gabrielyoung92/gabs_microSMT_PickAndPlace/Microsmt-PNPv3/README.md

# MicroSMT PNPv3 machine

> Designs and original files by [MicroSMT](https://github.com/microsmt/Microsmt-PNPv3). [Credits and local changes](../CREDITS.md).

Start here for the PNPv3 machine parts, nozzle racks, strip feeders and motherboard. The assembly manuals are below.

| Browse | Contents |
| --- | --- |
| [Machine parts gallery](PNP-V3_3D_parts_2026-02-04/README.md) | 25 parts with STEP/STL links and nine previews per part |
| [Work-bed plates](Work_bed_plates/README.md) | Standard and camera plate DWGs, dimensioned PDF and hole coordinates |
| [CP45 nozzle rack gallery](CP45_nozzle_rack/README.md) | Left/right rack parts and clamps |
| [Strip feeder gallery](Strip_feeders/README.md) | Different tape widths and sizes |
| [Motherboard](PCB_motherboard/README.md) | Gerber ZIP, schematic and top/bottom/isometric previews |
| [Machine setup notes](docs/README.md) | OpenPnP commands, controller/camera inspection and vacuum sensors |

## Manuals

- [Assembly Manual for Electrical  of  PNPv3 2025082801.pdf](Assembly%20Manual%20for%20Electrical%20%20of%20%20PNPv3%202025082801.pdf)
- [Assembly manual for  the frame of pnpv3 20241226.pdf](Assembly%20manual%20for%20%20the%20frame%20of%20pnpv3%2020241226.pdf)
- [Backlash Compensation and Camera Calibration.pdf](Backlash%20Compensation%20and%20Camera%20Calibration.pdf)
- [microsmt_pnpboard_v1.7_manual 20241129.pdf](microsmt_pnpboard_v1.7_manual%2020241129.pdf)

[Calibration card](Calibration%20card.png)

## About the PNPv3

MicroSMT describes the PNPv3 as an open-source pick-and-place kit for OpenPnP. Development started in 2021.

Kits: [microsmt.com.cn](https://www.microsmt.com.cn) · Support: [Discord](https://discord.gg/qT7ZAAgspy) · [Google group](https://groups.google.com/g/pnpv3-bing-feeder)

The machine uses a Cartesian XY layout.
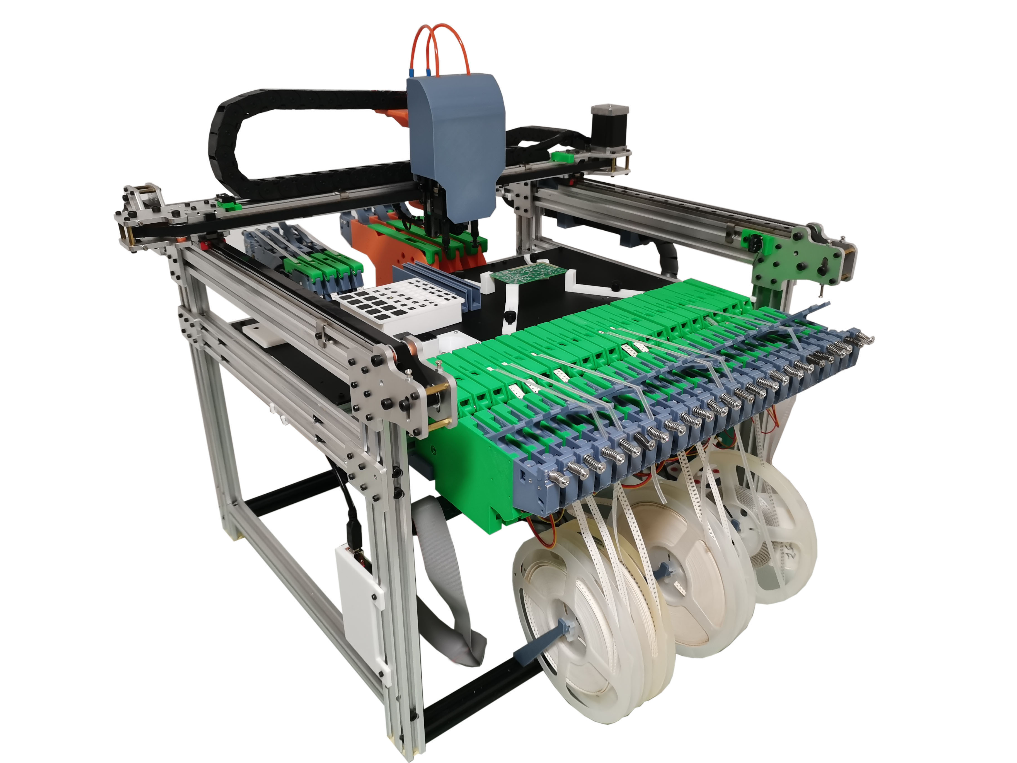
[picture p3: Microsmt-PNPv3/picture1.jpg]


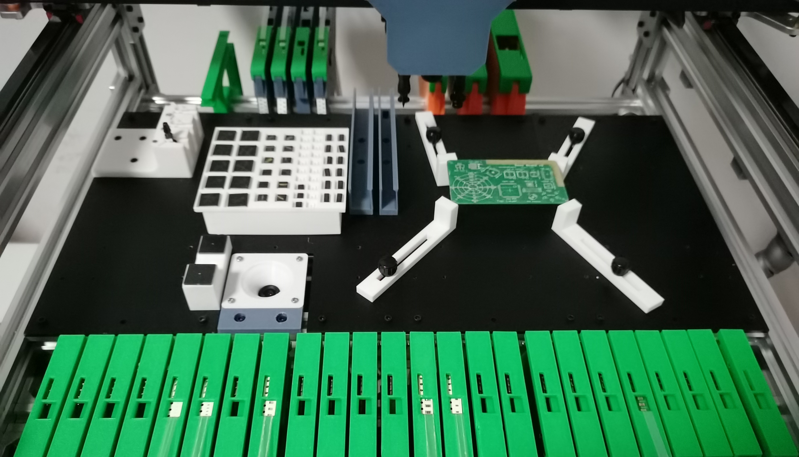
[picture p4: Microsmt-PNPv3/piciture5.jpg]


The main structural parts are CNC-machined aluminium alloy.
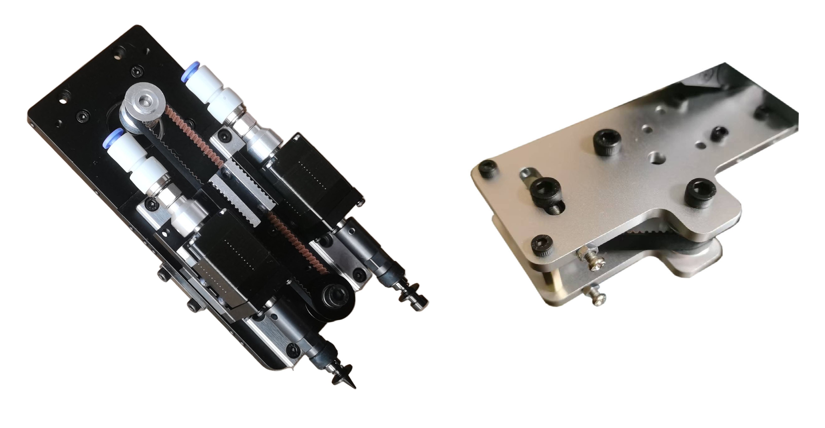
[picture p5: Microsmt-PNPv3/picture3.jpg]


### Belt tensioner
A toothless idler provides the belt-tension adjustment.
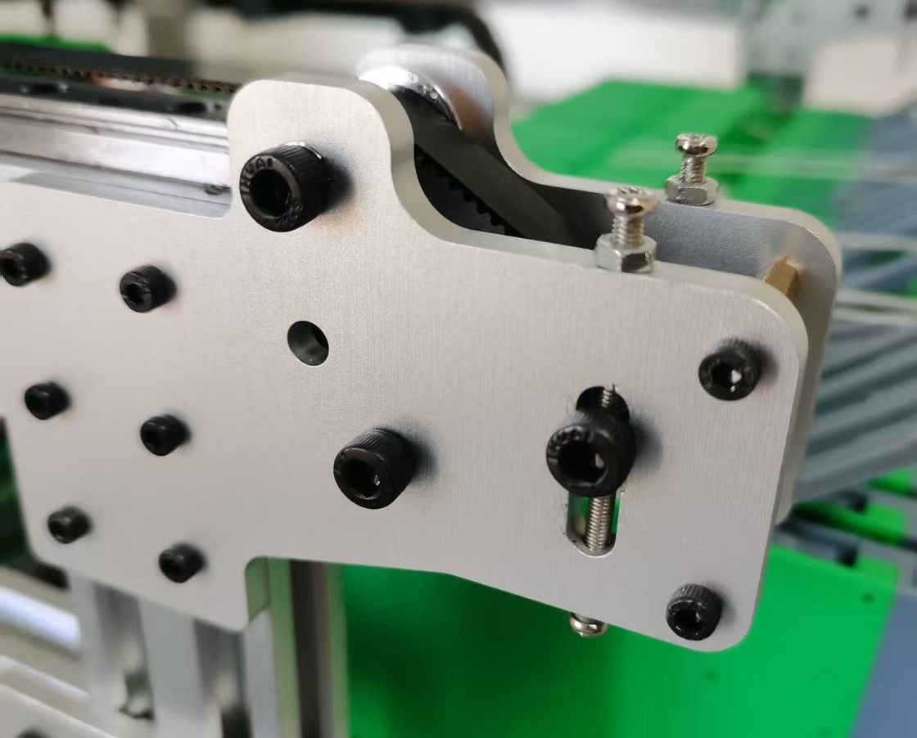
[picture p6: Microsmt-PNPv3/picture4.jpg]
