gabrielyoung92/gabs_microSMT_PickAndPlace/Microsmt-PNPv3/CP45_nozzle_rack/README.md

# CP45 nozzle rack

> Designs and original files by [MicroSMT](https://github.com/microsmt/Microsmt-PNPv3). [Credits and local changes](../../CREDITS.md).

3 parts · [All photos](photos/)

Click a picture for full size; **More views** contains top and bottom views.

## CP45 nozzle rack — left (2025-06-12)

[STEP](CP45%20nozzle%20%20rack%20-left-20250612.STEP) · [STL](CP45%20nozzle%20%20rack%20-left-20250612.stl)

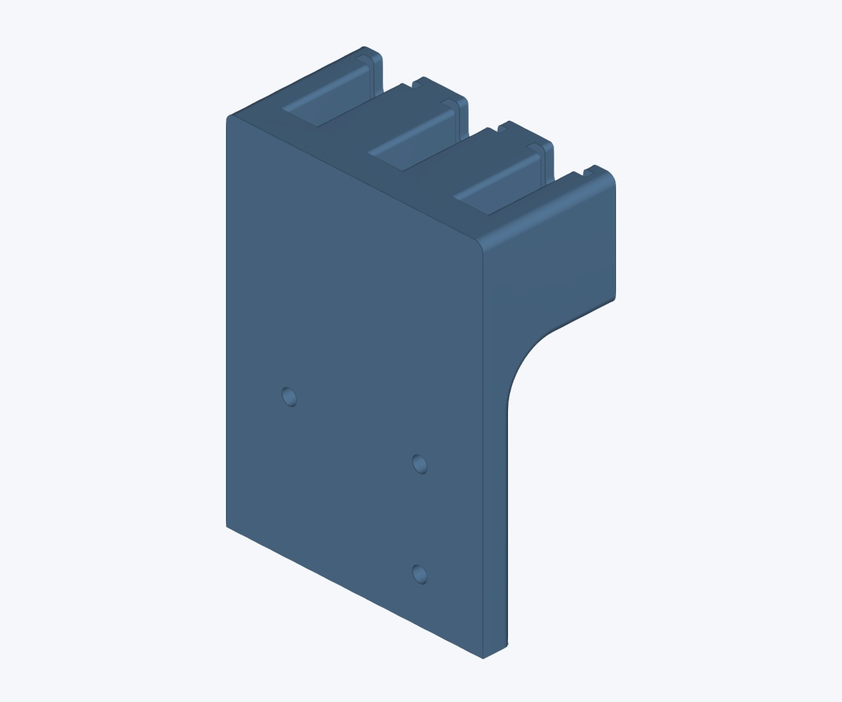
[picture p12: Microsmt-PNPv3/CP45_nozzle_rack/photos/CP45 nozzle rack -left-20250612.jpg]
CP45 nozzle rack left 20250612 — original preview


<details>
<summary>More views</summary>

<table>
<tr>
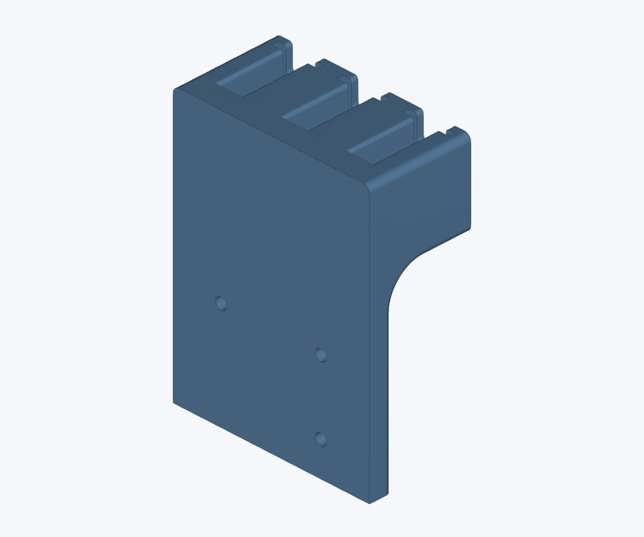
[picture p13: Microsmt-PNPv3/CP45_nozzle_rack/photos/CP45 nozzle rack -left-20250612-iso-top-1.jpg]
CP45 nozzle rack left 20250612 — top view 1
<td align="center"><br><sub>Top 1</sub></td>
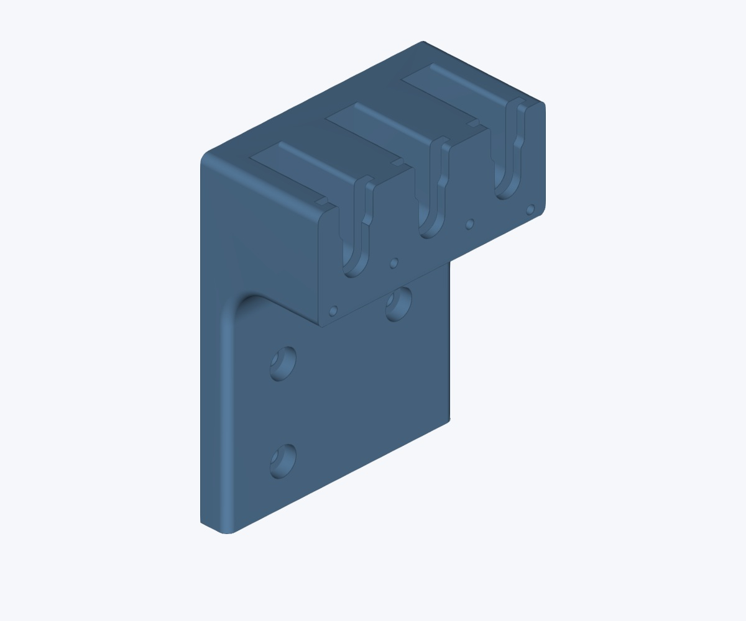
[picture p14: Microsmt-PNPv3/CP45_nozzle_rack/photos/CP45 nozzle rack -left-20250612-iso-top-2.jpg]
CP45 nozzle rack left 20250612 — top view 2
<td align="center"><br><sub>Top 2</sub></td>
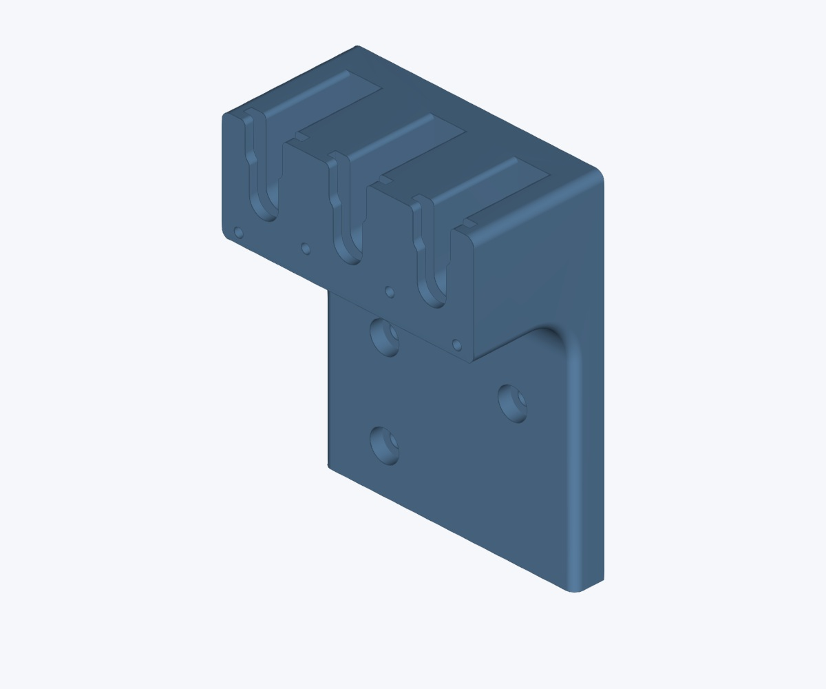
[picture p15: Microsmt-PNPv3/CP45_nozzle_rack/photos/CP45 nozzle rack -left-20250612-iso-top-3.jpg]
CP45 nozzle rack left 20250612 — top view 3
<td align="center"><br><sub>Top 3</sub></td>
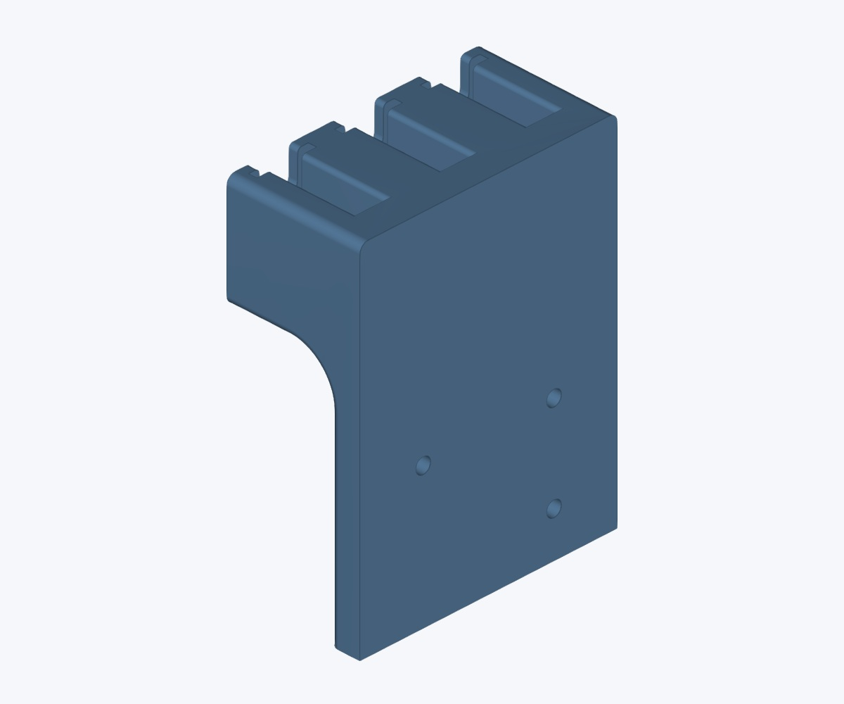
[picture p16: Microsmt-PNPv3/CP45_nozzle_rack/photos/CP45 nozzle rack -left-20250612-iso-top-4.jpg]
CP45 nozzle rack left 20250612 — top view 4
<td align="center"><br><sub>Top 4</sub></td>
</tr>
<tr>
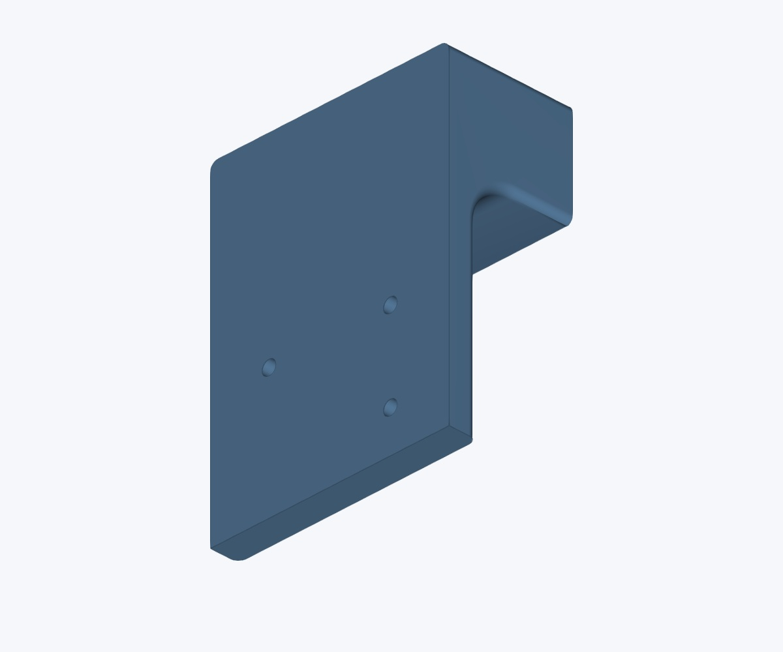
[picture p17: Microsmt-PNPv3/CP45_nozzle_rack/photos/CP45 nozzle rack -left-20250612-iso-bottom-1.jpg]
CP45 nozzle rack left 20250612 — bottom view 1
<td align="center"><br><sub>Bottom 1</sub></td>
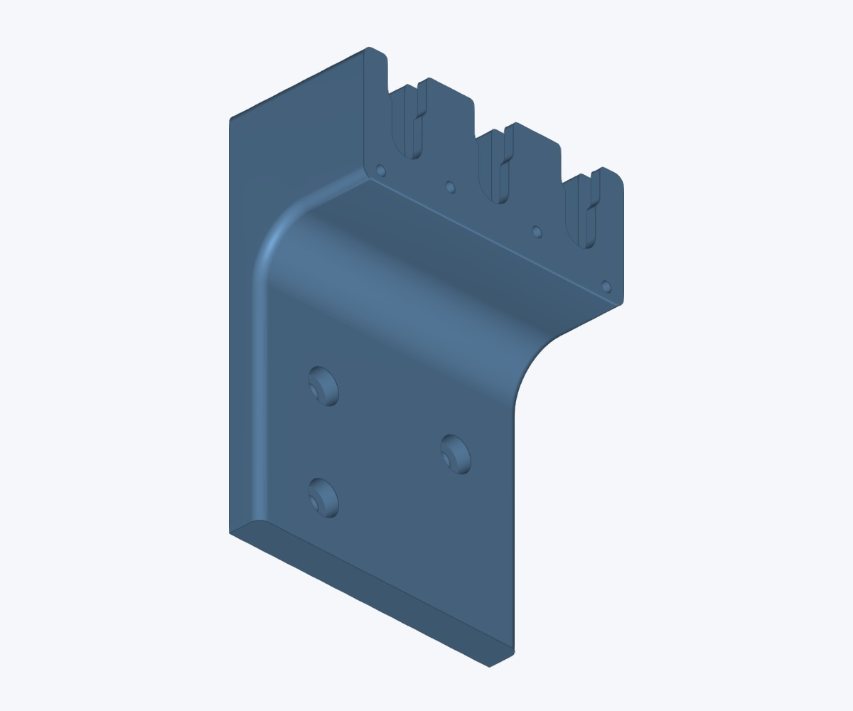
[picture p18: Microsmt-PNPv3/CP45_nozzle_rack/photos/CP45 nozzle rack -left-20250612-iso-bottom-2.jpg]
CP45 nozzle rack left 20250612 — bottom view 2
<td align="center"><br><sub>Bottom 2</sub></td>
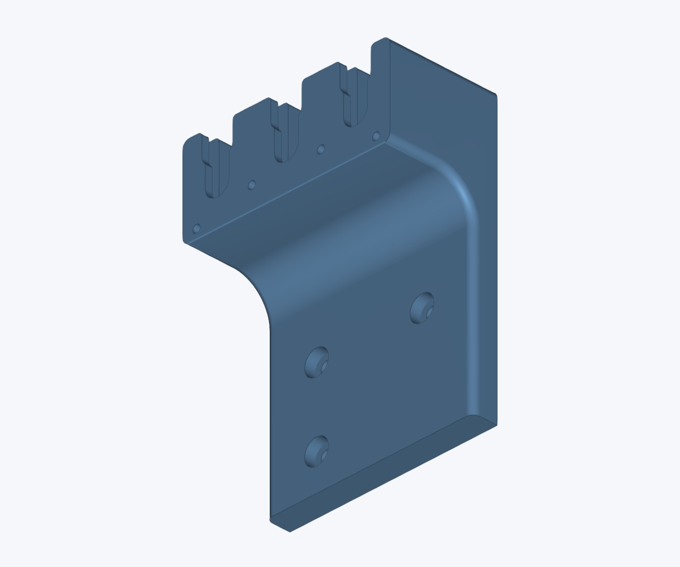
[picture p19: Microsmt-PNPv3/CP45_nozzle_rack/photos/CP45 nozzle rack -left-20250612-iso-bottom-3.jpg]
CP45 nozzle rack left 20250612 — bottom view 3
<td align="center"><br><sub>Bottom 3</sub></td>
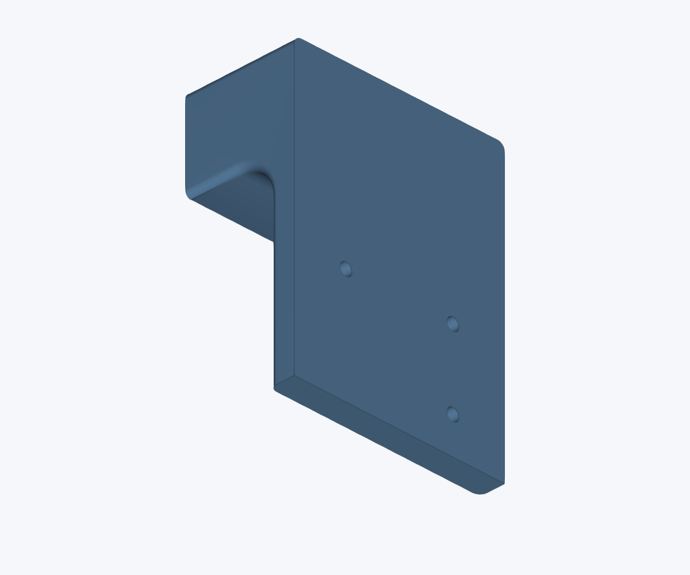
[picture p20: Microsmt-PNPv3/CP45_nozzle_rack/photos/CP45 nozzle rack -left-20250612-iso-bottom-4.jpg]
CP45 nozzle rack left 20250612 — bottom view 4
<td align="center"><br><sub>Bottom 4</sub></td>
</tr>
</table>

</details>

## CP45 nozzle rack — right (2025-06-12)

[STEP](CP45%20nozzle%20%20rack%20-right-20250612.STEP) · [STL](CP45%20nozzle%20%20rack%20-right-20250612.stl)

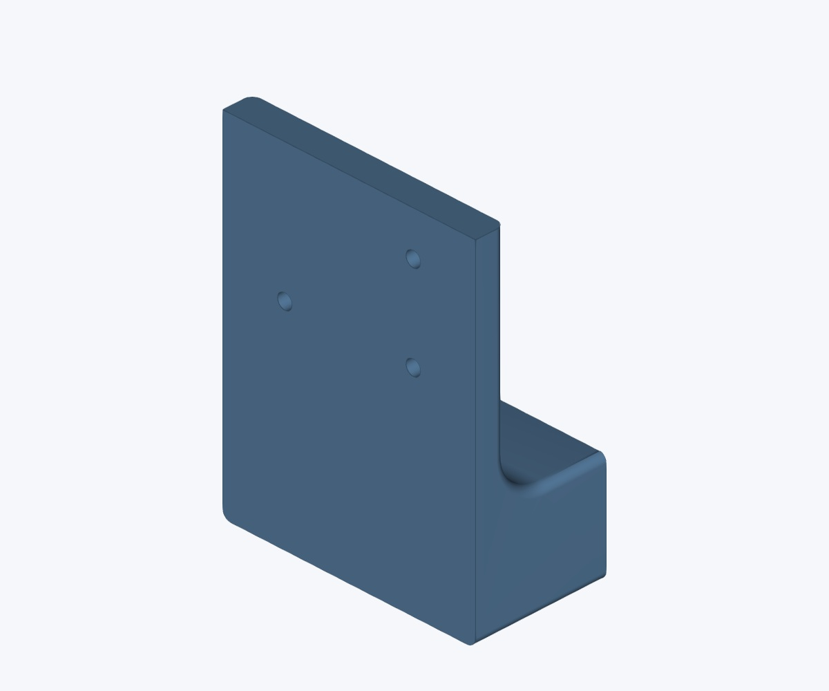
[picture p21: Microsmt-PNPv3/CP45_nozzle_rack/photos/CP45 nozzle rack -right-20250612.jpg]
CP45 nozzle rack right 20250612 — original preview


<details>
<summary>More views</summary>

<table>
<tr>
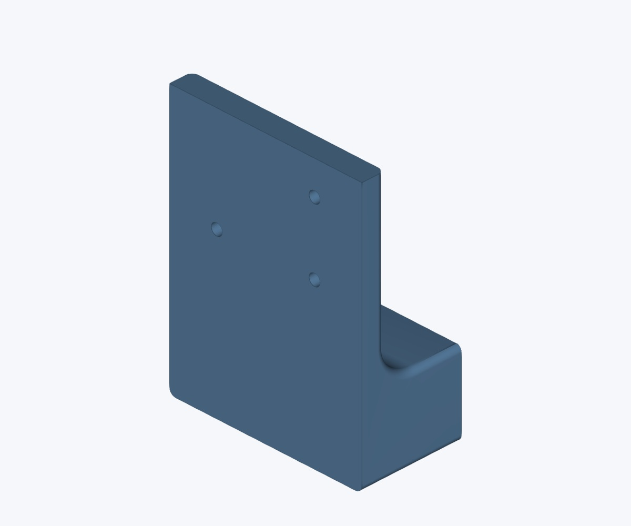
[picture p22: Microsmt-PNPv3/CP45_nozzle_rack/photos/CP45 nozzle rack -right-20250612-iso-top-1.jpg]
CP45 nozzle rack right 20250612 — top view 1
<td align="center"><br><sub>Top 1</sub></td>
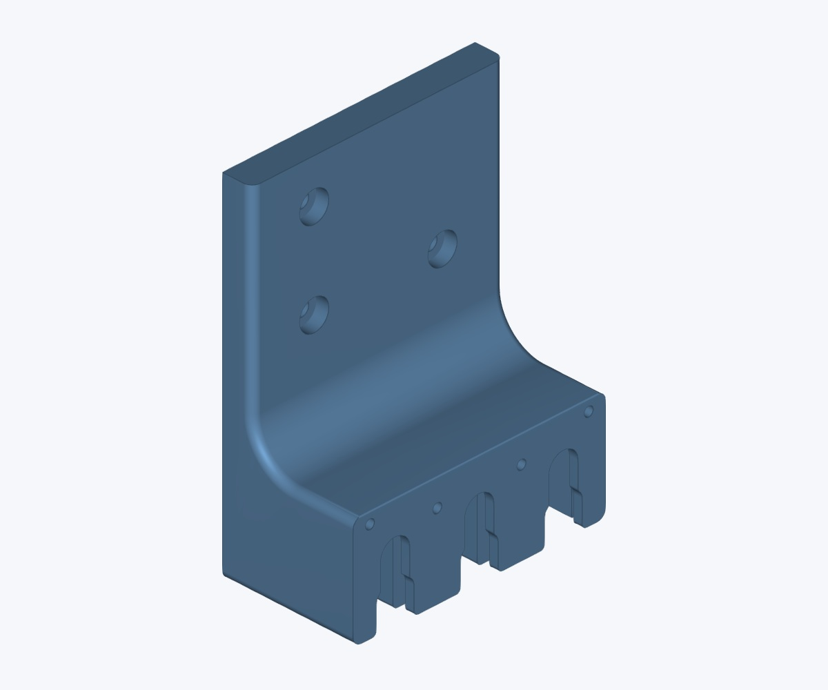
[picture p23: Microsmt-PNPv3/CP45_nozzle_rack/photos/CP45 nozzle rack -right-20250612-iso-top-2.jpg]
CP45 nozzle rack right 20250612 — top view 2
<td align="center"><br><sub>Top 2</sub></td>
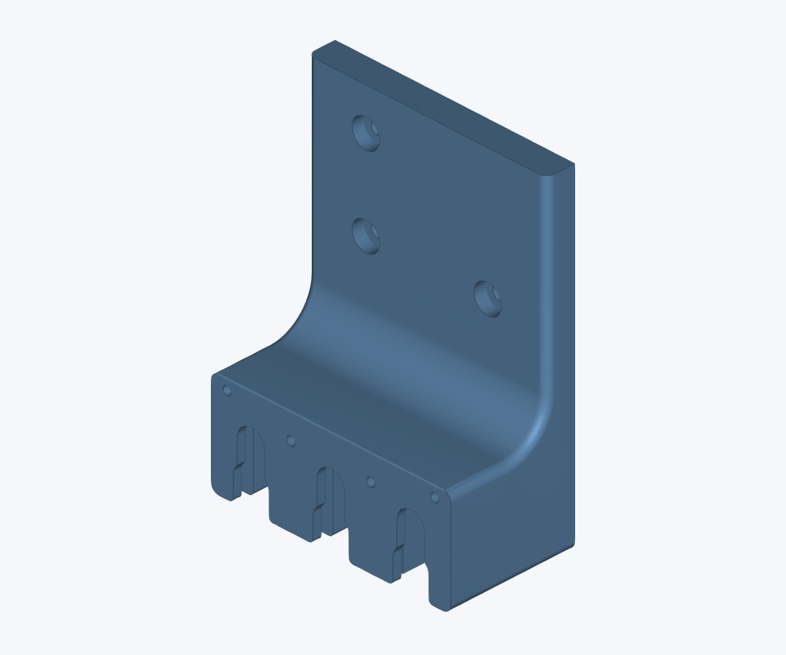
[picture p24: Microsmt-PNPv3/CP45_nozzle_rack/photos/CP45 nozzle rack -right-20250612-iso-top-3.jpg]
CP45 nozzle rack right 20250612 — top view 3
<td align="center"><br><sub>Top 3</sub></td>
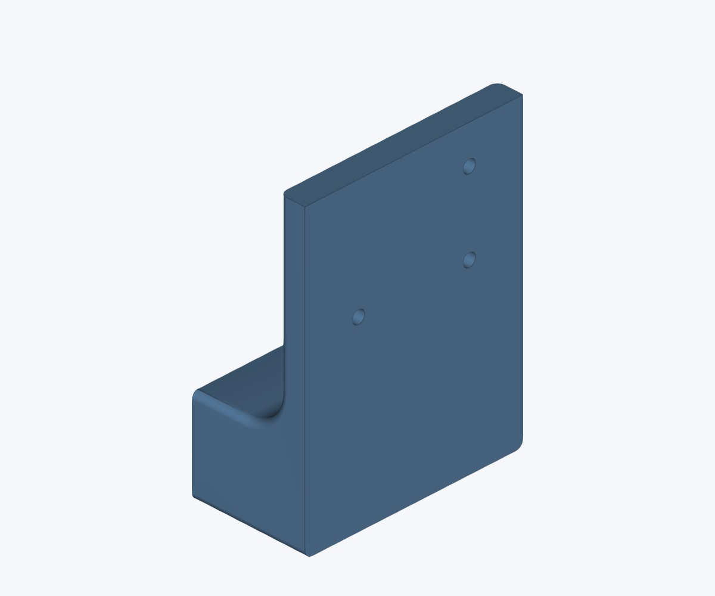
[picture p25: Microsmt-PNPv3/CP45_nozzle_rack/photos/CP45 nozzle rack -right-20250612-iso-top-4.jpg]
CP45 nozzle rack right 20250612 — top view 4
<td align="center"><br><sub>Top 4</sub></td>
</tr>
<tr>
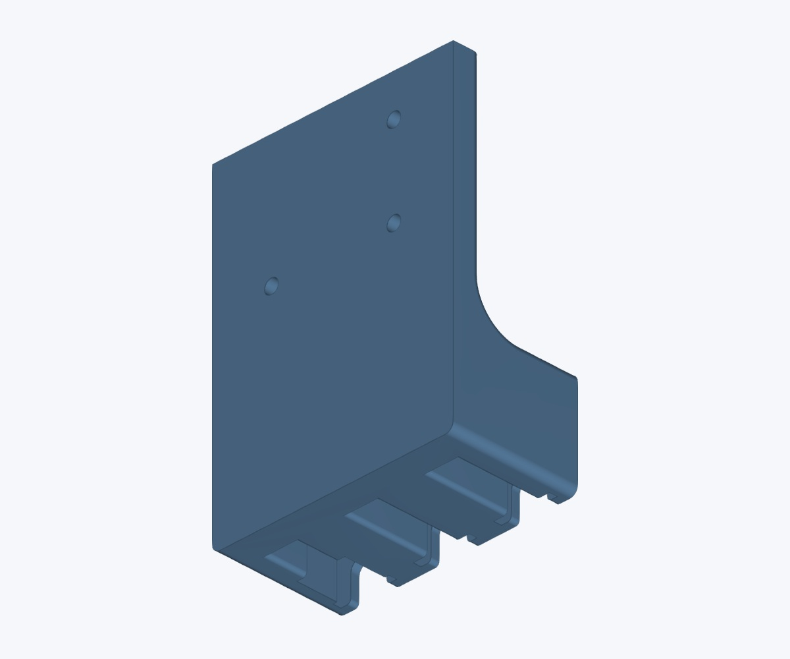
[picture p26: Microsmt-PNPv3/CP45_nozzle_rack/photos/CP45 nozzle rack -right-20250612-iso-bottom-1.jpg]
CP45 nozzle rack right 20250612 — bottom view 1
<td align="center"><br><sub>Bottom 1</sub></td>
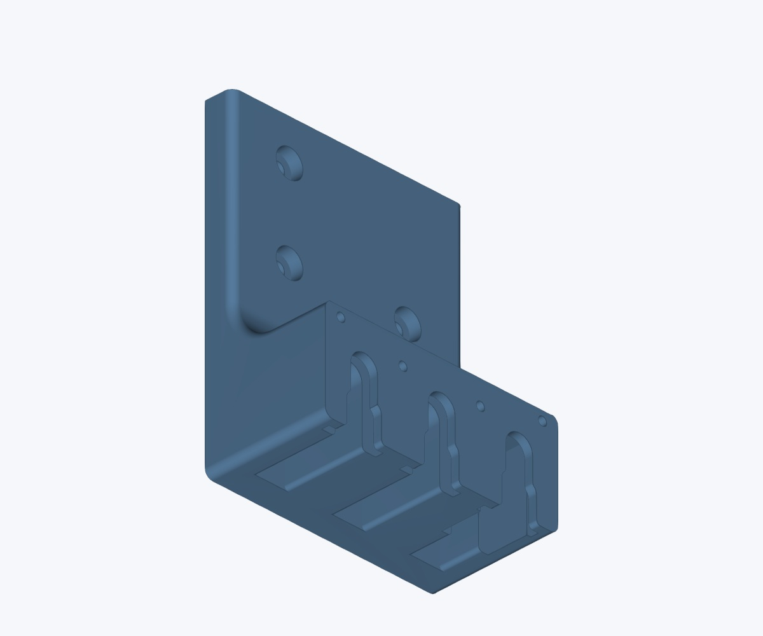
[picture p27: Microsmt-PNPv3/CP45_nozzle_rack/photos/CP45 nozzle rack -right-20250612-iso-bottom-2.jpg]
CP45 nozzle rack right 20250612 — bottom view 2
<td align="center"><br><sub>Bottom 2</sub></td>
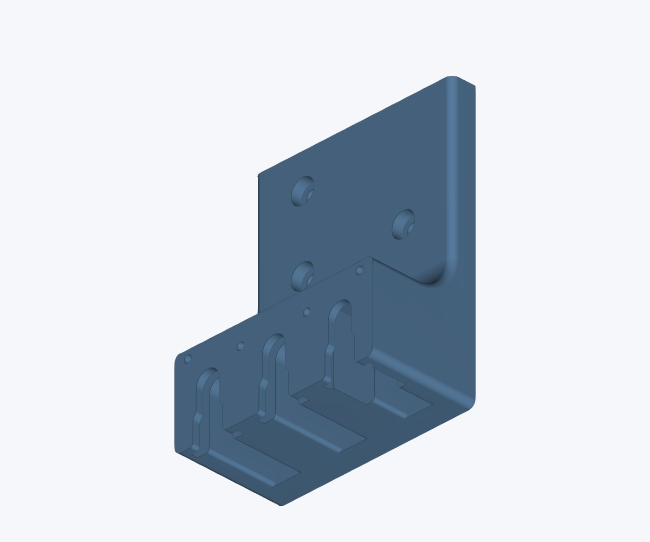
[picture p28: Microsmt-PNPv3/CP45_nozzle_rack/photos/CP45 nozzle rack -right-20250612-iso-bottom-3.jpg]
CP45 nozzle rack right 20250612 — bottom view 3
<td align="center"><br><sub>Bottom 3</sub></td>
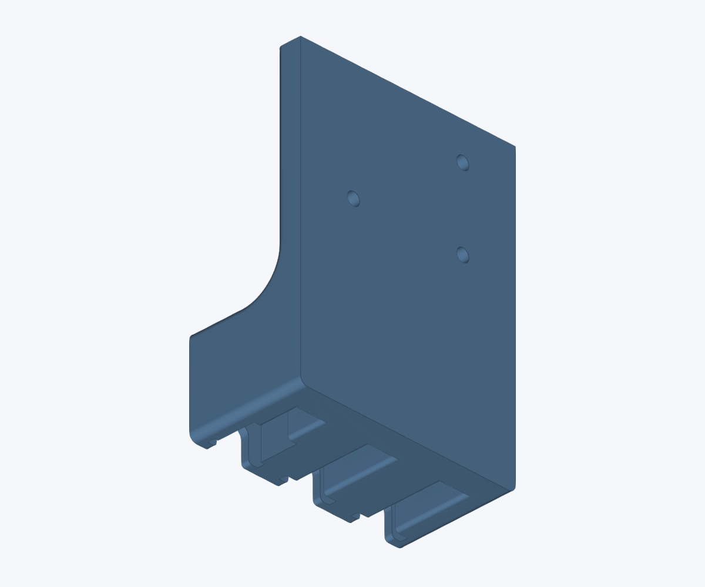
[picture p29: Microsmt-PNPv3/CP45_nozzle_rack/photos/CP45 nozzle rack -right-20250612-iso-bottom-4.jpg]
CP45 nozzle rack right 20250612 — bottom view 4
<td align="center"><br><sub>Bottom 4</sub></td>
</tr>
</table>

</details>

## CP45 nozzle holder clamps

[STL](CP45%20nozzle%20holder%20clamps.stl)

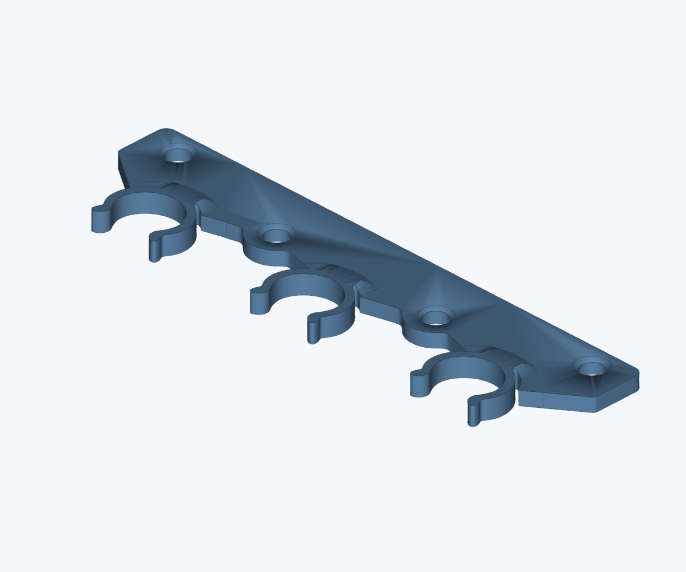
[picture p30: Microsmt-PNPv3/CP45_nozzle_rack/photos/CP45 nozzle holder clamps.jpg]
CP45 nozzle holder clamps — original preview


<details>
<summary>More views</summary>

<table>
<tr>
<td align="center"><a href="photos/CP45%20nozzle%20holder%20clamps-iso-top-1.jpg">CP45 nozzle holder clamps — top view 1</a><br><sub>Top 1</sub></td>
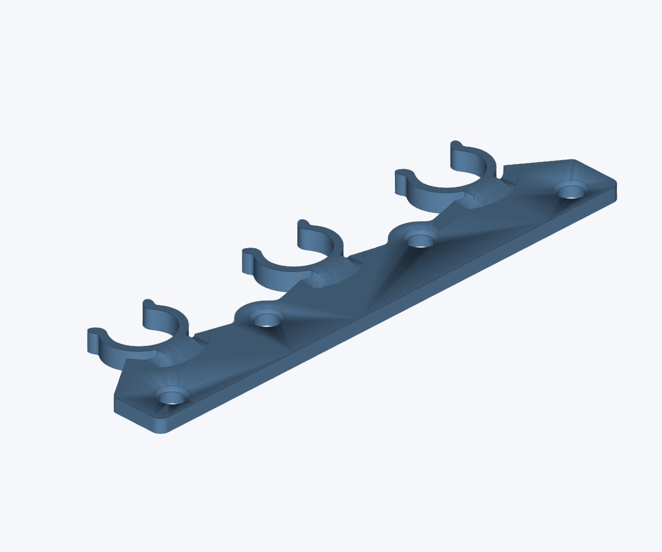
[picture p31: Microsmt-PNPv3/CP45_nozzle_rack/photos/CP45 nozzle holder clamps-iso-top-2.jpg]
CP45 nozzle holder clamps — top view 2
<td align="center"><br><sub>Top 2</sub></td>
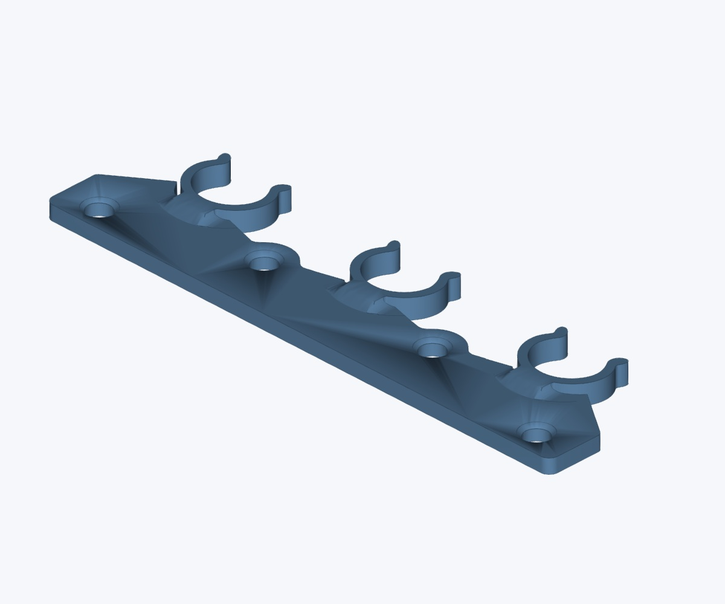
[picture p32: Microsmt-PNPv3/CP45_nozzle_rack/photos/CP45 nozzle holder clamps-iso-top-3.jpg]
CP45 nozzle holder clamps — top view 3
<td align="center"><br><sub>Top 3</sub></td>
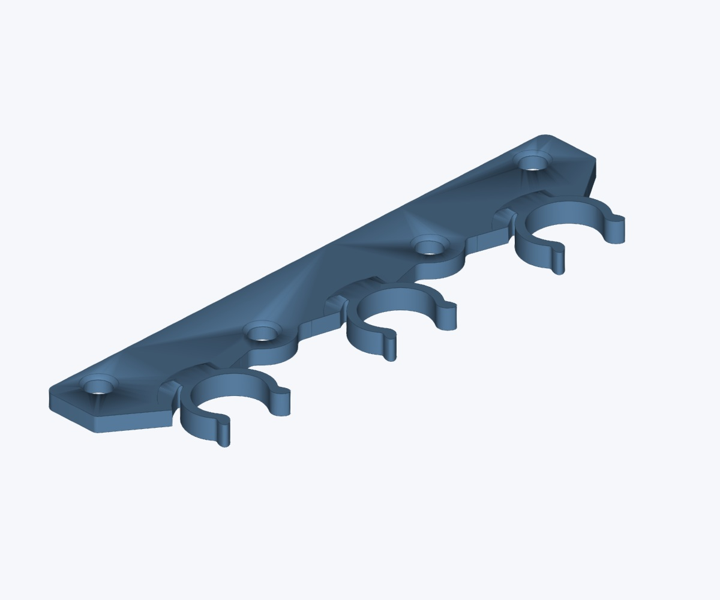
[picture p33: Microsmt-PNPv3/CP45_nozzle_rack/photos/CP45 nozzle holder clamps-iso-top-4.jpg]
CP45 nozzle holder clamps — top view 4
<td align="center"><br><sub>Top 4</sub></td>
</tr>
<tr>
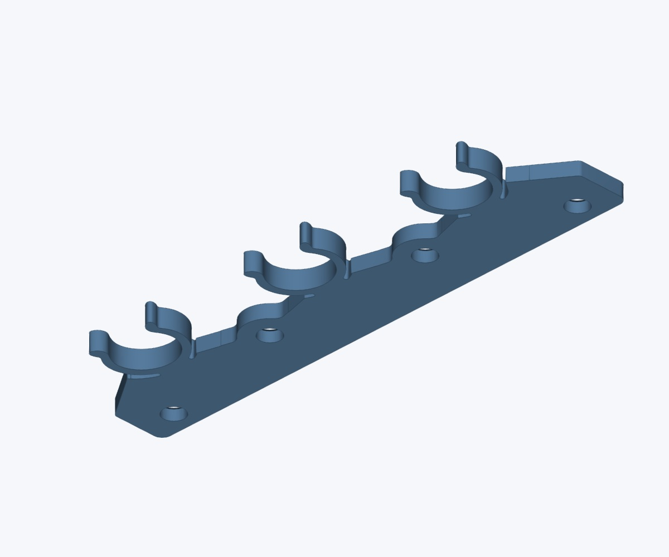
[picture p34: Microsmt-PNPv3/CP45_nozzle_rack/photos/CP45 nozzle holder clamps-iso-bottom-1.jpg]
CP45 nozzle holder clamps — bottom view 1
<td align="center"><br><sub>Bottom 1</sub></td>
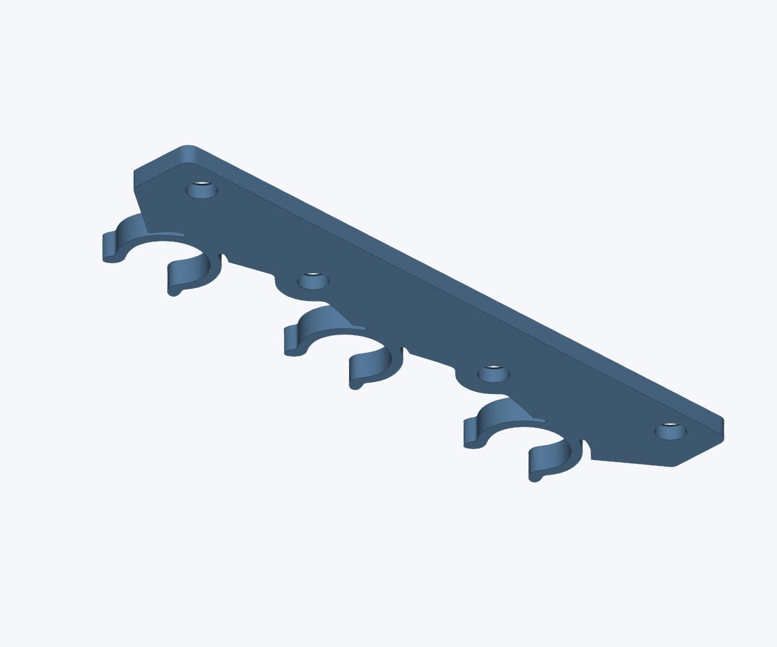
[picture p35: Microsmt-PNPv3/CP45_nozzle_rack/photos/CP45 nozzle holder clamps-iso-bottom-2.jpg]
CP45 nozzle holder clamps — bottom view 2
<td align="center"><br><sub>Bottom 2</sub></td>
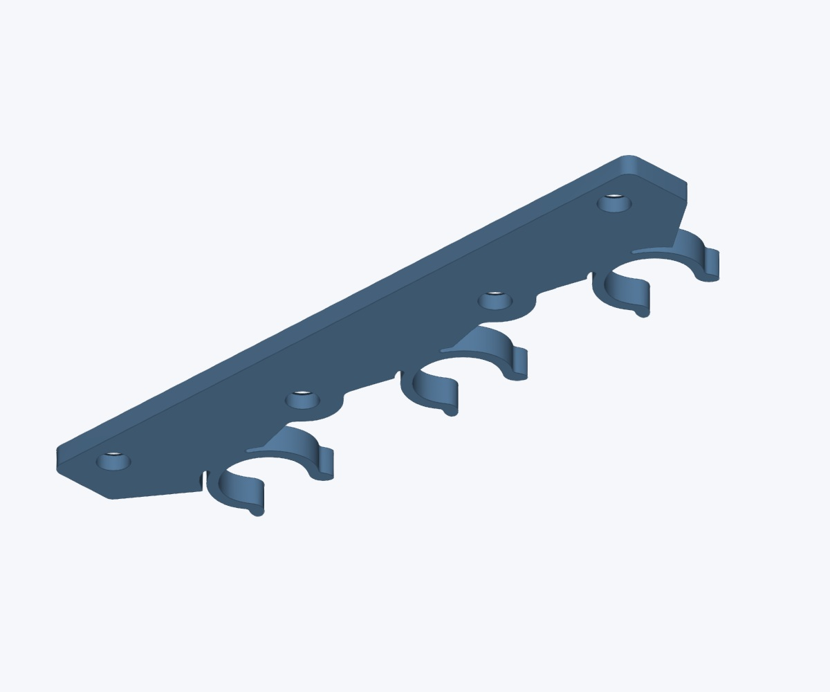
[picture p36: Microsmt-PNPv3/CP45_nozzle_rack/photos/CP45 nozzle holder clamps-iso-bottom-3.jpg]
CP45 nozzle holder clamps — bottom view 3
<td align="center"><br><sub>Bottom 3</sub></td>
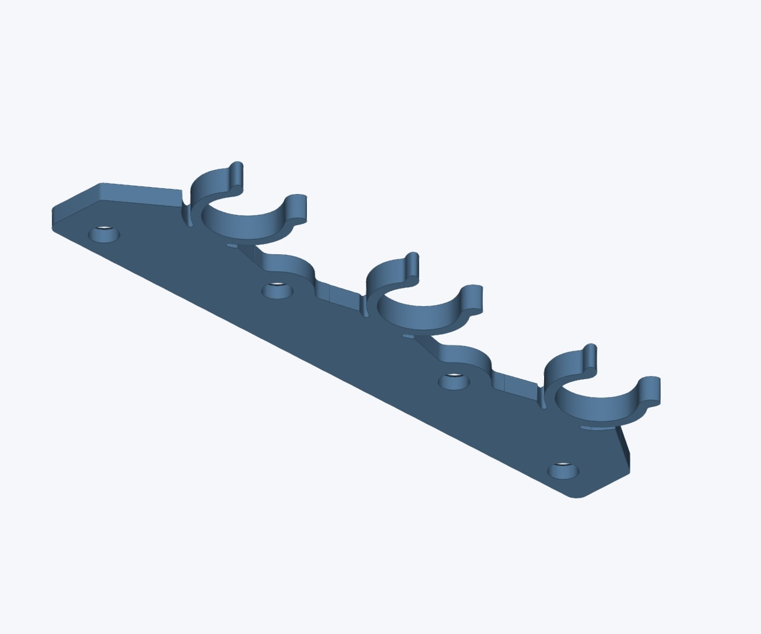
[picture p37: Microsmt-PNPv3/CP45_nozzle_rack/photos/CP45 nozzle holder clamps-iso-bottom-4.jpg]
CP45 nozzle holder clamps — bottom view 4
<td align="center"><br><sub>Bottom 4</sub></td>
</tr>
</table>

</details>
