gabrielyoung92/gabs_microSMT_PickAndPlace/Microsmt-PNPv3/Strip_feeders/README.md

# Strip feeders

> Designs and original files by [MicroSMT](https://github.com/microsmt/Microsmt-PNPv3). [Credits and local changes](../../CREDITS.md).

7 parts · [All photos](photos/)

Click a picture for full size; **More views** contains top and bottom views.

## 8 mm — 1 bit

[STEP](8mm-1bit.STEP) · [STL](8mm-1bit.stl)

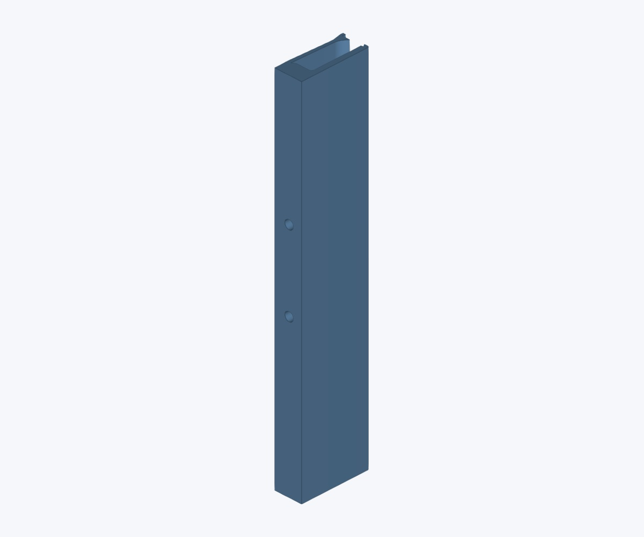
[picture p43: Microsmt-PNPv3/Strip_feeders/photos/8mm-1bit.jpg]
8mm 1bit — original preview


<details>
<summary>More views</summary>

<table>
<tr>
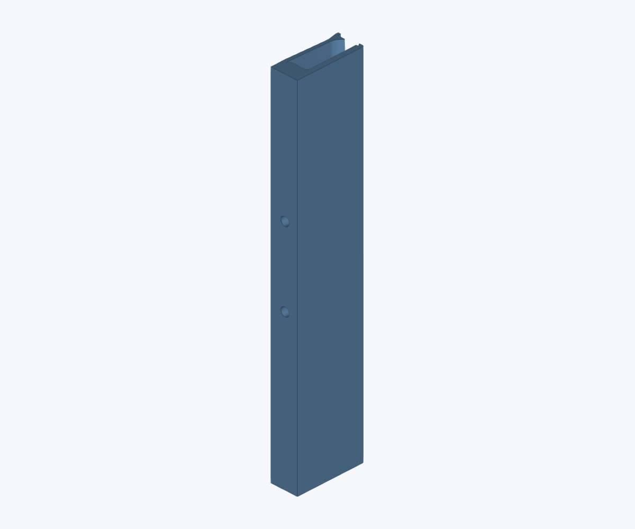
[picture p44: Microsmt-PNPv3/Strip_feeders/photos/8mm-1bit-iso-top-1.jpg]
8mm 1bit — top view 1
<td align="center"><br><sub>Top 1</sub></td>
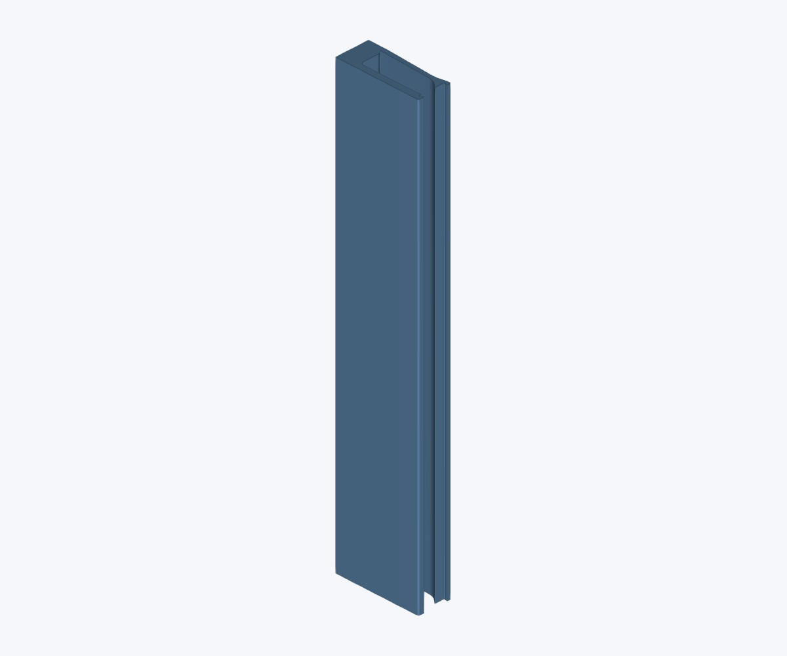
[picture p45: Microsmt-PNPv3/Strip_feeders/photos/8mm-1bit-iso-top-2.jpg]
8mm 1bit — top view 2
<td align="center"><br><sub>Top 2</sub></td>
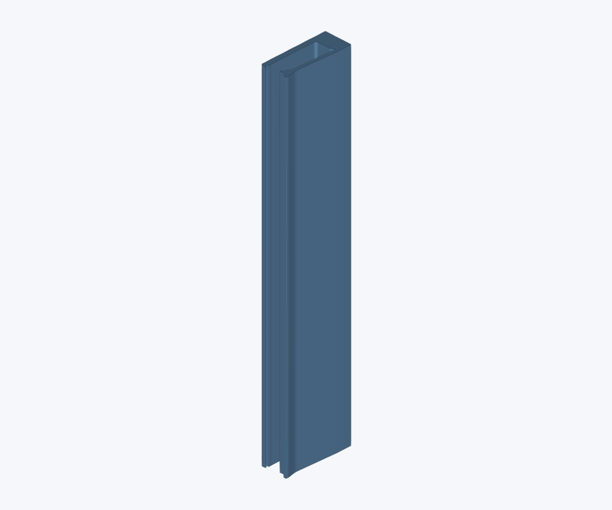
[picture p46: Microsmt-PNPv3/Strip_feeders/photos/8mm-1bit-iso-top-3.jpg]
8mm 1bit — top view 3
<td align="center"><br><sub>Top 3</sub></td>
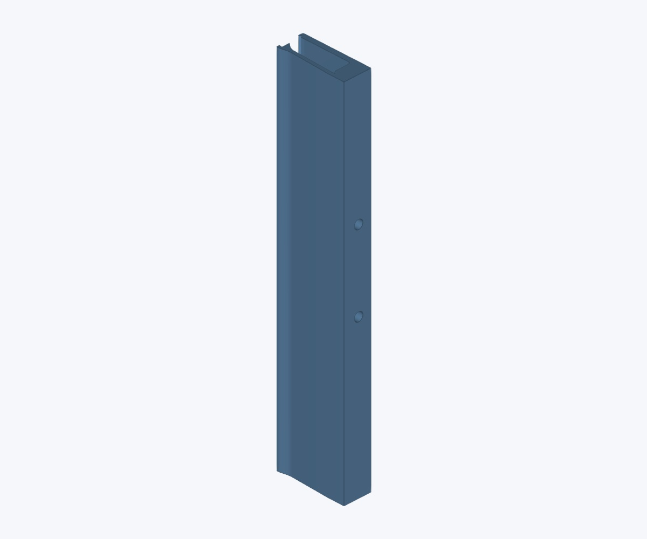
[picture p47: Microsmt-PNPv3/Strip_feeders/photos/8mm-1bit-iso-top-4.jpg]
8mm 1bit — top view 4
<td align="center"><br><sub>Top 4</sub></td>
</tr>
<tr>
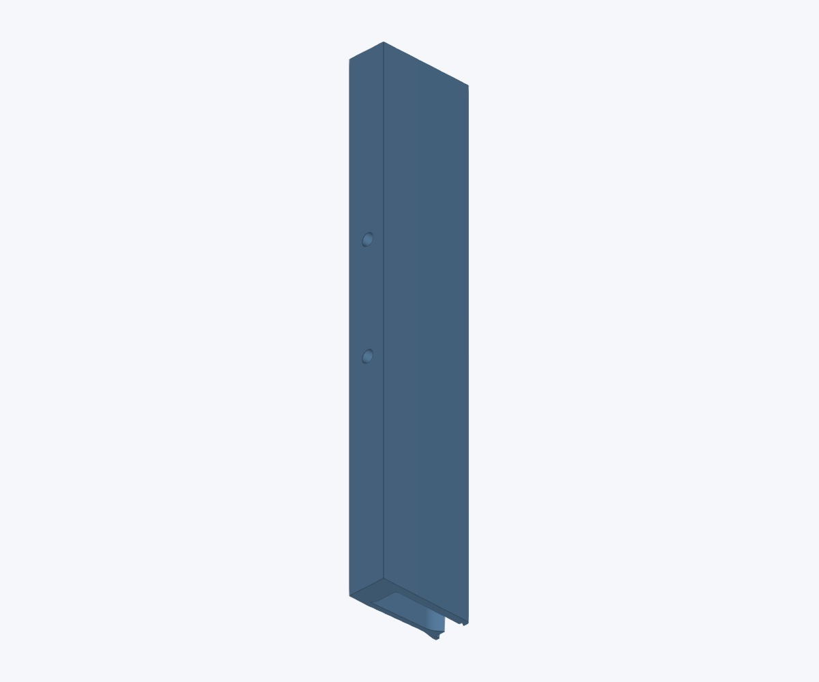
[picture p48: Microsmt-PNPv3/Strip_feeders/photos/8mm-1bit-iso-bottom-1.jpg]
8mm 1bit — bottom view 1
<td align="center"><br><sub>Bottom 1</sub></td>
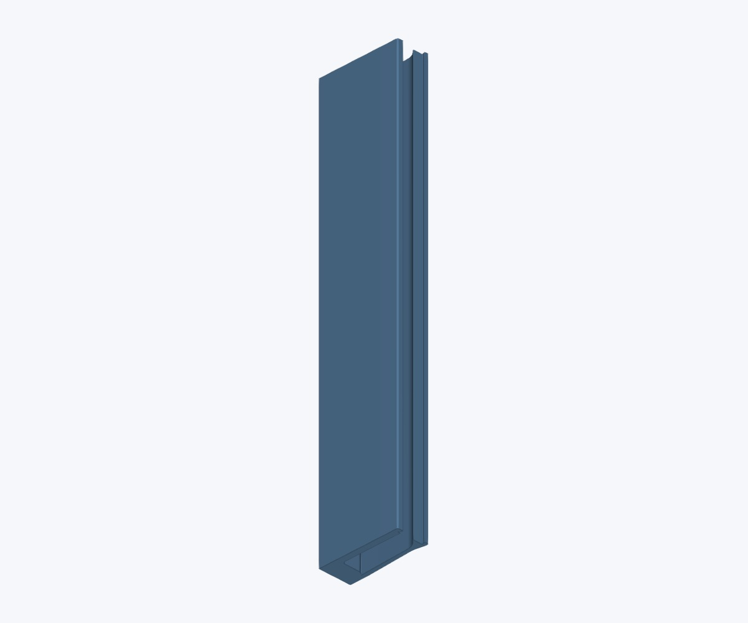
[picture p49: Microsmt-PNPv3/Strip_feeders/photos/8mm-1bit-iso-bottom-2.jpg]
8mm 1bit — bottom view 2
<td align="center"><br><sub>Bottom 2</sub></td>
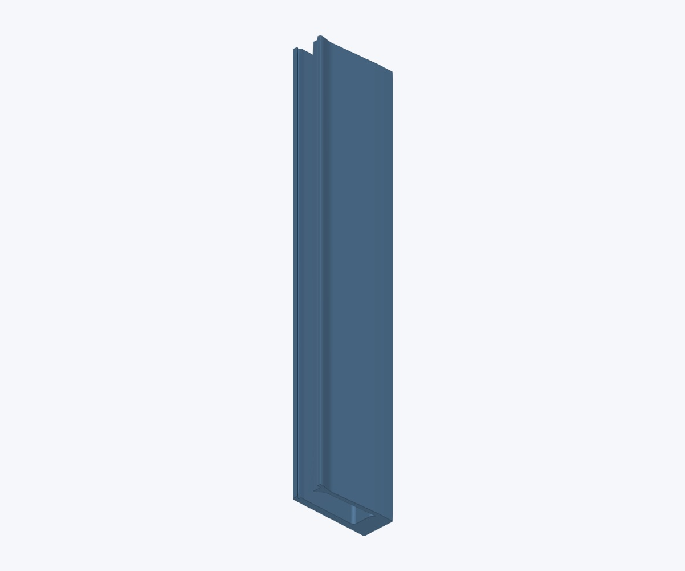
[picture p50: Microsmt-PNPv3/Strip_feeders/photos/8mm-1bit-iso-bottom-3.jpg]
8mm 1bit — bottom view 3
<td align="center"><br><sub>Bottom 3</sub></td>
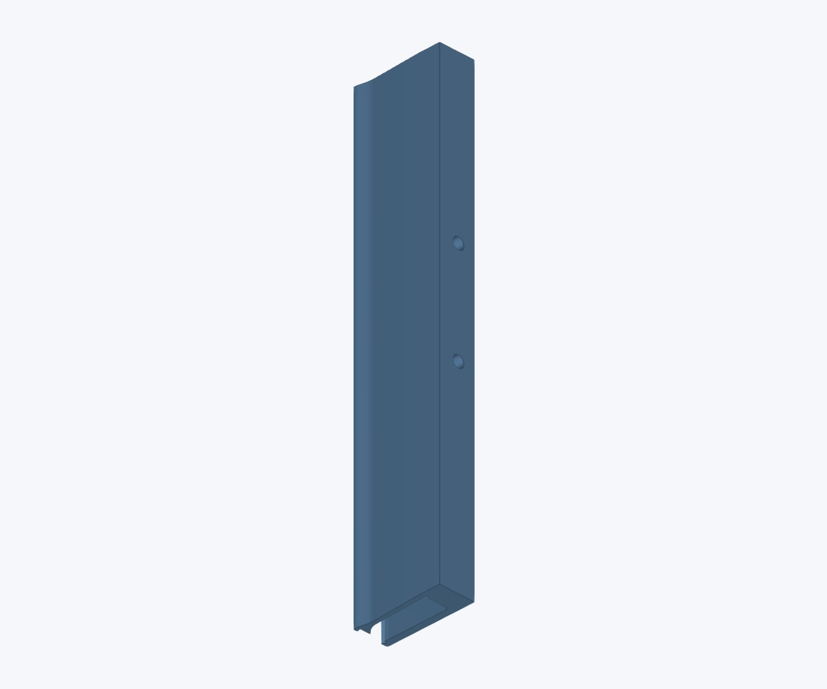
[picture p51: Microsmt-PNPv3/Strip_feeders/photos/8mm-1bit-iso-bottom-4.jpg]
8mm 1bit — bottom view 4
<td align="center"><br><sub>Bottom 4</sub></td>
</tr>
</table>

</details>

## 8 mm — 2 bit

[STEP](8mm-2bit.STEP) · [STL](8mm-2bit.stl)

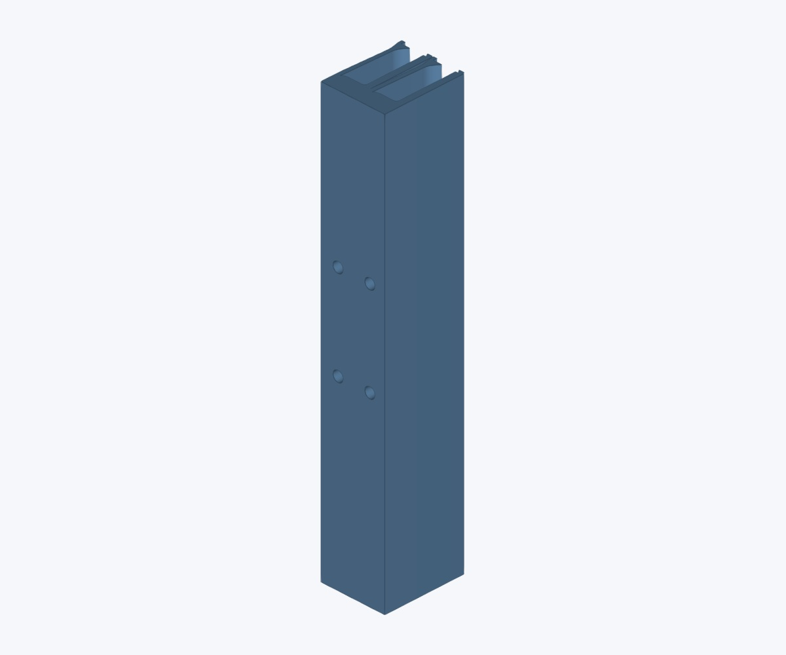
[picture p52: Microsmt-PNPv3/Strip_feeders/photos/8mm-2bit.jpg]
8mm 2bit — original preview


<details>
<summary>More views</summary>

<table>
<tr>
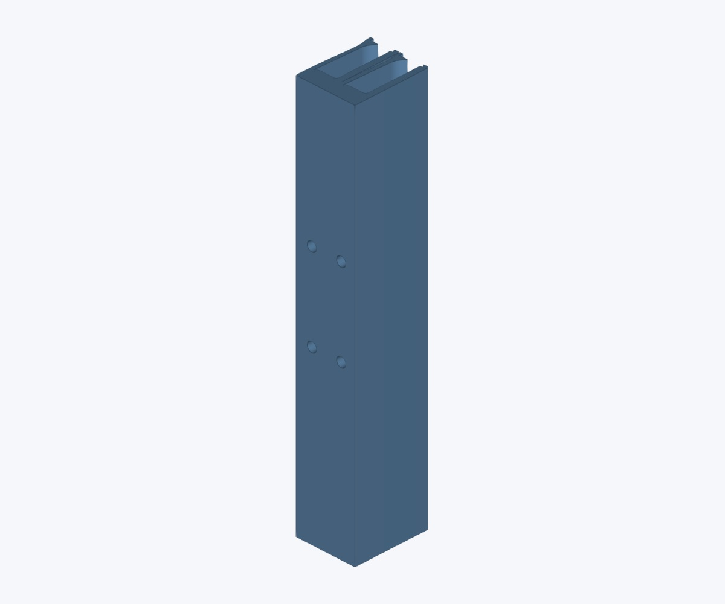
[picture p53: Microsmt-PNPv3/Strip_feeders/photos/8mm-2bit-iso-top-1.jpg]
8mm 2bit — top view 1
<td align="center"><br><sub>Top 1</sub></td>
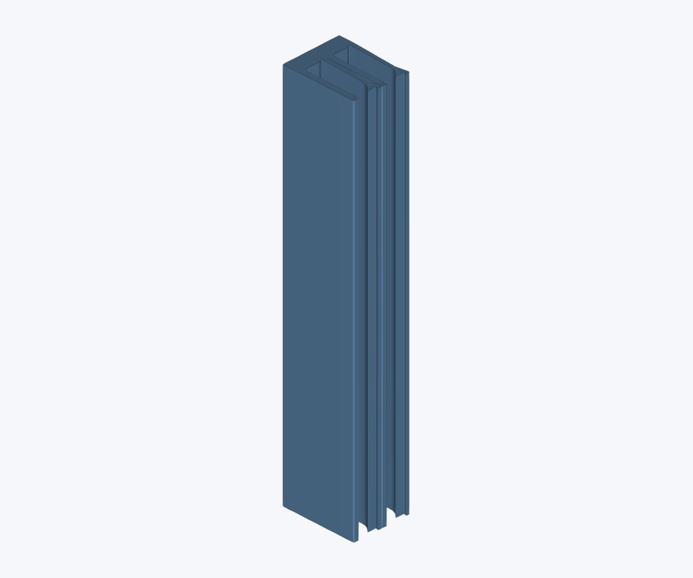
[picture p54: Microsmt-PNPv3/Strip_feeders/photos/8mm-2bit-iso-top-2.jpg]
8mm 2bit — top view 2
<td align="center"><br><sub>Top 2</sub></td>
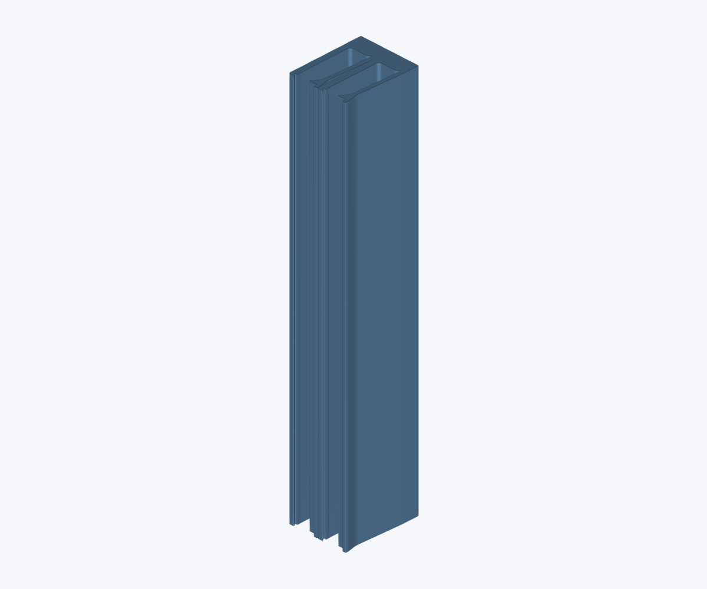
[picture p55: Microsmt-PNPv3/Strip_feeders/photos/8mm-2bit-iso-top-3.jpg]
8mm 2bit — top view 3
<td align="center"><br><sub>Top 3</sub></td>
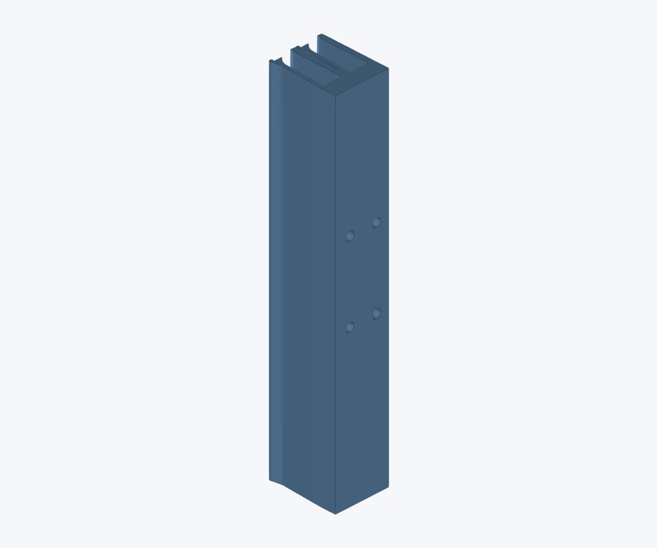
[picture p56: Microsmt-PNPv3/Strip_feeders/photos/8mm-2bit-iso-top-4.jpg]
8mm 2bit — top view 4
<td align="center"><br><sub>Top 4</sub></td>
</tr>
<tr>
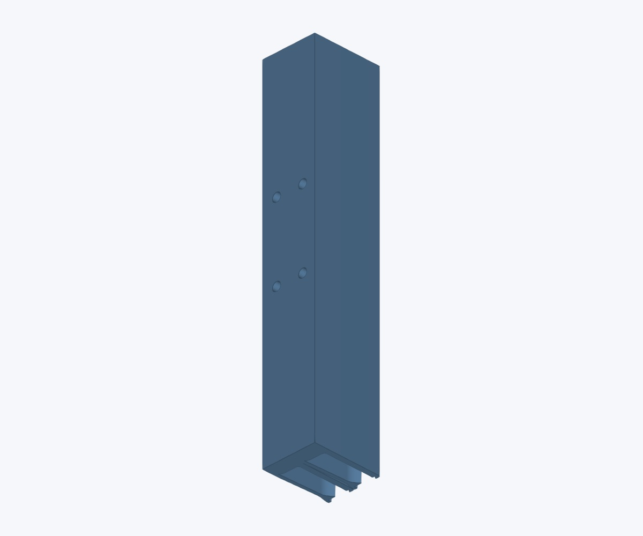
[picture p57: Microsmt-PNPv3/Strip_feeders/photos/8mm-2bit-iso-bottom-1.jpg]
8mm 2bit — bottom view 1
<td align="center"><br><sub>Bottom 1</sub></td>
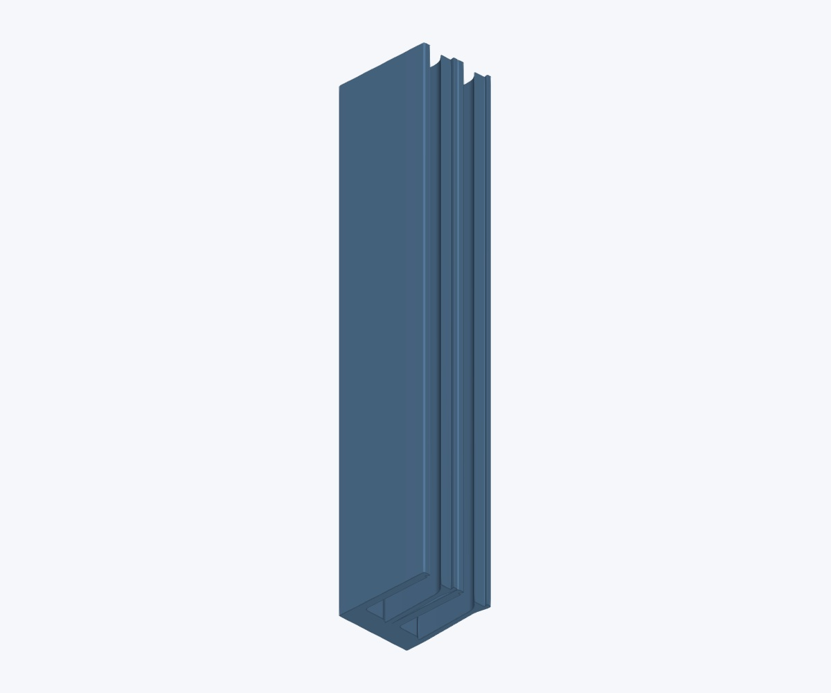
[picture p58: Microsmt-PNPv3/Strip_feeders/photos/8mm-2bit-iso-bottom-2.jpg]
8mm 2bit — bottom view 2
<td align="center"><br><sub>Bottom 2</sub></td>
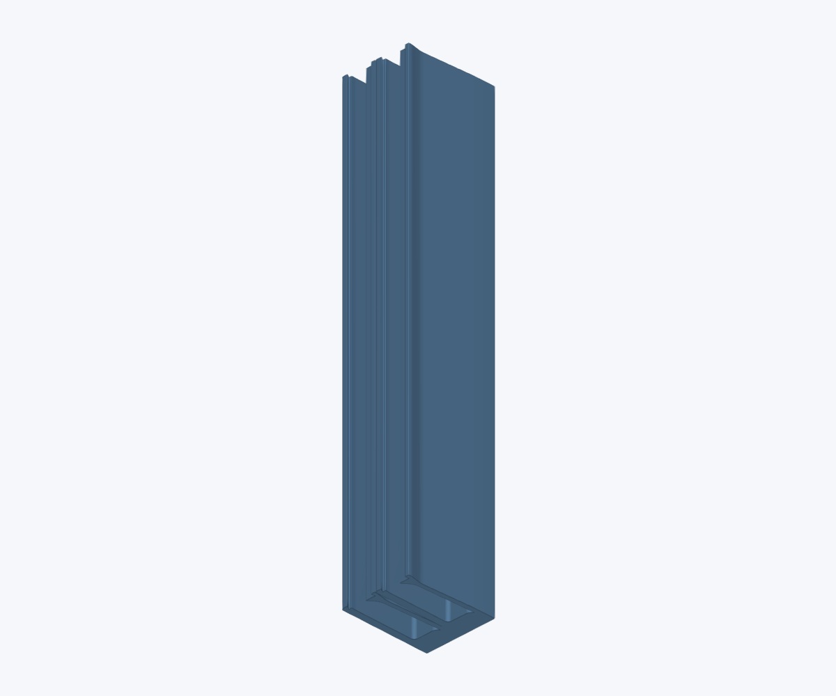
[picture p59: Microsmt-PNPv3/Strip_feeders/photos/8mm-2bit-iso-bottom-3.jpg]
8mm 2bit — bottom view 3
<td align="center"><br><sub>Bottom 3</sub></td>
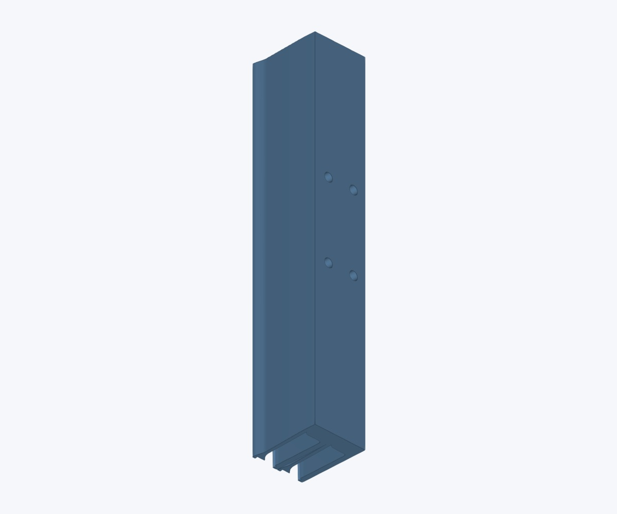
[picture p60: Microsmt-PNPv3/Strip_feeders/photos/8mm-2bit-iso-bottom-4.jpg]
8mm 2bit — bottom view 4
<td align="center"><br><sub>Bottom 4</sub></td>
</tr>
</table>

</details>

## 8 mm — 3 bit

[STEP](8mm-3bit.STEP) · [STL](8mm-3bit.stl)

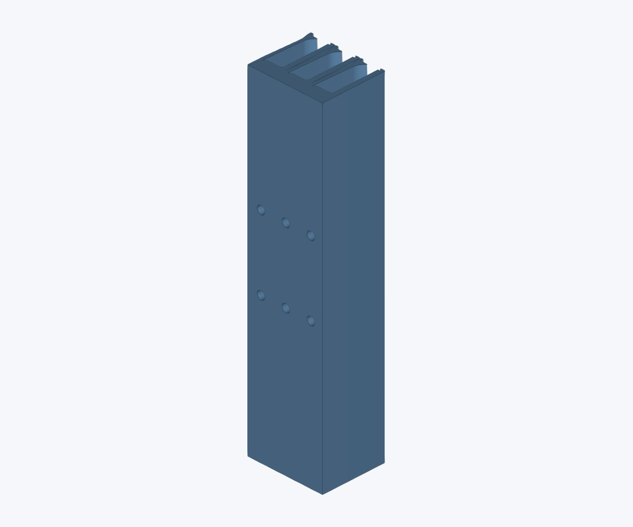
[picture p61: Microsmt-PNPv3/Strip_feeders/photos/8mm-3bit.jpg]
8mm 3bit — original preview


<details>
<summary>More views</summary>

<table>
<tr>
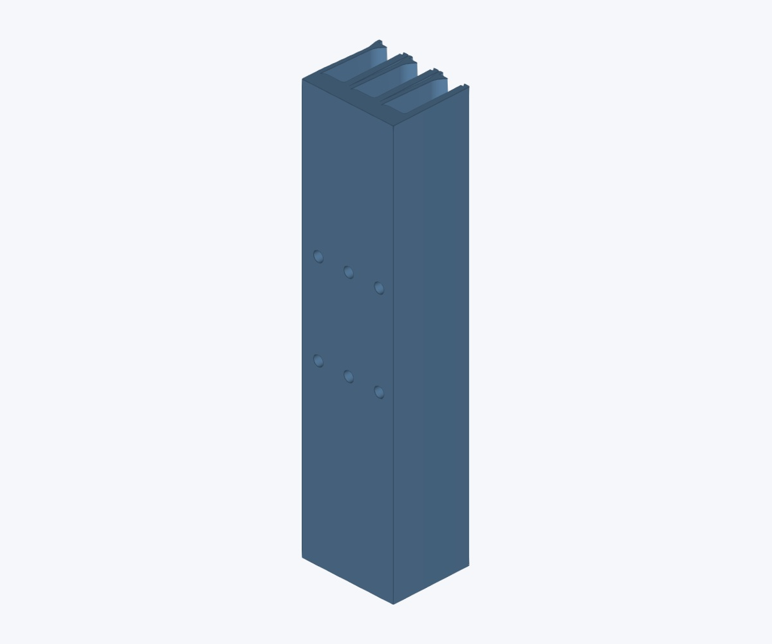
[picture p62: Microsmt-PNPv3/Strip_feeders/photos/8mm-3bit-iso-top-1.jpg]
8mm 3bit — top view 1
<td align="center"><br><sub>Top 1</sub></td>
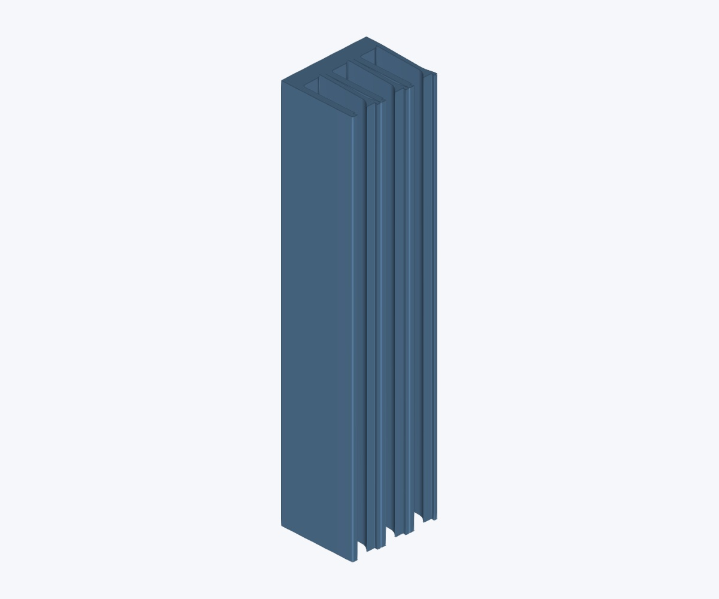
[picture p63: Microsmt-PNPv3/Strip_feeders/photos/8mm-3bit-iso-top-2.jpg]
8mm 3bit — top view 2
<td align="center"><br><sub>Top 2</sub></td>
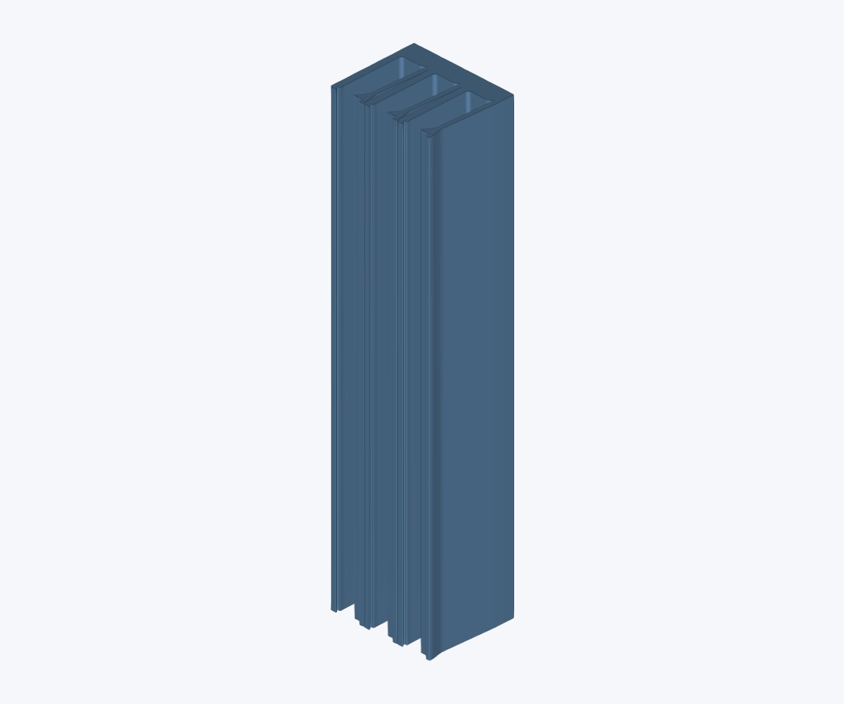
[picture p64: Microsmt-PNPv3/Strip_feeders/photos/8mm-3bit-iso-top-3.jpg]
8mm 3bit — top view 3
<td align="center"><br><sub>Top 3</sub></td>
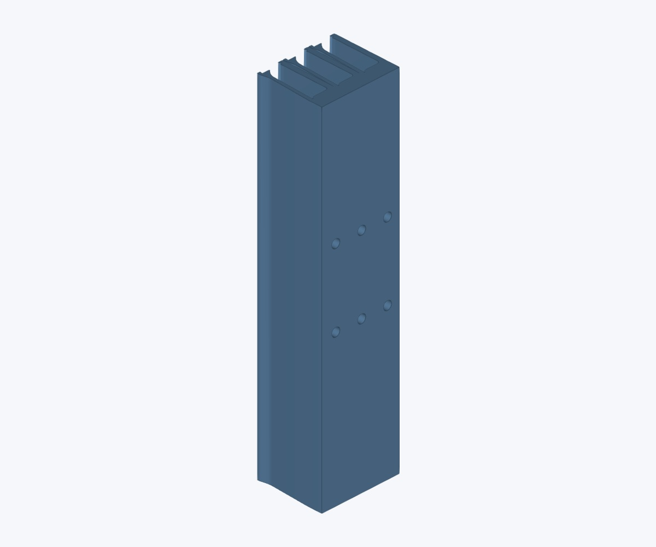
[picture p65: Microsmt-PNPv3/Strip_feeders/photos/8mm-3bit-iso-top-4.jpg]
8mm 3bit — top view 4
<td align="center"><br><sub>Top 4</sub></td>
</tr>
<tr>
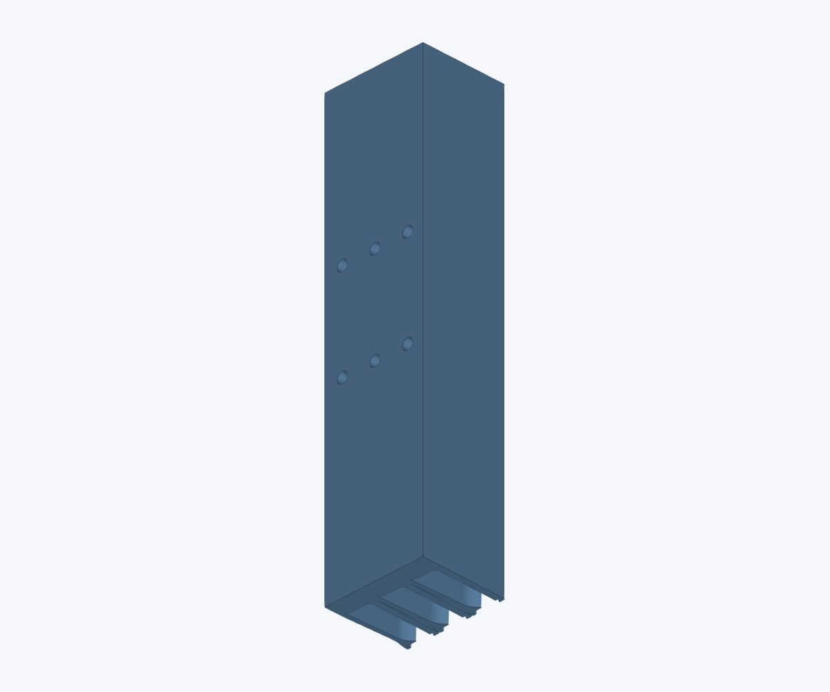
[picture p66: Microsmt-PNPv3/Strip_feeders/photos/8mm-3bit-iso-bottom-1.jpg]
8mm 3bit — bottom view 1
<td align="center"><br><sub>Bottom 1</sub></td>
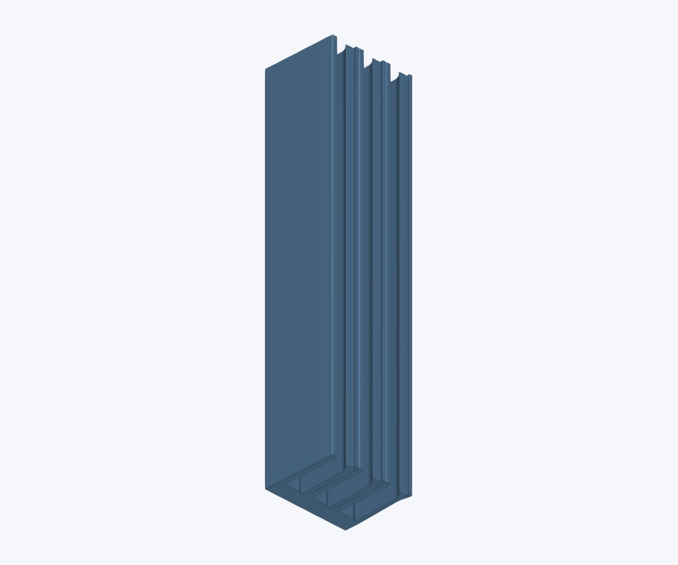
[picture p67: Microsmt-PNPv3/Strip_feeders/photos/8mm-3bit-iso-bottom-2.jpg]
8mm 3bit — bottom view 2
<td align="center"><br><sub>Bottom 2</sub></td>
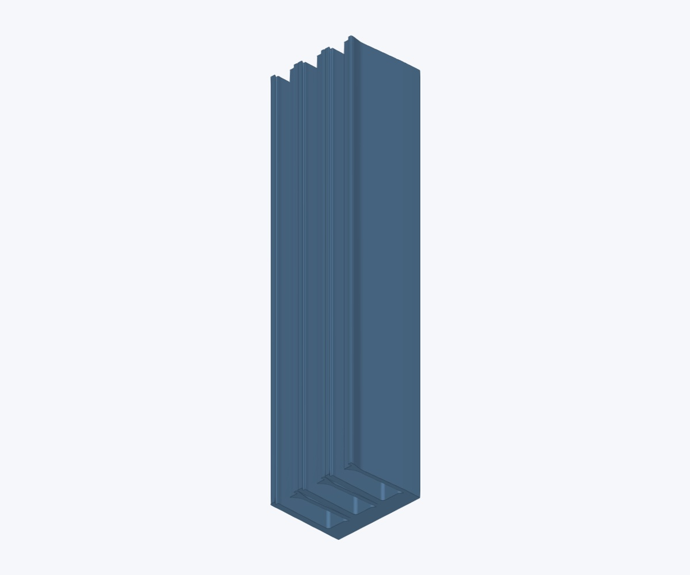
[picture p68: Microsmt-PNPv3/Strip_feeders/photos/8mm-3bit-iso-bottom-3.jpg]
8mm 3bit — bottom view 3
<td align="center"><br><sub>Bottom 3</sub></td>
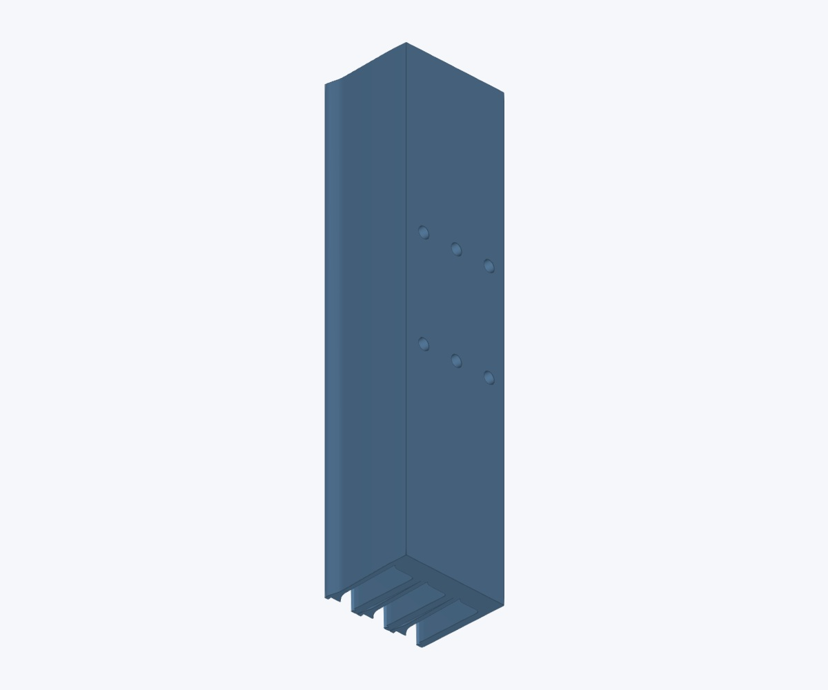
[picture p69: Microsmt-PNPv3/Strip_feeders/photos/8mm-3bit-iso-bottom-4.jpg]
8mm 3bit — bottom view 4
<td align="center"><br><sub>Bottom 4</sub></td>
</tr>
</table>

</details>

## 8 mm — 4 bit

[STEP](8mm-4bit.STEP) · [STL](8mm-4bit.stl)

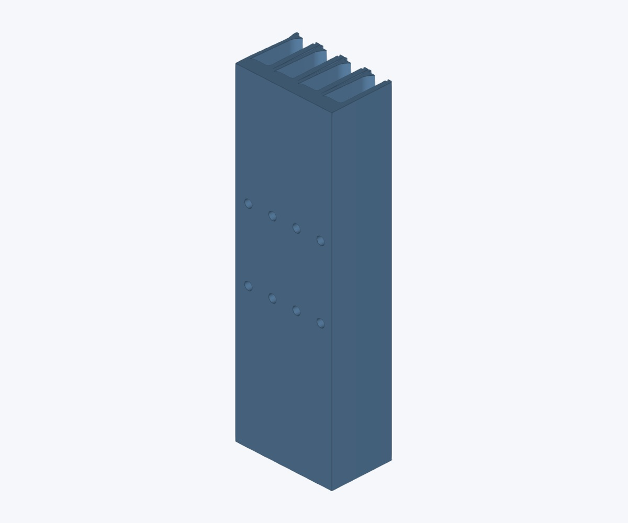
[picture p70: Microsmt-PNPv3/Strip_feeders/photos/8mm-4bit.jpg]
8mm 4bit — original preview


<details>
<summary>More views</summary>

<table>
<tr>
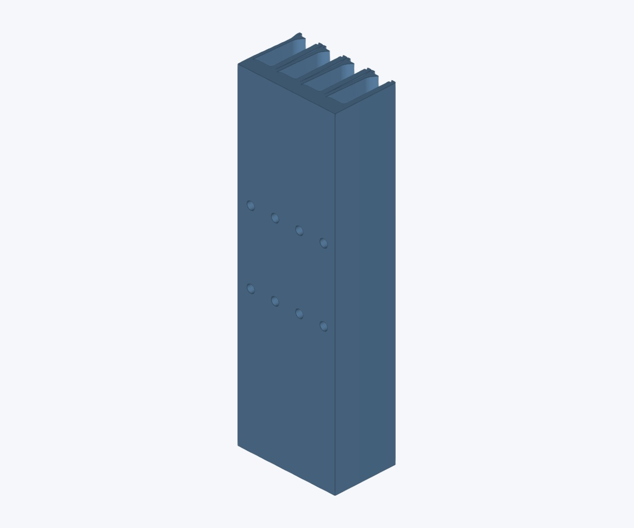
[picture p71: Microsmt-PNPv3/Strip_feeders/photos/8mm-4bit-iso-top-1.jpg]
8mm 4bit — top view 1
<td align="center"><br><sub>Top 1</sub></td>
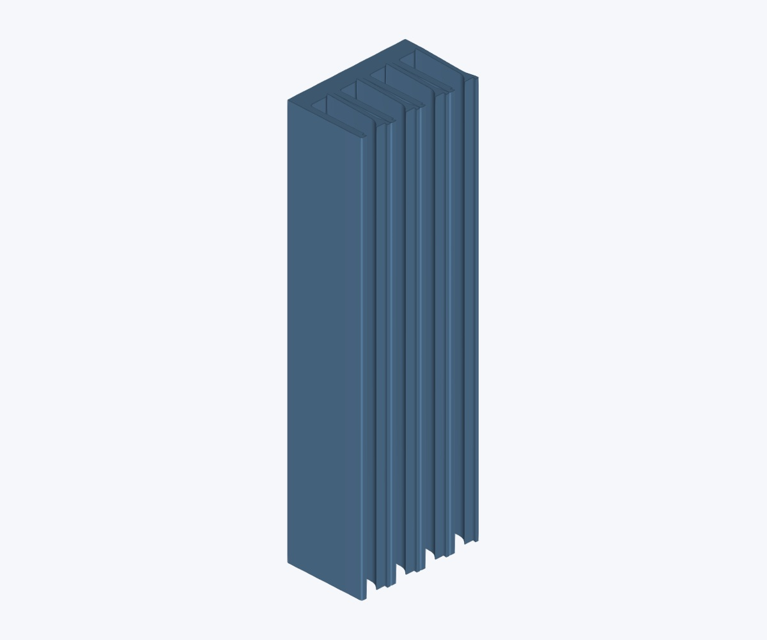
[picture p72: Microsmt-PNPv3/Strip_feeders/photos/8mm-4bit-iso-top-2.jpg]
8mm 4bit — top view 2
<td align="center"><br><sub>Top 2</sub></td>
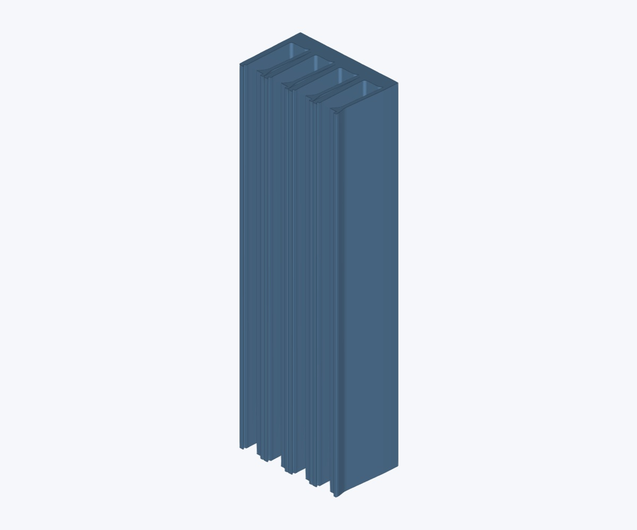
[picture p73: Microsmt-PNPv3/Strip_feeders/photos/8mm-4bit-iso-top-3.jpg]
8mm 4bit — top view 3
<td align="center"><br><sub>Top 3</sub></td>
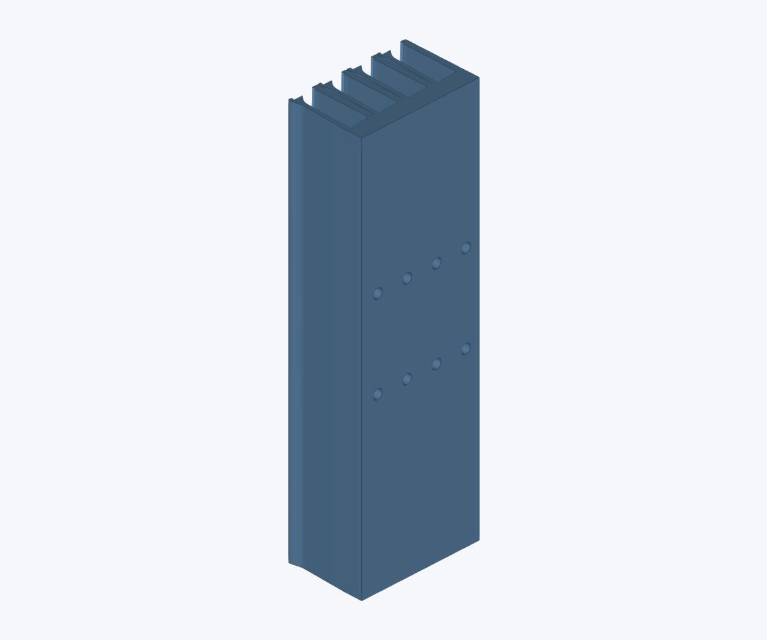
[picture p74: Microsmt-PNPv3/Strip_feeders/photos/8mm-4bit-iso-top-4.jpg]
8mm 4bit — top view 4
<td align="center"><br><sub>Top 4</sub></td>
</tr>
<tr>
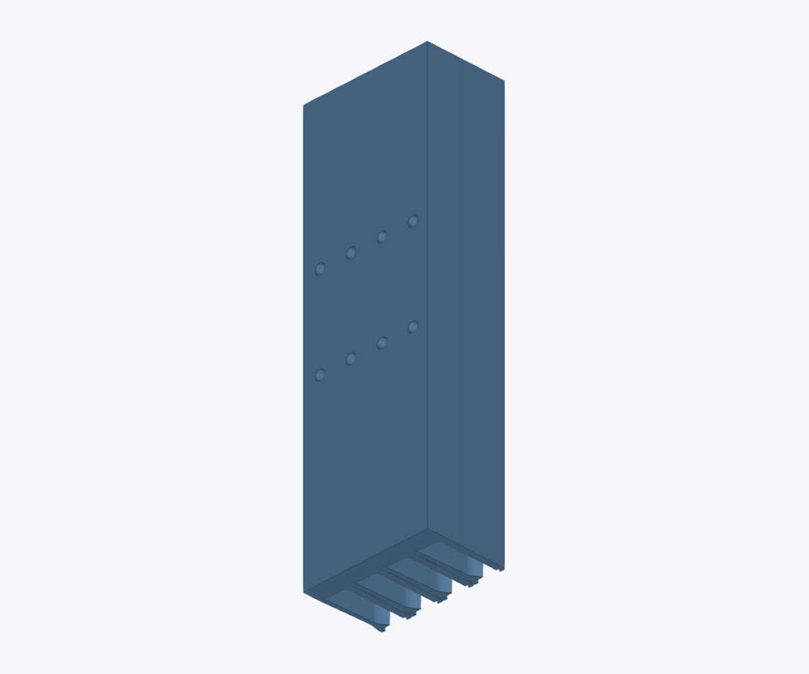
[picture p75: Microsmt-PNPv3/Strip_feeders/photos/8mm-4bit-iso-bottom-1.jpg]
8mm 4bit — bottom view 1
<td align="center"><br><sub>Bottom 1</sub></td>
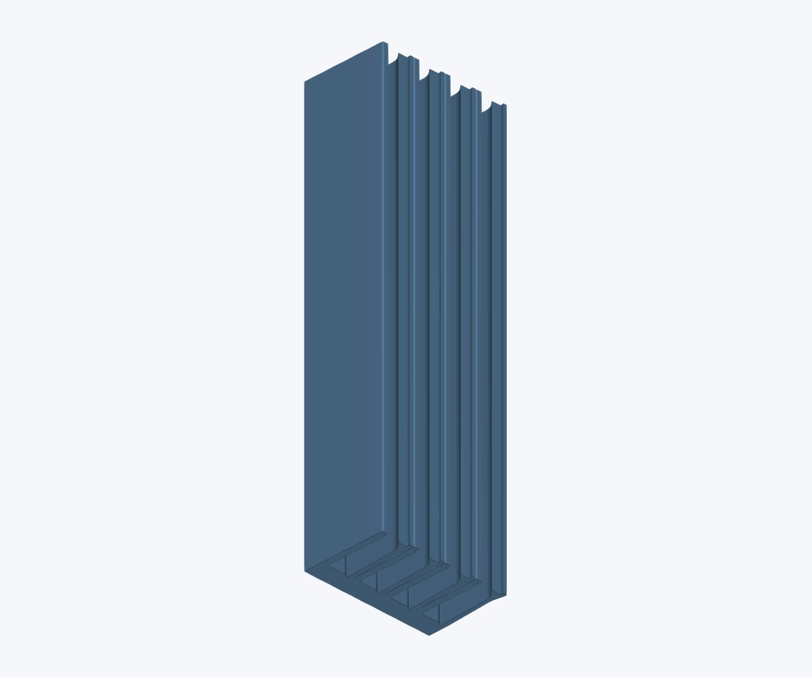
[picture p76: Microsmt-PNPv3/Strip_feeders/photos/8mm-4bit-iso-bottom-2.jpg]
8mm 4bit — bottom view 2
<td align="center"><br><sub>Bottom 2</sub></td>
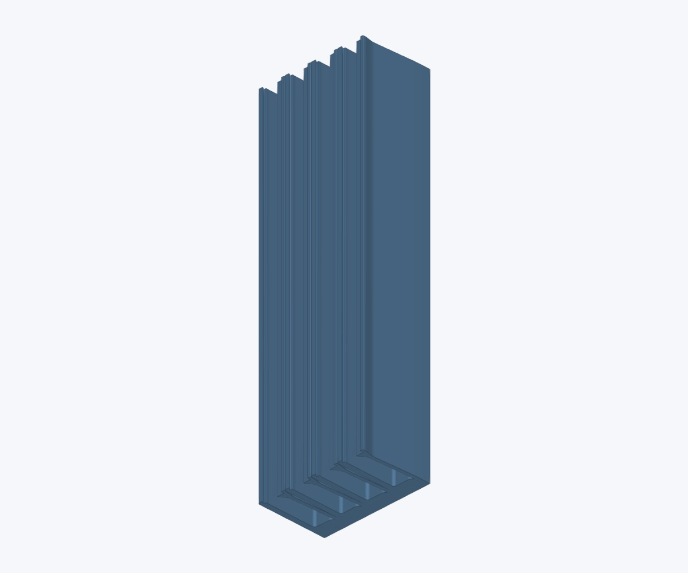
[picture p77: Microsmt-PNPv3/Strip_feeders/photos/8mm-4bit-iso-bottom-3.jpg]
8mm 4bit — bottom view 3
<td align="center"><br><sub>Bottom 3</sub></td>
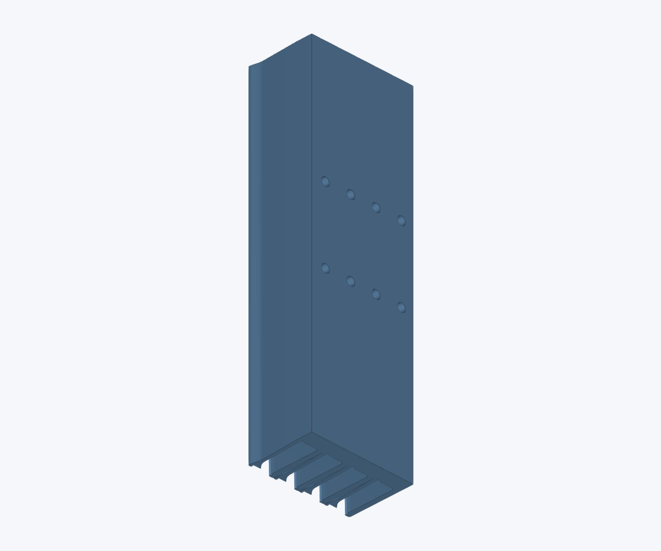
[picture p78: Microsmt-PNPv3/Strip_feeders/photos/8mm-4bit-iso-bottom-4.jpg]
8mm 4bit — bottom view 4
<td align="center"><br><sub>Bottom 4</sub></td>
</tr>
</table>

</details>

## 12 mm — 1 bit

[STEP](12mm-1bit.STEP) · [STL](12mm-1bit.stl)

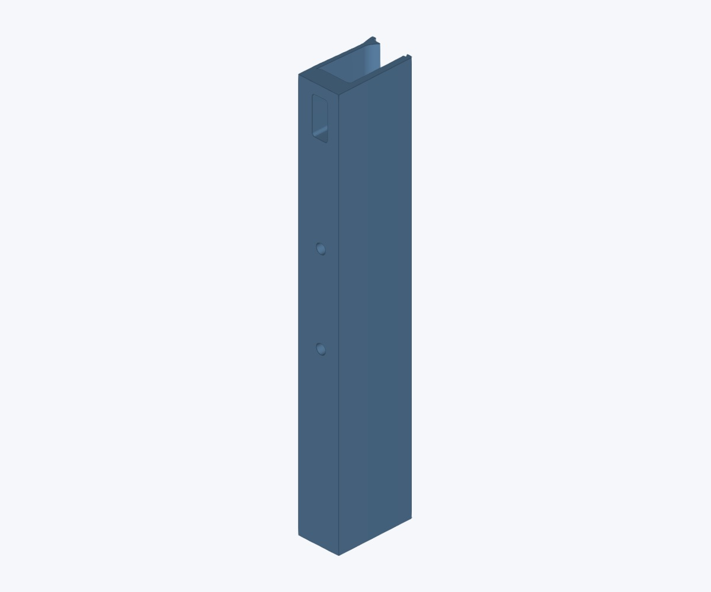
[picture p79: Microsmt-PNPv3/Strip_feeders/photos/12mm-1bit.jpg]
12mm 1bit — original preview


<details>
<summary>More views</summary>

<table>
<tr>
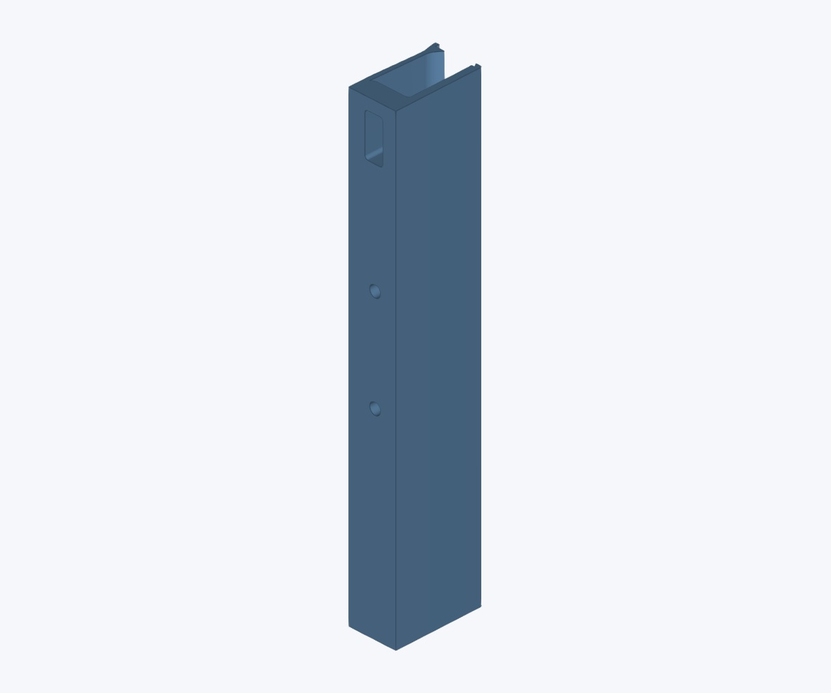
[picture p80: Microsmt-PNPv3/Strip_feeders/photos/12mm-1bit-iso-top-1.jpg]
12mm 1bit — top view 1
<td align="center"><br><sub>Top 1</sub></td>
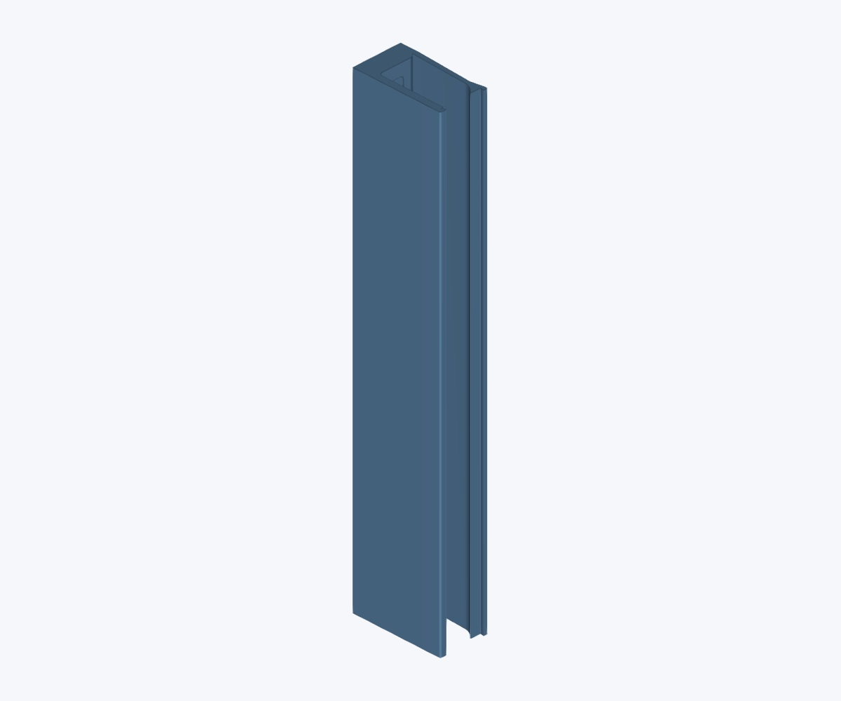
[picture p81: Microsmt-PNPv3/Strip_feeders/photos/12mm-1bit-iso-top-2.jpg]
12mm 1bit — top view 2
<td align="center"><br><sub>Top 2</sub></td>
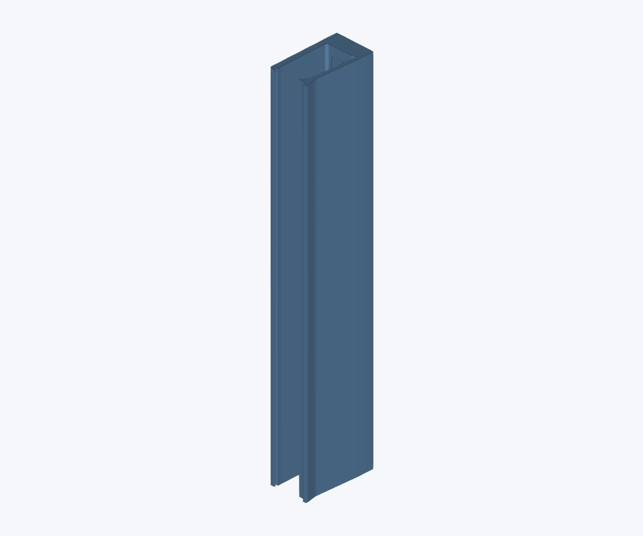
[picture p82: Microsmt-PNPv3/Strip_feeders/photos/12mm-1bit-iso-top-3.jpg]
12mm 1bit — top view 3
<td align="center"><br><sub>Top 3</sub></td>
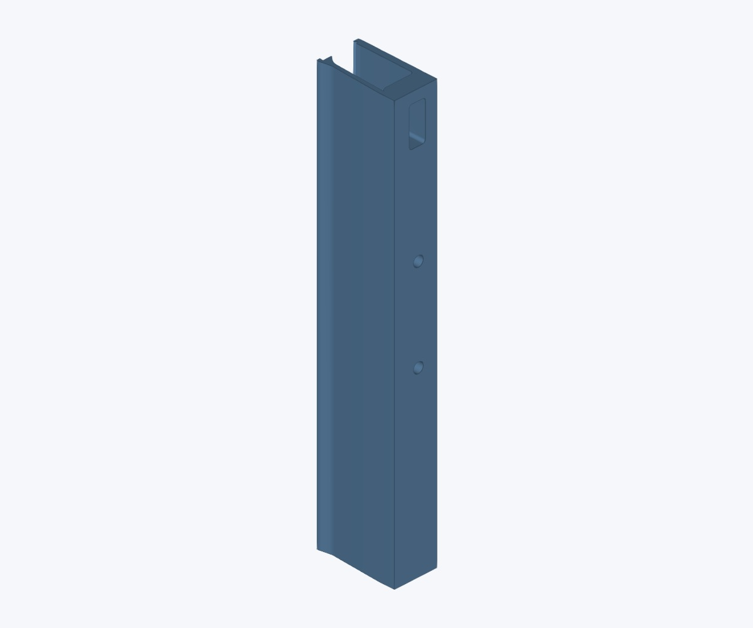
[picture p83: Microsmt-PNPv3/Strip_feeders/photos/12mm-1bit-iso-top-4.jpg]
12mm 1bit — top view 4
<td align="center"><br><sub>Top 4</sub></td>
</tr>
<tr>
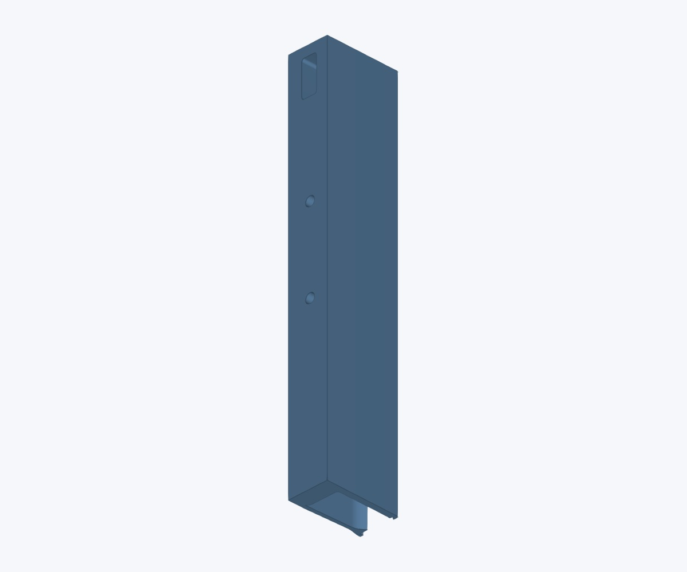
[picture p84: Microsmt-PNPv3/Strip_feeders/photos/12mm-1bit-iso-bottom-1.jpg]
12mm 1bit — bottom view 1
<td align="center"><br><sub>Bottom 1</sub></td>
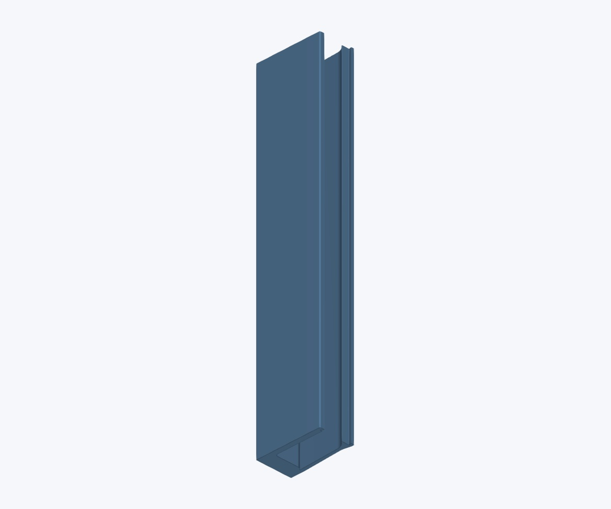
[picture p85: Microsmt-PNPv3/Strip_feeders/photos/12mm-1bit-iso-bottom-2.jpg]
12mm 1bit — bottom view 2
<td align="center"><br><sub>Bottom 2</sub></td>
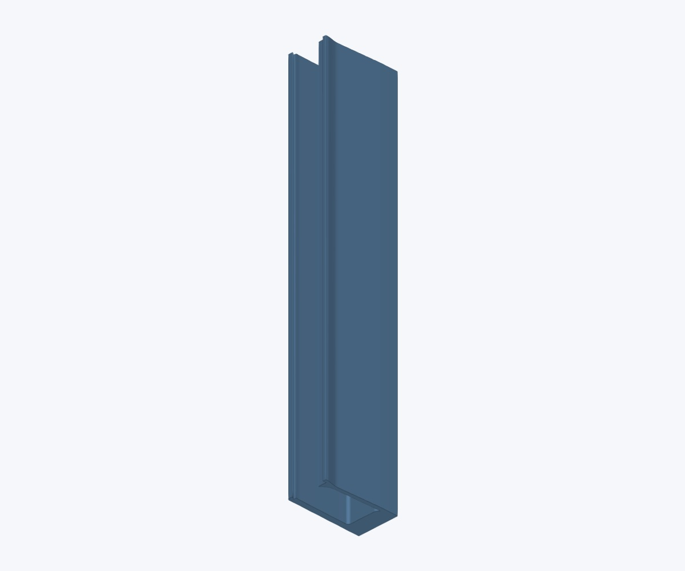
[picture p86: Microsmt-PNPv3/Strip_feeders/photos/12mm-1bit-iso-bottom-3.jpg]
12mm 1bit — bottom view 3
<td align="center"><br><sub>Bottom 3</sub></td>
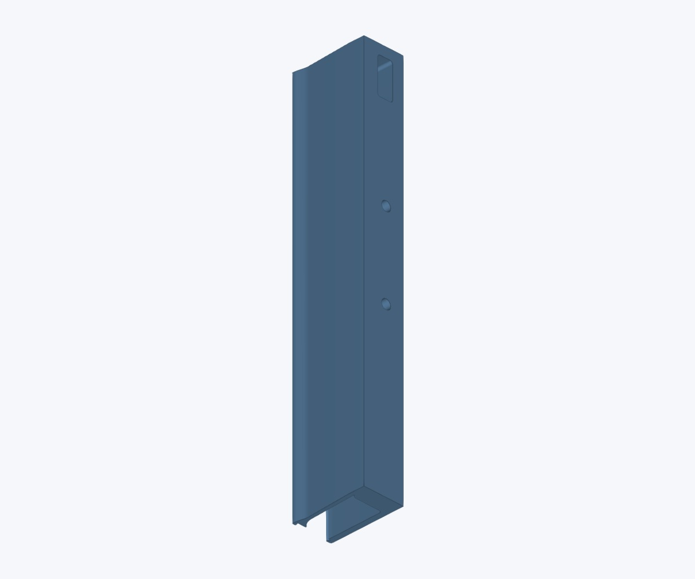
[picture p87: Microsmt-PNPv3/Strip_feeders/photos/12mm-1bit-iso-bottom-4.jpg]
12mm 1bit — bottom view 4
<td align="center"><br><sub>Bottom 4</sub></td>
</tr>
</table>

</details>

## 16 mm — 1 bit

[STEP](16mm-1bit.STEP) · [STL](16mm-1bit.stl)

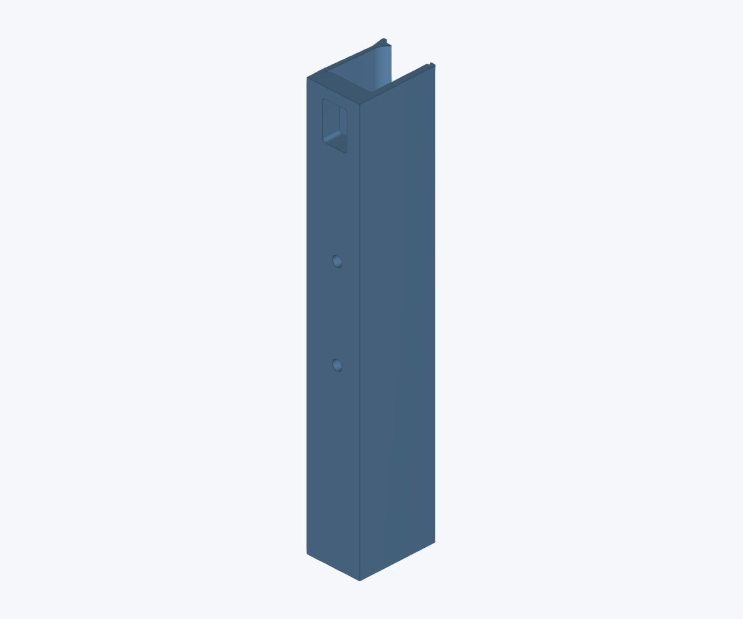
[picture p88: Microsmt-PNPv3/Strip_feeders/photos/16mm-1bit.jpg]
16mm 1bit — original preview


<details>
<summary>More views</summary>

<table>
<tr>
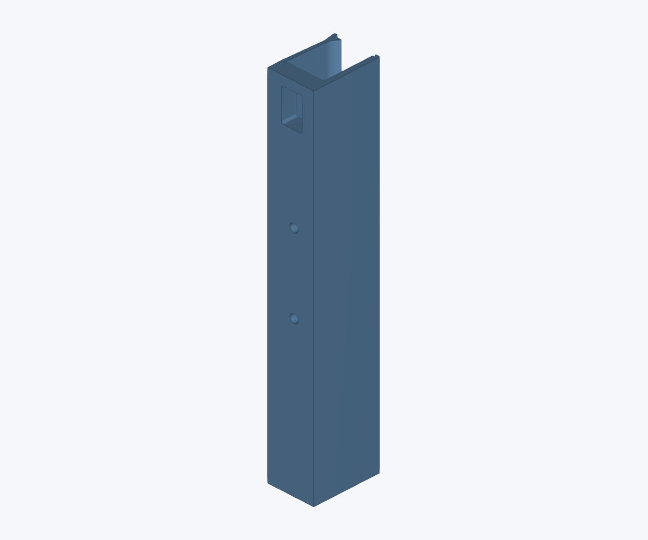
[picture p89: Microsmt-PNPv3/Strip_feeders/photos/16mm-1bit-iso-top-1.jpg]
16mm 1bit — top view 1
<td align="center"><br><sub>Top 1</sub></td>
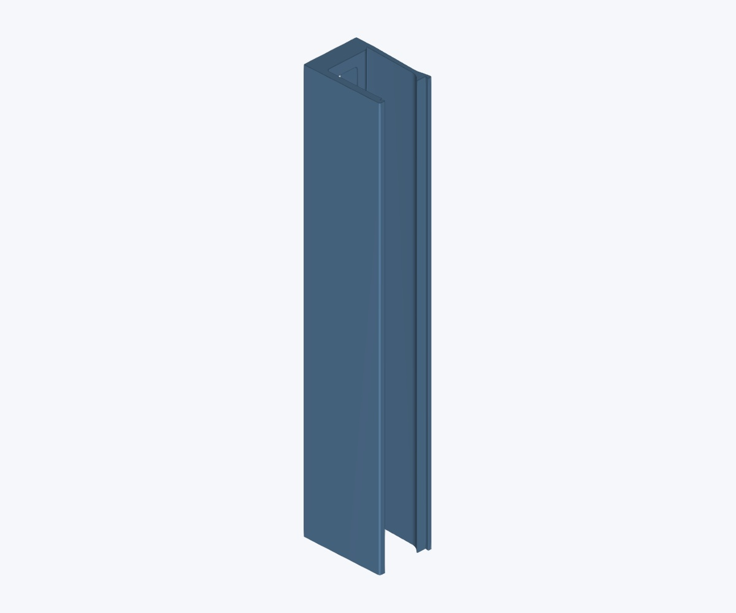
[picture p90: Microsmt-PNPv3/Strip_feeders/photos/16mm-1bit-iso-top-2.jpg]
16mm 1bit — top view 2
<td align="center"><br><sub>Top 2</sub></td>
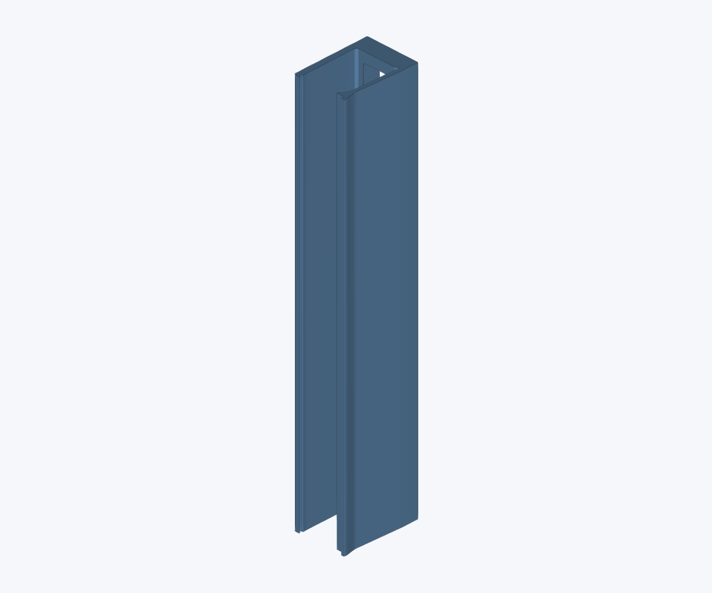
[picture p91: Microsmt-PNPv3/Strip_feeders/photos/16mm-1bit-iso-top-3.jpg]
16mm 1bit — top view 3
<td align="center"><br><sub>Top 3</sub></td>
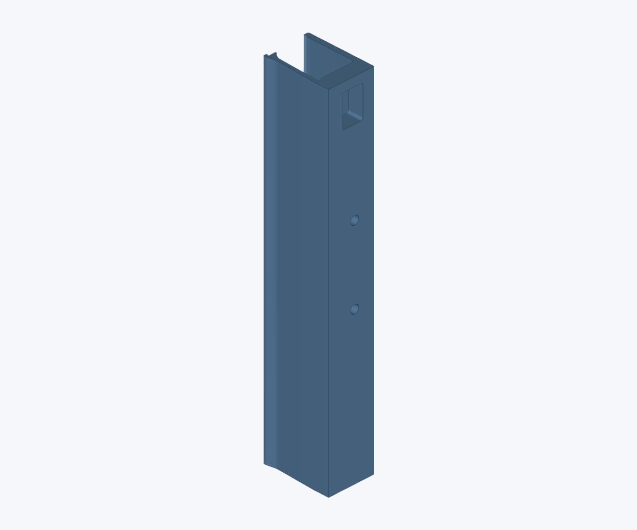
[picture p92: Microsmt-PNPv3/Strip_feeders/photos/16mm-1bit-iso-top-4.jpg]
16mm 1bit — top view 4
<td align="center"><br><sub>Top 4</sub></td>
</tr>
<tr>
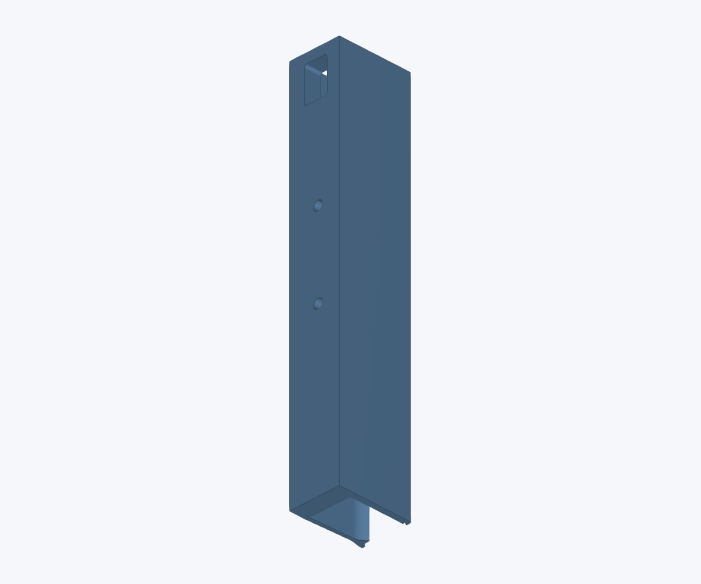
[picture p93: Microsmt-PNPv3/Strip_feeders/photos/16mm-1bit-iso-bottom-1.jpg]
16mm 1bit — bottom view 1
<td align="center"><br><sub>Bottom 1</sub></td>
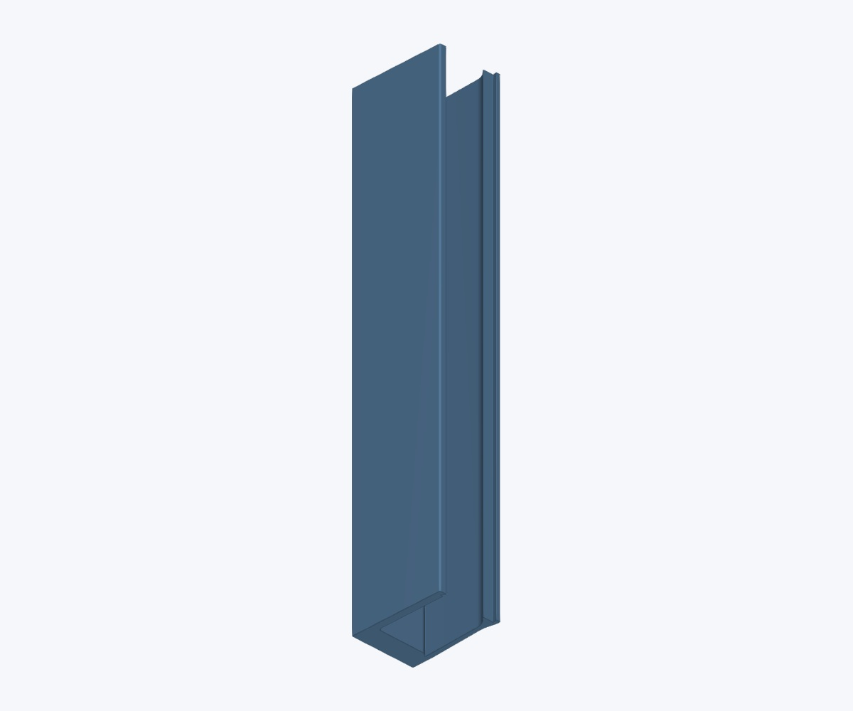
[picture p94: Microsmt-PNPv3/Strip_feeders/photos/16mm-1bit-iso-bottom-2.jpg]
16mm 1bit — bottom view 2
<td align="center"><br><sub>Bottom 2</sub></td>
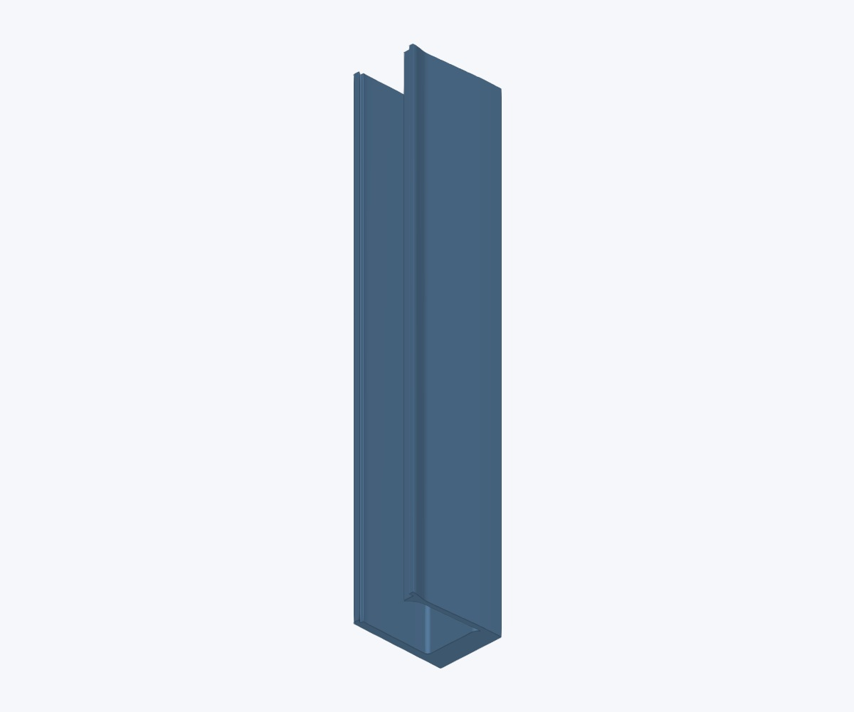
[picture p95: Microsmt-PNPv3/Strip_feeders/photos/16mm-1bit-iso-bottom-3.jpg]
16mm 1bit — bottom view 3
<td align="center"><br><sub>Bottom 3</sub></td>
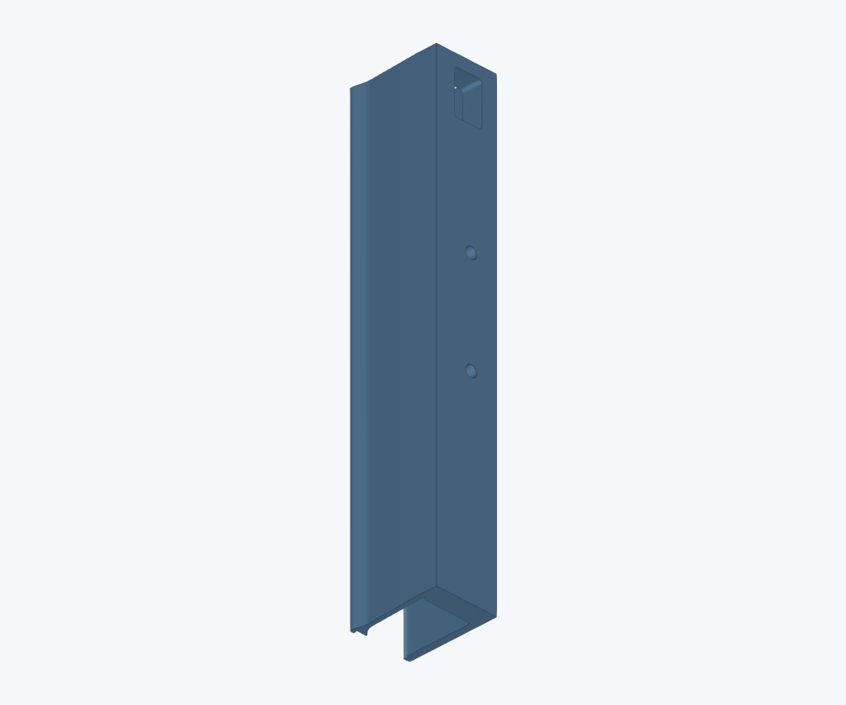
[picture p96: Microsmt-PNPv3/Strip_feeders/photos/16mm-1bit-iso-bottom-4.jpg]
16mm 1bit — bottom view 4
<td align="center"><br><sub>Bottom 4</sub></td>
</tr>
</table>

</details>

## 24 mm — 1 bit

[STEP](24mm-1bit.STEP) · [STL](24mm-1bit.stl)

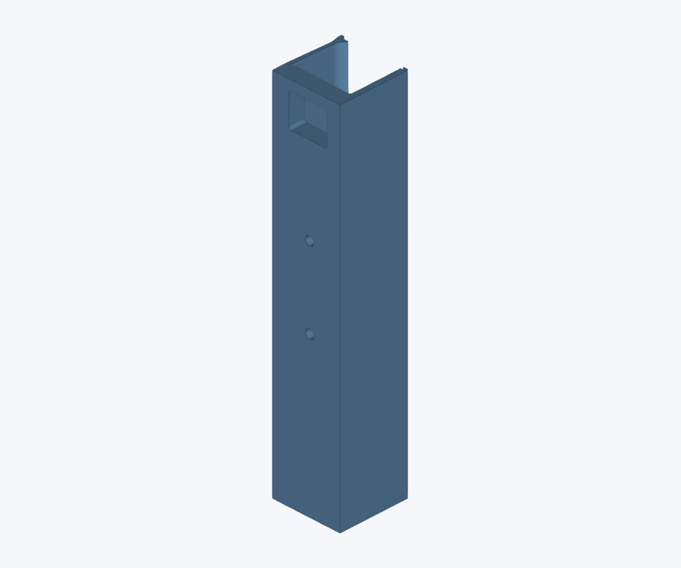
[picture p97: Microsmt-PNPv3/Strip_feeders/photos/24mm-1bit.jpg]
24mm 1bit — original preview


<details>
<summary>More views</summary>

<table>
<tr>
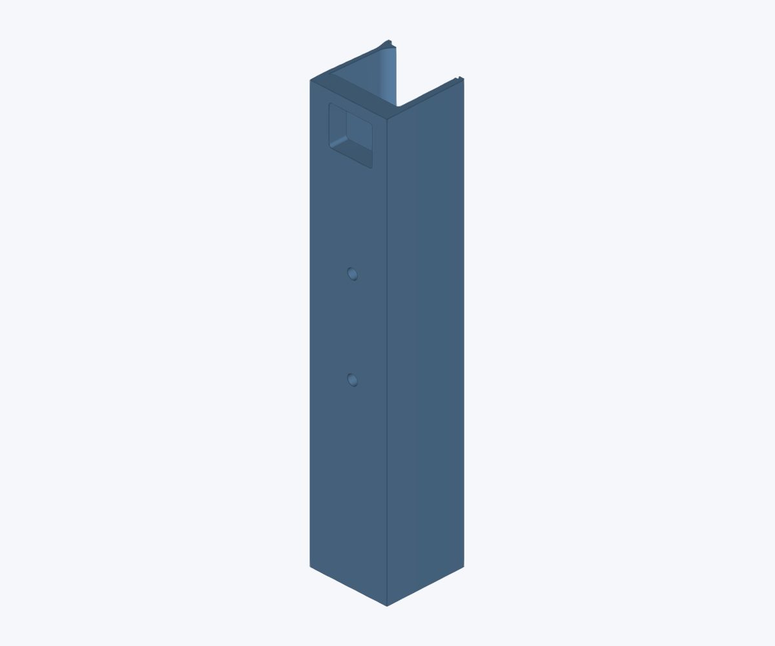
[picture p98: Microsmt-PNPv3/Strip_feeders/photos/24mm-1bit-iso-top-1.jpg]
24mm 1bit — top view 1
<td align="center"><br><sub>Top 1</sub></td>
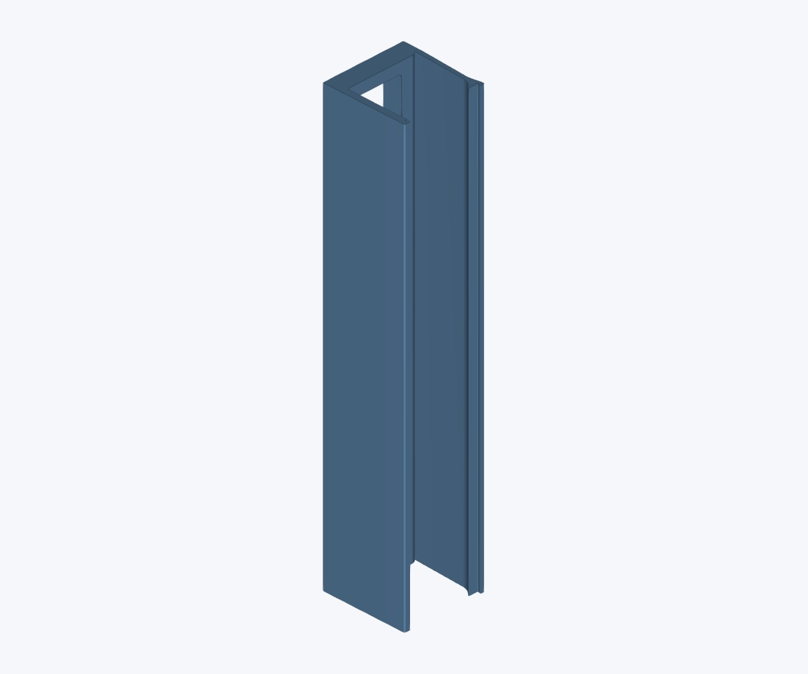
[picture p99: Microsmt-PNPv3/Strip_feeders/photos/24mm-1bit-iso-top-2.jpg]
24mm 1bit — top view 2
<td align="center"><br><sub>Top 2</sub></td>
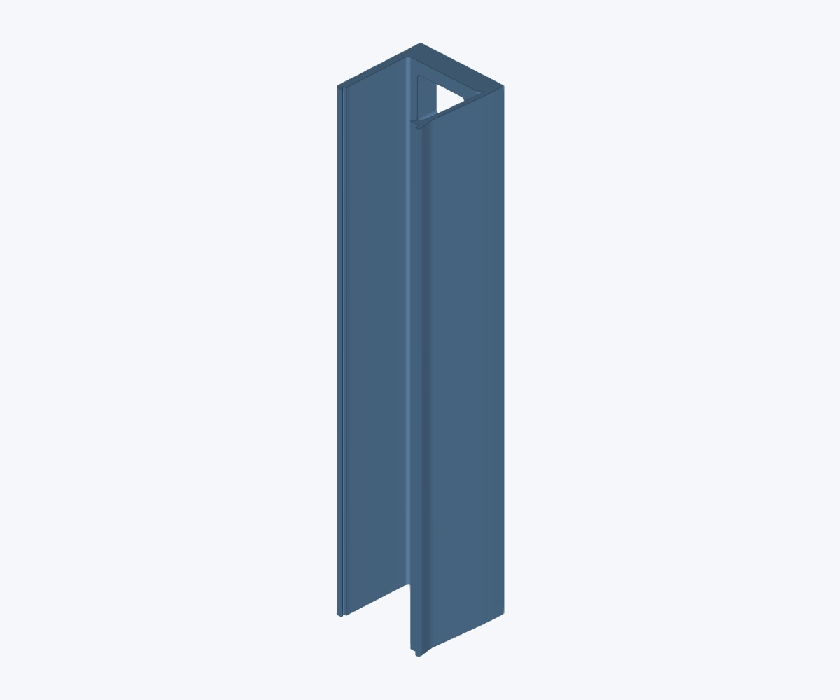
[picture p100: Microsmt-PNPv3/Strip_feeders/photos/24mm-1bit-iso-top-3.jpg]
24mm 1bit — top view 3
<td align="center"><br><sub>Top 3</sub></td>
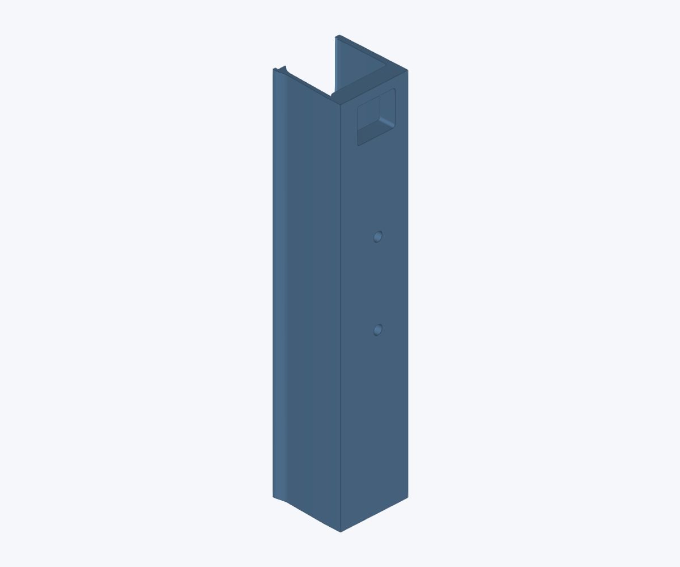
[picture p101: Microsmt-PNPv3/Strip_feeders/photos/24mm-1bit-iso-top-4.jpg]
24mm 1bit — top view 4
<td align="center"><br><sub>Top 4</sub></td>
</tr>
<tr>
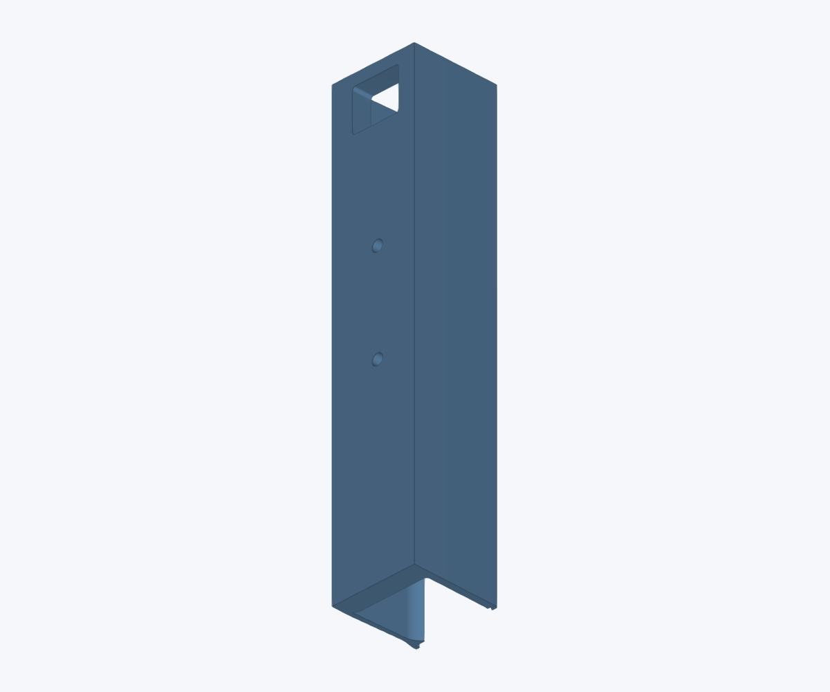
[picture p102: Microsmt-PNPv3/Strip_feeders/photos/24mm-1bit-iso-bottom-1.jpg]
24mm 1bit — bottom view 1
<td align="center"><br><sub>Bottom 1</sub></td>
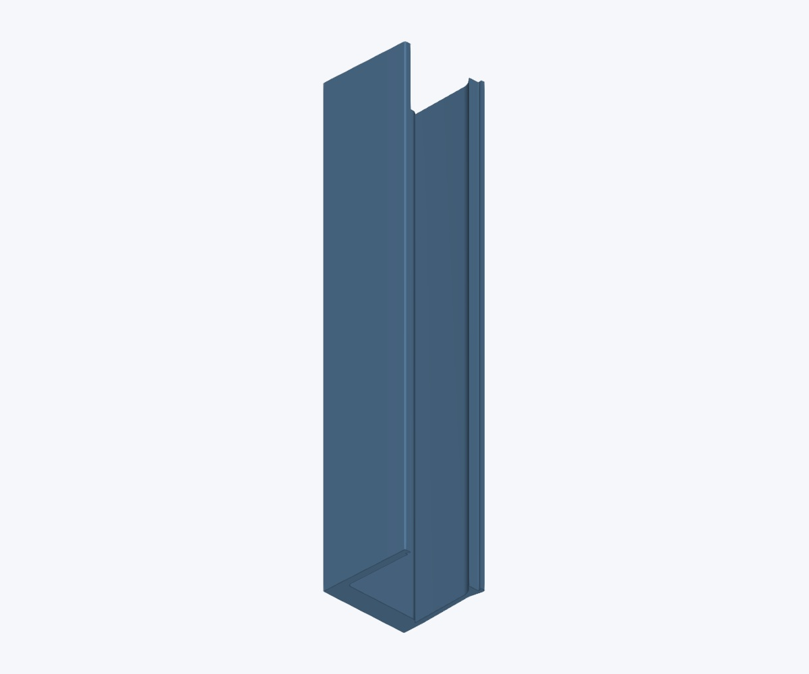
[picture p103: Microsmt-PNPv3/Strip_feeders/photos/24mm-1bit-iso-bottom-2.jpg]
24mm 1bit — bottom view 2
<td align="center"><br><sub>Bottom 2</sub></td>
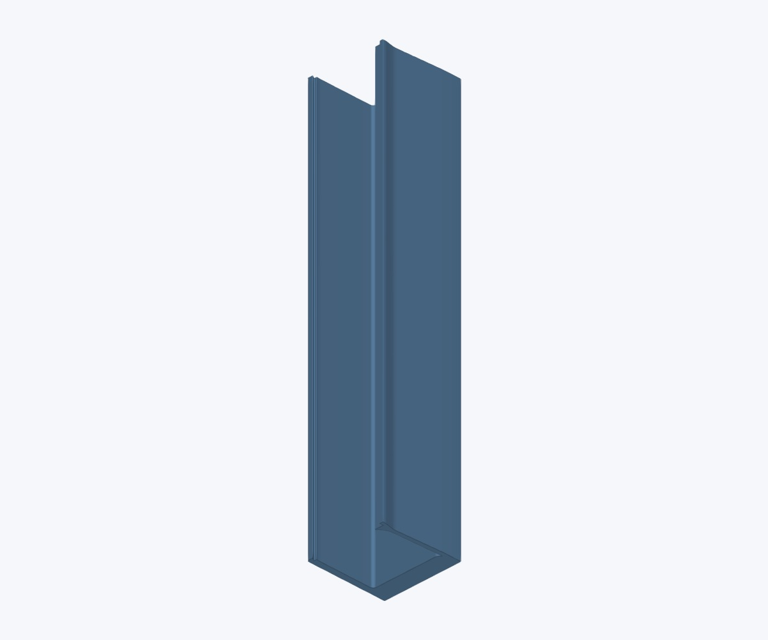
[picture p104: Microsmt-PNPv3/Strip_feeders/photos/24mm-1bit-iso-bottom-3.jpg]
24mm 1bit — bottom view 3
<td align="center"><br><sub>Bottom 3</sub></td>
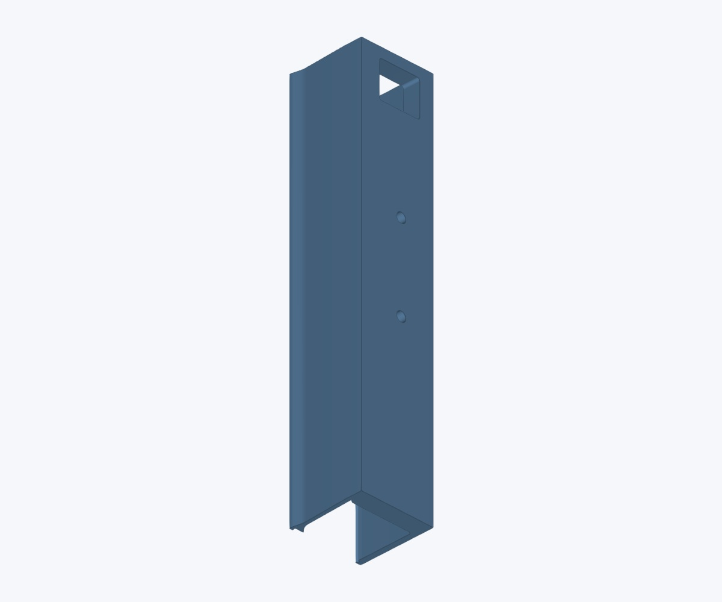
[picture p105: Microsmt-PNPv3/Strip_feeders/photos/24mm-1bit-iso-bottom-4.jpg]
24mm 1bit — bottom view 4
<td align="center"><br><sub>Bottom 4</sub></td>
</tr>
</table>

</details>
