gabrielyoung92/gabs_microSMT_PickAndPlace/Bing-feeder/V485-Feeder Controller/PCB_busbar_long_480mm/README.md

# V485 busbar — 480 mm

> Designs and original files by [MicroSMT](https://github.com/microsmt/Bing-feeder). [Credits and local changes](../../../CREDITS.md).

[Back to collection](../README.md)

Gerbers, editable KiCad files and previews are below.

## KiCad files

Open `.kicad_pro` in **KiCad 10**. Keep the whole `KiCad/` folder together; it contains the local libraries.

The schematics show pad numbers and connections. Use the supplied schematic for pin functions. Review the reported ERC/DRC findings before making a board.

| Project | Open in KiCad | Supporting reports |
| --- | --- | --- |
| V485 480 mm busbar | [v485_busbar_480mm.kicad_pro](KiCad/v485_busbar_480mm.kicad_pro) | [Recovery](docs/recovery.json) · [Validation](docs/validation.json) |

[Recovery details](docs/KICAD_RECOVERY.md) · [Method and editing limits](../../../tools/kicad/RECOVERY_NOTES.md)

## Original board views

[Download Gerber ZIP](Gerber_PCB1_2026-10-09.zip)

<table>
<tr>
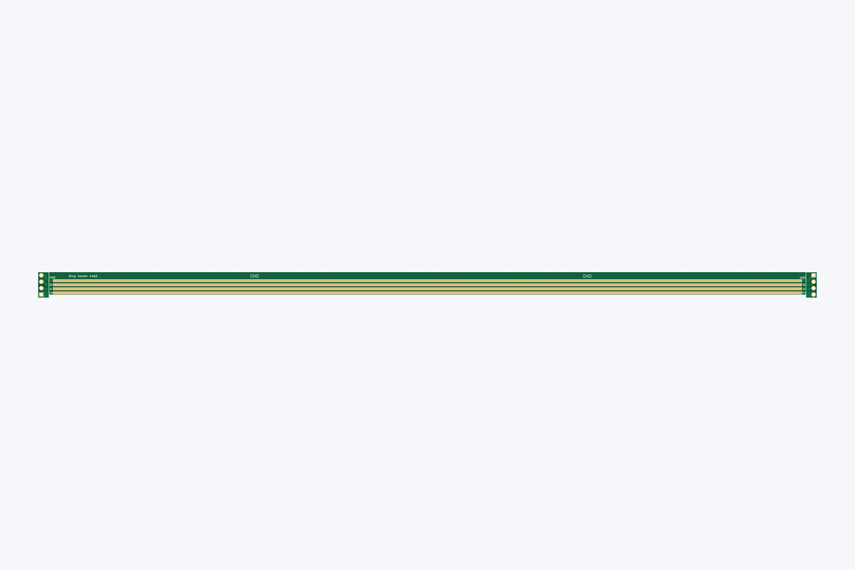
[picture p106: Bing-feeder/V485-Feeder Controller/PCB_busbar_long_480mm/photos/Gerber_PCB1_2026-10-09-top.jpg]
Top
<td align="center"><br><sub>Top</sub></td>
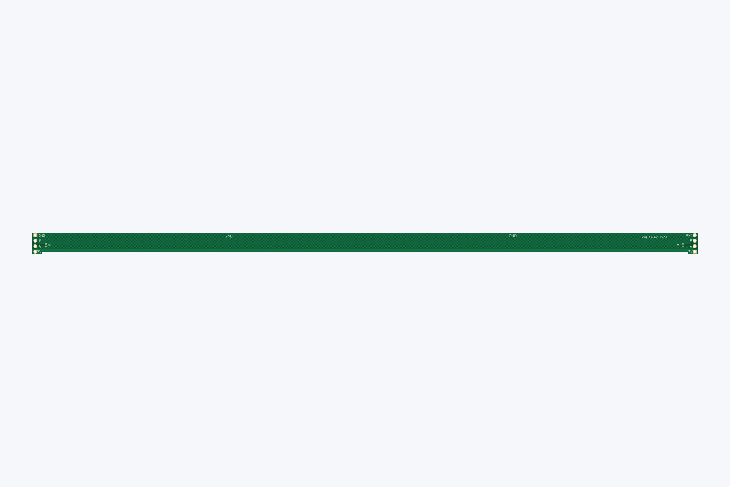
[picture p107: Bing-feeder/V485-Feeder Controller/PCB_busbar_long_480mm/photos/Gerber_PCB1_2026-10-09-bottom.jpg]
Bottom
<td align="center"><br><sub>Bottom</sub></td>
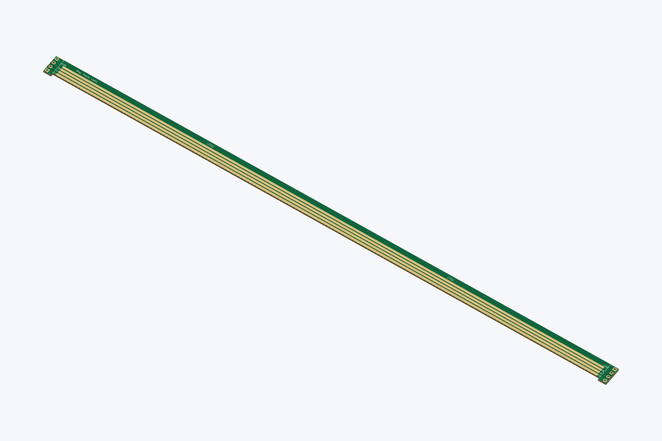
[picture p108: Bing-feeder/V485-Feeder Controller/PCB_busbar_long_480mm/photos/Gerber_PCB1_2026-10-09-iso.jpg]
Top-side isometric
<td align="center"><br><sub>Top-side isometric</sub></td>
</tr>
</table>

## Assembly notes

MicroSMT specifies **two 480 mm busbars per PNP machine**: one at the front and one at the back.

Gerber previews use display colours and an assumed 1.6 mm thickness; use source data for manufacturing dimensions.

## KiCad previews

KiCad reconstruction views; source Gerber views are above.

### V485 480 mm busbar

<table>
<tr>
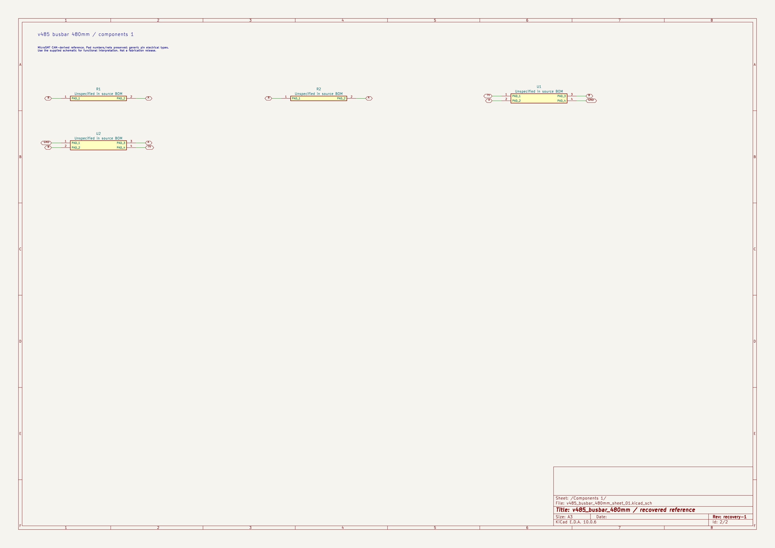
[picture p109: Bing-feeder/V485-Feeder Controller/PCB_busbar_long_480mm/photos/kicad-v485_busbar_480mm-schematic.jpg]
Recovered schematic
<td align="center"><br><sub>Recovered schematic</sub></td>
<td align="center"><a href="photos/kicad-v485_busbar_480mm-top.jpg">Recovered PCB top</a><br><sub>Recovered PCB top</sub></td>
<td align="center"><a href="photos/kicad-v485_busbar_480mm-bottom.jpg">Recovered PCB bottom</a><br><sub>Recovered PCB bottom</sub></td>
</tr>
</table>

[Sheet overview](photos/kicad-v485_busbar_480mm-overview.jpg) · [Components 1](photos/kicad-v485_busbar_480mm-sheet-01.jpg)
