gabrielyoung92/gabs_microSMT_PickAndPlace/Bing-feeder/V485-Feeder Controller/PCB_busbar_short_180mm/README.md

# V485 busbars — 180 mm

> Designs and original files by [MicroSMT](https://github.com/microsmt/Bing-feeder). [Credits and local changes](../../../CREDITS.md).

[Back to collection](../README.md)

Gerbers, editable KiCad files and previews are below.

## KiCad files

Open `.kicad_pro` in **KiCad 10**. Keep the whole `KiCad/` folder together; it contains the local libraries.

The schematics show pad numbers and connections. Use the supplied schematic for pin functions. Review the reported ERC/DRC findings before making a board.

| Project | Open in KiCad | Supporting reports |
| --- | --- | --- |
| V485 short busbar PCB1 | [v485_busbar_180mm_pcb1.kicad_pro](KiCad/v485_busbar_180mm_pcb1.kicad_pro) | [Recovery](docs/v485_busbar_180mm_pcb1-recovery.json) · [Validation](docs/v485_busbar_180mm_pcb1-validation.json) |
| V485 short busbar PCB2 | [v485_busbar_180mm_pcb2.kicad_pro](KiCad/v485_busbar_180mm_pcb2.kicad_pro) | [Recovery](docs/v485_busbar_180mm_pcb2-recovery.json) · [Validation](docs/v485_busbar_180mm_pcb2-validation.json) |
| V485 short busbar PCB4 | [v485_busbar_180mm_pcb4.kicad_pro](KiCad/v485_busbar_180mm_pcb4.kicad_pro) | [Recovery](docs/v485_busbar_180mm_pcb4-recovery.json) · [Validation](docs/v485_busbar_180mm_pcb4-validation.json) |

[Recovery details](docs/KICAD_RECOVERY.md) · [Method and editing limits](../../../tools/kicad/RECOVERY_NOTES.md)

## PCB1 Gerber views

[Download Gerber ZIP](Gerber_PCB1_2026-10-09.zip)

<table>
<tr>
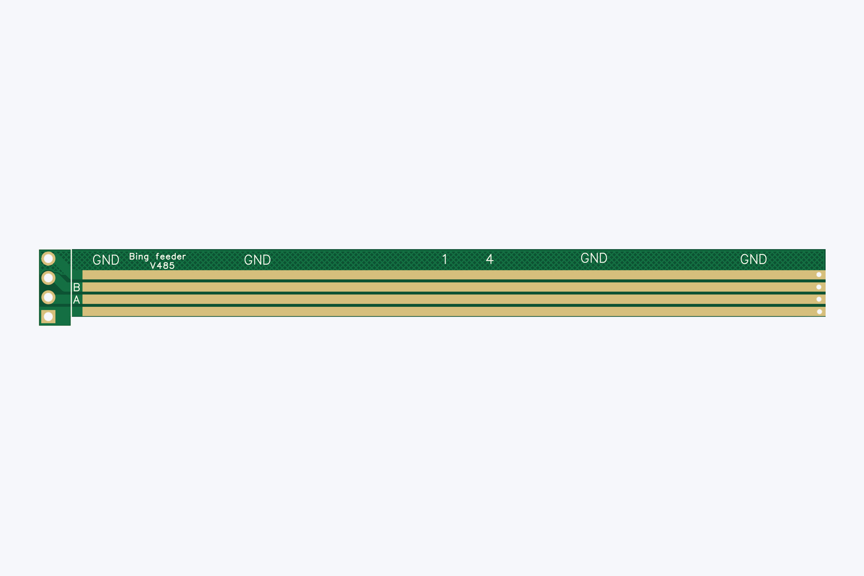
[picture p110: Bing-feeder/V485-Feeder Controller/PCB_busbar_short_180mm/photos/Gerber_PCB1_2026-10-09-top.jpg]
<td align="center"><br><sub>Top</sub></td>
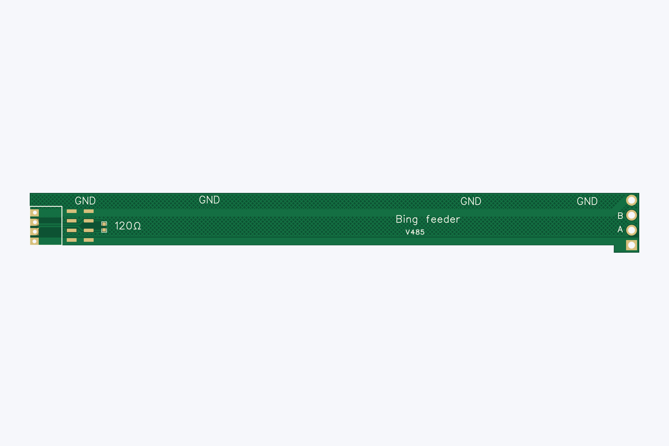
[picture p111: Bing-feeder/V485-Feeder Controller/PCB_busbar_short_180mm/photos/Gerber_PCB1_2026-10-09-bottom.jpg]
Bottom
<td align="center"><br><sub>Bottom</sub></td>
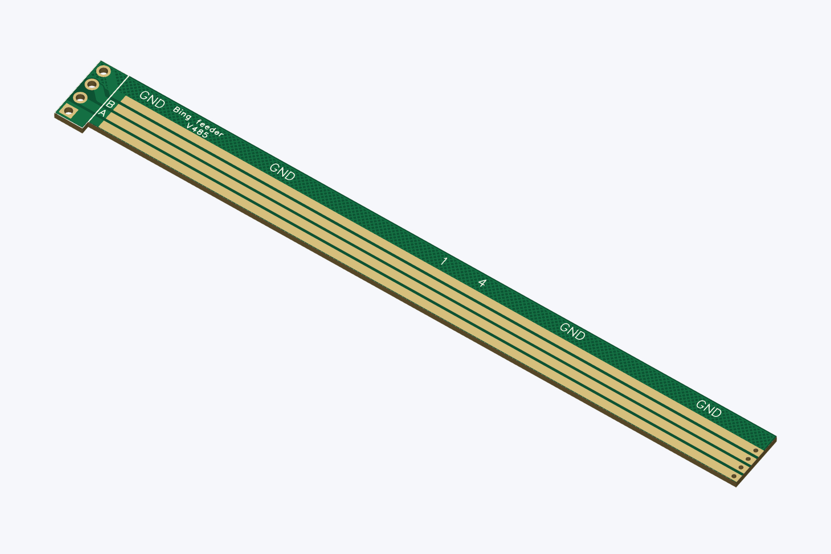
[picture p112: Bing-feeder/V485-Feeder Controller/PCB_busbar_short_180mm/photos/Gerber_PCB1_2026-10-09-iso.jpg]
<td align="center"><br><sub>Top-side isometric</sub></td>
</tr>
</table>

## PCB2 Gerber views

[Download Gerber ZIP](Gerber_PCB2_2026-10-09.zip)

<table>
<tr>
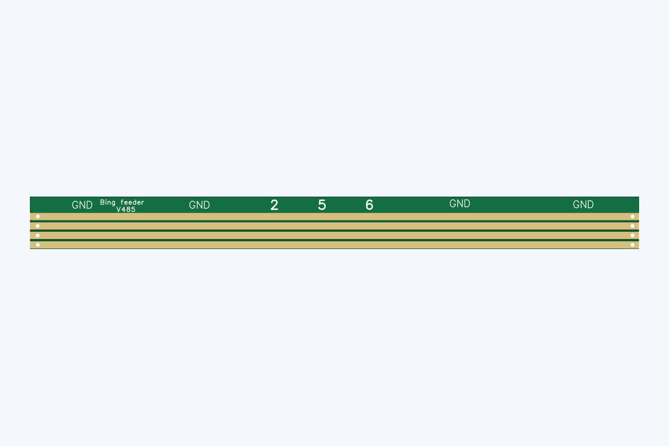
[picture p113: Bing-feeder/V485-Feeder Controller/PCB_busbar_short_180mm/photos/Gerber_PCB2_2026-10-09-top.jpg]
<td align="center"><br><sub>Top</sub></td>
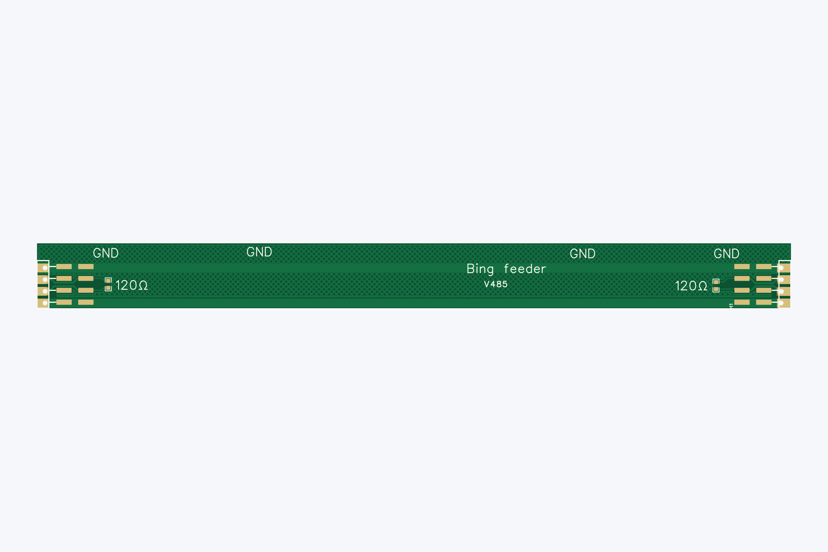
[picture p114: Bing-feeder/V485-Feeder Controller/PCB_busbar_short_180mm/photos/Gerber_PCB2_2026-10-09-bottom.jpg]
Bottom
<td align="center"><br><sub>Bottom</sub></td>
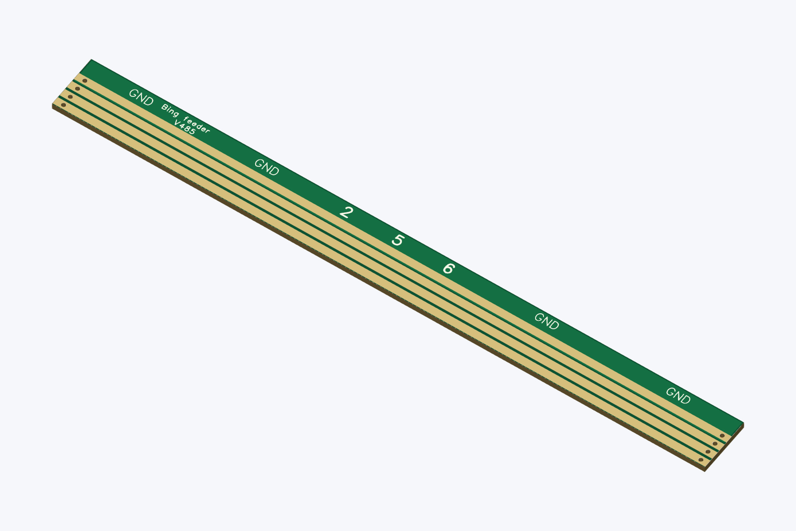
[picture p115: Bing-feeder/V485-Feeder Controller/PCB_busbar_short_180mm/photos/Gerber_PCB2_2026-10-09-iso.jpg]
<td align="center"><br><sub>Top-side isometric</sub></td>
</tr>
</table>

## PCB4 Gerber views

[Download Gerber ZIP](Gerber_PCB4_2026-10-09.zip)

<table>
<tr>
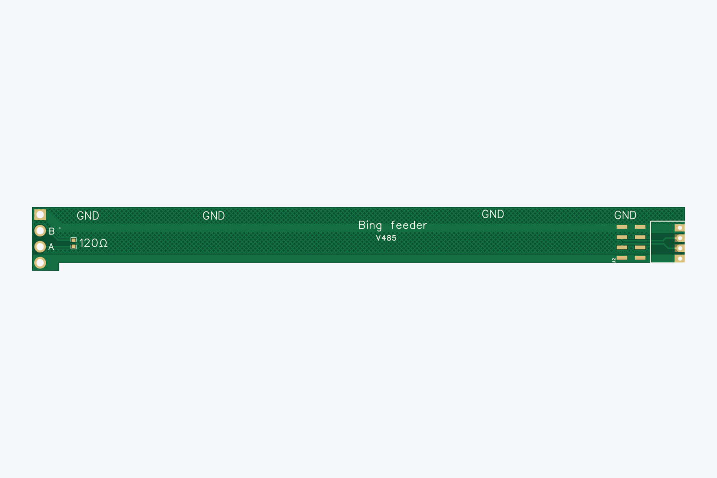
[picture p116: Bing-feeder/V485-Feeder Controller/PCB_busbar_short_180mm/photos/Gerber_PCB4_2026-10-09-top.jpg]
<td align="center"><br><sub>Top</sub></td>
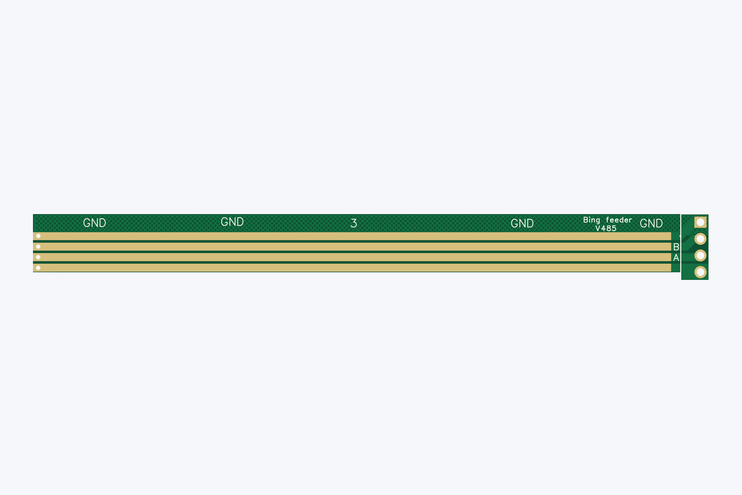
[picture p117: Bing-feeder/V485-Feeder Controller/PCB_busbar_short_180mm/photos/Gerber_PCB4_2026-10-09-bottom.jpg]
Bottom
<td align="center"><br><sub>Bottom</sub></td>
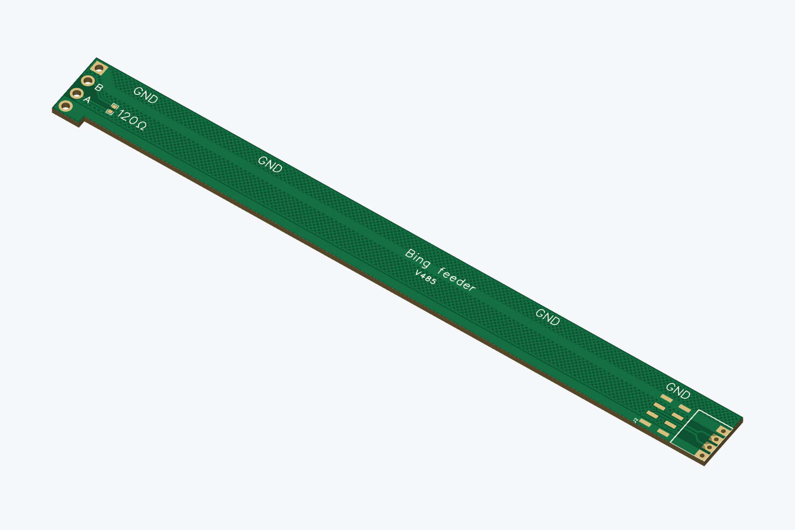
[picture p118: Bing-feeder/V485-Feeder Controller/PCB_busbar_short_180mm/photos/Gerber_PCB4_2026-10-09-iso.jpg]
<td align="center"><br><sub>Top-side isometric</sub></td>
</tr>
</table>

## Assembly notes

MicroSMT supplies 180 mm PCB busbars because the shorter sections are easier to transport. **PCB1, PCB2 and PCB4 each require two pieces.**

Gerber previews use display colours and an assumed 1.6 mm thickness; use source data for manufacturing dimensions.

## KiCad previews

KiCad reconstruction views; source Gerber views are above.

### V485 short busbar PCB1

<table>
<tr>
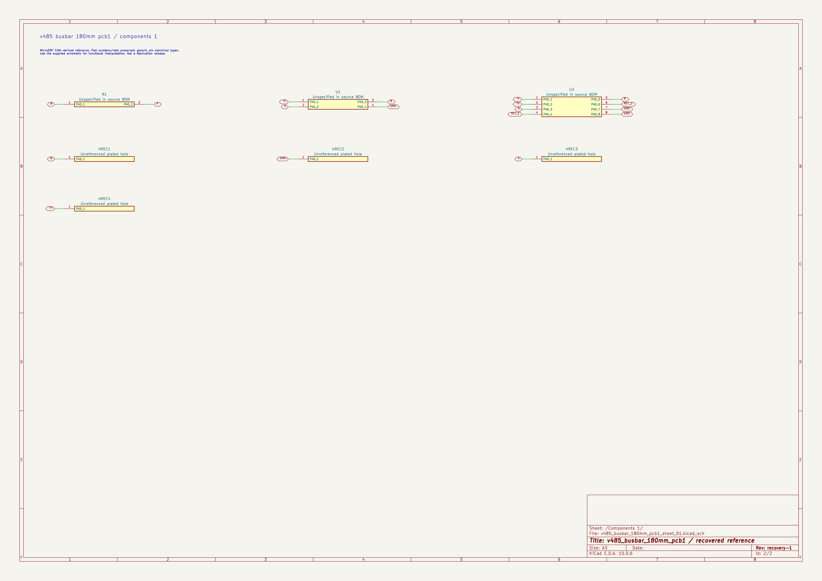
[picture p119: Bing-feeder/V485-Feeder Controller/PCB_busbar_short_180mm/photos/kicad-v485_busbar_180mm_pcb1-schematic.jpg]
Recovered schematic
<td align="center"><br><sub>Recovered schematic</sub></td>
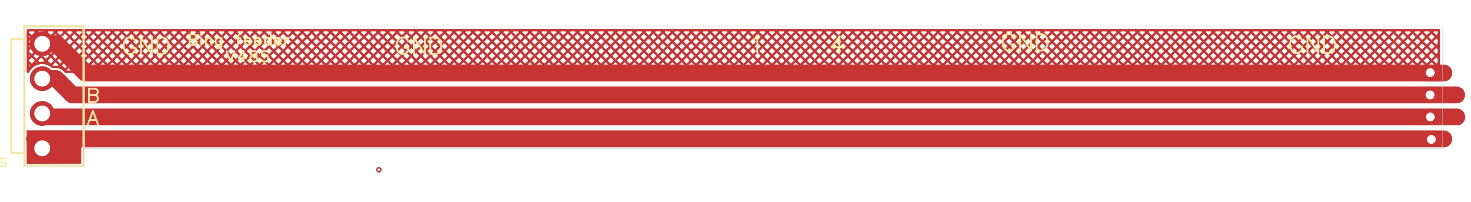
[picture p120: Bing-feeder/V485-Feeder Controller/PCB_busbar_short_180mm/photos/kicad-v485_busbar_180mm_pcb1-top.jpg]
<td align="center"><br><sub>Recovered PCB top</sub></td>
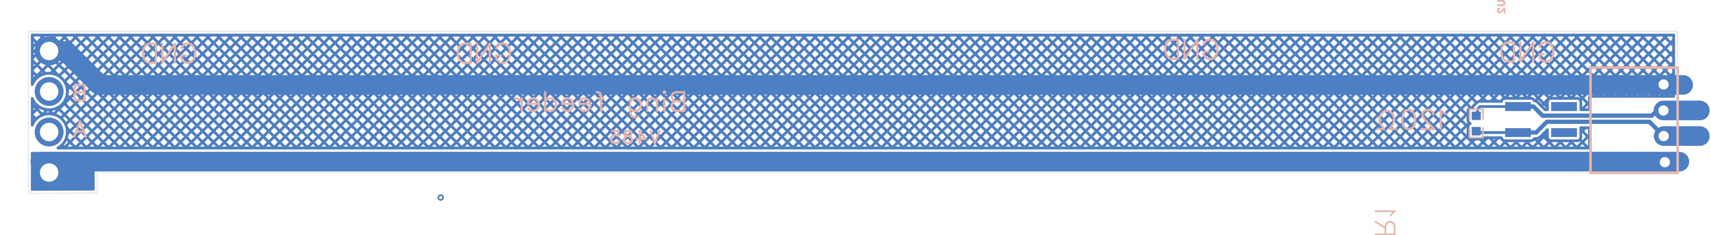
[picture p121: Bing-feeder/V485-Feeder Controller/PCB_busbar_short_180mm/photos/kicad-v485_busbar_180mm_pcb1-bottom.jpg]
Recovered PCB bottom
<td align="center"><br><sub>Recovered PCB bottom</sub></td>
</tr>
</table>

[Sheet overview](photos/kicad-v485_busbar_180mm_pcb1-overview.jpg) · [Components 1](photos/kicad-v485_busbar_180mm_pcb1-sheet-01.jpg)

### V485 short busbar PCB2

<table>
<tr>
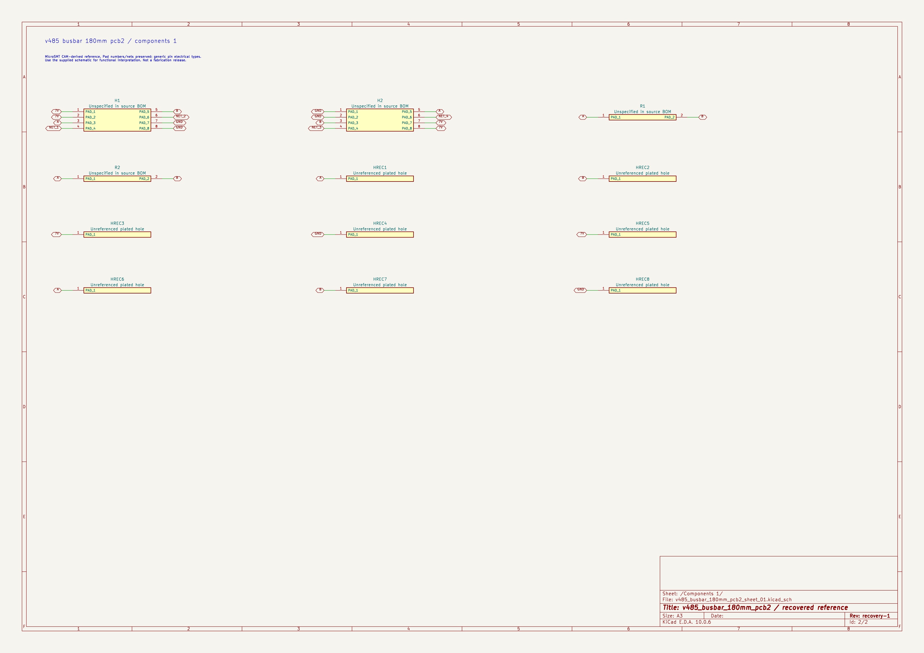
[picture p122: Bing-feeder/V485-Feeder Controller/PCB_busbar_short_180mm/photos/kicad-v485_busbar_180mm_pcb2-schematic.jpg]
Recovered schematic
<td align="center"><br><sub>Recovered schematic</sub></td>
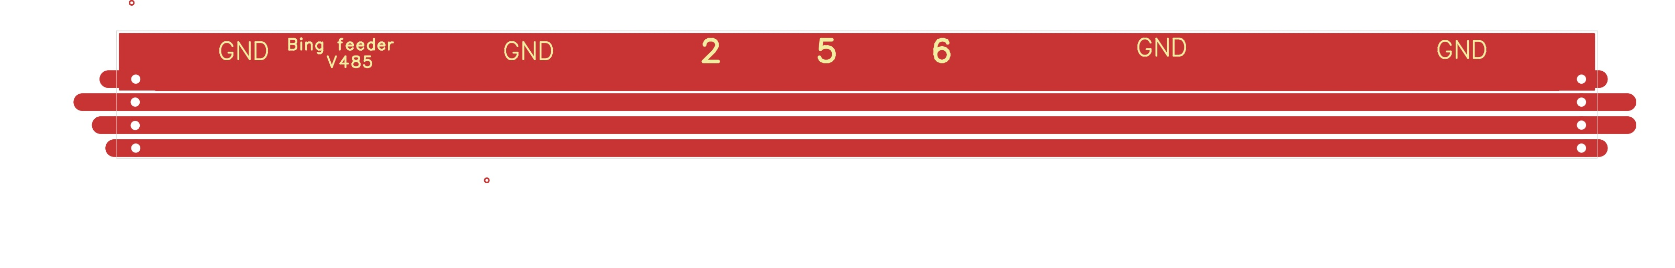
[picture p123: Bing-feeder/V485-Feeder Controller/PCB_busbar_short_180mm/photos/kicad-v485_busbar_180mm_pcb2-top.jpg]
<td align="center"><br><sub>Recovered PCB top</sub></td>
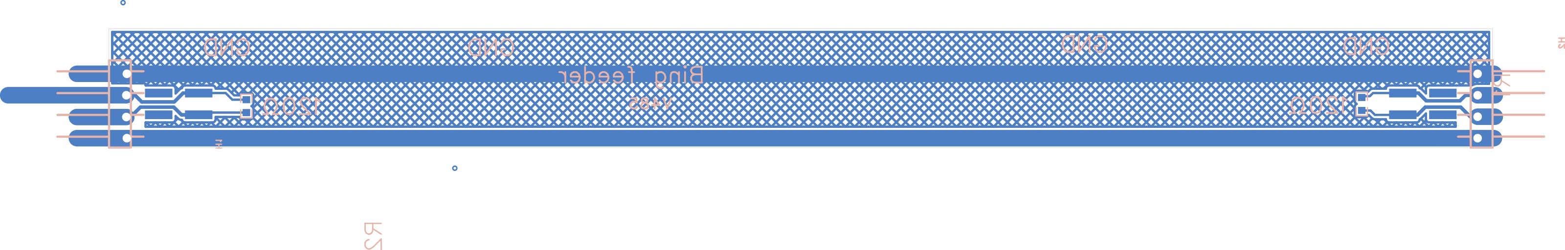
[picture p124: Bing-feeder/V485-Feeder Controller/PCB_busbar_short_180mm/photos/kicad-v485_busbar_180mm_pcb2-bottom.jpg]
Recovered PCB bottom
<td align="center"><br><sub>Recovered PCB bottom</sub></td>
</tr>
</table>

[Sheet overview](photos/kicad-v485_busbar_180mm_pcb2-overview.jpg) · [Components 1](photos/kicad-v485_busbar_180mm_pcb2-sheet-01.jpg)

### V485 short busbar PCB4

<table>
<tr>
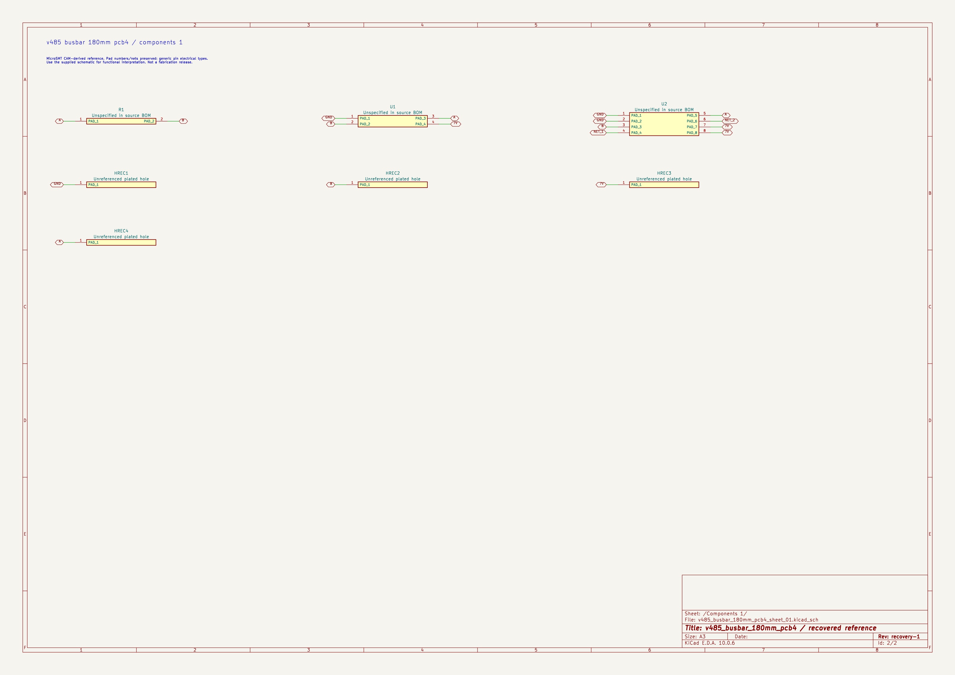
[picture p125: Bing-feeder/V485-Feeder Controller/PCB_busbar_short_180mm/photos/kicad-v485_busbar_180mm_pcb4-schematic.jpg]
Recovered schematic
<td align="center"><br><sub>Recovered schematic</sub></td>
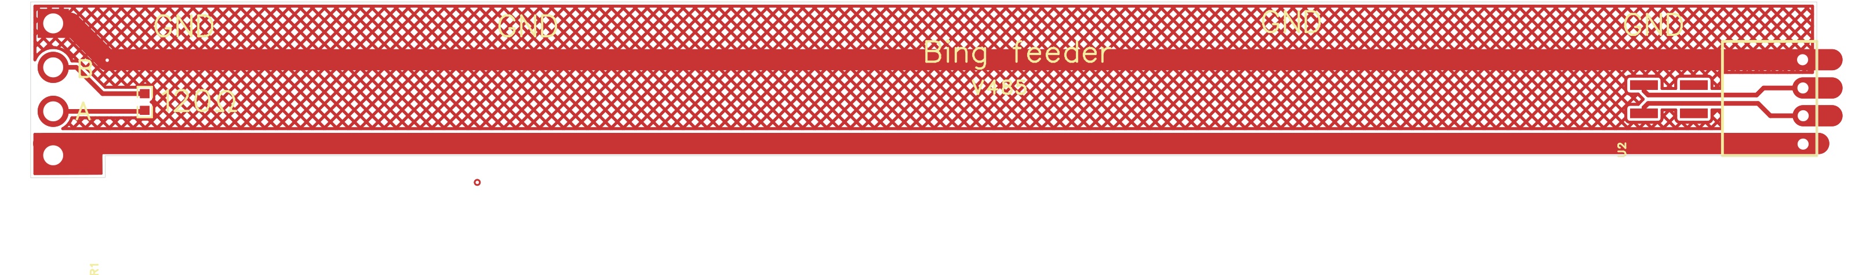
[picture p126: Bing-feeder/V485-Feeder Controller/PCB_busbar_short_180mm/photos/kicad-v485_busbar_180mm_pcb4-top.jpg]
<td align="center"><br><sub>Recovered PCB top</sub></td>
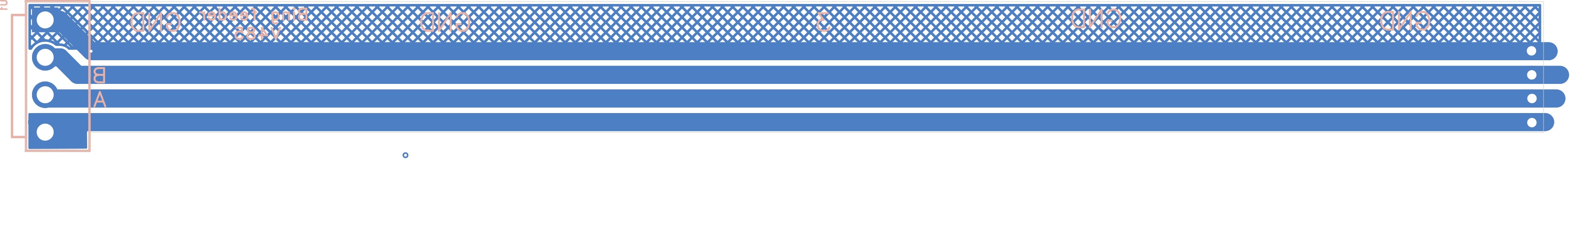
[picture p127: Bing-feeder/V485-Feeder Controller/PCB_busbar_short_180mm/photos/kicad-v485_busbar_180mm_pcb4-bottom.jpg]
Recovered PCB bottom
<td align="center"><br><sub>Recovered PCB bottom</sub></td>
</tr>
</table>

[Sheet overview](photos/kicad-v485_busbar_180mm_pcb4-overview.jpg) · [Components 1](photos/kicad-v485_busbar_180mm_pcb4-sheet-01.jpg)
