gabrielyoung92/gabs_microSMT_PickAndPlace/Bing-feeder/V485-feeder/PCB_display/README.md

# V485 display PCB

> Designs and original files by [MicroSMT](https://github.com/microsmt/Bing-feeder). [Credits and local changes](../../../CREDITS.md).

[Back to collection](../README.md)

Gerbers, editable KiCad files and previews are below.

## KiCad files

Open `.kicad_pro` in **KiCad 10**. Keep the whole `KiCad/` folder together; it contains the local libraries.

The schematics show pad numbers and connections. Use the supplied schematic for pin functions. Review the reported ERC/DRC findings before making a board.

| Project | Open in KiCad | Supporting reports |
| --- | --- | --- |
| V485 display | [v485_display.kicad_pro](KiCad/v485_display.kicad_pro) | [Recovery](docs/recovery.json) · [Validation](docs/validation.json) |

[Recovery details](docs/KICAD_RECOVERY.md) · [Method and editing limits](../../../tools/kicad/RECOVERY_NOTES.md)

## Original board views

[Download Gerber ZIP](Gerber_PCB1_2026-10-09.zip)

<table>
<tr>
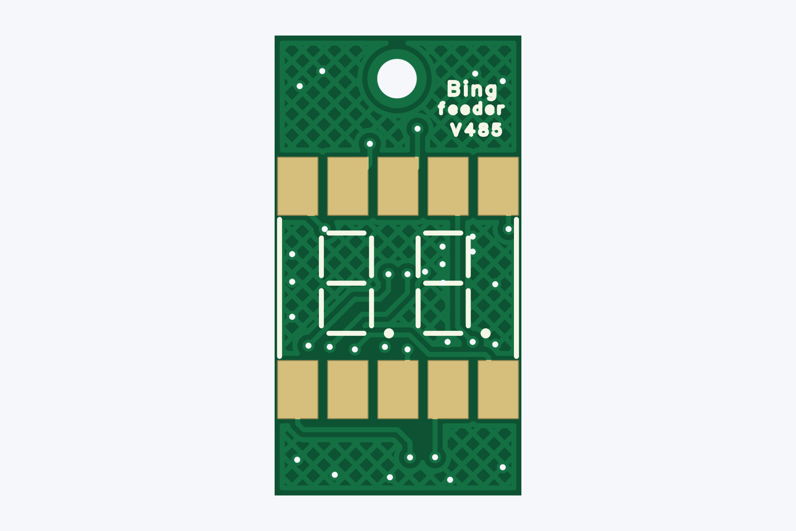
[picture p134: Bing-feeder/V485-feeder/PCB_display/photos/Gerber_PCB1_2026-10-09-top.jpg]
Top
<td align="center"><br><sub>Top</sub></td>
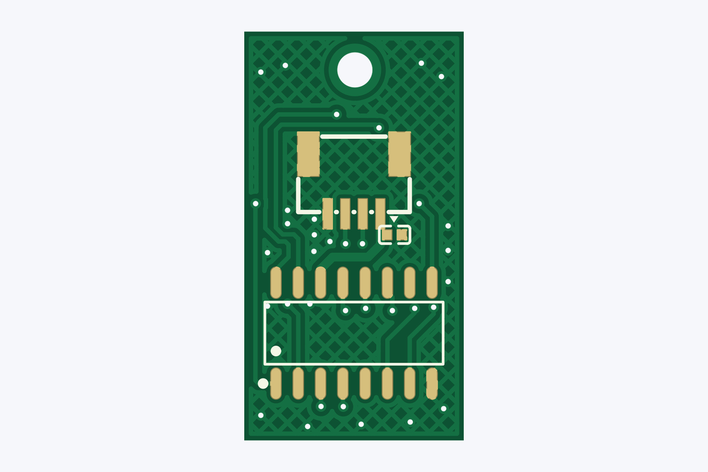
[picture p135: Bing-feeder/V485-feeder/PCB_display/photos/Gerber_PCB1_2026-10-09-bottom.jpg]
Bottom
<td align="center"><br><sub>Bottom</sub></td>
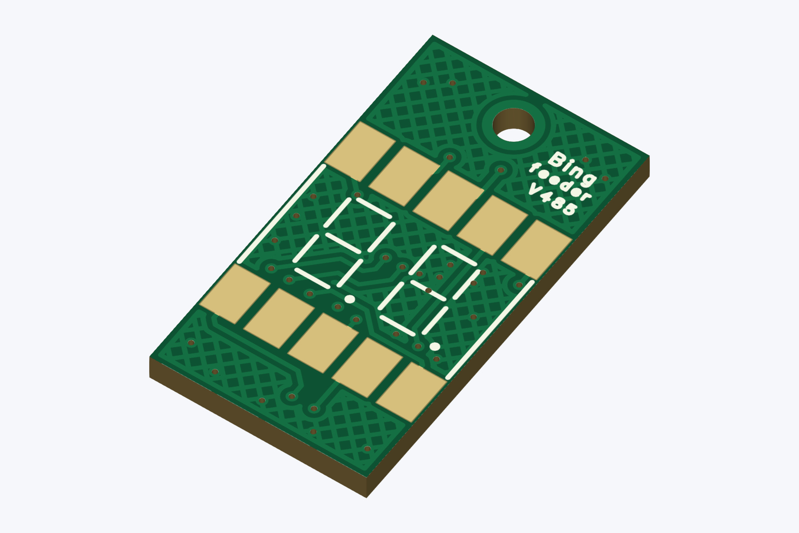
[picture p136: Bing-feeder/V485-feeder/PCB_display/photos/Gerber_PCB1_2026-10-09-iso.jpg]
Top-side isometric
<td align="center"><br><sub>Top-side isometric</sub></td>
</tr>
</table>

## Schematics, parts lists and notes

- [BOM_Board1_Schematic1_2026-10-09.xlsx](docs/BOM_Board1_Schematic1_2026-10-09.xlsx)
- [SCH_Schematic1_2026-10-09.pdf](docs/SCH_Schematic1_2026-10-09.pdf)

Gerber previews use display colours and an assumed 1.6 mm thickness; use source data for manufacturing dimensions.

## KiCad previews

KiCad reconstruction views; source Gerber views are above.

### V485 display

<table>
<tr>
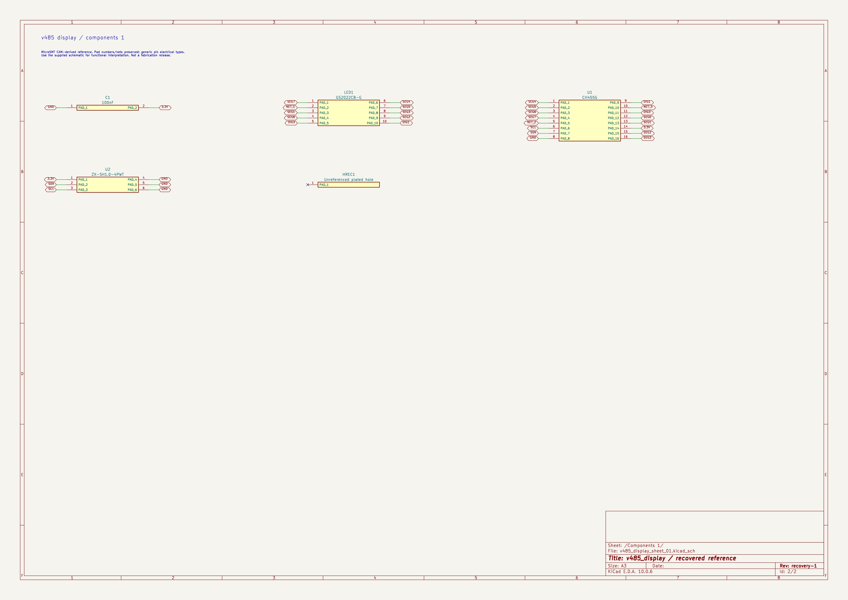
[picture p137: Bing-feeder/V485-feeder/PCB_display/photos/kicad-v485_display-schematic.jpg]
Recovered schematic
<td align="center"><br><sub>Recovered schematic</sub></td>
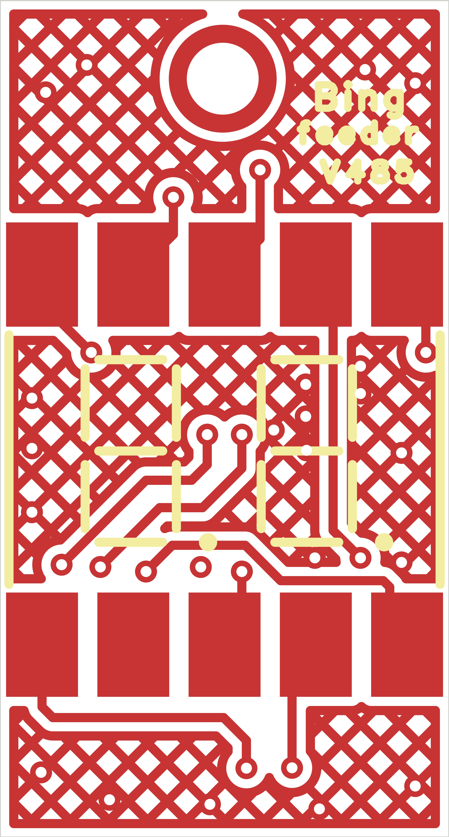
[picture p138: Bing-feeder/V485-feeder/PCB_display/photos/kicad-v485_display-top.jpg]
Recovered PCB top
<td align="center"><br><sub>Recovered PCB top</sub></td>
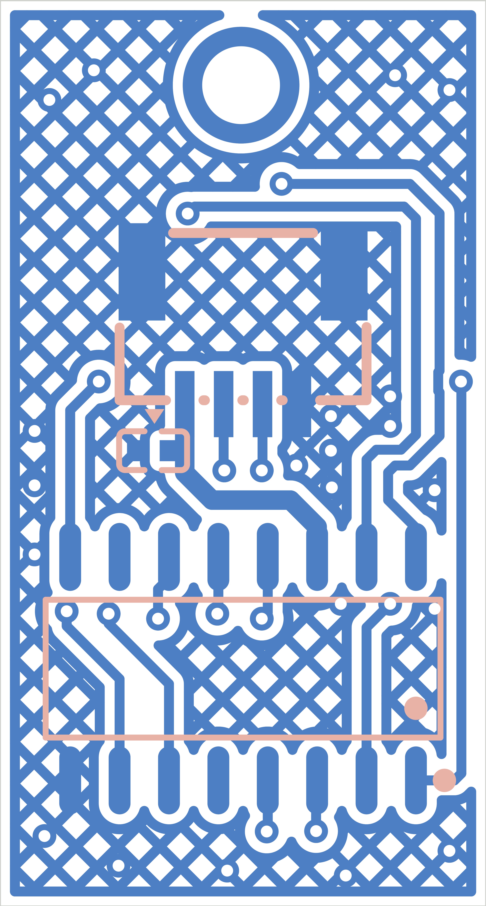
[picture p139: Bing-feeder/V485-feeder/PCB_display/photos/kicad-v485_display-bottom.jpg]
Recovered PCB bottom
<td align="center"><br><sub>Recovered PCB bottom</sub></td>
</tr>
</table>

[Sheet overview](photos/kicad-v485_display-overview.jpg) · [Components 1](photos/kicad-v485_display-sheet-01.jpg)
