gabrielyoung92/gabs_microSMT_PickAndPlace/Microsmt-PNPv3/docs/datasheets/README.md

# Manufacturer datasheets

- [XGZP6847A V2.8](XGZP6847A-Pressure-Sensor-V2.8.pdf), CFSensor,
  2026-09-04, nine pages. Covers the selected XGZP6847A100KPGN33 sensor.
  Package orientation and pin definitions are on page 3.
  [Manufacturer download](https://cfsensor.com/wp-content/uploads/2026/09/XGZP6847A-Pressure-Sensor-V2.8.pdf).
  Downloaded 14 October 2026. The PDF is unchanged.
  SHA-256: `58ce6de69d55a5a42107697f8a622970aa33c1ca7ea4ffbc47e966edec65f196`.

The manufacturer’s copyright and notices are in the PDF.
