gabrielyoung92/gabs_microSMT_PickAndPlace/Bing-feeder/UPSTREAM-2026-10-25.md

# MicroSMT upstream check — 25 October 2026

Original designs and photos: **MicroSMT and its contributors**.
[Credits](../CREDITS.md) · [Source manifest](upstream-2026-10-25.json).

Compared both vendor repositories with the revisions recorded in the
[previous import](UPSTREAM-2026-10-21.md):

- [Bing-feeder at `fe259f85`](https://github.com/microsmt/Bing-feeder/commit/fe259f85f93bfd84ad8d41a62f25e93155fdd200).
- [Microsmt-PNPv3 at `7a85c2aa`](https://github.com/microsmt/Microsmt-PNPv3/commit/7a85c2aafc063e0f487a9fd8e90a151b709a10a6).

Each repository has two later commits, changing only `Bing  feeder V485 20261021.zip`.
Both repositories publish identical copies of the current V3 and V485 archives.

| Vendor change | Local result |
| --- | --- |
| V3 archive remains unchanged, including the 8 mm multi-position slot and holder files | Existing models and previews retained |
| V485 archive adds `V485-16mm feeder slot(Magnetic)-1bit.STEP` | Byte-identical to the separately imported [16 mm slot](V485-feeder/3D_parts_16mm/README.md); existing STL and nine JPG previews retained |
| V485 archive renames the 24 mm slot with a `V485-` prefix | Contents unchanged; existing [24 mm slot](V485-feeder/3D_parts_24mm/README.md), STL and nine JPG previews retained |
| Additional vendor photo in `Doc/` was absent locally | Copied unchanged to [the reference photo](photos/Bing_feeders_reference.jpg) and embedded in the feeder front page |
| Eight main vendor photos and the calibration card | Already byte-identical locally |

All 214 current feeder archive members are mapped to local destinations in the
manifest. Original STEP, document and image bytes match their source hashes;
existing local STL exports remain explicitly distinguished from vendor STL bytes.
The four root machine manuals also match the current vendor files byte for byte.
The manifest records current archive hashes and all nine vendor photos plus the
calibration card. The earlier manifest remains a historical import record.

Local firmware, electronics, older models and gallery organisation are retained.
No model regeneration was needed. File checks and previews do not establish
physical fit or machine operation.

## Check — 30 October 2026

Bing-feeder remains at `fe259f85`. PNPv3 is now at
[`faf36445`](https://github.com/microsmt/Microsmt-PNPv3/commit/faf36445a9264ebf0bdedd8d6620745f2af7a65a):
two commits added then removed `V485-20261021-800-6.jpg`. Both repositories' file
trees match the revisions above. Nothing needed importing.
