gabrielyoung92/gabs_microSMT_PickAndPlace/Bing-feeder/UPSTREAM-2026-10-21.md

# MicroSMT feeder update — 21 October 2026

Original designs: [MicroSMT / Bing-feeder](https://github.com/microsmt/Bing-feeder).
[Credits and local changes](../CREDITS.md).

- [V485 feeders](V485-feeder/README.md): added 12, 16 and 24 mm parts and a shared-parts gallery; updated the 8 mm motor support and 55T gear. The older 8 mm gear remains labelled as a legacy variant.
- [V3 feeders](V3-feeder/README.md): updated the wider gear brackets and 24 mm trigger, brought the existing 8 mm holders/bracket up to the supplied release, and added the 12 mm switch-cover 3MF.
- New and changed models have matching STL exports, a main JPG and eight isometric views. Existing names, reference photos and gallery style are retained.
- Firmware, Gerbers, schematics, BOMs, recovered KiCad projects and local improvements are preserved. The latest V485 archive contains CAD only.
- The archive did not supply a dedicated 16 mm V485 feeder-slot model. A one-position magnetic slot was received separately on 22 October 2026 and added to the [16 mm gallery](V485-feeder/3D_parts_16mm/README.md), with matching STL and previews. CAD availability and previews do not establish physical fit.

Sources: [Bing-feeder revision](https://github.com/microsmt/Bing-feeder/commit/056f6109d805260af609c1af03ae064e5c2fcba4) · [PNPv3 revision](https://github.com/microsmt/Microsmt-PNPv3/commit/c8b939c44d9ad02c62b70e846f31879f0561a1f8).
Both publish the same two archives. Archive hashes and original-to-reorganised file paths are recorded in the [source manifest](upstream-2026-10-21.json).

## Follow-up check — 25 October 2026

The vendor revised the V485 ZIP to include the 16 mm slot already imported separately here and to rename the 24 mm slot. Both match the local STEP bytes. See the [current comparison and photo check](UPSTREAM-2026-10-25.md).
