gabrielyoung92/gabs_microSMT_PickAndPlace/Bing-feeder/V3-Feeder Controller/README.md

# V3 feeder controller

> Designs and original files by [MicroSMT](https://github.com/microsmt/Bing-feeder). [Credits and local changes](../../CREDITS.md).

The V3 controller uses a Mega2560. Its Arduino sketch, controller board, mounting hook and busbars are below.

| Browse | Contents |
| --- | --- |
| [Controller PCB](PCB_ControlBoard/README.md) | Gerber ZIP, schematic, BOM and three board views |
| [Mega2560 firmware](CODE_MEGA2560/README.md) | Arduino sketch |
| [3D parts gallery](3D_parts/README.md) | Busbar PCB hook |
| [Busbar N1-N8](PCB_busbar_N1-N8/README.md) | Gerber ZIP and top/bottom/isometric previews |
| [Busbar N9-N16](PCB_busbar_N9-N16/README.md) | Gerber ZIP and top/bottom/isometric previews |
| [Busbar N17-N24](PCB_busbar_N17-N24/README.md) | Gerber ZIP and top/bottom/isometric previews |
