gabrielyoung92/gabs_microSMT_PickAndPlace/Bing-feeder/V3-feeder/README.md

# V3 feeder

> Designs and original files by [MicroSMT](https://github.com/microsmt/Bing-feeder). [Credits and local changes](../../CREDITS.md).

Pick your tape width below for the models, or go straight to the board files, firmware or assembly notes. The models include the 21 October 2026 updates; see [what changed](../UPSTREAM-2026-10-21.md).

| Browse | Contents |
| --- | --- |
| [8 mm parts](8mm_3D_parts/README.md) | 3D gallery and STEP/STL files |
| [12 mm parts](12mm_3D_parts/README.md) | 3D gallery and STEP/STL files |
| [16 mm parts](16mm_3D_parts/README.md) | 3D gallery and STEP/STL files |
| [24 mm parts](24mm_3D_parts/README.md) | 3D gallery and STEP/STL files |
| [Shared parts](shared_3D_parts/README.md) | Gears, supports and shared mechanical pieces |
| [Feeder PCB](PCB_feeder/README.md) | Gerber ZIP, schematic and three board views |
| [8 mm firmware](CODE_feeder_8mm/README.md) | STM32 C source, supplied HEX and build notes |
| [12/16/24 mm firmware](CODE_feeder_12-16-24mm/README.md) | STM32 C source and build notes |
| [Assembly and print references](docs/README.md) | Manuals, diagrams, holder installation and recorded stock |
| [Print project](PRINT_projects/README.md) | Original 3MF projects |
| [Sprocket CAD](sprocket_CAD/README.md) | 2 mm and 4 mm pitch DWG drawings |
