gabrielyoung92/gabs_microSMT_PickAndPlace/Bing-feeder/V3-feeder/docs/README.md

# V3 assembly and print references

> Designs and original files by [MicroSMT](https://github.com/microsmt/Bing-feeder). [Credits and local changes](../../../CREDITS.md).

[Back to V3 feeder](../README.md)

## Manuals and notes

- [V3_8mm_assembly_manual.pdf](V3_8mm_assembly_manual.pdf)
- [V3_8mm_assembly_manual_0914.pdf](V3_8mm_assembly_manual_0914.pdf)
- [V3_original-numbered-print-list.txt](V3_original-numbered-print-list.txt)
- [V3_printed-stock.txt](V3_printed-stock.txt)
- [magnetic-feeder-slot-notes.txt](magnetic-feeder-slot-notes.txt)

Check the recorded stock quantities against the parts on hand.

## Installation diagrams

### V2 12/16/24 mm feeder board

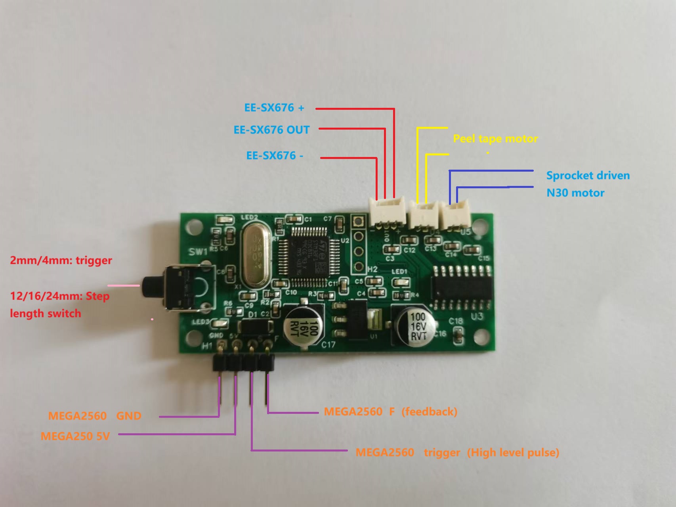
[picture p146: Bing-feeder/V3-feeder/docs/V2_12-16-24mm_feeder-pcba-diagram.jpg]
V2_12-16-24mm_feeder-pcba-diagram


### V2 12/16/24 mm screw positions — sheet 1

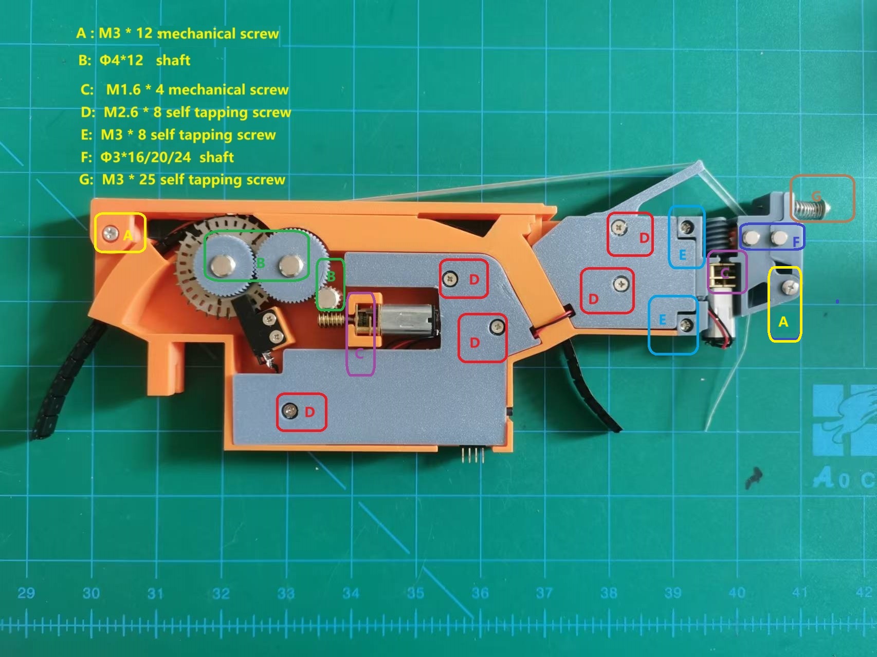
[picture p147: Bing-feeder/V3-feeder/docs/V2_12-16-24mm_screw-positions-1.jpg]
V2_12-16-24mm_screw-positions-1


### V2 12/16/24 mm screw positions — sheet 2

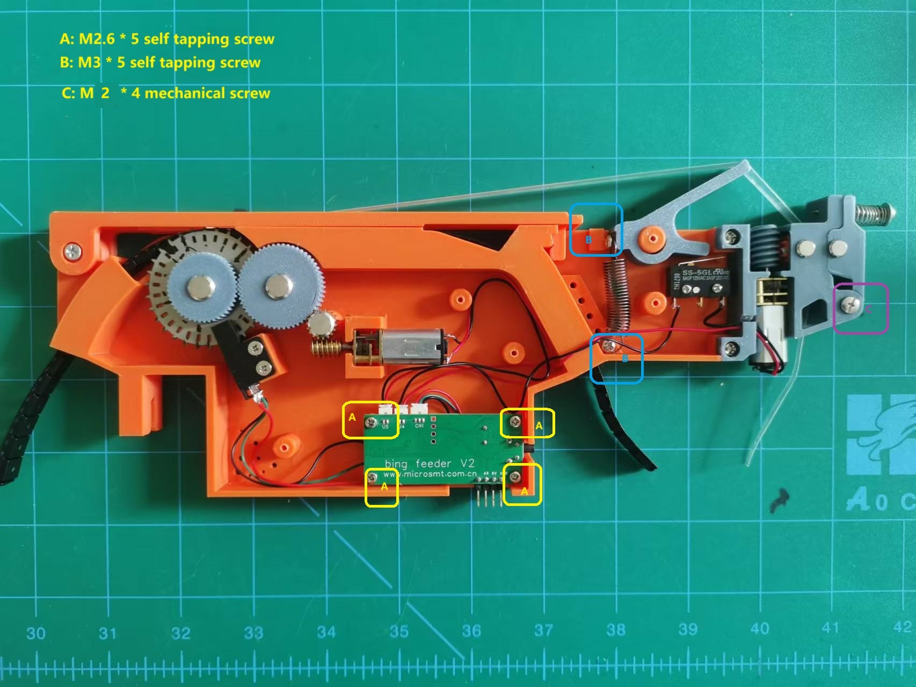
[picture p148: Bing-feeder/V3-feeder/docs/V2_12-16-24mm_screw-positions-2.jpg]
V2_12-16-24mm_screw-positions-2


### V2 12/16/24 mm sprocket installation

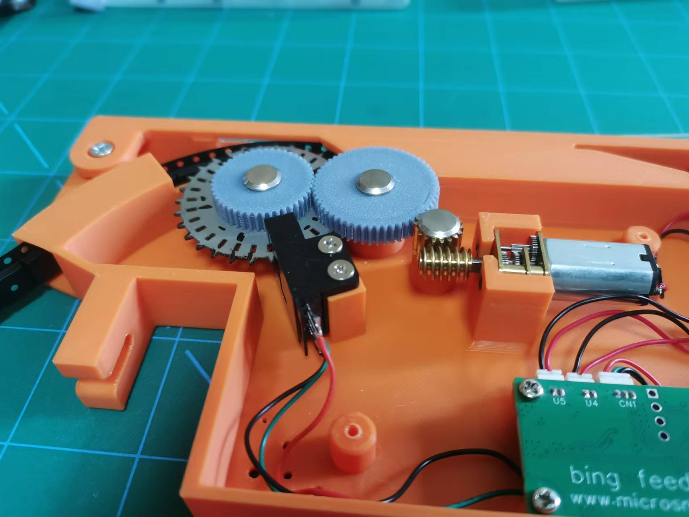
[picture p149: Bing-feeder/V3-feeder/docs/V2_12-16-24mm_sprocket-installation.jpg]
V2_12-16-24mm_sprocket-installation


### V3 8 mm feeder holder installation

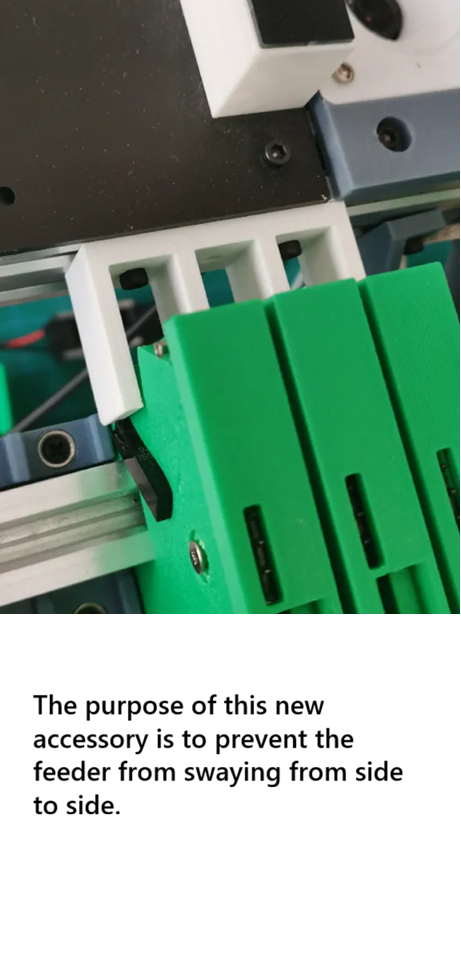
[picture p150: Bing-feeder/V3-feeder/docs/V3_8mm_feeder-holder-installation.png]
V3_8mm_feeder-holder-installation
