gabrielyoung92/gabs_microSMT_PickAndPlace/Bing-feeder/V3-Feeder Controller/CODE_MEGA2560/README.md

# Mega2560 controller firmware

> Designs and original files by [MicroSMT](https://github.com/microsmt/Bing-feeder). [Credits and local changes](../../../CREDITS.md).

This is MicroSMT’s original Arduino sketch for the V3 Mega2560 feeder controller. Open the `.ino` from its matching folder so the Arduino IDE loads it correctly.

| Browse | Contents |
| --- | --- |
| [Arduino sketch](mega2560_bingfeeder_48pin/mega2560_bingfeeder_48pin.ino) | Open the sketch from its matching folder |
| [Controller collection](../README.md) | Controller PCB, busbars and 3D parts |
