gabrielyoung92/gabs_microSMT_PickAndPlace/Bing-feeder/V3-feeder/sprocket_CAD/README.md

# V3 sprocket drawings

> Designs and original files by [MicroSMT](https://github.com/microsmt/Bing-feeder). [Credits and local changes](../../../CREDITS.md).

DWG drawings for the 2 mm and 4 mm tape-pitch sprockets.

| Browse | Contents |
| --- | --- |
| [V3_sprocket-2mm-pitch.dwg](V3_sprocket-2mm-pitch.dwg) | DWG |
| [V3_sprocket-4mm-pitch.dwg](V3_sprocket-4mm-pitch.dwg) | DWG |
