gabrielyoung92/gabs_microSMT_PickAndPlace/Bing-feeder/V3-feeder/docs/magnetic-feeder-slot-notes.txt

1：You can array 1-bit files according to the number of slots you need.
