gabrielyoung92/gabs_microSMT_PickAndPlace/Bing-feeder/V485-Feeder Controller/PCB_busbar_long_480mm/photos/kicad-v485_busbar_480mm-overview.jpg

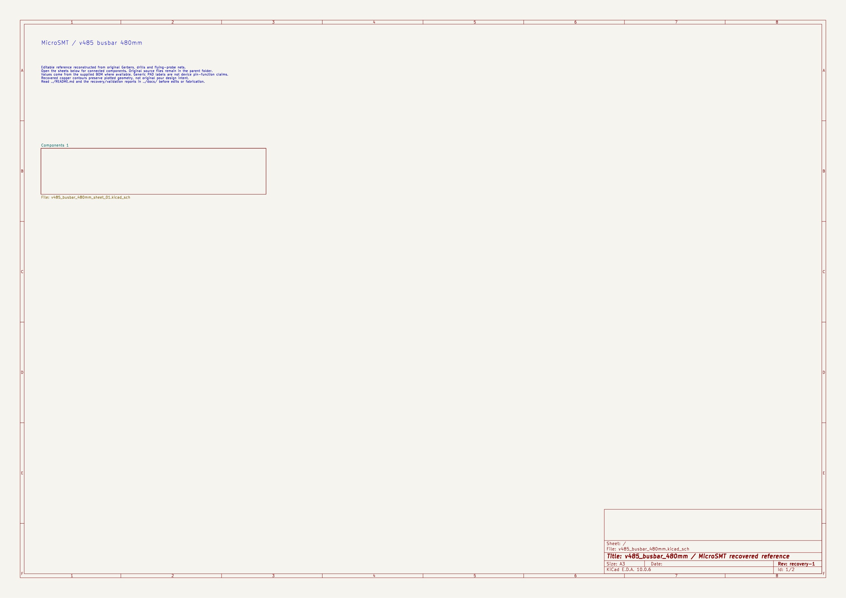
Bing-feeder/V485-Feeder Controller/PCB_busbar_long_480mm/photos/kicad-v485_busbar_480mm-overview.jpg
