gabrielyoung92/gabs_microSMT_PickAndPlace/Bing-feeder/V485-Feeder Controller/PCB_ControlBoard/photos/kicad-v485_controller-overview.jpg

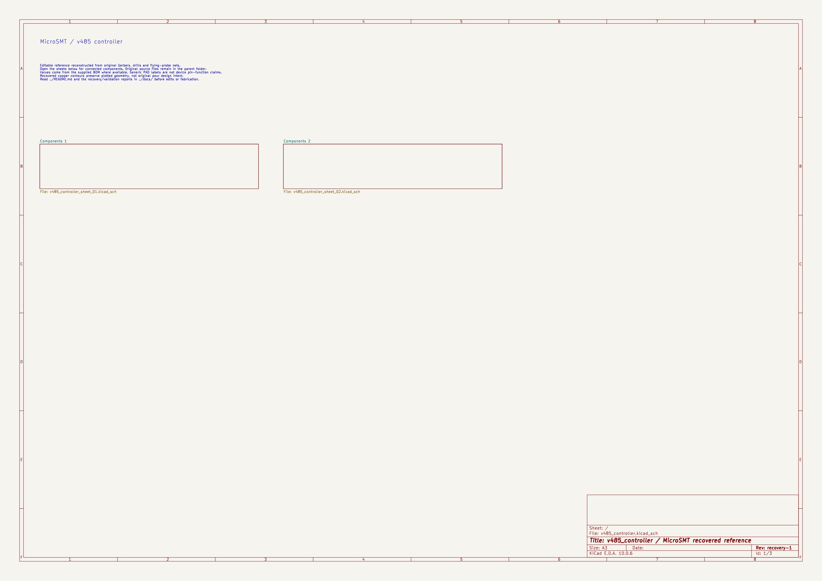
Bing-feeder/V485-Feeder Controller/PCB_ControlBoard/photos/kicad-v485_controller-overview.jpg
