gabrielyoung92/gabs_microSMT_PickAndPlace/Bing-feeder/V485-feeder/PCB_feeder/photos/kicad-v485_feeder-overview.jpg

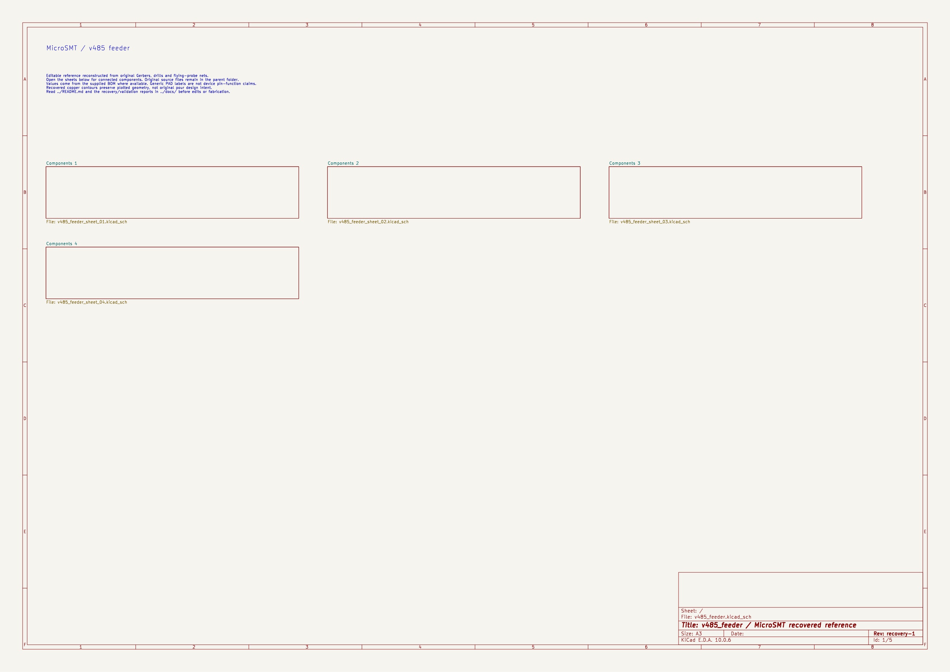
Bing-feeder/V485-feeder/PCB_feeder/photos/kicad-v485_feeder-overview.jpg
