gabrielyoung92/gabs_microSMT_PickAndPlace/Microsmt-PNPv3/PCB_motherboard/photos/kicad-schematic-09.png

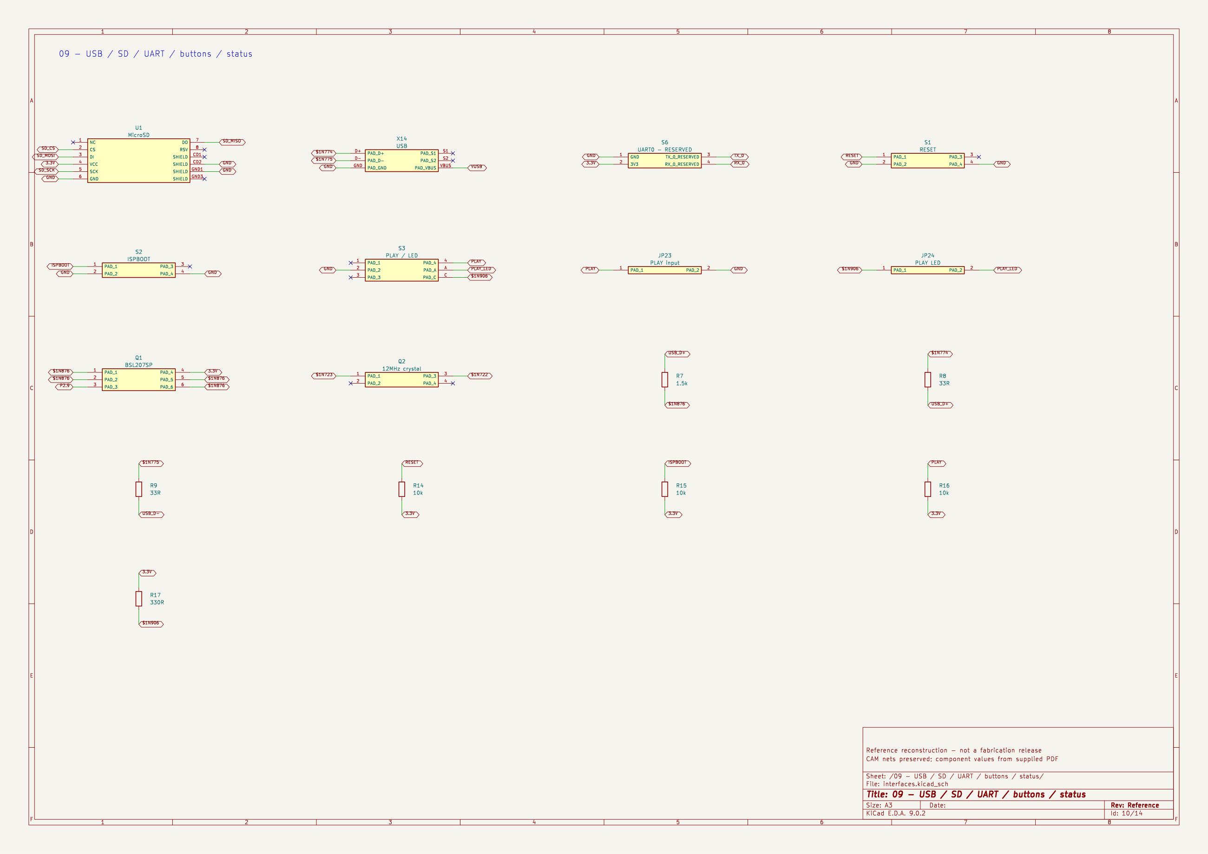
Microsmt-PNPv3/PCB_motherboard/photos/kicad-schematic-09.png
