gabrielyoung92/gabs_microSMT_PickAndPlace/Microsmt-PNPv3/PCB_motherboard/photos/kicad-schematic-10.png

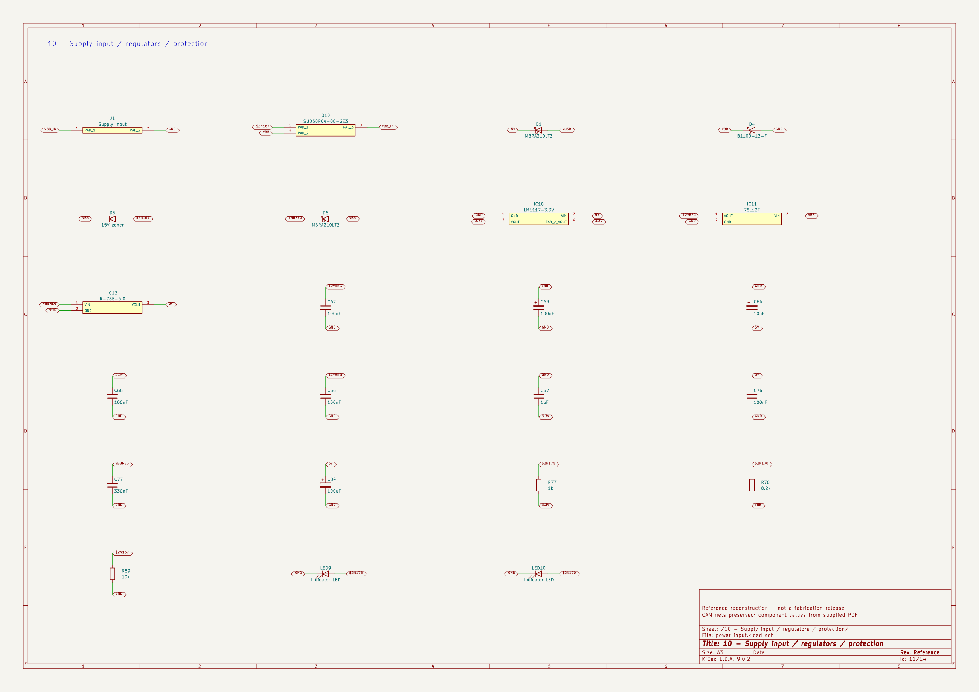
Microsmt-PNPv3/PCB_motherboard/photos/kicad-schematic-10.png
