gabrielyoung92/gabs_microSMT_PickAndPlace/Microsmt-PNPv3/PCB_motherboard/photos/kicad-schematic-contact-sheet.png

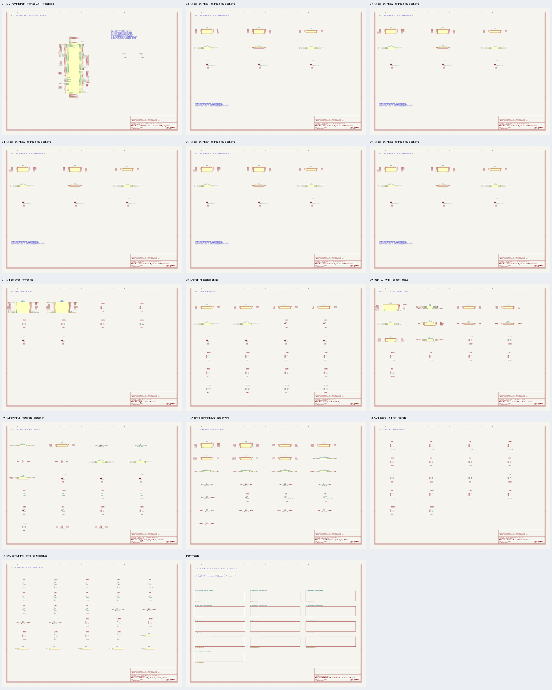
Microsmt-PNPv3/PCB_motherboard/photos/kicad-schematic-contact-sheet.png
