gabrielyoung92/gabs_microSMT_PickAndPlace/Microsmt-PNPv3/PNP-V3_3D_parts_2026-02-04/README.md

# PNPv3 machine parts — 2026-02-04

> Designs and original files by [MicroSMT](https://github.com/microsmt/Microsmt-PNPv3). [Credits and local changes](../../CREDITS.md).

25 parts · [All photos](photos/)

Click a picture for full size; **More views** contains top and bottom views.

## New adv calib

[STEP](new_adv_calib.step) · [STL](new_adv_calib.stl)

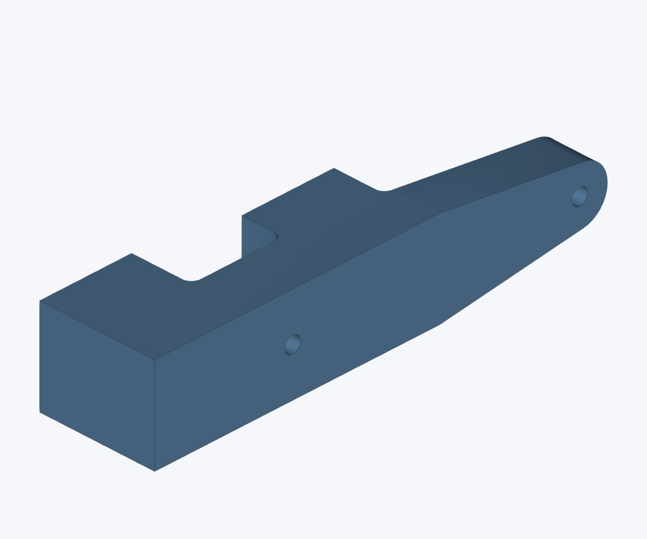
[picture p163: Microsmt-PNPv3/PNP-V3_3D_parts_2026-02-04/photos/new_adv_calib.jpg]
New adv calib — original preview


<details>
<summary>More views</summary>

<table>
<tr>
<td align="center"><a href="photos/new_adv_calib-iso-top-1.jpg">New adv calib — top view 1</a><br><sub>Top 1</sub></td>
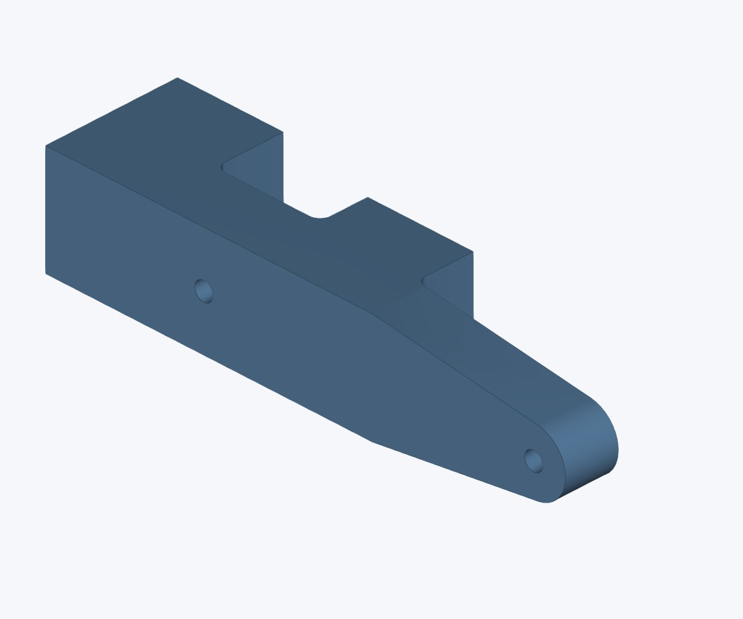
[picture p164: Microsmt-PNPv3/PNP-V3_3D_parts_2026-02-04/photos/new_adv_calib-iso-top-2.jpg]
New adv calib — top view 2
<td align="center"><br><sub>Top 2</sub></td>
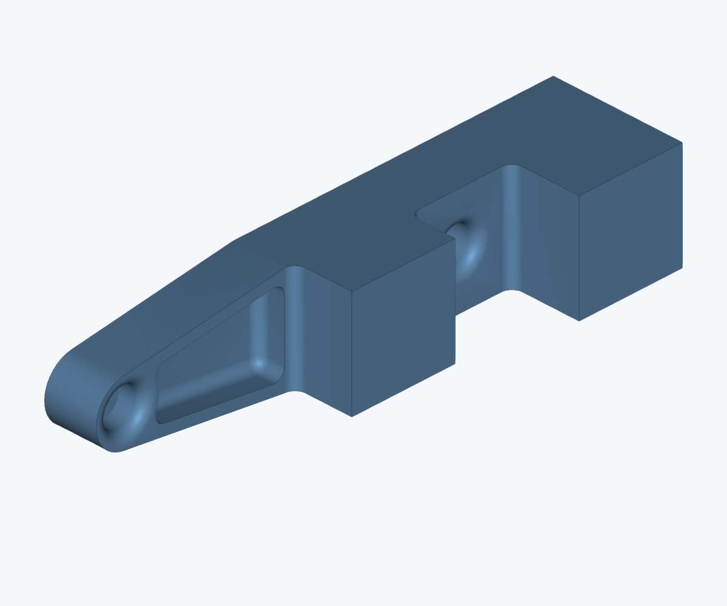
[picture p165: Microsmt-PNPv3/PNP-V3_3D_parts_2026-02-04/photos/new_adv_calib-iso-top-3.jpg]
New adv calib — top view 3
<td align="center"><br><sub>Top 3</sub></td>
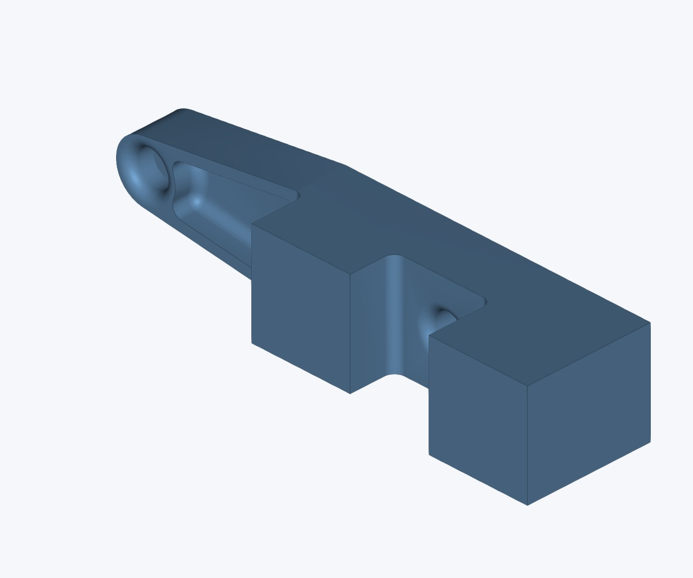
[picture p166: Microsmt-PNPv3/PNP-V3_3D_parts_2026-02-04/photos/new_adv_calib-iso-top-4.jpg]
New adv calib — top view 4
<td align="center"><br><sub>Top 4</sub></td>
</tr>
<tr>
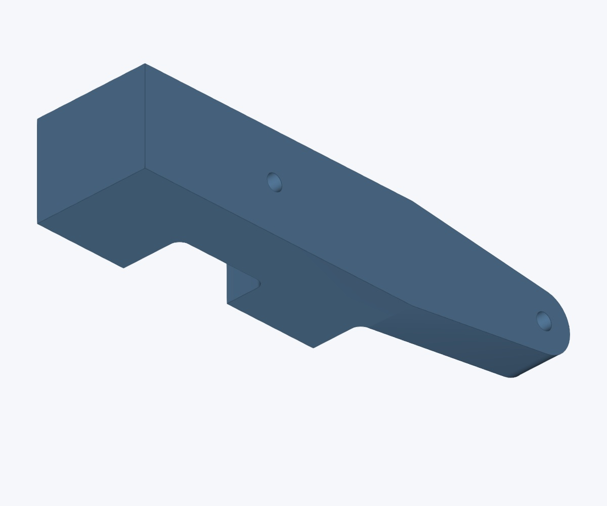
[picture p167: Microsmt-PNPv3/PNP-V3_3D_parts_2026-02-04/photos/new_adv_calib-iso-bottom-1.jpg]
New adv calib — bottom view 1
<td align="center"><br><sub>Bottom 1</sub></td>
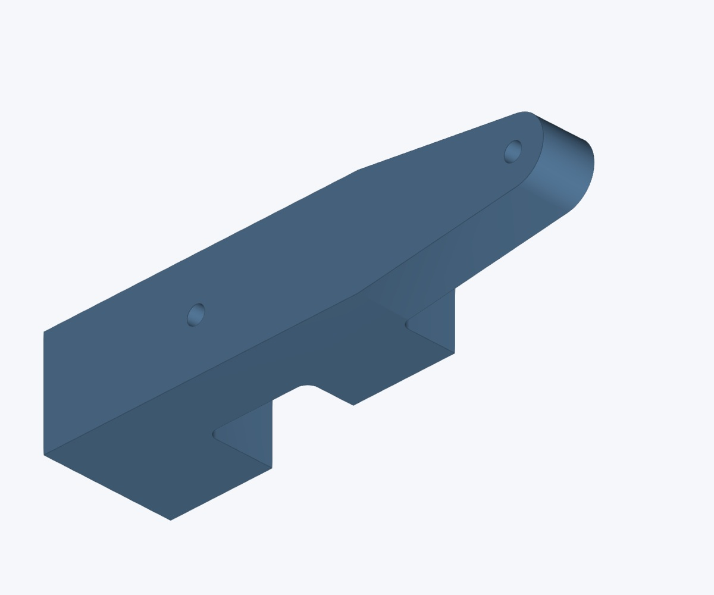
[picture p168: Microsmt-PNPv3/PNP-V3_3D_parts_2026-02-04/photos/new_adv_calib-iso-bottom-2.jpg]
New adv calib — bottom view 2
<td align="center"><br><sub>Bottom 2</sub></td>
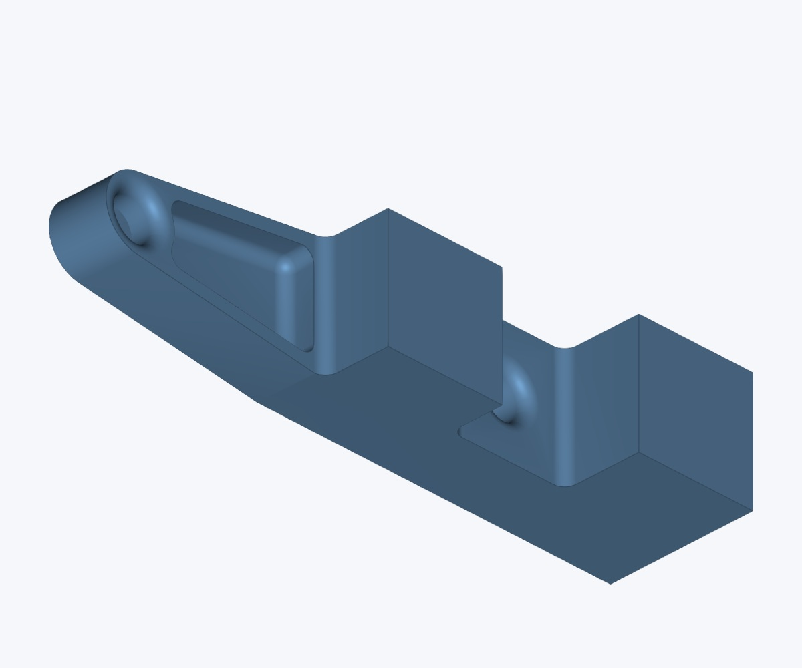
[picture p169: Microsmt-PNPv3/PNP-V3_3D_parts_2026-02-04/photos/new_adv_calib-iso-bottom-3.jpg]
New adv calib — bottom view 3
<td align="center"><br><sub>Bottom 3</sub></td>
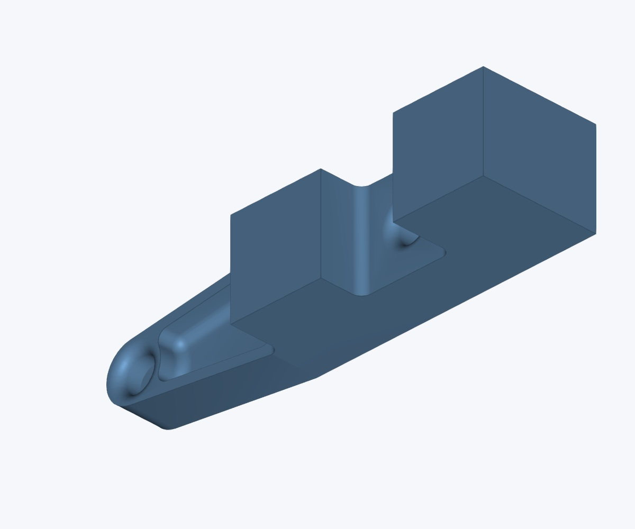
[picture p170: Microsmt-PNPv3/PNP-V3_3D_parts_2026-02-04/photos/new_adv_calib-iso-bottom-4.jpg]
New adv calib — bottom view 4
<td align="center"><br><sub>Bottom 4</sub></td>
</tr>
</table>

</details>

## AC power socket mount

[STL](PNPV3_3D_ac-power-socket-mount.stl)

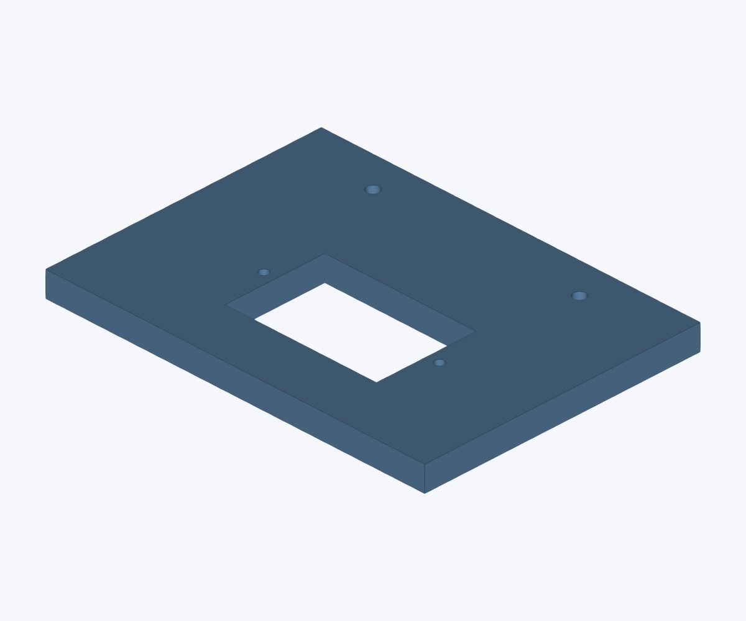
[picture p171: Microsmt-PNPv3/PNP-V3_3D_parts_2026-02-04/photos/PNPV3_3D_ac-power-socket-mount.jpg]
Ac power socket mount — original preview


<details>
<summary>More views</summary>

<table>
<tr>
<td align="center"><a href="photos/PNPV3_3D_ac-power-socket-mount-iso-top-1.jpg">Ac power socket mount — top view 1</a><br><sub>Top 1</sub></td>
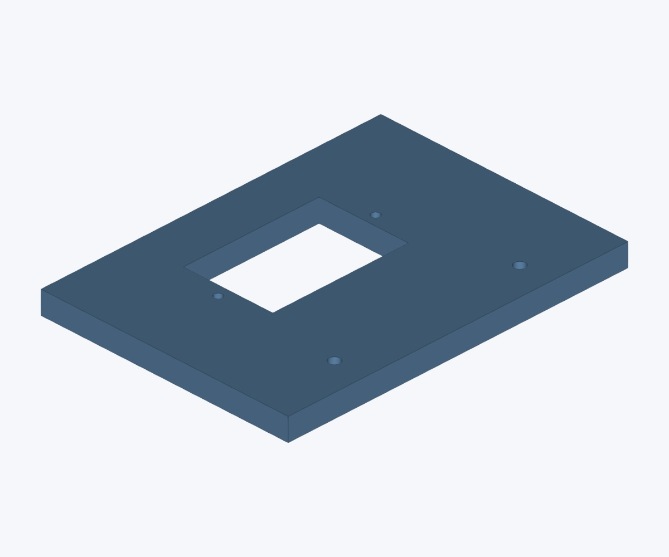
[picture p172: Microsmt-PNPv3/PNP-V3_3D_parts_2026-02-04/photos/PNPV3_3D_ac-power-socket-mount-iso-top-2.jpg]
Ac power socket mount — top view 2
<td align="center"><br><sub>Top 2</sub></td>
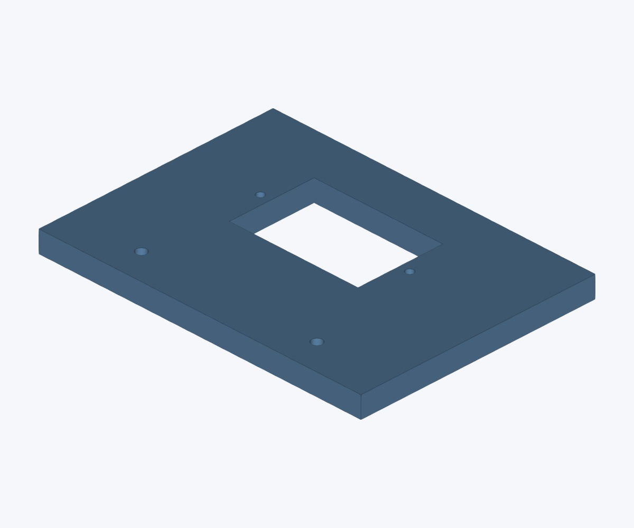
[picture p173: Microsmt-PNPv3/PNP-V3_3D_parts_2026-02-04/photos/PNPV3_3D_ac-power-socket-mount-iso-top-3.jpg]
Ac power socket mount — top view 3
<td align="center"><br><sub>Top 3</sub></td>
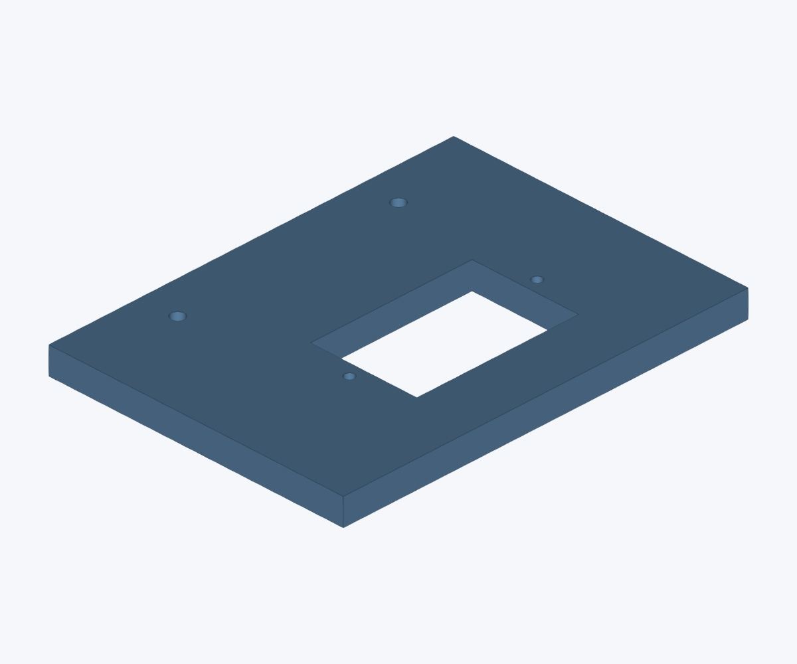
[picture p174: Microsmt-PNPv3/PNP-V3_3D_parts_2026-02-04/photos/PNPV3_3D_ac-power-socket-mount-iso-top-4.jpg]
Ac power socket mount — top view 4
<td align="center"><br><sub>Top 4</sub></td>
</tr>
<tr>
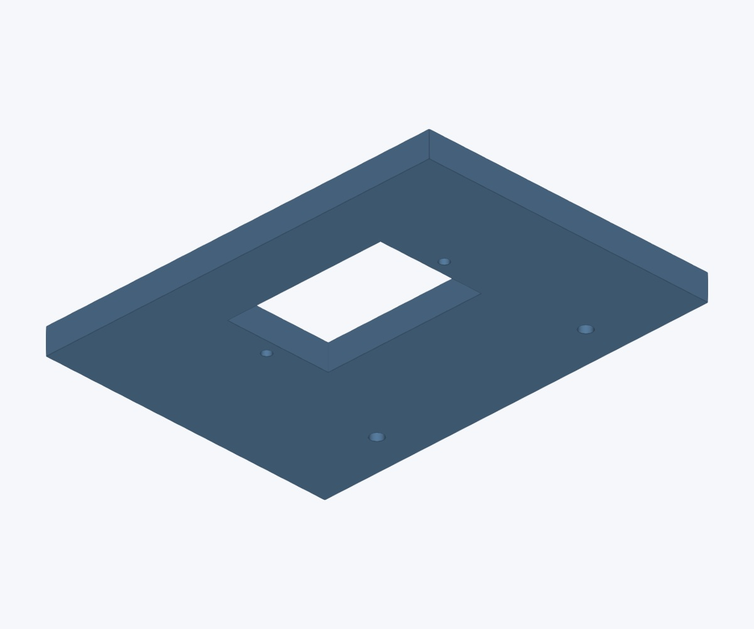
[picture p175: Microsmt-PNPv3/PNP-V3_3D_parts_2026-02-04/photos/PNPV3_3D_ac-power-socket-mount-iso-bottom-1.jpg]
Ac power socket mount — bottom view 1
<td align="center"><br><sub>Bottom 1</sub></td>
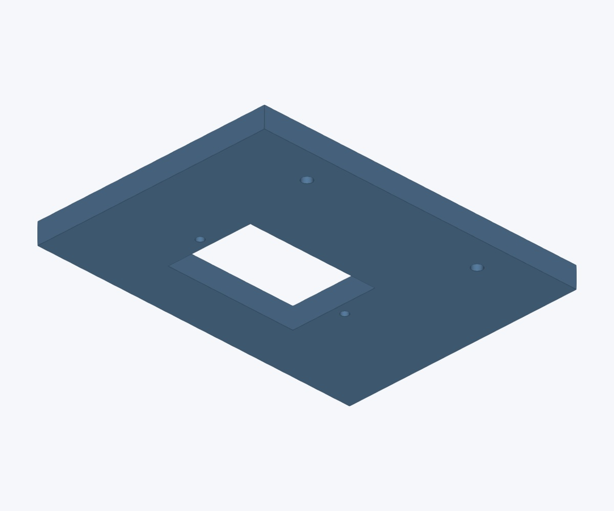
[picture p176: Microsmt-PNPv3/PNP-V3_3D_parts_2026-02-04/photos/PNPV3_3D_ac-power-socket-mount-iso-bottom-2.jpg]
Ac power socket mount — bottom view 2
<td align="center"><br><sub>Bottom 2</sub></td>
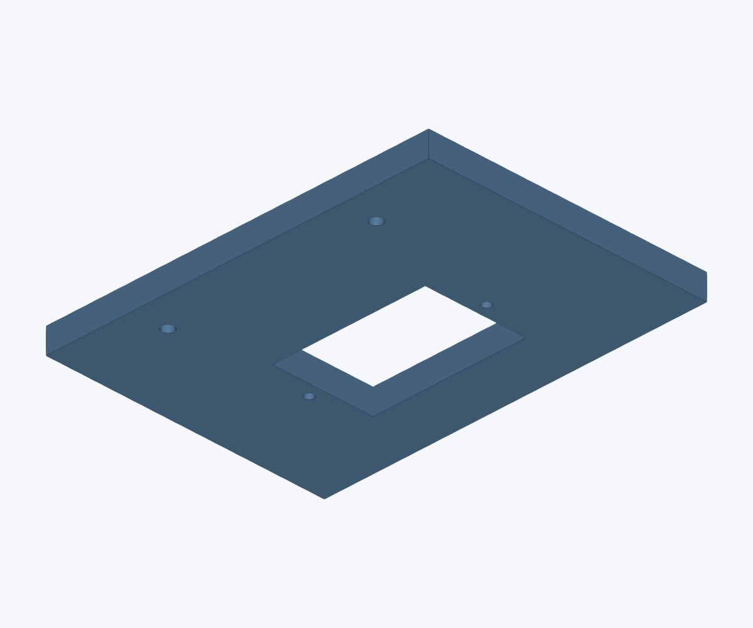
[picture p177: Microsmt-PNPv3/PNP-V3_3D_parts_2026-02-04/photos/PNPV3_3D_ac-power-socket-mount-iso-bottom-3.jpg]
Ac power socket mount — bottom view 3
<td align="center"><br><sub>Bottom 3</sub></td>
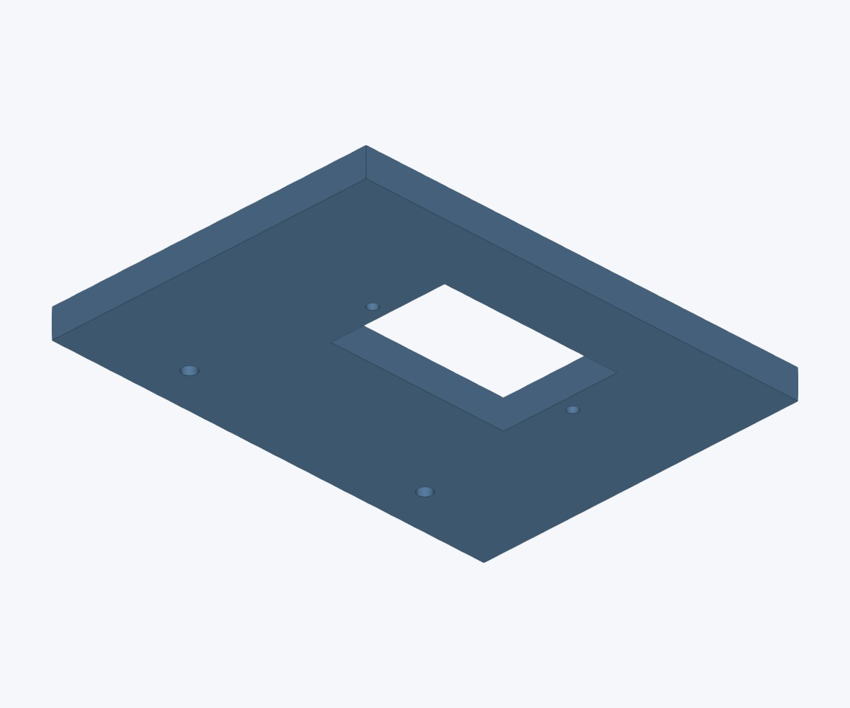
[picture p178: Microsmt-PNPv3/PNP-V3_3D_parts_2026-02-04/photos/PNPV3_3D_ac-power-socket-mount-iso-bottom-4.jpg]
Ac power socket mount — bottom view 4
<td align="center"><br><sub>Bottom 4</sub></td>
</tr>
</table>

</details>

## Bottom camera LED diffuser v2.1

[STEP](PNPV3_3D_bottom-camera-led-diffuser-v2.1.step) · [STL](PNPV3_3D_bottom-camera-led-diffuser-v2.1.stl)

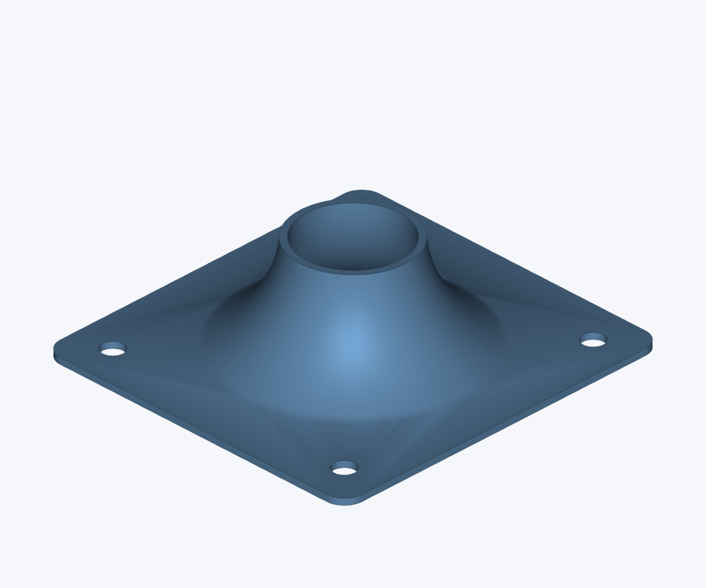
[picture p179: Microsmt-PNPv3/PNP-V3_3D_parts_2026-02-04/photos/PNPV3_3D_bottom-camera-led-diffuser-v2.1.jpg]
Bottom camera led diffuser v2.1 — original preview


<details>
<summary>More views</summary>

<table>
<tr>
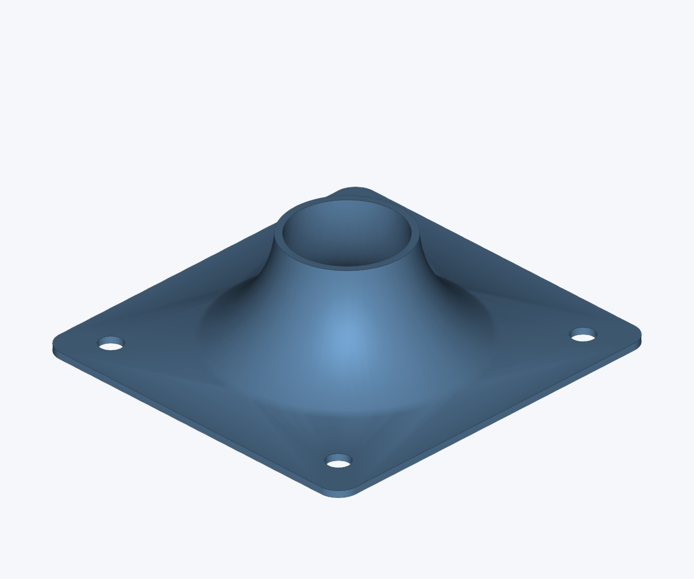
[picture p180: Microsmt-PNPv3/PNP-V3_3D_parts_2026-02-04/photos/PNPV3_3D_bottom-camera-led-diffuser-v2.1-iso-top-1.jpg]
Bottom camera led diffuser v2.1 — top view 1
<td align="center"><br><sub>Top 1</sub></td>
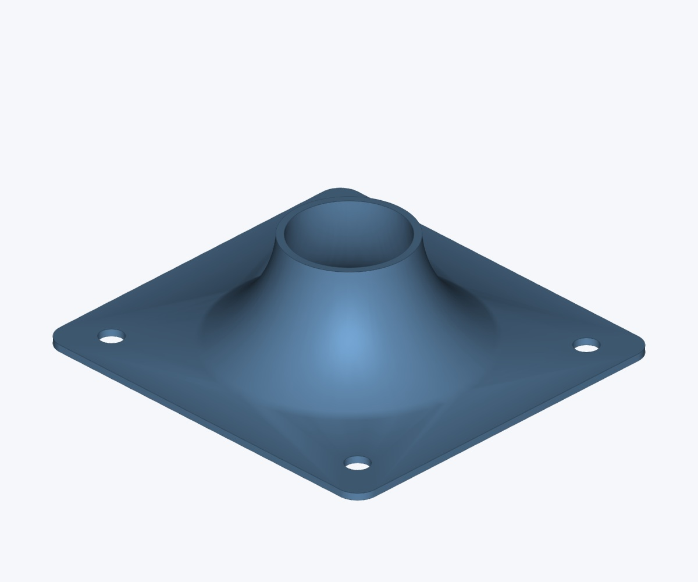
[picture p181: Microsmt-PNPv3/PNP-V3_3D_parts_2026-02-04/photos/PNPV3_3D_bottom-camera-led-diffuser-v2.1-iso-top-2.jpg]
Bottom camera led diffuser v2.1 — top view 2
<td align="center"><br><sub>Top 2</sub></td>
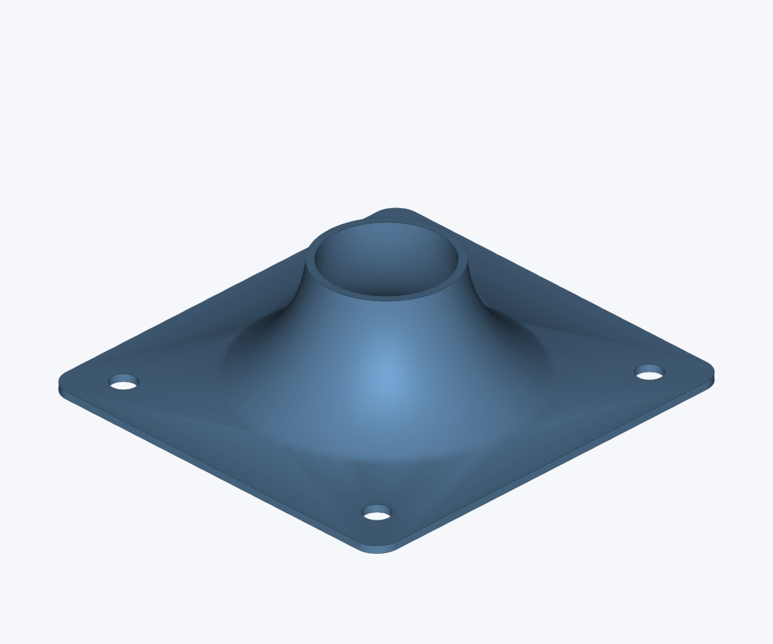
[picture p182: Microsmt-PNPv3/PNP-V3_3D_parts_2026-02-04/photos/PNPV3_3D_bottom-camera-led-diffuser-v2.1-iso-top-3.jpg]
Bottom camera led diffuser v2.1 — top view 3
<td align="center"><br><sub>Top 3</sub></td>
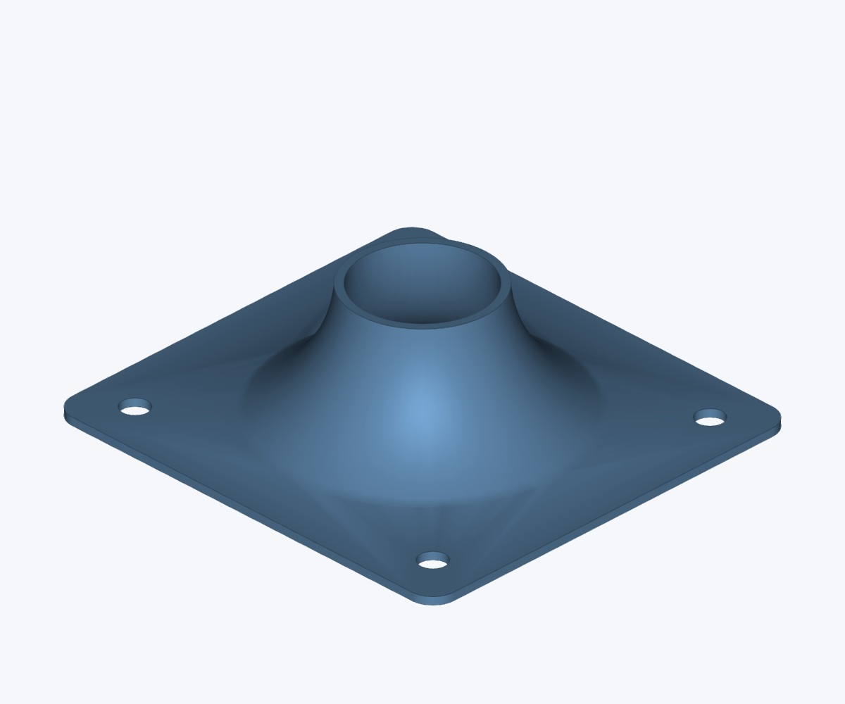
[picture p183: Microsmt-PNPv3/PNP-V3_3D_parts_2026-02-04/photos/PNPV3_3D_bottom-camera-led-diffuser-v2.1-iso-top-4.jpg]
Bottom camera led diffuser v2.1 — top view 4
<td align="center"><br><sub>Top 4</sub></td>
</tr>
<tr>
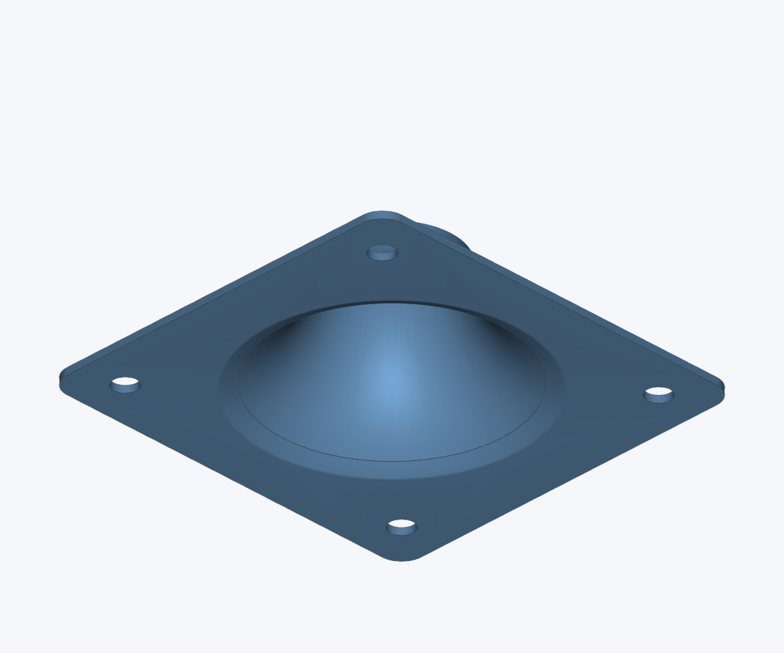
[picture p184: Microsmt-PNPv3/PNP-V3_3D_parts_2026-02-04/photos/PNPV3_3D_bottom-camera-led-diffuser-v2.1-iso-bottom-1.jpg]
Bottom camera led diffuser v2.1 — bottom view 1
<td align="center"><br><sub>Bottom 1</sub></td>
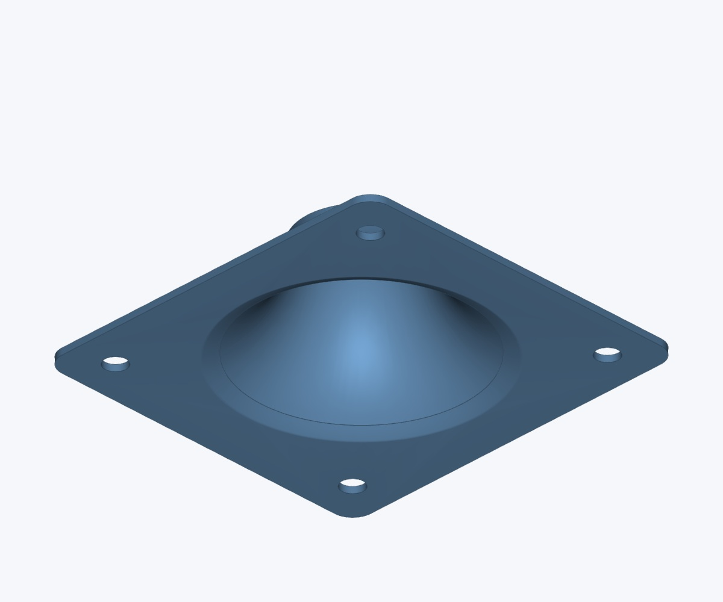
[picture p185: Microsmt-PNPv3/PNP-V3_3D_parts_2026-02-04/photos/PNPV3_3D_bottom-camera-led-diffuser-v2.1-iso-bottom-2.jpg]
Bottom camera led diffuser v2.1 — bottom view 2
<td align="center"><br><sub>Bottom 2</sub></td>
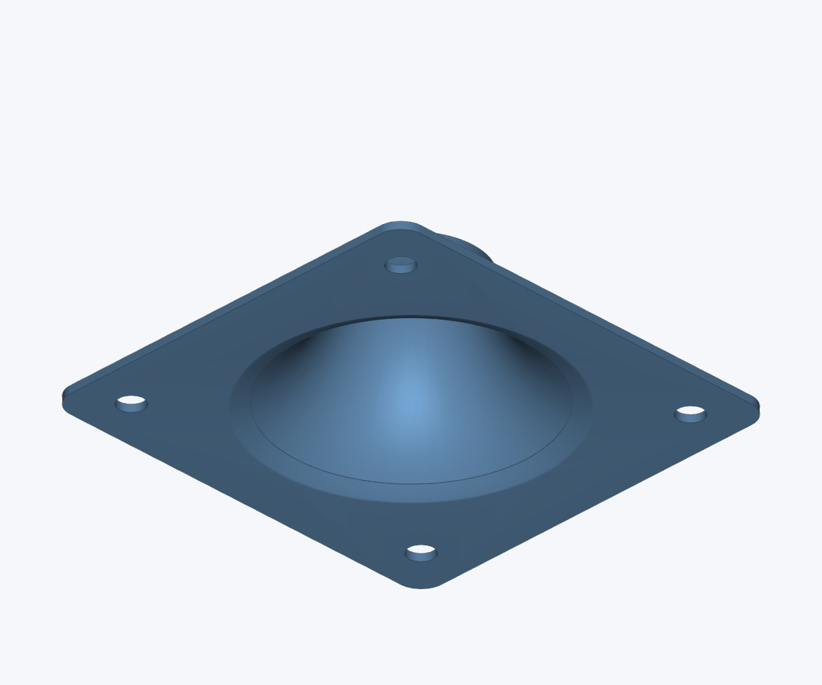
[picture p186: Microsmt-PNPv3/PNP-V3_3D_parts_2026-02-04/photos/PNPV3_3D_bottom-camera-led-diffuser-v2.1-iso-bottom-3.jpg]
Bottom camera led diffuser v2.1 — bottom view 3
<td align="center"><br><sub>Bottom 3</sub></td>
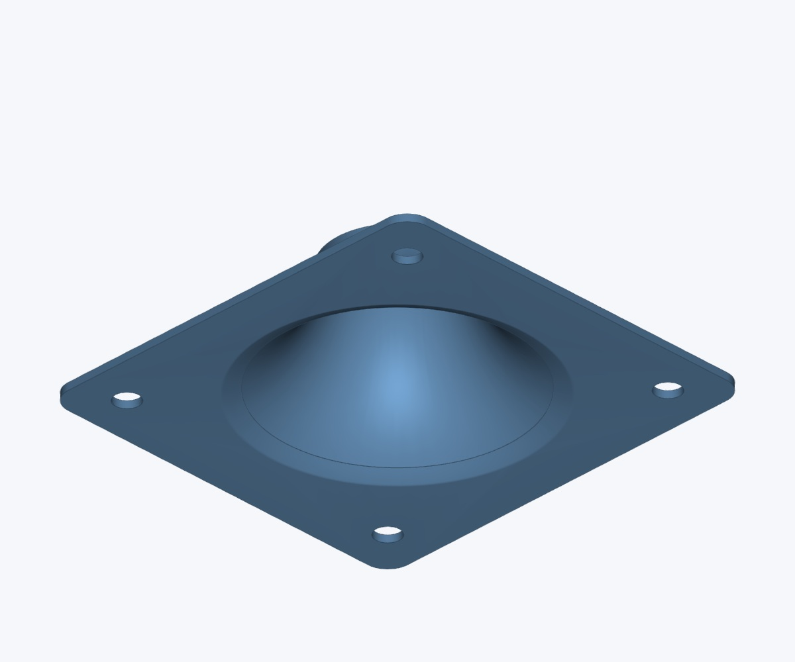
[picture p187: Microsmt-PNPv3/PNP-V3_3D_parts_2026-02-04/photos/PNPV3_3D_bottom-camera-led-diffuser-v2.1-iso-bottom-4.jpg]
Bottom camera led diffuser v2.1 — bottom view 4
<td align="center"><br><sub>Bottom 4</sub></td>
</tr>
</table>

</details>

## Bottom camera mounting plate v2.1

[STEP](PNPV3_3D_bottom-camera-mounting-plate-v2.1.step) · [STL](PNPV3_3D_bottom-camera-mounting-plate-v2.1.stl)

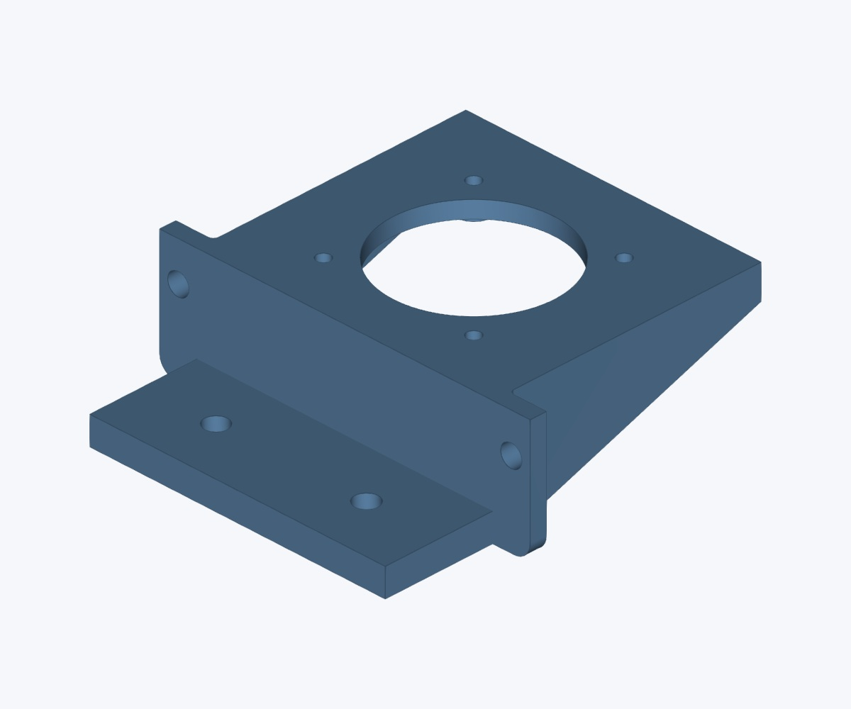
[picture p188: Microsmt-PNPv3/PNP-V3_3D_parts_2026-02-04/photos/PNPV3_3D_bottom-camera-mounting-plate-v2.1.jpg]
Bottom camera mounting plate v2.1 — original preview


<details>
<summary>More views</summary>

<table>
<tr>
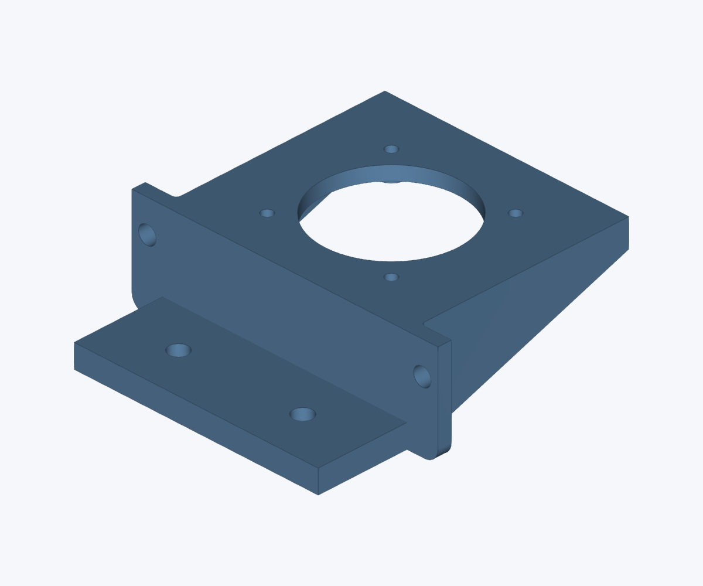
[picture p189: Microsmt-PNPv3/PNP-V3_3D_parts_2026-02-04/photos/PNPV3_3D_bottom-camera-mounting-plate-v2.1-iso-top-1.jpg]
Bottom camera mounting plate v2.1 — top view 1
<td align="center"><br><sub>Top 1</sub></td>
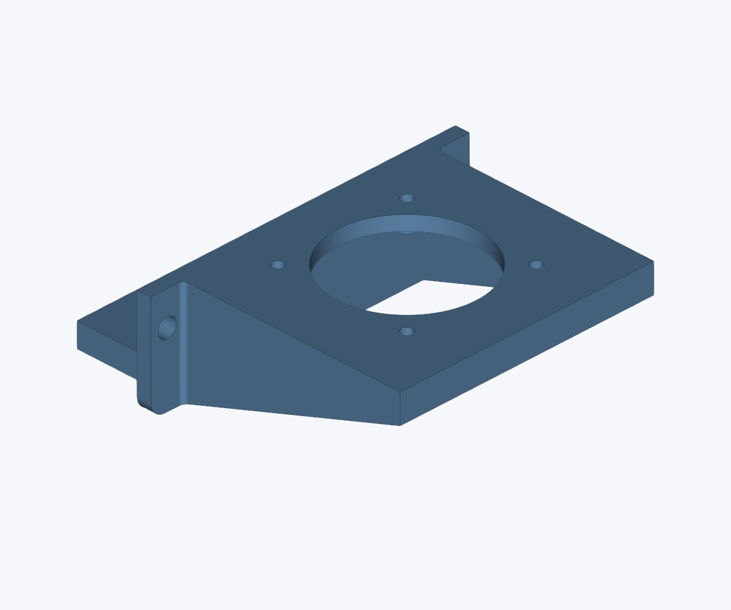
[picture p190: Microsmt-PNPv3/PNP-V3_3D_parts_2026-02-04/photos/PNPV3_3D_bottom-camera-mounting-plate-v2.1-iso-top-2.jpg]
Bottom camera mounting plate v2.1 — top view 2
<td align="center"><br><sub>Top 2</sub></td>
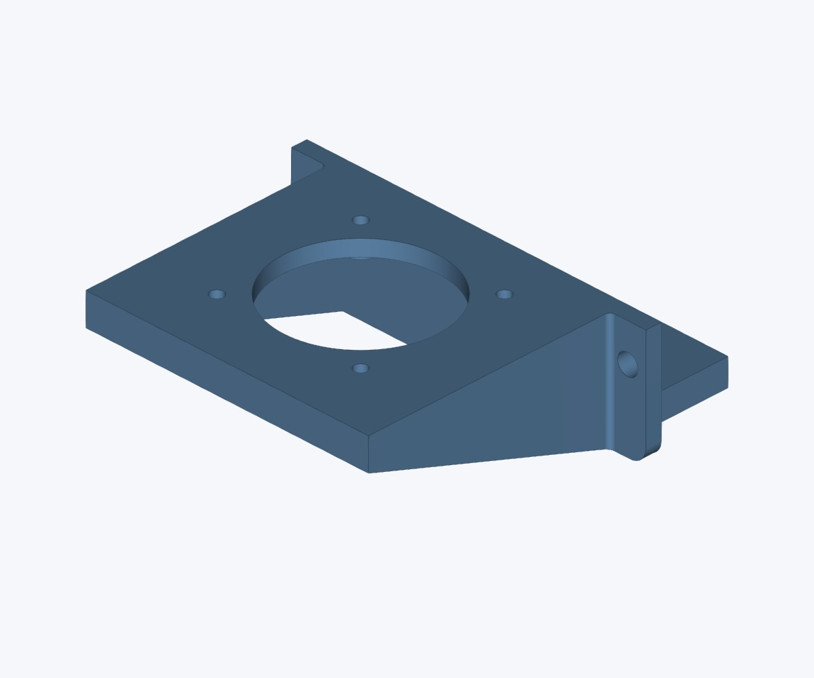
[picture p191: Microsmt-PNPv3/PNP-V3_3D_parts_2026-02-04/photos/PNPV3_3D_bottom-camera-mounting-plate-v2.1-iso-top-3.jpg]
Bottom camera mounting plate v2.1 — top view 3
<td align="center"><br><sub>Top 3</sub></td>
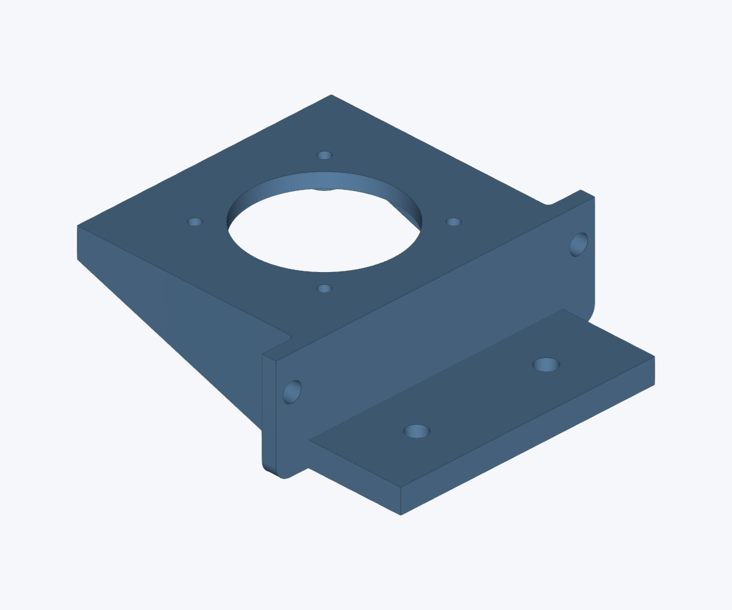
[picture p192: Microsmt-PNPv3/PNP-V3_3D_parts_2026-02-04/photos/PNPV3_3D_bottom-camera-mounting-plate-v2.1-iso-top-4.jpg]
Bottom camera mounting plate v2.1 — top view 4
<td align="center"><br><sub>Top 4</sub></td>
</tr>
<tr>
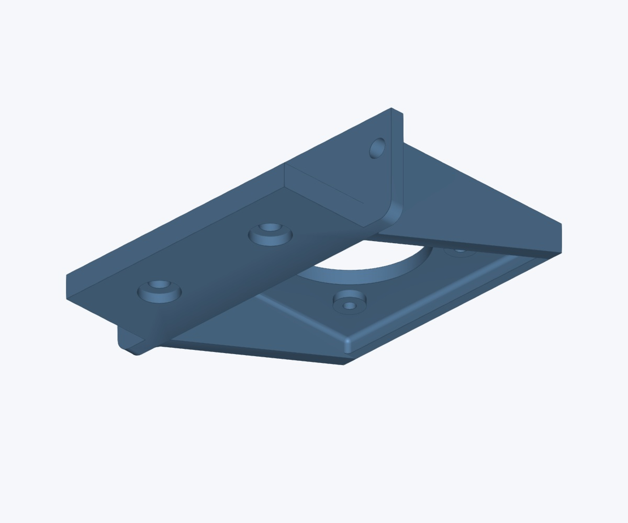
[picture p193: Microsmt-PNPv3/PNP-V3_3D_parts_2026-02-04/photos/PNPV3_3D_bottom-camera-mounting-plate-v2.1-iso-bottom-1.jpg]
Bottom camera mounting plate v2.1 — bottom view 1
<td align="center"><br><sub>Bottom 1</sub></td>
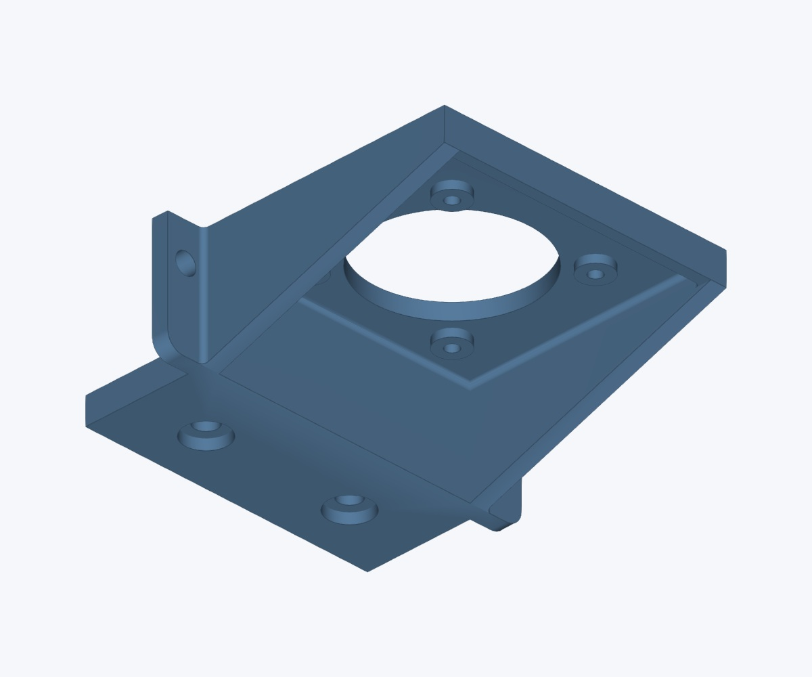
[picture p194: Microsmt-PNPv3/PNP-V3_3D_parts_2026-02-04/photos/PNPV3_3D_bottom-camera-mounting-plate-v2.1-iso-bottom-2.jpg]
Bottom camera mounting plate v2.1 — bottom view 2
<td align="center"><br><sub>Bottom 2</sub></td>
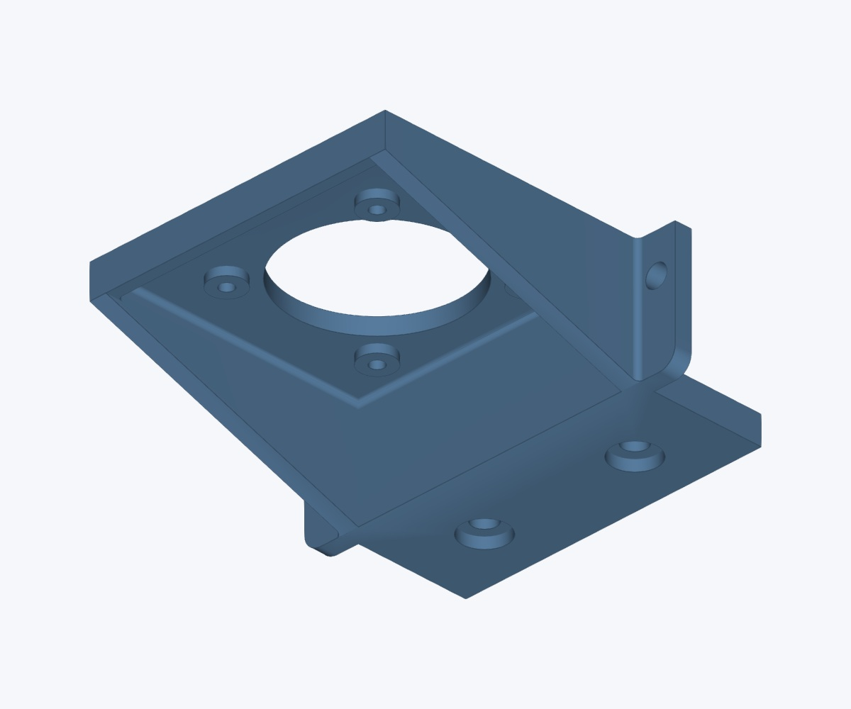
[picture p195: Microsmt-PNPv3/PNP-V3_3D_parts_2026-02-04/photos/PNPV3_3D_bottom-camera-mounting-plate-v2.1-iso-bottom-3.jpg]
Bottom camera mounting plate v2.1 — bottom view 3
<td align="center"><br><sub>Bottom 3</sub></td>
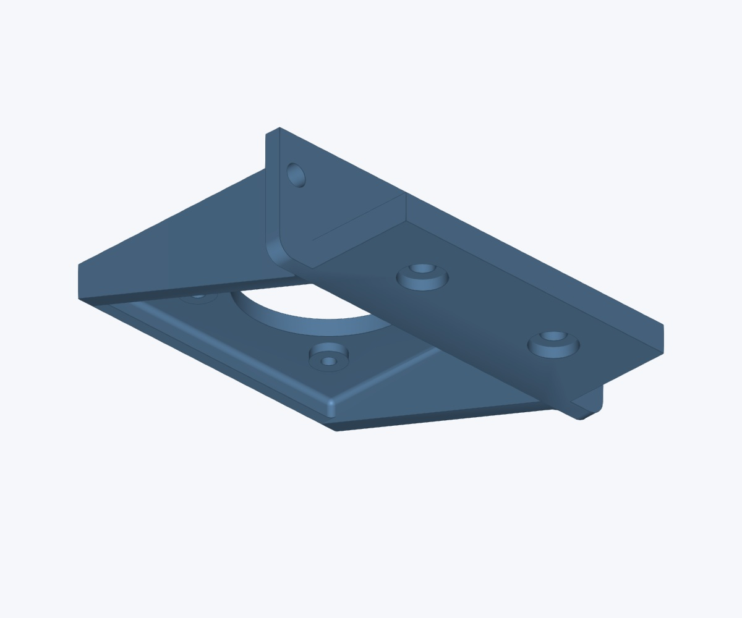
[picture p196: Microsmt-PNPv3/PNP-V3_3D_parts_2026-02-04/photos/PNPV3_3D_bottom-camera-mounting-plate-v2.1-iso-bottom-4.jpg]
Bottom camera mounting plate v2.1 — bottom view 4
<td align="center"><br><sub>Bottom 4</sub></td>
</tr>
</table>

</details>

## Bottom camera trim cover v2.1

[STEP](PNPV3_3D_bottom-camera-trim-cover-v2.1.step) · [STL](PNPV3_3D_bottom-camera-trim-cover-v2.1.stl)

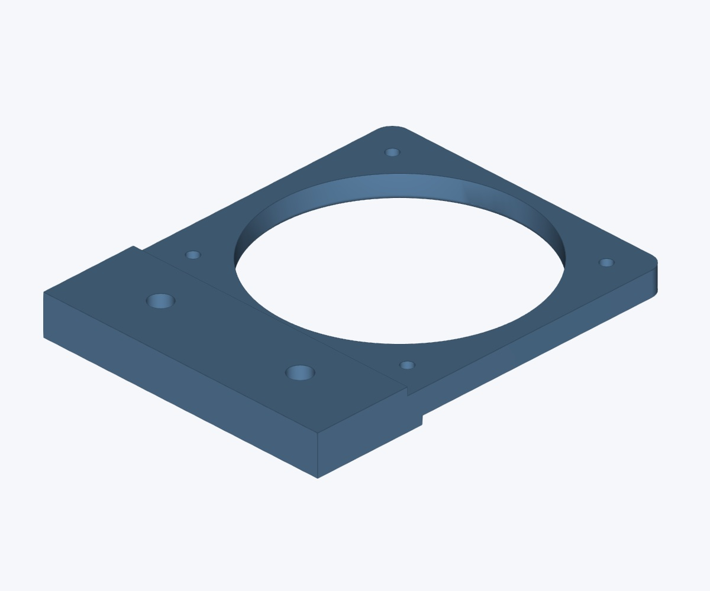
[picture p197: Microsmt-PNPv3/PNP-V3_3D_parts_2026-02-04/photos/PNPV3_3D_bottom-camera-trim-cover-v2.1.jpg]
Bottom camera trim cover v2.1 — original preview


<details>
<summary>More views</summary>

<table>
<tr>
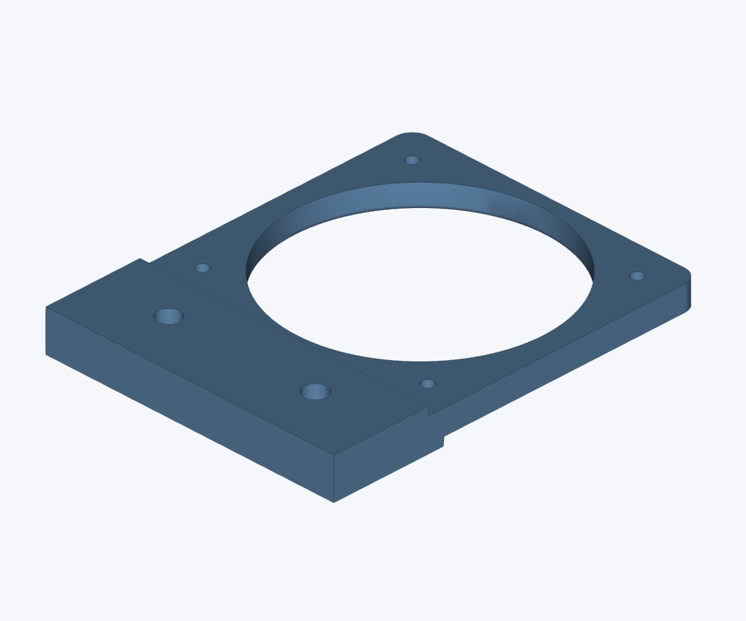
[picture p198: Microsmt-PNPv3/PNP-V3_3D_parts_2026-02-04/photos/PNPV3_3D_bottom-camera-trim-cover-v2.1-iso-top-1.jpg]
Bottom camera trim cover v2.1 — top view 1
<td align="center"><br><sub>Top 1</sub></td>
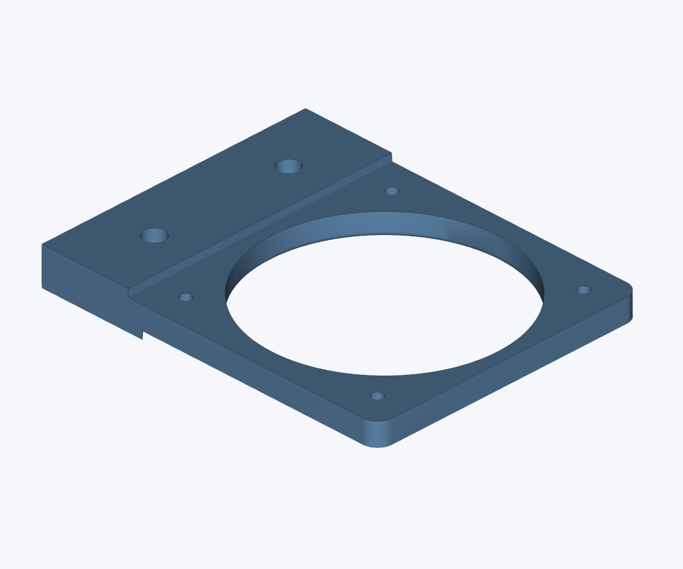
[picture p199: Microsmt-PNPv3/PNP-V3_3D_parts_2026-02-04/photos/PNPV3_3D_bottom-camera-trim-cover-v2.1-iso-top-2.jpg]
Bottom camera trim cover v2.1 — top view 2
<td align="center"><br><sub>Top 2</sub></td>
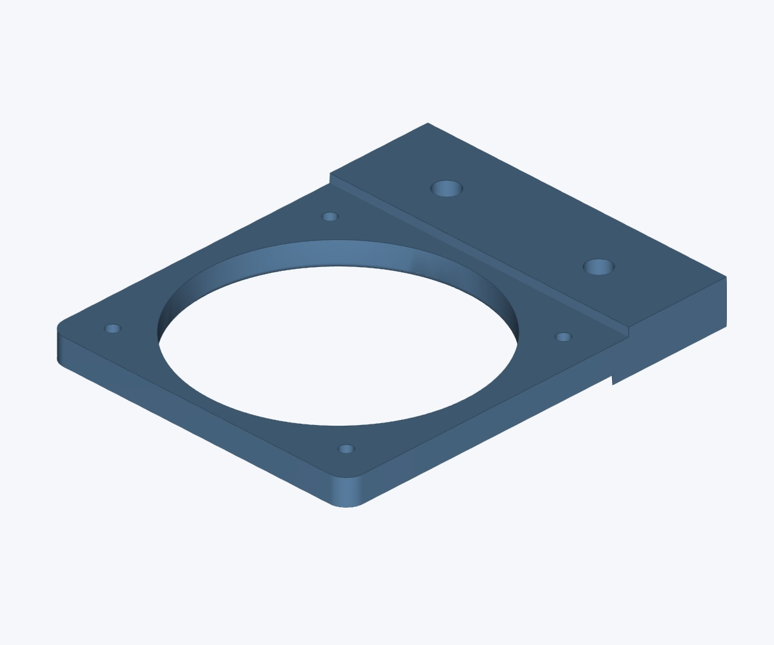
[picture p200: Microsmt-PNPv3/PNP-V3_3D_parts_2026-02-04/photos/PNPV3_3D_bottom-camera-trim-cover-v2.1-iso-top-3.jpg]
Bottom camera trim cover v2.1 — top view 3
<td align="center"><br><sub>Top 3</sub></td>
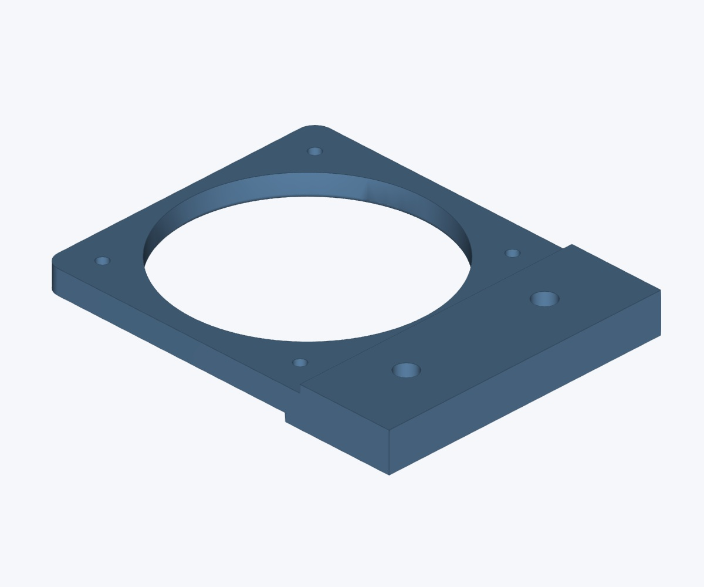
[picture p201: Microsmt-PNPv3/PNP-V3_3D_parts_2026-02-04/photos/PNPV3_3D_bottom-camera-trim-cover-v2.1-iso-top-4.jpg]
Bottom camera trim cover v2.1 — top view 4
<td align="center"><br><sub>Top 4</sub></td>
</tr>
<tr>
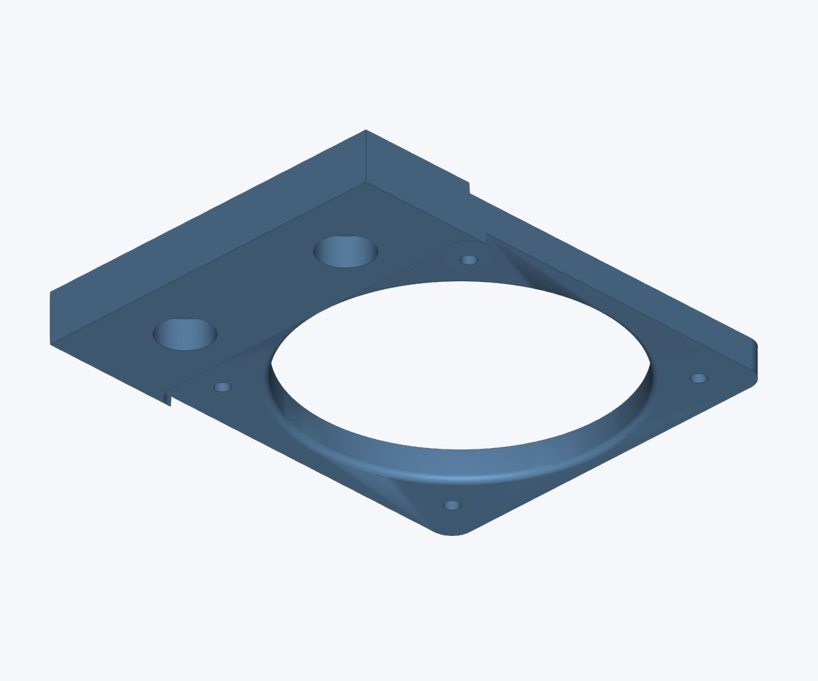
[picture p202: Microsmt-PNPv3/PNP-V3_3D_parts_2026-02-04/photos/PNPV3_3D_bottom-camera-trim-cover-v2.1-iso-bottom-1.jpg]
Bottom camera trim cover v2.1 — bottom view 1
<td align="center"><br><sub>Bottom 1</sub></td>
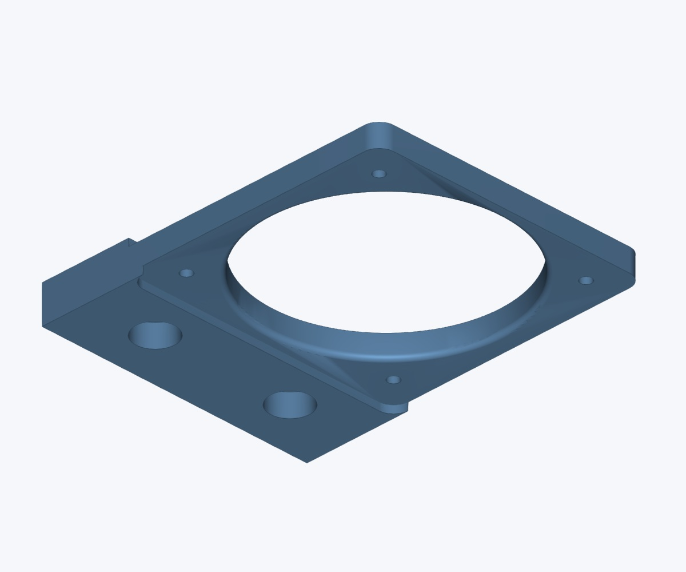
[picture p203: Microsmt-PNPv3/PNP-V3_3D_parts_2026-02-04/photos/PNPV3_3D_bottom-camera-trim-cover-v2.1-iso-bottom-2.jpg]
Bottom camera trim cover v2.1 — bottom view 2
<td align="center"><br><sub>Bottom 2</sub></td>
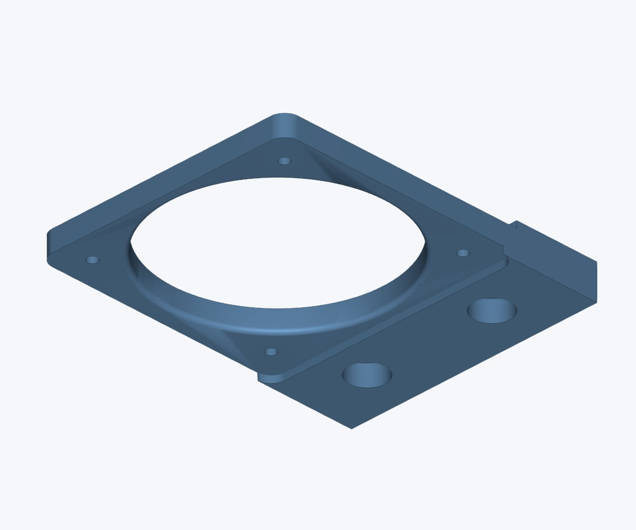
[picture p204: Microsmt-PNPv3/PNP-V3_3D_parts_2026-02-04/photos/PNPV3_3D_bottom-camera-trim-cover-v2.1-iso-bottom-3.jpg]
Bottom camera trim cover v2.1 — bottom view 3
<td align="center"><br><sub>Bottom 3</sub></td>
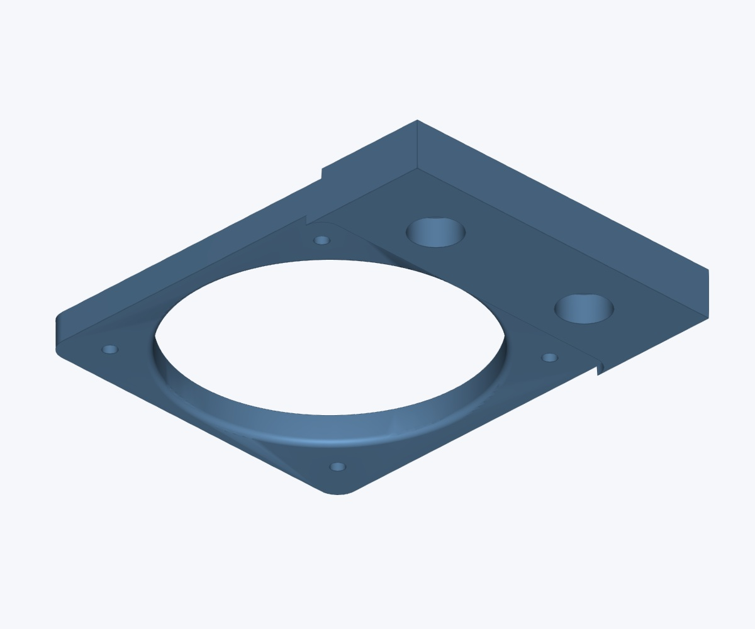
[picture p205: Microsmt-PNPv3/PNP-V3_3D_parts_2026-02-04/photos/PNPV3_3D_bottom-camera-trim-cover-v2.1-iso-bottom-4.jpg]
Bottom camera trim cover v2.1 — bottom view 4
<td align="center"><br><sub>Bottom 4</sub></td>
</tr>
</table>

</details>

## Homing fiducial

[STEP](PNPV3_3D_homing-fiducial.step) · [STL](PNPV3_3D_homing-fiducial.stl)

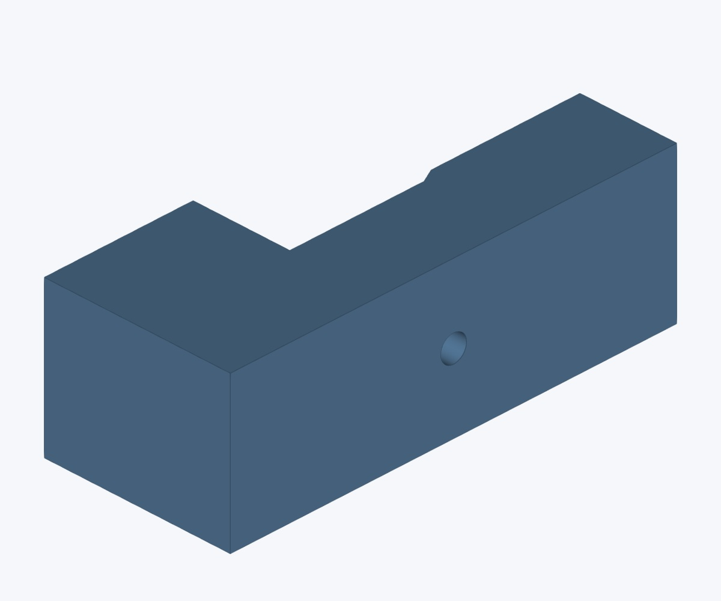
[picture p206: Microsmt-PNPv3/PNP-V3_3D_parts_2026-02-04/photos/PNPV3_3D_homing-fiducial.jpg]
Homing fiducial — original preview


<details>
<summary>More views</summary>

<table>
<tr>
<td align="center"><a href="photos/PNPV3_3D_homing-fiducial-iso-top-1.jpg">Homing fiducial — top view 1</a><br><sub>Top 1</sub></td>
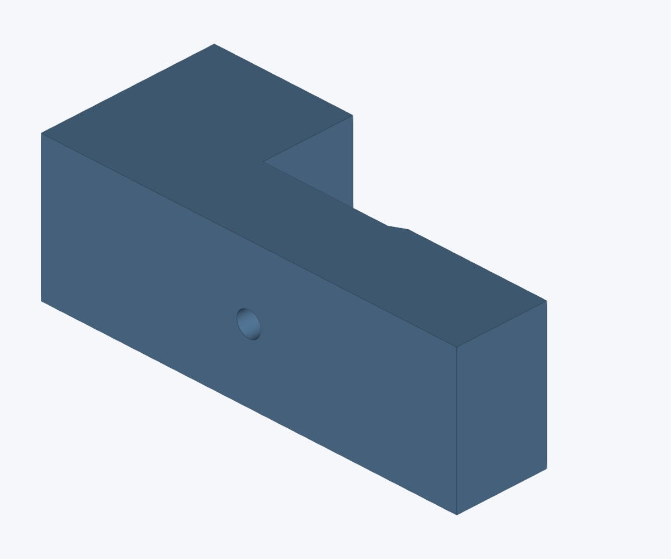
[picture p207: Microsmt-PNPv3/PNP-V3_3D_parts_2026-02-04/photos/PNPV3_3D_homing-fiducial-iso-top-2.jpg]
Homing fiducial — top view 2
<td align="center"><br><sub>Top 2</sub></td>
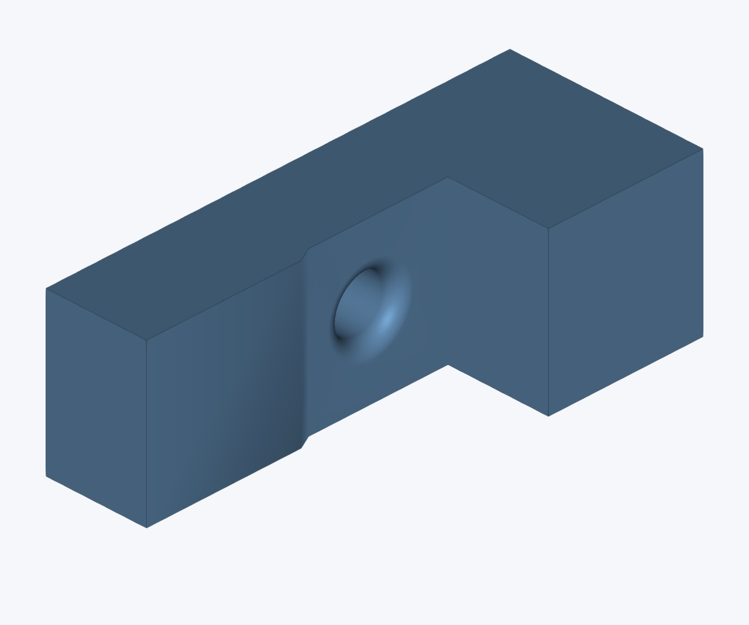
[picture p208: Microsmt-PNPv3/PNP-V3_3D_parts_2026-02-04/photos/PNPV3_3D_homing-fiducial-iso-top-3.jpg]
Homing fiducial — top view 3
<td align="center"><br><sub>Top 3</sub></td>
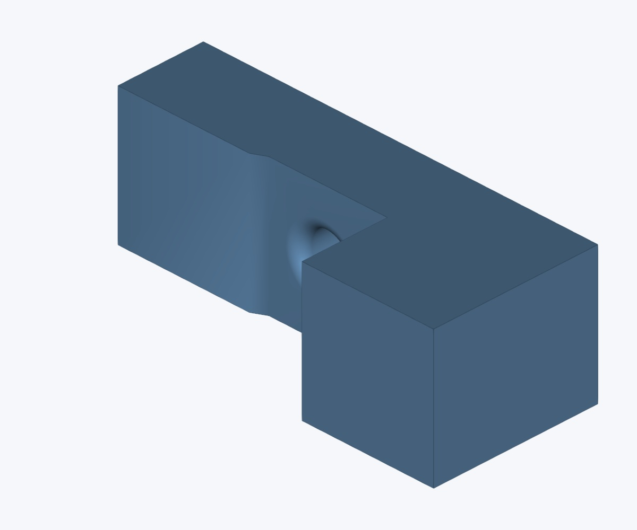
[picture p209: Microsmt-PNPv3/PNP-V3_3D_parts_2026-02-04/photos/PNPV3_3D_homing-fiducial-iso-top-4.jpg]
Homing fiducial — top view 4
<td align="center"><br><sub>Top 4</sub></td>
</tr>
<tr>
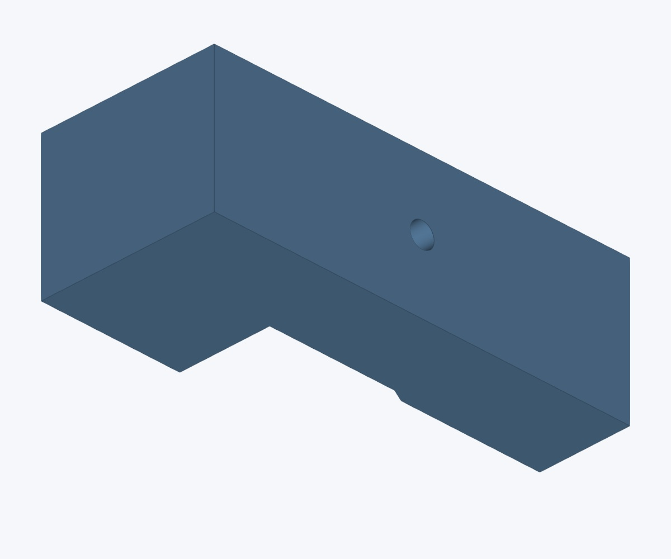
[picture p210: Microsmt-PNPv3/PNP-V3_3D_parts_2026-02-04/photos/PNPV3_3D_homing-fiducial-iso-bottom-1.jpg]
Homing fiducial — bottom view 1
<td align="center"><br><sub>Bottom 1</sub></td>
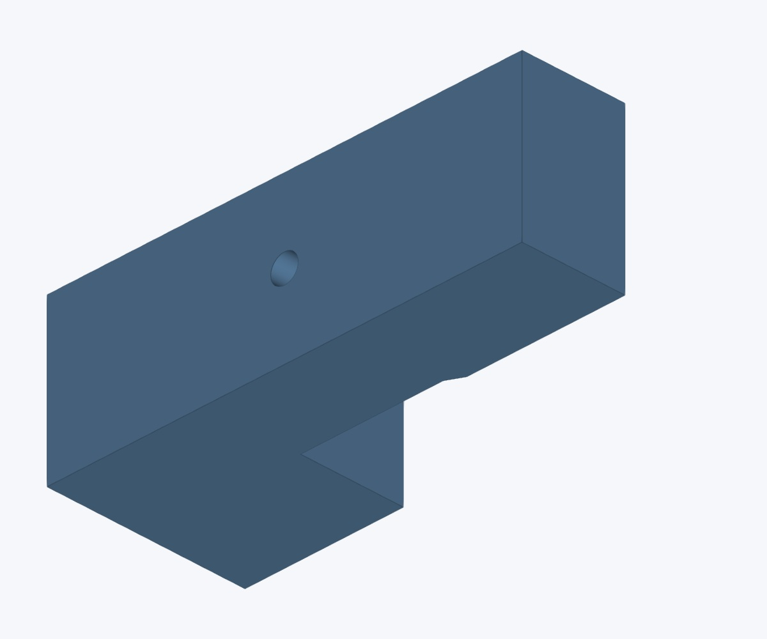
[picture p211: Microsmt-PNPv3/PNP-V3_3D_parts_2026-02-04/photos/PNPV3_3D_homing-fiducial-iso-bottom-2.jpg]
Homing fiducial — bottom view 2
<td align="center"><br><sub>Bottom 2</sub></td>
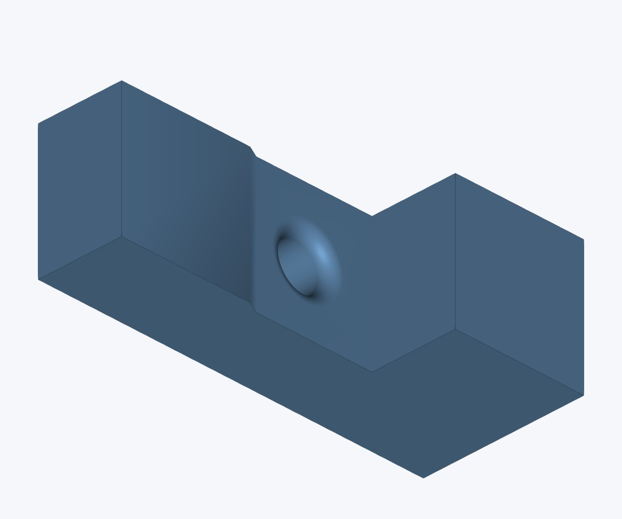
[picture p212: Microsmt-PNPv3/PNP-V3_3D_parts_2026-02-04/photos/PNPV3_3D_homing-fiducial-iso-bottom-3.jpg]
Homing fiducial — bottom view 3
<td align="center"><br><sub>Bottom 3</sub></td>
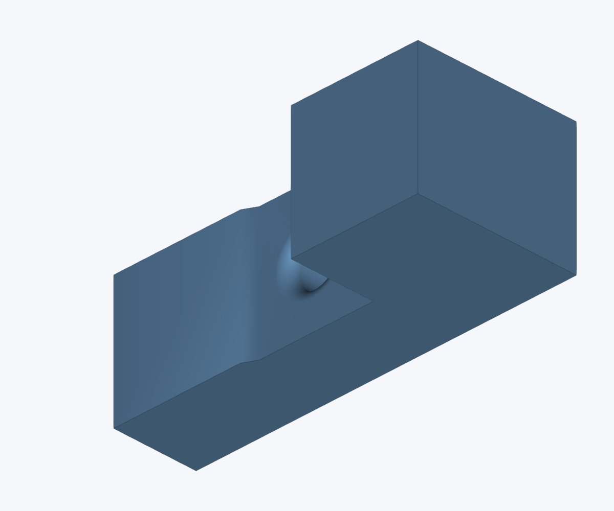
[picture p213: Microsmt-PNPv3/PNP-V3_3D_parts_2026-02-04/photos/PNPV3_3D_homing-fiducial-iso-bottom-4.jpg]
Homing fiducial — bottom view 4
<td align="center"><br><sub>Bottom 4</sub></td>
</tr>
</table>

</details>

## Low-noise pump retainer (L)

[STEP](PNPV3_3D_low-noise-pump-retainer-l.step) · [STL](PNPV3_3D_low-noise-pump-retainer-l.stl)

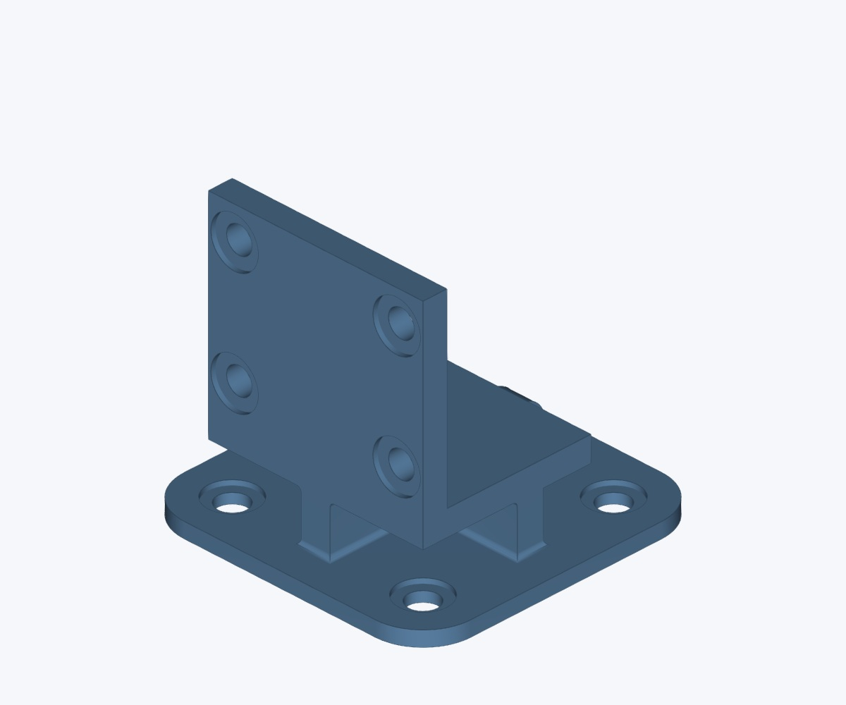
[picture p214: Microsmt-PNPv3/PNP-V3_3D_parts_2026-02-04/photos/PNPV3_3D_low-noise-pump-retainer-l.jpg]
Low noise pump retainer l — original preview


<details>
<summary>More views</summary>

<table>
<tr>
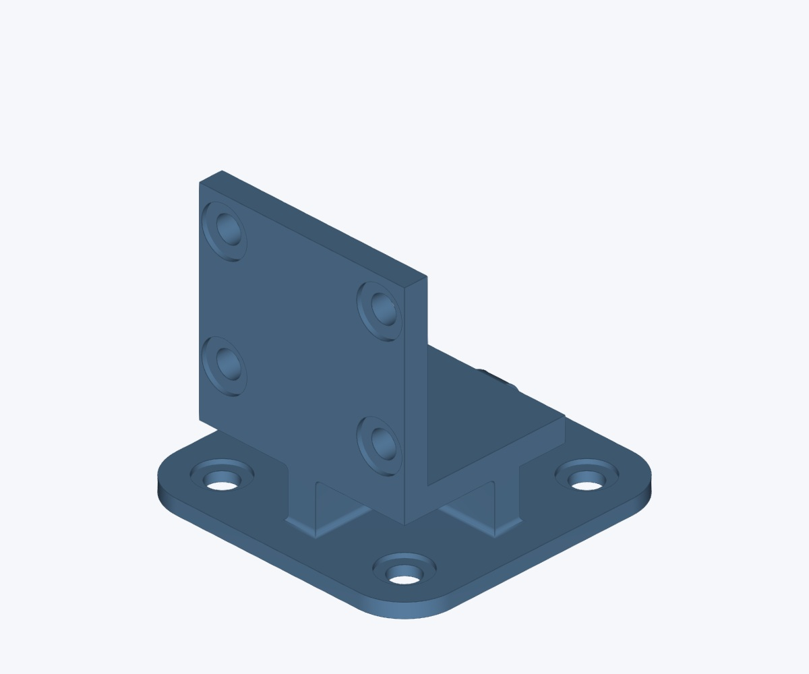
[picture p215: Microsmt-PNPv3/PNP-V3_3D_parts_2026-02-04/photos/PNPV3_3D_low-noise-pump-retainer-l-iso-top-1.jpg]
Low noise pump retainer l — top view 1
<td align="center"><br><sub>Top 1</sub></td>
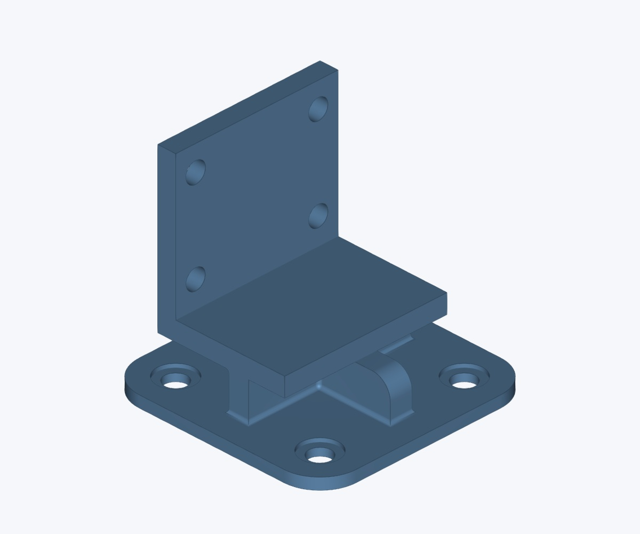
[picture p216: Microsmt-PNPv3/PNP-V3_3D_parts_2026-02-04/photos/PNPV3_3D_low-noise-pump-retainer-l-iso-top-2.jpg]
Low noise pump retainer l — top view 2
<td align="center"><br><sub>Top 2</sub></td>
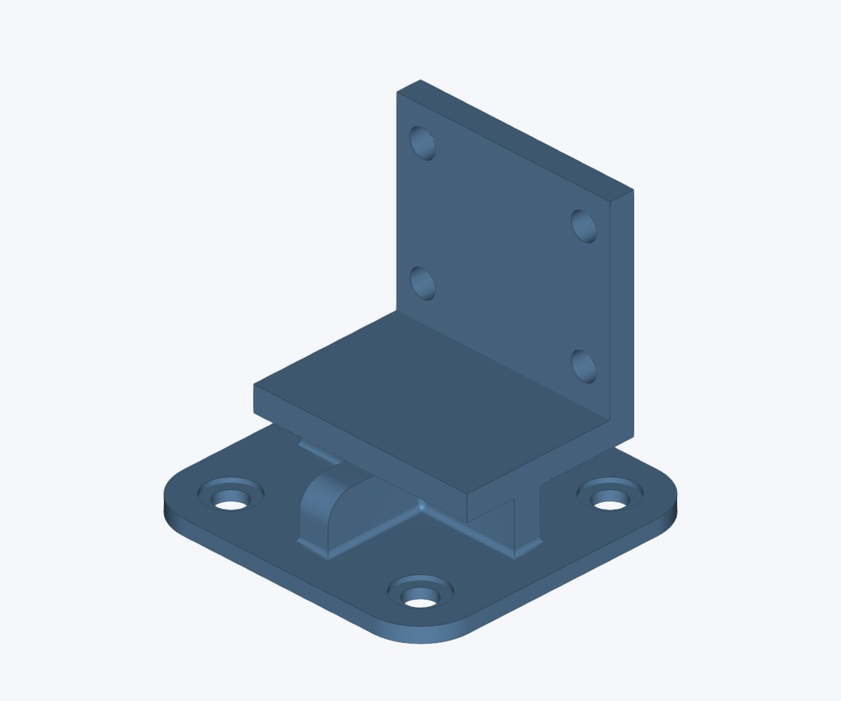
[picture p217: Microsmt-PNPv3/PNP-V3_3D_parts_2026-02-04/photos/PNPV3_3D_low-noise-pump-retainer-l-iso-top-3.jpg]
Low noise pump retainer l — top view 3
<td align="center"><br><sub>Top 3</sub></td>
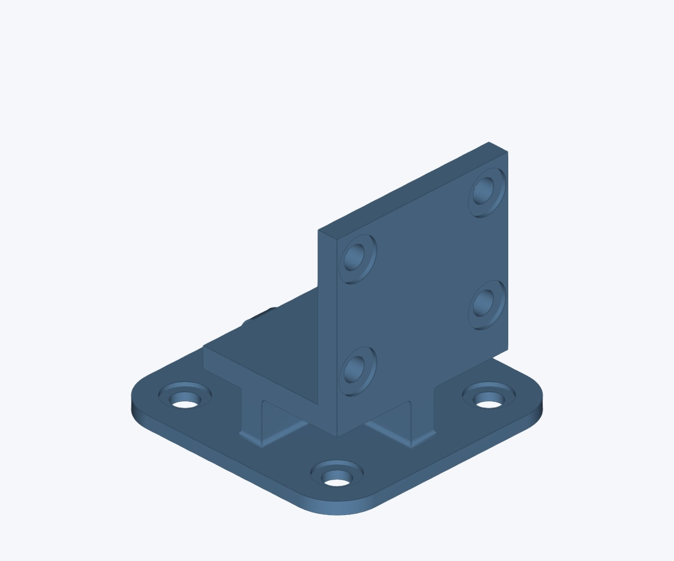
[picture p218: Microsmt-PNPv3/PNP-V3_3D_parts_2026-02-04/photos/PNPV3_3D_low-noise-pump-retainer-l-iso-top-4.jpg]
Low noise pump retainer l — top view 4
<td align="center"><br><sub>Top 4</sub></td>
</tr>
<tr>
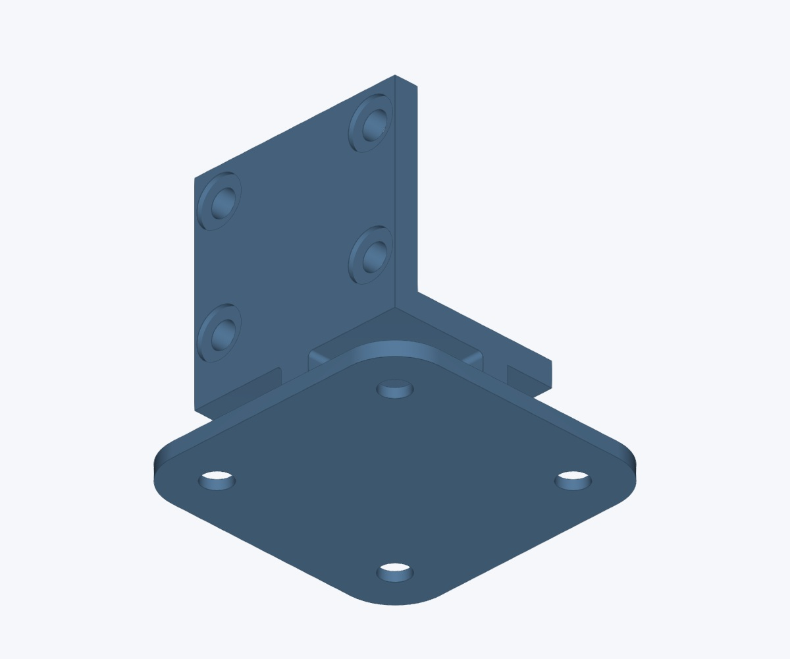
[picture p219: Microsmt-PNPv3/PNP-V3_3D_parts_2026-02-04/photos/PNPV3_3D_low-noise-pump-retainer-l-iso-bottom-1.jpg]
Low noise pump retainer l — bottom view 1
<td align="center"><br><sub>Bottom 1</sub></td>
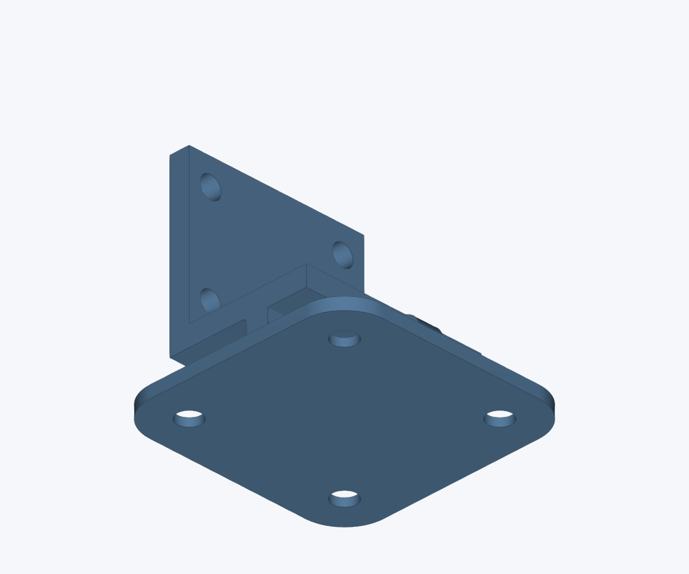
[picture p220: Microsmt-PNPv3/PNP-V3_3D_parts_2026-02-04/photos/PNPV3_3D_low-noise-pump-retainer-l-iso-bottom-2.jpg]
Low noise pump retainer l — bottom view 2
<td align="center"><br><sub>Bottom 2</sub></td>
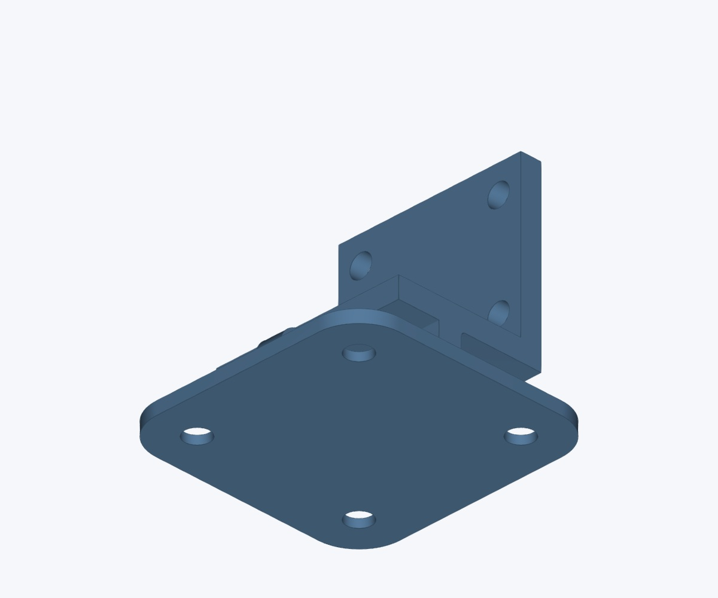
[picture p221: Microsmt-PNPv3/PNP-V3_3D_parts_2026-02-04/photos/PNPV3_3D_low-noise-pump-retainer-l-iso-bottom-3.jpg]
Low noise pump retainer l — bottom view 3
<td align="center"><br><sub>Bottom 3</sub></td>
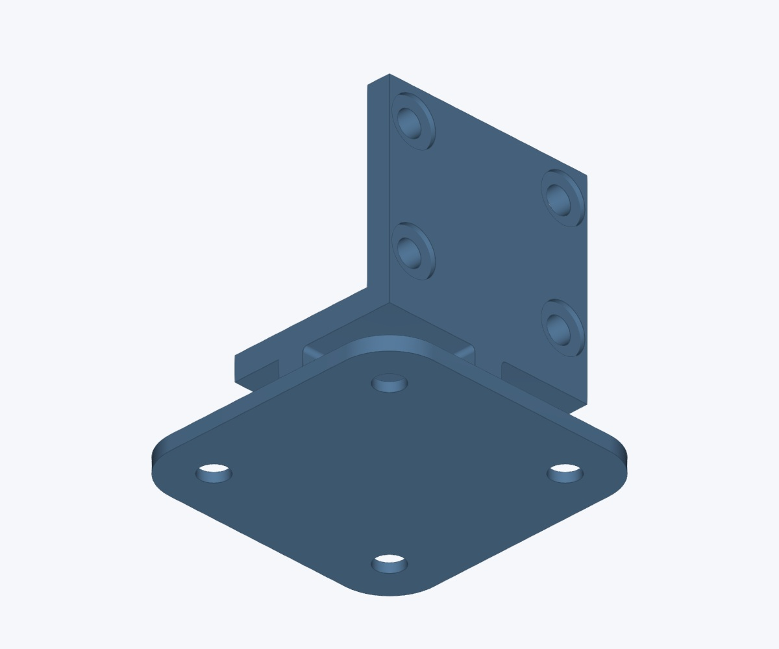
[picture p222: Microsmt-PNPv3/PNP-V3_3D_parts_2026-02-04/photos/PNPV3_3D_low-noise-pump-retainer-l-iso-bottom-4.jpg]
Low noise pump retainer l — bottom view 4
<td align="center"><br><sub>Bottom 4</sub></td>
</tr>
</table>

</details>

## Mega2560 controller box

[STL](PNPV3_3D_mega2560-controller-box.stl)

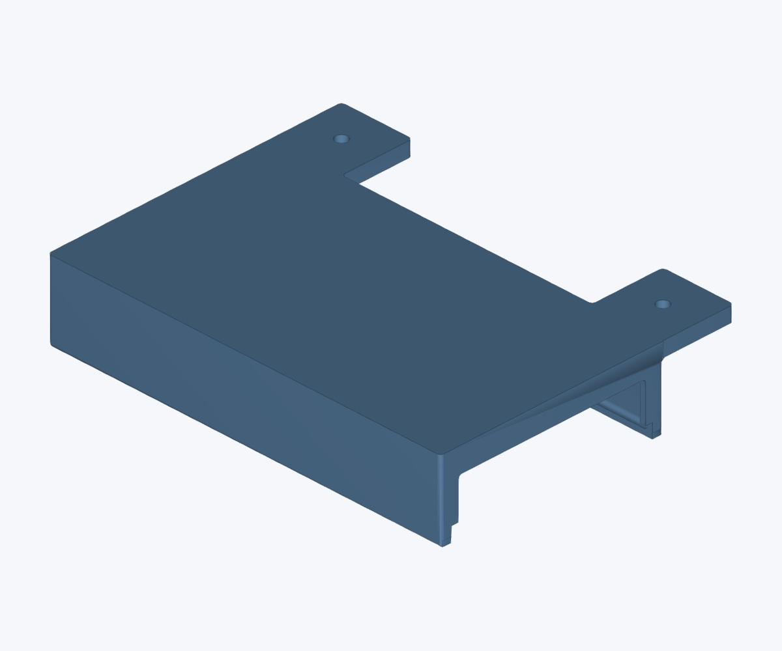
[picture p223: Microsmt-PNPv3/PNP-V3_3D_parts_2026-02-04/photos/PNPV3_3D_mega2560-controller-box.jpg]
Mega2560 controller box — original preview


<details>
<summary>More views</summary>

<table>
<tr>
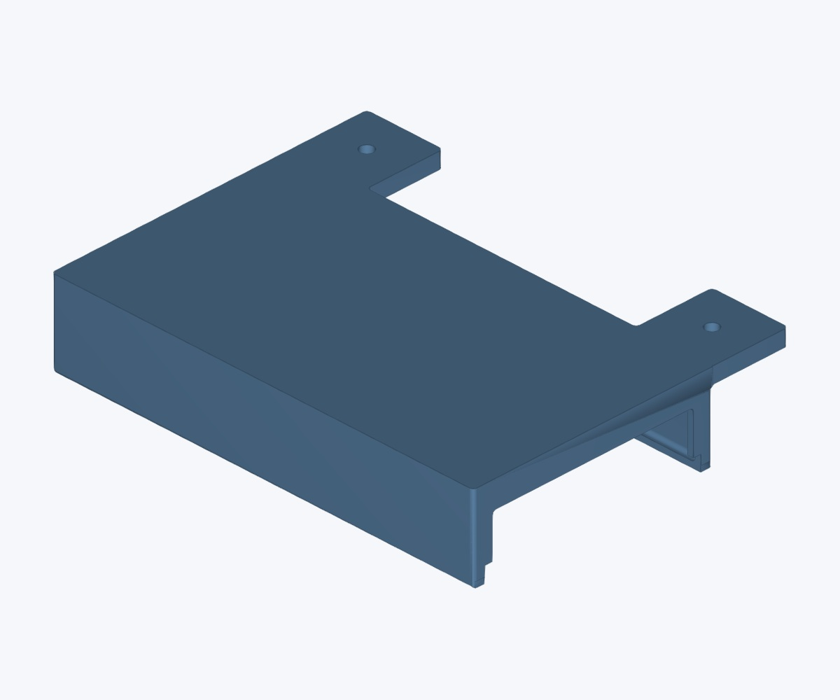
[picture p224: Microsmt-PNPv3/PNP-V3_3D_parts_2026-02-04/photos/PNPV3_3D_mega2560-controller-box-iso-top-1.jpg]
Mega2560 controller box — top view 1
<td align="center"><br><sub>Top 1</sub></td>
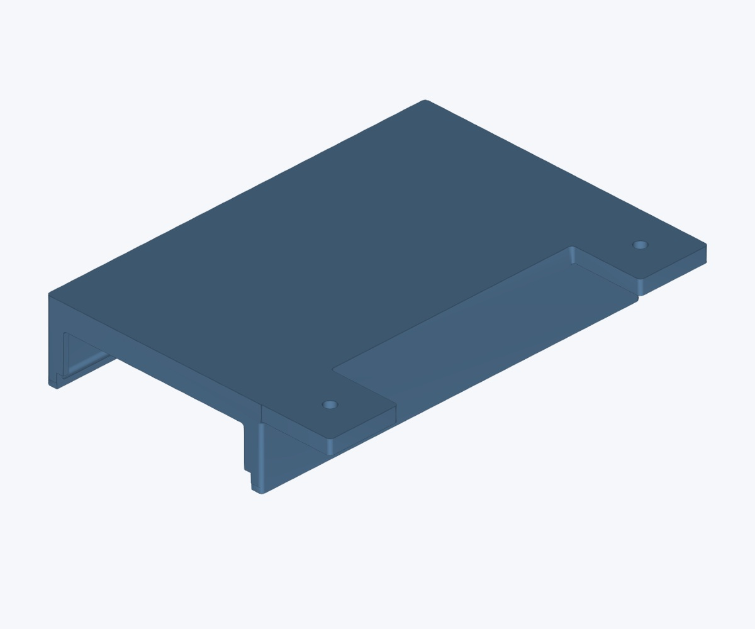
[picture p225: Microsmt-PNPv3/PNP-V3_3D_parts_2026-02-04/photos/PNPV3_3D_mega2560-controller-box-iso-top-2.jpg]
Mega2560 controller box — top view 2
<td align="center"><br><sub>Top 2</sub></td>
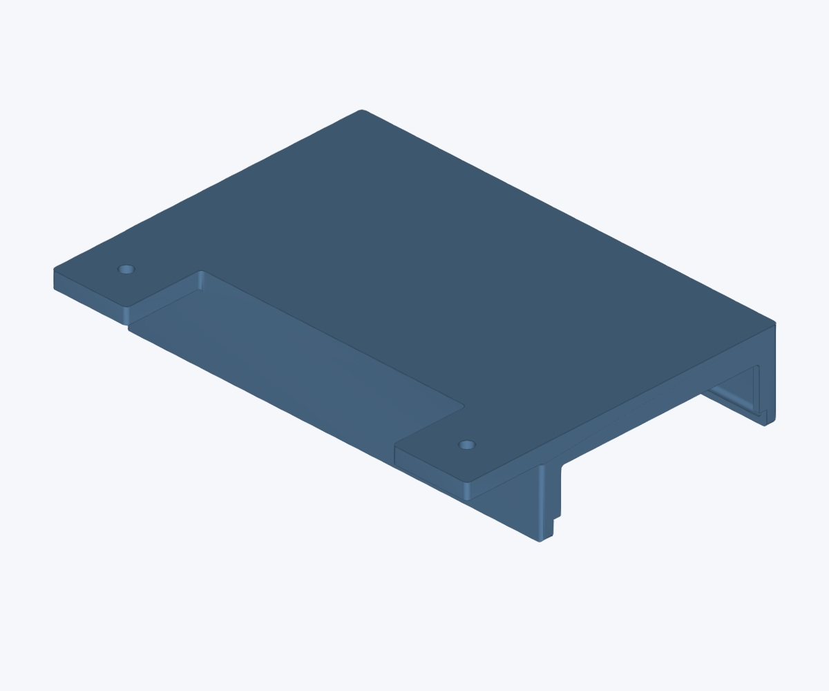
[picture p226: Microsmt-PNPv3/PNP-V3_3D_parts_2026-02-04/photos/PNPV3_3D_mega2560-controller-box-iso-top-3.jpg]
Mega2560 controller box — top view 3
<td align="center"><br><sub>Top 3</sub></td>
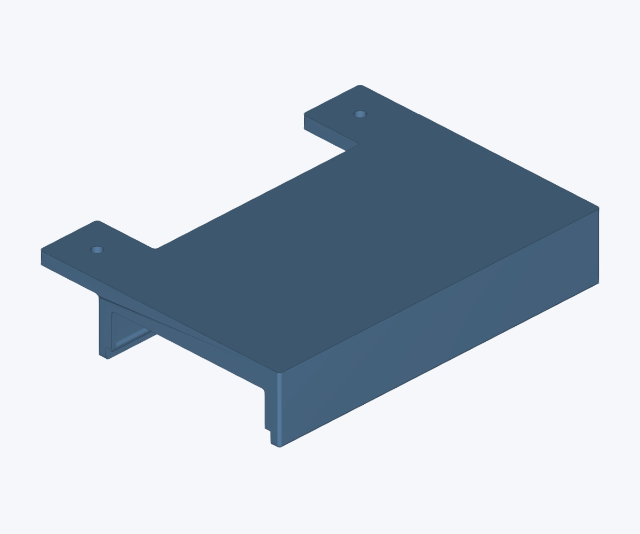
[picture p227: Microsmt-PNPv3/PNP-V3_3D_parts_2026-02-04/photos/PNPV3_3D_mega2560-controller-box-iso-top-4.jpg]
Mega2560 controller box — top view 4
<td align="center"><br><sub>Top 4</sub></td>
</tr>
<tr>
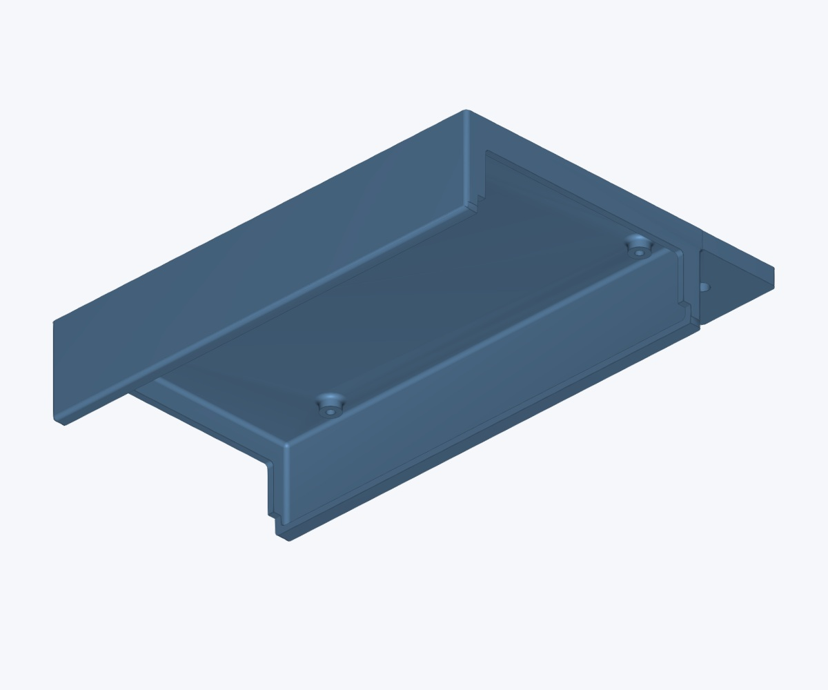
[picture p228: Microsmt-PNPv3/PNP-V3_3D_parts_2026-02-04/photos/PNPV3_3D_mega2560-controller-box-iso-bottom-1.jpg]
Mega2560 controller box — bottom view 1
<td align="center"><br><sub>Bottom 1</sub></td>
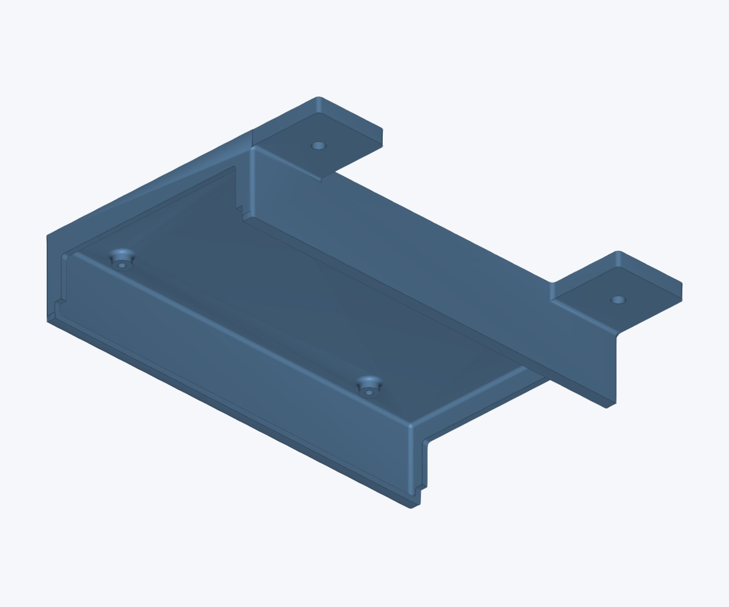
[picture p229: Microsmt-PNPv3/PNP-V3_3D_parts_2026-02-04/photos/PNPV3_3D_mega2560-controller-box-iso-bottom-2.jpg]
Mega2560 controller box — bottom view 2
<td align="center"><br><sub>Bottom 2</sub></td>
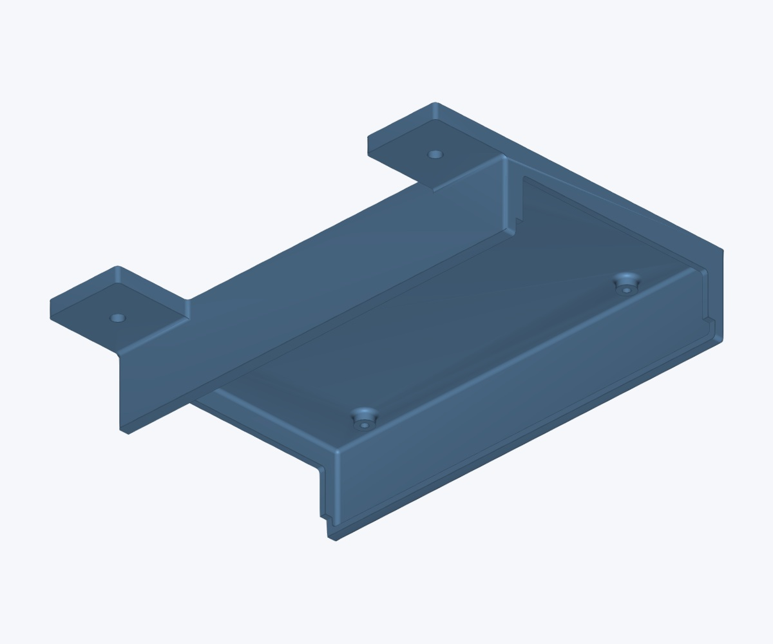
[picture p230: Microsmt-PNPv3/PNP-V3_3D_parts_2026-02-04/photos/PNPV3_3D_mega2560-controller-box-iso-bottom-3.jpg]
Mega2560 controller box — bottom view 3
<td align="center"><br><sub>Bottom 3</sub></td>
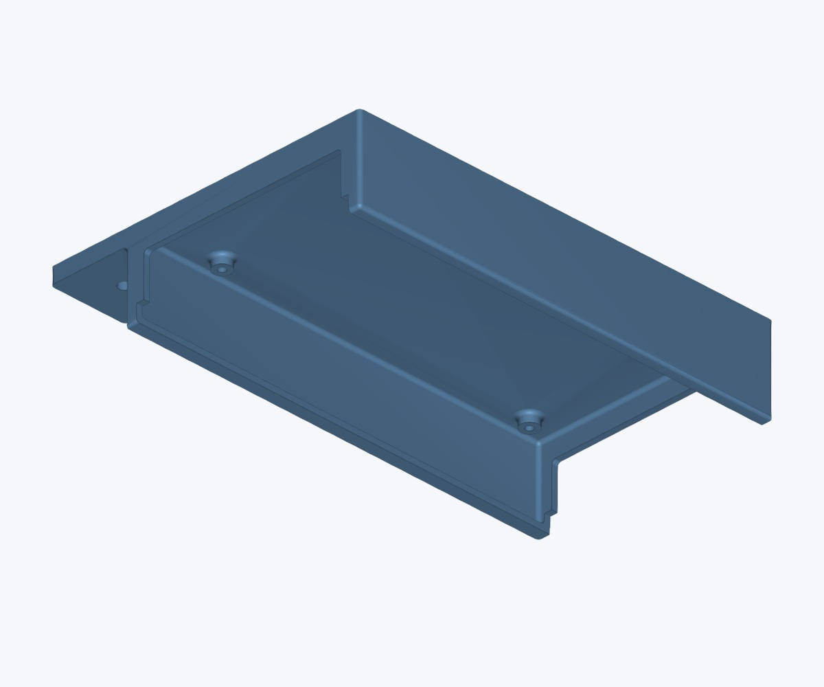
[picture p231: Microsmt-PNPv3/PNP-V3_3D_parts_2026-02-04/photos/PNPV3_3D_mega2560-controller-box-iso-bottom-4.jpg]
Mega2560 controller box — bottom view 4
<td align="center"><br><sub>Bottom 4</sub></td>
</tr>
</table>

</details>

## Motherboard mounting hook

[STL](PNPV3_3D_motherboard-mounting-hook.stl)

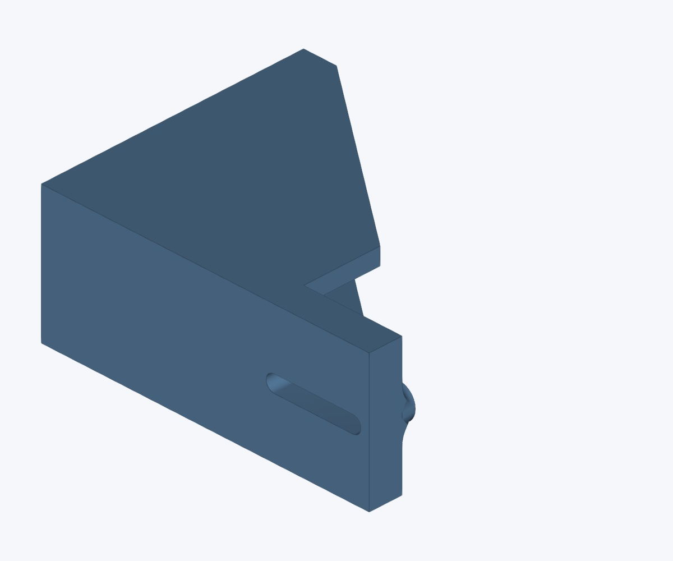
[picture p232: Microsmt-PNPv3/PNP-V3_3D_parts_2026-02-04/photos/PNPV3_3D_motherboard-mounting-hook.jpg]
Motherboard mounting hook — original preview


<details>
<summary>More views</summary>

<table>
<tr>
<td align="center"><a href="photos/PNPV3_3D_motherboard-mounting-hook-iso-top-1.jpg">Motherboard mounting hook — top view 1</a><br><sub>Top 1</sub></td>
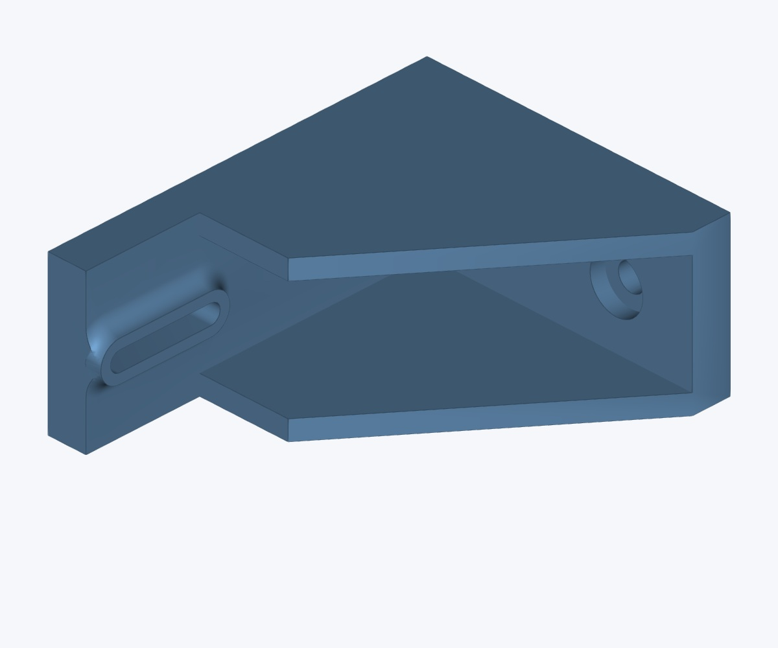
[picture p233: Microsmt-PNPv3/PNP-V3_3D_parts_2026-02-04/photos/PNPV3_3D_motherboard-mounting-hook-iso-top-2.jpg]
Motherboard mounting hook — top view 2
<td align="center"><br><sub>Top 2</sub></td>
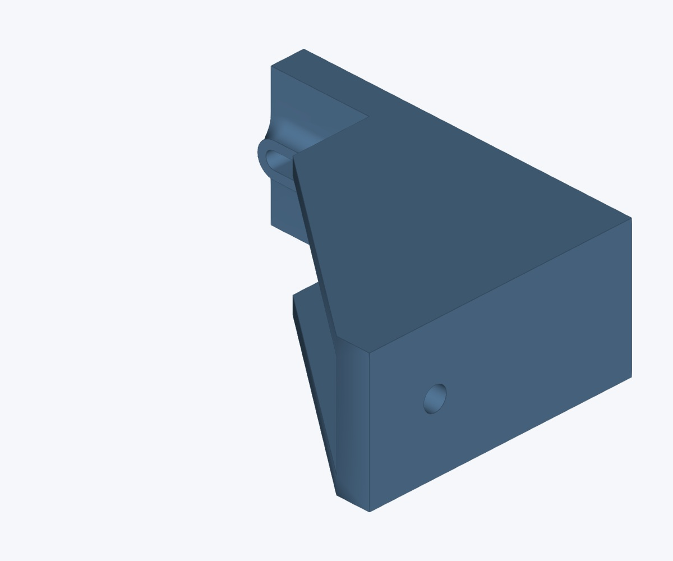
[picture p234: Microsmt-PNPv3/PNP-V3_3D_parts_2026-02-04/photos/PNPV3_3D_motherboard-mounting-hook-iso-top-3.jpg]
Motherboard mounting hook — top view 3
<td align="center"><br><sub>Top 3</sub></td>
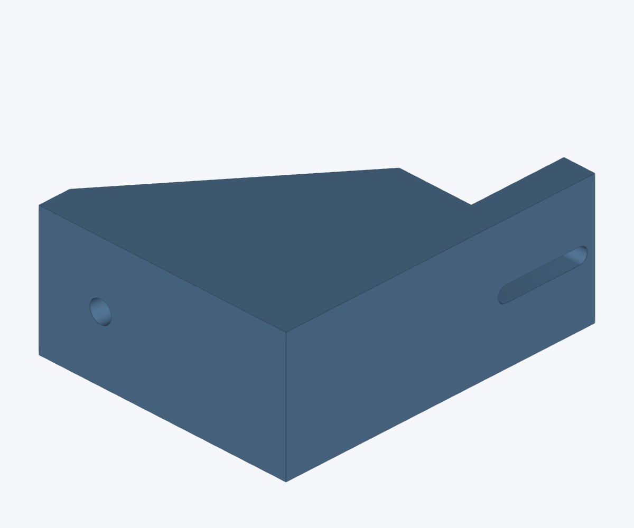
[picture p235: Microsmt-PNPv3/PNP-V3_3D_parts_2026-02-04/photos/PNPV3_3D_motherboard-mounting-hook-iso-top-4.jpg]
Motherboard mounting hook — top view 4
<td align="center"><br><sub>Top 4</sub></td>
</tr>
<tr>
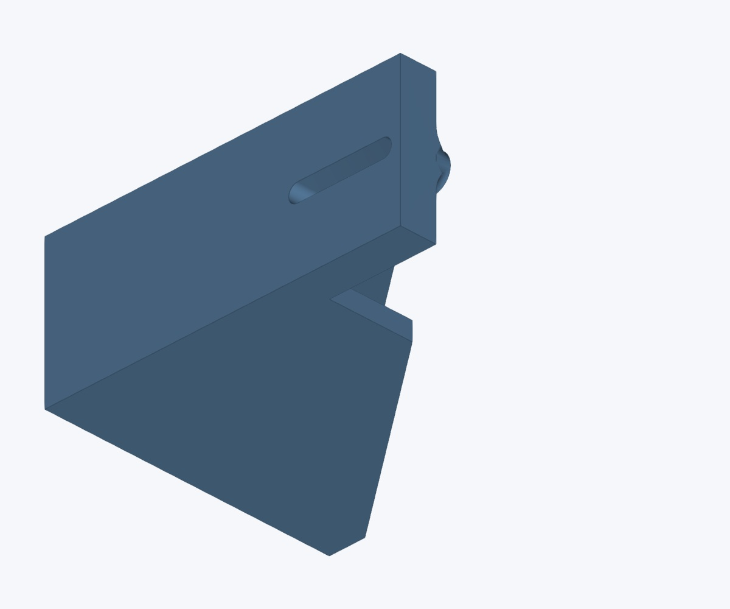
[picture p236: Microsmt-PNPv3/PNP-V3_3D_parts_2026-02-04/photos/PNPV3_3D_motherboard-mounting-hook-iso-bottom-1.jpg]
Motherboard mounting hook — bottom view 1
<td align="center"><br><sub>Bottom 1</sub></td>
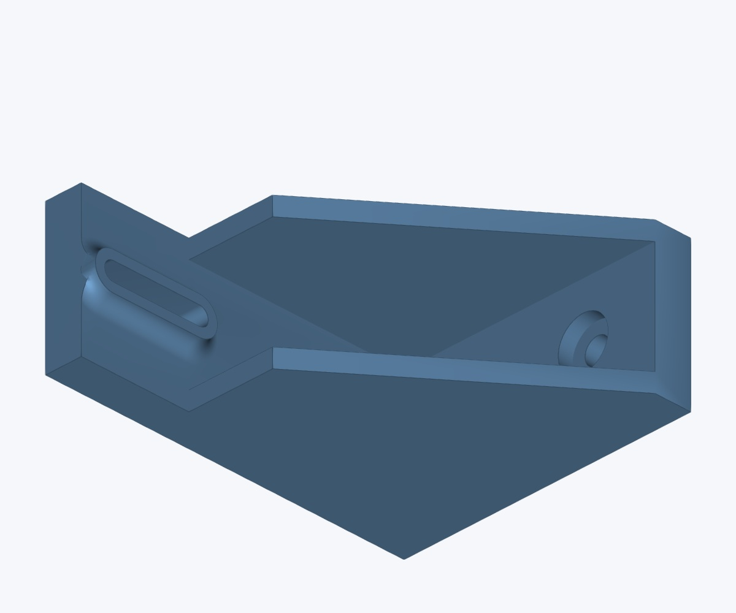
[picture p237: Microsmt-PNPv3/PNP-V3_3D_parts_2026-02-04/photos/PNPV3_3D_motherboard-mounting-hook-iso-bottom-2.jpg]
Motherboard mounting hook — bottom view 2
<td align="center"><br><sub>Bottom 2</sub></td>
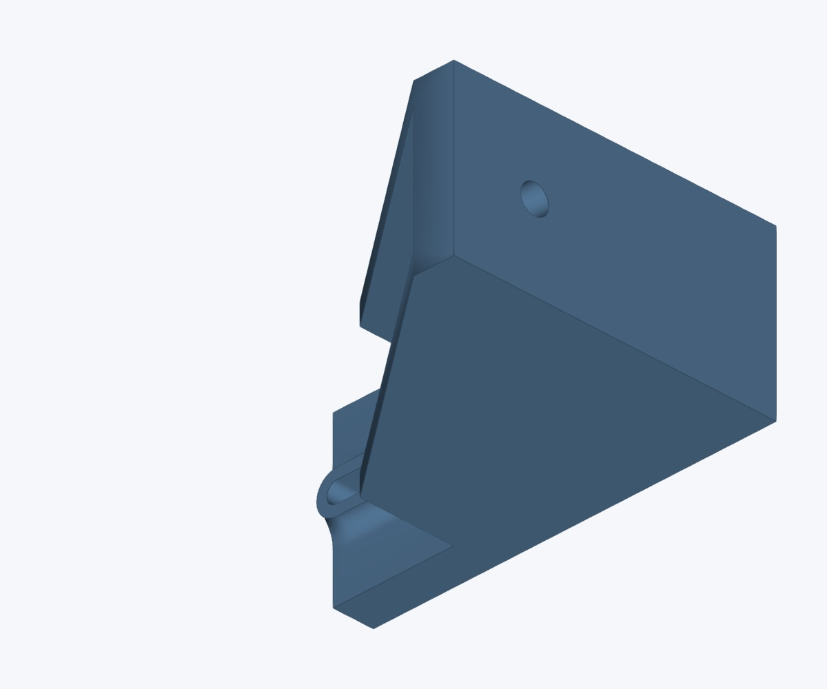
[picture p238: Microsmt-PNPv3/PNP-V3_3D_parts_2026-02-04/photos/PNPV3_3D_motherboard-mounting-hook-iso-bottom-3.jpg]
Motherboard mounting hook — bottom view 3
<td align="center"><br><sub>Bottom 3</sub></td>
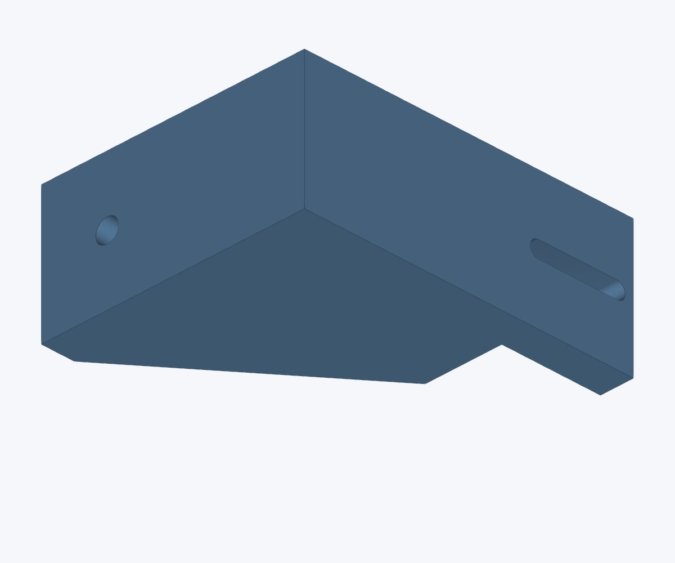
[picture p239: Microsmt-PNPv3/PNP-V3_3D_parts_2026-02-04/photos/PNPV3_3D_motherboard-mounting-hook-iso-bottom-4.jpg]
Motherboard mounting hook — bottom view 4
<td align="center"><br><sub>Bottom 4</sub></td>
</tr>
</table>

</details>

## Motherboard mounting plate

[STL](PNPV3_3D_motherboard-mounting-plate.stl)

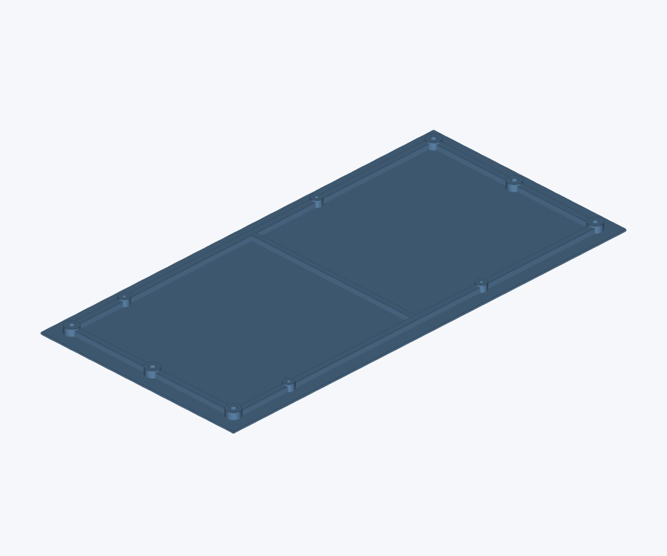
[picture p240: Microsmt-PNPv3/PNP-V3_3D_parts_2026-02-04/photos/PNPV3_3D_motherboard-mounting-plate.jpg]
Motherboard mounting plate — original preview


<details>
<summary>More views</summary>

<table>
<tr>
<td align="center"><a href="photos/PNPV3_3D_motherboard-mounting-plate-iso-top-1.jpg">Motherboard mounting plate — top view 1</a><br><sub>Top 1</sub></td>
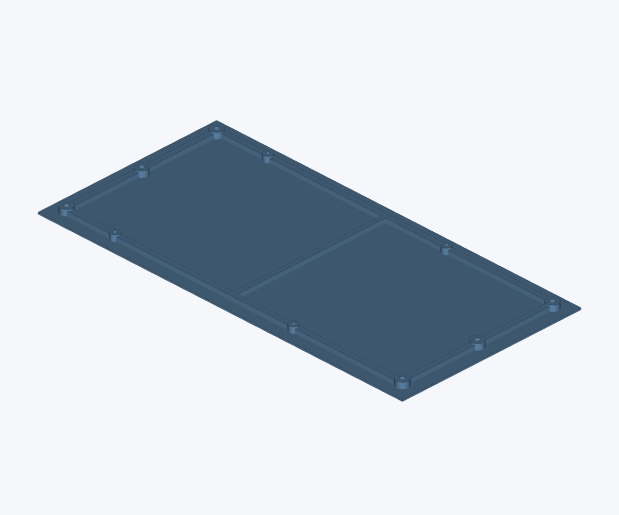
[picture p241: Microsmt-PNPv3/PNP-V3_3D_parts_2026-02-04/photos/PNPV3_3D_motherboard-mounting-plate-iso-top-2.jpg]
Motherboard mounting plate — top view 2
<td align="center"><br><sub>Top 2</sub></td>
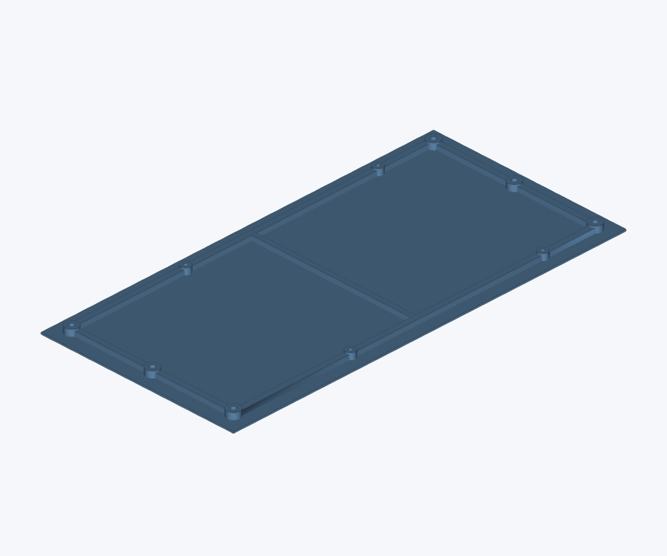
[picture p242: Microsmt-PNPv3/PNP-V3_3D_parts_2026-02-04/photos/PNPV3_3D_motherboard-mounting-plate-iso-top-3.jpg]
Motherboard mounting plate — top view 3
<td align="center"><br><sub>Top 3</sub></td>
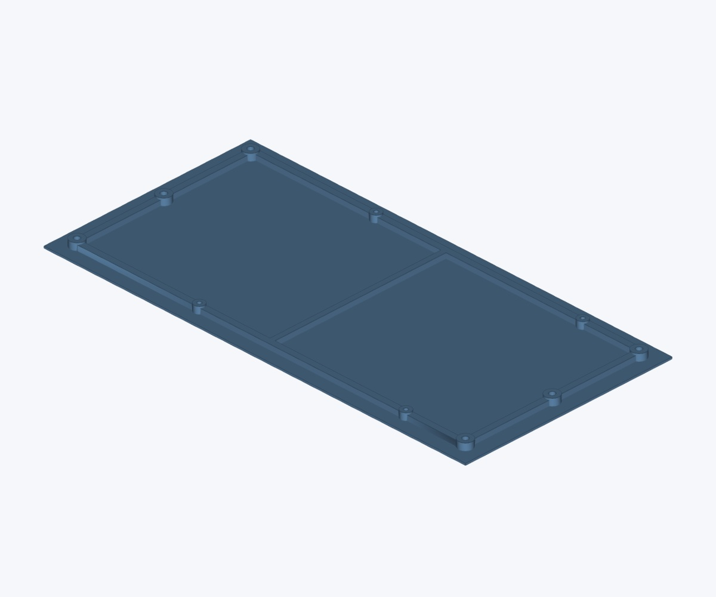
[picture p243: Microsmt-PNPv3/PNP-V3_3D_parts_2026-02-04/photos/PNPV3_3D_motherboard-mounting-plate-iso-top-4.jpg]
Motherboard mounting plate — top view 4
<td align="center"><br><sub>Top 4</sub></td>
</tr>
<tr>
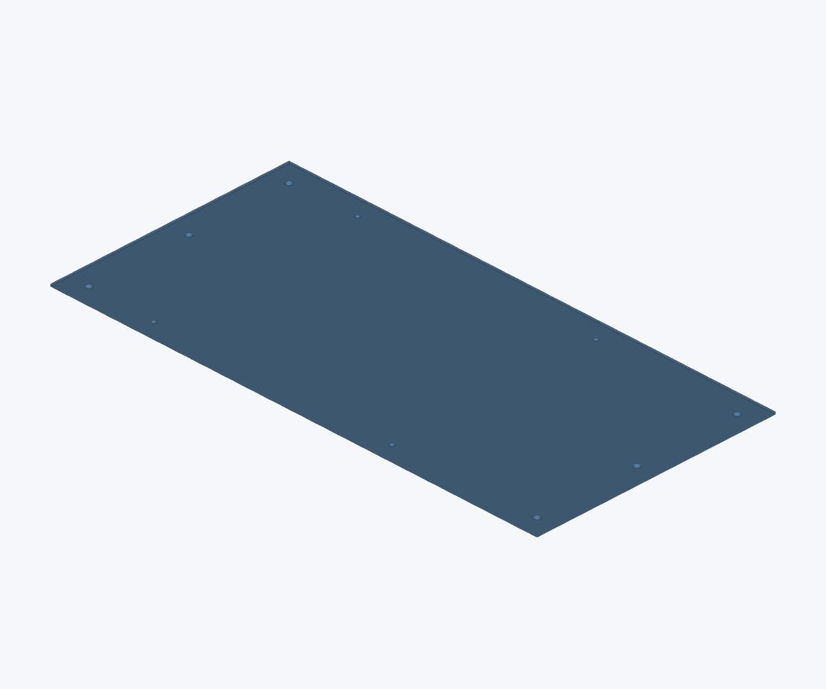
[picture p244: Microsmt-PNPv3/PNP-V3_3D_parts_2026-02-04/photos/PNPV3_3D_motherboard-mounting-plate-iso-bottom-1.jpg]
Motherboard mounting plate — bottom view 1
<td align="center"><br><sub>Bottom 1</sub></td>
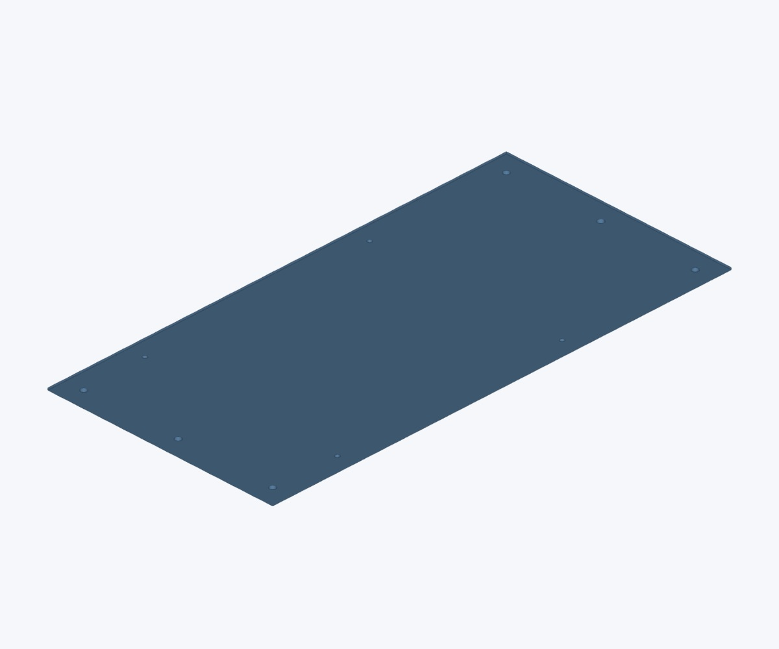
[picture p245: Microsmt-PNPv3/PNP-V3_3D_parts_2026-02-04/photos/PNPV3_3D_motherboard-mounting-plate-iso-bottom-2.jpg]
Motherboard mounting plate — bottom view 2
<td align="center"><br><sub>Bottom 2</sub></td>
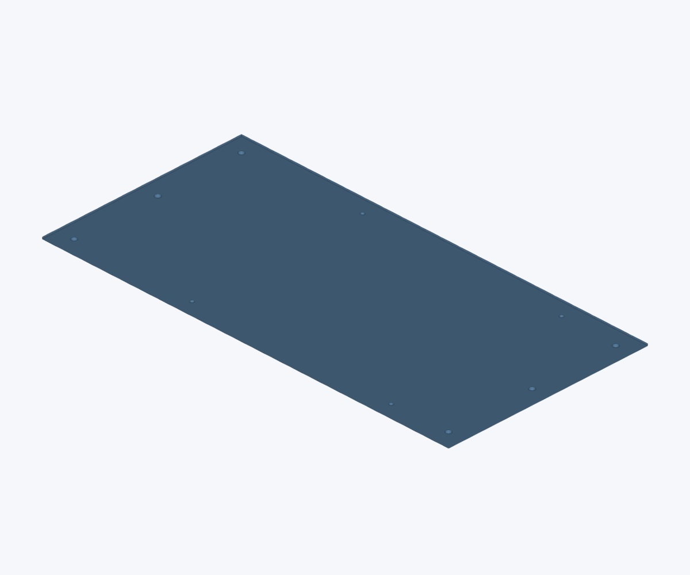
[picture p246: Microsmt-PNPv3/PNP-V3_3D_parts_2026-02-04/photos/PNPV3_3D_motherboard-mounting-plate-iso-bottom-3.jpg]
Motherboard mounting plate — bottom view 3
<td align="center"><br><sub>Bottom 3</sub></td>
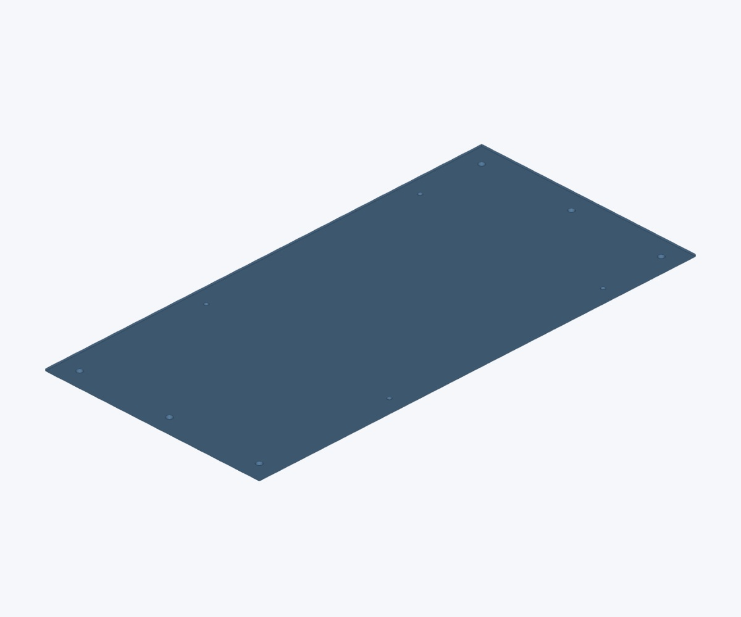
[picture p247: Microsmt-PNPv3/PNP-V3_3D_parts_2026-02-04/photos/PNPV3_3D_motherboard-mounting-plate-iso-bottom-4.jpg]
Motherboard mounting plate — bottom view 4
<td align="center"><br><sub>Bottom 4</sub></td>
</tr>
</table>

</details>

## Mounter cover

[STL](PNPV3_3D_mounter-cover.stl)

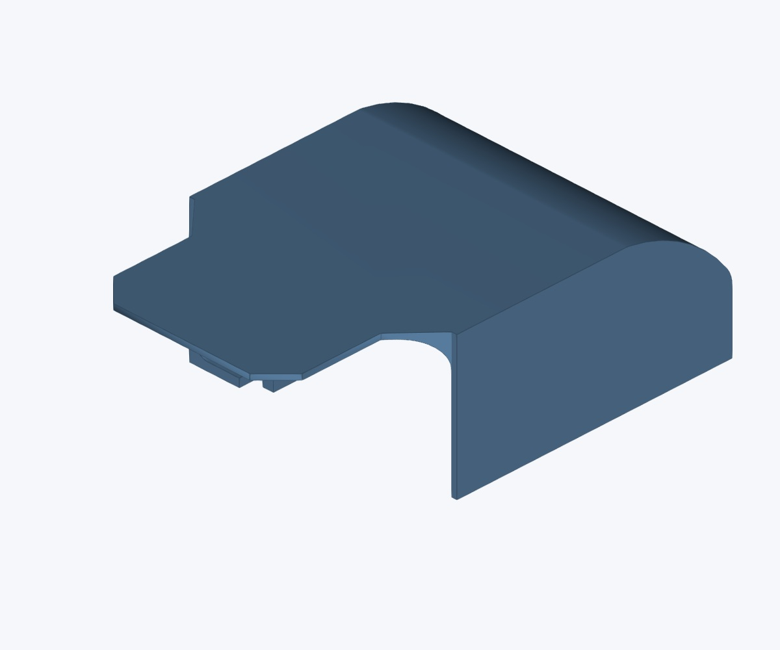
[picture p248: Microsmt-PNPv3/PNP-V3_3D_parts_2026-02-04/photos/PNPV3_3D_mounter-cover.jpg]
Mounter cover — original preview


<details>
<summary>More views</summary>

<table>
<tr>
<td align="center"><a href="photos/PNPV3_3D_mounter-cover-iso-top-1.jpg">Mounter cover — top view 1</a><br><sub>Top 1</sub></td>
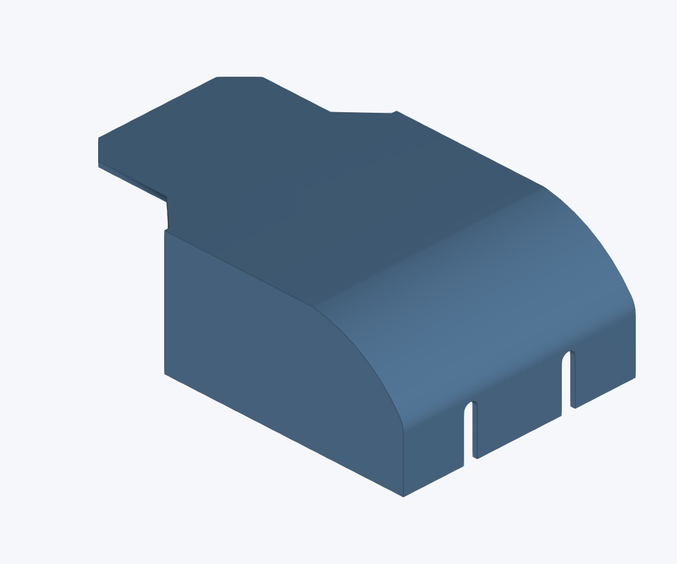
[picture p249: Microsmt-PNPv3/PNP-V3_3D_parts_2026-02-04/photos/PNPV3_3D_mounter-cover-iso-top-2.jpg]
Mounter cover — top view 2
<td align="center"><br><sub>Top 2</sub></td>
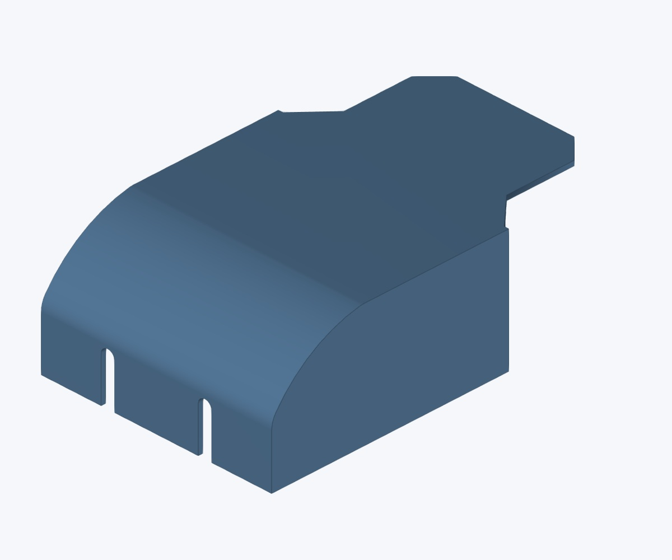
[picture p250: Microsmt-PNPv3/PNP-V3_3D_parts_2026-02-04/photos/PNPV3_3D_mounter-cover-iso-top-3.jpg]
Mounter cover — top view 3
<td align="center"><br><sub>Top 3</sub></td>
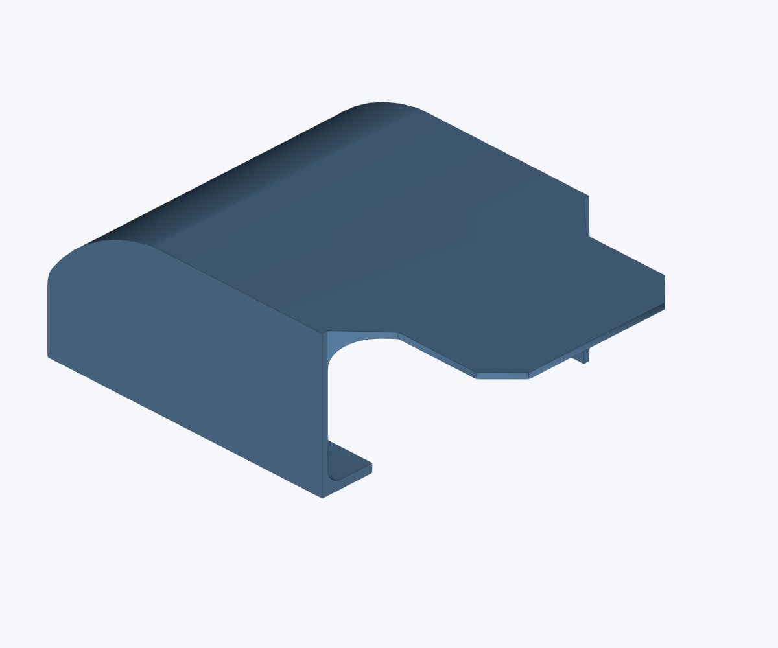
[picture p251: Microsmt-PNPv3/PNP-V3_3D_parts_2026-02-04/photos/PNPV3_3D_mounter-cover-iso-top-4.jpg]
Mounter cover — top view 4
<td align="center"><br><sub>Top 4</sub></td>
</tr>
<tr>
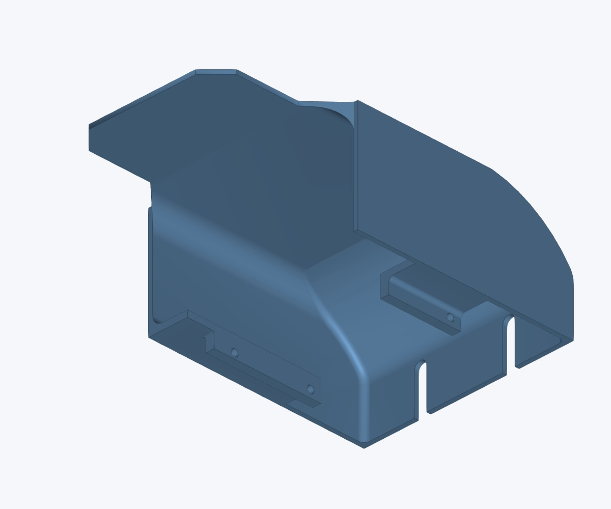
[picture p252: Microsmt-PNPv3/PNP-V3_3D_parts_2026-02-04/photos/PNPV3_3D_mounter-cover-iso-bottom-1.jpg]
Mounter cover — bottom view 1
<td align="center"><br><sub>Bottom 1</sub></td>
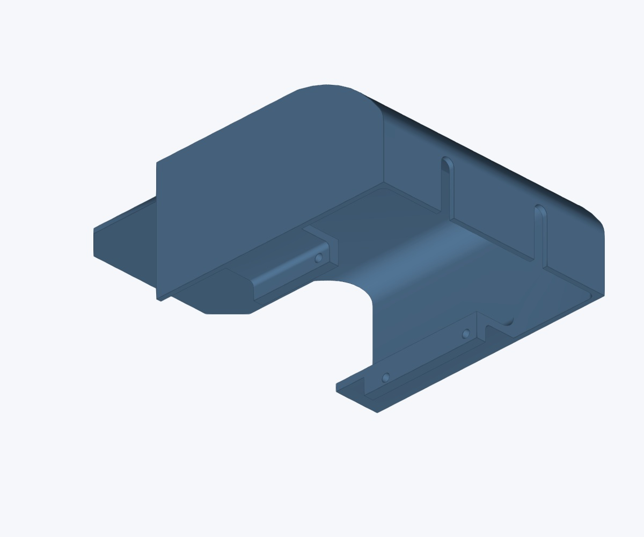
[picture p253: Microsmt-PNPv3/PNP-V3_3D_parts_2026-02-04/photos/PNPV3_3D_mounter-cover-iso-bottom-2.jpg]
Mounter cover — bottom view 2
<td align="center"><br><sub>Bottom 2</sub></td>
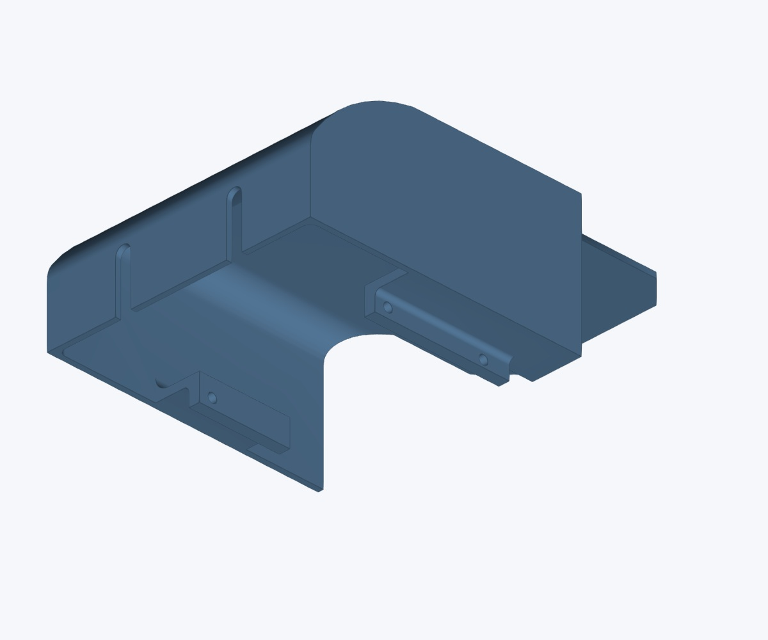
[picture p254: Microsmt-PNPv3/PNP-V3_3D_parts_2026-02-04/photos/PNPV3_3D_mounter-cover-iso-bottom-3.jpg]
Mounter cover — bottom view 3
<td align="center"><br><sub>Bottom 3</sub></td>
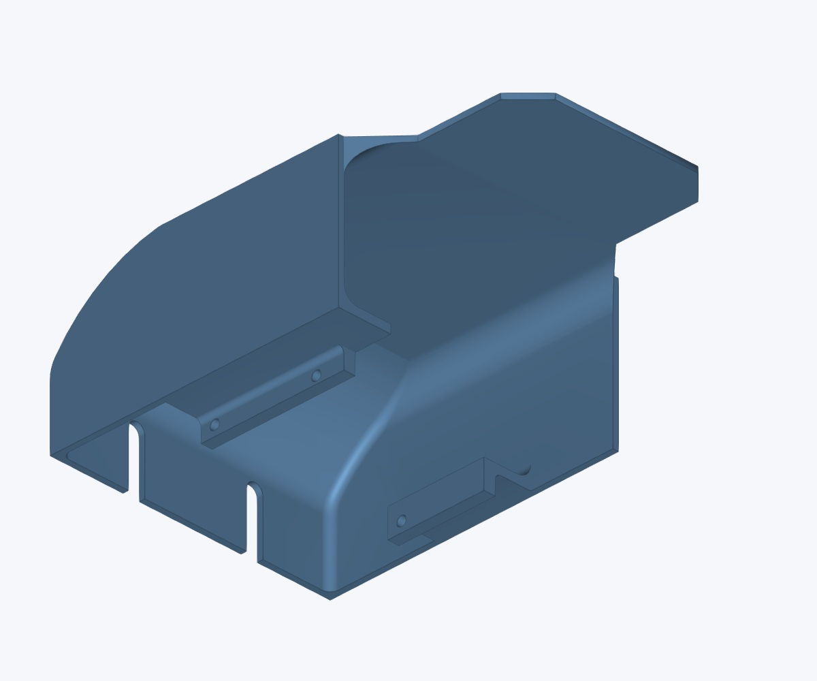
[picture p255: Microsmt-PNPv3/PNP-V3_3D_parts_2026-02-04/photos/PNPV3_3D_mounter-cover-iso-bottom-4.jpg]
Mounter cover — bottom view 4
<td align="center"><br><sub>Bottom 4</sub></td>
</tr>
</table>

</details>

## PCB bracket

[STL](PNPV3_3D_pcb-bracket.stl)

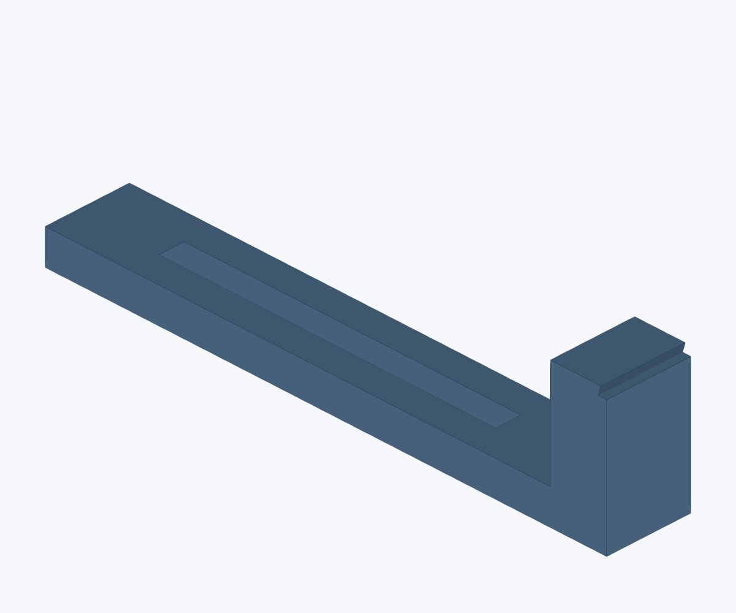
[picture p256: Microsmt-PNPv3/PNP-V3_3D_parts_2026-02-04/photos/PNPV3_3D_pcb-bracket.jpg]
Pcb bracket — original preview


<details>
<summary>More views</summary>

<table>
<tr>
<td align="center"><a href="photos/PNPV3_3D_pcb-bracket-iso-top-1.jpg">Pcb bracket — top view 1</a><br><sub>Top 1</sub></td>
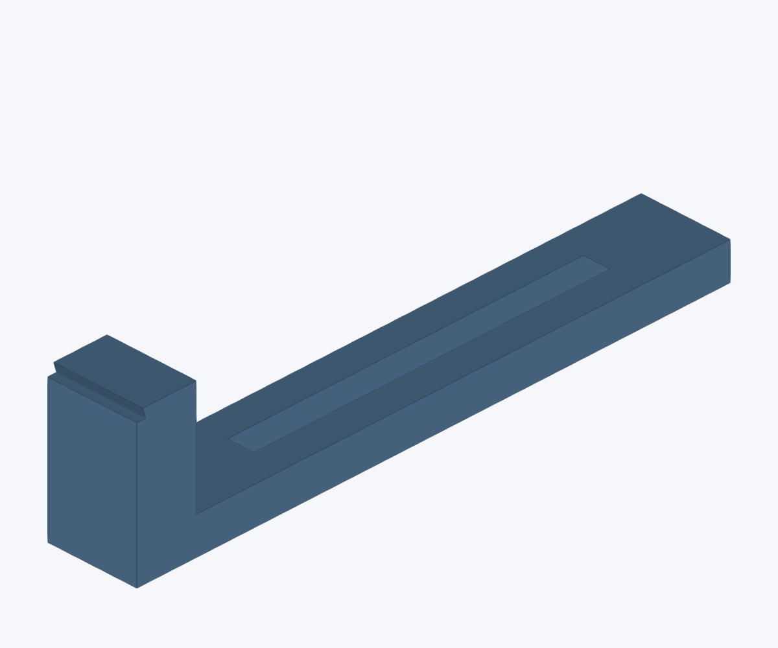
[picture p257: Microsmt-PNPv3/PNP-V3_3D_parts_2026-02-04/photos/PNPV3_3D_pcb-bracket-iso-top-2.jpg]
Pcb bracket — top view 2
<td align="center"><br><sub>Top 2</sub></td>
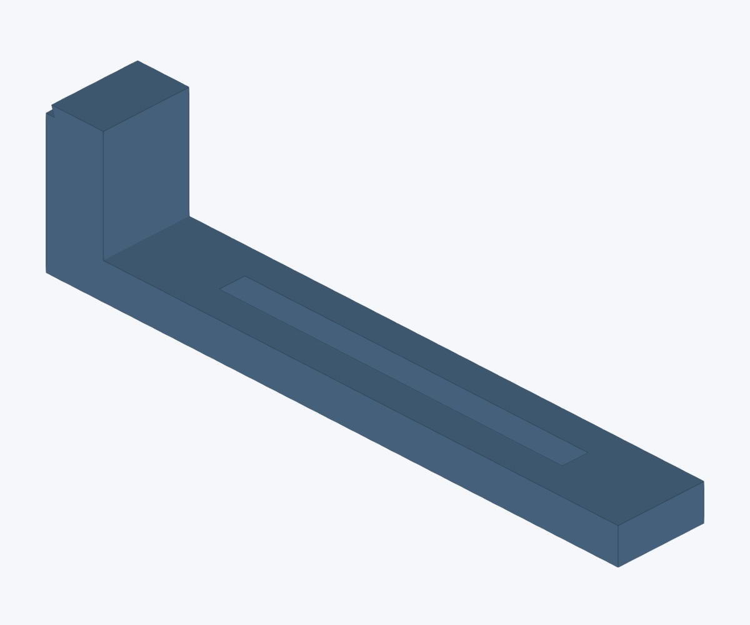
[picture p258: Microsmt-PNPv3/PNP-V3_3D_parts_2026-02-04/photos/PNPV3_3D_pcb-bracket-iso-top-3.jpg]
Pcb bracket — top view 3
<td align="center"><br><sub>Top 3</sub></td>
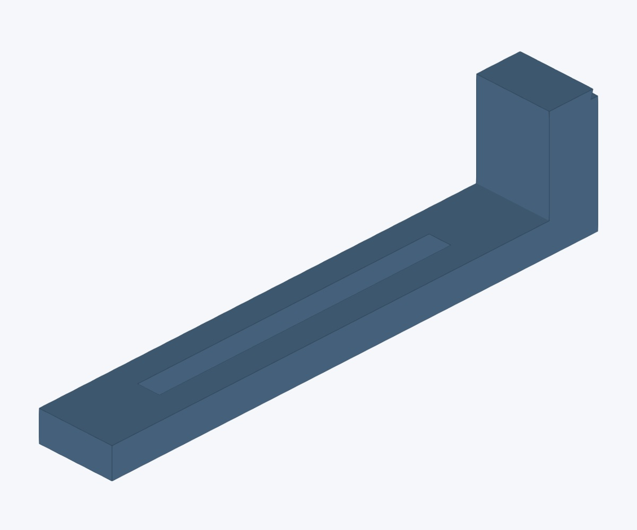
[picture p259: Microsmt-PNPv3/PNP-V3_3D_parts_2026-02-04/photos/PNPV3_3D_pcb-bracket-iso-top-4.jpg]
Pcb bracket — top view 4
<td align="center"><br><sub>Top 4</sub></td>
</tr>
<tr>
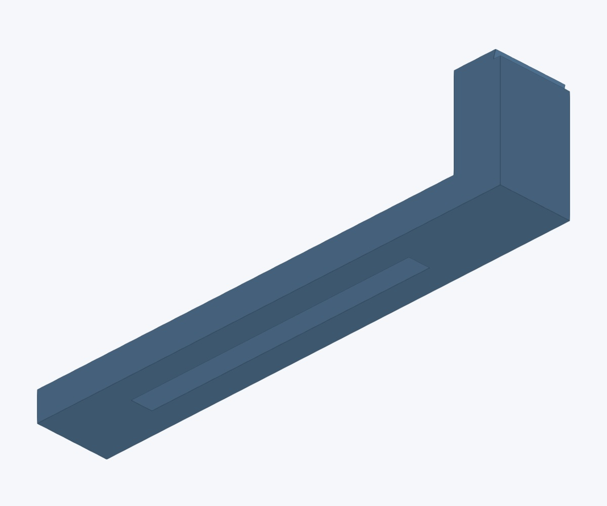
[picture p260: Microsmt-PNPv3/PNP-V3_3D_parts_2026-02-04/photos/PNPV3_3D_pcb-bracket-iso-bottom-1.jpg]
Pcb bracket — bottom view 1
<td align="center"><br><sub>Bottom 1</sub></td>
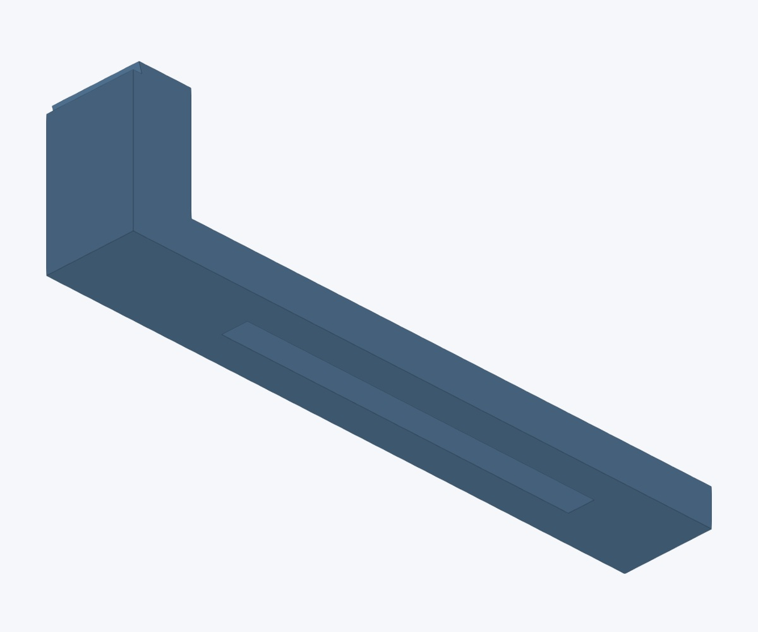
[picture p261: Microsmt-PNPv3/PNP-V3_3D_parts_2026-02-04/photos/PNPV3_3D_pcb-bracket-iso-bottom-2.jpg]
Pcb bracket — bottom view 2
<td align="center"><br><sub>Bottom 2</sub></td>
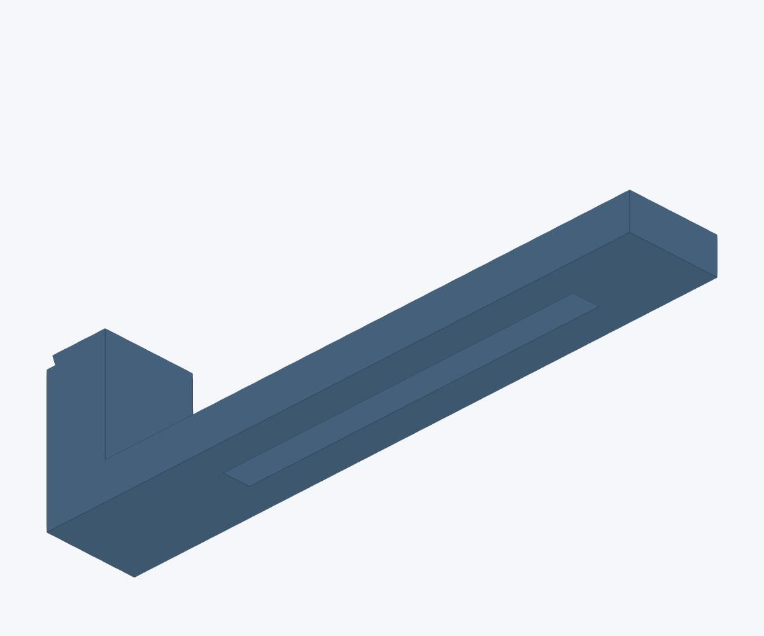
[picture p262: Microsmt-PNPv3/PNP-V3_3D_parts_2026-02-04/photos/PNPV3_3D_pcb-bracket-iso-bottom-3.jpg]
Pcb bracket — bottom view 3
<td align="center"><br><sub>Bottom 3</sub></td>
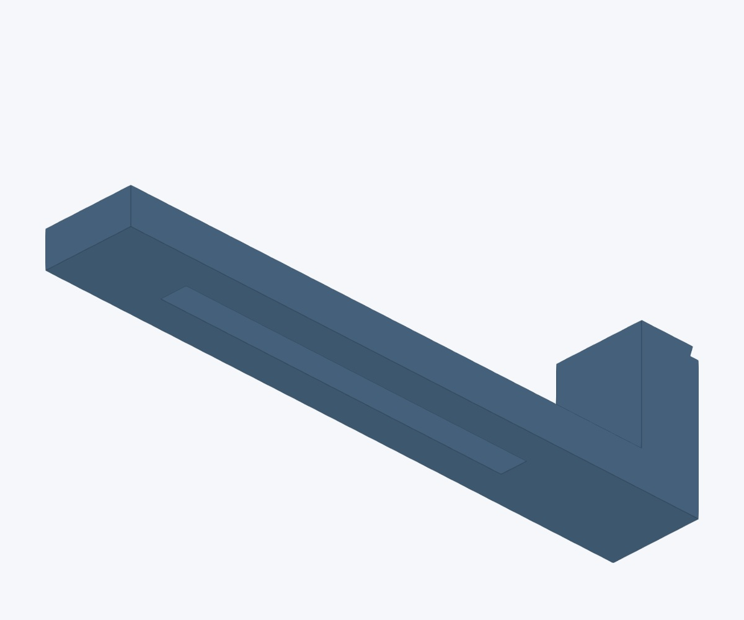
[picture p263: Microsmt-PNPv3/PNP-V3_3D_parts_2026-02-04/photos/PNPV3_3D_pcb-bracket-iso-bottom-4.jpg]
Pcb bracket — bottom view 4
<td align="center"><br><sub>Bottom 4</sub></td>
</tr>
</table>

</details>

## Power supply hook

[STL](PNPV3_3D_power-supply-hook.stl)

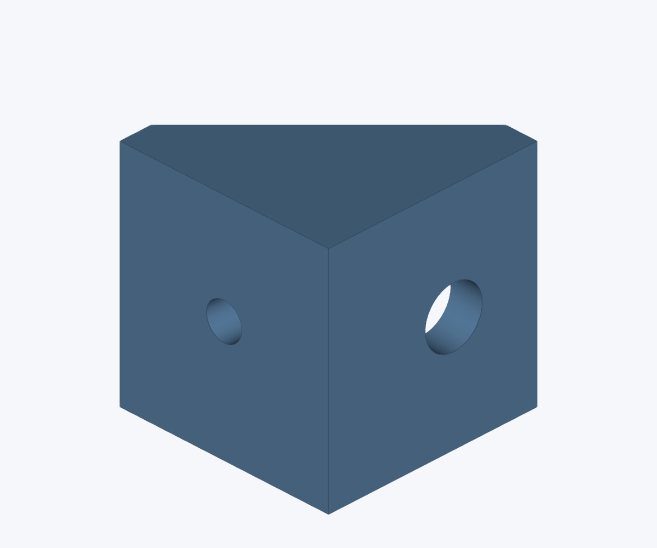
[picture p264: Microsmt-PNPv3/PNP-V3_3D_parts_2026-02-04/photos/PNPV3_3D_power-supply-hook.jpg]
Power supply hook — original preview


<details>
<summary>More views</summary>

<table>
<tr>
<td align="center"><a href="photos/PNPV3_3D_power-supply-hook-iso-top-1.jpg">Power supply hook — top view 1</a><br><sub>Top 1</sub></td>
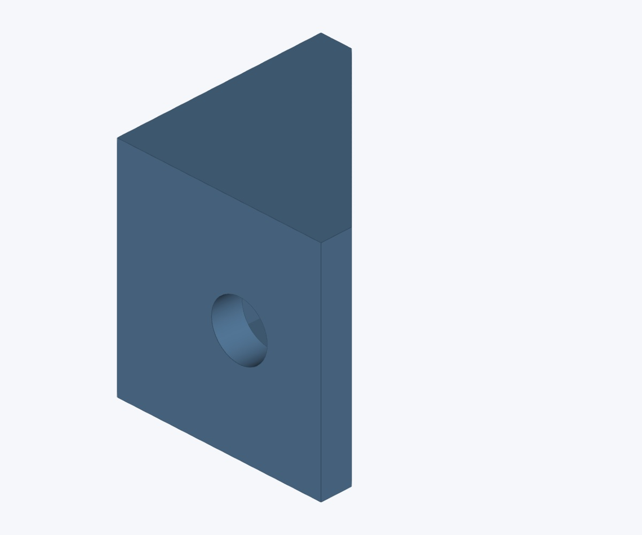
[picture p265: Microsmt-PNPv3/PNP-V3_3D_parts_2026-02-04/photos/PNPV3_3D_power-supply-hook-iso-top-2.jpg]
Power supply hook — top view 2
<td align="center"><br><sub>Top 2</sub></td>
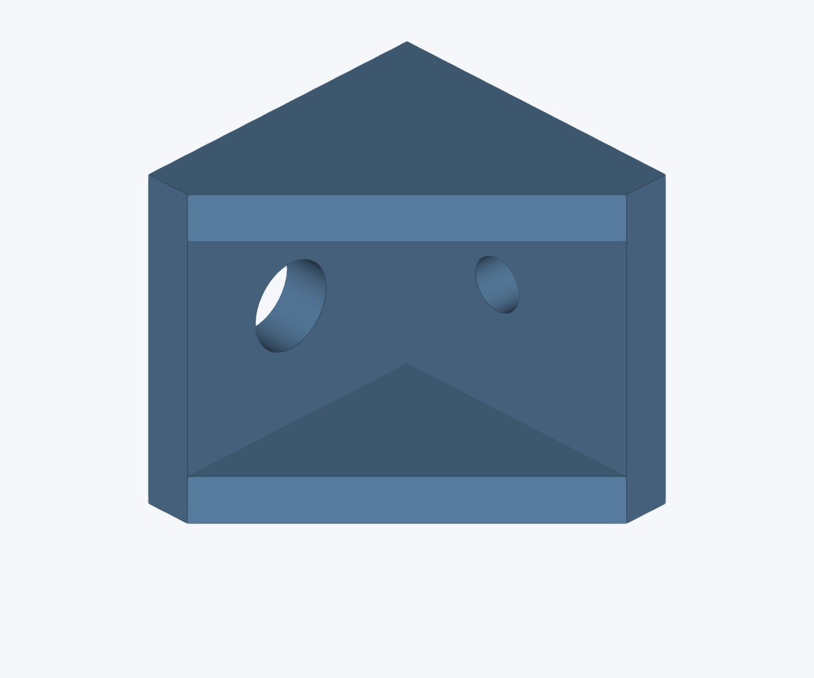
[picture p266: Microsmt-PNPv3/PNP-V3_3D_parts_2026-02-04/photos/PNPV3_3D_power-supply-hook-iso-top-3.jpg]
Power supply hook — top view 3
<td align="center"><br><sub>Top 3</sub></td>
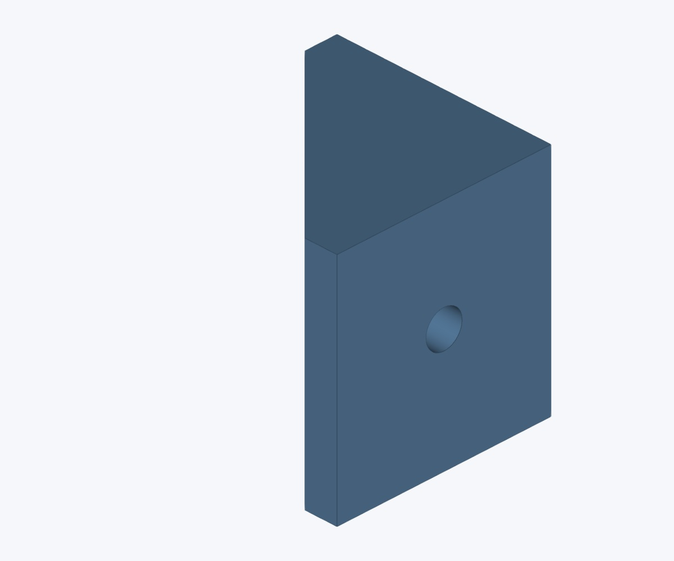
[picture p267: Microsmt-PNPv3/PNP-V3_3D_parts_2026-02-04/photos/PNPV3_3D_power-supply-hook-iso-top-4.jpg]
Power supply hook — top view 4
<td align="center"><br><sub>Top 4</sub></td>
</tr>
<tr>
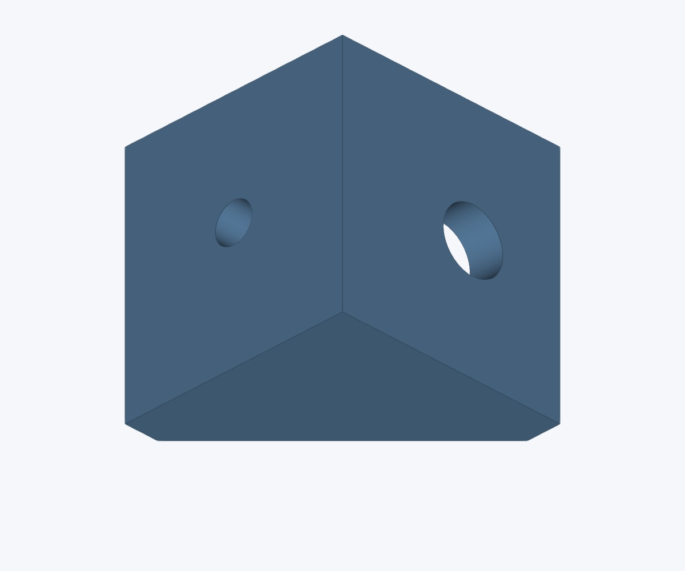
[picture p268: Microsmt-PNPv3/PNP-V3_3D_parts_2026-02-04/photos/PNPV3_3D_power-supply-hook-iso-bottom-1.jpg]
Power supply hook — bottom view 1
<td align="center"><br><sub>Bottom 1</sub></td>
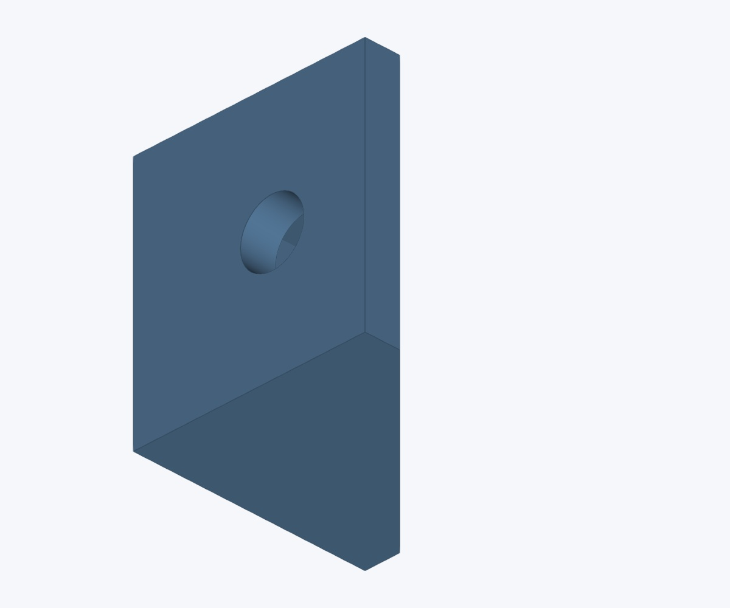
[picture p269: Microsmt-PNPv3/PNP-V3_3D_parts_2026-02-04/photos/PNPV3_3D_power-supply-hook-iso-bottom-2.jpg]
Power supply hook — bottom view 2
<td align="center"><br><sub>Bottom 2</sub></td>
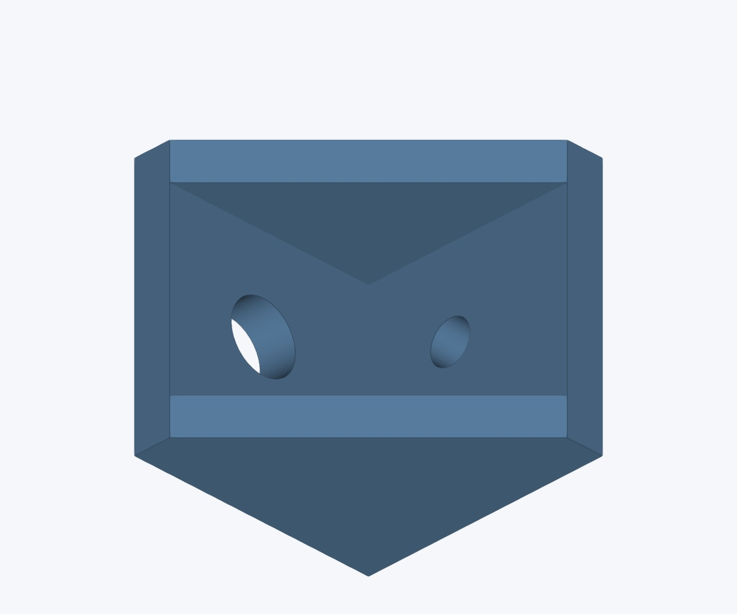
[picture p270: Microsmt-PNPv3/PNP-V3_3D_parts_2026-02-04/photos/PNPV3_3D_power-supply-hook-iso-bottom-3.jpg]
Power supply hook — bottom view 3
<td align="center"><br><sub>Bottom 3</sub></td>
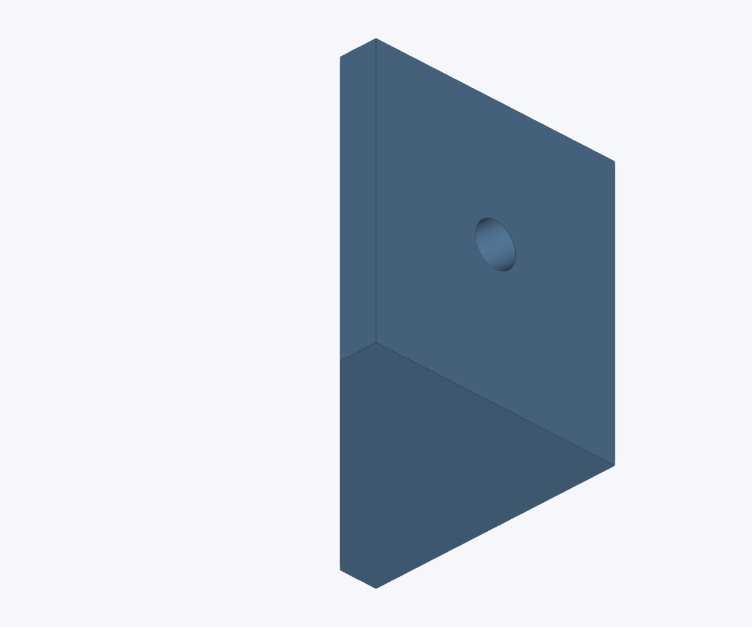
[picture p271: Microsmt-PNPv3/PNP-V3_3D_parts_2026-02-04/photos/PNPV3_3D_power-supply-hook-iso-bottom-4.jpg]
Power supply hook — bottom view 4
<td align="center"><br><sub>Bottom 4</sub></td>
</tr>
</table>

</details>

## Pump retainer

[STEP](PNPV3_3D_pump-retainer.step) · [STL](PNPV3_3D_pump-retainer.stl)

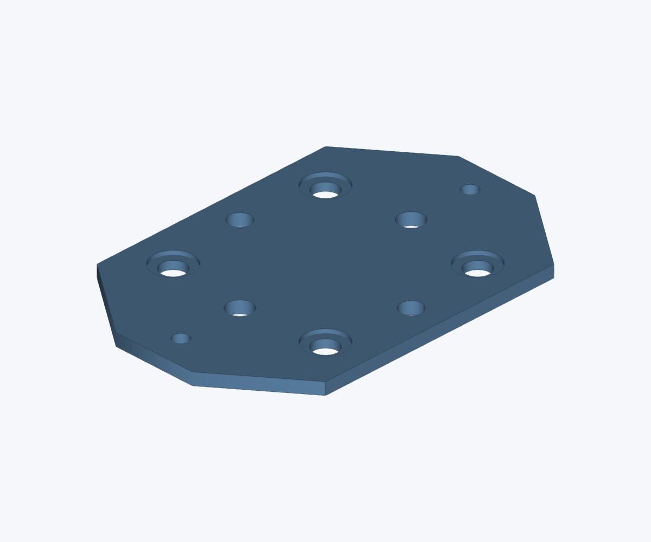
[picture p272: Microsmt-PNPv3/PNP-V3_3D_parts_2026-02-04/photos/PNPV3_3D_pump-retainer.jpg]
Pump retainer — original preview


<details>
<summary>More views</summary>

<table>
<tr>
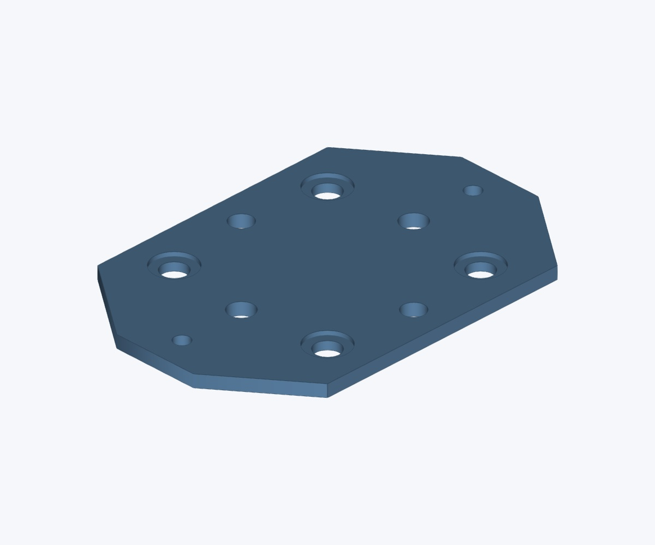
[picture p273: Microsmt-PNPv3/PNP-V3_3D_parts_2026-02-04/photos/PNPV3_3D_pump-retainer-iso-top-1.jpg]
Pump retainer — top view 1
<td align="center"><br><sub>Top 1</sub></td>
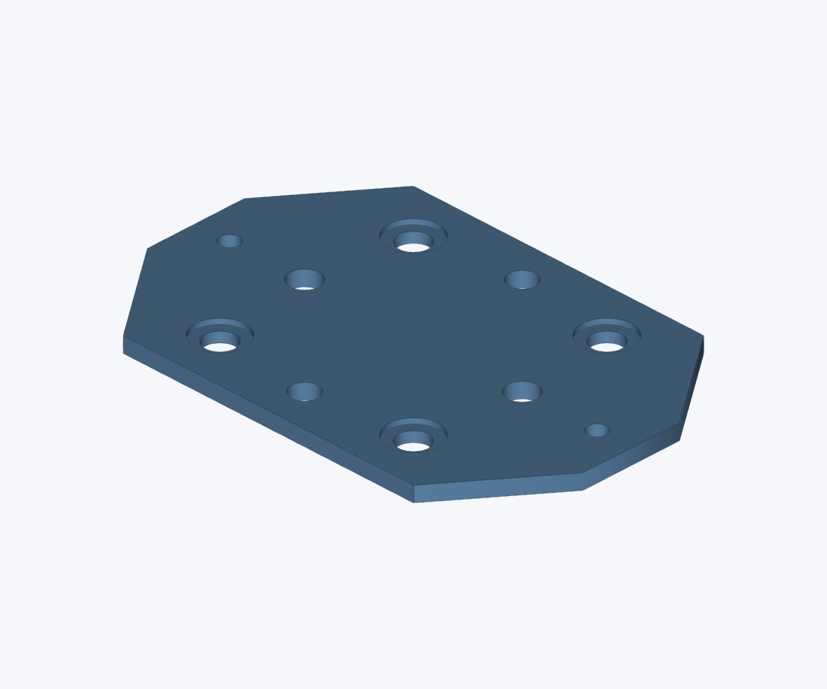
[picture p274: Microsmt-PNPv3/PNP-V3_3D_parts_2026-02-04/photos/PNPV3_3D_pump-retainer-iso-top-2.jpg]
Pump retainer — top view 2
<td align="center"><br><sub>Top 2</sub></td>
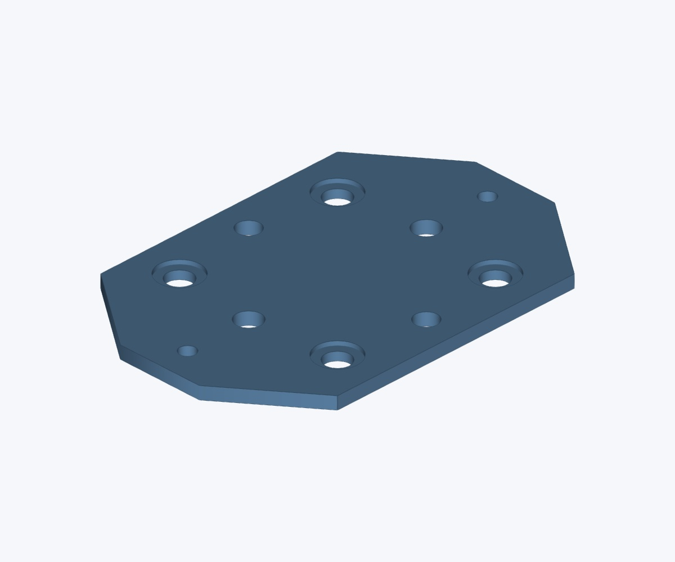
[picture p275: Microsmt-PNPv3/PNP-V3_3D_parts_2026-02-04/photos/PNPV3_3D_pump-retainer-iso-top-3.jpg]
Pump retainer — top view 3
<td align="center"><br><sub>Top 3</sub></td>
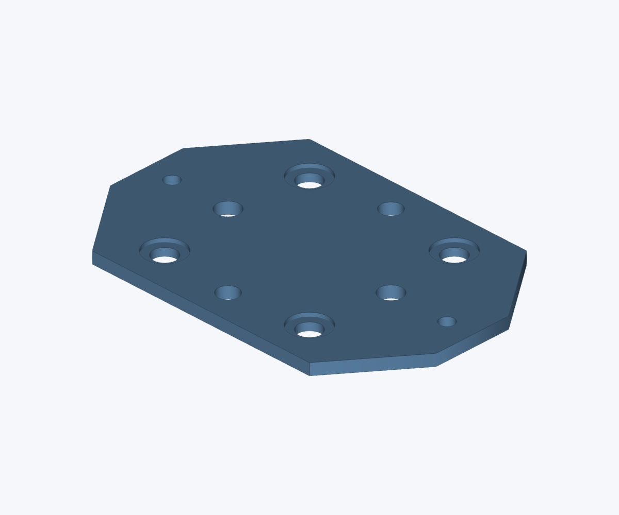
[picture p276: Microsmt-PNPv3/PNP-V3_3D_parts_2026-02-04/photos/PNPV3_3D_pump-retainer-iso-top-4.jpg]
Pump retainer — top view 4
<td align="center"><br><sub>Top 4</sub></td>
</tr>
<tr>
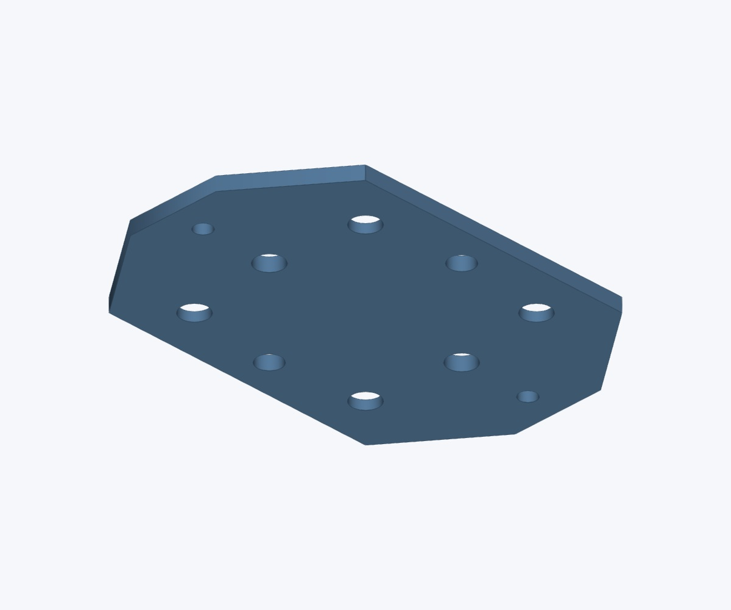
[picture p277: Microsmt-PNPv3/PNP-V3_3D_parts_2026-02-04/photos/PNPV3_3D_pump-retainer-iso-bottom-1.jpg]
Pump retainer — bottom view 1
<td align="center"><br><sub>Bottom 1</sub></td>
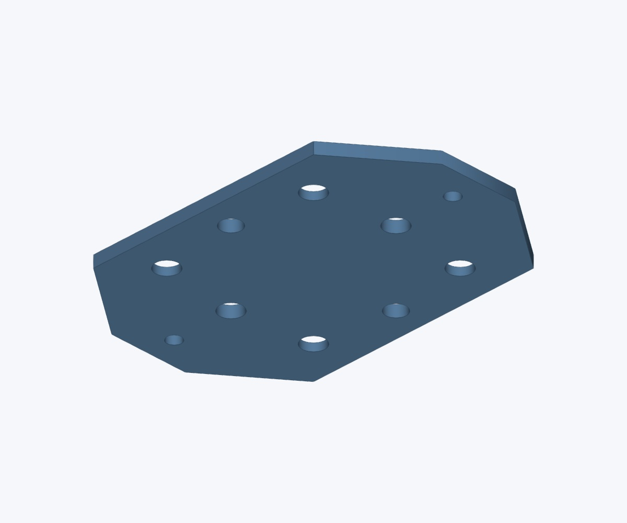
[picture p278: Microsmt-PNPv3/PNP-V3_3D_parts_2026-02-04/photos/PNPV3_3D_pump-retainer-iso-bottom-2.jpg]
Pump retainer — bottom view 2
<td align="center"><br><sub>Bottom 2</sub></td>
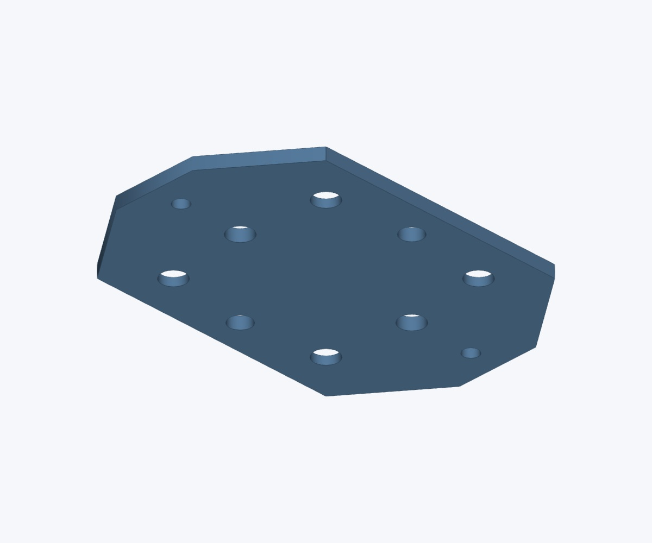
[picture p279: Microsmt-PNPv3/PNP-V3_3D_parts_2026-02-04/photos/PNPV3_3D_pump-retainer-iso-bottom-3.jpg]
Pump retainer — bottom view 3
<td align="center"><br><sub>Bottom 3</sub></td>
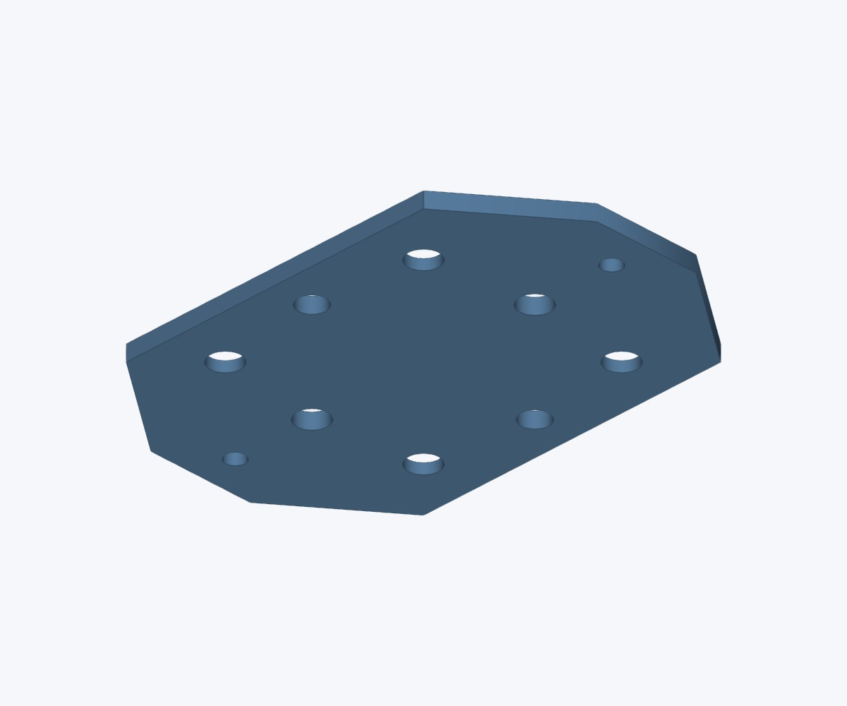
[picture p280: Microsmt-PNPv3/PNP-V3_3D_parts_2026-02-04/photos/PNPV3_3D_pump-retainer-iso-bottom-4.jpg]
Pump retainer — bottom view 4
<td align="center"><br><sub>Bottom 4</sub></td>
</tr>
</table>

</details>

## Synchronous wheel limit

[STL](PNPV3_3D_synchronous-wheel-limit.stl)

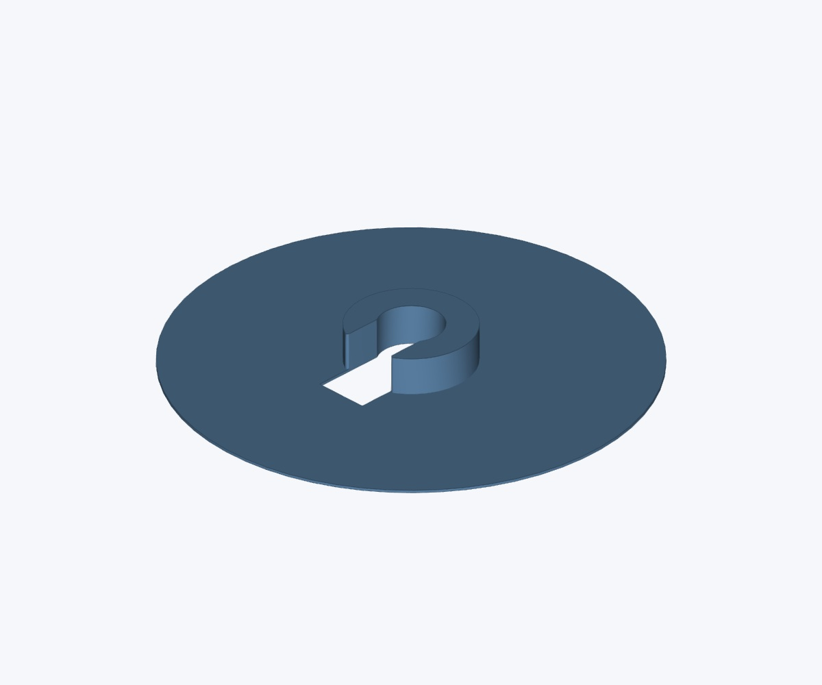
[picture p281: Microsmt-PNPv3/PNP-V3_3D_parts_2026-02-04/photos/PNPV3_3D_synchronous-wheel-limit.jpg]
Synchronous wheel limit — original preview


<details>
<summary>More views</summary>

<table>
<tr>
<td align="center"><a href="photos/PNPV3_3D_synchronous-wheel-limit-iso-top-1.jpg">Synchronous wheel limit — top view 1</a><br><sub>Top 1</sub></td>
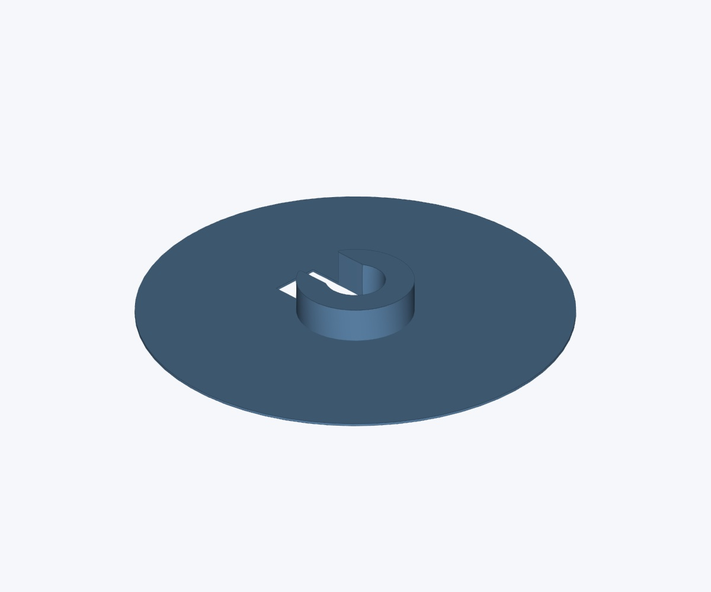
[picture p282: Microsmt-PNPv3/PNP-V3_3D_parts_2026-02-04/photos/PNPV3_3D_synchronous-wheel-limit-iso-top-2.jpg]
Synchronous wheel limit — top view 2
<td align="center"><br><sub>Top 2</sub></td>
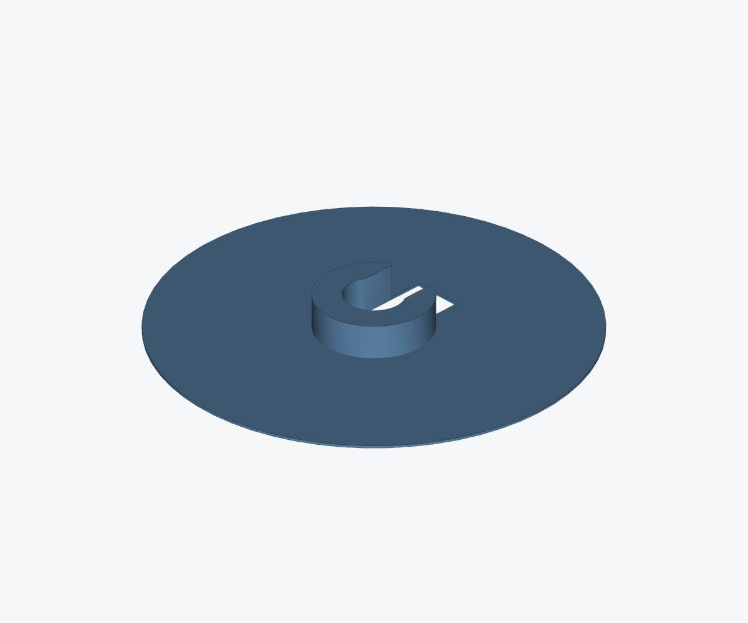
[picture p283: Microsmt-PNPv3/PNP-V3_3D_parts_2026-02-04/photos/PNPV3_3D_synchronous-wheel-limit-iso-top-3.jpg]
Synchronous wheel limit — top view 3
<td align="center"><br><sub>Top 3</sub></td>
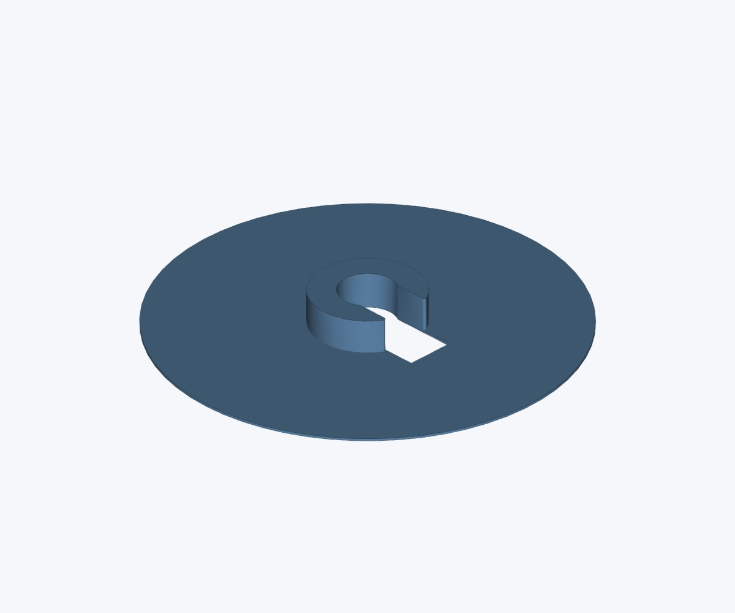
[picture p284: Microsmt-PNPv3/PNP-V3_3D_parts_2026-02-04/photos/PNPV3_3D_synchronous-wheel-limit-iso-top-4.jpg]
Synchronous wheel limit — top view 4
<td align="center"><br><sub>Top 4</sub></td>
</tr>
<tr>
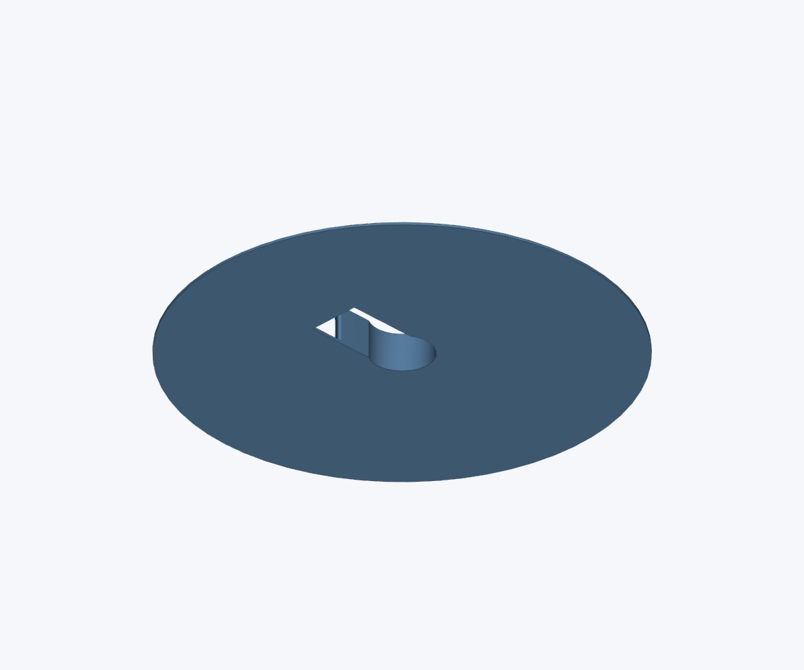
[picture p285: Microsmt-PNPv3/PNP-V3_3D_parts_2026-02-04/photos/PNPV3_3D_synchronous-wheel-limit-iso-bottom-1.jpg]
Synchronous wheel limit — bottom view 1
<td align="center"><br><sub>Bottom 1</sub></td>
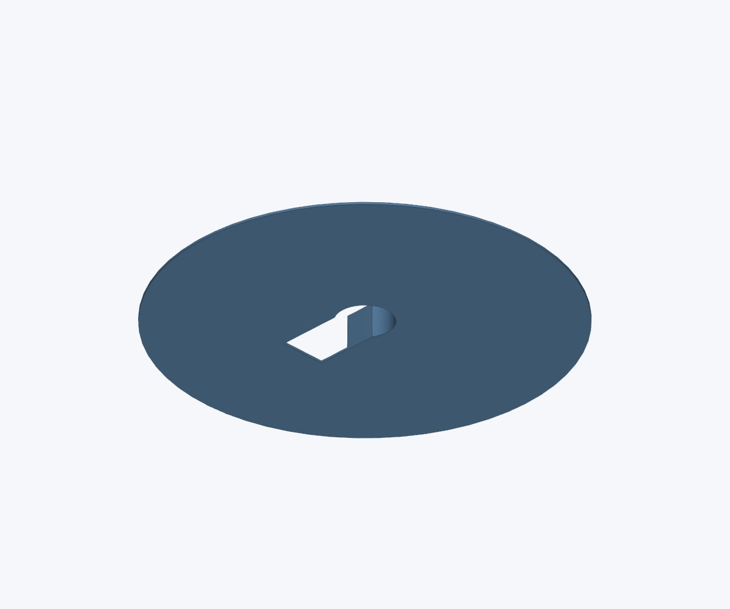
[picture p286: Microsmt-PNPv3/PNP-V3_3D_parts_2026-02-04/photos/PNPV3_3D_synchronous-wheel-limit-iso-bottom-2.jpg]
Synchronous wheel limit — bottom view 2
<td align="center"><br><sub>Bottom 2</sub></td>
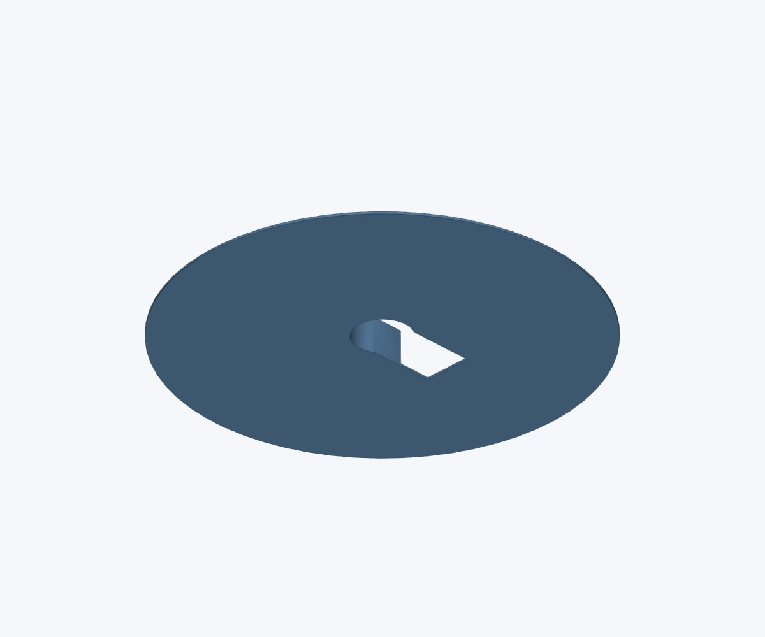
[picture p287: Microsmt-PNPv3/PNP-V3_3D_parts_2026-02-04/photos/PNPV3_3D_synchronous-wheel-limit-iso-bottom-3.jpg]
Synchronous wheel limit — bottom view 3
<td align="center"><br><sub>Bottom 3</sub></td>
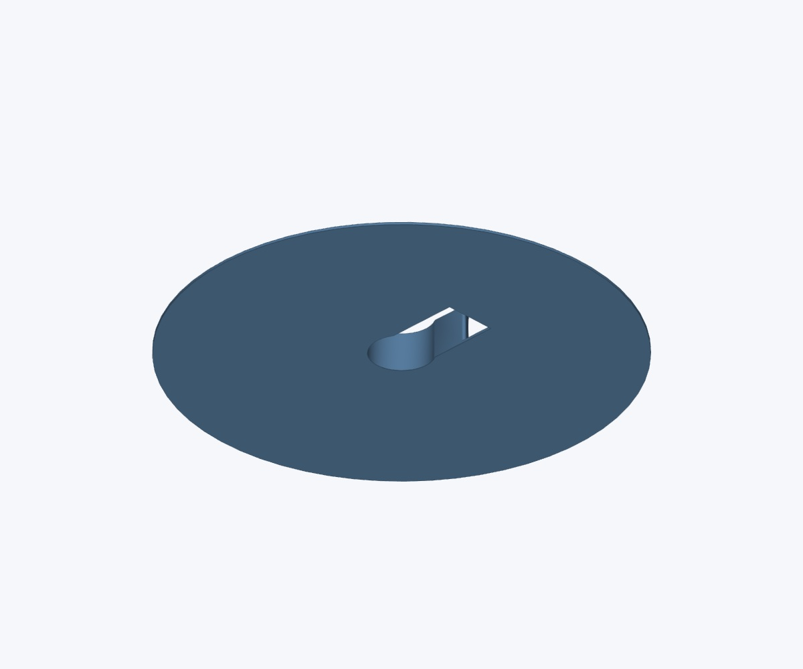
[picture p288: Microsmt-PNPv3/PNP-V3_3D_parts_2026-02-04/photos/PNPV3_3D_synchronous-wheel-limit-iso-bottom-4.jpg]
Synchronous wheel limit — bottom view 4
<td align="center"><br><sub>Bottom 4</sub></td>
</tr>
</table>

</details>

## Top camera mounting plate

[STL](PNPV3_3D_top-camera-mounting-plate.stl)

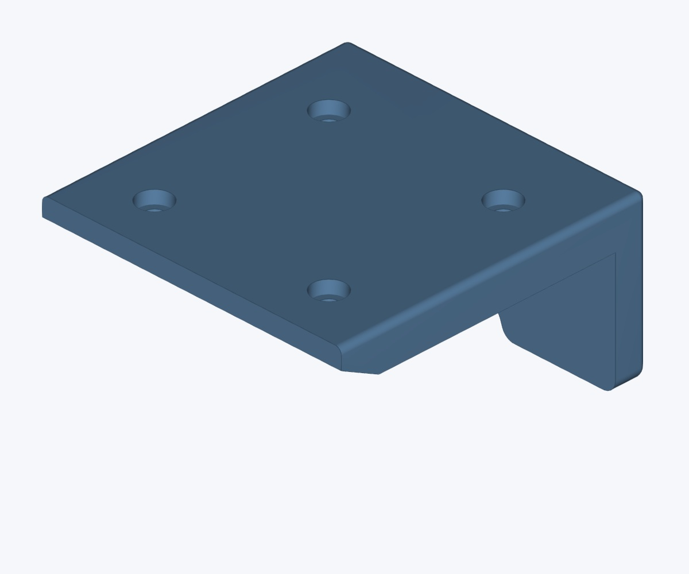
[picture p289: Microsmt-PNPv3/PNP-V3_3D_parts_2026-02-04/photos/PNPV3_3D_top-camera-mounting-plate.jpg]
Top camera mounting plate — original preview


<details>
<summary>More views</summary>

<table>
<tr>
<td align="center"><a href="photos/PNPV3_3D_top-camera-mounting-plate-iso-top-1.jpg">Top camera mounting plate — top view 1</a><br><sub>Top 1</sub></td>
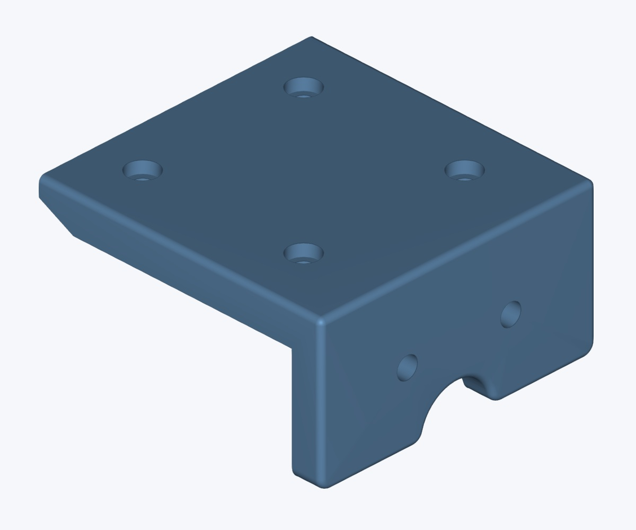
[picture p290: Microsmt-PNPv3/PNP-V3_3D_parts_2026-02-04/photos/PNPV3_3D_top-camera-mounting-plate-iso-top-2.jpg]
Top camera mounting plate — top view 2
<td align="center"><br><sub>Top 2</sub></td>
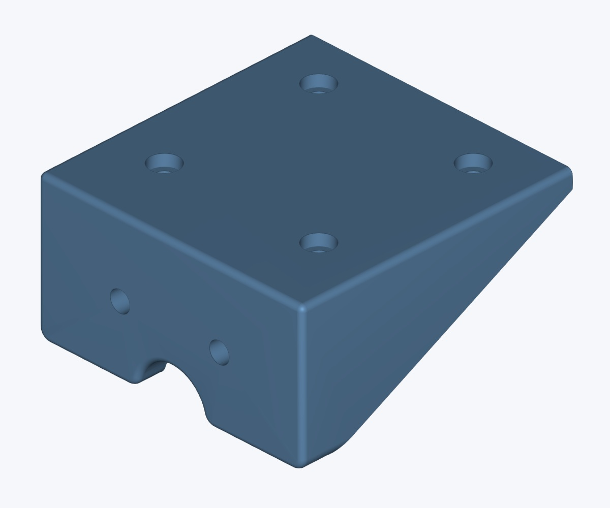
[picture p291: Microsmt-PNPv3/PNP-V3_3D_parts_2026-02-04/photos/PNPV3_3D_top-camera-mounting-plate-iso-top-3.jpg]
Top camera mounting plate — top view 3
<td align="center"><br><sub>Top 3</sub></td>
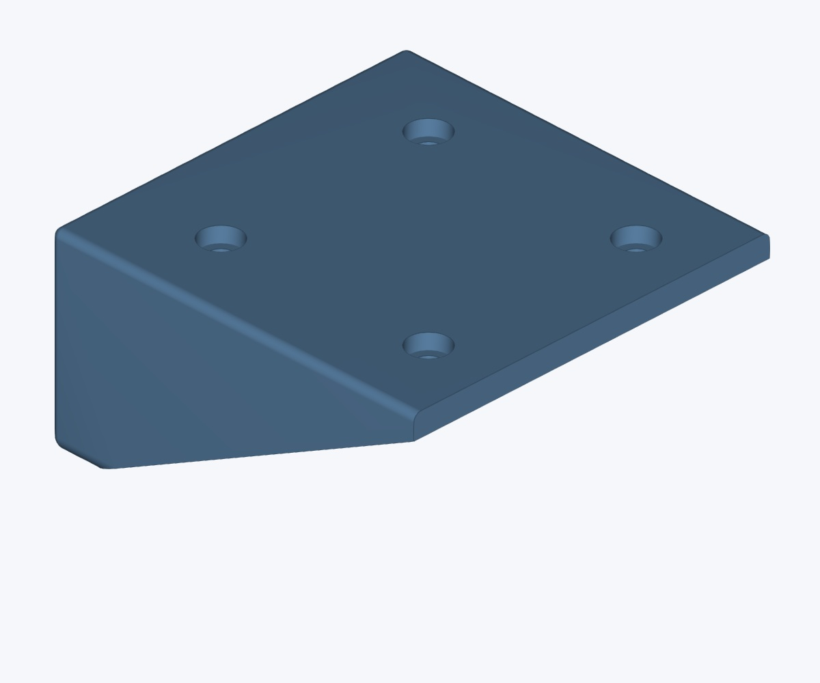
[picture p292: Microsmt-PNPv3/PNP-V3_3D_parts_2026-02-04/photos/PNPV3_3D_top-camera-mounting-plate-iso-top-4.jpg]
Top camera mounting plate — top view 4
<td align="center"><br><sub>Top 4</sub></td>
</tr>
<tr>
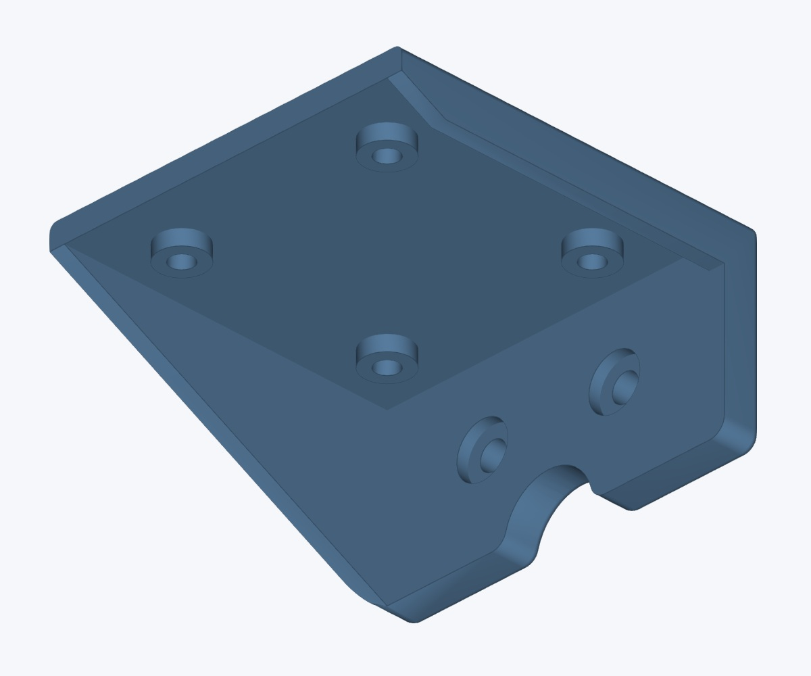
[picture p293: Microsmt-PNPv3/PNP-V3_3D_parts_2026-02-04/photos/PNPV3_3D_top-camera-mounting-plate-iso-bottom-1.jpg]
Top camera mounting plate — bottom view 1
<td align="center"><br><sub>Bottom 1</sub></td>
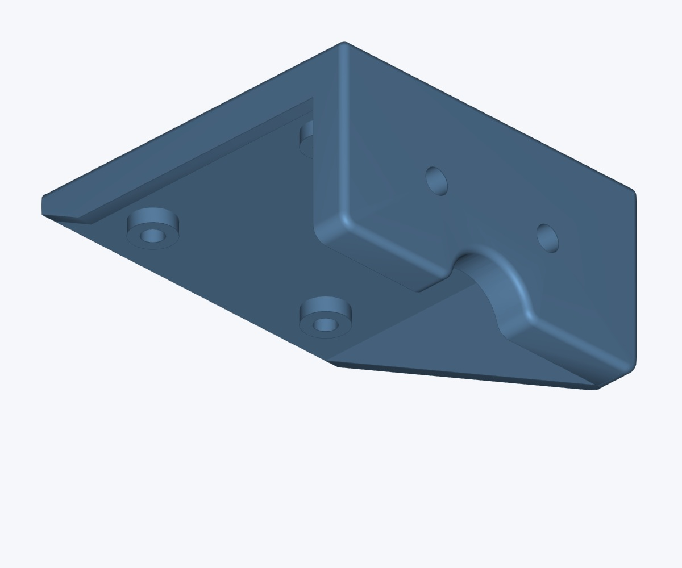
[picture p294: Microsmt-PNPv3/PNP-V3_3D_parts_2026-02-04/photos/PNPV3_3D_top-camera-mounting-plate-iso-bottom-2.jpg]
Top camera mounting plate — bottom view 2
<td align="center"><br><sub>Bottom 2</sub></td>
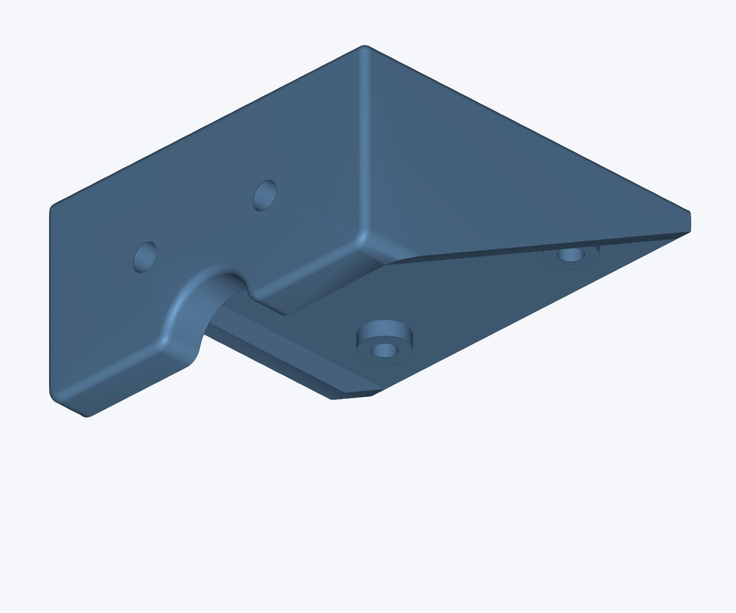
[picture p295: Microsmt-PNPv3/PNP-V3_3D_parts_2026-02-04/photos/PNPV3_3D_top-camera-mounting-plate-iso-bottom-3.jpg]
Top camera mounting plate — bottom view 3
<td align="center"><br><sub>Bottom 3</sub></td>
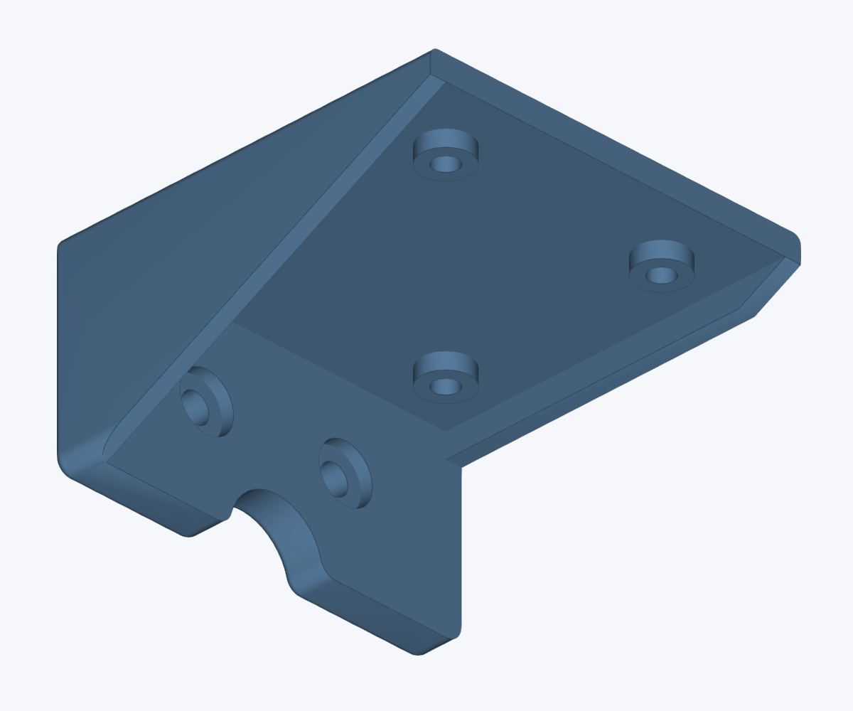
[picture p296: Microsmt-PNPv3/PNP-V3_3D_parts_2026-02-04/photos/PNPV3_3D_top-camera-mounting-plate-iso-bottom-4.jpg]
Top camera mounting plate — bottom view 4
<td align="center"><br><sub>Bottom 4</sub></td>
</tr>
</table>

</details>

## Vertical detection board

[STL](PNPV3_3D_vertical-detection-board.stl)

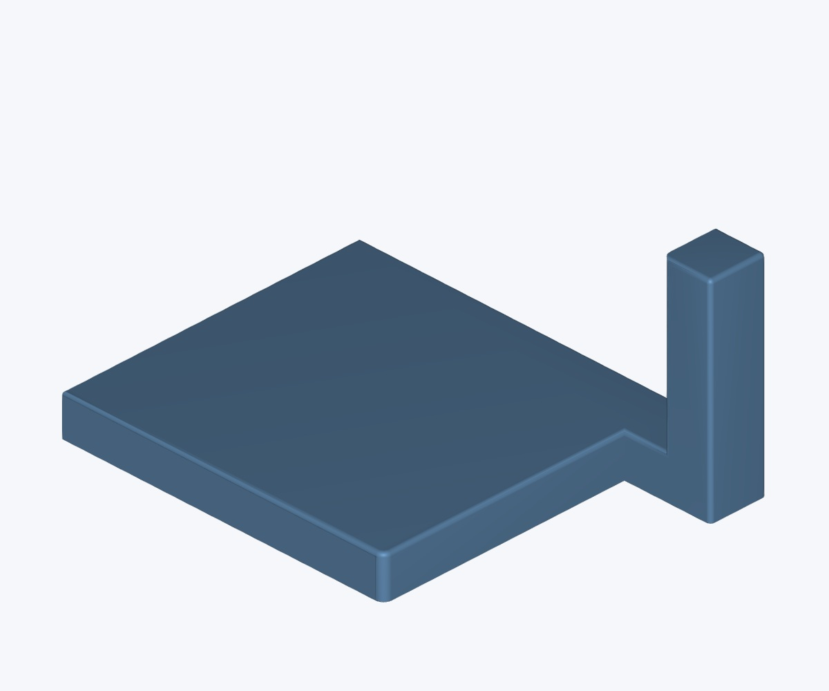
[picture p297: Microsmt-PNPv3/PNP-V3_3D_parts_2026-02-04/photos/PNPV3_3D_vertical-detection-board.jpg]
Vertical detection board — original preview


<details>
<summary>More views</summary>

<table>
<tr>
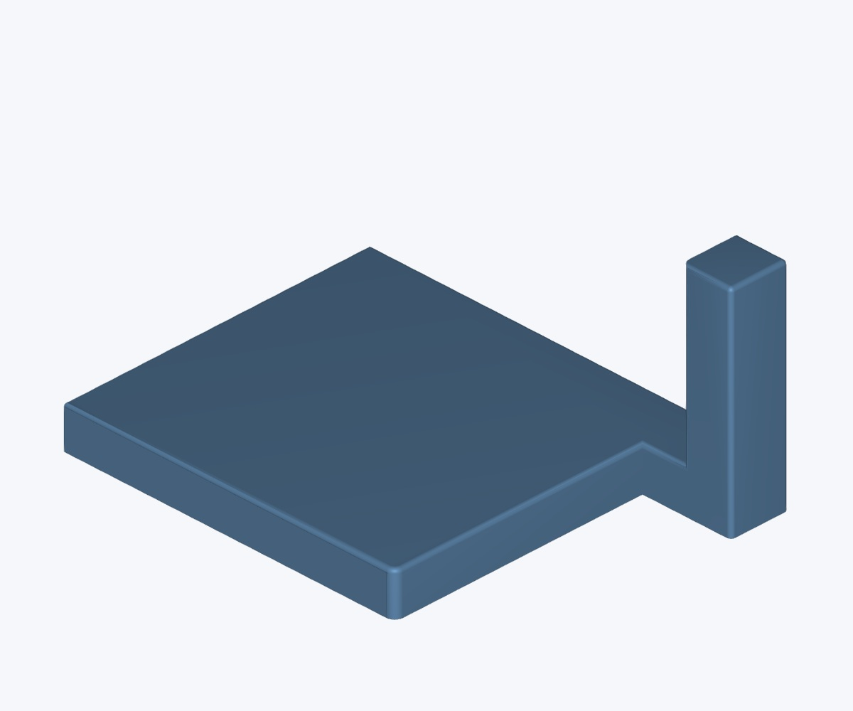
[picture p298: Microsmt-PNPv3/PNP-V3_3D_parts_2026-02-04/photos/PNPV3_3D_vertical-detection-board-iso-top-1.jpg]
Vertical detection board — top view 1
<td align="center"><br><sub>Top 1</sub></td>
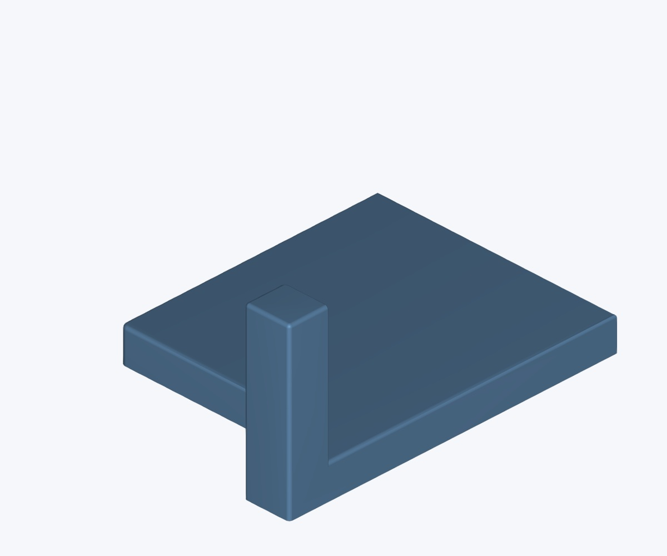
[picture p299: Microsmt-PNPv3/PNP-V3_3D_parts_2026-02-04/photos/PNPV3_3D_vertical-detection-board-iso-top-2.jpg]
Vertical detection board — top view 2
<td align="center"><br><sub>Top 2</sub></td>
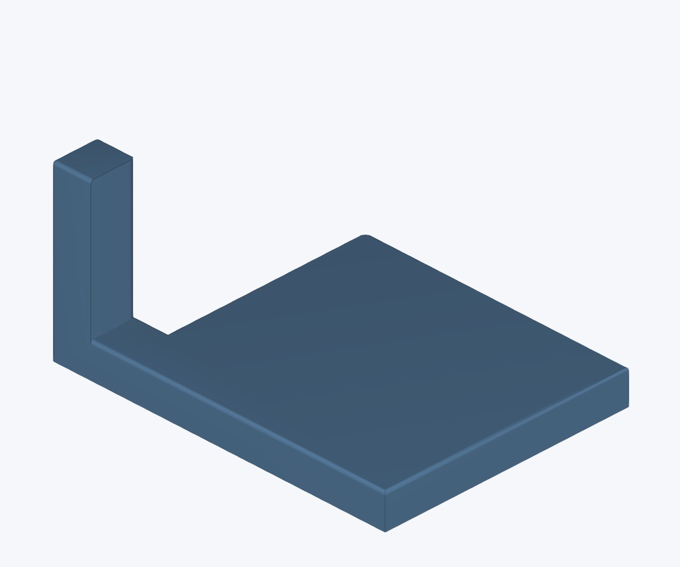
[picture p300: Microsmt-PNPv3/PNP-V3_3D_parts_2026-02-04/photos/PNPV3_3D_vertical-detection-board-iso-top-3.jpg]
Vertical detection board — top view 3
<td align="center"><br><sub>Top 3</sub></td>
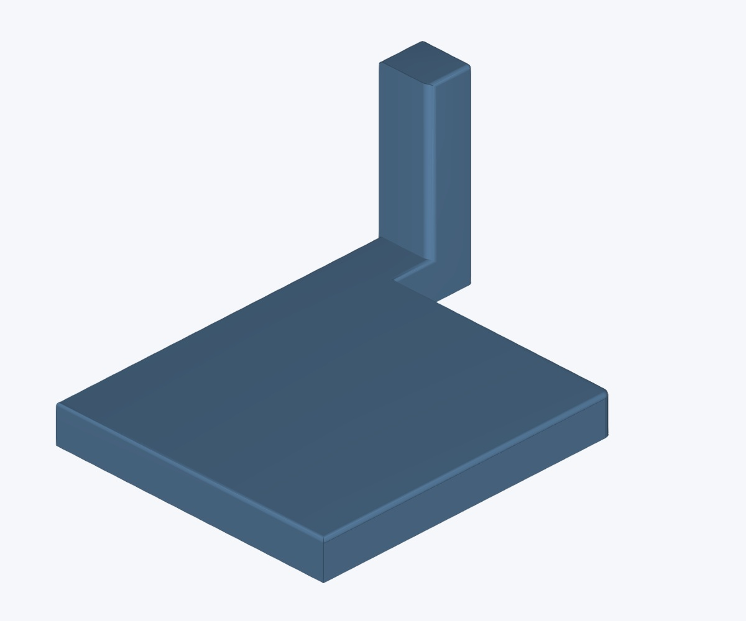
[picture p301: Microsmt-PNPv3/PNP-V3_3D_parts_2026-02-04/photos/PNPV3_3D_vertical-detection-board-iso-top-4.jpg]
Vertical detection board — top view 4
<td align="center"><br><sub>Top 4</sub></td>
</tr>
<tr>
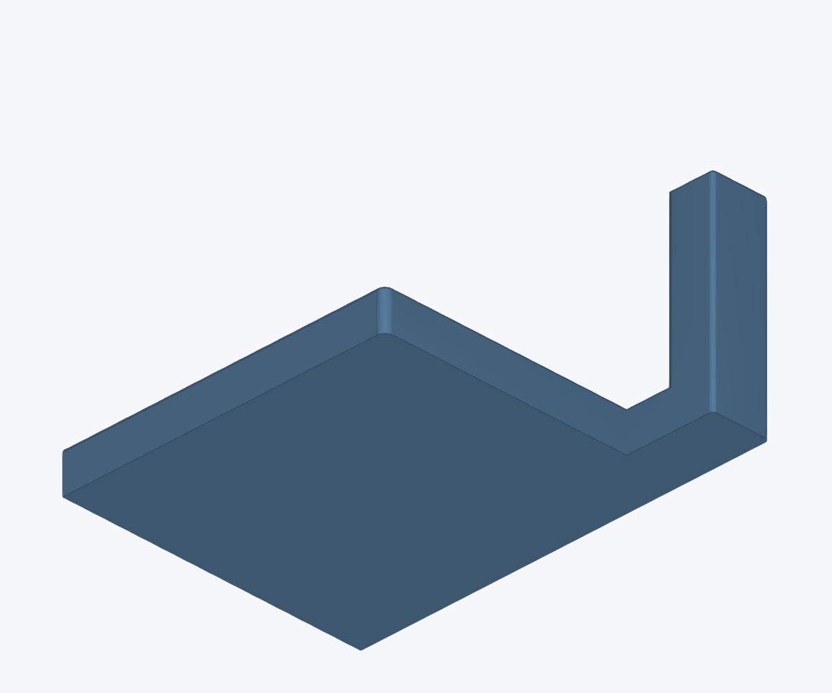
[picture p302: Microsmt-PNPv3/PNP-V3_3D_parts_2026-02-04/photos/PNPV3_3D_vertical-detection-board-iso-bottom-1.jpg]
Vertical detection board — bottom view 1
<td align="center"><br><sub>Bottom 1</sub></td>
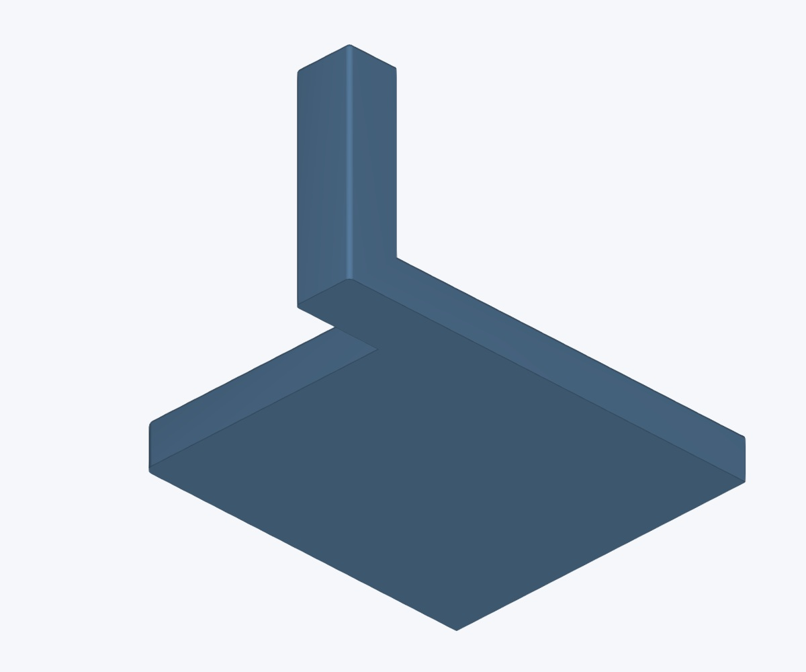
[picture p303: Microsmt-PNPv3/PNP-V3_3D_parts_2026-02-04/photos/PNPV3_3D_vertical-detection-board-iso-bottom-2.jpg]
Vertical detection board — bottom view 2
<td align="center"><br><sub>Bottom 2</sub></td>
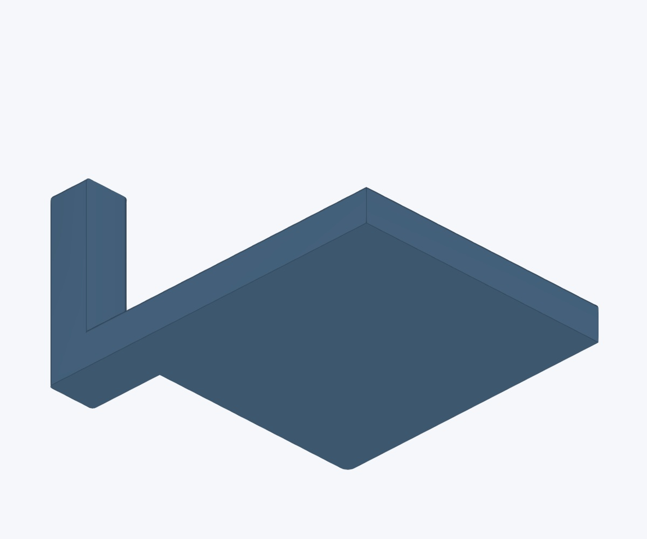
[picture p304: Microsmt-PNPv3/PNP-V3_3D_parts_2026-02-04/photos/PNPV3_3D_vertical-detection-board-iso-bottom-3.jpg]
Vertical detection board — bottom view 3
<td align="center"><br><sub>Bottom 3</sub></td>
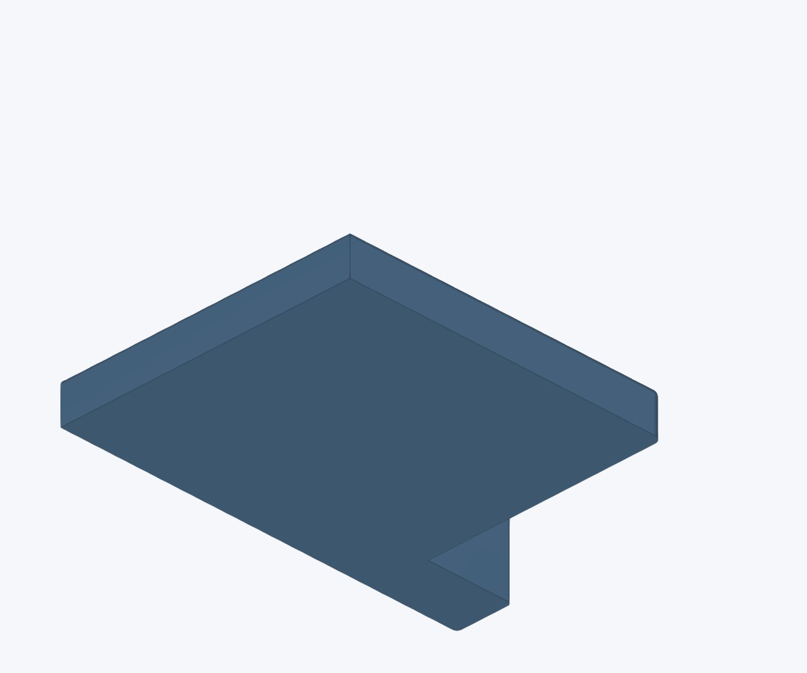
[picture p305: Microsmt-PNPv3/PNP-V3_3D_parts_2026-02-04/photos/PNPV3_3D_vertical-detection-board-iso-bottom-4.jpg]
Vertical detection board — bottom view 4
<td align="center"><br><sub>Bottom 4</sub></td>
</tr>
</table>

</details>

## X-axis anti-collision

[STL](PNPV3_3D_x-axis-anti-collision.stl)

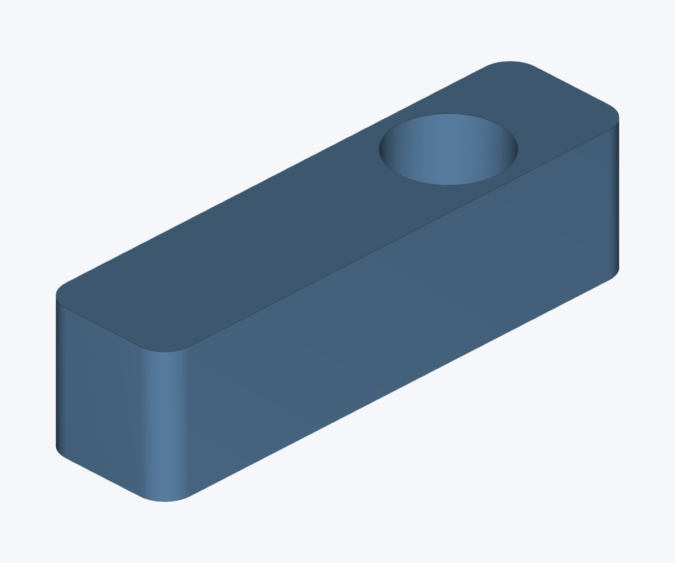
[picture p306: Microsmt-PNPv3/PNP-V3_3D_parts_2026-02-04/photos/PNPV3_3D_x-axis-anti-collision.jpg]
X axis anti collision — original preview


<details>
<summary>More views</summary>

<table>
<tr>
<td align="center"><a href="photos/PNPV3_3D_x-axis-anti-collision-iso-top-1.jpg">X axis anti collision — top view 1</a><br><sub>Top 1</sub></td>
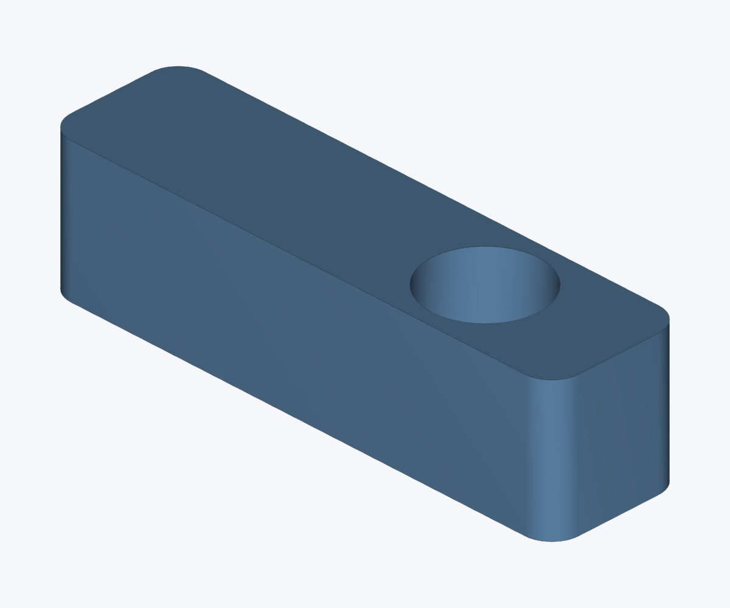
[picture p307: Microsmt-PNPv3/PNP-V3_3D_parts_2026-02-04/photos/PNPV3_3D_x-axis-anti-collision-iso-top-2.jpg]
X axis anti collision — top view 2
<td align="center"><br><sub>Top 2</sub></td>
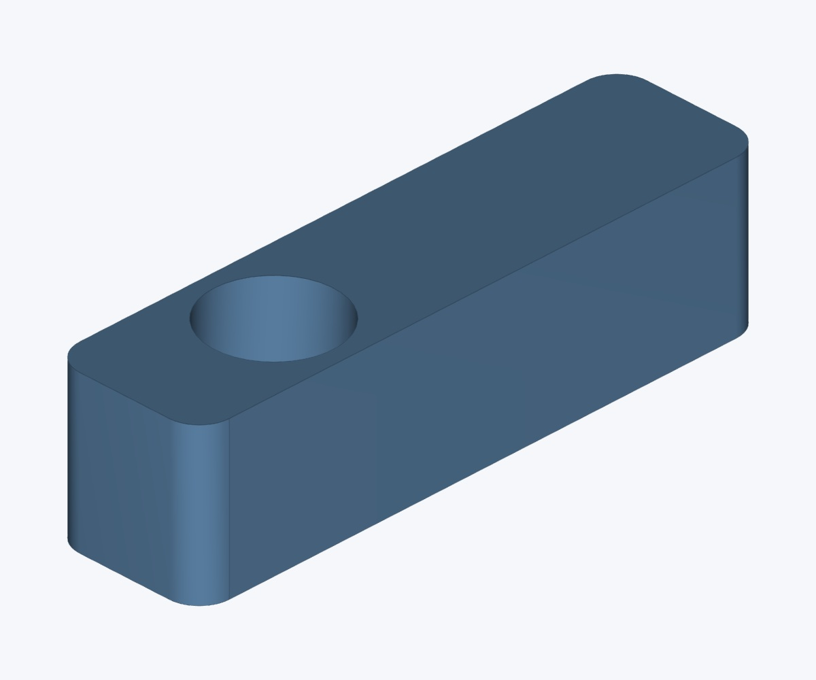
[picture p308: Microsmt-PNPv3/PNP-V3_3D_parts_2026-02-04/photos/PNPV3_3D_x-axis-anti-collision-iso-top-3.jpg]
X axis anti collision — top view 3
<td align="center"><br><sub>Top 3</sub></td>
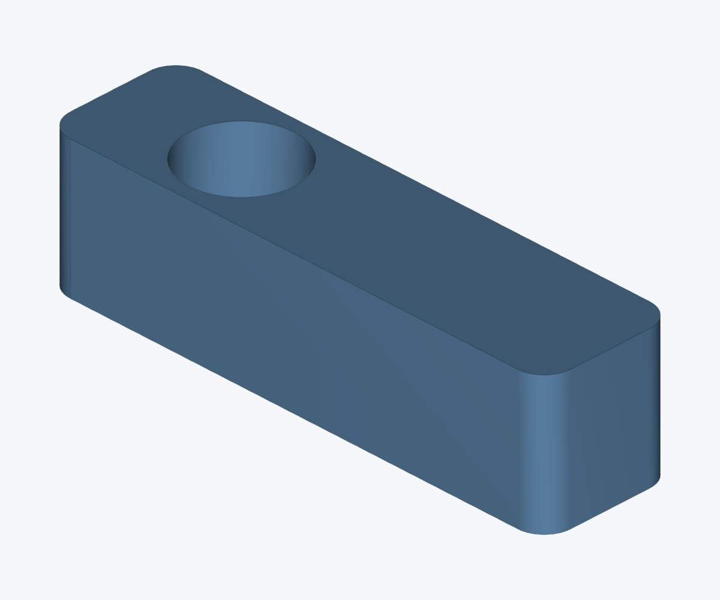
[picture p309: Microsmt-PNPv3/PNP-V3_3D_parts_2026-02-04/photos/PNPV3_3D_x-axis-anti-collision-iso-top-4.jpg]
X axis anti collision — top view 4
<td align="center"><br><sub>Top 4</sub></td>
</tr>
<tr>
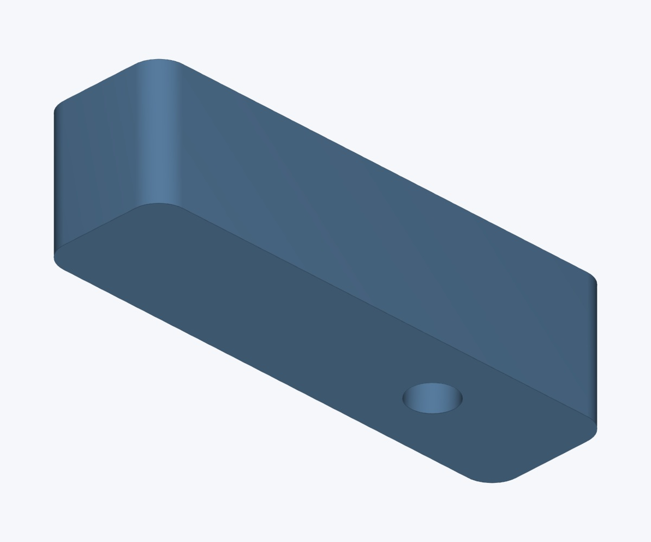
[picture p310: Microsmt-PNPv3/PNP-V3_3D_parts_2026-02-04/photos/PNPV3_3D_x-axis-anti-collision-iso-bottom-1.jpg]
X axis anti collision — bottom view 1
<td align="center"><br><sub>Bottom 1</sub></td>
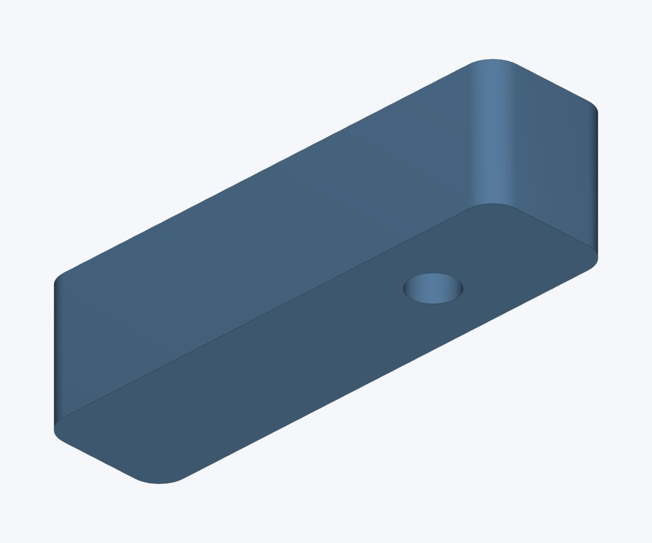
[picture p311: Microsmt-PNPv3/PNP-V3_3D_parts_2026-02-04/photos/PNPV3_3D_x-axis-anti-collision-iso-bottom-2.jpg]
X axis anti collision — bottom view 2
<td align="center"><br><sub>Bottom 2</sub></td>
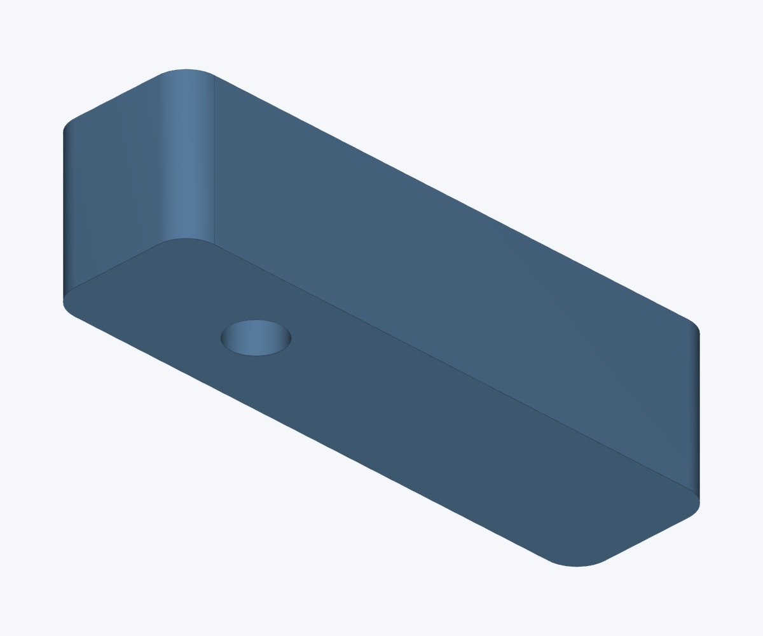
[picture p312: Microsmt-PNPv3/PNP-V3_3D_parts_2026-02-04/photos/PNPV3_3D_x-axis-anti-collision-iso-bottom-3.jpg]
X axis anti collision — bottom view 3
<td align="center"><br><sub>Bottom 3</sub></td>
<td align="center"><a href="photos/PNPV3_3D_x-axis-anti-collision-iso-bottom-4.jpg">X axis anti collision — bottom view 4</a><br><sub>Bottom 4</sub></td>
</tr>
</table>

</details>

## X-axis endstop striker

[STL](PNPV3_3D_x-axis-endstop-striker.stl)

<a href="photos/PNPV3_3D_x-axis-endstop-striker.jpg">X axis endstop striker — original preview</a>

<details>
<summary>More views</summary>

<table>
<tr>
<td align="center"><a href="photos/PNPV3_3D_x-axis-endstop-striker-iso-top-1.jpg">X axis endstop striker — top view 1</a><br><sub>Top 1</sub></td>
<td align="center"><a href="photos/PNPV3_3D_x-axis-endstop-striker-iso-top-2.jpg">X axis endstop striker — top view 2</a><br><sub>Top 2</sub></td>
<td align="center"><a href="photos/PNPV3_3D_x-axis-endstop-striker-iso-top-3.jpg">X axis endstop striker — top view 3</a><br><sub>Top 3</sub></td>
<td align="center"><a href="photos/PNPV3_3D_x-axis-endstop-striker-iso-top-4.jpg">X axis endstop striker — top view 4</a><br><sub>Top 4</sub></td>
</tr>
<tr>
<td align="center"><a href="photos/PNPV3_3D_x-axis-endstop-striker-iso-bottom-1.jpg">X axis endstop striker — bottom view 1</a><br><sub>Bottom 1</sub></td>
<td align="center"><a href="photos/PNPV3_3D_x-axis-endstop-striker-iso-bottom-2.jpg">X axis endstop striker — bottom view 2</a><br><sub>Bottom 2</sub></td>
<td align="center"><a href="photos/PNPV3_3D_x-axis-endstop-striker-iso-bottom-3.jpg">X axis endstop striker — bottom view 3</a><br><sub>Bottom 3</sub></td>
<td align="center"><a href="photos/PNPV3_3D_x-axis-endstop-striker-iso-bottom-4.jpg">X axis endstop striker — bottom view 4</a><br><sub>Bottom 4</sub></td>
</tr>
</table>

</details>

## X-axis endstop switch mount

[STL](PNPV3_3D_x-axis-endstop-switch-mount.stl)

<a href="photos/PNPV3_3D_x-axis-endstop-switch-mount.jpg">X axis endstop switch mount — original preview</a>

<details>
<summary>More views</summary>

<table>
<tr>
<td align="center"><a href="photos/PNPV3_3D_x-axis-endstop-switch-mount-iso-top-1.jpg">X axis endstop switch mount — top view 1</a><br><sub>Top 1</sub></td>
<td align="center"><a href="photos/PNPV3_3D_x-axis-endstop-switch-mount-iso-top-2.jpg">X axis endstop switch mount — top view 2</a><br><sub>Top 2</sub></td>
<td align="center"><a href="photos/PNPV3_3D_x-axis-endstop-switch-mount-iso-top-3.jpg">X axis endstop switch mount — top view 3</a><br><sub>Top 3</sub></td>
<td align="center"><a href="photos/PNPV3_3D_x-axis-endstop-switch-mount-iso-top-4.jpg">X axis endstop switch mount — top view 4</a><br><sub>Top 4</sub></td>
</tr>
<tr>
<td align="center"><a href="photos/PNPV3_3D_x-axis-endstop-switch-mount-iso-bottom-1.jpg">X axis endstop switch mount — bottom view 1</a><br><sub>Bottom 1</sub></td>
<td align="center"><a href="photos/PNPV3_3D_x-axis-endstop-switch-mount-iso-bottom-2.jpg">X axis endstop switch mount — bottom view 2</a><br><sub>Bottom 2</sub></td>
<td align="center"><a href="photos/PNPV3_3D_x-axis-endstop-switch-mount-iso-bottom-3.jpg">X axis endstop switch mount — bottom view 3</a><br><sub>Bottom 3</sub></td>
<td align="center"><a href="photos/PNPV3_3D_x-axis-endstop-switch-mount-iso-bottom-4.jpg">X axis endstop switch mount — bottom view 4</a><br><sub>Bottom 4</sub></td>
</tr>
</table>

</details>

## Y-axis drag-chain hook

[STL](PNPV3_3D_y-axis-drag-chain-hook.stl)

<a href="photos/PNPV3_3D_y-axis-drag-chain-hook.jpg">Y axis drag chain hook — original preview</a>

<details>
<summary>More views</summary>

<table>
<tr>
<td align="center"><a href="photos/PNPV3_3D_y-axis-drag-chain-hook-iso-top-1.jpg">Y axis drag chain hook — top view 1</a><br><sub>Top 1</sub></td>
<td align="center"><a href="photos/PNPV3_3D_y-axis-drag-chain-hook-iso-top-2.jpg">Y axis drag chain hook — top view 2</a><br><sub>Top 2</sub></td>
<td align="center"><a href="photos/PNPV3_3D_y-axis-drag-chain-hook-iso-top-3.jpg">Y axis drag chain hook — top view 3</a><br><sub>Top 3</sub></td>
<td align="center"><a href="photos/PNPV3_3D_y-axis-drag-chain-hook-iso-top-4.jpg">Y axis drag chain hook — top view 4</a><br><sub>Top 4</sub></td>
</tr>
<tr>
<td align="center"><a href="photos/PNPV3_3D_y-axis-drag-chain-hook-iso-bottom-1.jpg">Y axis drag chain hook — bottom view 1</a><br><sub>Bottom 1</sub></td>
<td align="center"><a href="photos/PNPV3_3D_y-axis-drag-chain-hook-iso-bottom-2.jpg">Y axis drag chain hook — bottom view 2</a><br><sub>Bottom 2</sub></td>
<td align="center"><a href="photos/PNPV3_3D_y-axis-drag-chain-hook-iso-bottom-3.jpg">Y axis drag chain hook — bottom view 3</a><br><sub>Bottom 3</sub></td>
<td align="center"><a href="photos/PNPV3_3D_y-axis-drag-chain-hook-iso-bottom-4.jpg">Y axis drag chain hook — bottom view 4</a><br><sub>Bottom 4</sub></td>
</tr>
</table>

</details>

## Y-axis endstop striker

[STL](PNPV3_3D_y-axis-endstop-striker.stl)

<a href="photos/PNPV3_3D_y-axis-endstop-striker.jpg">Y axis endstop striker — original preview</a>

<details>
<summary>More views</summary>

<table>
<tr>
<td align="center"><a href="photos/PNPV3_3D_y-axis-endstop-striker-iso-top-1.jpg">Y axis endstop striker — top view 1</a><br><sub>Top 1</sub></td>
<td align="center"><a href="photos/PNPV3_3D_y-axis-endstop-striker-iso-top-2.jpg">Y axis endstop striker — top view 2</a><br><sub>Top 2</sub></td>
<td align="center"><a href="photos/PNPV3_3D_y-axis-endstop-striker-iso-top-3.jpg">Y axis endstop striker — top view 3</a><br><sub>Top 3</sub></td>
<td align="center"><a href="photos/PNPV3_3D_y-axis-endstop-striker-iso-top-4.jpg">Y axis endstop striker — top view 4</a><br><sub>Top 4</sub></td>
</tr>
<tr>
<td align="center"><a href="photos/PNPV3_3D_y-axis-endstop-striker-iso-bottom-1.jpg">Y axis endstop striker — bottom view 1</a><br><sub>Bottom 1</sub></td>
<td align="center"><a href="photos/PNPV3_3D_y-axis-endstop-striker-iso-bottom-2.jpg">Y axis endstop striker — bottom view 2</a><br><sub>Bottom 2</sub></td>
<td align="center"><a href="photos/PNPV3_3D_y-axis-endstop-striker-iso-bottom-3.jpg">Y axis endstop striker — bottom view 3</a><br><sub>Bottom 3</sub></td>
<td align="center"><a href="photos/PNPV3_3D_y-axis-endstop-striker-iso-bottom-4.jpg">Y axis endstop striker — bottom view 4</a><br><sub>Bottom 4</sub></td>
</tr>
</table>

</details>

## Y-axis endstop switch mount

[STL](PNPV3_3D_y-axis-endstop-switch-mount.stl)

<a href="photos/PNPV3_3D_y-axis-endstop-switch-mount.jpg">Y axis endstop switch mount — original preview</a>

<details>
<summary>More views</summary>

<table>
<tr>
<td align="center"><a href="photos/PNPV3_3D_y-axis-endstop-switch-mount-iso-top-1.jpg">Y axis endstop switch mount — top view 1</a><br><sub>Top 1</sub></td>
<td align="center"><a href="photos/PNPV3_3D_y-axis-endstop-switch-mount-iso-top-2.jpg">Y axis endstop switch mount — top view 2</a><br><sub>Top 2</sub></td>
<td align="center"><a href="photos/PNPV3_3D_y-axis-endstop-switch-mount-iso-top-3.jpg">Y axis endstop switch mount — top view 3</a><br><sub>Top 3</sub></td>
<td align="center"><a href="photos/PNPV3_3D_y-axis-endstop-switch-mount-iso-top-4.jpg">Y axis endstop switch mount — top view 4</a><br><sub>Top 4</sub></td>
</tr>
<tr>
<td align="center"><a href="photos/PNPV3_3D_y-axis-endstop-switch-mount-iso-bottom-1.jpg">Y axis endstop switch mount — bottom view 1</a><br><sub>Bottom 1</sub></td>
<td align="center"><a href="photos/PNPV3_3D_y-axis-endstop-switch-mount-iso-bottom-2.jpg">Y axis endstop switch mount — bottom view 2</a><br><sub>Bottom 2</sub></td>
<td align="center"><a href="photos/PNPV3_3D_y-axis-endstop-switch-mount-iso-bottom-3.jpg">Y axis endstop switch mount — bottom view 3</a><br><sub>Bottom 3</sub></td>
<td align="center"><a href="photos/PNPV3_3D_y-axis-endstop-switch-mount-iso-bottom-4.jpg">Y axis endstop switch mount — bottom view 4</a><br><sub>Bottom 4</sub></td>
</tr>
</table>

</details>

## Z-axis endstop striker

[STL](PNPV3_3D_z-axis-endstop-striker.stl)

<a href="photos/PNPV3_3D_z-axis-endstop-striker.jpg">Z axis endstop striker — original preview</a>

<details>
<summary>More views</summary>

<table>
<tr>
<td align="center"><a href="photos/PNPV3_3D_z-axis-endstop-striker-iso-top-1.jpg">Z axis endstop striker — top view 1</a><br><sub>Top 1</sub></td>
<td align="center"><a href="photos/PNPV3_3D_z-axis-endstop-striker-iso-top-2.jpg">Z axis endstop striker — top view 2</a><br><sub>Top 2</sub></td>
<td align="center"><a href="photos/PNPV3_3D_z-axis-endstop-striker-iso-top-3.jpg">Z axis endstop striker — top view 3</a><br><sub>Top 3</sub></td>
<td align="center"><a href="photos/PNPV3_3D_z-axis-endstop-striker-iso-top-4.jpg">Z axis endstop striker — top view 4</a><br><sub>Top 4</sub></td>
</tr>
<tr>
<td align="center"><a href="photos/PNPV3_3D_z-axis-endstop-striker-iso-bottom-1.jpg">Z axis endstop striker — bottom view 1</a><br><sub>Bottom 1</sub></td>
<td align="center"><a href="photos/PNPV3_3D_z-axis-endstop-striker-iso-bottom-2.jpg">Z axis endstop striker — bottom view 2</a><br><sub>Bottom 2</sub></td>
<td align="center"><a href="photos/PNPV3_3D_z-axis-endstop-striker-iso-bottom-3.jpg">Z axis endstop striker — bottom view 3</a><br><sub>Bottom 3</sub></td>
<td align="center"><a href="photos/PNPV3_3D_z-axis-endstop-striker-iso-bottom-4.jpg">Z axis endstop striker — bottom view 4</a><br><sub>Bottom 4</sub></td>
</tr>
</table>

</details>

## Z-axis motor cover

[STL](PNPV3_3D_z-axis-motor-cover.stl)

<a href="photos/PNPV3_3D_z-axis-motor-cover.jpg">Z axis motor cover — original preview</a>

<details>
<summary>More views</summary>

<table>
<tr>
<td align="center"><a href="photos/PNPV3_3D_z-axis-motor-cover-iso-top-1.jpg">Z axis motor cover — top view 1</a><br><sub>Top 1</sub></td>
<td align="center"><a href="photos/PNPV3_3D_z-axis-motor-cover-iso-top-2.jpg">Z axis motor cover — top view 2</a><br><sub>Top 2</sub></td>
<td align="center"><a href="photos/PNPV3_3D_z-axis-motor-cover-iso-top-3.jpg">Z axis motor cover — top view 3</a><br><sub>Top 3</sub></td>
<td align="center"><a href="photos/PNPV3_3D_z-axis-motor-cover-iso-top-4.jpg">Z axis motor cover — top view 4</a><br><sub>Top 4</sub></td>
</tr>
<tr>
<td align="center"><a href="photos/PNPV3_3D_z-axis-motor-cover-iso-bottom-1.jpg">Z axis motor cover — bottom view 1</a><br><sub>Bottom 1</sub></td>
<td align="center"><a href="photos/PNPV3_3D_z-axis-motor-cover-iso-bottom-2.jpg">Z axis motor cover — bottom view 2</a><br><sub>Bottom 2</sub></td>
<td align="center"><a href="photos/PNPV3_3D_z-axis-motor-cover-iso-bottom-3.jpg">Z axis motor cover — bottom view 3</a><br><sub>Bottom 3</sub></td>
<td align="center"><a href="photos/PNPV3_3D_z-axis-motor-cover-iso-bottom-4.jpg">Z axis motor cover — bottom view 4</a><br><sub>Bottom 4</sub></td>
</tr>
</table>

</details>

## Reference photos

### 4020 aluminium profile 400mm reference

<a href="photos/PNPV3_4020-aluminium-profile-400mm-reference.jpg">4020 aluminium profile 400mm reference</a>

### Low noise pump installation

<a href="photos/PNPV3_low-noise-pump-installation.jpg">Low noise pump installation</a>
