gabrielyoung92/gabs_microSMT_PickAndPlace/Bing-feeder/V485-feeder/3D_parts_8mm/README.md

# V485 feeder parts — 8 mm

> Designs and original files by [MicroSMT](https://github.com/microsmt/Bing-feeder). [Credits and local changes](../../../CREDITS.md).

23 parts · [All photos](photos/) · [V485 collection](../README.md)

Includes both supplied 55T gear variants; compare the model with your assembly.

Click a picture for full size; **More views** contains top and bottom views.

## 1-position feeder holder

[STEP](V485_3D_feeder-holder-1-position.step) · [STL](V485_3D_feeder-holder-1-position.stl)

<a href="photos/V485_3D_feeder-holder-1-position.jpg">Feeder holder 1 position — preview</a>

<details>
<summary>More views</summary>

<table>
<tr>
<td align="center"><a href="photos/V485_3D_feeder-holder-1-position-iso-top-1.jpg">Feeder holder 1 position — top view 1</a><br><sub>Top 1</sub></td>
<td align="center"><a href="photos/V485_3D_feeder-holder-1-position-iso-top-2.jpg">Feeder holder 1 position — top view 2</a><br><sub>Top 2</sub></td>
<td align="center"><a href="photos/V485_3D_feeder-holder-1-position-iso-top-3.jpg">Feeder holder 1 position — top view 3</a><br><sub>Top 3</sub></td>
<td align="center"><a href="photos/V485_3D_feeder-holder-1-position-iso-top-4.jpg">Feeder holder 1 position — top view 4</a><br><sub>Top 4</sub></td>
</tr>
<tr>
<td align="center"><a href="photos/V485_3D_feeder-holder-1-position-iso-bottom-1.jpg">Feeder holder 1 position — bottom view 1</a><br><sub>Bottom 1</sub></td>
<td align="center"><a href="photos/V485_3D_feeder-holder-1-position-iso-bottom-2.jpg">Feeder holder 1 position — bottom view 2</a><br><sub>Bottom 2</sub></td>
<td align="center"><a href="photos/V485_3D_feeder-holder-1-position-iso-bottom-3.jpg">Feeder holder 1 position — bottom view 3</a><br><sub>Bottom 3</sub></td>
<td align="center"><a href="photos/V485_3D_feeder-holder-1-position-iso-bottom-4.jpg">Feeder holder 1 position — bottom view 4</a><br><sub>Bottom 4</sub></td>
</tr>
</table>

</details>

## 3-position feeder holder

[STEP](V485_3D_feeder-holder-3-position.step) · [STL](V485_3D_feeder-holder-3-position.stl)

<a href="photos/V485_3D_feeder-holder-3-position.jpg">Feeder holder 3 position — preview</a>

<details>
<summary>More views</summary>

<table>
<tr>
<td align="center"><a href="photos/V485_3D_feeder-holder-3-position-iso-top-1.jpg">Feeder holder 3 position — top view 1</a><br><sub>Top 1</sub></td>
<td align="center"><a href="photos/V485_3D_feeder-holder-3-position-iso-top-2.jpg">Feeder holder 3 position — top view 2</a><br><sub>Top 2</sub></td>
<td align="center"><a href="photos/V485_3D_feeder-holder-3-position-iso-top-3.jpg">Feeder holder 3 position — top view 3</a><br><sub>Top 3</sub></td>
<td align="center"><a href="photos/V485_3D_feeder-holder-3-position-iso-top-4.jpg">Feeder holder 3 position — top view 4</a><br><sub>Top 4</sub></td>
</tr>
<tr>
<td align="center"><a href="photos/V485_3D_feeder-holder-3-position-iso-bottom-1.jpg">Feeder holder 3 position — bottom view 1</a><br><sub>Bottom 1</sub></td>
<td align="center"><a href="photos/V485_3D_feeder-holder-3-position-iso-bottom-2.jpg">Feeder holder 3 position — bottom view 2</a><br><sub>Bottom 2</sub></td>
<td align="center"><a href="photos/V485_3D_feeder-holder-3-position-iso-bottom-3.jpg">Feeder holder 3 position — bottom view 3</a><br><sub>Bottom 3</sub></td>
<td align="center"><a href="photos/V485_3D_feeder-holder-3-position-iso-bottom-4.jpg">Feeder holder 3 position — bottom view 4</a><br><sub>Bottom 4</sub></td>
</tr>
</table>

</details>

## 8-position feeder holder

[STEP](V485_3D_feeder-holder-8-position.step) · [STL](V485_3D_feeder-holder-8-position.stl)

<a href="photos/V485_3D_feeder-holder-8-position.jpg">Feeder holder 8 position — preview</a>

<details>
<summary>More views</summary>

<table>
<tr>
<td align="center"><a href="photos/V485_3D_feeder-holder-8-position-iso-top-1.jpg">Feeder holder 8 position — top view 1</a><br><sub>Top 1</sub></td>
<td align="center"><a href="photos/V485_3D_feeder-holder-8-position-iso-top-2.jpg">Feeder holder 8 position — top view 2</a><br><sub>Top 2</sub></td>
<td align="center"><a href="photos/V485_3D_feeder-holder-8-position-iso-top-3.jpg">Feeder holder 8 position — top view 3</a><br><sub>Top 3</sub></td>
<td align="center"><a href="photos/V485_3D_feeder-holder-8-position-iso-top-4.jpg">Feeder holder 8 position — top view 4</a><br><sub>Top 4</sub></td>
</tr>
<tr>
<td align="center"><a href="photos/V485_3D_feeder-holder-8-position-iso-bottom-1.jpg">Feeder holder 8 position — bottom view 1</a><br><sub>Bottom 1</sub></td>
<td align="center"><a href="photos/V485_3D_feeder-holder-8-position-iso-bottom-2.jpg">Feeder holder 8 position — bottom view 2</a><br><sub>Bottom 2</sub></td>
<td align="center"><a href="photos/V485_3D_feeder-holder-8-position-iso-bottom-3.jpg">Feeder holder 8 position — bottom view 3</a><br><sub>Bottom 3</sub></td>
<td align="center"><a href="photos/V485_3D_feeder-holder-8-position-iso-bottom-4.jpg">Feeder holder 8 position — bottom view 4</a><br><sub>Bottom 4</sub></td>
</tr>
</table>

</details>

## 1-position feeder slot

[STEP](V485_3D_feeder-slot-1-position.step) · [STL](V485_3D_feeder-slot-1-position.stl)

<a href="photos/V485_3D_feeder-slot-1-position.jpg">Feeder slot 1 position — preview</a>

<details>
<summary>More views</summary>

<table>
<tr>
<td align="center"><a href="photos/V485_3D_feeder-slot-1-position-iso-top-1.jpg">Feeder slot 1 position — top view 1</a><br><sub>Top 1</sub></td>
<td align="center"><a href="photos/V485_3D_feeder-slot-1-position-iso-top-2.jpg">Feeder slot 1 position — top view 2</a><br><sub>Top 2</sub></td>
<td align="center"><a href="photos/V485_3D_feeder-slot-1-position-iso-top-3.jpg">Feeder slot 1 position — top view 3</a><br><sub>Top 3</sub></td>
<td align="center"><a href="photos/V485_3D_feeder-slot-1-position-iso-top-4.jpg">Feeder slot 1 position — top view 4</a><br><sub>Top 4</sub></td>
</tr>
<tr>
<td align="center"><a href="photos/V485_3D_feeder-slot-1-position-iso-bottom-1.jpg">Feeder slot 1 position — bottom view 1</a><br><sub>Bottom 1</sub></td>
<td align="center"><a href="photos/V485_3D_feeder-slot-1-position-iso-bottom-2.jpg">Feeder slot 1 position — bottom view 2</a><br><sub>Bottom 2</sub></td>
<td align="center"><a href="photos/V485_3D_feeder-slot-1-position-iso-bottom-3.jpg">Feeder slot 1 position — bottom view 3</a><br><sub>Bottom 3</sub></td>
<td align="center"><a href="photos/V485_3D_feeder-slot-1-position-iso-bottom-4.jpg">Feeder slot 1 position — bottom view 4</a><br><sub>Bottom 4</sub></td>
</tr>
</table>

</details>

## 1-position feeder slot — space variant

[STEP](V485_3D_feeder-slot-1-position-space-variant.step) · [STL](V485_3D_feeder-slot-1-position-space-variant.stl)

<a href="photos/V485_3D_feeder-slot-1-position-space-variant.jpg">Feeder slot 1 position space variant — preview</a>

<details>
<summary>More views</summary>

<table>
<tr>
<td align="center"><a href="photos/V485_3D_feeder-slot-1-position-space-variant-iso-top-1.jpg">Feeder slot 1 position space variant — top view 1</a><br><sub>Top 1</sub></td>
<td align="center"><a href="photos/V485_3D_feeder-slot-1-position-space-variant-iso-top-2.jpg">Feeder slot 1 position space variant — top view 2</a><br><sub>Top 2</sub></td>
<td align="center"><a href="photos/V485_3D_feeder-slot-1-position-space-variant-iso-top-3.jpg">Feeder slot 1 position space variant — top view 3</a><br><sub>Top 3</sub></td>
<td align="center"><a href="photos/V485_3D_feeder-slot-1-position-space-variant-iso-top-4.jpg">Feeder slot 1 position space variant — top view 4</a><br><sub>Top 4</sub></td>
</tr>
<tr>
<td align="center"><a href="photos/V485_3D_feeder-slot-1-position-space-variant-iso-bottom-1.jpg">Feeder slot 1 position space variant — bottom view 1</a><br><sub>Bottom 1</sub></td>
<td align="center"><a href="photos/V485_3D_feeder-slot-1-position-space-variant-iso-bottom-2.jpg">Feeder slot 1 position space variant — bottom view 2</a><br><sub>Bottom 2</sub></td>
<td align="center"><a href="photos/V485_3D_feeder-slot-1-position-space-variant-iso-bottom-3.jpg">Feeder slot 1 position space variant — bottom view 3</a><br><sub>Bottom 3</sub></td>
<td align="center"><a href="photos/V485_3D_feeder-slot-1-position-space-variant-iso-bottom-4.jpg">Feeder slot 1 position space variant — bottom view 4</a><br><sub>Bottom 4</sub></td>
</tr>
</table>

</details>

## 8-position feeder slot

[STL](V485_3D_feeder-slot-8-position.stl)

<a href="photos/V485_3D_feeder-slot-8-position.jpg">Feeder slot 8 position — preview</a>

<details>
<summary>More views</summary>

<table>
<tr>
<td align="center"><a href="photos/V485_3D_feeder-slot-8-position-iso-top-1.jpg">Feeder slot 8 position — top view 1</a><br><sub>Top 1</sub></td>
<td align="center"><a href="photos/V485_3D_feeder-slot-8-position-iso-top-2.jpg">Feeder slot 8 position — top view 2</a><br><sub>Top 2</sub></td>
<td align="center"><a href="photos/V485_3D_feeder-slot-8-position-iso-top-3.jpg">Feeder slot 8 position — top view 3</a><br><sub>Top 3</sub></td>
<td align="center"><a href="photos/V485_3D_feeder-slot-8-position-iso-top-4.jpg">Feeder slot 8 position — top view 4</a><br><sub>Top 4</sub></td>
</tr>
<tr>
<td align="center"><a href="photos/V485_3D_feeder-slot-8-position-iso-bottom-1.jpg">Feeder slot 8 position — bottom view 1</a><br><sub>Bottom 1</sub></td>
<td align="center"><a href="photos/V485_3D_feeder-slot-8-position-iso-bottom-2.jpg">Feeder slot 8 position — bottom view 2</a><br><sub>Bottom 2</sub></td>
<td align="center"><a href="photos/V485_3D_feeder-slot-8-position-iso-bottom-3.jpg">Feeder slot 8 position — bottom view 3</a><br><sub>Bottom 3</sub></td>
<td align="center"><a href="photos/V485_3D_feeder-slot-8-position-iso-bottom-4.jpg">Feeder slot 8 position — bottom view 4</a><br><sub>Bottom 4</sub></td>
</tr>
</table>

</details>

## 15T gear — module 0.7, 6 mm

[STEP](V485_3D_gear-15t-module-0.7-6mm.step) · [STL](V485_3D_gear-15t-module-0.7-6mm.stl)

<a href="photos/V485_3D_gear-15t-module-0.7-6mm.jpg">Gear 15t module 0.7 6mm — preview</a>

<details>
<summary>More views</summary>

<table>
<tr>
<td align="center"><a href="photos/V485_3D_gear-15t-module-0.7-6mm-iso-top-1.jpg">Gear 15t module 0.7 6mm — top view 1</a><br><sub>Top 1</sub></td>
<td align="center"><a href="photos/V485_3D_gear-15t-module-0.7-6mm-iso-top-2.jpg">Gear 15t module 0.7 6mm — top view 2</a><br><sub>Top 2</sub></td>
<td align="center"><a href="photos/V485_3D_gear-15t-module-0.7-6mm-iso-top-3.jpg">Gear 15t module 0.7 6mm — top view 3</a><br><sub>Top 3</sub></td>
<td align="center"><a href="photos/V485_3D_gear-15t-module-0.7-6mm-iso-top-4.jpg">Gear 15t module 0.7 6mm — top view 4</a><br><sub>Top 4</sub></td>
</tr>
<tr>
<td align="center"><a href="photos/V485_3D_gear-15t-module-0.7-6mm-iso-bottom-1.jpg">Gear 15t module 0.7 6mm — bottom view 1</a><br><sub>Bottom 1</sub></td>
<td align="center"><a href="photos/V485_3D_gear-15t-module-0.7-6mm-iso-bottom-2.jpg">Gear 15t module 0.7 6mm — bottom view 2</a><br><sub>Bottom 2</sub></td>
<td align="center"><a href="photos/V485_3D_gear-15t-module-0.7-6mm-iso-bottom-3.jpg">Gear 15t module 0.7 6mm — bottom view 3</a><br><sub>Bottom 3</sub></td>
<td align="center"><a href="photos/V485_3D_gear-15t-module-0.7-6mm-iso-bottom-4.jpg">Gear 15t module 0.7 6mm — bottom view 4</a><br><sub>Bottom 4</sub></td>
</tr>
</table>

</details>

## 16T gear bracket

[STEP](V485_3D_gear-16t-bracket.step) · [STL](V485_3D_gear-16t-bracket.stl)

<a href="photos/V485_3D_gear-16t-bracket.jpg">Gear 16t bracket — preview</a>

<details>
<summary>More views</summary>

<table>
<tr>
<td align="center"><a href="photos/V485_3D_gear-16t-bracket-iso-top-1.jpg">Gear 16t bracket — top view 1</a><br><sub>Top 1</sub></td>
<td align="center"><a href="photos/V485_3D_gear-16t-bracket-iso-top-2.jpg">Gear 16t bracket — top view 2</a><br><sub>Top 2</sub></td>
<td align="center"><a href="photos/V485_3D_gear-16t-bracket-iso-top-3.jpg">Gear 16t bracket — top view 3</a><br><sub>Top 3</sub></td>
<td align="center"><a href="photos/V485_3D_gear-16t-bracket-iso-top-4.jpg">Gear 16t bracket — top view 4</a><br><sub>Top 4</sub></td>
</tr>
<tr>
<td align="center"><a href="photos/V485_3D_gear-16t-bracket-iso-bottom-1.jpg">Gear 16t bracket — bottom view 1</a><br><sub>Bottom 1</sub></td>
<td align="center"><a href="photos/V485_3D_gear-16t-bracket-iso-bottom-2.jpg">Gear 16t bracket — bottom view 2</a><br><sub>Bottom 2</sub></td>
<td align="center"><a href="photos/V485_3D_gear-16t-bracket-iso-bottom-3.jpg">Gear 16t bracket — bottom view 3</a><br><sub>Bottom 3</sub></td>
<td align="center"><a href="photos/V485_3D_gear-16t-bracket-iso-bottom-4.jpg">Gear 16t bracket — bottom view 4</a><br><sub>Bottom 4</sub></td>
</tr>
</table>

</details>

## 16T gear — module 0.7, 6 mm

[STEP](V485_3D_gear-16t-module-0.7-6mm.step) · [STL](V485_3D_gear-16t-module-0.7-6mm.stl)

<a href="photos/V485_3D_gear-16t-module-0.7-6mm.jpg">Gear 16t module 0.7 6mm — preview</a>

<details>
<summary>More views</summary>

<table>
<tr>
<td align="center"><a href="photos/V485_3D_gear-16t-module-0.7-6mm-iso-top-1.jpg">Gear 16t module 0.7 6mm — top view 1</a><br><sub>Top 1</sub></td>
<td align="center"><a href="photos/V485_3D_gear-16t-module-0.7-6mm-iso-top-2.jpg">Gear 16t module 0.7 6mm — top view 2</a><br><sub>Top 2</sub></td>
<td align="center"><a href="photos/V485_3D_gear-16t-module-0.7-6mm-iso-top-3.jpg">Gear 16t module 0.7 6mm — top view 3</a><br><sub>Top 3</sub></td>
<td align="center"><a href="photos/V485_3D_gear-16t-module-0.7-6mm-iso-top-4.jpg">Gear 16t module 0.7 6mm — top view 4</a><br><sub>Top 4</sub></td>
</tr>
<tr>
<td align="center"><a href="photos/V485_3D_gear-16t-module-0.7-6mm-iso-bottom-1.jpg">Gear 16t module 0.7 6mm — bottom view 1</a><br><sub>Bottom 1</sub></td>
<td align="center"><a href="photos/V485_3D_gear-16t-module-0.7-6mm-iso-bottom-2.jpg">Gear 16t module 0.7 6mm — bottom view 2</a><br><sub>Bottom 2</sub></td>
<td align="center"><a href="photos/V485_3D_gear-16t-module-0.7-6mm-iso-bottom-3.jpg">Gear 16t module 0.7 6mm — bottom view 3</a><br><sub>Bottom 3</sub></td>
<td align="center"><a href="photos/V485_3D_gear-16t-module-0.7-6mm-iso-bottom-4.jpg">Gear 16t module 0.7 6mm — bottom view 4</a><br><sub>Bottom 4</sub></td>
</tr>
</table>

</details>

## 45T gear

[STEP](V485_3D_gear-45t.step) · [STL](V485_3D_gear-45t.stl)

<a href="photos/V485_3D_gear-45t.jpg">Gear 45t — preview</a>

<details>
<summary>More views</summary>

<table>
<tr>
<td align="center"><a href="photos/V485_3D_gear-45t-iso-top-1.jpg">Gear 45t — top view 1</a><br><sub>Top 1</sub></td>
<td align="center"><a href="photos/V485_3D_gear-45t-iso-top-2.jpg">Gear 45t — top view 2</a><br><sub>Top 2</sub></td>
<td align="center"><a href="photos/V485_3D_gear-45t-iso-top-3.jpg">Gear 45t — top view 3</a><br><sub>Top 3</sub></td>
<td align="center"><a href="photos/V485_3D_gear-45t-iso-top-4.jpg">Gear 45t — top view 4</a><br><sub>Top 4</sub></td>
</tr>
<tr>
<td align="center"><a href="photos/V485_3D_gear-45t-iso-bottom-1.jpg">Gear 45t — bottom view 1</a><br><sub>Bottom 1</sub></td>
<td align="center"><a href="photos/V485_3D_gear-45t-iso-bottom-2.jpg">Gear 45t — bottom view 2</a><br><sub>Bottom 2</sub></td>
<td align="center"><a href="photos/V485_3D_gear-45t-iso-bottom-3.jpg">Gear 45t — bottom view 3</a><br><sub>Bottom 3</sub></td>
<td align="center"><a href="photos/V485_3D_gear-45t-iso-bottom-4.jpg">Gear 45t — bottom view 4</a><br><sub>Bottom 4</sub></td>
</tr>
</table>

</details>

## 45T gear for a 684ZZ bearing

[STEP](V485_3D_gear-45t-684zz-bearing-variant.step) · [STL](V485_3D_gear-45t-684zz-bearing-variant.stl)

<a href="photos/V485_3D_gear-45t-684zz-bearing-variant.jpg">Gear 45t 684zz bearing variant — preview</a>

<details>
<summary>More views</summary>

<table>
<tr>
<td align="center"><a href="photos/V485_3D_gear-45t-684zz-bearing-variant-iso-top-1.jpg">Gear 45t 684zz bearing variant — top view 1</a><br><sub>Top 1</sub></td>
<td align="center"><a href="photos/V485_3D_gear-45t-684zz-bearing-variant-iso-top-2.jpg">Gear 45t 684zz bearing variant — top view 2</a><br><sub>Top 2</sub></td>
<td align="center"><a href="photos/V485_3D_gear-45t-684zz-bearing-variant-iso-top-3.jpg">Gear 45t 684zz bearing variant — top view 3</a><br><sub>Top 3</sub></td>
<td align="center"><a href="photos/V485_3D_gear-45t-684zz-bearing-variant-iso-top-4.jpg">Gear 45t 684zz bearing variant — top view 4</a><br><sub>Top 4</sub></td>
</tr>
<tr>
<td align="center"><a href="photos/V485_3D_gear-45t-684zz-bearing-variant-iso-bottom-1.jpg">Gear 45t 684zz bearing variant — bottom view 1</a><br><sub>Bottom 1</sub></td>
<td align="center"><a href="photos/V485_3D_gear-45t-684zz-bearing-variant-iso-bottom-2.jpg">Gear 45t 684zz bearing variant — bottom view 2</a><br><sub>Bottom 2</sub></td>
<td align="center"><a href="photos/V485_3D_gear-45t-684zz-bearing-variant-iso-bottom-3.jpg">Gear 45t 684zz bearing variant — bottom view 3</a><br><sub>Bottom 3</sub></td>
<td align="center"><a href="photos/V485_3D_gear-45t-684zz-bearing-variant-iso-bottom-4.jpg">Gear 45t 684zz bearing variant — bottom view 4</a><br><sub>Bottom 4</sub></td>
</tr>
</table>

</details>

## 55T gear

[STEP](V485_3D_gear-55t.step) · [STL](V485_3D_gear-55t.stl)

<a href="photos/V485_3D_gear-55t.jpg">Gear 55t — preview</a>

<details>
<summary>More views</summary>

<table>
<tr>
<td align="center"><a href="photos/V485_3D_gear-55t-iso-top-1.jpg">Gear 55t — top view 1</a><br><sub>Top 1</sub></td>
<td align="center"><a href="photos/V485_3D_gear-55t-iso-top-2.jpg">Gear 55t — top view 2</a><br><sub>Top 2</sub></td>
<td align="center"><a href="photos/V485_3D_gear-55t-iso-top-3.jpg">Gear 55t — top view 3</a><br><sub>Top 3</sub></td>
<td align="center"><a href="photos/V485_3D_gear-55t-iso-top-4.jpg">Gear 55t — top view 4</a><br><sub>Top 4</sub></td>
</tr>
<tr>
<td align="center"><a href="photos/V485_3D_gear-55t-iso-bottom-1.jpg">Gear 55t — bottom view 1</a><br><sub>Bottom 1</sub></td>
<td align="center"><a href="photos/V485_3D_gear-55t-iso-bottom-2.jpg">Gear 55t — bottom view 2</a><br><sub>Bottom 2</sub></td>
<td align="center"><a href="photos/V485_3D_gear-55t-iso-bottom-3.jpg">Gear 55t — bottom view 3</a><br><sub>Bottom 3</sub></td>
<td align="center"><a href="photos/V485_3D_gear-55t-iso-bottom-4.jpg">Gear 55t — bottom view 4</a><br><sub>Bottom 4</sub></td>
</tr>
</table>

</details>

## 55T gear — previous 8 mm version

[STEP](V485_3D_gear-55t-legacy-8mm.step) · [STL](V485_3D_gear-55t-legacy-8mm.stl)

<a href="photos/V485_3D_gear-55t-legacy-8mm.jpg">Gear 55T — legacy 8 mm variant — preview</a>

<details>
<summary>More views</summary>

<table>
<tr>
<td align="center"><a href="photos/V485_3D_gear-55t-legacy-8mm-iso-top-1.jpg">Gear 55T — legacy 8 mm variant — top view 1</a><br><sub>Top 1</sub></td>
<td align="center"><a href="photos/V485_3D_gear-55t-legacy-8mm-iso-top-2.jpg">Gear 55T — legacy 8 mm variant — top view 2</a><br><sub>Top 2</sub></td>
<td align="center"><a href="photos/V485_3D_gear-55t-legacy-8mm-iso-top-3.jpg">Gear 55T — legacy 8 mm variant — top view 3</a><br><sub>Top 3</sub></td>
<td align="center"><a href="photos/V485_3D_gear-55t-legacy-8mm-iso-top-4.jpg">Gear 55T — legacy 8 mm variant — top view 4</a><br><sub>Top 4</sub></td>
</tr>
<tr>
<td align="center"><a href="photos/V485_3D_gear-55t-legacy-8mm-iso-bottom-1.jpg">Gear 55T — legacy 8 mm variant — bottom view 1</a><br><sub>Bottom 1</sub></td>
<td align="center"><a href="photos/V485_3D_gear-55t-legacy-8mm-iso-bottom-2.jpg">Gear 55T — legacy 8 mm variant — bottom view 2</a><br><sub>Bottom 2</sub></td>
<td align="center"><a href="photos/V485_3D_gear-55t-legacy-8mm-iso-bottom-3.jpg">Gear 55T — legacy 8 mm variant — bottom view 3</a><br><sub>Bottom 3</sub></td>
<td align="center"><a href="photos/V485_3D_gear-55t-legacy-8mm-iso-bottom-4.jpg">Gear 55T — legacy 8 mm variant — bottom view 4</a><br><sub>Bottom 4</sub></td>
</tr>
</table>

</details>

## Main body

[STEP](V485_3D_main-body.step) · [STL](V485_3D_main-body.stl)

<a href="photos/V485_3D_main-body.jpg">Main body — preview</a>

<details>
<summary>More views</summary>

<table>
<tr>
<td align="center"><a href="photos/V485_3D_main-body-iso-top-1.jpg">Main body — top view 1</a><br><sub>Top 1</sub></td>
<td align="center"><a href="photos/V485_3D_main-body-iso-top-2.jpg">Main body — top view 2</a><br><sub>Top 2</sub></td>
<td align="center"><a href="photos/V485_3D_main-body-iso-top-3.jpg">Main body — top view 3</a><br><sub>Top 3</sub></td>
<td align="center"><a href="photos/V485_3D_main-body-iso-top-4.jpg">Main body — top view 4</a><br><sub>Top 4</sub></td>
</tr>
<tr>
<td align="center"><a href="photos/V485_3D_main-body-iso-bottom-1.jpg">Main body — bottom view 1</a><br><sub>Bottom 1</sub></td>
<td align="center"><a href="photos/V485_3D_main-body-iso-bottom-2.jpg">Main body — bottom view 2</a><br><sub>Bottom 2</sub></td>
<td align="center"><a href="photos/V485_3D_main-body-iso-bottom-3.jpg">Main body — bottom view 3</a><br><sub>Bottom 3</sub></td>
<td align="center"><a href="photos/V485_3D_main-body-iso-bottom-4.jpg">Main body — bottom view 4</a><br><sub>Bottom 4</sub></td>
</tr>
</table>

</details>

## PCB cover

[STEP](V485_3D_pcb-cover.step) · [STL](V485_3D_pcb-cover.stl)

<a href="photos/V485_3D_pcb-cover.jpg">Pcb cover — preview</a>

<details>
<summary>More views</summary>

<table>
<tr>
<td align="center"><a href="photos/V485_3D_pcb-cover-iso-top-1.jpg">Pcb cover — top view 1</a><br><sub>Top 1</sub></td>
<td align="center"><a href="photos/V485_3D_pcb-cover-iso-top-2.jpg">Pcb cover — top view 2</a><br><sub>Top 2</sub></td>
<td align="center"><a href="photos/V485_3D_pcb-cover-iso-top-3.jpg">Pcb cover — top view 3</a><br><sub>Top 3</sub></td>
<td align="center"><a href="photos/V485_3D_pcb-cover-iso-top-4.jpg">Pcb cover — top view 4</a><br><sub>Top 4</sub></td>
</tr>
<tr>
<td align="center"><a href="photos/V485_3D_pcb-cover-iso-bottom-1.jpg">Pcb cover — bottom view 1</a><br><sub>Bottom 1</sub></td>
<td align="center"><a href="photos/V485_3D_pcb-cover-iso-bottom-2.jpg">Pcb cover — bottom view 2</a><br><sub>Bottom 2</sub></td>
<td align="center"><a href="photos/V485_3D_pcb-cover-iso-bottom-3.jpg">Pcb cover — bottom view 3</a><br><sub>Bottom 3</sub></td>
<td align="center"><a href="photos/V485_3D_pcb-cover-iso-bottom-4.jpg">Pcb cover — bottom view 4</a><br><sub>Bottom 4</sub></td>
</tr>
</table>

</details>

## Spool hook A

[STEP](V485_3D_spool-hook-a.step) · [STL](V485_3D_spool-hook-a.stl)

<a href="photos/V485_3D_spool-hook-a.jpg">Spool hook a — preview</a>

<details>
<summary>More views</summary>

<table>
<tr>
<td align="center"><a href="photos/V485_3D_spool-hook-a-iso-top-1.jpg">Spool hook a — top view 1</a><br><sub>Top 1</sub></td>
<td align="center"><a href="photos/V485_3D_spool-hook-a-iso-top-2.jpg">Spool hook a — top view 2</a><br><sub>Top 2</sub></td>
<td align="center"><a href="photos/V485_3D_spool-hook-a-iso-top-3.jpg">Spool hook a — top view 3</a><br><sub>Top 3</sub></td>
<td align="center"><a href="photos/V485_3D_spool-hook-a-iso-top-4.jpg">Spool hook a — top view 4</a><br><sub>Top 4</sub></td>
</tr>
<tr>
<td align="center"><a href="photos/V485_3D_spool-hook-a-iso-bottom-1.jpg">Spool hook a — bottom view 1</a><br><sub>Bottom 1</sub></td>
<td align="center"><a href="photos/V485_3D_spool-hook-a-iso-bottom-2.jpg">Spool hook a — bottom view 2</a><br><sub>Bottom 2</sub></td>
<td align="center"><a href="photos/V485_3D_spool-hook-a-iso-bottom-3.jpg">Spool hook a — bottom view 3</a><br><sub>Bottom 3</sub></td>
<td align="center"><a href="photos/V485_3D_spool-hook-a-iso-bottom-4.jpg">Spool hook a — bottom view 4</a><br><sub>Bottom 4</sub></td>
</tr>
</table>

</details>

## Spring support plate

[STEP](V485_3D_spring-support-plate.step) · [STL](V485_3D_spring-support-plate.stl)

<a href="photos/V485_3D_spring-support-plate.jpg">Spring support plate — preview</a>

<details>
<summary>More views</summary>

<table>
<tr>
<td align="center"><a href="photos/V485_3D_spring-support-plate-iso-top-1.jpg">Spring support plate — top view 1</a><br><sub>Top 1</sub></td>
<td align="center"><a href="photos/V485_3D_spring-support-plate-iso-top-2.jpg">Spring support plate — top view 2</a><br><sub>Top 2</sub></td>
<td align="center"><a href="photos/V485_3D_spring-support-plate-iso-top-3.jpg">Spring support plate — top view 3</a><br><sub>Top 3</sub></td>
<td align="center"><a href="photos/V485_3D_spring-support-plate-iso-top-4.jpg">Spring support plate — top view 4</a><br><sub>Top 4</sub></td>
</tr>
<tr>
<td align="center"><a href="photos/V485_3D_spring-support-plate-iso-bottom-1.jpg">Spring support plate — bottom view 1</a><br><sub>Bottom 1</sub></td>
<td align="center"><a href="photos/V485_3D_spring-support-plate-iso-bottom-2.jpg">Spring support plate — bottom view 2</a><br><sub>Bottom 2</sub></td>
<td align="center"><a href="photos/V485_3D_spring-support-plate-iso-bottom-3.jpg">Spring support plate — bottom view 3</a><br><sub>Bottom 3</sub></td>
<td align="center"><a href="photos/V485_3D_spring-support-plate-iso-bottom-4.jpg">Spring support plate — bottom view 4</a><br><sub>Bottom 4</sub></td>
</tr>
</table>

</details>

## Sprocket cover

[STEP](V485_3D_sprocket-cover.step) · [STL](V485_3D_sprocket-cover.stl)

<a href="photos/V485_3D_sprocket-cover.jpg">Sprocket cover — preview</a>

<details>
<summary>More views</summary>

<table>
<tr>
<td align="center"><a href="photos/V485_3D_sprocket-cover-iso-top-1.jpg">Sprocket cover — top view 1</a><br><sub>Top 1</sub></td>
<td align="center"><a href="photos/V485_3D_sprocket-cover-iso-top-2.jpg">Sprocket cover — top view 2</a><br><sub>Top 2</sub></td>
<td align="center"><a href="photos/V485_3D_sprocket-cover-iso-top-3.jpg">Sprocket cover — top view 3</a><br><sub>Top 3</sub></td>
<td align="center"><a href="photos/V485_3D_sprocket-cover-iso-top-4.jpg">Sprocket cover — top view 4</a><br><sub>Top 4</sub></td>
</tr>
<tr>
<td align="center"><a href="photos/V485_3D_sprocket-cover-iso-bottom-1.jpg">Sprocket cover — bottom view 1</a><br><sub>Bottom 1</sub></td>
<td align="center"><a href="photos/V485_3D_sprocket-cover-iso-bottom-2.jpg">Sprocket cover — bottom view 2</a><br><sub>Bottom 2</sub></td>
<td align="center"><a href="photos/V485_3D_sprocket-cover-iso-bottom-3.jpg">Sprocket cover — bottom view 3</a><br><sub>Bottom 3</sub></td>
<td align="center"><a href="photos/V485_3D_sprocket-cover-iso-bottom-4.jpg">Sprocket cover — bottom view 4</a><br><sub>Bottom 4</sub></td>
</tr>
</table>

</details>

## Switch trigger

[STEP](V485_3D_switch-trigger.step) · [STL](V485_3D_switch-trigger.stl)

<a href="photos/V485_3D_switch-trigger.jpg">Switch trigger — preview</a>

<details>
<summary>More views</summary>

<table>
<tr>
<td align="center"><a href="photos/V485_3D_switch-trigger-iso-top-1.jpg">Switch trigger — top view 1</a><br><sub>Top 1</sub></td>
<td align="center"><a href="photos/V485_3D_switch-trigger-iso-top-2.jpg">Switch trigger — top view 2</a><br><sub>Top 2</sub></td>
<td align="center"><a href="photos/V485_3D_switch-trigger-iso-top-3.jpg">Switch trigger — top view 3</a><br><sub>Top 3</sub></td>
<td align="center"><a href="photos/V485_3D_switch-trigger-iso-top-4.jpg">Switch trigger — top view 4</a><br><sub>Top 4</sub></td>
</tr>
<tr>
<td align="center"><a href="photos/V485_3D_switch-trigger-iso-bottom-1.jpg">Switch trigger — bottom view 1</a><br><sub>Bottom 1</sub></td>
<td align="center"><a href="photos/V485_3D_switch-trigger-iso-bottom-2.jpg">Switch trigger — bottom view 2</a><br><sub>Bottom 2</sub></td>
<td align="center"><a href="photos/V485_3D_switch-trigger-iso-bottom-3.jpg">Switch trigger — bottom view 3</a><br><sub>Bottom 3</sub></td>
<td align="center"><a href="photos/V485_3D_switch-trigger-iso-bottom-4.jpg">Switch trigger — bottom view 4</a><br><sub>Bottom 4</sub></td>
</tr>
</table>

</details>

## Switch trigger cover

[STEP](V485_3D_switch-trigger-cover.step) · [STL](V485_3D_switch-trigger-cover.stl)

<a href="photos/V485_3D_switch-trigger-cover.jpg">Switch trigger cover — preview</a>

<details>
<summary>More views</summary>

<table>
<tr>
<td align="center"><a href="photos/V485_3D_switch-trigger-cover-iso-top-1.jpg">Switch trigger cover — top view 1</a><br><sub>Top 1</sub></td>
<td align="center"><a href="photos/V485_3D_switch-trigger-cover-iso-top-2.jpg">Switch trigger cover — top view 2</a><br><sub>Top 2</sub></td>
<td align="center"><a href="photos/V485_3D_switch-trigger-cover-iso-top-3.jpg">Switch trigger cover — top view 3</a><br><sub>Top 3</sub></td>
<td align="center"><a href="photos/V485_3D_switch-trigger-cover-iso-top-4.jpg">Switch trigger cover — top view 4</a><br><sub>Top 4</sub></td>
</tr>
<tr>
<td align="center"><a href="photos/V485_3D_switch-trigger-cover-iso-bottom-1.jpg">Switch trigger cover — bottom view 1</a><br><sub>Bottom 1</sub></td>
<td align="center"><a href="photos/V485_3D_switch-trigger-cover-iso-bottom-2.jpg">Switch trigger cover — bottom view 2</a><br><sub>Bottom 2</sub></td>
<td align="center"><a href="photos/V485_3D_switch-trigger-cover-iso-bottom-3.jpg">Switch trigger cover — bottom view 3</a><br><sub>Bottom 3</sub></td>
<td align="center"><a href="photos/V485_3D_switch-trigger-cover-iso-bottom-4.jpg">Switch trigger cover — bottom view 4</a><br><sub>Bottom 4</sub></td>
</tr>
</table>

</details>

## Tape cover

[STEP](V485_3D_tape-cover.step) · [STL](V485_3D_tape-cover.stl)

<a href="photos/V485_3D_tape-cover.jpg">Tape cover — preview</a>

<details>
<summary>More views</summary>

<table>
<tr>
<td align="center"><a href="photos/V485_3D_tape-cover-iso-top-1.jpg">Tape cover — top view 1</a><br><sub>Top 1</sub></td>
<td align="center"><a href="photos/V485_3D_tape-cover-iso-top-2.jpg">Tape cover — top view 2</a><br><sub>Top 2</sub></td>
<td align="center"><a href="photos/V485_3D_tape-cover-iso-top-3.jpg">Tape cover — top view 3</a><br><sub>Top 3</sub></td>
<td align="center"><a href="photos/V485_3D_tape-cover-iso-top-4.jpg">Tape cover — top view 4</a><br><sub>Top 4</sub></td>
</tr>
<tr>
<td align="center"><a href="photos/V485_3D_tape-cover-iso-bottom-1.jpg">Tape cover — bottom view 1</a><br><sub>Bottom 1</sub></td>
<td align="center"><a href="photos/V485_3D_tape-cover-iso-bottom-2.jpg">Tape cover — bottom view 2</a><br><sub>Bottom 2</sub></td>
<td align="center"><a href="photos/V485_3D_tape-cover-iso-bottom-3.jpg">Tape cover — bottom view 3</a><br><sub>Bottom 3</sub></td>
<td align="center"><a href="photos/V485_3D_tape-cover-iso-bottom-4.jpg">Tape cover — bottom view 4</a><br><sub>Bottom 4</sub></td>
</tr>
</table>

</details>

## Worm — module 0.7, 10W × 13L

[STEP](V485_3D_worm-module-0.7-10w-13l.step) · [STL](V485_3D_worm-module-0.7-10w-13l.stl)

<a href="photos/V485_3D_worm-module-0.7-10w-13l.jpg">Worm module 0.7 10w 13l — preview</a>

<details>
<summary>More views</summary>

<table>
<tr>
<td align="center"><a href="photos/V485_3D_worm-module-0.7-10w-13l-iso-top-1.jpg">Worm module 0.7 10w 13l — top view 1</a><br><sub>Top 1</sub></td>
<td align="center"><a href="photos/V485_3D_worm-module-0.7-10w-13l-iso-top-2.jpg">Worm module 0.7 10w 13l — top view 2</a><br><sub>Top 2</sub></td>
<td align="center"><a href="photos/V485_3D_worm-module-0.7-10w-13l-iso-top-3.jpg">Worm module 0.7 10w 13l — top view 3</a><br><sub>Top 3</sub></td>
<td align="center"><a href="photos/V485_3D_worm-module-0.7-10w-13l-iso-top-4.jpg">Worm module 0.7 10w 13l — top view 4</a><br><sub>Top 4</sub></td>
</tr>
<tr>
<td align="center"><a href="photos/V485_3D_worm-module-0.7-10w-13l-iso-bottom-1.jpg">Worm module 0.7 10w 13l — bottom view 1</a><br><sub>Bottom 1</sub></td>
<td align="center"><a href="photos/V485_3D_worm-module-0.7-10w-13l-iso-bottom-2.jpg">Worm module 0.7 10w 13l — bottom view 2</a><br><sub>Bottom 2</sub></td>
<td align="center"><a href="photos/V485_3D_worm-module-0.7-10w-13l-iso-bottom-3.jpg">Worm module 0.7 10w 13l — bottom view 3</a><br><sub>Bottom 3</sub></td>
<td align="center"><a href="photos/V485_3D_worm-module-0.7-10w-13l-iso-bottom-4.jpg">Worm module 0.7 10w 13l — bottom view 4</a><br><sub>Bottom 4</sub></td>
</tr>
</table>

</details>

## Worm motor support

[STEP](V485_3D_worm-motor-support.step) · [STL](V485_3D_worm-motor-support.stl)

<a href="photos/V485_3D_worm-motor-support.jpg">Worm motor support — preview</a>

<details>
<summary>More views</summary>

<table>
<tr>
<td align="center"><a href="photos/V485_3D_worm-motor-support-iso-top-1.jpg">Worm motor support — top view 1</a><br><sub>Top 1</sub></td>
<td align="center"><a href="photos/V485_3D_worm-motor-support-iso-top-2.jpg">Worm motor support — top view 2</a><br><sub>Top 2</sub></td>
<td align="center"><a href="photos/V485_3D_worm-motor-support-iso-top-3.jpg">Worm motor support — top view 3</a><br><sub>Top 3</sub></td>
<td align="center"><a href="photos/V485_3D_worm-motor-support-iso-top-4.jpg">Worm motor support — top view 4</a><br><sub>Top 4</sub></td>
</tr>
<tr>
<td align="center"><a href="photos/V485_3D_worm-motor-support-iso-bottom-1.jpg">Worm motor support — bottom view 1</a><br><sub>Bottom 1</sub></td>
<td align="center"><a href="photos/V485_3D_worm-motor-support-iso-bottom-2.jpg">Worm motor support — bottom view 2</a><br><sub>Bottom 2</sub></td>
<td align="center"><a href="photos/V485_3D_worm-motor-support-iso-bottom-3.jpg">Worm motor support — bottom view 3</a><br><sub>Bottom 3</sub></td>
<td align="center"><a href="photos/V485_3D_worm-motor-support-iso-bottom-4.jpg">Worm motor support — bottom view 4</a><br><sub>Bottom 4</sub></td>
</tr>
</table>

</details>

## Reference photos

<a href="photos/V485_3D_spool-hook-a-reference.jpg">MicroSMT supplied reference photo</a>
