gabrielyoung92/gabs_microSMT_PickAndPlace/Bing-feeder/V485-feeder/3D_parts_shared/README.md

# V485 feeder parts — Shared parts for 12/16/24 mm

> Designs and original files by [MicroSMT](https://github.com/microsmt/Bing-feeder). [Credits and local changes](../../../CREDITS.md).

5 parts · [All photos](photos/) · [V485 collection](../README.md)

These parts are shared by the 12, 16 and 24 mm V485 feeders. Bodies, tape covers and motor supports are in each width's folder. The trigger cover here is for 16/24 mm.

Click a picture for full size; **More views** contains top and bottom views.

## 45T gear

[STEP](V485_3D_gear-45t.step) · [STL](V485_3D_gear-45t.stl)

<a href="photos/V485_3D_gear-45t.jpg">Gear 45t — preview</a>

<details>
<summary>More views</summary>

<table>
<tr>
<td align="center"><a href="photos/V485_3D_gear-45t-iso-top-1.jpg">Gear 45t — top view 1</a><br><sub>Top 1</sub></td>
<td align="center"><a href="photos/V485_3D_gear-45t-iso-top-2.jpg">Gear 45t — top view 2</a><br><sub>Top 2</sub></td>
<td align="center"><a href="photos/V485_3D_gear-45t-iso-top-3.jpg">Gear 45t — top view 3</a><br><sub>Top 3</sub></td>
<td align="center"><a href="photos/V485_3D_gear-45t-iso-top-4.jpg">Gear 45t — top view 4</a><br><sub>Top 4</sub></td>
</tr>
<tr>
<td align="center"><a href="photos/V485_3D_gear-45t-iso-bottom-1.jpg">Gear 45t — bottom view 1</a><br><sub>Bottom 1</sub></td>
<td align="center"><a href="photos/V485_3D_gear-45t-iso-bottom-2.jpg">Gear 45t — bottom view 2</a><br><sub>Bottom 2</sub></td>
<td align="center"><a href="photos/V485_3D_gear-45t-iso-bottom-3.jpg">Gear 45t — bottom view 3</a><br><sub>Bottom 3</sub></td>
<td align="center"><a href="photos/V485_3D_gear-45t-iso-bottom-4.jpg">Gear 45t — bottom view 4</a><br><sub>Bottom 4</sub></td>
</tr>
</table>

</details>

## 45T gear for a 684ZZ bearing

[STEP](V485_3D_gear-45t-684zz-bearing-variant.step) · [STL](V485_3D_gear-45t-684zz-bearing-variant.stl)

<a href="photos/V485_3D_gear-45t-684zz-bearing-variant.jpg">Gear 45t 684zz bearing variant — preview</a>

<details>
<summary>More views</summary>

<table>
<tr>
<td align="center"><a href="photos/V485_3D_gear-45t-684zz-bearing-variant-iso-top-1.jpg">Gear 45t 684zz bearing variant — top view 1</a><br><sub>Top 1</sub></td>
<td align="center"><a href="photos/V485_3D_gear-45t-684zz-bearing-variant-iso-top-2.jpg">Gear 45t 684zz bearing variant — top view 2</a><br><sub>Top 2</sub></td>
<td align="center"><a href="photos/V485_3D_gear-45t-684zz-bearing-variant-iso-top-3.jpg">Gear 45t 684zz bearing variant — top view 3</a><br><sub>Top 3</sub></td>
<td align="center"><a href="photos/V485_3D_gear-45t-684zz-bearing-variant-iso-top-4.jpg">Gear 45t 684zz bearing variant — top view 4</a><br><sub>Top 4</sub></td>
</tr>
<tr>
<td align="center"><a href="photos/V485_3D_gear-45t-684zz-bearing-variant-iso-bottom-1.jpg">Gear 45t 684zz bearing variant — bottom view 1</a><br><sub>Bottom 1</sub></td>
<td align="center"><a href="photos/V485_3D_gear-45t-684zz-bearing-variant-iso-bottom-2.jpg">Gear 45t 684zz bearing variant — bottom view 2</a><br><sub>Bottom 2</sub></td>
<td align="center"><a href="photos/V485_3D_gear-45t-684zz-bearing-variant-iso-bottom-3.jpg">Gear 45t 684zz bearing variant — bottom view 3</a><br><sub>Bottom 3</sub></td>
<td align="center"><a href="photos/V485_3D_gear-45t-684zz-bearing-variant-iso-bottom-4.jpg">Gear 45t 684zz bearing variant — bottom view 4</a><br><sub>Bottom 4</sub></td>
</tr>
</table>

</details>

## 55T gear

[STEP](V485_3D_gear-55t.step) · [STL](V485_3D_gear-55t.stl)

<a href="photos/V485_3D_gear-55t.jpg">Gear 55t — preview</a>

<details>
<summary>More views</summary>

<table>
<tr>
<td align="center"><a href="photos/V485_3D_gear-55t-iso-top-1.jpg">Gear 55t — top view 1</a><br><sub>Top 1</sub></td>
<td align="center"><a href="photos/V485_3D_gear-55t-iso-top-2.jpg">Gear 55t — top view 2</a><br><sub>Top 2</sub></td>
<td align="center"><a href="photos/V485_3D_gear-55t-iso-top-3.jpg">Gear 55t — top view 3</a><br><sub>Top 3</sub></td>
<td align="center"><a href="photos/V485_3D_gear-55t-iso-top-4.jpg">Gear 55t — top view 4</a><br><sub>Top 4</sub></td>
</tr>
<tr>
<td align="center"><a href="photos/V485_3D_gear-55t-iso-bottom-1.jpg">Gear 55t — bottom view 1</a><br><sub>Bottom 1</sub></td>
<td align="center"><a href="photos/V485_3D_gear-55t-iso-bottom-2.jpg">Gear 55t — bottom view 2</a><br><sub>Bottom 2</sub></td>
<td align="center"><a href="photos/V485_3D_gear-55t-iso-bottom-3.jpg">Gear 55t — bottom view 3</a><br><sub>Bottom 3</sub></td>
<td align="center"><a href="photos/V485_3D_gear-55t-iso-bottom-4.jpg">Gear 55t — bottom view 4</a><br><sub>Bottom 4</sub></td>
</tr>
</table>

</details>

## Trigger cover for 16/24 mm

[STEP](V485_3D_switch-trigger-cover-16-24mm.step) · [STL](V485_3D_switch-trigger-cover-16-24mm.stl)

<a href="photos/V485_3D_switch-trigger-cover-16-24mm.jpg">Switch trigger cover 16 24mm — preview</a>

<details>
<summary>More views</summary>

<table>
<tr>
<td align="center"><a href="photos/V485_3D_switch-trigger-cover-16-24mm-iso-top-1.jpg">Switch trigger cover 16 24mm — top view 1</a><br><sub>Top 1</sub></td>
<td align="center"><a href="photos/V485_3D_switch-trigger-cover-16-24mm-iso-top-2.jpg">Switch trigger cover 16 24mm — top view 2</a><br><sub>Top 2</sub></td>
<td align="center"><a href="photos/V485_3D_switch-trigger-cover-16-24mm-iso-top-3.jpg">Switch trigger cover 16 24mm — top view 3</a><br><sub>Top 3</sub></td>
<td align="center"><a href="photos/V485_3D_switch-trigger-cover-16-24mm-iso-top-4.jpg">Switch trigger cover 16 24mm — top view 4</a><br><sub>Top 4</sub></td>
</tr>
<tr>
<td align="center"><a href="photos/V485_3D_switch-trigger-cover-16-24mm-iso-bottom-1.jpg">Switch trigger cover 16 24mm — bottom view 1</a><br><sub>Bottom 1</sub></td>
<td align="center"><a href="photos/V485_3D_switch-trigger-cover-16-24mm-iso-bottom-2.jpg">Switch trigger cover 16 24mm — bottom view 2</a><br><sub>Bottom 2</sub></td>
<td align="center"><a href="photos/V485_3D_switch-trigger-cover-16-24mm-iso-bottom-3.jpg">Switch trigger cover 16 24mm — bottom view 3</a><br><sub>Bottom 3</sub></td>
<td align="center"><a href="photos/V485_3D_switch-trigger-cover-16-24mm-iso-bottom-4.jpg">Switch trigger cover 16 24mm — bottom view 4</a><br><sub>Bottom 4</sub></td>
</tr>
</table>

</details>

## Worm — module 0.7, 10W × 13L

[STEP](V485_3D_worm-module-0.7-10w-13l.step) · [STL](V485_3D_worm-module-0.7-10w-13l.stl)

<a href="photos/V485_3D_worm-module-0.7-10w-13l.jpg">Worm module 0.7 10w 13l — preview</a>

<details>
<summary>More views</summary>

<table>
<tr>
<td align="center"><a href="photos/V485_3D_worm-module-0.7-10w-13l-iso-top-1.jpg">Worm module 0.7 10w 13l — top view 1</a><br><sub>Top 1</sub></td>
<td align="center"><a href="photos/V485_3D_worm-module-0.7-10w-13l-iso-top-2.jpg">Worm module 0.7 10w 13l — top view 2</a><br><sub>Top 2</sub></td>
<td align="center"><a href="photos/V485_3D_worm-module-0.7-10w-13l-iso-top-3.jpg">Worm module 0.7 10w 13l — top view 3</a><br><sub>Top 3</sub></td>
<td align="center"><a href="photos/V485_3D_worm-module-0.7-10w-13l-iso-top-4.jpg">Worm module 0.7 10w 13l — top view 4</a><br><sub>Top 4</sub></td>
</tr>
<tr>
<td align="center"><a href="photos/V485_3D_worm-module-0.7-10w-13l-iso-bottom-1.jpg">Worm module 0.7 10w 13l — bottom view 1</a><br><sub>Bottom 1</sub></td>
<td align="center"><a href="photos/V485_3D_worm-module-0.7-10w-13l-iso-bottom-2.jpg">Worm module 0.7 10w 13l — bottom view 2</a><br><sub>Bottom 2</sub></td>
<td align="center"><a href="photos/V485_3D_worm-module-0.7-10w-13l-iso-bottom-3.jpg">Worm module 0.7 10w 13l — bottom view 3</a><br><sub>Bottom 3</sub></td>
<td align="center"><a href="photos/V485_3D_worm-module-0.7-10w-13l-iso-bottom-4.jpg">Worm module 0.7 10w 13l — bottom view 4</a><br><sub>Bottom 4</sub></td>
</tr>
</table>

</details>
