gabrielyoung92/gabs_microSMT_PickAndPlace/Bing-feeder/V485-Feeder Controller/PCB_ControlBoard/docs/BOM_Board1_Schematic1_2026-10-09.xlsx

No. | Quantity | Comment | Designator | Footprint | Value | Manufacturer Part | Manufacturer | Supplier Part | Supplier
1 | 1 | 10uF | C1 | C0603 | 10uF | HGC0603R5106M160NTHJ | Chinocera(华瓷) | C7472959 | LCSC
2 | 5 | 100nF | C2,C3,C4,C5,C6 | C0603 | 100nF
3 | 1 | 1SMA4740A | D1 | SMA_L4.3-W2.6-LS5.0-RD |  | 1SMA4740A | R+O(宏嘉诚) | C19077479 | LCSC
4 | 2 | SMF12CA | D3,D4 | SOD-123FL_L2.8-W1.8-LS3.7-BI |  | SMF12CA | R+O(宏嘉诚) | C19077507 | LCSC
5 | 1 | SMW3225S102HTE | L2 | FILTER-SMD_3225-4P-L3.2-W2.5-TL |  | SMW3225S102HTE | Sunltech(顺磁) | C254907 | LCSC
6 | 2 | NCD0603G1 | LED1,LED2 | LED0603-RD_1 |  | NCD0603G1 | 国星光电 | C84267 | LCSC
7 | 2 | 2.54-1*8P母环保 | P1,P2 | HDR-TH_8P-P2.54-V-F |  | 2.54-1*8P母环保 | BOOMELE(博穆精密) | C27438 | LCSC
8 | 1 | WJ500V-5.08-2P | P3 | CONN-TH_2P-P5.00_WJ500V-5.08-2P |  | WJ500V-5.08-2P | KANGNEX(康奈克斯电气) | C8465 | LCSC
9 | 1 | AO4407C | Q1 | SOP-8_L4.9-W3.9-P1.27-LS6.0-BL |  | AO4407C | AOS | C469397 | LCSC
10 | 2 | 1kΩ | R1,R5 | R0603 | 1kΩ | FRC0603F1001TS | FOJAN(富捷) | C2907002 | LCSC
11 | 1 | 120Ω | R2 | R0603 | 120Ω | FRC0603F1200TS | FOJAN(富捷) | C2906988 | LCSC
12 | 2 | 4.7kΩ | R3,R4 | R0603 | 4.7kΩ | 0603WAF4701T5E | UNI-ROYAL(厚声) | C23162 | LCSC
13 | 3 | 100Ω | R6,R7,R8 | R0603 | 100Ω | FRC0603F1000TS | FOJAN(富捷) | C2906981 | LCSC
14 | 1 | 100kΩ | R9 | R0603 | 100kΩ | RC0603FR-07100KL | YAGEO(国巨) | C14675 | LCSC
15 | 1 | AMS1117-3.3 | U1 | SOT-223-3_L6.5-W3.4-P2.30-LS7.0-BR |  | AMS1117-3.3 | 美国AMS | C6186 | LCSC
16 | 1 | VH3.96-4P ZZ | U2 | CONN-TH_4P-P3.96_HX-VH3.96-4P-ZZ |  | VH3.96-4P ZZ | SHOU HAN(首韩) | C5379870 | LCSC
17 | 1 | 2920L500/30GR | U3 | F2920 |  | 2920L500/30GR | LUTE(陆特) | C19078763 | LCSC
18 | 1 | MAX3485ESA(UMW) | U7 | SOP-8_L5.0-W4.0-P1.27-LS6.0-BL |  | MAX3485ESA(UMW) | UMW(友台半导体) | C668204 | LCSC
