gabrielyoung92/gabs_microSMT_PickAndPlace/Bing-feeder/V485-feeder/PCB_display/docs/BOM_Board1_Schematic1_2026-10-09.xlsx

No. | Quantity | Comment | Designator | Footprint | Value | Manufacturer Part | Manufacturer | Supplier Part | Supplier
1 | 1 | 100nF | C1 | C0402 | 100nF | CC0402KRX7R7BB104 | YAGEO(国巨) | C60474 | LCSC
2 | 1 | GS2022CB-G | LED1 | LED-SEG-SMD_10P-L12.0-W10.0-P2.54_GS2022AR-G |  | GS2022CB-G | Guangcai Display(光彩显示) | C27636666 | LCSC
3 | 1 | CH455G | U1 | SOP-16_L10.0-W3.9-P1.27-LS6.0-BL |  | CH455G | WCH(南京沁恒) | C89818 | LCSC
4 | 1 | ZX-SH1.0-4PWT | U2 | CONN-SMD_4P-P1.00_MEGASTAR_ZX-SH1.0-4PWT |  | ZX-SH1.0-4PWT | Megastar(兆星) | C7430446 | LCSC
