gabrielyoung92/gabs_microSMT_PickAndPlace/Bing-feeder/V485-feeder/PCB_feeder/docs/BOM_Board1_PCB3_2026-10-09.xlsx

No. | Quantity | Comment | Designator | Footprint | Value | Manufacturer Part | Manufacturer | Supplier Part | Supplier
1 | 12 | 100nF | C1,C2,C3,C4,C5,C7,C9,C10,C11,C19,C20,C22 | C0603 | 100nF
2 | 2 | 22pF | C6,C8 | C0402 | 22pF | CC0402JRNPO9BN220 | YAGEO(国巨) | C106203 | LCSC
3 | 5 | 100nF | C12,C13,C14,C15,C18 | C0603 | 100nF | 0603B104K500NT | FH(风华) | C30926 | LCSC
4 | 2 | 100uF | C16,C17 | CAP-SMD_BD6.3-L6.6-W6.6-LS7.2-FD | 100uF | RVT100UF16V67RV0016 | KNSCHA(科尼盛) | C2887276 | LCSC
5 | 2 | 100nF | C21,C23 | C0402 | 100nF | CL05B104KO5NNNC | SAMSUNG(三星) | C1525 | LCSC
6 | 1 | 1uF | C24 | C0402 | 1uF | CL05A105KA5NQNC | SAMSUNG(三星) | C52923 | LCSC
7 | 2 | SS34-MS | D1,D2 | DO-214AC_L4.3-W2.7-LS5.0-RD |  | SS34-MS | MSKSEMI(美森科) | C2836396 | LCSC
8 | 2 | SMF12CA | D3,D4 | SOD-123FL_L2.8-W1.8-LS3.7-BI |  | SMF12CA | R+O(宏嘉诚) | C19077507 | LCSC
9 | 1 | PZ254V-11-04P | H2 | HDR-TH_4P-P2.54-V-M |  | PZ254V-11-04P | XFCN(兴飞) | C2691448 | LCSC
10 | 1 | PZ254R-11-03P | H3 | HDR-TH_3P-P2.54-H-M-W10.4 |  | PZ254R-11-03P | XFCN(兴飞) | C492411 | LCSC
11 | 1 | DLW21SN900SQ2L | L1 | FILTER-SMD_4P-L2.0-W1.2-BL_DLW21H |  | DLW21SN900SQ2L | muRata(村田) | C97856 | LCSC
12 | 2 | 19-217/BHC-ZL1M2RY/3T | LED1,LED3 | LED0603-FD_BLUE |  | 19-217/BHC-ZL1M2RY/3T | EVERLIGHT(亿光) | C72041 | LCSC
13 | 1 | 19-217/GHC-YR1S2/3T | LED2 | LED0603-RD |  | 19-217/GHC-YR1S2/3T | EVERLIGHT(亿光) | C72043 | LCSC
14 | 5 | 10kΩ | R1,R7,R10,R18,R19 | R0402 | 10kΩ | FRC0402F1002TS | FOJAN(富捷) | C2906861 | LCSC
15 | 4 | 4.7kΩ | R2,R15,R16,R17 | R0402 | 4.7kΩ | FRC0402F4701TS | FOJAN(富捷) | C2906869 | LCSC
16 | 3 | 510Ω | R4,R5,R6 | R0402 | 510Ω | FRC0402F5100TS | FOJAN(富捷) | C2909366 | LCSC
17 | 2 | 10K | R8,R9 | R0603 | 10K
18 | 3 | 100Ω | R12,R13,R14 | R0402 | 100Ω | FRC0402F1000TS | FOJAN(富捷) | C2906860 | LCSC
19 | 2 | TS-1093A-A8B3-D2 | SW1,SW2 | KEY-TH_4P-L7.1-W10.9-P4.50-LS2.5 |  | TS-1093A-A8B3-D2 | Yuandi(元迪) | C499315 | LCSC
20 | 1 | AMS1117-3.3 | U1 | SOT-223-3_L6.5-W3.4-P2.30-LS7.0-BR |  | AMS1117-3.3 | 美国AMS | C6186 | LCSC
21 | 1 | STM32C8T6 | U2 | LQFP-48_48P-L7.0-W7.0-P0.50-LS9.0-BL
22 | 1 | TC1508A | U3 | SOP-16_L10.0-W3.9-P1.27-LS6.0-BL |  | TC1508A | FM(富满) | C5142992 | LCSC
23 | 2 | WAFER-SH1.0-2PWB | U4,U10 | CONN-SMD_2P-P1.00_XUNPU_WAFER-SH1.0-2PWB |  | WAFER-SH1.0-2PWB | XUNPU(讯普) | C3029341 | LCSC
24 | 1 | ZX-SH1.0-3PLT | U5 | CONN-SMD_3P-P1.00_HDGC_HDGC1002WV-S-3P |  | ZX-SH1.0-3PLT | Megastar(兆星) | C7430452 | LCSC
25 | 1 | YZ165615055F-04025-01 | U6 | CONN-SMD_4P-L11.0-W5.5-P2.50_YZ165615055F-04025-01 |  | YZ165615055F-04025-01 | Xinyangze(鑫扬泽) | C5296819 | LCSC
26 | 1 | MAX3485ESA(UMW) | U7 | SOP-8_L5.0-W4.0-P1.27-LS6.0-BL |  | MAX3485ESA(UMW) | UMW(友台半导体) | C668204 | LCSC
27 | 1 | M24C02-WMN6TP | U8 | SOIC-8_L4.9-W3.9-P1.27-LS6.0-BL |  | M24C02-WMN6TP | ST(意法半导体) | C7562 | LCSC
28 | 1 | ZX-SH1.0-4PWT | U9 | CONN-SMD_4P-P1.00_MEGASTAR_ZX-SH1.0-4PWT |  | ZX-SH1.0-4PWT | Megastar(兆星) | C7430446 | LCSC
29 | 1 | 8MHz | X2 | CRYSTAL-SMD_4P-L3.2-W2.5-BL | 8MHz | YC8MLBCD2XT | YJX(雅晶鑫) | C52164299 | LCSC
