gabrielyoung92/gabs_microSMT_PickAndPlace/Microsmt-PNPv3/PCB_motherboard/docs/mcu-pins.csv

package_pin | gpio | symbol_pin_name | source_net | board_status | other_source_pins | adc_channel | uart_alternate | proposed_use | pcb_x_mm | pcb_y_mm | access | firmware_status
1 |  | TDO/SWO | NET_11 | isolated non-GPIO |  |  |  |  | 76.6928 | 82.94125 | MCU pad only; no source connector | not audited; verify pin configuration and timer/interrupt ownership
2 |  | TDI | NET_12 | isolated non-GPIO |  |  |  |  | 76.2102 | 82.94125 | MCU pad only; no source connector | not audited; verify pin configuration and timer/interrupt ownership
3 |  | TMS/SWDIO | NET_13 | isolated non-GPIO |  |  |  |  | 75.7022 | 82.94125 | MCU pad only; no source connector | not audited; verify pin configuration and timer/interrupt ownership
4 |  | ~{TRST} | NET_14 | isolated non-GPIO |  |  |  |  | 75.1942 | 82.94125 | MCU pad only; no source connector | not audited; verify pin configuration and timer/interrupt ownership
5 |  | TCK/SWDCLK | NET_15 | isolated non-GPIO |  |  |  |  | 74.6862 | 82.94125 | MCU pad only; no source connector | not audited; verify pin configuration and timer/interrupt ownership
6 | P0.26 | P0[26] | NET_16 | isolated GPIO; UART alternate reserved |  | 3 | RXD3 |  | 74.2036 | 82.94125 | MCU pad only; no source connector | not audited; verify pin configuration and timer/interrupt ownership
7 | P0.25 | P0[25] | NET_17 | isolated GPIO; UART alternate reserved |  | 2 | TXD3 |  | 73.6956 | 82.94125 | MCU pad only; no source connector | not audited; verify pin configuration and timer/interrupt ownership
8 | P0.24 | P0[24] | NET_18 | isolated GPIO candidate |  | 1 |  | RESERVED vacuum head 2 | 73.1876 | 82.94125 | MCU pad only; no source connector | not audited; verify pin configuration and timer/interrupt ownership
9 | P0.23 | P0[23] | NET_19 | isolated GPIO candidate |  | 0 |  | RESERVED vacuum head 1 | 72.705 | 82.94125 | MCU pad only; no source connector | not audited; verify pin configuration and timer/interrupt ownership
10 |  | VDDA | 3.3V | connected in source CAM | C1.2; C7.A; C8.2; C9.2; C10.2; C11.2; C12.2; C13.2; C14.2; C31.2; C65.1; C67.2; C68.2; C85.1; C88.1; C91.1; C94.1; C97.1; IC1.12; IC1.19; IC1.28; IC1.42; IC1.54; IC1.71; IC1.84; IC1.96; IC4.17; IC9.4; IC9.17; IC10.2; IC10.4; JP7.2; JP9.2; JP12.2; JP15.2; JP18.2; JP72.1; JP73.1; JP92.1; JP93.1; JP122.1; JP123.1; JP152.1; JP153.1; JP182.1; JP183.1; Q1.4; R1.2; R2.2; R3.2; R4.2; R14.2; R15.2; R16.2; R17.1; R18.2; R30.2; R35.2; R36.2; R37.2; R77.2; S6.2; U1.4 |  |  |  | 72.197 | 82.94125 | source endpoints listed; fitted access unverified | not audited; verify pin configuration and timer/interrupt ownership
11 |  | VSSA | GND | connected in source CAM | C1.1; C2.2; C3.2; C4.1; C5.1; C7.C; C8.1; C9.1; C10.1; C11.1; C12.1; C13.1; C14.1; C31.1; C62.2; C63.2; C64.C; C65.2; C66.2; C67.1; C68.1; C75.2; C76.2; C77.2; C78.2; C79.2; C80.2; C81.2; C82.2; C83.2; C84.2; C85.2; C86.2; C87.2; C88.2; C89.2; C90.2; C91.2; C92.2; C93.2; C94.2; C95.2; C96.2; C97.2; C98.2; C99.2; C101.2; C102.2; D4.A; IC1.15; IC1.31; IC1.41; IC1.55; IC1.72; IC1.83; IC1.97; IC4.3; IC4.4; IC4.7; IC4.8; IC4.13; IC4.16; IC4.18; IC9.3; IC9.7; IC9.8; IC9.13; IC9.16; IC9.18; IC10.1; IC11.2; IC13.2; IC14.3; IC15.3; J1.2; JP7.1; JP7.7; JP9.1; JP9.7; JP12.1; JP12.7; JP14.2; JP15.1; JP15.7; JP16.2; JP18.1; JP18.7; JP19.2; JP21.2; JP22.2; JP23.2; JP26.2; JP72.3; JP73.3; JP92.3; JP93.3; JP122.3; JP123.3; JP152.3; JP153.3; JP182.3; JP183.3; LED1.1; LED2.1; LED3.1; LED4.1; LED9.1; LED10.1; Q4.3; Q5.S; Q6.S; Q7.S; Q8.3; R71.1; R72.1; R74.2; R83.2; R86.2; R87.1; R89.2; R90.2; R91.2; S1.2; S1.4; S2.2; S2.4; S3.2; S6.1; U1.6; U1.CD2; U1.GND1; X14.GND |  |  |  | 71.689 | 82.94125 | source endpoints listed; fitted access unverified | not audited; verify pin configuration and timer/interrupt ownership
12 |  | VREFP | 3.3V | connected in source CAM | C1.2; C7.A; C8.2; C9.2; C10.2; C11.2; C12.2; C13.2; C14.2; C31.2; C65.1; C67.2; C68.2; C85.1; C88.1; C91.1; C94.1; C97.1; IC1.10; IC1.19; IC1.28; IC1.42; IC1.54; IC1.71; IC1.84; IC1.96; IC4.17; IC9.4; IC9.17; IC10.2; IC10.4; JP7.2; JP9.2; JP12.2; JP15.2; JP18.2; JP72.1; JP73.1; JP92.1; JP93.1; JP122.1; JP123.1; JP152.1; JP153.1; JP182.1; JP183.1; Q1.4; R1.2; R2.2; R3.2; R4.2; R14.2; R15.2; R16.2; R17.1; R18.2; R30.2; R35.2; R36.2; R37.2; R77.2; S6.2; U1.4 |  |  |  | 71.2064 | 82.94125 | source endpoints listed; fitted access unverified | not audited; verify pin configuration and timer/interrupt ownership
13 |  | NC | NET_20 | isolated non-GPIO |  |  |  |  | 70.6984 | 82.94125 | MCU pad only; no source connector | not audited; verify pin configuration and timer/interrupt ownership
14 |  | ~{RSTOUT} | NET_21 | isolated non-GPIO |  |  |  |  | 70.1904 | 82.94125 | MCU pad only; no source connector | not audited; verify pin configuration and timer/interrupt ownership
15 |  | VREFN | GND | connected in source CAM | C1.1; C2.2; C3.2; C4.1; C5.1; C7.C; C8.1; C9.1; C10.1; C11.1; C12.1; C13.1; C14.1; C31.1; C62.2; C63.2; C64.C; C65.2; C66.2; C67.1; C68.1; C75.2; C76.2; C77.2; C78.2; C79.2; C80.2; C81.2; C82.2; C83.2; C84.2; C85.2; C86.2; C87.2; C88.2; C89.2; C90.2; C91.2; C92.2; C93.2; C94.2; C95.2; C96.2; C97.2; C98.2; C99.2; C101.2; C102.2; D4.A; IC1.11; IC1.31; IC1.41; IC1.55; IC1.72; IC1.83; IC1.97; IC4.3; IC4.4; IC4.7; IC4.8; IC4.13; IC4.16; IC4.18; IC9.3; IC9.7; IC9.8; IC9.13; IC9.16; IC9.18; IC10.1; IC11.2; IC13.2; IC14.3; IC15.3; J1.2; JP7.1; JP7.7; JP9.1; JP9.7; JP12.1; JP12.7; JP14.2; JP15.1; JP15.7; JP16.2; JP18.1; JP18.7; JP19.2; JP21.2; JP22.2; JP23.2; JP26.2; JP72.3; JP73.3; JP92.3; JP93.3; JP122.3; JP123.3; JP152.3; JP153.3; JP182.3; JP183.3; LED1.1; LED2.1; LED3.1; LED4.1; LED9.1; LED10.1; Q4.3; Q5.S; Q6.S; Q7.S; Q8.3; R71.1; R72.1; R74.2; R83.2; R86.2; R87.1; R89.2; R90.2; R91.2; S1.2; S1.4; S2.2; S2.4; S3.2; S6.1; U1.6; U1.CD2; U1.GND1; X14.GND |  |  |  | 69.7078 | 82.94125 | source endpoints listed; fitted access unverified | not audited; verify pin configuration and timer/interrupt ownership
16 |  | RTCX1 | NET_22 | isolated non-GPIO |  |  |  |  | 69.1998 | 82.94125 | MCU pad only; no source connector | not audited; verify pin configuration and timer/interrupt ownership
17 |  | ~{RESET} | RESET | connected in source CAM | R14.1; S1.1 |  |  |  | 68.6918 | 82.94125 | source endpoints listed; fitted access unverified | not audited; verify pin configuration and timer/interrupt ownership
18 |  | RTCX2 | NET_23 | isolated non-GPIO |  |  |  |  | 68.2092 | 82.94125 | MCU pad only; no source connector | not audited; verify pin configuration and timer/interrupt ownership
19 |  | VBAT | 3.3V | connected in source CAM | C1.2; C7.A; C8.2; C9.2; C10.2; C11.2; C12.2; C13.2; C14.2; C31.2; C65.1; C67.2; C68.2; C85.1; C88.1; C91.1; C94.1; C97.1; IC1.10; IC1.12; IC1.28; IC1.42; IC1.54; IC1.71; IC1.84; IC1.96; IC4.17; IC9.4; IC9.17; IC10.2; IC10.4; JP7.2; JP9.2; JP12.2; JP15.2; JP18.2; JP72.1; JP73.1; JP92.1; JP93.1; JP122.1; JP123.1; JP152.1; JP153.1; JP182.1; JP183.1; Q1.4; R1.2; R2.2; R3.2; R4.2; R14.2; R15.2; R16.2; R17.1; R18.2; R30.2; R35.2; R36.2; R37.2; R77.2; S6.2; U1.4 |  |  |  | 67.7012 | 82.94125 | source endpoints listed; fitted access unverified | not audited; verify pin configuration and timer/interrupt ownership
20 | P1.31 | P1[31] | NET_24 | isolated GPIO candidate |  | 5 |  | additional ADC candidate | 67.1932 | 82.94125 | MCU pad only; no source connector | not audited; verify pin configuration and timer/interrupt ownership
21 | P1.30 | P1[30] | NET_25 | isolated GPIO candidate |  | 4 |  | RESERVED vacuum pump/manifold | 66.7106 | 82.94125 | MCU pad only; no source connector | not audited; verify pin configuration and timer/interrupt ownership
22 |  | XTAL1 | $1N722 | connected in source CAM | C2.1; Q2.3 |  |  |  | 66.2026 | 82.94125 | source endpoints listed; fitted access unverified | not audited; verify pin configuration and timer/interrupt ownership
23 |  | XTAL2 | $1N723 | connected in source CAM | C3.1; Q2.1 |  |  |  | 65.6946 | 82.94125 | source endpoints listed; fitted access unverified | not audited; verify pin configuration and timer/interrupt ownership
24 | P0.28 | P0[28] | NET_26 | isolated GPIO candidate |  |  |  |  | 65.1866 | 82.94125 | MCU pad only; no source connector | not audited; verify pin configuration and timer/interrupt ownership
25 | P0.27 | P0[27] | NET_27 | isolated GPIO candidate |  |  |  |  | 64.704 | 82.94125 | MCU pad only; no source connector | not audited; verify pin configuration and timer/interrupt ownership
26 | P3.26 | P3[26] | NET_28 | isolated GPIO candidate |  |  |  |  | 62.8498 | 84.79545 | MCU pad only; no source connector | not audited; verify pin configuration and timer/interrupt ownership
27 | P3.25 | P3[25] | NET_29 | isolated GPIO candidate |  |  |  |  | 62.8498 | 85.27805 | MCU pad only; no source connector | not audited; verify pin configuration and timer/interrupt ownership
28 |  | VDD(3V3) | 3.3V | connected in source CAM | C1.2; C7.A; C8.2; C9.2; C10.2; C11.2; C12.2; C13.2; C14.2; C31.2; C65.1; C67.2; C68.2; C85.1; C88.1; C91.1; C94.1; C97.1; IC1.10; IC1.12; IC1.19; IC1.42; IC1.54; IC1.71; IC1.84; IC1.96; IC4.17; IC9.4; IC9.17; IC10.2; IC10.4; JP7.2; JP9.2; JP12.2; JP15.2; JP18.2; JP72.1; JP73.1; JP92.1; JP93.1; JP122.1; JP123.1; JP152.1; JP153.1; JP182.1; JP183.1; Q1.4; R1.2; R2.2; R3.2; R4.2; R14.2; R15.2; R16.2; R17.1; R18.2; R30.2; R35.2; R36.2; R37.2; R77.2; S6.2; U1.4 |  |  |  | 62.8498 | 85.78605 | source endpoints listed; fitted access unverified | not audited; verify pin configuration and timer/interrupt ownership
29 | P0.29 | P0[29] | USB_D+ | connected in source CAM | C5.2; R7.1; R8.2 |  |  |  | 62.8498 | 86.29405 | source endpoints listed; fitted access unverified | not audited; verify pin configuration and timer/interrupt ownership
30 | P0.30 | P0[30] | USB_D- | connected in source CAM | C4.2; R9.2 |  |  |  | 62.8498 | 86.80205 | source endpoints listed; fitted access unverified | not audited; verify pin configuration and timer/interrupt ownership
31 |  | VSS | GND | connected in source CAM | C1.1; C2.2; C3.2; C4.1; C5.1; C7.C; C8.1; C9.1; C10.1; C11.1; C12.1; C13.1; C14.1; C31.1; C62.2; C63.2; C64.C; C65.2; C66.2; C67.1; C68.1; C75.2; C76.2; C77.2; C78.2; C79.2; C80.2; C81.2; C82.2; C83.2; C84.2; C85.2; C86.2; C87.2; C88.2; C89.2; C90.2; C91.2; C92.2; C93.2; C94.2; C95.2; C96.2; C97.2; C98.2; C99.2; C101.2; C102.2; D4.A; IC1.11; IC1.15; IC1.41; IC1.55; IC1.72; IC1.83; IC1.97; IC4.3; IC4.4; IC4.7; IC4.8; IC4.13; IC4.16; IC4.18; IC9.3; IC9.7; IC9.8; IC9.13; IC9.16; IC9.18; IC10.1; IC11.2; IC13.2; IC14.3; IC15.3; J1.2; JP7.1; JP7.7; JP9.1; JP9.7; JP12.1; JP12.7; JP14.2; JP15.1; JP15.7; JP16.2; JP18.1; JP18.7; JP19.2; JP21.2; JP22.2; JP23.2; JP26.2; JP72.3; JP73.3; JP92.3; JP93.3; JP122.3; JP123.3; JP152.3; JP153.3; JP182.3; JP183.3; LED1.1; LED2.1; LED3.1; LED4.1; LED9.1; LED10.1; Q4.3; Q5.S; Q6.S; Q7.S; Q8.3; R71.1; R72.1; R74.2; R83.2; R86.2; R87.1; R89.2; R90.2; R91.2; S1.2; S1.4; S2.2; S2.4; S3.2; S6.1; U1.6; U1.CD2; U1.GND1; X14.GND |  |  |  | 62.8498 | 87.28465 | source endpoints listed; fitted access unverified | not audited; verify pin configuration and timer/interrupt ownership
32 | P1.18 | P1[18] | LED1 | connected in source CAM | R10.2 |  |  |  | 62.8498 | 87.79265 | source endpoints listed; fitted access unverified | not audited; verify pin configuration and timer/interrupt ownership
33 | P1.19 | P1[19] | LED2 | connected in source CAM | R11.2 |  |  |  | 62.8498 | 88.30065 | source endpoints listed; fitted access unverified | not audited; verify pin configuration and timer/interrupt ownership
34 | P1.20 | P1[20] | LED3 | connected in source CAM | R12.2 |  |  |  | 62.8498 | 88.78325 | source endpoints listed; fitted access unverified | not audited; verify pin configuration and timer/interrupt ownership
35 | P1.21 | P1[21] | LED4 | connected in source CAM | R13.2 |  |  |  | 62.8498 | 89.29125 | source endpoints listed; fitted access unverified | not audited; verify pin configuration and timer/interrupt ownership
36 | P1.22 | P1[22] | P1_22 | connected in source CAM | R82.2; R83.1 |  |  |  | 62.8498 | 89.79925 | source endpoints listed; fitted access unverified | not audited; verify pin configuration and timer/interrupt ownership
37 | P1.23 | P1[23] | P1_23 | connected in source CAM | IC15.2; R87.2 |  |  |  | 62.8498 | 90.28185 | source endpoints listed; fitted access unverified | not audited; verify pin configuration and timer/interrupt ownership
38 | P1.24 | P1[24] | X_MIN | connected in source CAM | C78.1; R92.2 |  |  |  | 62.8498 | 90.78985 | source endpoints listed; fitted access unverified | not audited; verify pin configuration and timer/interrupt ownership
39 | P1.25 | P1[25] | X_MAX | connected in source CAM | C79.1; R95.2 |  |  |  | 62.8498 | 91.29785 | source endpoints listed; fitted access unverified | not audited; verify pin configuration and timer/interrupt ownership
40 | P1.26 | P1[26] | Y_MIN | connected in source CAM | C80.1; R97.2 |  |  |  | 62.8498 | 91.78045 | source endpoints listed; fitted access unverified | not audited; verify pin configuration and timer/interrupt ownership
41 |  | VSS | GND | connected in source CAM | C1.1; C2.2; C3.2; C4.1; C5.1; C7.C; C8.1; C9.1; C10.1; C11.1; C12.1; C13.1; C14.1; C31.1; C62.2; C63.2; C64.C; C65.2; C66.2; C67.1; C68.1; C75.2; C76.2; C77.2; C78.2; C79.2; C80.2; C81.2; C82.2; C83.2; C84.2; C85.2; C86.2; C87.2; C88.2; C89.2; C90.2; C91.2; C92.2; C93.2; C94.2; C95.2; C96.2; C97.2; C98.2; C99.2; C101.2; C102.2; D4.A; IC1.11; IC1.15; IC1.31; IC1.55; IC1.72; IC1.83; IC1.97; IC4.3; IC4.4; IC4.7; IC4.8; IC4.13; IC4.16; IC4.18; IC9.3; IC9.7; IC9.8; IC9.13; IC9.16; IC9.18; IC10.1; IC11.2; IC13.2; IC14.3; IC15.3; J1.2; JP7.1; JP7.7; JP9.1; JP9.7; JP12.1; JP12.7; JP14.2; JP15.1; JP15.7; JP16.2; JP18.1; JP18.7; JP19.2; JP21.2; JP22.2; JP23.2; JP26.2; JP72.3; JP73.3; JP92.3; JP93.3; JP122.3; JP123.3; JP152.3; JP153.3; JP182.3; JP183.3; LED1.1; LED2.1; LED3.1; LED4.1; LED9.1; LED10.1; Q4.3; Q5.S; Q6.S; Q7.S; Q8.3; R71.1; R72.1; R74.2; R83.2; R86.2; R87.1; R89.2; R90.2; R91.2; S1.2; S1.4; S2.2; S2.4; S3.2; S6.1; U1.6; U1.CD2; U1.GND1; X14.GND |  |  |  | 62.8498 | 92.28845 | source endpoints listed; fitted access unverified | not audited; verify pin configuration and timer/interrupt ownership
42 |  | VDD(REG)(3V3) | 3.3V | connected in source CAM | C1.2; C7.A; C8.2; C9.2; C10.2; C11.2; C12.2; C13.2; C14.2; C31.2; C65.1; C67.2; C68.2; C85.1; C88.1; C91.1; C94.1; C97.1; IC1.10; IC1.12; IC1.19; IC1.28; IC1.54; IC1.71; IC1.84; IC1.96; IC4.17; IC9.4; IC9.17; IC10.2; IC10.4; JP7.2; JP9.2; JP12.2; JP15.2; JP18.2; JP72.1; JP73.1; JP92.1; JP93.1; JP122.1; JP123.1; JP152.1; JP153.1; JP182.1; JP183.1; Q1.4; R1.2; R2.2; R3.2; R4.2; R14.2; R15.2; R16.2; R17.1; R18.2; R30.2; R35.2; R36.2; R37.2; R77.2; S6.2; U1.4 |  |  |  | 62.8498 | 92.79645 | source endpoints listed; fitted access unverified | not audited; verify pin configuration and timer/interrupt ownership
43 | P1.27 | P1[27] | Y_MAX | connected in source CAM | C81.1; R99.2 |  |  |  | 62.8498 | 93.27905 | source endpoints listed; fitted access unverified | not audited; verify pin configuration and timer/interrupt ownership
44 | P1.28 | P1[28] | Z_MIN | connected in source CAM | C82.1; R101.2 |  |  |  | 62.8498 | 93.78705 | source endpoints listed; fitted access unverified | not audited; verify pin configuration and timer/interrupt ownership
45 | P1.29 | P1[29] | Z_MAX | connected in source CAM | C83.1; R103.2 |  |  |  | 62.8498 | 94.29505 | source endpoints listed; fitted access unverified | not audited; verify pin configuration and timer/interrupt ownership
46 | P0.0 | P0[0] | POT_SDA | connected in source CAM | IC4.6; IC9.6; R35.1 |  | TXD3 |  | 62.8498 | 94.77765 | source endpoints listed; fitted access unverified | not audited; verify pin configuration and timer/interrupt ownership
47 | P0.1 | P0[1] | POT_SCL | connected in source CAM | IC4.5; IC9.5; R36.1 |  | RXD3 |  | 62.8498 | 95.28565 | source endpoints listed; fitted access unverified | not audited; verify pin configuration and timer/interrupt ownership
48 | P0.10 | P0[10] | EN2 | connected in source CAM | JP91.8 |  | TXD2 |  | 62.8498 | 95.79365 | source endpoints listed; fitted access unverified | not audited; verify pin configuration and timer/interrupt ownership
49 | P0.11 | P0[11] | DIR2 | connected in source CAM | JP91.1 |  | RXD2 |  | 62.8498 | 96.30165 | source endpoints listed; fitted access unverified | not audited; verify pin configuration and timer/interrupt ownership
50 | P2.13 | P2[13] | DIR5 | connected in source CAM | JP181.1 |  |  |  | 62.8498 | 96.78425 | source endpoints listed; fitted access unverified | not audited; verify pin configuration and timer/interrupt ownership
51 | P2.12 | P2[12] | PLAY | connected in source CAM | JP23.1; R16.1; S3.4 |  |  |  | 64.704 | 98.63845 | source endpoints listed; fitted access unverified | not audited; verify pin configuration and timer/interrupt ownership
52 | P2.11 | P2[11] | NET_30 | isolated GPIO candidate |  |  |  | preferred feeder bus candidate | 65.1866 | 98.63845 | MCU pad only; no source connector | not audited; verify pin configuration and timer/interrupt ownership
53 | P2.10 | P2[10] | ISPBOOT | connected in source CAM | R15.1; S2.1 |  |  |  | 65.6946 | 98.63845 | source endpoints listed; fitted access unverified | not audited; verify pin configuration and timer/interrupt ownership
54 |  | VDD(3V3) | 3.3V | connected in source CAM | C1.2; C7.A; C8.2; C9.2; C10.2; C11.2; C12.2; C13.2; C14.2; C31.2; C65.1; C67.2; C68.2; C85.1; C88.1; C91.1; C94.1; C97.1; IC1.10; IC1.12; IC1.19; IC1.28; IC1.42; IC1.71; IC1.84; IC1.96; IC4.17; IC9.4; IC9.17; IC10.2; IC10.4; JP7.2; JP9.2; JP12.2; JP15.2; JP18.2; JP72.1; JP73.1; JP92.1; JP93.1; JP122.1; JP123.1; JP152.1; JP153.1; JP182.1; JP183.1; Q1.4; R1.2; R2.2; R3.2; R4.2; R14.2; R15.2; R16.2; R17.1; R18.2; R30.2; R35.2; R36.2; R37.2; R77.2; S6.2; U1.4 |  |  |  | 66.2026 | 98.63845 | source endpoints listed; fitted access unverified | not audited; verify pin configuration and timer/interrupt ownership
55 |  | VSS | GND | connected in source CAM | C1.1; C2.2; C3.2; C4.1; C5.1; C7.C; C8.1; C9.1; C10.1; C11.1; C12.1; C13.1; C14.1; C31.1; C62.2; C63.2; C64.C; C65.2; C66.2; C67.1; C68.1; C75.2; C76.2; C77.2; C78.2; C79.2; C80.2; C81.2; C82.2; C83.2; C84.2; C85.2; C86.2; C87.2; C88.2; C89.2; C90.2; C91.2; C92.2; C93.2; C94.2; C95.2; C96.2; C97.2; C98.2; C99.2; C101.2; C102.2; D4.A; IC1.11; IC1.15; IC1.31; IC1.41; IC1.72; IC1.83; IC1.97; IC4.3; IC4.4; IC4.7; IC4.8; IC4.13; IC4.16; IC4.18; IC9.3; IC9.7; IC9.8; IC9.13; IC9.16; IC9.18; IC10.1; IC11.2; IC13.2; IC14.3; IC15.3; J1.2; JP7.1; JP7.7; JP9.1; JP9.7; JP12.1; JP12.7; JP14.2; JP15.1; JP15.7; JP16.2; JP18.1; JP18.7; JP19.2; JP21.2; JP22.2; JP23.2; JP26.2; JP72.3; JP73.3; JP92.3; JP93.3; JP122.3; JP123.3; JP152.3; JP153.3; JP182.3; JP183.3; LED1.1; LED2.1; LED3.1; LED4.1; LED9.1; LED10.1; Q4.3; Q5.S; Q6.S; Q7.S; Q8.3; R71.1; R72.1; R74.2; R83.2; R86.2; R87.1; R89.2; R90.2; R91.2; S1.2; S1.4; S2.2; S2.4; S3.2; S6.1; U1.6; U1.CD2; U1.GND1; X14.GND |  |  |  | 66.7106 | 98.63845 | source endpoints listed; fitted access unverified | not audited; verify pin configuration and timer/interrupt ownership
56 | P0.22 | P0[22] | DIR4 | connected in source CAM | JP151.1 |  |  |  | 67.1932 | 98.63845 | source endpoints listed; fitted access unverified | not audited; verify pin configuration and timer/interrupt ownership
57 | P0.21 | P0[21] | EN4 | connected in source CAM | JP151.8 |  |  |  | 67.7012 | 98.63845 | source endpoints listed; fitted access unverified | not audited; verify pin configuration and timer/interrupt ownership
58 | P0.20 | P0[20] | DIR3 | connected in source CAM | JP121.1 |  |  |  | 68.2092 | 98.63845 | source endpoints listed; fitted access unverified | not audited; verify pin configuration and timer/interrupt ownership
59 | P0.19 | P0[19] | EN3 | connected in source CAM | JP121.8 |  |  |  | 68.6918 | 98.63845 | source endpoints listed; fitted access unverified | not audited; verify pin configuration and timer/interrupt ownership
60 | P0.18 | P0[18] | NET_31 | isolated GPIO candidate |  |  |  | alternative feeder bus candidate | 69.1998 | 98.63845 | MCU pad only; no source connector | not audited; verify pin configuration and timer/interrupt ownership
61 | P0.17 | P0[17] | NET_32 | isolated GPIO candidate |  |  |  | alternative feeder bus candidate | 69.7078 | 98.63845 | MCU pad only; no source connector | not audited; verify pin configuration and timer/interrupt ownership
62 | P0.15 | P0[15] | NET_33 | isolated GPIO; UART alternate reserved |  |  | TXD1 |  | 70.1904 | 98.63845 | MCU pad only; no source connector | not audited; verify pin configuration and timer/interrupt ownership
63 | P0.16 | P0[16] | NET_34 | isolated GPIO; UART alternate reserved |  |  | RXD1 |  | 70.6984 | 98.63845 | MCU pad only; no source connector | not audited; verify pin configuration and timer/interrupt ownership
64 | P2.9 | P2[9] | P2.9 | connected in source CAM | Q1.3 |  | RXD2 |  | 71.2064 | 98.63845 | source endpoints listed; fitted access unverified | not audited; verify pin configuration and timer/interrupt ownership
65 | P2.8 | P2[8] | STP5 | connected in source CAM | JP181.2 |  | TXD2 |  | 71.689 | 98.63845 | source endpoints listed; fitted access unverified | not audited; verify pin configuration and timer/interrupt ownership
66 | P2.7 | P2[7] | P2.7 | connected in source CAM | IC14.4; R72.2 |  |  |  | 72.197 | 98.63845 | source endpoints listed; fitted access unverified | not audited; verify pin configuration and timer/interrupt ownership
67 | P2.6 | P2[6] | NET_35 | isolated GPIO candidate |  |  |  |  | 72.705 | 98.63845 | MCU pad only; no source connector | not audited; verify pin configuration and timer/interrupt ownership
68 | P2.5 | P2[5] | PWM1 | connected in source CAM | IC14.2; R71.2 |  |  |  | 73.1876 | 98.63845 | source endpoints listed; fitted access unverified | not audited; verify pin configuration and timer/interrupt ownership
69 | P2.4 | P2[4] | PWM0 | connected in source CAM | R73.2; R74.1 |  |  |  | 73.6956 | 98.63845 | source endpoints listed; fitted access unverified | not audited; verify pin configuration and timer/interrupt ownership
70 | P2.3 | P2[3] | STP4 | connected in source CAM | JP151.2 |  |  |  | 74.2036 | 98.63845 | source endpoints listed; fitted access unverified | not audited; verify pin configuration and timer/interrupt ownership
71 |  | VDD(3V3) | 3.3V | connected in source CAM | C1.2; C7.A; C8.2; C9.2; C10.2; C11.2; C12.2; C13.2; C14.2; C31.2; C65.1; C67.2; C68.2; C85.1; C88.1; C91.1; C94.1; C97.1; IC1.10; IC1.12; IC1.19; IC1.28; IC1.42; IC1.54; IC1.84; IC1.96; IC4.17; IC9.4; IC9.17; IC10.2; IC10.4; JP7.2; JP9.2; JP12.2; JP15.2; JP18.2; JP72.1; JP73.1; JP92.1; JP93.1; JP122.1; JP123.1; JP152.1; JP153.1; JP182.1; JP183.1; Q1.4; R1.2; R2.2; R3.2; R4.2; R14.2; R15.2; R16.2; R17.1; R18.2; R30.2; R35.2; R36.2; R37.2; R77.2; S6.2; U1.4 |  |  |  | 74.6862 | 98.63845 | source endpoints listed; fitted access unverified | not audited; verify pin configuration and timer/interrupt ownership
72 |  | VSS | GND | connected in source CAM | C1.1; C2.2; C3.2; C4.1; C5.1; C7.C; C8.1; C9.1; C10.1; C11.1; C12.1; C13.1; C14.1; C31.1; C62.2; C63.2; C64.C; C65.2; C66.2; C67.1; C68.1; C75.2; C76.2; C77.2; C78.2; C79.2; C80.2; C81.2; C82.2; C83.2; C84.2; C85.2; C86.2; C87.2; C88.2; C89.2; C90.2; C91.2; C92.2; C93.2; C94.2; C95.2; C96.2; C97.2; C98.2; C99.2; C101.2; C102.2; D4.A; IC1.11; IC1.15; IC1.31; IC1.41; IC1.55; IC1.83; IC1.97; IC4.3; IC4.4; IC4.7; IC4.8; IC4.13; IC4.16; IC4.18; IC9.3; IC9.7; IC9.8; IC9.13; IC9.16; IC9.18; IC10.1; IC11.2; IC13.2; IC14.3; IC15.3; J1.2; JP7.1; JP7.7; JP9.1; JP9.7; JP12.1; JP12.7; JP14.2; JP15.1; JP15.7; JP16.2; JP18.1; JP18.7; JP19.2; JP21.2; JP22.2; JP23.2; JP26.2; JP72.3; JP73.3; JP92.3; JP93.3; JP122.3; JP123.3; JP152.3; JP153.3; JP182.3; JP183.3; LED1.1; LED2.1; LED3.1; LED4.1; LED9.1; LED10.1; Q4.3; Q5.S; Q6.S; Q7.S; Q8.3; R71.1; R72.1; R74.2; R83.2; R86.2; R87.1; R89.2; R90.2; R91.2; S1.2; S1.4; S2.2; S2.4; S3.2; S6.1; U1.6; U1.CD2; U1.GND1; X14.GND |  |  |  | 75.1942 | 98.63845 | source endpoints listed; fitted access unverified | not audited; verify pin configuration and timer/interrupt ownership
73 | P2.2 | P2[2] | STP3 | connected in source CAM | JP121.2 |  |  |  | 75.7022 | 98.63845 | source endpoints listed; fitted access unverified | not audited; verify pin configuration and timer/interrupt ownership
74 | P2.1 | P2[1] | STP2 | connected in source CAM | JP91.2 |  | RXD1 |  | 76.2102 | 98.63845 | source endpoints listed; fitted access unverified | not audited; verify pin configuration and timer/interrupt ownership
75 | P2.0 | P2[0] | STP1 | connected in source CAM | JP71.2 |  | TXD1 |  | 76.6928 | 98.63845 | source endpoints listed; fitted access unverified | not audited; verify pin configuration and timer/interrupt ownership
76 | P0.9 | P0[9] | SD_MOSI | connected in source CAM | R3.1; U1.3 |  |  |  | 78.547 | 96.78425 | source endpoints listed; fitted access unverified | not audited; verify pin configuration and timer/interrupt ownership
77 | P0.8 | P0[8] | SD_MISO | connected in source CAM | R2.1; U1.7 |  |  |  | 78.547 | 96.30165 | source endpoints listed; fitted access unverified | not audited; verify pin configuration and timer/interrupt ownership
78 | P0.7 | P0[7] | SD_SCK | connected in source CAM | U1.5 |  |  |  | 78.547 | 95.79365 | source endpoints listed; fitted access unverified | not audited; verify pin configuration and timer/interrupt ownership
79 | P0.6 | P0[6] | SD_CS | connected in source CAM | R1.1; U1.2 |  |  |  | 78.547 | 95.28565 | source endpoints listed; fitted access unverified | not audited; verify pin configuration and timer/interrupt ownership
80 | P0.5 | P0[5] | DIR1 | connected in source CAM | JP71.1 |  |  |  | 78.547 | 94.77765 | source endpoints listed; fitted access unverified | not audited; verify pin configuration and timer/interrupt ownership
81 | P0.4 | P0[4] | EN1 | connected in source CAM | JP71.8 |  |  |  | 78.547 | 94.29505 | source endpoints listed; fitted access unverified | not audited; verify pin configuration and timer/interrupt ownership
82 | P4.28 | P4[28] | PLAY_LED | connected in source CAM | JP24.2; S3.A |  | TXD3 |  | 78.547 | 93.78705 | source endpoints listed; fitted access unverified | not audited; verify pin configuration and timer/interrupt ownership
83 |  | VSS | GND | connected in source CAM | C1.1; C2.2; C3.2; C4.1; C5.1; C7.C; C8.1; C9.1; C10.1; C11.1; C12.1; C13.1; C14.1; C31.1; C62.2; C63.2; C64.C; C65.2; C66.2; C67.1; C68.1; C75.2; C76.2; C77.2; C78.2; C79.2; C80.2; C81.2; C82.2; C83.2; C84.2; C85.2; C86.2; C87.2; C88.2; C89.2; C90.2; C91.2; C92.2; C93.2; C94.2; C95.2; C96.2; C97.2; C98.2; C99.2; C101.2; C102.2; D4.A; IC1.11; IC1.15; IC1.31; IC1.41; IC1.55; IC1.72; IC1.97; IC4.3; IC4.4; IC4.7; IC4.8; IC4.13; IC4.16; IC4.18; IC9.3; IC9.7; IC9.8; IC9.13; IC9.16; IC9.18; IC10.1; IC11.2; IC13.2; IC14.3; IC15.3; J1.2; JP7.1; JP7.7; JP9.1; JP9.7; JP12.1; JP12.7; JP14.2; JP15.1; JP15.7; JP16.2; JP18.1; JP18.7; JP19.2; JP21.2; JP22.2; JP23.2; JP26.2; JP72.3; JP73.3; JP92.3; JP93.3; JP122.3; JP123.3; JP152.3; JP153.3; JP182.3; JP183.3; LED1.1; LED2.1; LED3.1; LED4.1; LED9.1; LED10.1; Q4.3; Q5.S; Q6.S; Q7.S; Q8.3; R71.1; R72.1; R74.2; R83.2; R86.2; R87.1; R89.2; R90.2; R91.2; S1.2; S1.4; S2.2; S2.4; S3.2; S6.1; U1.6; U1.CD2; U1.GND1; X14.GND |  |  |  | 78.547 | 93.27905 | source endpoints listed; fitted access unverified | not audited; verify pin configuration and timer/interrupt ownership
84 |  | VDD(REG)(3V3) | 3.3V | connected in source CAM | C1.2; C7.A; C8.2; C9.2; C10.2; C11.2; C12.2; C13.2; C14.2; C31.2; C65.1; C67.2; C68.2; C85.1; C88.1; C91.1; C94.1; C97.1; IC1.10; IC1.12; IC1.19; IC1.28; IC1.42; IC1.54; IC1.71; IC1.96; IC4.17; IC9.4; IC9.17; IC10.2; IC10.4; JP7.2; JP9.2; JP12.2; JP15.2; JP18.2; JP72.1; JP73.1; JP92.1; JP93.1; JP122.1; JP123.1; JP152.1; JP153.1; JP182.1; JP183.1; Q1.4; R1.2; R2.2; R3.2; R4.2; R14.2; R15.2; R16.2; R17.1; R18.2; R30.2; R35.2; R36.2; R37.2; R77.2; S6.2; U1.4 |  |  |  | 78.547 | 92.79645 | source endpoints listed; fitted access unverified | not audited; verify pin configuration and timer/interrupt ownership
85 | P4.29 | P4[29] | EN5 | connected in source CAM | JP181.8 |  | RXD3 |  | 78.547 | 92.28845 | source endpoints listed; fitted access unverified | not audited; verify pin configuration and timer/interrupt ownership
86 | P1.17 | P1[17] | NET_36 | isolated GPIO candidate |  |  |  |  | 78.547 | 91.78045 | MCU pad only; no source connector | not audited; verify pin configuration and timer/interrupt ownership
87 | P1.16 | P1[16] | NET_37 | isolated GPIO candidate |  |  |  |  | 78.547 | 91.29785 | MCU pad only; no source connector | not audited; verify pin configuration and timer/interrupt ownership
88 | P1.15 | P1[15] | NET_38 | isolated GPIO candidate |  |  |  |  | 78.547 | 90.78985 | MCU pad only; no source connector | not audited; verify pin configuration and timer/interrupt ownership
89 | P1.14 | P1[14] | NET_39 | isolated GPIO candidate |  |  |  |  | 78.547 | 90.28185 | MCU pad only; no source connector | not audited; verify pin configuration and timer/interrupt ownership
90 | P1.10 | P1[10] | NET_40 | isolated GPIO candidate |  |  |  |  | 78.547 | 89.79925 | MCU pad only; no source connector | not audited; verify pin configuration and timer/interrupt ownership
91 | P1.9 | P1[9] | NET_41 | isolated GPIO candidate |  |  |  |  | 78.547 | 89.29125 | MCU pad only; no source connector | not audited; verify pin configuration and timer/interrupt ownership
92 | P1.8 | P1[8] | NET_42 | isolated GPIO candidate |  |  |  |  | 78.547 | 88.78325 | MCU pad only; no source connector | not audited; verify pin configuration and timer/interrupt ownership
93 | P1.4 | P1[4] | NET_43 | isolated GPIO candidate |  |  |  |  | 78.547 | 88.30065 | MCU pad only; no source connector | not audited; verify pin configuration and timer/interrupt ownership
94 | P1.1 | P1[1] | NET_44 | isolated GPIO candidate |  |  |  |  | 78.547 | 87.79265 | MCU pad only; no source connector | not audited; verify pin configuration and timer/interrupt ownership
95 | P1.0 | P1[0] | NET_45 | isolated GPIO candidate |  |  |  |  | 78.547 | 87.28465 | MCU pad only; no source connector | not audited; verify pin configuration and timer/interrupt ownership
96 |  | VDD(3V3) | 3.3V | connected in source CAM | C1.2; C7.A; C8.2; C9.2; C10.2; C11.2; C12.2; C13.2; C14.2; C31.2; C65.1; C67.2; C68.2; C85.1; C88.1; C91.1; C94.1; C97.1; IC1.10; IC1.12; IC1.19; IC1.28; IC1.42; IC1.54; IC1.71; IC1.84; IC4.17; IC9.4; IC9.17; IC10.2; IC10.4; JP7.2; JP9.2; JP12.2; JP15.2; JP18.2; JP72.1; JP73.1; JP92.1; JP93.1; JP122.1; JP123.1; JP152.1; JP153.1; JP182.1; JP183.1; Q1.4; R1.2; R2.2; R3.2; R4.2; R14.2; R15.2; R16.2; R17.1; R18.2; R30.2; R35.2; R36.2; R37.2; R77.2; S6.2; U1.4 |  |  |  | 78.547 | 86.80205 | source endpoints listed; fitted access unverified | not audited; verify pin configuration and timer/interrupt ownership
97 |  | VSS | GND | connected in source CAM | C1.1; C2.2; C3.2; C4.1; C5.1; C7.C; C8.1; C9.1; C10.1; C11.1; C12.1; C13.1; C14.1; C31.1; C62.2; C63.2; C64.C; C65.2; C66.2; C67.1; C68.1; C75.2; C76.2; C77.2; C78.2; C79.2; C80.2; C81.2; C82.2; C83.2; C84.2; C85.2; C86.2; C87.2; C88.2; C89.2; C90.2; C91.2; C92.2; C93.2; C94.2; C95.2; C96.2; C97.2; C98.2; C99.2; C101.2; C102.2; D4.A; IC1.11; IC1.15; IC1.31; IC1.41; IC1.55; IC1.72; IC1.83; IC4.3; IC4.4; IC4.7; IC4.8; IC4.13; IC4.16; IC4.18; IC9.3; IC9.7; IC9.8; IC9.13; IC9.16; IC9.18; IC10.1; IC11.2; IC13.2; IC14.3; IC15.3; J1.2; JP7.1; JP7.7; JP9.1; JP9.7; JP12.1; JP12.7; JP14.2; JP15.1; JP15.7; JP16.2; JP18.1; JP18.7; JP19.2; JP21.2; JP22.2; JP23.2; JP26.2; JP72.3; JP73.3; JP92.3; JP93.3; JP122.3; JP123.3; JP152.3; JP153.3; JP182.3; JP183.3; LED1.1; LED2.1; LED3.1; LED4.1; LED9.1; LED10.1; Q4.3; Q5.S; Q6.S; Q7.S; Q8.3; R71.1; R72.1; R74.2; R83.2; R86.2; R87.1; R89.2; R90.2; R91.2; S1.2; S1.4; S2.2; S2.4; S3.2; S6.1; U1.6; U1.CD2; U1.GND1; X14.GND |  |  |  | 78.547 | 86.29405 | source endpoints listed; fitted access unverified | not audited; verify pin configuration and timer/interrupt ownership
98 | P0.2 | P0[2] | TX_0 | connected in source CAM | S6.3 | 7 | TXD0 | UART0 header reserved | 78.547 | 85.78605 | source endpoints listed; fitted access unverified | not audited; verify pin configuration and timer/interrupt ownership
99 | P0.3 | P0[3] | RX_0 | connected in source CAM | S6.4 | 6 | RXD0 | UART0 header reserved | 78.547 | 85.27805 | source endpoints listed; fitted access unverified | not audited; verify pin configuration and timer/interrupt ownership
100 |  | RTCK | NET_46 | isolated non-GPIO |  |  |  |  | 78.547 | 84.79545 | MCU pad only; no source connector | not audited; verify pin configuration and timer/interrupt ownership
