gabrielyoung92/gabs_microSMT_PickAndPlace/Bing-feeder/V3-Feeder Controller/3D_parts/README.md

# V3 feeder controller parts

> Designs and original files by [MicroSMT](https://github.com/microsmt/Bing-feeder). [Credits and local changes](../../../CREDITS.md).

1 part · [All photos](photos/)

Click a picture for full size; **More views** contains top and bottom views.

## Busbar PCB hook

[STEP](V3_3D_busbar-pcb-hook.step) · [STL](V3_3D_busbar-pcb-hook.stl)

<a href="photos/V3_3D_busbar-pcb-hook.jpg">Busbar pcb hook — original preview</a>

<details>
<summary>More views</summary>

<table>
<tr>
<td align="center"><a href="photos/V3_3D_busbar-pcb-hook-iso-top-1.jpg">Busbar pcb hook — top view 1</a><br><sub>Top 1</sub></td>
<td align="center"><a href="photos/V3_3D_busbar-pcb-hook-iso-top-2.jpg">Busbar pcb hook — top view 2</a><br><sub>Top 2</sub></td>
<td align="center"><a href="photos/V3_3D_busbar-pcb-hook-iso-top-3.jpg">Busbar pcb hook — top view 3</a><br><sub>Top 3</sub></td>
<td align="center"><a href="photos/V3_3D_busbar-pcb-hook-iso-top-4.jpg">Busbar pcb hook — top view 4</a><br><sub>Top 4</sub></td>
</tr>
<tr>
<td align="center"><a href="photos/V3_3D_busbar-pcb-hook-iso-bottom-1.jpg">Busbar pcb hook — bottom view 1</a><br><sub>Bottom 1</sub></td>
<td align="center"><a href="photos/V3_3D_busbar-pcb-hook-iso-bottom-2.jpg">Busbar pcb hook — bottom view 2</a><br><sub>Bottom 2</sub></td>
<td align="center"><a href="photos/V3_3D_busbar-pcb-hook-iso-bottom-3.jpg">Busbar pcb hook — bottom view 3</a><br><sub>Bottom 3</sub></td>
<td align="center"><a href="photos/V3_3D_busbar-pcb-hook-iso-bottom-4.jpg">Busbar pcb hook — bottom view 4</a><br><sub>Bottom 4</sub></td>
</tr>
</table>

</details>
