gabrielyoung92/gabs_microSMT_PickAndPlace/Bing-feeder/V3-feeder/12mm_3D_parts/README.md

# V3 feeder parts — 12 mm

> Designs and original files by [MicroSMT](https://github.com/microsmt/Bing-feeder). [Credits and local changes](../../../CREDITS.md).

14 parts · [All photos](photos/)

Click a picture for full size; **More views** contains top and bottom views.

## 1-position feeder holder

[STEP](V3_3D_feeder-holder-1-position.step) · [STL](V3_3D_feeder-holder-1-position.stl)

<a href="photos/V3_3D_feeder-holder-1-position.jpg">Feeder holder 1 position — original preview</a>

<details>
<summary>More views</summary>

<table>
<tr>
<td align="center"><a href="photos/V3_3D_feeder-holder-1-position-iso-top-1.jpg">Feeder holder 1 position — top view 1</a><br><sub>Top 1</sub></td>
<td align="center"><a href="photos/V3_3D_feeder-holder-1-position-iso-top-2.jpg">Feeder holder 1 position — top view 2</a><br><sub>Top 2</sub></td>
<td align="center"><a href="photos/V3_3D_feeder-holder-1-position-iso-top-3.jpg">Feeder holder 1 position — top view 3</a><br><sub>Top 3</sub></td>
<td align="center"><a href="photos/V3_3D_feeder-holder-1-position-iso-top-4.jpg">Feeder holder 1 position — top view 4</a><br><sub>Top 4</sub></td>
</tr>
<tr>
<td align="center"><a href="photos/V3_3D_feeder-holder-1-position-iso-bottom-1.jpg">Feeder holder 1 position — bottom view 1</a><br><sub>Bottom 1</sub></td>
<td align="center"><a href="photos/V3_3D_feeder-holder-1-position-iso-bottom-2.jpg">Feeder holder 1 position — bottom view 2</a><br><sub>Bottom 2</sub></td>
<td align="center"><a href="photos/V3_3D_feeder-holder-1-position-iso-bottom-3.jpg">Feeder holder 1 position — bottom view 3</a><br><sub>Bottom 3</sub></td>
<td align="center"><a href="photos/V3_3D_feeder-holder-1-position-iso-bottom-4.jpg">Feeder holder 1 position — bottom view 4</a><br><sub>Bottom 4</sub></td>
</tr>
</table>

</details>

## 2-position feeder holder

[STEP](V3_3D_feeder-holder-2-position.step) · [STL](V3_3D_feeder-holder-2-position.stl)

<a href="photos/V3_3D_feeder-holder-2-position.jpg">Feeder holder 2 position — original preview</a>

<details>
<summary>More views</summary>

<table>
<tr>
<td align="center"><a href="photos/V3_3D_feeder-holder-2-position-iso-top-1.jpg">Feeder holder 2 position — top view 1</a><br><sub>Top 1</sub></td>
<td align="center"><a href="photos/V3_3D_feeder-holder-2-position-iso-top-2.jpg">Feeder holder 2 position — top view 2</a><br><sub>Top 2</sub></td>
<td align="center"><a href="photos/V3_3D_feeder-holder-2-position-iso-top-3.jpg">Feeder holder 2 position — top view 3</a><br><sub>Top 3</sub></td>
<td align="center"><a href="photos/V3_3D_feeder-holder-2-position-iso-top-4.jpg">Feeder holder 2 position — top view 4</a><br><sub>Top 4</sub></td>
</tr>
<tr>
<td align="center"><a href="photos/V3_3D_feeder-holder-2-position-iso-bottom-1.jpg">Feeder holder 2 position — bottom view 1</a><br><sub>Bottom 1</sub></td>
<td align="center"><a href="photos/V3_3D_feeder-holder-2-position-iso-bottom-2.jpg">Feeder holder 2 position — bottom view 2</a><br><sub>Bottom 2</sub></td>
<td align="center"><a href="photos/V3_3D_feeder-holder-2-position-iso-bottom-3.jpg">Feeder holder 2 position — bottom view 3</a><br><sub>Bottom 3</sub></td>
<td align="center"><a href="photos/V3_3D_feeder-holder-2-position-iso-bottom-4.jpg">Feeder holder 2 position — bottom view 4</a><br><sub>Bottom 4</sub></td>
</tr>
</table>

</details>

## 4-position feeder holder

[STEP](V3_3D_feeder-holder-4-position.step) · [STL](V3_3D_feeder-holder-4-position.stl)

<a href="photos/V3_3D_feeder-holder-4-position.jpg">Feeder holder 4 position — original preview</a>

<details>
<summary>More views</summary>

<table>
<tr>
<td align="center"><a href="photos/V3_3D_feeder-holder-4-position-iso-top-1.jpg">Feeder holder 4 position — top view 1</a><br><sub>Top 1</sub></td>
<td align="center"><a href="photos/V3_3D_feeder-holder-4-position-iso-top-2.jpg">Feeder holder 4 position — top view 2</a><br><sub>Top 2</sub></td>
<td align="center"><a href="photos/V3_3D_feeder-holder-4-position-iso-top-3.jpg">Feeder holder 4 position — top view 3</a><br><sub>Top 3</sub></td>
<td align="center"><a href="photos/V3_3D_feeder-holder-4-position-iso-top-4.jpg">Feeder holder 4 position — top view 4</a><br><sub>Top 4</sub></td>
</tr>
<tr>
<td align="center"><a href="photos/V3_3D_feeder-holder-4-position-iso-bottom-1.jpg">Feeder holder 4 position — bottom view 1</a><br><sub>Bottom 1</sub></td>
<td align="center"><a href="photos/V3_3D_feeder-holder-4-position-iso-bottom-2.jpg">Feeder holder 4 position — bottom view 2</a><br><sub>Bottom 2</sub></td>
<td align="center"><a href="photos/V3_3D_feeder-holder-4-position-iso-bottom-3.jpg">Feeder holder 4 position — bottom view 3</a><br><sub>Bottom 3</sub></td>
<td align="center"><a href="photos/V3_3D_feeder-holder-4-position-iso-bottom-4.jpg">Feeder holder 4 position — bottom view 4</a><br><sub>Bottom 4</sub></td>
</tr>
</table>

</details>

## 1-position feeder slot

[STEP](V3_3D_feeder-slot-1-position.step) · [STL](V3_3D_feeder-slot-1-position.stl)

<a href="photos/V3_3D_feeder-slot-1-position.jpg">Feeder slot 1 position — original preview</a>

<details>
<summary>More views</summary>

<table>
<tr>
<td align="center"><a href="photos/V3_3D_feeder-slot-1-position-iso-top-1.jpg">Feeder slot 1 position — top view 1</a><br><sub>Top 1</sub></td>
<td align="center"><a href="photos/V3_3D_feeder-slot-1-position-iso-top-2.jpg">Feeder slot 1 position — top view 2</a><br><sub>Top 2</sub></td>
<td align="center"><a href="photos/V3_3D_feeder-slot-1-position-iso-top-3.jpg">Feeder slot 1 position — top view 3</a><br><sub>Top 3</sub></td>
<td align="center"><a href="photos/V3_3D_feeder-slot-1-position-iso-top-4.jpg">Feeder slot 1 position — top view 4</a><br><sub>Top 4</sub></td>
</tr>
<tr>
<td align="center"><a href="photos/V3_3D_feeder-slot-1-position-iso-bottom-1.jpg">Feeder slot 1 position — bottom view 1</a><br><sub>Bottom 1</sub></td>
<td align="center"><a href="photos/V3_3D_feeder-slot-1-position-iso-bottom-2.jpg">Feeder slot 1 position — bottom view 2</a><br><sub>Bottom 2</sub></td>
<td align="center"><a href="photos/V3_3D_feeder-slot-1-position-iso-bottom-3.jpg">Feeder slot 1 position — bottom view 3</a><br><sub>Bottom 3</sub></td>
<td align="center"><a href="photos/V3_3D_feeder-slot-1-position-iso-bottom-4.jpg">Feeder slot 1 position — bottom view 4</a><br><sub>Bottom 4</sub></td>
</tr>
</table>

</details>

## 2-position feeder slot

[STEP](V3_3D_feeder-slot-2-position.step) · [STL](V3_3D_feeder-slot-2-position.stl)

<a href="photos/V3_3D_feeder-slot-2-position.jpg">Feeder slot 2 position — original preview</a>

<details>
<summary>More views</summary>

<table>
<tr>
<td align="center"><a href="photos/V3_3D_feeder-slot-2-position-iso-top-1.jpg">Feeder slot 2 position — top view 1</a><br><sub>Top 1</sub></td>
<td align="center"><a href="photos/V3_3D_feeder-slot-2-position-iso-top-2.jpg">Feeder slot 2 position — top view 2</a><br><sub>Top 2</sub></td>
<td align="center"><a href="photos/V3_3D_feeder-slot-2-position-iso-top-3.jpg">Feeder slot 2 position — top view 3</a><br><sub>Top 3</sub></td>
<td align="center"><a href="photos/V3_3D_feeder-slot-2-position-iso-top-4.jpg">Feeder slot 2 position — top view 4</a><br><sub>Top 4</sub></td>
</tr>
<tr>
<td align="center"><a href="photos/V3_3D_feeder-slot-2-position-iso-bottom-1.jpg">Feeder slot 2 position — bottom view 1</a><br><sub>Bottom 1</sub></td>
<td align="center"><a href="photos/V3_3D_feeder-slot-2-position-iso-bottom-2.jpg">Feeder slot 2 position — bottom view 2</a><br><sub>Bottom 2</sub></td>
<td align="center"><a href="photos/V3_3D_feeder-slot-2-position-iso-bottom-3.jpg">Feeder slot 2 position — bottom view 3</a><br><sub>Bottom 3</sub></td>
<td align="center"><a href="photos/V3_3D_feeder-slot-2-position-iso-bottom-4.jpg">Feeder slot 2 position — bottom view 4</a><br><sub>Bottom 4</sub></td>
</tr>
</table>

</details>

## 4-position feeder slot

[STEP](V3_3D_feeder-slot-4-position.step) · [STL](V3_3D_feeder-slot-4-position.stl)

<a href="photos/V3_3D_feeder-slot-4-position.jpg">Feeder slot 4 position — original preview</a>

<details>
<summary>More views</summary>

<table>
<tr>
<td align="center"><a href="photos/V3_3D_feeder-slot-4-position-iso-top-1.jpg">Feeder slot 4 position — top view 1</a><br><sub>Top 1</sub></td>
<td align="center"><a href="photos/V3_3D_feeder-slot-4-position-iso-top-2.jpg">Feeder slot 4 position — top view 2</a><br><sub>Top 2</sub></td>
<td align="center"><a href="photos/V3_3D_feeder-slot-4-position-iso-top-3.jpg">Feeder slot 4 position — top view 3</a><br><sub>Top 3</sub></td>
<td align="center"><a href="photos/V3_3D_feeder-slot-4-position-iso-top-4.jpg">Feeder slot 4 position — top view 4</a><br><sub>Top 4</sub></td>
</tr>
<tr>
<td align="center"><a href="photos/V3_3D_feeder-slot-4-position-iso-bottom-1.jpg">Feeder slot 4 position — bottom view 1</a><br><sub>Bottom 1</sub></td>
<td align="center"><a href="photos/V3_3D_feeder-slot-4-position-iso-bottom-2.jpg">Feeder slot 4 position — bottom view 2</a><br><sub>Bottom 2</sub></td>
<td align="center"><a href="photos/V3_3D_feeder-slot-4-position-iso-bottom-3.jpg">Feeder slot 4 position — bottom view 3</a><br><sub>Bottom 3</sub></td>
<td align="center"><a href="photos/V3_3D_feeder-slot-4-position-iso-bottom-4.jpg">Feeder slot 4 position — bottom view 4</a><br><sub>Bottom 4</sub></td>
</tr>
</table>

</details>

## 15T gear — module 0.7, 10 mm

[STEP](V3_3D_gear-15t-module-0.7-10mm.step) · [STL](V3_3D_gear-15t-module-0.7-10mm.stl)

<a href="photos/V3_3D_gear-15t-module-0.7-10mm.jpg">Gear 15t module 0.7 10mm — original preview</a>

<details>
<summary>More views</summary>

<table>
<tr>
<td align="center"><a href="photos/V3_3D_gear-15t-module-0.7-10mm-iso-top-1.jpg">Gear 15t module 0.7 10mm — top view 1</a><br><sub>Top 1</sub></td>
<td align="center"><a href="photos/V3_3D_gear-15t-module-0.7-10mm-iso-top-2.jpg">Gear 15t module 0.7 10mm — top view 2</a><br><sub>Top 2</sub></td>
<td align="center"><a href="photos/V3_3D_gear-15t-module-0.7-10mm-iso-top-3.jpg">Gear 15t module 0.7 10mm — top view 3</a><br><sub>Top 3</sub></td>
<td align="center"><a href="photos/V3_3D_gear-15t-module-0.7-10mm-iso-top-4.jpg">Gear 15t module 0.7 10mm — top view 4</a><br><sub>Top 4</sub></td>
</tr>
<tr>
<td align="center"><a href="photos/V3_3D_gear-15t-module-0.7-10mm-iso-bottom-1.jpg">Gear 15t module 0.7 10mm — bottom view 1</a><br><sub>Bottom 1</sub></td>
<td align="center"><a href="photos/V3_3D_gear-15t-module-0.7-10mm-iso-bottom-2.jpg">Gear 15t module 0.7 10mm — bottom view 2</a><br><sub>Bottom 2</sub></td>
<td align="center"><a href="photos/V3_3D_gear-15t-module-0.7-10mm-iso-bottom-3.jpg">Gear 15t module 0.7 10mm — bottom view 3</a><br><sub>Bottom 3</sub></td>
<td align="center"><a href="photos/V3_3D_gear-15t-module-0.7-10mm-iso-bottom-4.jpg">Gear 15t module 0.7 10mm — bottom view 4</a><br><sub>Bottom 4</sub></td>
</tr>
</table>

</details>

## 16T gear bracket

[STEP](V3_3D_gear-16t-bracket.step) · [STL](V3_3D_gear-16t-bracket.stl)

<a href="photos/V3_3D_gear-16t-bracket.jpg">Gear 16t bracket — original preview</a>

<details>
<summary>More views</summary>

<table>
<tr>
<td align="center"><a href="photos/V3_3D_gear-16t-bracket-iso-top-1.jpg">Gear 16t bracket — top view 1</a><br><sub>Top 1</sub></td>
<td align="center"><a href="photos/V3_3D_gear-16t-bracket-iso-top-2.jpg">Gear 16t bracket — top view 2</a><br><sub>Top 2</sub></td>
<td align="center"><a href="photos/V3_3D_gear-16t-bracket-iso-top-3.jpg">Gear 16t bracket — top view 3</a><br><sub>Top 3</sub></td>
<td align="center"><a href="photos/V3_3D_gear-16t-bracket-iso-top-4.jpg">Gear 16t bracket — top view 4</a><br><sub>Top 4</sub></td>
</tr>
<tr>
<td align="center"><a href="photos/V3_3D_gear-16t-bracket-iso-bottom-1.jpg">Gear 16t bracket — bottom view 1</a><br><sub>Bottom 1</sub></td>
<td align="center"><a href="photos/V3_3D_gear-16t-bracket-iso-bottom-2.jpg">Gear 16t bracket — bottom view 2</a><br><sub>Bottom 2</sub></td>
<td align="center"><a href="photos/V3_3D_gear-16t-bracket-iso-bottom-3.jpg">Gear 16t bracket — bottom view 3</a><br><sub>Bottom 3</sub></td>
<td align="center"><a href="photos/V3_3D_gear-16t-bracket-iso-bottom-4.jpg">Gear 16t bracket — bottom view 4</a><br><sub>Bottom 4</sub></td>
</tr>
</table>

</details>

## 16T gear — module 0.7, 10 mm

[STEP](V3_3D_gear-16t-module-0.7-10mm.step) · [STL](V3_3D_gear-16t-module-0.7-10mm.stl)

<a href="photos/V3_3D_gear-16t-module-0.7-10mm.jpg">Gear 16t module 0.7 10mm — original preview</a>

<details>
<summary>More views</summary>

<table>
<tr>
<td align="center"><a href="photos/V3_3D_gear-16t-module-0.7-10mm-iso-top-1.jpg">Gear 16t module 0.7 10mm — top view 1</a><br><sub>Top 1</sub></td>
<td align="center"><a href="photos/V3_3D_gear-16t-module-0.7-10mm-iso-top-2.jpg">Gear 16t module 0.7 10mm — top view 2</a><br><sub>Top 2</sub></td>
<td align="center"><a href="photos/V3_3D_gear-16t-module-0.7-10mm-iso-top-3.jpg">Gear 16t module 0.7 10mm — top view 3</a><br><sub>Top 3</sub></td>
<td align="center"><a href="photos/V3_3D_gear-16t-module-0.7-10mm-iso-top-4.jpg">Gear 16t module 0.7 10mm — top view 4</a><br><sub>Top 4</sub></td>
</tr>
<tr>
<td align="center"><a href="photos/V3_3D_gear-16t-module-0.7-10mm-iso-bottom-1.jpg">Gear 16t module 0.7 10mm — bottom view 1</a><br><sub>Bottom 1</sub></td>
<td align="center"><a href="photos/V3_3D_gear-16t-module-0.7-10mm-iso-bottom-2.jpg">Gear 16t module 0.7 10mm — bottom view 2</a><br><sub>Bottom 2</sub></td>
<td align="center"><a href="photos/V3_3D_gear-16t-module-0.7-10mm-iso-bottom-3.jpg">Gear 16t module 0.7 10mm — bottom view 3</a><br><sub>Bottom 3</sub></td>
<td align="center"><a href="photos/V3_3D_gear-16t-module-0.7-10mm-iso-bottom-4.jpg">Gear 16t module 0.7 10mm — bottom view 4</a><br><sub>Bottom 4</sub></td>
</tr>
</table>

</details>

## Main body

[STEP](V3_3D_main-body.step) · [STL](V3_3D_main-body.stl)

<a href="photos/V3_3D_main-body.jpg">Main body — original preview</a>

<details>
<summary>More views</summary>

<table>
<tr>
<td align="center"><a href="photos/V3_3D_main-body-iso-top-1.jpg">Main body — top view 1</a><br><sub>Top 1</sub></td>
<td align="center"><a href="photos/V3_3D_main-body-iso-top-2.jpg">Main body — top view 2</a><br><sub>Top 2</sub></td>
<td align="center"><a href="photos/V3_3D_main-body-iso-top-3.jpg">Main body — top view 3</a><br><sub>Top 3</sub></td>
<td align="center"><a href="photos/V3_3D_main-body-iso-top-4.jpg">Main body — top view 4</a><br><sub>Top 4</sub></td>
</tr>
<tr>
<td align="center"><a href="photos/V3_3D_main-body-iso-bottom-1.jpg">Main body — bottom view 1</a><br><sub>Bottom 1</sub></td>
<td align="center"><a href="photos/V3_3D_main-body-iso-bottom-2.jpg">Main body — bottom view 2</a><br><sub>Bottom 2</sub></td>
<td align="center"><a href="photos/V3_3D_main-body-iso-bottom-3.jpg">Main body — bottom view 3</a><br><sub>Bottom 3</sub></td>
<td align="center"><a href="photos/V3_3D_main-body-iso-bottom-4.jpg">Main body — bottom view 4</a><br><sub>Bottom 4</sub></td>
</tr>
</table>

</details>

## Switch trigger

[STEP](V3_3D_switch-trigger.step) · [STL](V3_3D_switch-trigger.stl)

<a href="photos/V3_3D_switch-trigger.jpg">Switch trigger — original preview</a>

<details>
<summary>More views</summary>

<table>
<tr>
<td align="center"><a href="photos/V3_3D_switch-trigger-iso-top-1.jpg">Switch trigger — top view 1</a><br><sub>Top 1</sub></td>
<td align="center"><a href="photos/V3_3D_switch-trigger-iso-top-2.jpg">Switch trigger — top view 2</a><br><sub>Top 2</sub></td>
<td align="center"><a href="photos/V3_3D_switch-trigger-iso-top-3.jpg">Switch trigger — top view 3</a><br><sub>Top 3</sub></td>
<td align="center"><a href="photos/V3_3D_switch-trigger-iso-top-4.jpg">Switch trigger — top view 4</a><br><sub>Top 4</sub></td>
</tr>
<tr>
<td align="center"><a href="photos/V3_3D_switch-trigger-iso-bottom-1.jpg">Switch trigger — bottom view 1</a><br><sub>Bottom 1</sub></td>
<td align="center"><a href="photos/V3_3D_switch-trigger-iso-bottom-2.jpg">Switch trigger — bottom view 2</a><br><sub>Bottom 2</sub></td>
<td align="center"><a href="photos/V3_3D_switch-trigger-iso-bottom-3.jpg">Switch trigger — bottom view 3</a><br><sub>Bottom 3</sub></td>
<td align="center"><a href="photos/V3_3D_switch-trigger-iso-bottom-4.jpg">Switch trigger — bottom view 4</a><br><sub>Bottom 4</sub></td>
</tr>
</table>

</details>

## Switch trigger cover

[STEP](V3_3D_switch-trigger-cover.step) · [STL](V3_3D_switch-trigger-cover.stl) · [Supplied 3MF](../PRINT_projects/V3_12mm_switch-trigger-cover.3mf)

<a href="photos/V3_3D_switch-trigger-cover.jpg">Switch trigger cover — original preview</a>

<details>
<summary>More views</summary>

<table>
<tr>
<td align="center"><a href="photos/V3_3D_switch-trigger-cover-iso-top-1.jpg">Switch trigger cover — top view 1</a><br><sub>Top 1</sub></td>
<td align="center"><a href="photos/V3_3D_switch-trigger-cover-iso-top-2.jpg">Switch trigger cover — top view 2</a><br><sub>Top 2</sub></td>
<td align="center"><a href="photos/V3_3D_switch-trigger-cover-iso-top-3.jpg">Switch trigger cover — top view 3</a><br><sub>Top 3</sub></td>
<td align="center"><a href="photos/V3_3D_switch-trigger-cover-iso-top-4.jpg">Switch trigger cover — top view 4</a><br><sub>Top 4</sub></td>
</tr>
<tr>
<td align="center"><a href="photos/V3_3D_switch-trigger-cover-iso-bottom-1.jpg">Switch trigger cover — bottom view 1</a><br><sub>Bottom 1</sub></td>
<td align="center"><a href="photos/V3_3D_switch-trigger-cover-iso-bottom-2.jpg">Switch trigger cover — bottom view 2</a><br><sub>Bottom 2</sub></td>
<td align="center"><a href="photos/V3_3D_switch-trigger-cover-iso-bottom-3.jpg">Switch trigger cover — bottom view 3</a><br><sub>Bottom 3</sub></td>
<td align="center"><a href="photos/V3_3D_switch-trigger-cover-iso-bottom-4.jpg">Switch trigger cover — bottom view 4</a><br><sub>Bottom 4</sub></td>
</tr>
</table>

</details>

## Tape cover

[STEP](V3_3D_tape-cover.step) · [STL](V3_3D_tape-cover.stl)

<a href="photos/V3_3D_tape-cover.jpg">Tape cover — original preview</a>

<details>
<summary>More views</summary>

<table>
<tr>
<td align="center"><a href="photos/V3_3D_tape-cover-iso-top-1.jpg">Tape cover — top view 1</a><br><sub>Top 1</sub></td>
<td align="center"><a href="photos/V3_3D_tape-cover-iso-top-2.jpg">Tape cover — top view 2</a><br><sub>Top 2</sub></td>
<td align="center"><a href="photos/V3_3D_tape-cover-iso-top-3.jpg">Tape cover — top view 3</a><br><sub>Top 3</sub></td>
<td align="center"><a href="photos/V3_3D_tape-cover-iso-top-4.jpg">Tape cover — top view 4</a><br><sub>Top 4</sub></td>
</tr>
<tr>
<td align="center"><a href="photos/V3_3D_tape-cover-iso-bottom-1.jpg">Tape cover — bottom view 1</a><br><sub>Bottom 1</sub></td>
<td align="center"><a href="photos/V3_3D_tape-cover-iso-bottom-2.jpg">Tape cover — bottom view 2</a><br><sub>Bottom 2</sub></td>
<td align="center"><a href="photos/V3_3D_tape-cover-iso-bottom-3.jpg">Tape cover — bottom view 3</a><br><sub>Bottom 3</sub></td>
<td align="center"><a href="photos/V3_3D_tape-cover-iso-bottom-4.jpg">Tape cover — bottom view 4</a><br><sub>Bottom 4</sub></td>
</tr>
</table>

</details>

## Worm motor support

[STEP](V3_3D_worm-motor-support.step) · [STL](V3_3D_worm-motor-support.stl)

<a href="photos/V3_3D_worm-motor-support.jpg">Worm motor support — original preview</a>

<details>
<summary>More views</summary>

<table>
<tr>
<td align="center"><a href="photos/V3_3D_worm-motor-support-iso-top-1.jpg">Worm motor support — top view 1</a><br><sub>Top 1</sub></td>
<td align="center"><a href="photos/V3_3D_worm-motor-support-iso-top-2.jpg">Worm motor support — top view 2</a><br><sub>Top 2</sub></td>
<td align="center"><a href="photos/V3_3D_worm-motor-support-iso-top-3.jpg">Worm motor support — top view 3</a><br><sub>Top 3</sub></td>
<td align="center"><a href="photos/V3_3D_worm-motor-support-iso-top-4.jpg">Worm motor support — top view 4</a><br><sub>Top 4</sub></td>
</tr>
<tr>
<td align="center"><a href="photos/V3_3D_worm-motor-support-iso-bottom-1.jpg">Worm motor support — bottom view 1</a><br><sub>Bottom 1</sub></td>
<td align="center"><a href="photos/V3_3D_worm-motor-support-iso-bottom-2.jpg">Worm motor support — bottom view 2</a><br><sub>Bottom 2</sub></td>
<td align="center"><a href="photos/V3_3D_worm-motor-support-iso-bottom-3.jpg">Worm motor support — bottom view 3</a><br><sub>Bottom 3</sub></td>
<td align="center"><a href="photos/V3_3D_worm-motor-support-iso-bottom-4.jpg">Worm motor support — bottom view 4</a><br><sub>Bottom 4</sub></td>
</tr>
</table>

</details>
