gabrielyoung92/gabs_microSMT_PickAndPlace/Bing-feeder/V3-feeder/shared_3D_parts/README.md

# V3 feeder parts — shared

> Designs and original files by [MicroSMT](https://github.com/microsmt/Bing-feeder). [Credits and local changes](../../../CREDITS.md).

7 parts · [All photos](photos/)

The wider-feeder download also includes the [45T gear for a 684ZZ bearing](../8mm_3D_parts/README.md#45t-gear-for-a-684zz-bearing), which is listed in the 8 mm folder.

Click a picture for full size; **More views** contains top and bottom views.

## 45T gear

[STEP](V3_3D_gear-45t.step) · [STL](V3_3D_gear-45t.stl)

<a href="photos/V3_3D_gear-45t.jpg">Gear 45t — original preview</a>

<details>
<summary>More views</summary>

<table>
<tr>
<td align="center"><a href="photos/V3_3D_gear-45t-iso-top-1.jpg">Gear 45t — top view 1</a><br><sub>Top 1</sub></td>
<td align="center"><a href="photos/V3_3D_gear-45t-iso-top-2.jpg">Gear 45t — top view 2</a><br><sub>Top 2</sub></td>
<td align="center"><a href="photos/V3_3D_gear-45t-iso-top-3.jpg">Gear 45t — top view 3</a><br><sub>Top 3</sub></td>
<td align="center"><a href="photos/V3_3D_gear-45t-iso-top-4.jpg">Gear 45t — top view 4</a><br><sub>Top 4</sub></td>
</tr>
<tr>
<td align="center"><a href="photos/V3_3D_gear-45t-iso-bottom-1.jpg">Gear 45t — bottom view 1</a><br><sub>Bottom 1</sub></td>
<td align="center"><a href="photos/V3_3D_gear-45t-iso-bottom-2.jpg">Gear 45t — bottom view 2</a><br><sub>Bottom 2</sub></td>
<td align="center"><a href="photos/V3_3D_gear-45t-iso-bottom-3.jpg">Gear 45t — bottom view 3</a><br><sub>Bottom 3</sub></td>
<td align="center"><a href="photos/V3_3D_gear-45t-iso-bottom-4.jpg">Gear 45t — bottom view 4</a><br><sub>Bottom 4</sub></td>
</tr>
</table>

</details>

## 55T gear for 12/16/24 mm

[STEP](V3_3D_gear-55t-12-16-24mm.step) · [STL](V3_3D_gear-55t-12-16-24mm.stl)

<a href="photos/V3_3D_gear-55t-12-16-24mm.jpg">Gear 55t 12 16 24mm — original preview</a>

<details>
<summary>More views</summary>

<table>
<tr>
<td align="center"><a href="photos/V3_3D_gear-55t-12-16-24mm-iso-top-1.jpg">Gear 55t 12 16 24mm — top view 1</a><br><sub>Top 1</sub></td>
<td align="center"><a href="photos/V3_3D_gear-55t-12-16-24mm-iso-top-2.jpg">Gear 55t 12 16 24mm — top view 2</a><br><sub>Top 2</sub></td>
<td align="center"><a href="photos/V3_3D_gear-55t-12-16-24mm-iso-top-3.jpg">Gear 55t 12 16 24mm — top view 3</a><br><sub>Top 3</sub></td>
<td align="center"><a href="photos/V3_3D_gear-55t-12-16-24mm-iso-top-4.jpg">Gear 55t 12 16 24mm — top view 4</a><br><sub>Top 4</sub></td>
</tr>
<tr>
<td align="center"><a href="photos/V3_3D_gear-55t-12-16-24mm-iso-bottom-1.jpg">Gear 55t 12 16 24mm — bottom view 1</a><br><sub>Bottom 1</sub></td>
<td align="center"><a href="photos/V3_3D_gear-55t-12-16-24mm-iso-bottom-2.jpg">Gear 55t 12 16 24mm — bottom view 2</a><br><sub>Bottom 2</sub></td>
<td align="center"><a href="photos/V3_3D_gear-55t-12-16-24mm-iso-bottom-3.jpg">Gear 55t 12 16 24mm — bottom view 3</a><br><sub>Bottom 3</sub></td>
<td align="center"><a href="photos/V3_3D_gear-55t-12-16-24mm-iso-bottom-4.jpg">Gear 55t 12 16 24mm — bottom view 4</a><br><sub>Bottom 4</sub></td>
</tr>
</table>

</details>

## PCB cover for 12/16 mm

[STEP](V3_3D_pcb-cover-12-16mm.step) · [STL](V3_3D_pcb-cover-12-16mm.stl)

<a href="photos/V3_3D_pcb-cover-12-16mm.jpg">Pcb cover 12 16mm — original preview</a>

<details>
<summary>More views</summary>

<table>
<tr>
<td align="center"><a href="photos/V3_3D_pcb-cover-12-16mm-iso-top-1.jpg">Pcb cover 12 16mm — top view 1</a><br><sub>Top 1</sub></td>
<td align="center"><a href="photos/V3_3D_pcb-cover-12-16mm-iso-top-2.jpg">Pcb cover 12 16mm — top view 2</a><br><sub>Top 2</sub></td>
<td align="center"><a href="photos/V3_3D_pcb-cover-12-16mm-iso-top-3.jpg">Pcb cover 12 16mm — top view 3</a><br><sub>Top 3</sub></td>
<td align="center"><a href="photos/V3_3D_pcb-cover-12-16mm-iso-top-4.jpg">Pcb cover 12 16mm — top view 4</a><br><sub>Top 4</sub></td>
</tr>
<tr>
<td align="center"><a href="photos/V3_3D_pcb-cover-12-16mm-iso-bottom-1.jpg">Pcb cover 12 16mm — bottom view 1</a><br><sub>Bottom 1</sub></td>
<td align="center"><a href="photos/V3_3D_pcb-cover-12-16mm-iso-bottom-2.jpg">Pcb cover 12 16mm — bottom view 2</a><br><sub>Bottom 2</sub></td>
<td align="center"><a href="photos/V3_3D_pcb-cover-12-16mm-iso-bottom-3.jpg">Pcb cover 12 16mm — bottom view 3</a><br><sub>Bottom 3</sub></td>
<td align="center"><a href="photos/V3_3D_pcb-cover-12-16mm-iso-bottom-4.jpg">Pcb cover 12 16mm — bottom view 4</a><br><sub>Bottom 4</sub></td>
</tr>
</table>

</details>

## Spool hook, 13 mm

[STEP](V3_3D_spool-hook-13mm.step) · [STL](V3_3D_spool-hook-13mm.stl)

<a href="photos/V3_3D_spool-hook-13mm.jpg">Spool hook 13mm — original preview</a>

<details>
<summary>More views</summary>

<table>
<tr>
<td align="center"><a href="photos/V3_3D_spool-hook-13mm-iso-top-1.jpg">Spool hook 13mm — top view 1</a><br><sub>Top 1</sub></td>
<td align="center"><a href="photos/V3_3D_spool-hook-13mm-iso-top-2.jpg">Spool hook 13mm — top view 2</a><br><sub>Top 2</sub></td>
<td align="center"><a href="photos/V3_3D_spool-hook-13mm-iso-top-3.jpg">Spool hook 13mm — top view 3</a><br><sub>Top 3</sub></td>
<td align="center"><a href="photos/V3_3D_spool-hook-13mm-iso-top-4.jpg">Spool hook 13mm — top view 4</a><br><sub>Top 4</sub></td>
</tr>
<tr>
<td align="center"><a href="photos/V3_3D_spool-hook-13mm-iso-bottom-1.jpg">Spool hook 13mm — bottom view 1</a><br><sub>Bottom 1</sub></td>
<td align="center"><a href="photos/V3_3D_spool-hook-13mm-iso-bottom-2.jpg">Spool hook 13mm — bottom view 2</a><br><sub>Bottom 2</sub></td>
<td align="center"><a href="photos/V3_3D_spool-hook-13mm-iso-bottom-3.jpg">Spool hook 13mm — bottom view 3</a><br><sub>Bottom 3</sub></td>
<td align="center"><a href="photos/V3_3D_spool-hook-13mm-iso-bottom-4.jpg">Spool hook 13mm — bottom view 4</a><br><sub>Bottom 4</sub></td>
</tr>
</table>

</details>

## Spool hook B, 11.5 mm

[STEP](V3_3D_spool-hook-b-11.5mm.step) · [STL](V3_3D_spool-hook-b-11.5mm.stl)

<a href="photos/V3_3D_spool-hook-b-11.5mm.jpg">Spool hook b 11.5mm — original preview</a>

<details>
<summary>More views</summary>

<table>
<tr>
<td align="center"><a href="photos/V3_3D_spool-hook-b-11.5mm-iso-top-1.jpg">Spool hook b 11.5mm — top view 1</a><br><sub>Top 1</sub></td>
<td align="center"><a href="photos/V3_3D_spool-hook-b-11.5mm-iso-top-2.jpg">Spool hook b 11.5mm — top view 2</a><br><sub>Top 2</sub></td>
<td align="center"><a href="photos/V3_3D_spool-hook-b-11.5mm-iso-top-3.jpg">Spool hook b 11.5mm — top view 3</a><br><sub>Top 3</sub></td>
<td align="center"><a href="photos/V3_3D_spool-hook-b-11.5mm-iso-top-4.jpg">Spool hook b 11.5mm — top view 4</a><br><sub>Top 4</sub></td>
</tr>
<tr>
<td align="center"><a href="photos/V3_3D_spool-hook-b-11.5mm-iso-bottom-1.jpg">Spool hook b 11.5mm — bottom view 1</a><br><sub>Bottom 1</sub></td>
<td align="center"><a href="photos/V3_3D_spool-hook-b-11.5mm-iso-bottom-2.jpg">Spool hook b 11.5mm — bottom view 2</a><br><sub>Bottom 2</sub></td>
<td align="center"><a href="photos/V3_3D_spool-hook-b-11.5mm-iso-bottom-3.jpg">Spool hook b 11.5mm — bottom view 3</a><br><sub>Bottom 3</sub></td>
<td align="center"><a href="photos/V3_3D_spool-hook-b-11.5mm-iso-bottom-4.jpg">Spool hook b 11.5mm — bottom view 4</a><br><sub>Bottom 4</sub></td>
</tr>
</table>

</details>

## Trigger cover for 16/24 mm

[STEP](V3_3D_switch-trigger-cover-16-24mm.step) · [STL](V3_3D_switch-trigger-cover-16-24mm.stl)

<a href="photos/V3_3D_switch-trigger-cover-16-24mm.jpg">Switch trigger cover 16 24mm — original preview</a>

<details>
<summary>More views</summary>

<table>
<tr>
<td align="center"><a href="photos/V3_3D_switch-trigger-cover-16-24mm-iso-top-1.jpg">Switch trigger cover 16 24mm — top view 1</a><br><sub>Top 1</sub></td>
<td align="center"><a href="photos/V3_3D_switch-trigger-cover-16-24mm-iso-top-2.jpg">Switch trigger cover 16 24mm — top view 2</a><br><sub>Top 2</sub></td>
<td align="center"><a href="photos/V3_3D_switch-trigger-cover-16-24mm-iso-top-3.jpg">Switch trigger cover 16 24mm — top view 3</a><br><sub>Top 3</sub></td>
<td align="center"><a href="photos/V3_3D_switch-trigger-cover-16-24mm-iso-top-4.jpg">Switch trigger cover 16 24mm — top view 4</a><br><sub>Top 4</sub></td>
</tr>
<tr>
<td align="center"><a href="photos/V3_3D_switch-trigger-cover-16-24mm-iso-bottom-1.jpg">Switch trigger cover 16 24mm — bottom view 1</a><br><sub>Bottom 1</sub></td>
<td align="center"><a href="photos/V3_3D_switch-trigger-cover-16-24mm-iso-bottom-2.jpg">Switch trigger cover 16 24mm — bottom view 2</a><br><sub>Bottom 2</sub></td>
<td align="center"><a href="photos/V3_3D_switch-trigger-cover-16-24mm-iso-bottom-3.jpg">Switch trigger cover 16 24mm — bottom view 3</a><br><sub>Bottom 3</sub></td>
<td align="center"><a href="photos/V3_3D_switch-trigger-cover-16-24mm-iso-bottom-4.jpg">Switch trigger cover 16 24mm — bottom view 4</a><br><sub>Bottom 4</sub></td>
</tr>
</table>

</details>

## Worm — module 0.7, 10W × 13L

[STEP](V3_3D_worm-module-0.7-10w-13l.step) · [STL](V3_3D_worm-module-0.7-10w-13l.stl)

<a href="photos/V3_3D_worm-module-0.7-10w-13l.jpg">Worm module 0.7 10w 13l — original preview</a>

<details>
<summary>More views</summary>

<table>
<tr>
<td align="center"><a href="photos/V3_3D_worm-module-0.7-10w-13l-iso-top-1.jpg">Worm module 0.7 10w 13l — top view 1</a><br><sub>Top 1</sub></td>
<td align="center"><a href="photos/V3_3D_worm-module-0.7-10w-13l-iso-top-2.jpg">Worm module 0.7 10w 13l — top view 2</a><br><sub>Top 2</sub></td>
<td align="center"><a href="photos/V3_3D_worm-module-0.7-10w-13l-iso-top-3.jpg">Worm module 0.7 10w 13l — top view 3</a><br><sub>Top 3</sub></td>
<td align="center"><a href="photos/V3_3D_worm-module-0.7-10w-13l-iso-top-4.jpg">Worm module 0.7 10w 13l — top view 4</a><br><sub>Top 4</sub></td>
</tr>
<tr>
<td align="center"><a href="photos/V3_3D_worm-module-0.7-10w-13l-iso-bottom-1.jpg">Worm module 0.7 10w 13l — bottom view 1</a><br><sub>Bottom 1</sub></td>
<td align="center"><a href="photos/V3_3D_worm-module-0.7-10w-13l-iso-bottom-2.jpg">Worm module 0.7 10w 13l — bottom view 2</a><br><sub>Bottom 2</sub></td>
<td align="center"><a href="photos/V3_3D_worm-module-0.7-10w-13l-iso-bottom-3.jpg">Worm module 0.7 10w 13l — bottom view 3</a><br><sub>Bottom 3</sub></td>
<td align="center"><a href="photos/V3_3D_worm-module-0.7-10w-13l-iso-bottom-4.jpg">Worm module 0.7 10w 13l — bottom view 4</a><br><sub>Bottom 4</sub></td>
</tr>
</table>

</details>
