gabrielyoung92/gabs_microSMT_PickAndPlace/Bing-feeder/V485-feeder/3D_parts_12mm/V485_3D_main-body.step

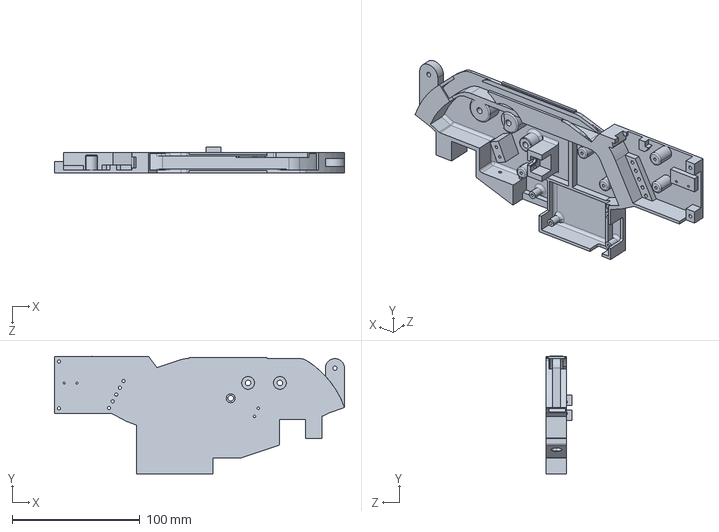
[picture p313: CAD file, 2026-10-21]
Bing-feeder/V485-feeder/3D_parts_12mm/V485_3D_main-body.step
226.6 x 91.8 x 20.0 mm
