gabrielyoung92/gabs_microSMT_PickAndPlace/Bing-feeder/V485-feeder/3D_parts_16mm/V485_3D_main-body.step

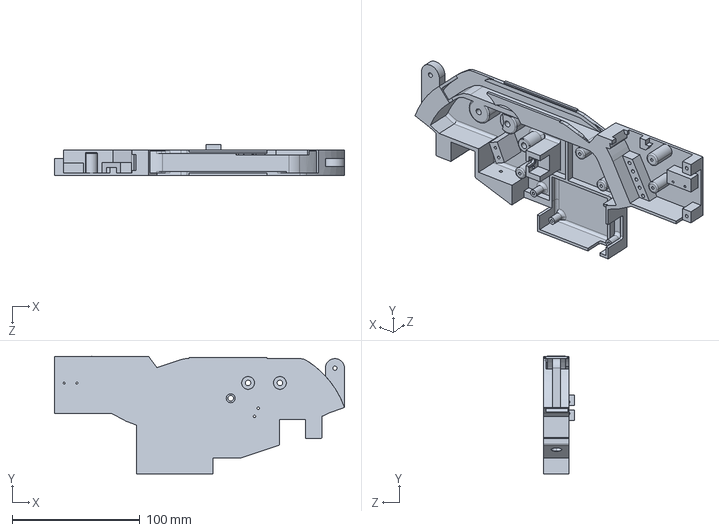
[picture p314: CAD file, 2026-10-21]
Bing-feeder/V485-feeder/3D_parts_16mm/V485_3D_main-body.step
226.6 x 91.8 x 24.0 mm
