gabrielyoung92/gabs_microSMT_PickAndPlace/Bing-feeder/V485-feeder/3D_parts_8mm/V485_3D_main-body.step

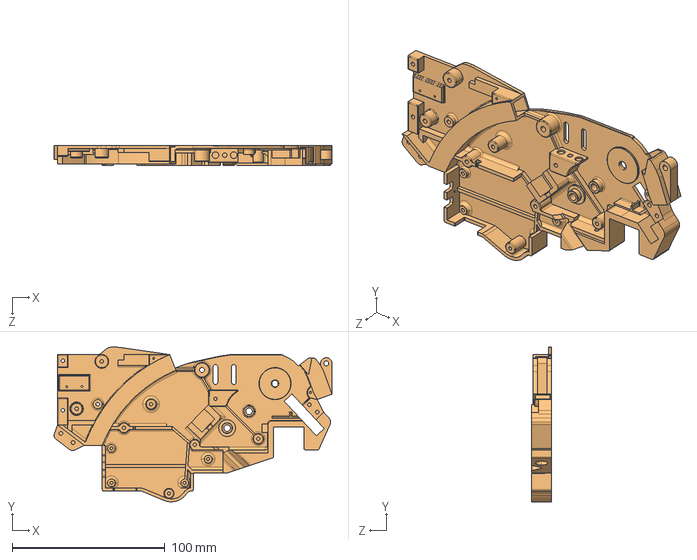
[picture p315: CAD file, 2026-10-20]
Bing-feeder/V485-feeder/3D_parts_8mm/V485_3D_main-body.step
182.1 x 101.4 x 13.0 mm
