gabrielyoung92/gabs_microSMT_PickAndPlace/Bing-feeder/V485-feeder/3D_parts_24mm/V485_3D_main-body.step

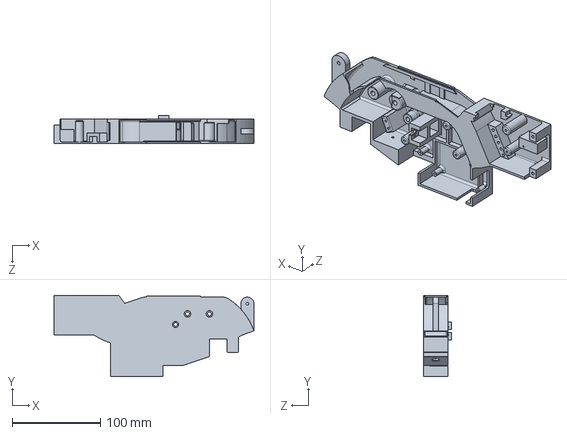
[picture p316: CAD file, 2026-10-21]
Bing-feeder/V485-feeder/3D_parts_24mm/V485_3D_main-body.step
226.6 x 91.8 x 32.0 mm
