gabrielyoung92/gabs_microSMT_PickAndPlace/Bing-feeder/V485-feeder/3D_parts_16mm/V485_3D_feeder-slot-1-position.step

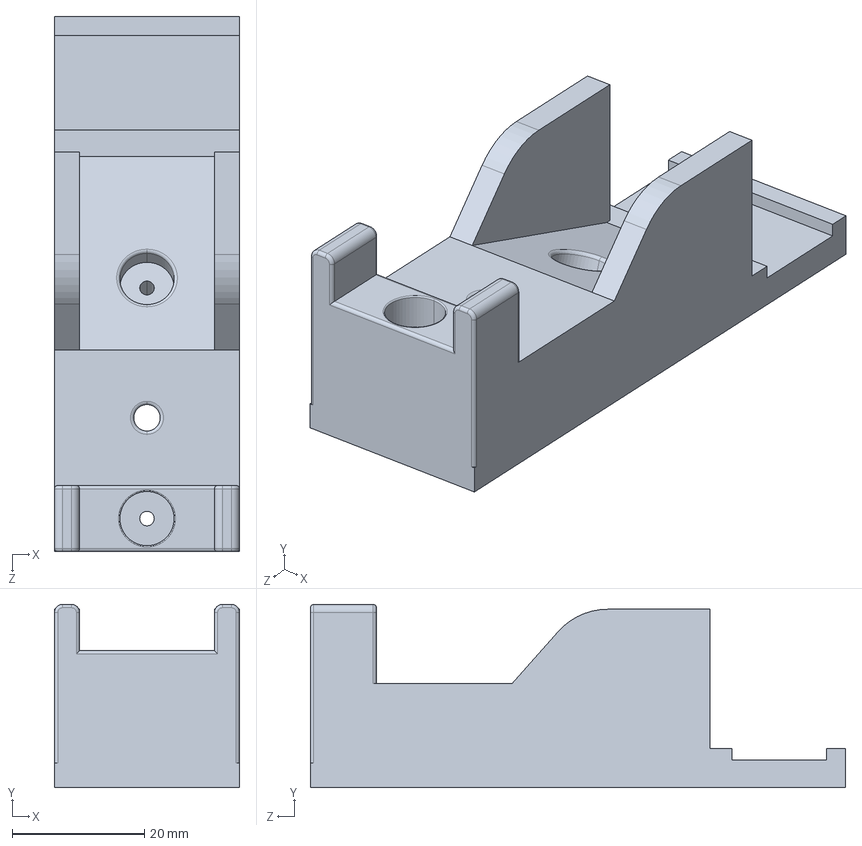
[picture p318: CAD file, 2026-10-22]
Bing-feeder/V485-feeder/3D_parts_16mm/V485_3D_feeder-slot-1-position.step
28.0 x 27.7 x 81.0 mm
