gabrielyoung92/gabs_microSMT_PickAndPlace/Bing-feeder/V485-feeder/3D_parts_24mm/V485_3D_pcb-cover.step

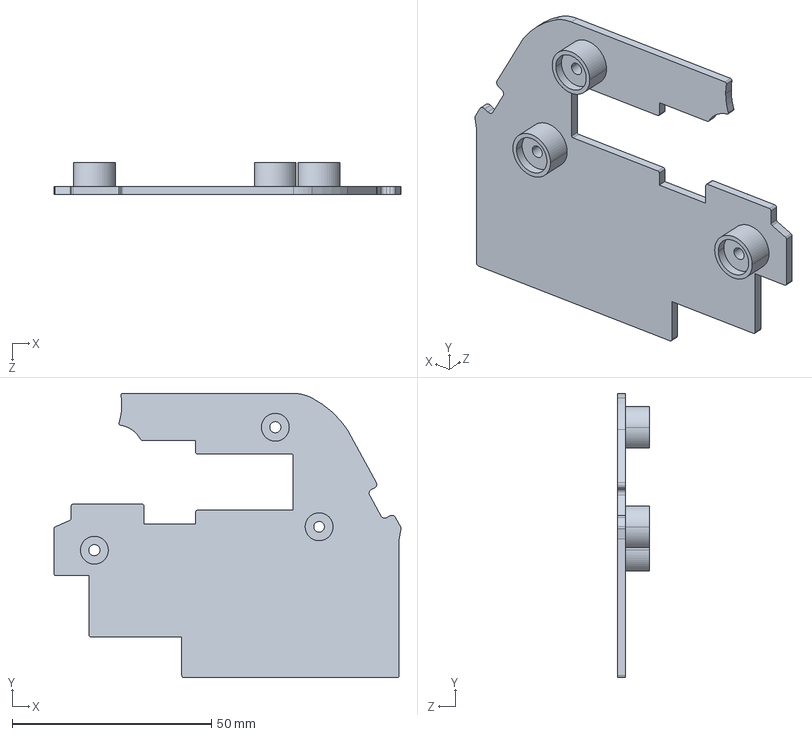
[picture p319: CAD file, 2026-10-21]
Bing-feeder/V485-feeder/3D_parts_24mm/V485_3D_pcb-cover.step
87.2 x 71.4 x 8.00 mm
