gabrielyoung92/gabs_microSMT_PickAndPlace/Bing-feeder/V485-feeder/3D_parts_8mm/V485_3D_worm-motor-support.step

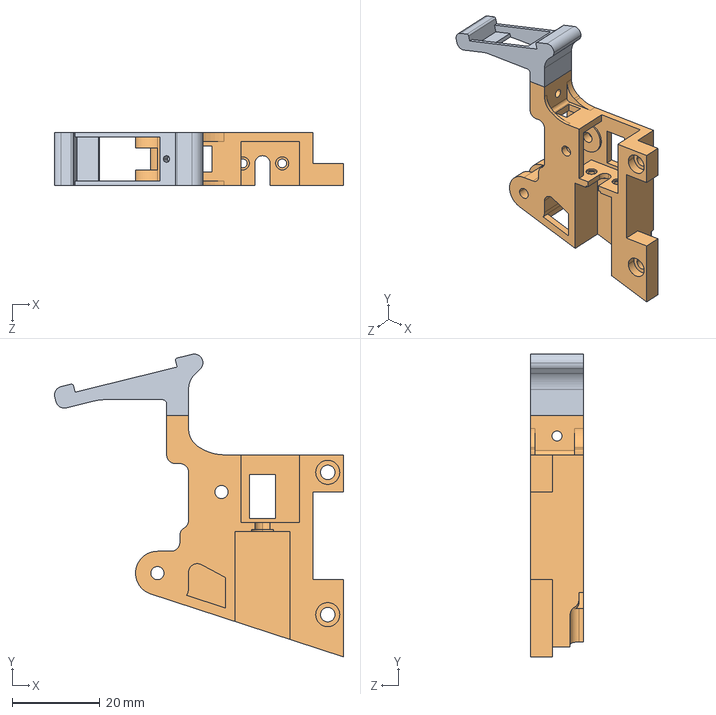
[picture p320: CAD file, 2026-10-21]
Bing-feeder/V485-feeder/3D_parts_8mm/V485_3D_worm-motor-support.step
66.0 x 69.2 x 12.0 mm
