gabrielyoung92/gabs_microSMT_PickAndPlace/Bing-feeder/V485-feeder/3D_parts_shared/V485_3D_worm-module-0.7-10w-13l.step

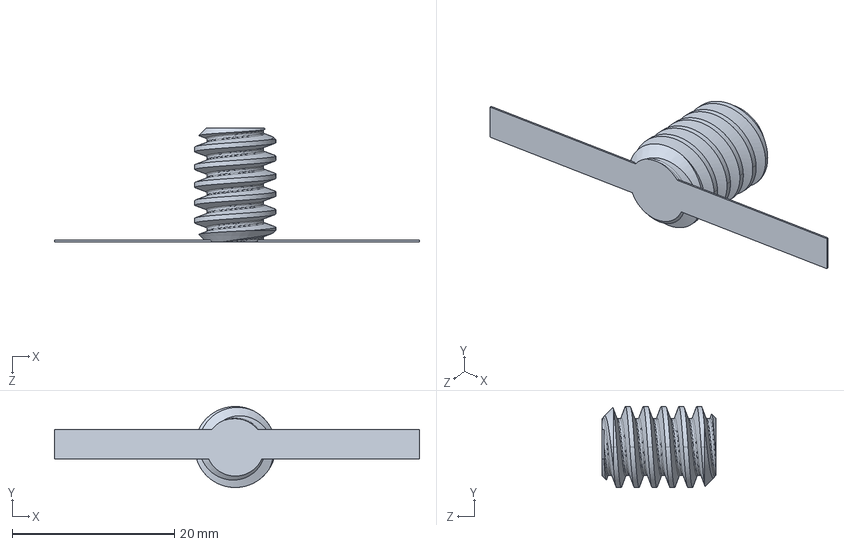
[picture p321: CAD file, 2026-10-20]
Bing-feeder/V485-feeder/3D_parts_shared/V485_3D_worm-module-0.7-10w-13l.step
45.0 x 9.99 x 14.0 mm
