gabrielyoung92/gabs_microSMT_PickAndPlace/Microsmt-PNPv3/CP45_nozzle_rack/CP45 nozzle  rack -right-20250612.STEP

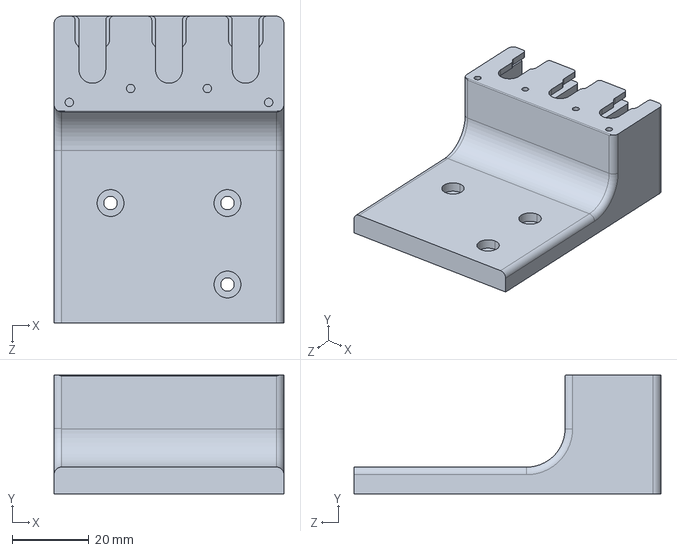
[picture p322: CAD file, 2026-10-20]
Microsmt-PNPv3/CP45_nozzle_rack/CP45 nozzle rack -right-20250612.STEP
60.0 x 31.0 x 80.0 mm
