gabrielyoung92/gabs_microSMT_PickAndPlace/Microsmt-PNPv3/PNP-V3_3D_parts_2026-02-04/PNPV3_3D_motherboard-mounting-plate.stl

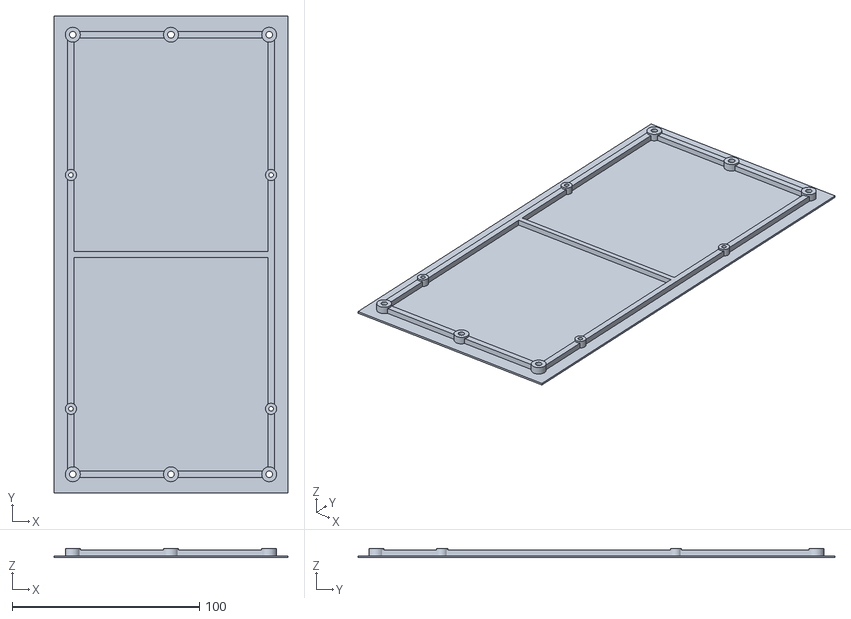
[picture p323: CAD file, 2026-10-20]
Microsmt-PNPv3/PNP-V3_3D_parts_2026-02-04/PNPV3_3D_motherboard-mounting-plate.stl
125.0 x 255.0 x 5.00
