gabrielyoung92/gabs_microSMT_PickAndPlace/Bing-feeder/V485-feeder/3D_parts_12mm/V485_3D_pcb-cover.step

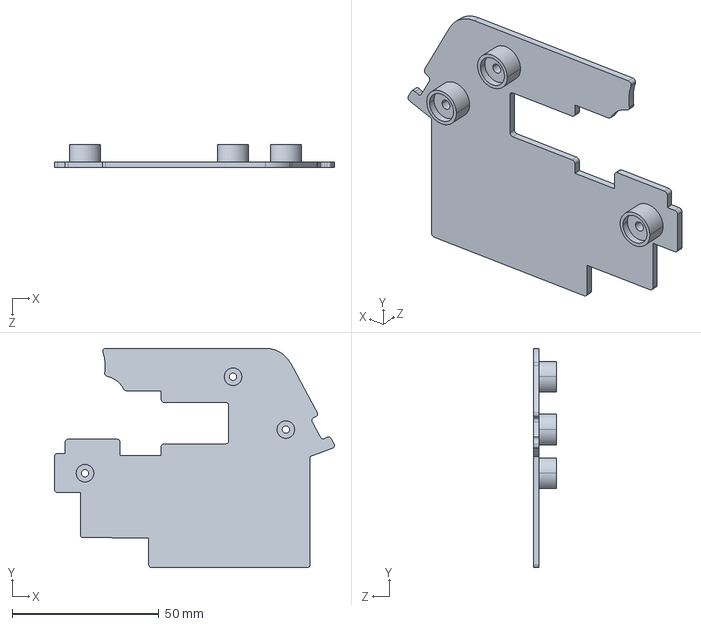
[picture p325: CAD file, 2026-10-21]
Bing-feeder/V485-feeder/3D_parts_12mm/V485_3D_pcb-cover.step
95.4 x 74.8 x 8.00 mm
