gabrielyoung92/gabs_microSMT_PickAndPlace/Bing-feeder/V485-feeder/3D_parts_16mm/V485_3D_worm-motor-support.step

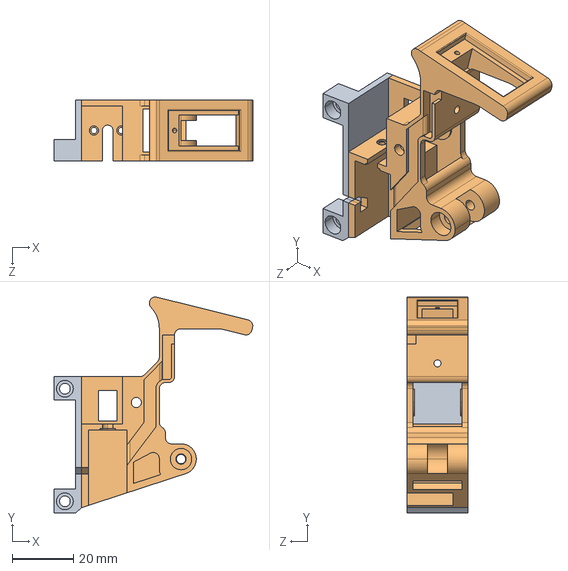
[picture p326: CAD file, 2026-10-21]
Bing-feeder/V485-feeder/3D_parts_16mm/V485_3D_worm-motor-support.step
65.0 x 70.7 x 20.0 mm
