gabrielyoung92/gabs_microSMT_PickAndPlace/Bing-feeder/V485-feeder/3D_parts_8mm/V485_3D_feeder-holder-8-position.step

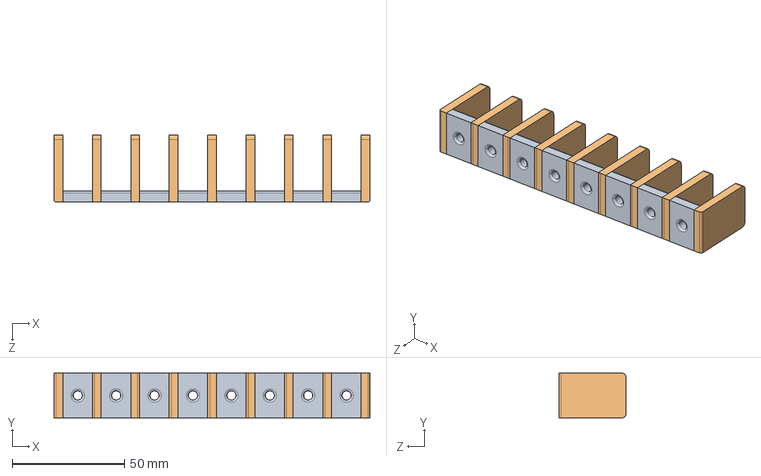
[picture p328: CAD file, 2026-10-20]
Bing-feeder/V485-feeder/3D_parts_8mm/V485_3D_feeder-holder-8-position.step
140.7 x 20.0 x 30.0 mm
