gabrielyoung92/gabs_microSMT_PickAndPlace/Bing-feeder/V485-feeder/3D_parts_shared/V485_3D_gear-45t.step

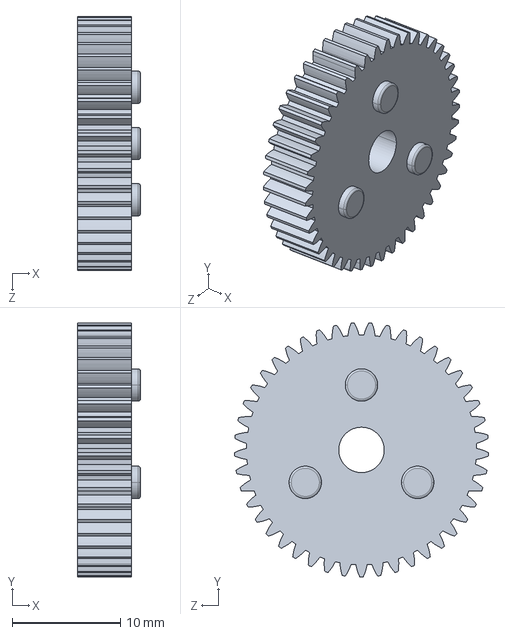
[picture p329: CAD file, 2026-10-20]
Bing-feeder/V485-feeder/3D_parts_shared/V485_3D_gear-45t.step
5.80 x 23.5 x 23.5 mm
