gabrielyoung92/gabs_microSMT_PickAndPlace/Microsmt-PNPv3/PNP-V3_3D_parts_2026-02-04/PNPV3_3D_pump-retainer.step

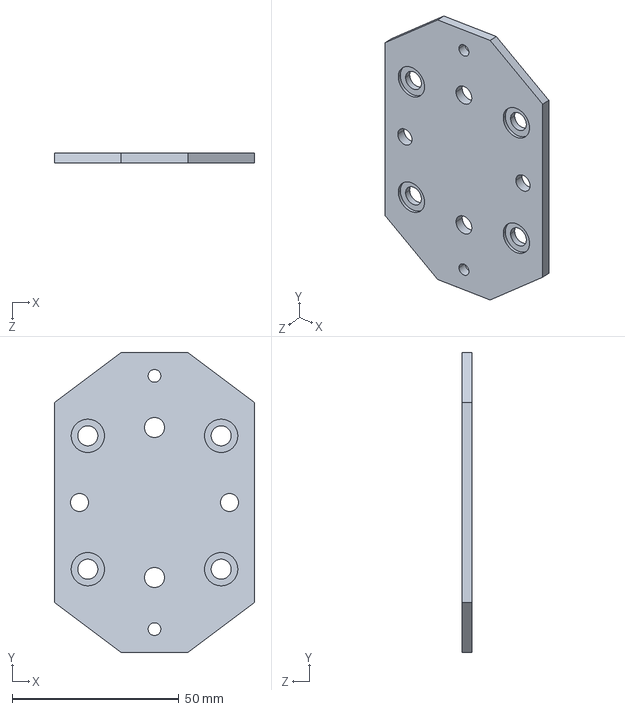
[picture p330: CAD file, 2026-10-20]
Microsmt-PNPv3/PNP-V3_3D_parts_2026-02-04/PNPV3_3D_pump-retainer.step
60.0 x 90.0 x 3.00 mm
