gabrielyoung92/gabs_microSMT_PickAndPlace/Bing-feeder/V485-feeder/3D_parts_16mm/V485_3D_gear-16t-bracket.step

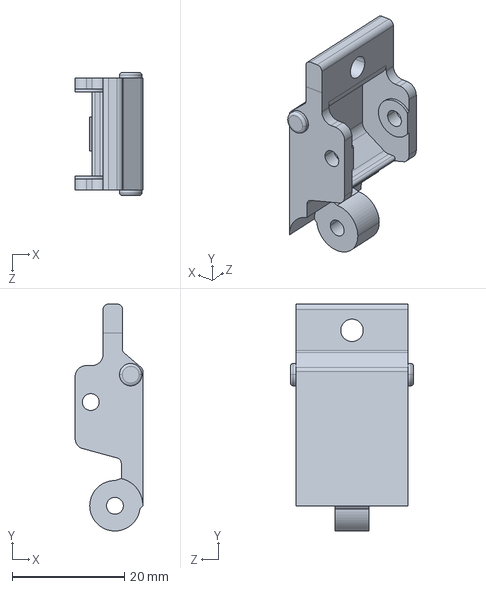
[picture p332: CAD file, 2026-10-21]
Bing-feeder/V485-feeder/3D_parts_16mm/V485_3D_gear-16t-bracket.step
12.1 x 40.5 x 22.0 mm
