gabrielyoung92/gabs_microSMT_PickAndPlace/Bing-feeder/V485-feeder/3D_parts_8mm/V485_3D_pcb-cover.step

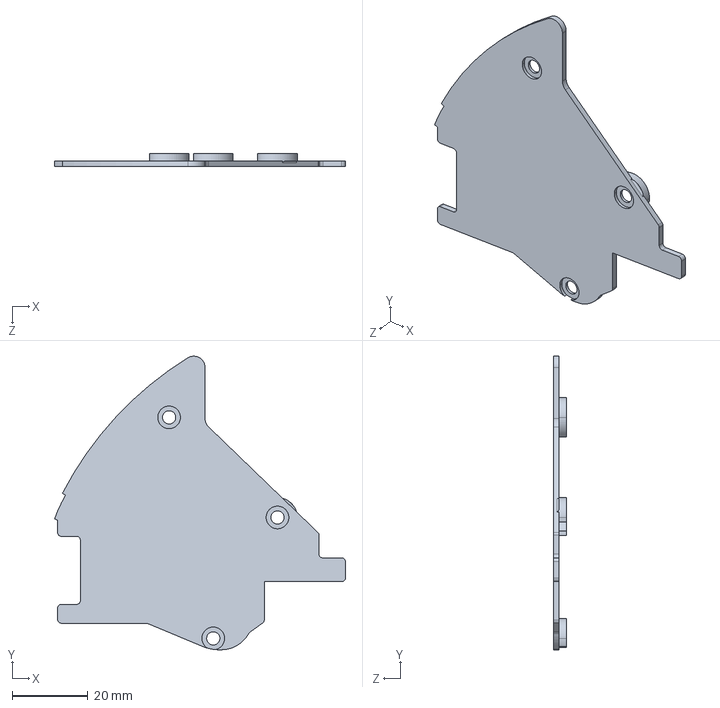
[picture p334: CAD file, 2026-10-20]
Bing-feeder/V485-feeder/3D_parts_8mm/V485_3D_pcb-cover.step
77.0 x 77.7 x 3.50 mm
