gabrielyoung92/gabs_microSMT_PickAndPlace/Bing-feeder/V485-feeder/3D_parts_shared/V485_3D_gear-55t.step

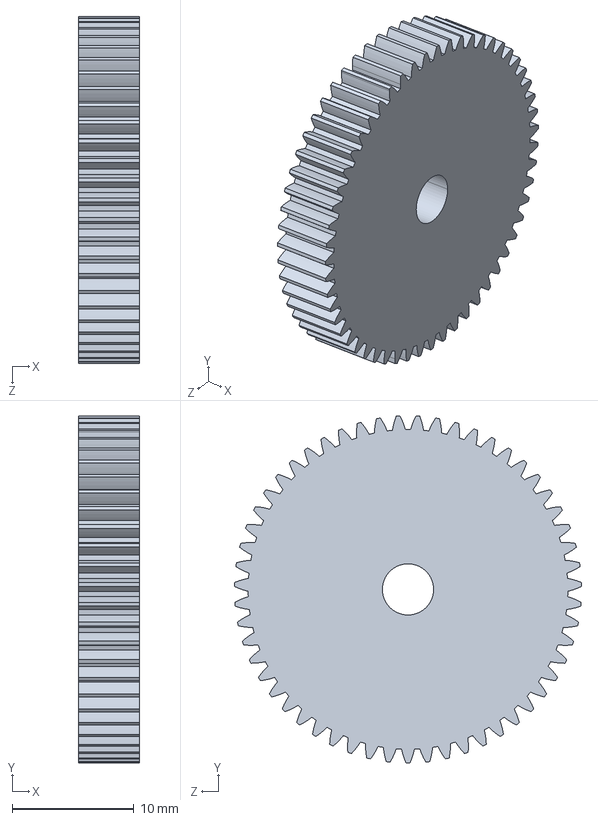
[picture p335: CAD file, 2026-10-20]
Bing-feeder/V485-feeder/3D_parts_shared/V485_3D_gear-55t.step
5.00 x 28.5 x 28.5 mm
