gabrielyoung92/gabs_microSMT_PickAndPlace/Microsmt-PNPv3/CP45_nozzle_rack/CP45 nozzle holder clamps.stl

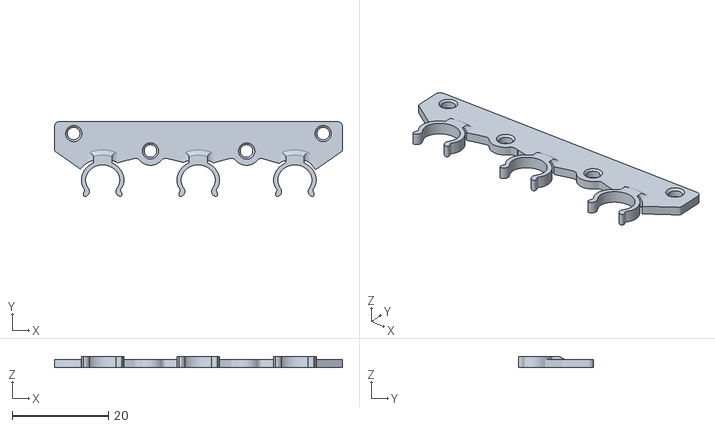
[picture p336: CAD file, 2026-10-20]
Microsmt-PNPv3/CP45_nozzle_rack/CP45 nozzle holder clamps.stl
60.0 x 15.6 x 2.20
