gabrielyoung92/gabs_microSMT_PickAndPlace/Microsmt-PNPv3/PNP-V3_3D_parts_2026-02-04/PNPV3_3D_low-noise-pump-retainer-l.step

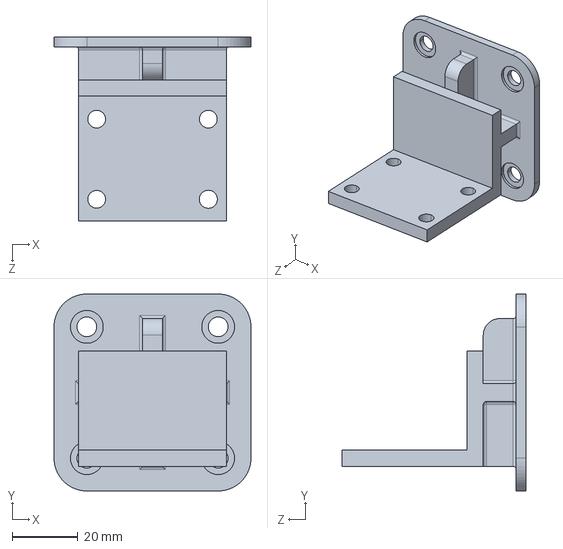
[picture p337: CAD file, 2026-10-20]
Microsmt-PNPv3/PNP-V3_3D_parts_2026-02-04/PNPV3_3D_low-noise-pump-retainer-l.step
60.0 x 60.0 x 56.0 mm
