gabrielyoung92/gabs_microSMT_PickAndPlace/Microsmt-PNPv3/Strip_feeders/16mm-1bit.STEP

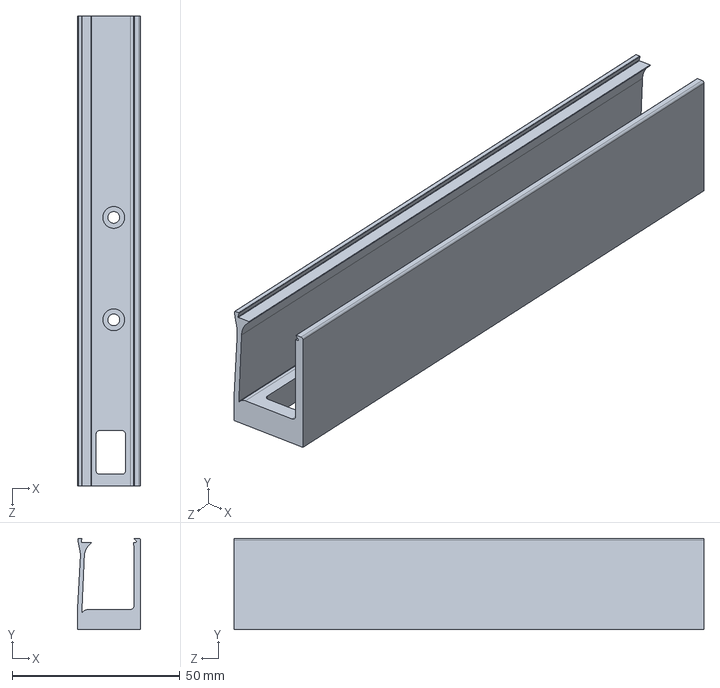
[picture p338: CAD file, 2026-10-20]
Microsmt-PNPv3/Strip_feeders/16mm-1bit.STEP
18.8 x 27.2 x 140.0 mm
