gabrielyoung92/gabs_microSMT_PickAndPlace/Bing-feeder/V485-feeder/3D_parts_shared/V485_3D_switch-trigger-cover-16-24mm.step

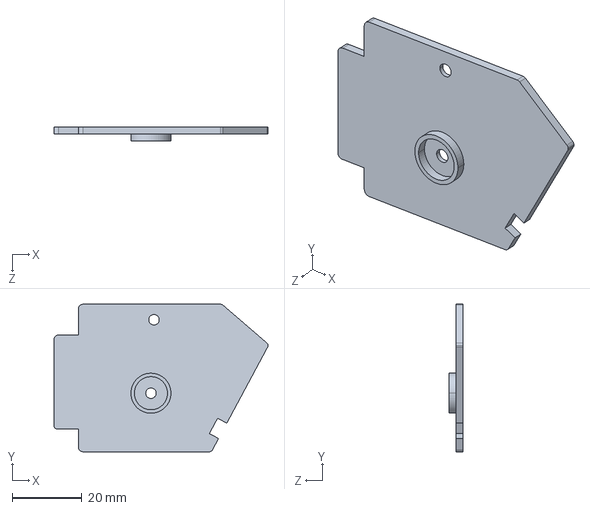
[picture p341: CAD file, 2026-10-20]
Bing-feeder/V485-feeder/3D_parts_shared/V485_3D_switch-trigger-cover-16-24mm.step
61.4 x 42.4 x 4.00 mm
