gabrielyoung92/gabs_microSMT_PickAndPlace/Microsmt-PNPv3/PNP-V3_3D_parts_2026-02-04/PNPV3_3D_bottom-camera-led-diffuser-v2.1.step

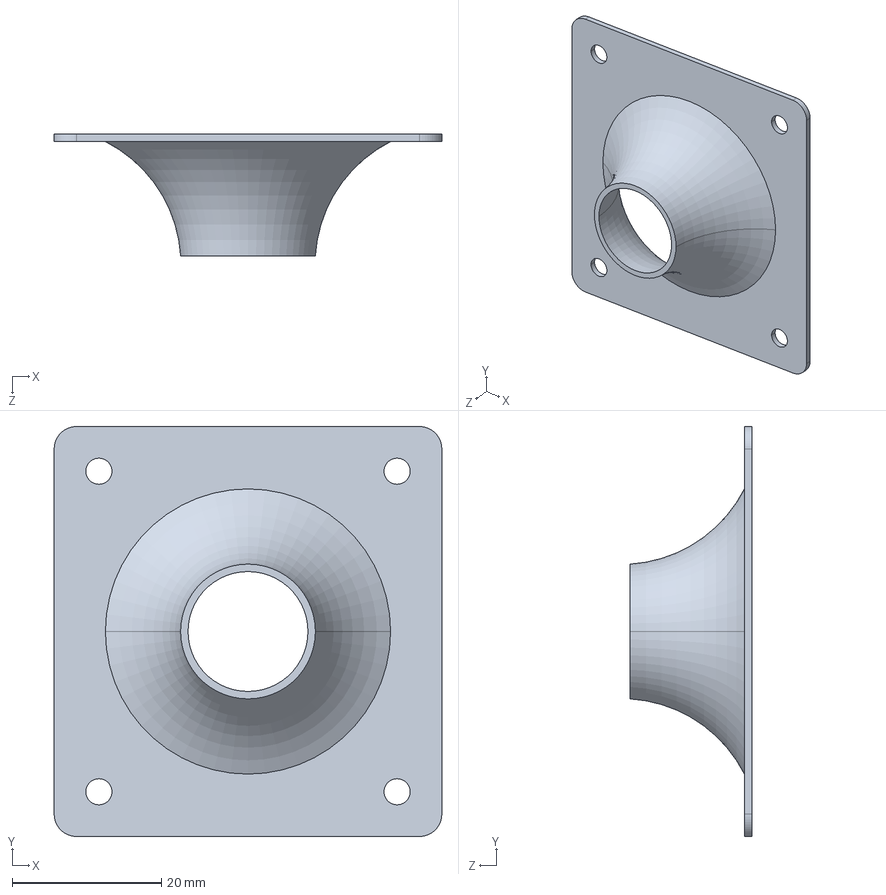
[picture p342: CAD file, 2026-10-20]
Microsmt-PNPv3/PNP-V3_3D_parts_2026-02-04/PNPV3_3D_bottom-camera-led-diffuser-v2.1.step
52.0 x 55.0 x 16.3 mm
