gabrielyoung92/gabs_microSMT_PickAndPlace/Microsmt-PNPv3/Strip_feeders/8mm-3bit.STEP

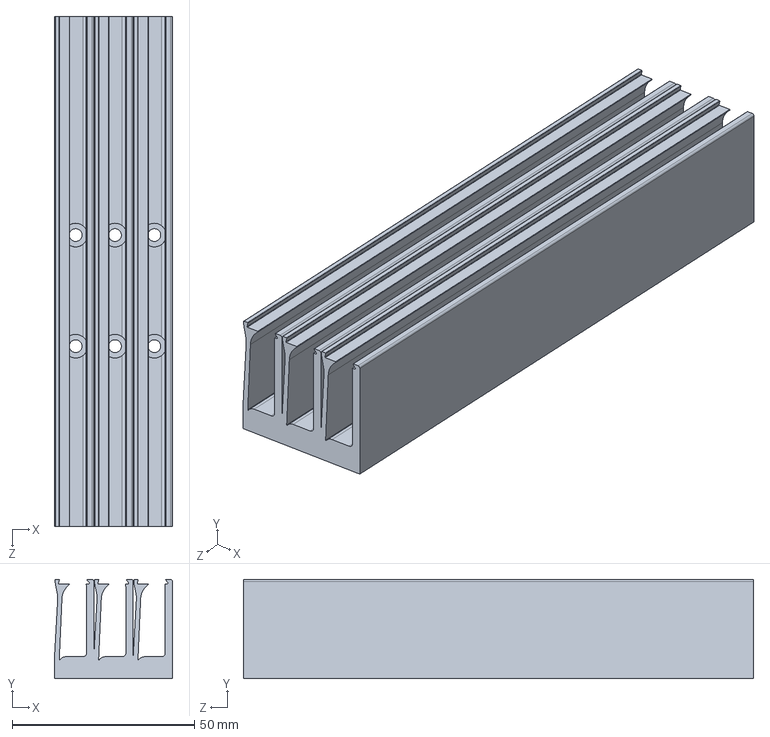
[picture p343: CAD file, 2026-10-20]
Microsmt-PNPv3/Strip_feeders/8mm-3bit.STEP
32.4 x 27.2 x 140.0 mm
