gabrielyoung92/gabs_microSMT_PickAndPlace/Bing-feeder/V485-feeder/3D_parts_8mm/V485_3D_gear-16t-module-0.7-6mm.step

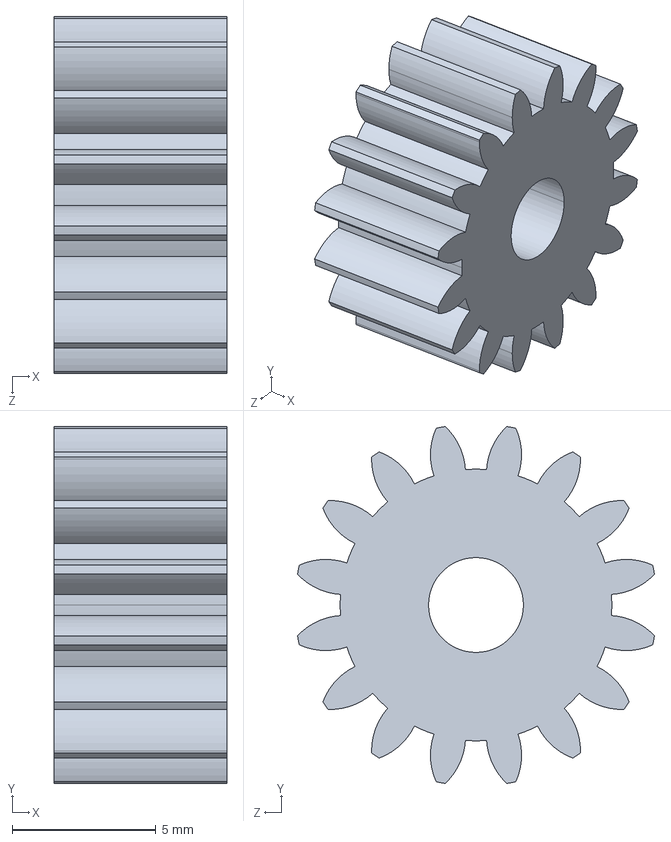
[picture p345: CAD file, 2026-10-20]
Bing-feeder/V485-feeder/3D_parts_8mm/V485_3D_gear-16t-module-0.7-6mm.step
6.00 x 12.4 x 12.4 mm
