gabrielyoung92/gabs_microSMT_PickAndPlace/Microsmt-PNPv3/PNP-V3_3D_parts_2026-02-04/PNPV3_3D_ac-power-socket-mount.stl

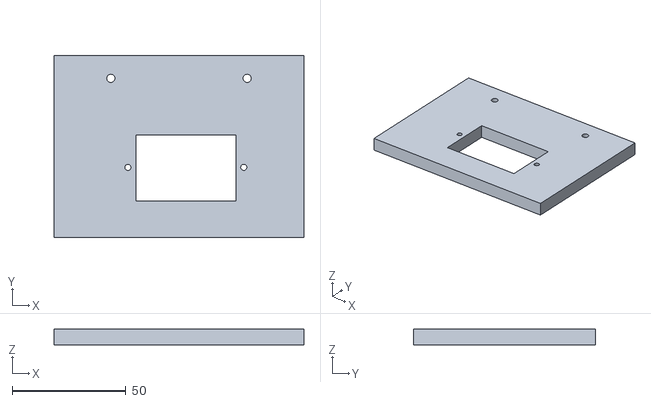
[picture p346: CAD file, 2026-10-20]
Microsmt-PNPv3/PNP-V3_3D_parts_2026-02-04/PNPV3_3D_ac-power-socket-mount.stl
110.0 x 80.0 x 7.00
