gabrielyoung92/gabs_microSMT_PickAndPlace/Microsmt-PNPv3/Strip_feeders/8mm-2bit.STEP

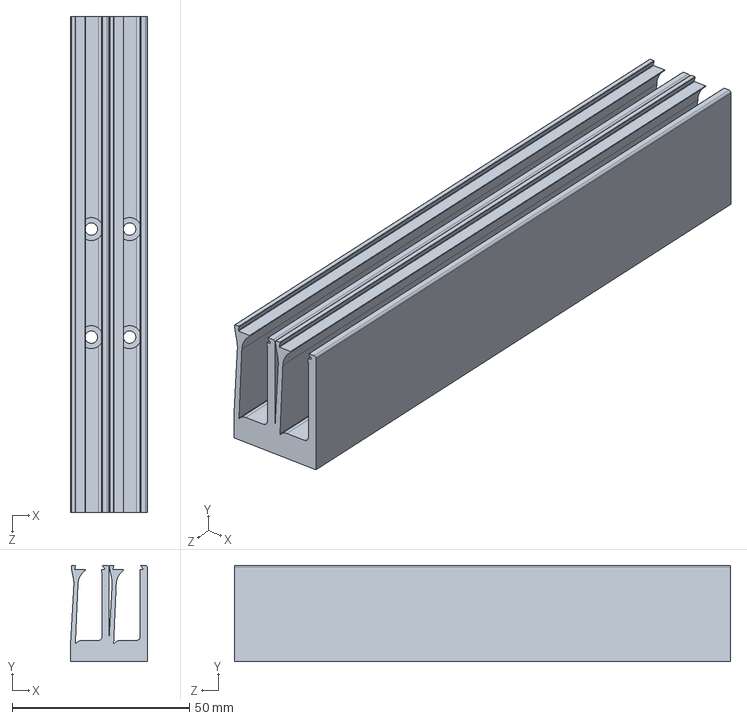
[picture p347: CAD file, 2026-10-20]
Microsmt-PNPv3/Strip_feeders/8mm-2bit.STEP
21.6 x 27.2 x 140.0 mm
