gabrielyoung92/gabs_microSMT_PickAndPlace/Bing-feeder/V485-feeder/3D_parts_16mm/V485_3D_gear-16t-module-0.7-14mm.step

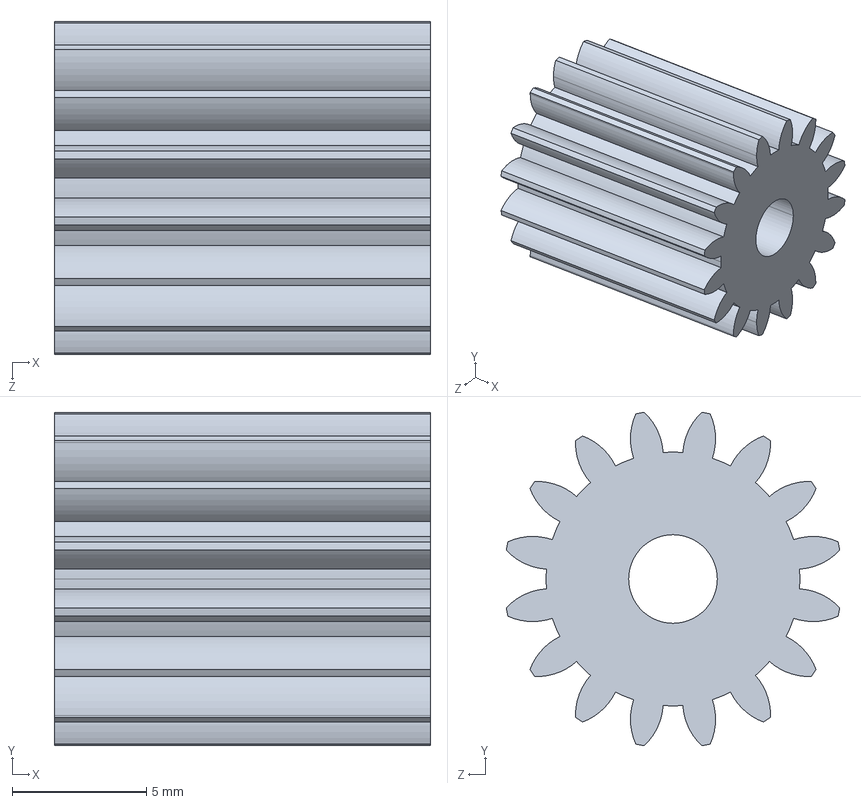
[picture p349: CAD file, 2026-10-20]
Bing-feeder/V485-feeder/3D_parts_16mm/V485_3D_gear-16t-module-0.7-14mm.step
14.0 x 12.4 x 12.4 mm
