gabrielyoung92/gabs_microSMT_PickAndPlace/Bing-feeder/V485-feeder/3D_parts_24mm/V485_3D_feeder-slot-1-position.step

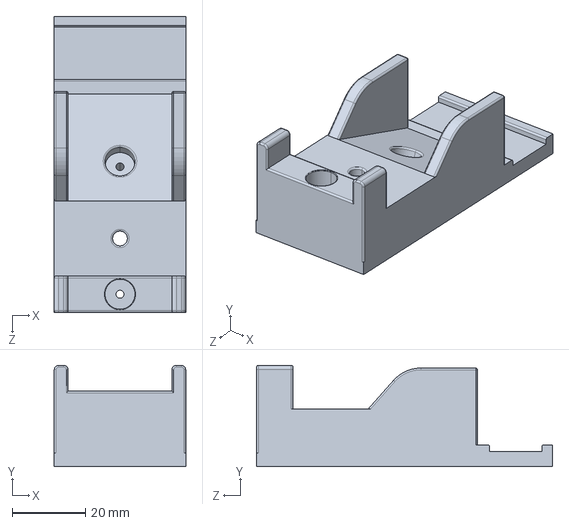
[picture p350: CAD file, 2026-10-21]
Bing-feeder/V485-feeder/3D_parts_24mm/V485_3D_feeder-slot-1-position.step
36.0 x 27.7 x 81.0 mm
