gabrielyoung92/gabs_microSMT_PickAndPlace/Bing-feeder/V485-feeder/3D_parts_8mm/V485_3D_spool-hook-a.step

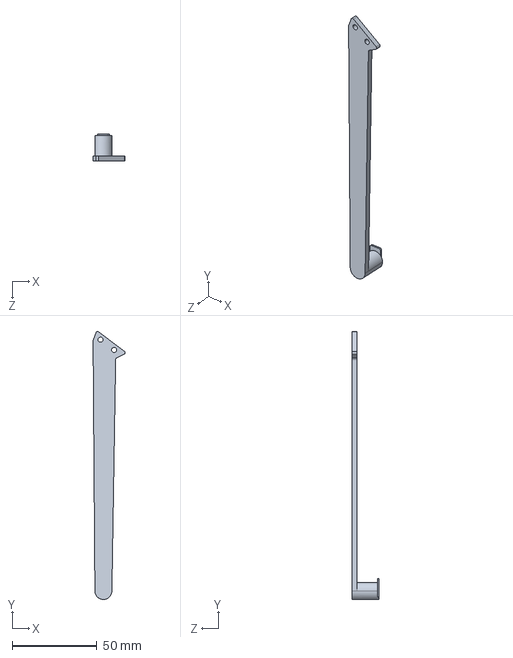
[picture p351: CAD file, 2026-10-20]
Bing-feeder/V485-feeder/3D_parts_8mm/V485_3D_spool-hook-a.step
19.0 x 157.7 x 16.0 mm
