gabrielyoung92/gabs_microSMT_PickAndPlace/Bing-feeder/V485-feeder/3D_parts_16mm/V485_3D_switch-trigger.step

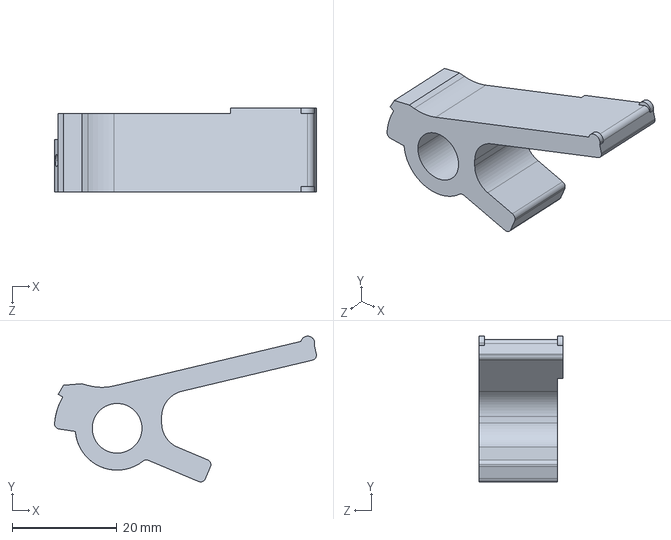
[picture p355: CAD file, 2026-10-20]
Bing-feeder/V485-feeder/3D_parts_16mm/V485_3D_switch-trigger.step
50.1 x 27.9 x 16.0 mm
