gabrielyoung92/gabs_microSMT_PickAndPlace/Bing-feeder/V485-feeder/3D_parts_24mm/V485_3D_tape-cover.step

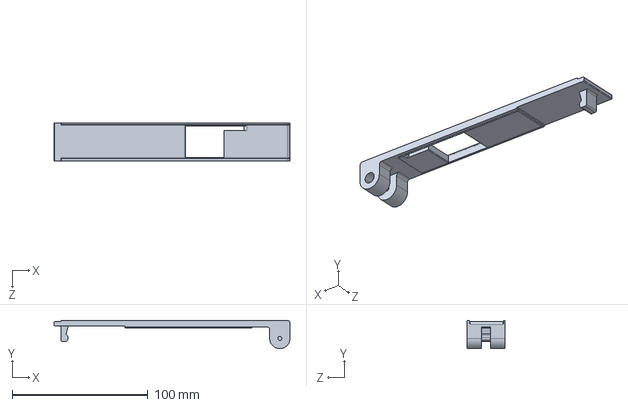
[picture p361: CAD file, 2026-10-20]
Bing-feeder/V485-feeder/3D_parts_24mm/V485_3D_tape-cover.step
173.9 x 20.8 x 28.0 mm
