gabrielyoung92/gabs_microSMT_PickAndPlace/Bing-feeder/V485-feeder/3D_parts_8mm/V485_3D_feeder-slot-1-position-space-variant.step

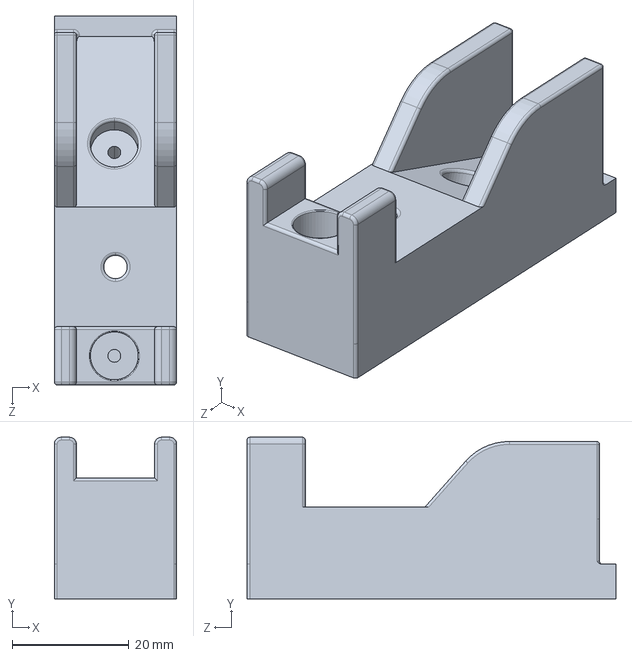
[picture p362: CAD file, 2026-10-20]
Bing-feeder/V485-feeder/3D_parts_8mm/V485_3D_feeder-slot-1-position-space-variant.step
21.0 x 27.7 x 63.3 mm
