gabrielyoung92/gabs_microSMT_PickAndPlace/Bing-feeder/V485-feeder/3D_parts_16mm/V485_3D_feeder-holder-1-position.step

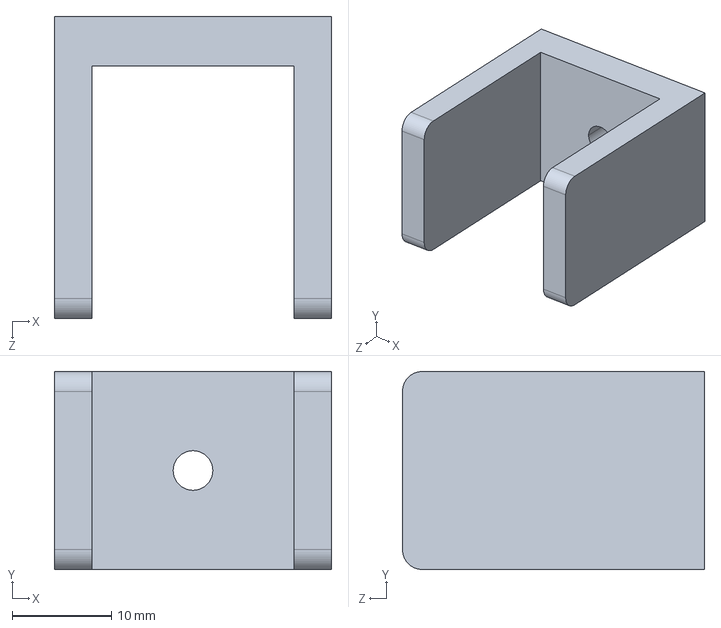
[picture p369: CAD file, 2026-10-20]
Bing-feeder/V485-feeder/3D_parts_16mm/V485_3D_feeder-holder-1-position.step
28.0 x 20.0 x 30.5 mm
