gabrielyoung92/gabs_microSMT_PickAndPlace/Bing-feeder/V485-feeder/3D_parts_8mm/V485_3D_feeder-slot-1-position.step

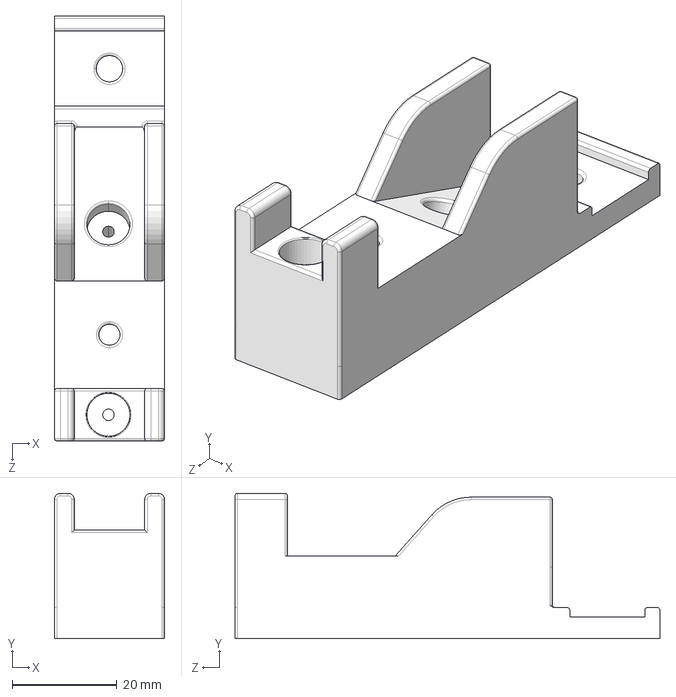
[picture p371: CAD file, 2026-10-20]
Bing-feeder/V485-feeder/3D_parts_8mm/V485_3D_feeder-slot-1-position.step
21.0 x 27.7 x 81.0 mm
