gabrielyoung92/gabs_microSMT_PickAndPlace/Microsmt-PNPv3/PNP-V3_3D_parts_2026-02-04/PNPV3_3D_x-axis-endstop-switch-mount.stl

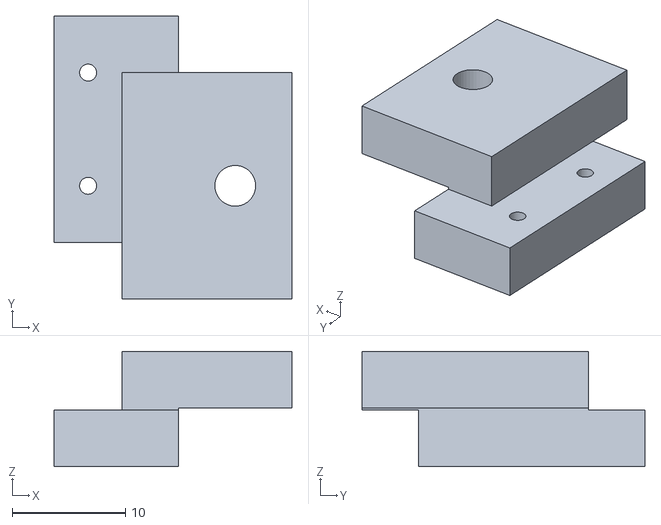
[picture p378: CAD file, 2026-10-20]
Microsmt-PNPv3/PNP-V3_3D_parts_2026-02-04/PNPV3_3D_x-axis-endstop-switch-mount.stl
21.0 x 25.0 x 10.2
