gabrielyoung92/gabs_microSMT_PickAndPlace/Bing-feeder/V485-feeder/3D_parts_8mm/V485_3D_spring-support-plate.step

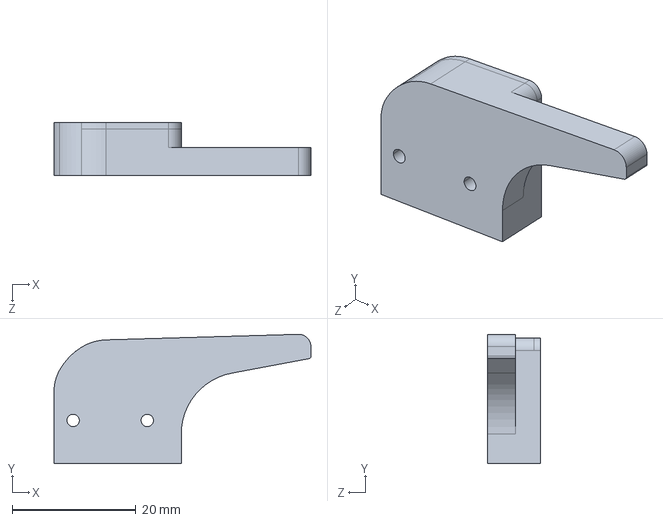
[picture p380: CAD file, 2026-10-20]
Bing-feeder/V485-feeder/3D_parts_8mm/V485_3D_spring-support-plate.step
41.6 x 20.9 x 8.50 mm
