gabrielyoung92/gabs_microSMT_PickAndPlace/Bing-feeder/V485-feeder/3D_parts_8mm/V485_3D_switch-trigger-cover.step

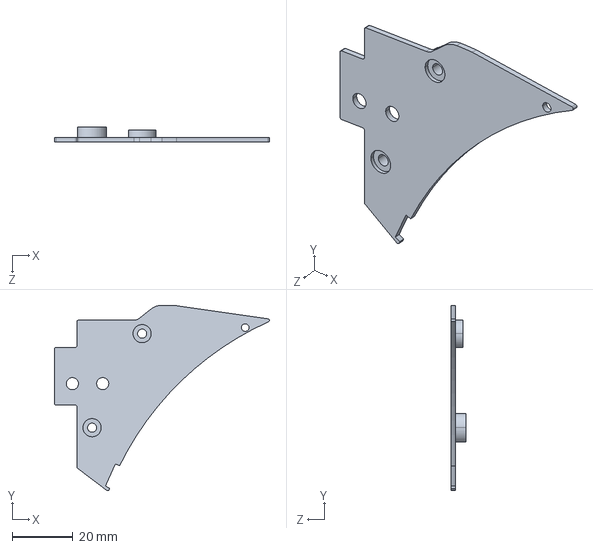
[picture p382: CAD file, 2026-10-20]
Bing-feeder/V485-feeder/3D_parts_8mm/V485_3D_switch-trigger-cover.step
70.9 x 61.2 x 5.00 mm
