gabrielyoung92/gabs_microSMT_PickAndPlace/Microsmt-PNPv3/PNP-V3_3D_parts_2026-02-04/PNPV3_3D_y-axis-endstop-switch-mount.stl

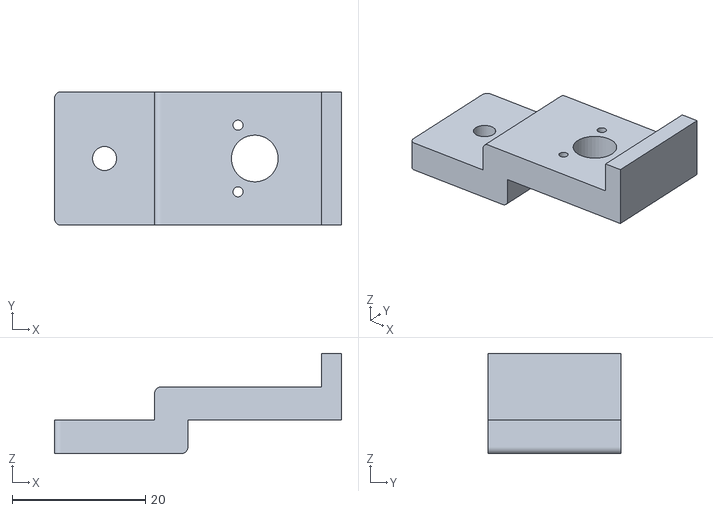
[picture p383: CAD file, 2026-10-20]
Microsmt-PNPv3/PNP-V3_3D_parts_2026-02-04/PNPV3_3D_y-axis-endstop-switch-mount.stl
43.0 x 20.0 x 15.0
