gabrielyoung92/gabs_microSMT_PickAndPlace/Bing-feeder/V485-feeder/3D_parts_8mm/V485_3D_sprocket-cover.step

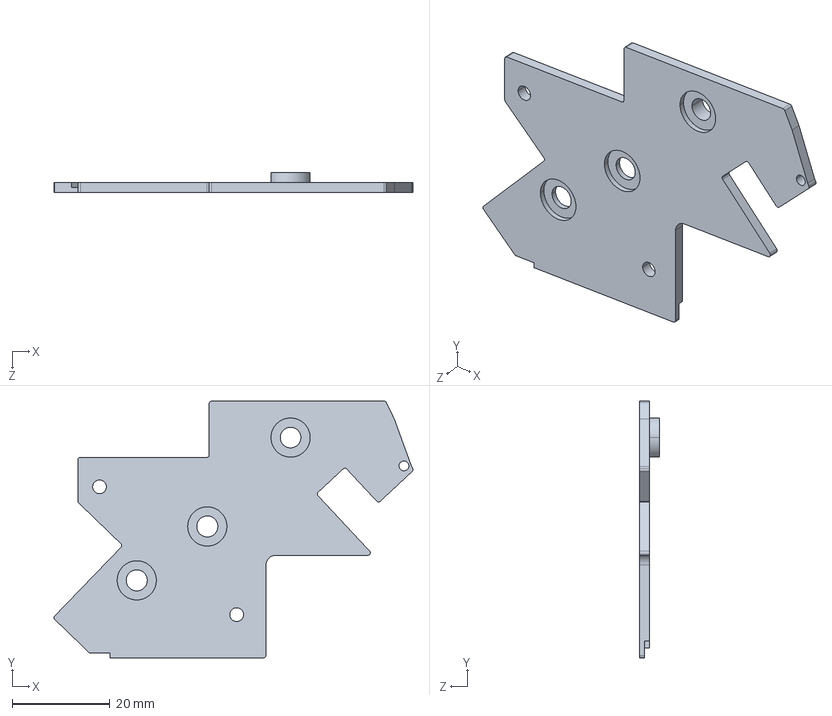
[picture p384: CAD file, 2026-10-20]
Bing-feeder/V485-feeder/3D_parts_8mm/V485_3D_sprocket-cover.step
73.3 x 52.4 x 4.00 mm
