gabrielyoung92/gabs_microSMT_PickAndPlace/Microsmt-PNPv3/PNP-V3_3D_parts_2026-02-04/PNPV3_3D_bottom-camera-trim-cover-v2.1.step

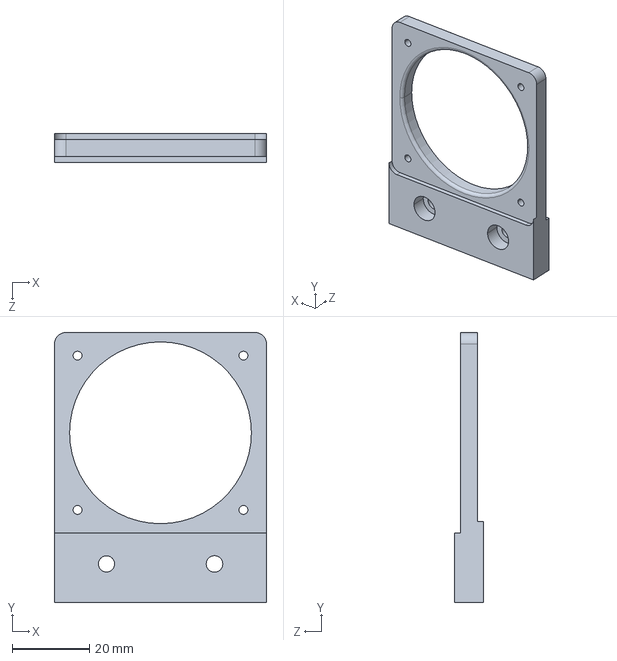
[picture p385: CAD file, 2026-10-20]
Microsmt-PNPv3/PNP-V3_3D_parts_2026-02-04/PNPV3_3D_bottom-camera-trim-cover-v2.1.step
55.0 x 70.0 x 7.50 mm
