gabrielyoung92/gabs_microSMT_PickAndPlace/Bing-feeder/V485-feeder/3D_parts_8mm/V485_3D_feeder-holder-3-position.step

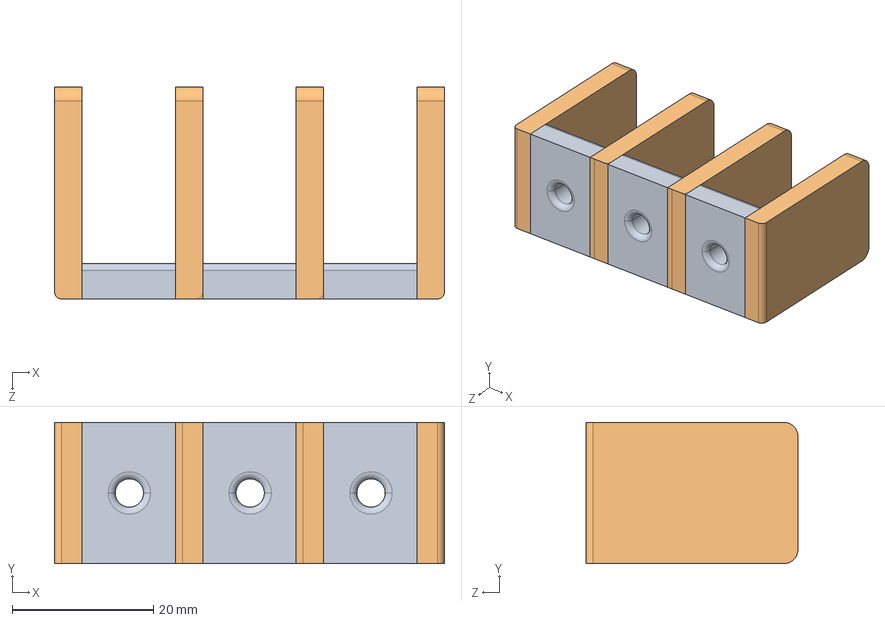
[picture p386: CAD file, 2026-10-20]
Bing-feeder/V485-feeder/3D_parts_8mm/V485_3D_feeder-holder-3-position.step
55.2 x 20.0 x 30.0 mm
