gabrielyoung92/gabs_microSMT_PickAndPlace/Microsmt-PNPv3/PNP-V3_3D_parts_2026-02-04/PNPV3_3D_bottom-camera-mounting-plate-v2.1.step

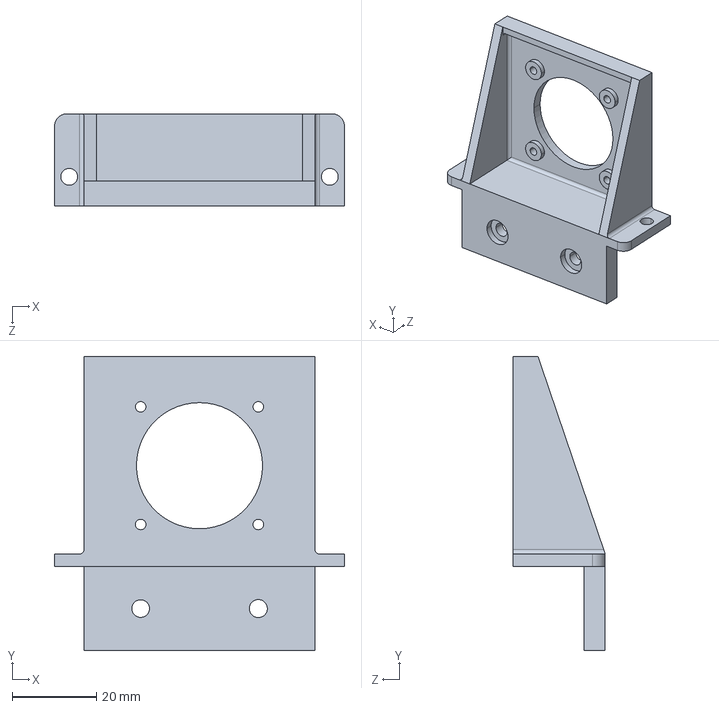
[picture p387: CAD file, 2026-10-20]
Microsmt-PNPv3/PNP-V3_3D_parts_2026-02-04/PNPV3_3D_bottom-camera-mounting-plate-v2.1.step
69.0 x 70.0 x 22.0 mm
