gabrielyoung92/gabs_microSMT_PickAndPlace/Bing-feeder/V485-feeder/3D_parts_8mm/V485_3D_gear-15t-module-0.7-6mm.step

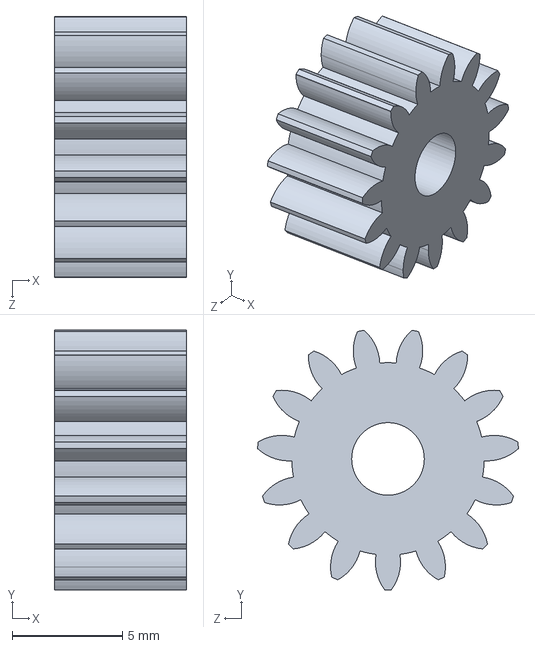
[picture p388: CAD file, 2026-10-20]
Bing-feeder/V485-feeder/3D_parts_8mm/V485_3D_gear-15t-module-0.7-6mm.step
6.00 x 11.8 x 11.9 mm
