gabrielyoung92/gabs_microSMT_PickAndPlace/Microsmt-PNPv3/PNP-V3_3D_parts_2026-02-04/PNPV3_3D_y-axis-drag-chain-hook.stl

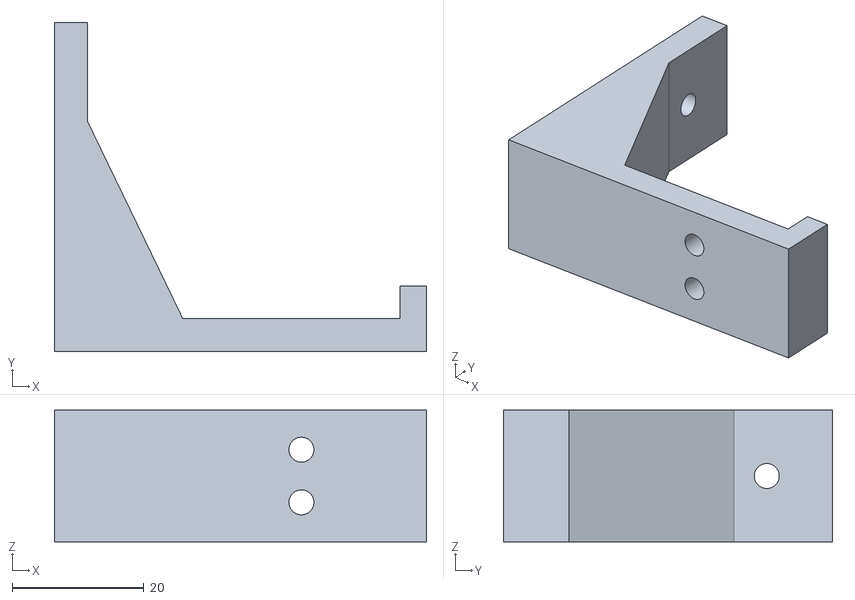
[picture p389: CAD file, 2026-10-20]
Microsmt-PNPv3/PNP-V3_3D_parts_2026-02-04/PNPV3_3D_y-axis-drag-chain-hook.stl
56.5 x 50.0 x 20.0
