gabrielyoung92/gabs_microSMT_PickAndPlace/(list of files, cad)

Other CAD files:
Microsmt-PNPv3/Work_bed_plates/2.DWG
Microsmt-PNPv3/CP45_nozzle_rack/CP45 nozzle rack -left-20250612.STEP
Microsmt-PNPv3/Work_bed_plates/1.DWG
Bing-feeder/V485-feeder/3D_parts_16mm/V485_3D_pcb-cover.step
Bing-feeder/V485-feeder/3D_parts_shared/V485_3D_gear-45t-684zz-bearing-variant.step
Bing-feeder/V485-feeder/3D_parts_12mm/V485_3D_switch-trigger-cover.step
Bing-feeder/V485-feeder/3D_parts_8mm/V485_3D_gear-45t-684zz-bearing-variant.stl
Bing-feeder/V3-Feeder Controller/3D_parts/V3_3D_busbar-pcb-hook.step
Bing-feeder/V3-Feeder Controller/3D_parts/V3_3D_busbar-pcb-hook.stl
Bing-feeder/V3-feeder/12mm_3D_parts/V3_3D_feeder-holder-2-position.step
Bing-feeder/V3-feeder/12mm_3D_parts/V3_3D_feeder-holder-2-position.stl
Bing-feeder/V3-feeder/12mm_3D_parts/V3_3D_feeder-holder-4-position.step
Bing-feeder/V3-feeder/12mm_3D_parts/V3_3D_feeder-holder-4-position.stl
Bing-feeder/V3-feeder/12mm_3D_parts/V3_3D_feeder-slot-1-position.step
Bing-feeder/V3-feeder/12mm_3D_parts/V3_3D_feeder-slot-1-position.stl
Bing-feeder/V3-feeder/12mm_3D_parts/V3_3D_feeder-slot-2-position.step
Bing-feeder/V3-feeder/12mm_3D_parts/V3_3D_feeder-slot-2-position.stl
Bing-feeder/V3-feeder/12mm_3D_parts/V3_3D_feeder-slot-4-position.step
Bing-feeder/V3-feeder/12mm_3D_parts/V3_3D_feeder-slot-4-position.stl
Bing-feeder/V3-feeder/12mm_3D_parts/V3_3D_gear-16t-bracket.stl
Bing-feeder/V3-feeder/12mm_3D_parts/V3_3D_main-body.step
Bing-feeder/V3-feeder/12mm_3D_parts/V3_3D_main-body.stl
Bing-feeder/V3-feeder/12mm_3D_parts/V3_3D_worm-motor-support.step
Bing-feeder/V3-feeder/12mm_3D_parts/V3_3D_worm-motor-support.stl
Bing-feeder/V3-feeder/16mm_3D_parts/V3_3D_feeder-holder-2-position.step
Bing-feeder/V3-feeder/16mm_3D_parts/V3_3D_feeder-holder-2-position.stl
Bing-feeder/V3-feeder/16mm_3D_parts/V3_3D_feeder-holder-3-position.step
Bing-feeder/V3-feeder/16mm_3D_parts/V3_3D_feeder-holder-3-position.stl
Bing-feeder/V3-feeder/16mm_3D_parts/V3_3D_feeder-slot-1-position.step
Bing-feeder/V3-feeder/16mm_3D_parts/V3_3D_feeder-slot-1-position.stl
Bing-feeder/V3-feeder/16mm_3D_parts/V3_3D_feeder-slot-2-position.step
Bing-feeder/V3-feeder/16mm_3D_parts/V3_3D_feeder-slot-2-position.stl
Bing-feeder/V3-feeder/16mm_3D_parts/V3_3D_feeder-slot-3-position.step
Bing-feeder/V3-feeder/16mm_3D_parts/V3_3D_feeder-slot-3-position.stl
Bing-feeder/V3-feeder/16mm_3D_parts/V3_3D_gear-16t-bracket.stl
Bing-feeder/V3-feeder/16mm_3D_parts/V3_3D_main-body.step
Bing-feeder/V3-feeder/16mm_3D_parts/V3_3D_main-body.stl
Bing-feeder/V3-feeder/16mm_3D_parts/V3_3D_worm-motor-support.step
Bing-feeder/V3-feeder/16mm_3D_parts/V3_3D_worm-motor-support.stl
Bing-feeder/V3-feeder/24mm_3D_parts/V3_3D_feeder-holder-2-position.step
Bing-feeder/V3-feeder/24mm_3D_parts/V3_3D_feeder-holder-2-position.stl
Bing-feeder/V3-feeder/24mm_3D_parts/V3_3D_feeder-holder-3-position.step
Bing-feeder/V3-feeder/24mm_3D_parts/V3_3D_feeder-holder-3-position.stl
Bing-feeder/V3-feeder/24mm_3D_parts/V3_3D_feeder-slot-1-position.step
Bing-feeder/V3-feeder/24mm_3D_parts/V3_3D_feeder-slot-1-position.stl
Bing-feeder/V3-feeder/24mm_3D_parts/V3_3D_feeder-slot-2-position.step
Bing-feeder/V3-feeder/24mm_3D_parts/V3_3D_feeder-slot-2-position.stl
Bing-feeder/V3-feeder/24mm_3D_parts/V3_3D_feeder-slot-3-position.step
Bing-feeder/V3-feeder/24mm_3D_parts/V3_3D_feeder-slot-3-position.stl
Bing-feeder/V3-feeder/24mm_3D_parts/V3_3D_gear-16t-bracket.stl
Bing-feeder/V3-feeder/24mm_3D_parts/V3_3D_main-body.step
Bing-feeder/V3-feeder/24mm_3D_parts/V3_3D_main-body.stl
Bing-feeder/V3-feeder/24mm_3D_parts/V3_3D_pcb-cover.step
Bing-feeder/V3-feeder/24mm_3D_parts/V3_3D_pcb-cover.stl
Bing-feeder/V3-feeder/24mm_3D_parts/V3_3D_switch-trigger.stl
Bing-feeder/V3-feeder/24mm_3D_parts/V3_3D_worm-motor-support.step
Bing-feeder/V3-feeder/24mm_3D_parts/V3_3D_worm-motor-support.stl
Bing-feeder/V3-feeder/8mm_3D_parts/V3_3D_feeder-holder-1-position.stl
Bing-feeder/V3-feeder/8mm_3D_parts/V3_3D_feeder-holder-3-position.stl
Bing-feeder/V3-feeder/8mm_3D_parts/V3_3D_feeder-holder-8-position.stl
Bing-feeder/V3-feeder/8mm_3D_parts/V3_3D_feeder-slot-1-position-2026-10-03.step
Bing-feeder/V3-feeder/8mm_3D_parts/V3_3D_feeder-slot-1-position-2026-10-03.stl
Bing-feeder/V3-feeder/8mm_3D_parts/V3_3D_feeder-slot-1-position.step
Bing-feeder/V3-feeder/8mm_3D_parts/V3_3D_feeder-slot-1-position.stl
Bing-feeder/V3-feeder/8mm_3D_parts/V3_3D_feeder-slot-3-position.step
Bing-feeder/V3-feeder/8mm_3D_parts/V3_3D_feeder-slot-3-position.stl
Bing-feeder/V3-feeder/8mm_3D_parts/V3_3D_feeder-slot-8-position-2026-10-03.step
Bing-feeder/V3-feeder/8mm_3D_parts/V3_3D_feeder-slot-8-position-2026-10-03.stl
Bing-feeder/V3-feeder/8mm_3D_parts/V3_3D_feeder-slot-8-position.step
Bing-feeder/V3-feeder/8mm_3D_parts/V3_3D_feeder-slot-8-position.stl
Bing-feeder/V3-feeder/8mm_3D_parts/V3_3D_gear-15t-module-0.7-6mm.stl
Bing-feeder/V3-feeder/8mm_3D_parts/V3_3D_gear-16t-bracket.stl
Bing-feeder/V3-feeder/8mm_3D_parts/V3_3D_gear-16t-module-0.7-6mm.stl
Bing-feeder/V3-feeder/8mm_3D_parts/V3_3D_gear-55t.step
Bing-feeder/V3-feeder/8mm_3D_parts/V3_3D_gear-55t.stl
Bing-feeder/V3-feeder/8mm_3D_parts/V3_3D_main-body.step
Bing-feeder/V3-feeder/8mm_3D_parts/V3_3D_main-body.stl
Bing-feeder/V3-feeder/8mm_3D_parts/V3_3D_pcb-cover.step
Bing-feeder/V3-feeder/8mm_3D_parts/V3_3D_pcb-cover.stl
Bing-feeder/V3-feeder/8mm_3D_parts/V3_3D_spool-hook-a.stl
Bing-feeder/V3-feeder/8mm_3D_parts/V3_3D_spring-support-plate.stl
Bing-feeder/V3-feeder/8mm_3D_parts/V3_3D_sprocket-cover.step
Bing-feeder/V3-feeder/8mm_3D_parts/V3_3D_sprocket-cover.stl
Bing-feeder/V3-feeder/8mm_3D_parts/V3_3D_switch-trigger-cover.step
Bing-feeder/V3-feeder/8mm_3D_parts/V3_3D_switch-trigger-cover.stl
Bing-feeder/V3-feeder/8mm_3D_parts/V3_3D_switch-trigger.stl
Bing-feeder/V3-feeder/8mm_3D_parts/V3_3D_tape-cover.stl
Bing-feeder/V3-feeder/8mm_3D_parts/V3_3D_worm-motor-support.step
Bing-feeder/V3-feeder/8mm_3D_parts/V3_3D_worm-motor-support.stl
Bing-feeder/V3-feeder/PRINT_projects/V3_12mm_switch-trigger-cover.3mf
Bing-feeder/V3-feeder/PRINT_projects/V3_gear-16t-bracket.3mf
Bing-feeder/V3-feeder/shared_3D_parts/V3_3D_pcb-cover-12-16mm.step
Bing-feeder/V3-feeder/shared_3D_parts/V3_3D_pcb-cover-12-16mm.stl
Bing-feeder/V3-feeder/shared_3D_parts/V3_3D_spool-hook-13mm.step
Bing-feeder/V3-feeder/shared_3D_parts/V3_3D_spool-hook-13mm.stl
Bing-feeder/V3-feeder/shared_3D_parts/V3_3D_spool-hook-b-11.5mm.step
Bing-feeder/V3-feeder/shared_3D_parts/V3_3D_spool-hook-b-11.5mm.stl
Bing-feeder/V3-feeder/sprocket_CAD/V3_sprocket-2mm-pitch.dwg
Bing-feeder/V3-feeder/sprocket_CAD/V3_sprocket-4mm-pitch.dwg
Bing-feeder/V485-feeder/3D_parts_12mm/V485_3D_feeder-holder-1-position.stl
Bing-feeder/V485-feeder/3D_parts_12mm/V485_3D_feeder-slot-1-position.stl
Bing-feeder/V485-feeder/3D_parts_12mm/V485_3D_gear-15t-module-0.7-10mm.stl
Bing-feeder/V485-feeder/3D_parts_12mm/V485_3D_gear-16t-bracket.stl
Bing-feeder/V485-feeder/3D_parts_12mm/V485_3D_gear-16t-module-0.7-10mm.stl
Bing-feeder/V485-feeder/3D_parts_12mm/V485_3D_main-body.stl
Bing-feeder/V485-feeder/3D_parts_12mm/V485_3D_pcb-cover.stl
Bing-feeder/V485-feeder/3D_parts_12mm/V485_3D_switch-trigger-cover.stl
Bing-feeder/V485-feeder/3D_parts_12mm/V485_3D_switch-trigger.stl
Bing-feeder/V485-feeder/3D_parts_12mm/V485_3D_tape-cover.stl
Bing-feeder/V485-feeder/3D_parts_12mm/V485_3D_worm-motor-support.stl
Bing-feeder/V485-feeder/3D_parts_16mm/V485_3D_feeder-holder-1-position.stl
Bing-feeder/V485-feeder/3D_parts_16mm/V485_3D_feeder-slot-1-position.stl
Bing-feeder/V485-feeder/3D_parts_16mm/V485_3D_gear-15t-module-0.7-14mm.stl
Bing-feeder/V485-feeder/3D_parts_16mm/V485_3D_gear-16t-bracket.stl
Bing-feeder/V485-feeder/3D_parts_16mm/V485_3D_gear-16t-module-0.7-14mm.stl
Bing-feeder/V485-feeder/3D_parts_16mm/V485_3D_main-body.stl
Bing-feeder/V485-feeder/3D_parts_16mm/V485_3D_pcb-cover.stl
Bing-feeder/V485-feeder/3D_parts_16mm/V485_3D_switch-trigger.stl
Bing-feeder/V485-feeder/3D_parts_16mm/V485_3D_tape-cover.stl
Bing-feeder/V485-feeder/3D_parts_16mm/V485_3D_worm-motor-support.stl
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
