gabrielyoung92/gabs_microSMT_PickAndPlace/Microsmt-PNPv3/PNP-V3_3D_parts_2026-02-04/PNPV3_bottom-camera-installation.docx

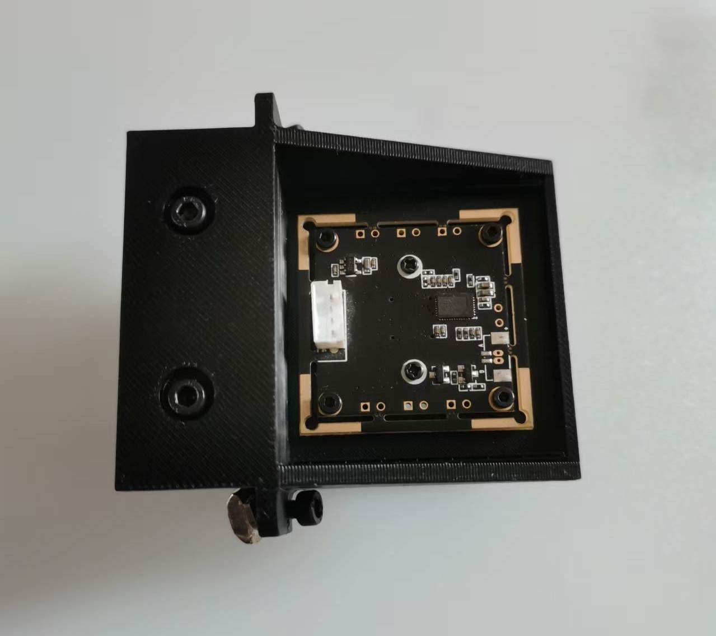
[picture p398: figure]

Tip: The direction of the camera must be the same as in the photo

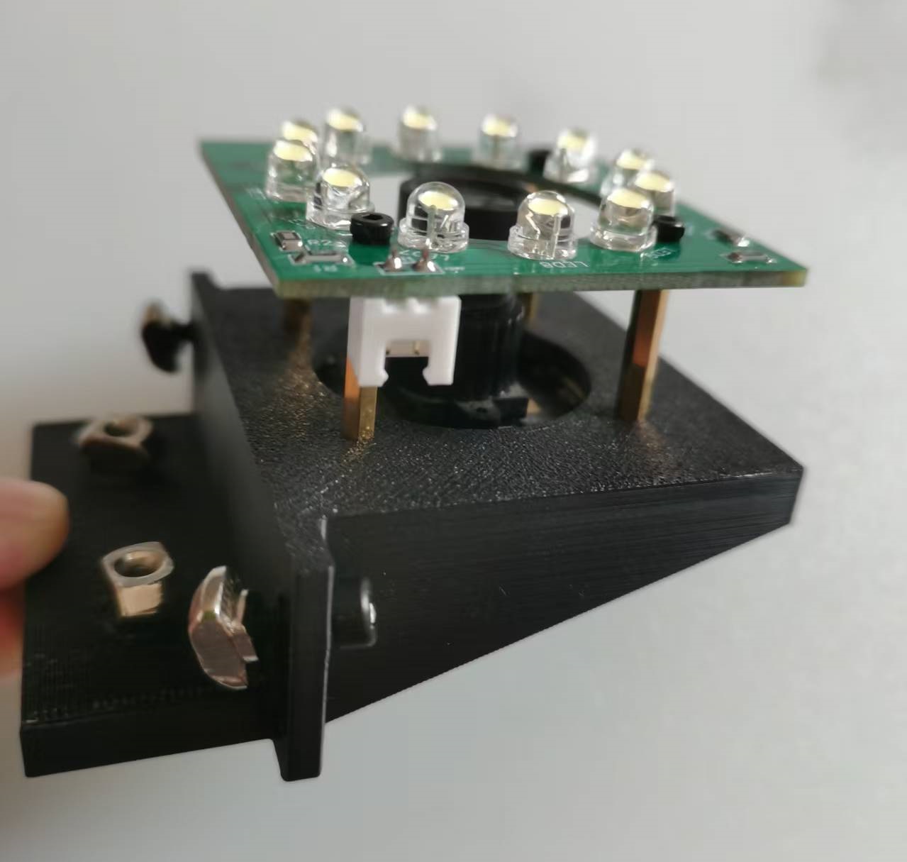
[picture p399: figure]

Tip 1: The length of the standoffs is 17mm.

Tip 2: Lock the 4 M3 screws to ensure the bottom camera is level.

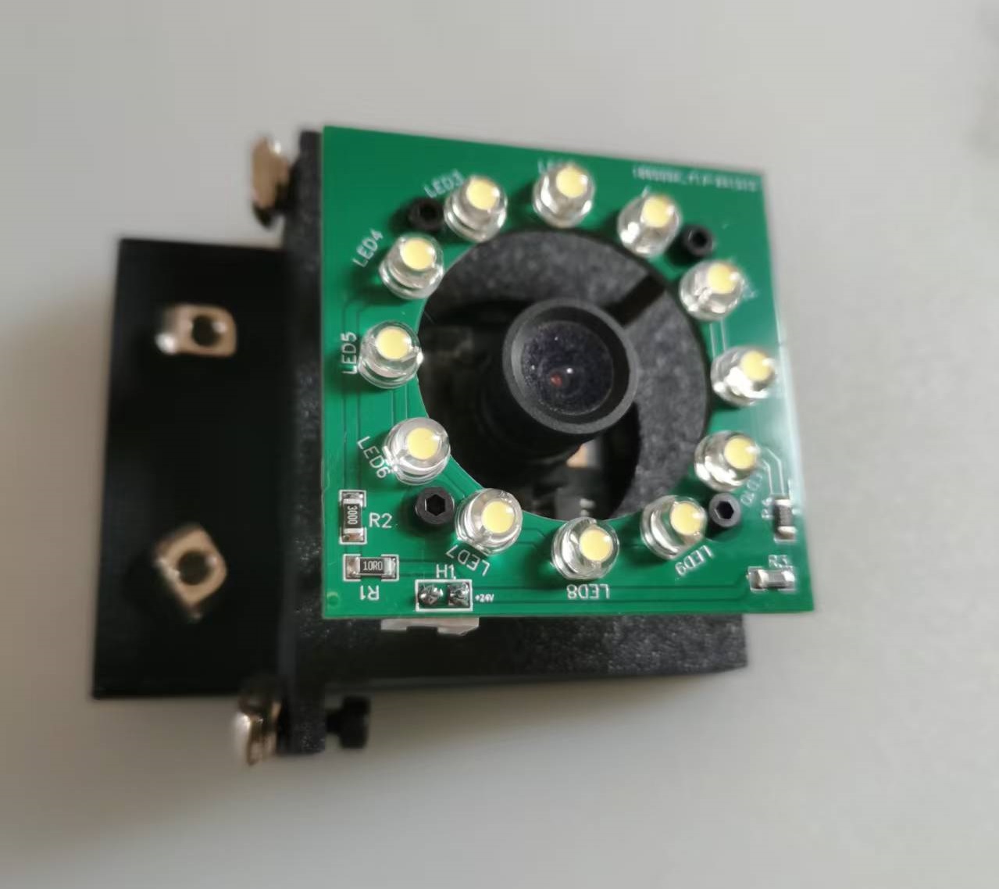
[picture p400: figure]
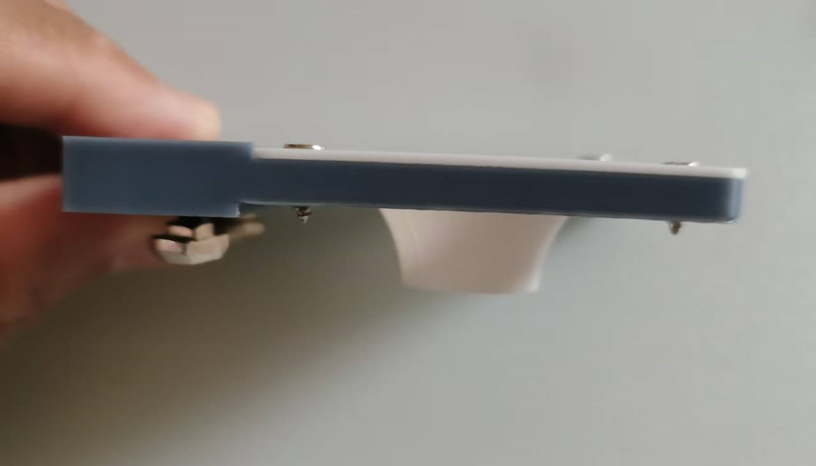
[picture p401: figure]
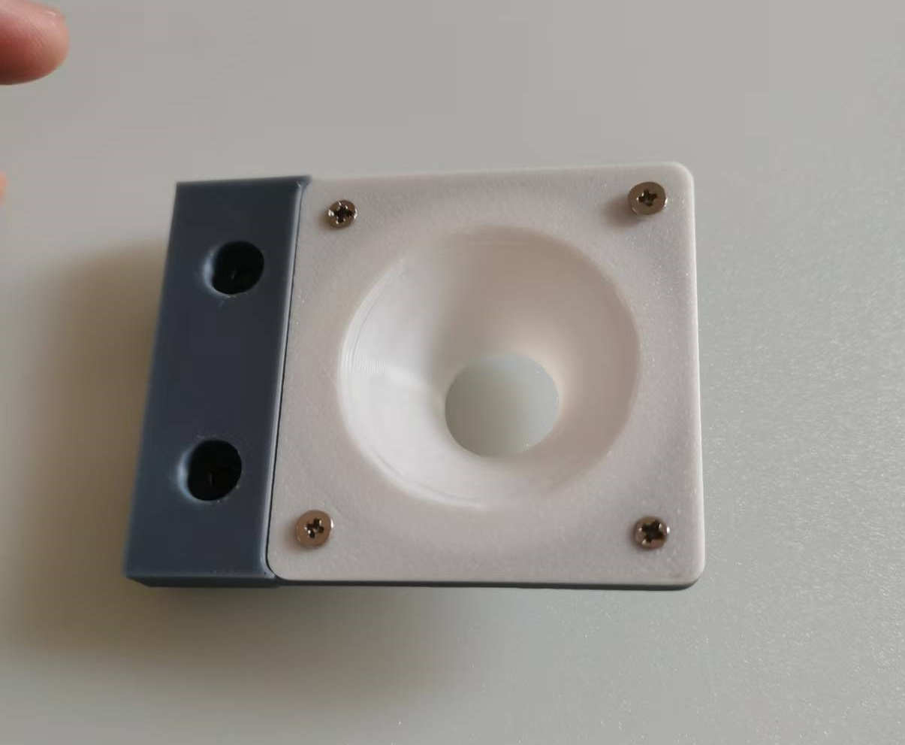
[picture p402: figure]

Tip: The diffuser plate can be printed with white or semi transparent PLA or ABS.

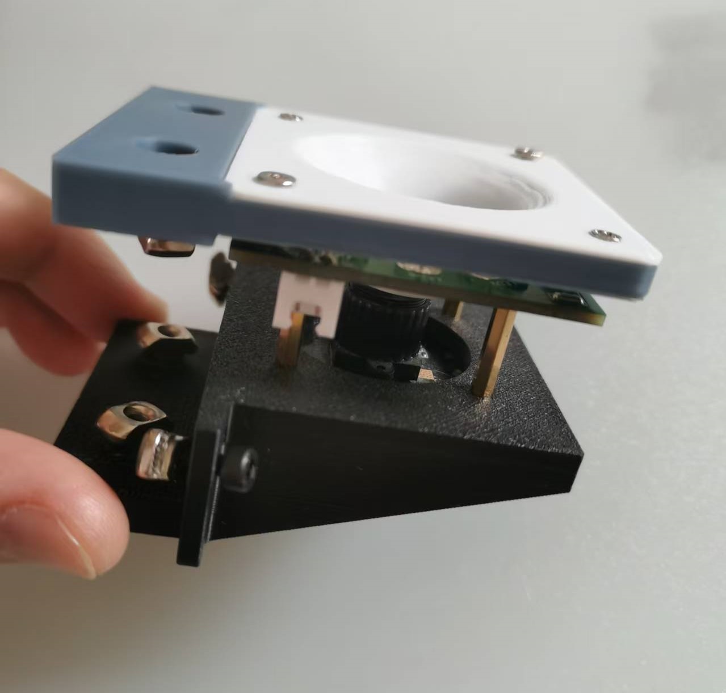
[picture p403: figure]
