gabrielyoung92/gabs_microSMT_PickAndPlace/Microsmt-PNPv3/Assembly manual for  the frame of pnpv3 20241226.pdf

# Assembly manual

# for the frame of PNPv3

2024.12.26

Please also refer to the assembly demonstration video. Can be completed faster.

# MicrosmtLab

## www.microsmt.com.cn

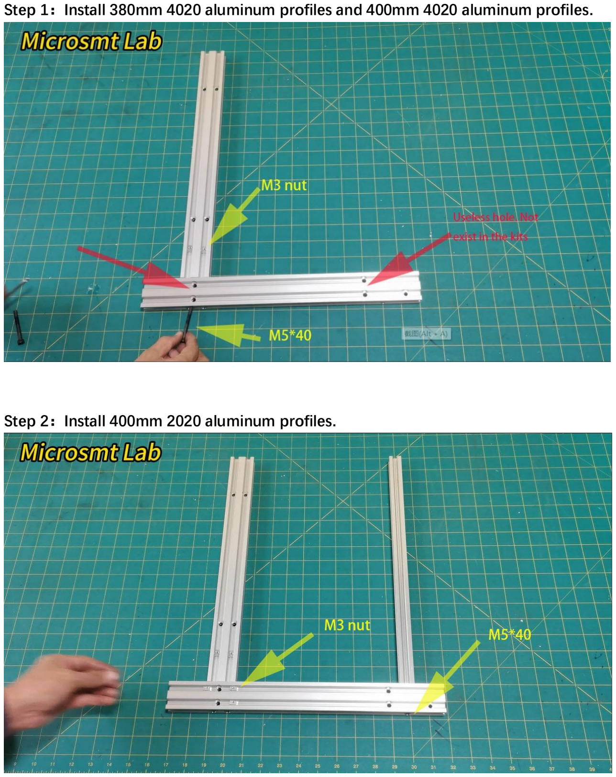
[picture p404: page 2]

Step 1：Install 380mm 4020 aluminum profiles and 400mm 4020 aluminum profiles.
Step 2：Install 400mm 2020 aluminum profiles.

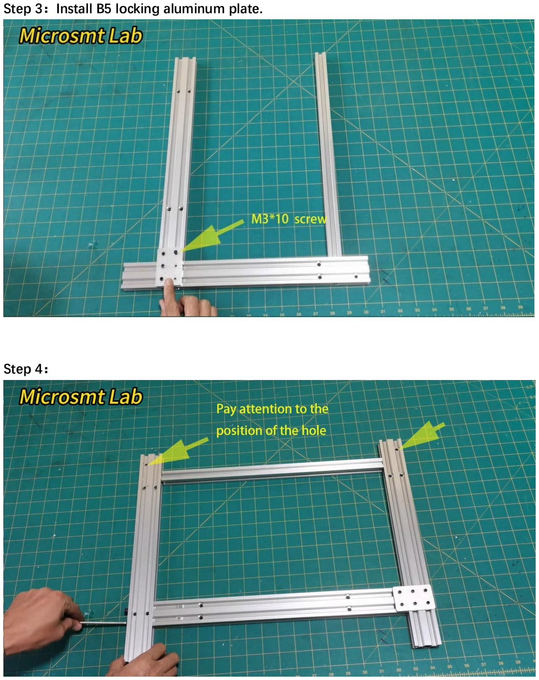
[picture p405: page 3]

Step 3：Install B5 locking aluminum plate.
Step 4：

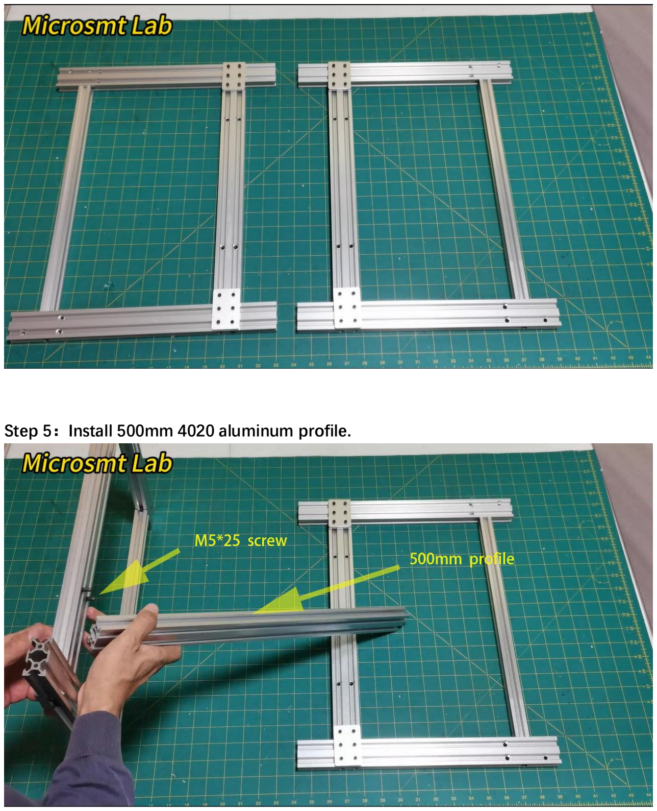
[picture p406: page 4]

Step 5：Install 500mm 4020 aluminum profile.

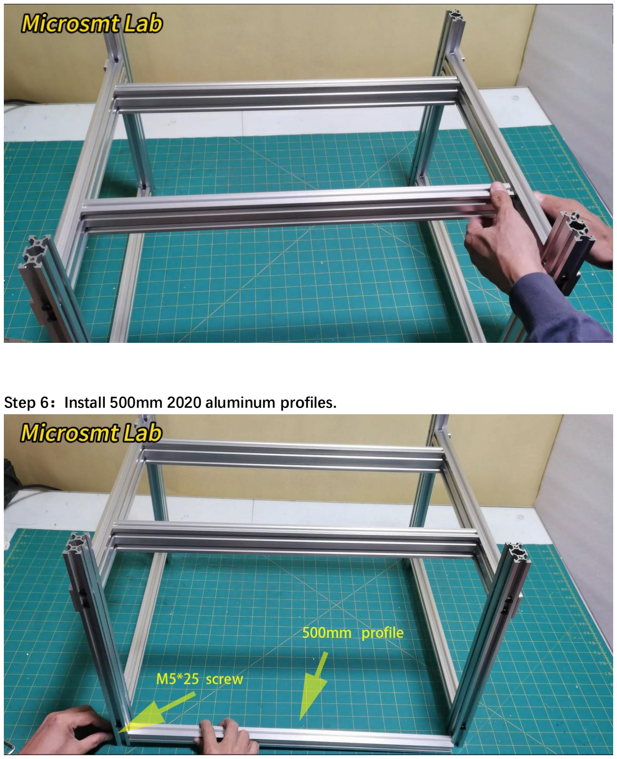
[picture p407: page 5]

Step 6：Install 500mm 2020 aluminum profiles.

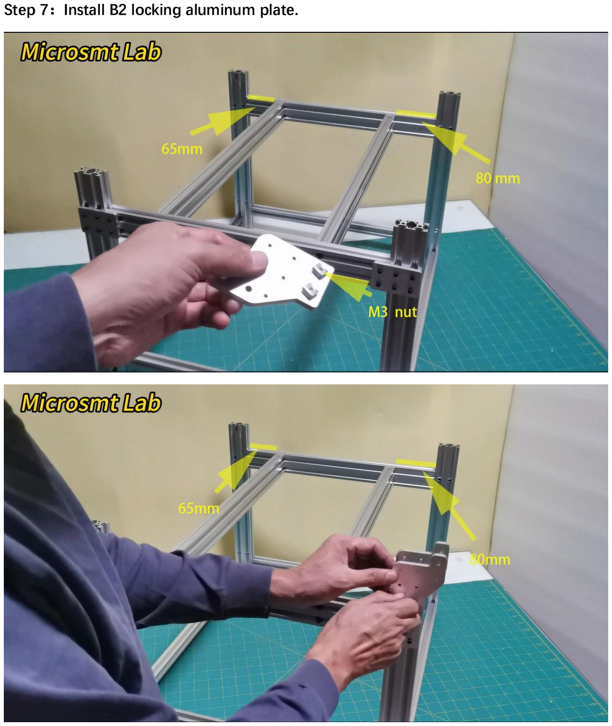
[picture p408: page 6]

Step 7：Install B2 locking aluminum plate.

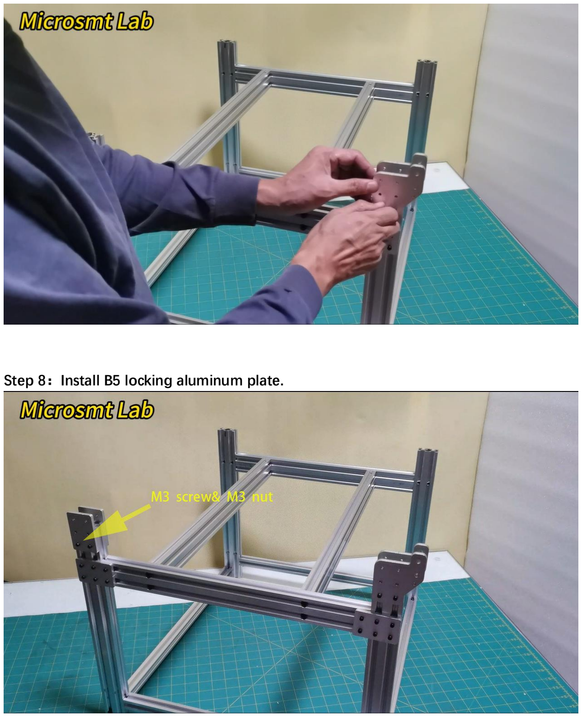
[picture p409: page 7]

Step 8：Install B5 locking aluminum plate.

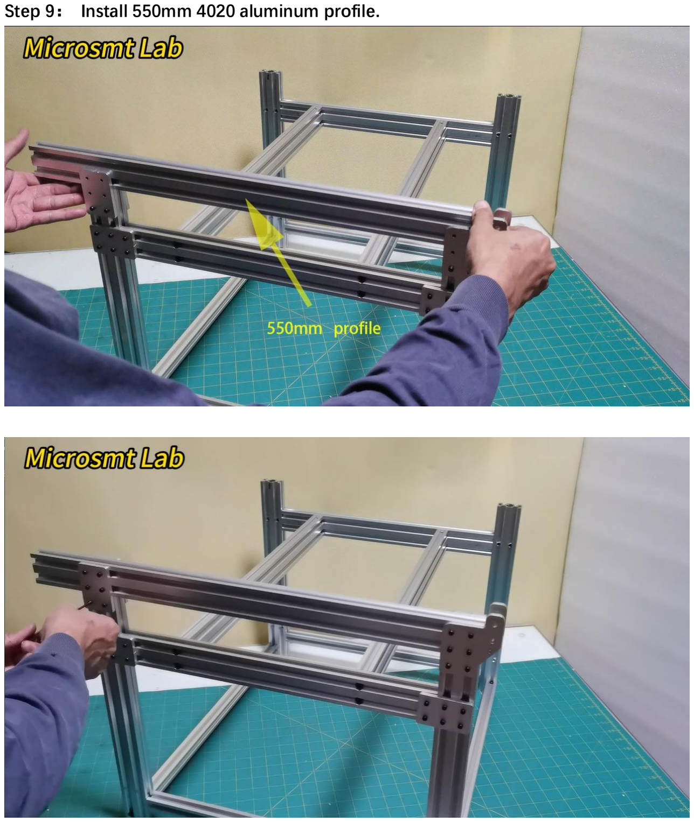
[picture p410: page 8]

Step 9： Install 550mm 4020 aluminum profile.

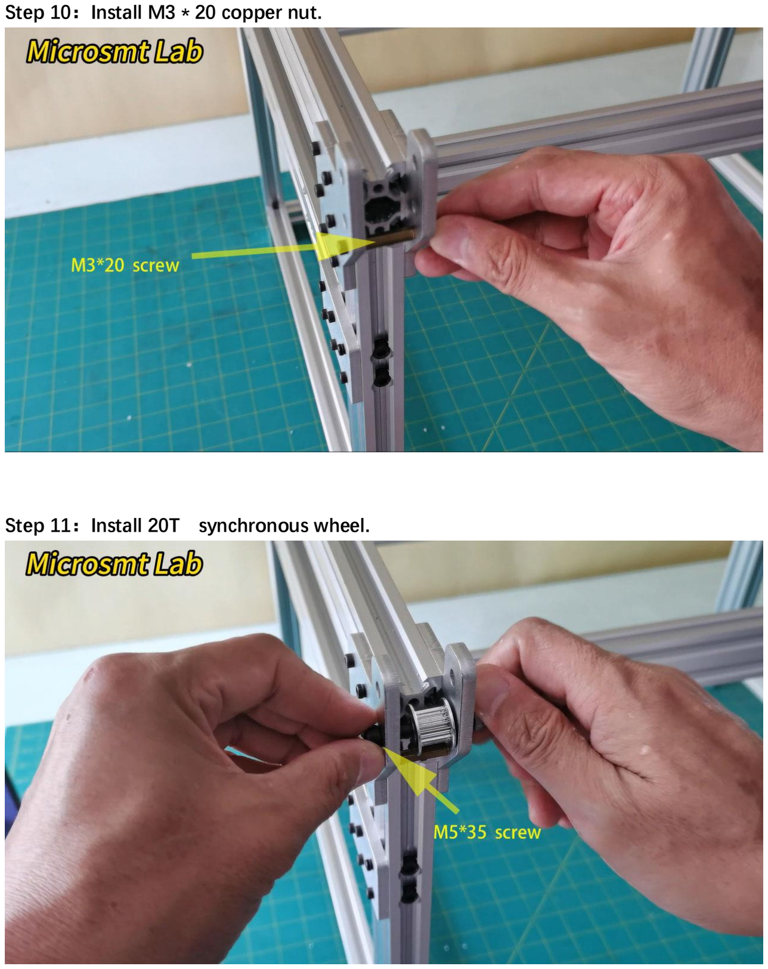
[picture p411: page 9]

Step 10：Install M3 * 20 copper nut.
Step 11：Install 20T synchronous wheel.

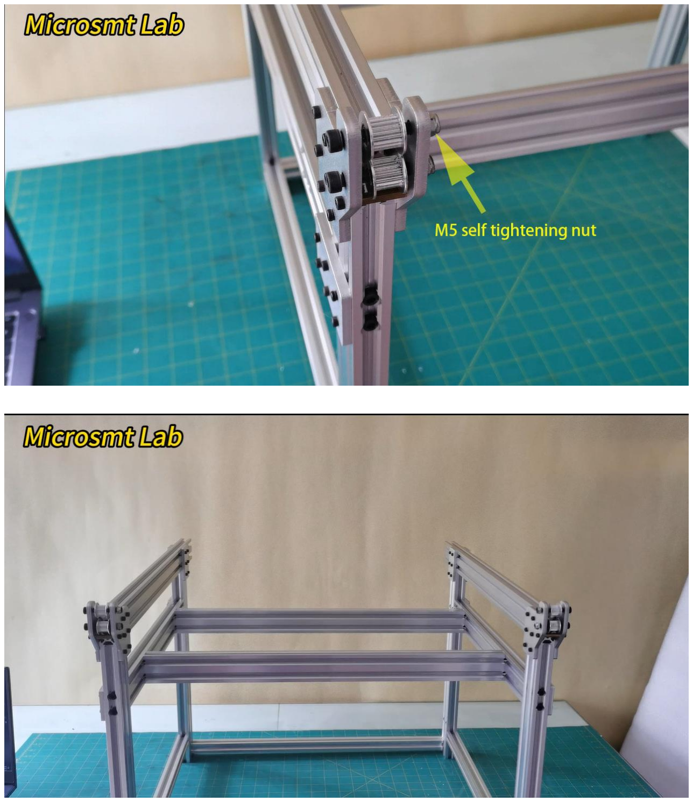
[picture p412: page 10]
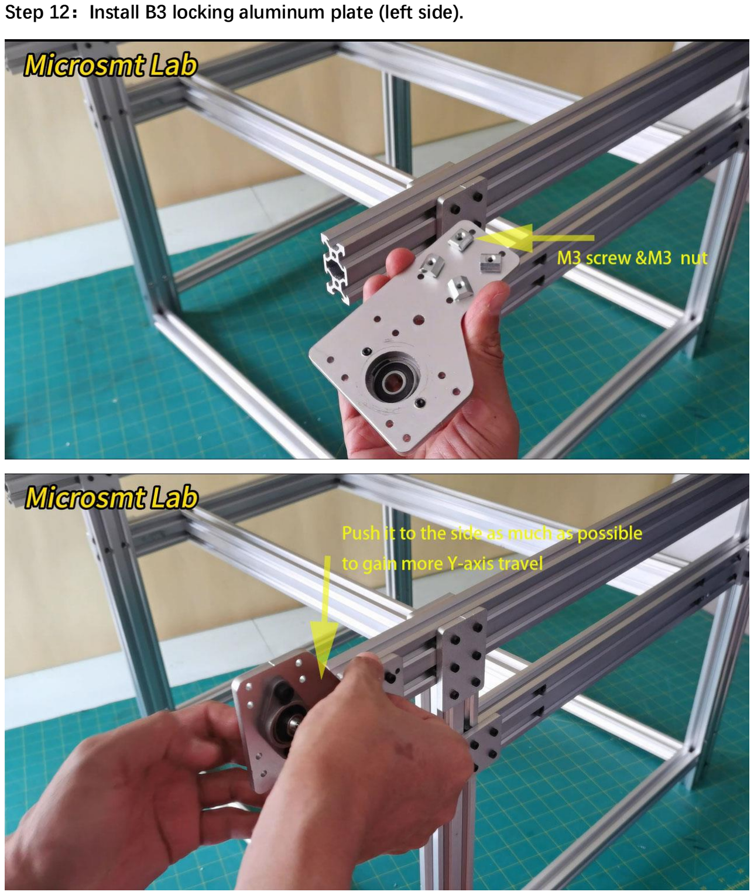
[picture p413: page 11]

Step 12：Install B3 locking aluminum plate (left side).

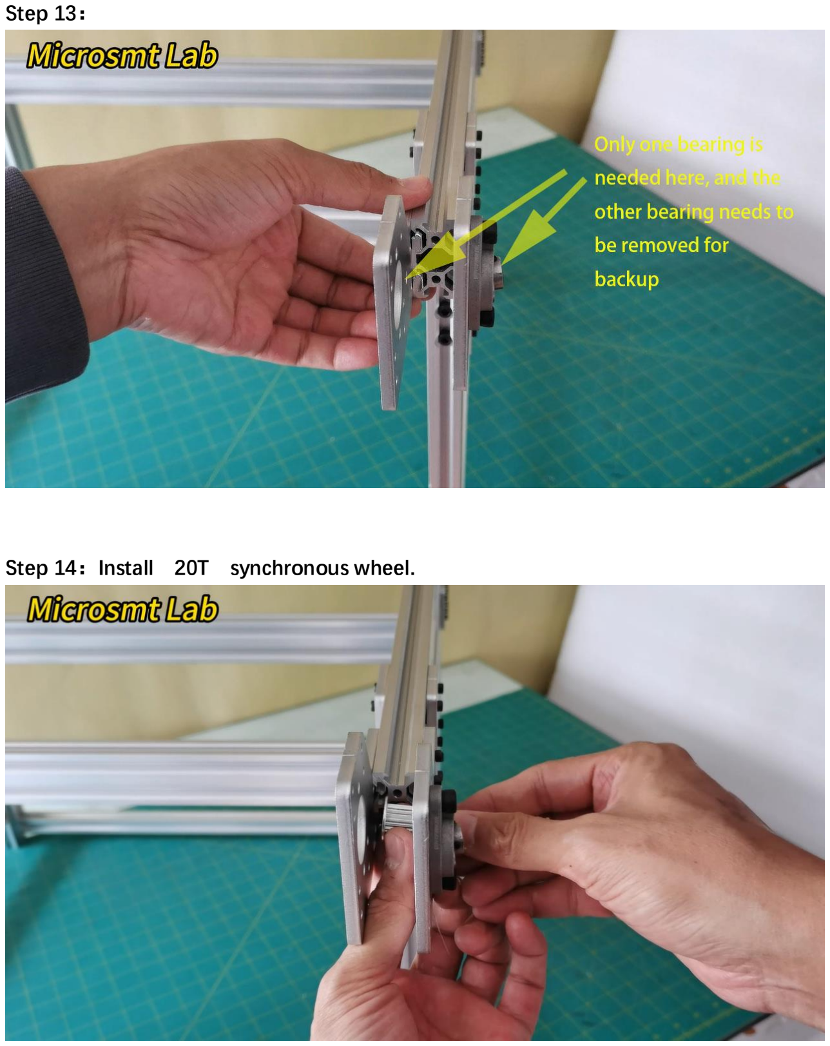
[picture p414: page 12]

Step 13：
Step 14：Install 20T synchronous wheel.

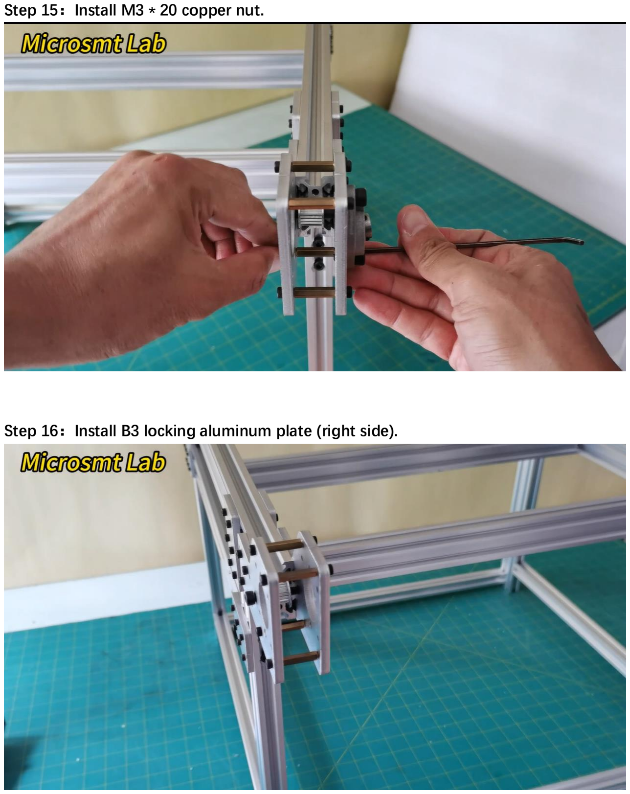
[picture p415: page 13]

Step 15：Install M3 * 20 copper nut.
Step 16：Install B3 locking aluminum plate (right side).

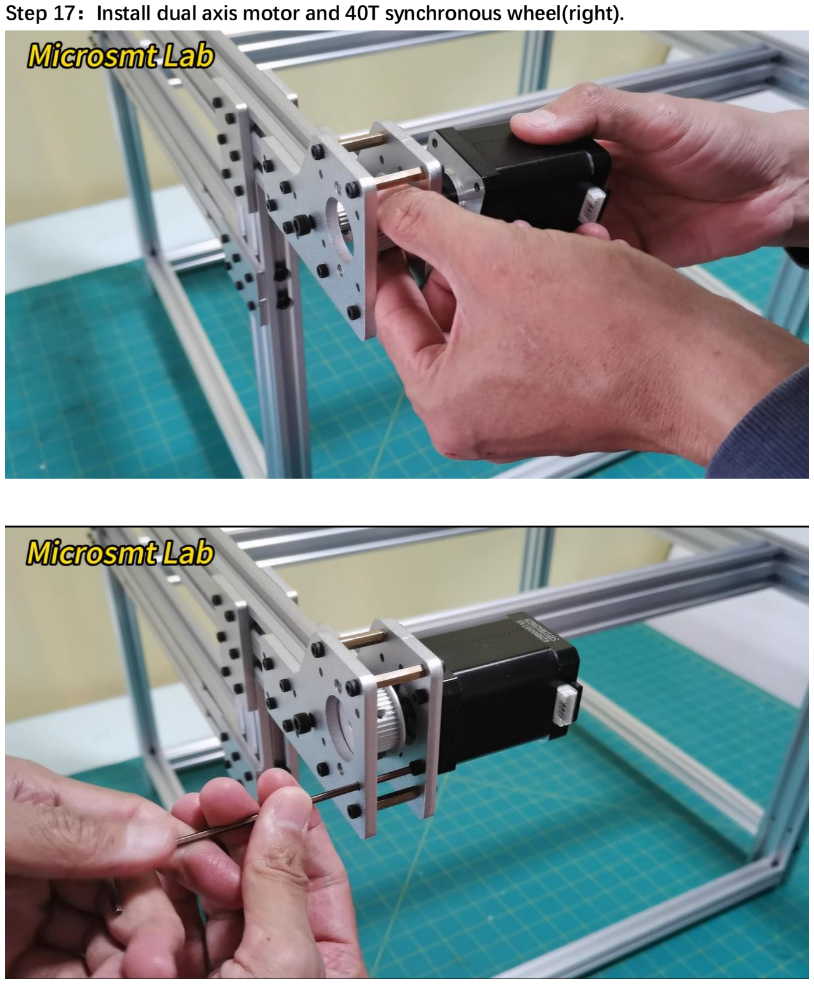
[picture p416: page 14]

Step 17：Install dual axis motor and 40T synchronous wheel(right).

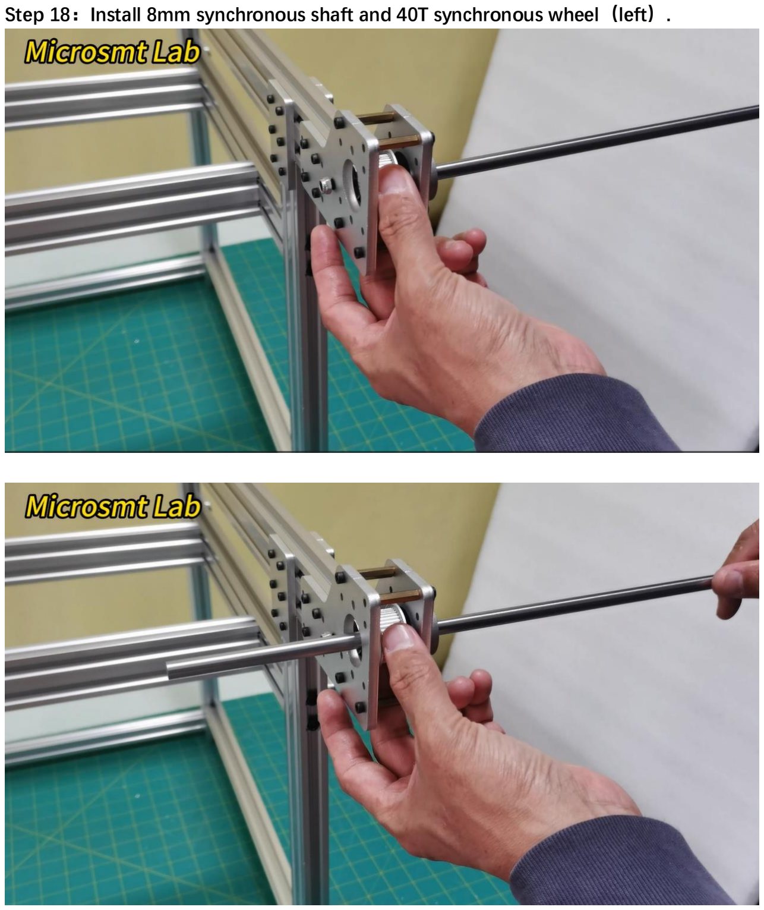
[picture p417: page 15]

Step 18：Install 8mm synchronous shaft and 40T synchronous wheel（left）.

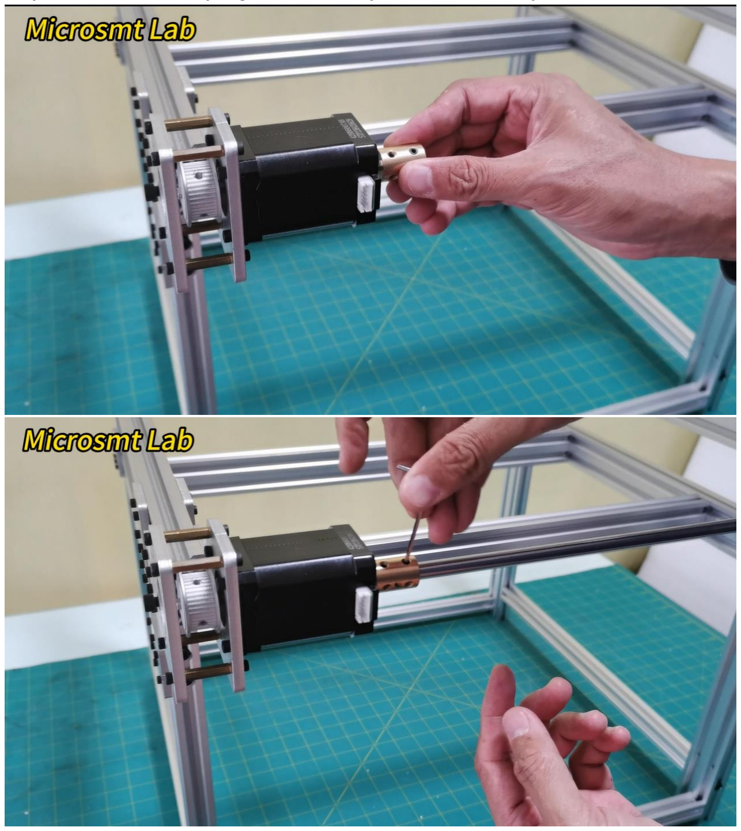
[picture p418: figure]

Step 19：Install the coupling and lock the synchronous shaft by M4 scew.

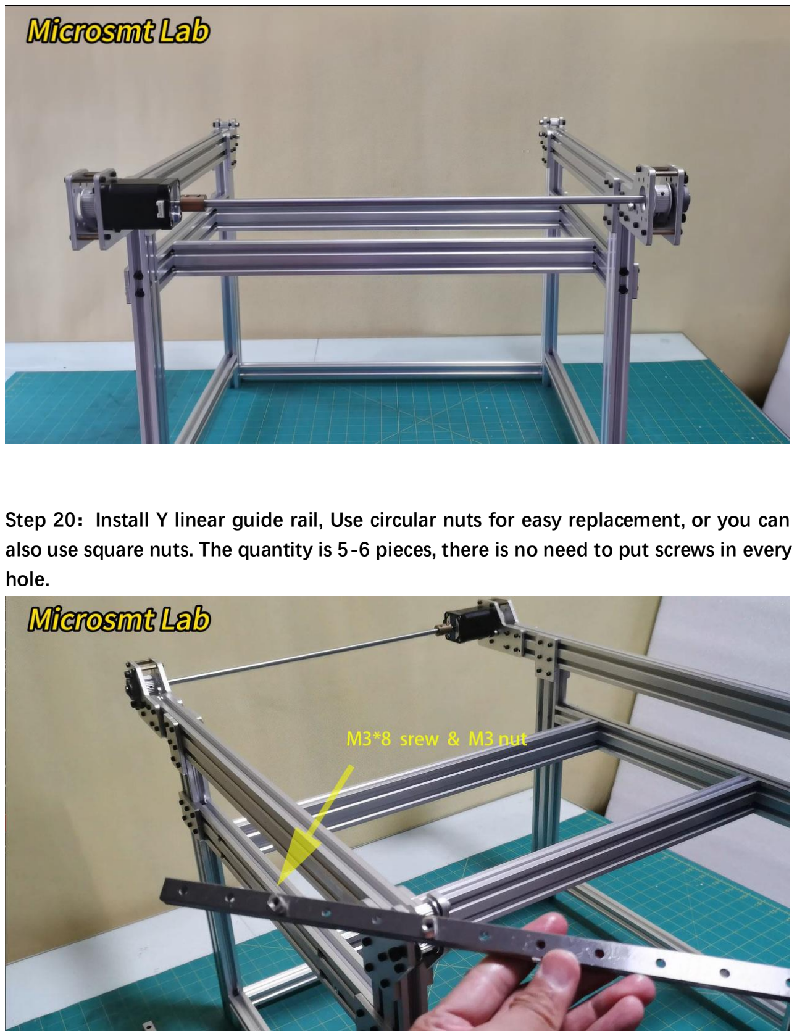
[picture p419: page 17]

Step 20：Install Y linear guide rail, Use circular nuts for easy replacement, or you can also use square nuts. The quantity is 5-6 pieces, there is no need to put screws in every hole.

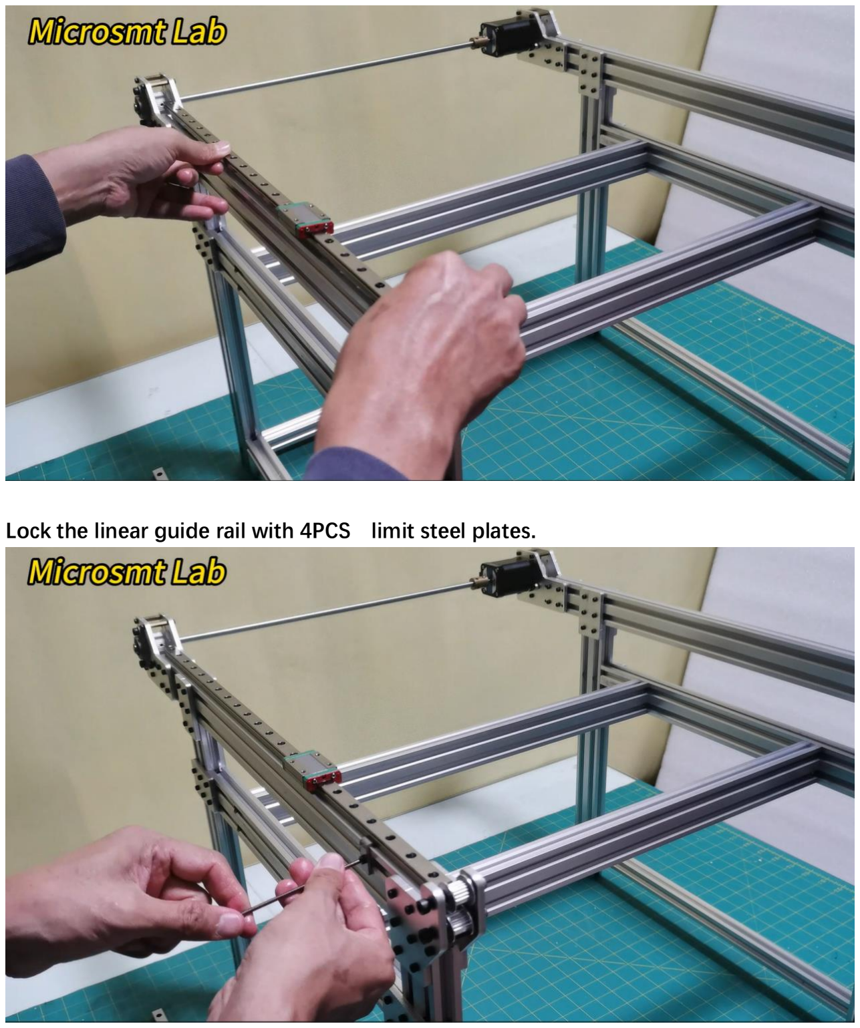
[picture p420: page 18]

Lock the linear guide rail with 4PCS limit steel plates.

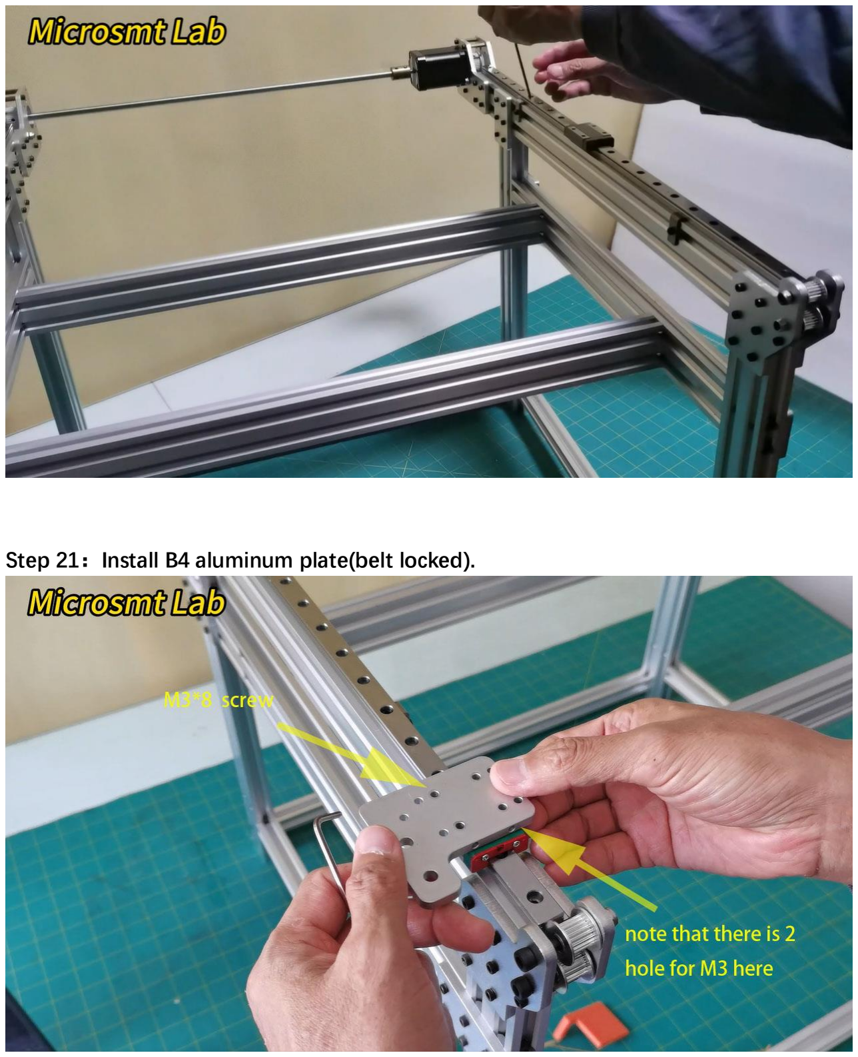
[picture p421: page 19]

Step 21：Install B4 aluminum plate(belt locked).

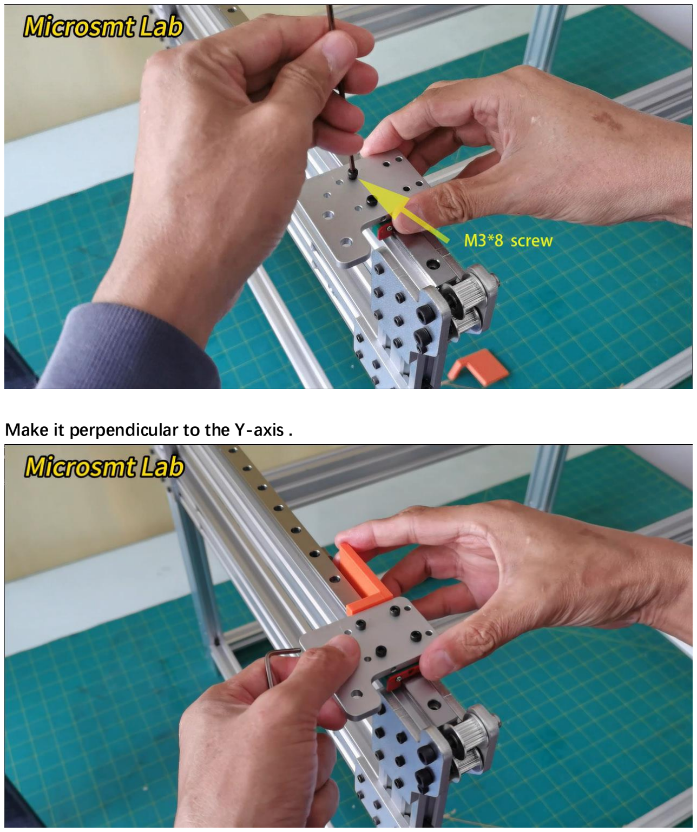
[picture p422: page 20]

Make it perpendicular to the Y-axis .

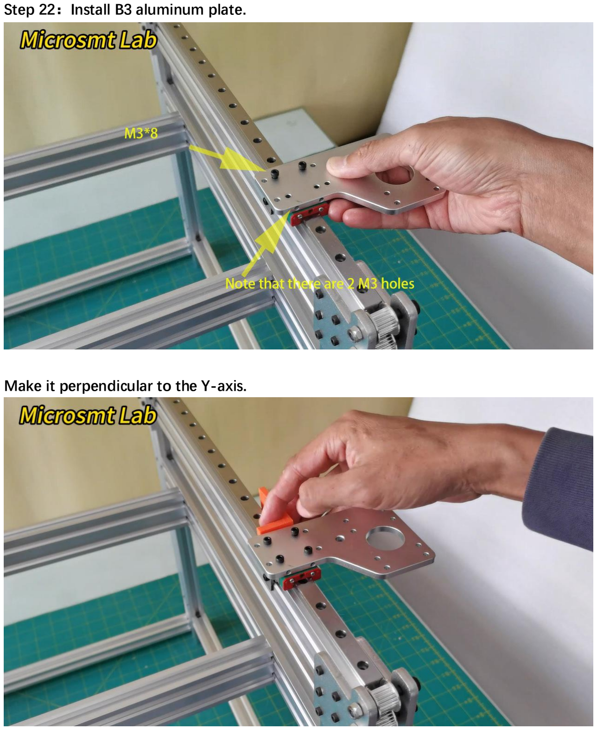
[picture p423: page 21]

Step 22：Install B3 aluminum plate.

Make it perpendicular to the Y-axis.

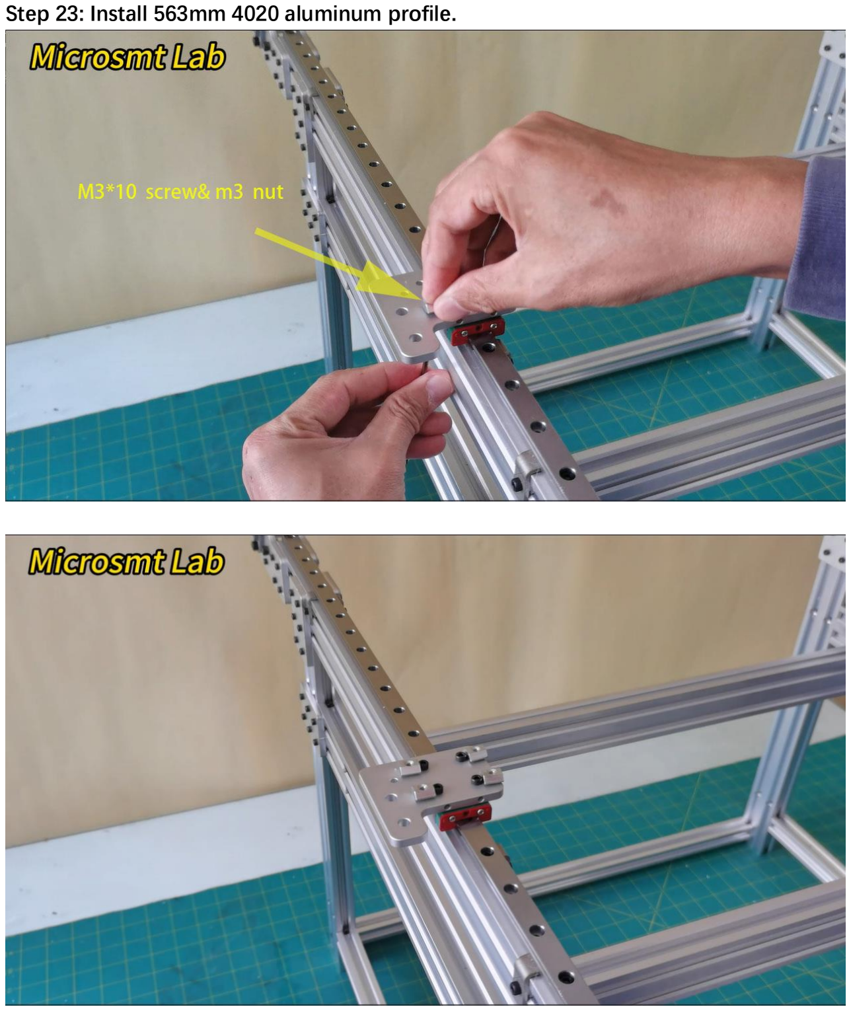
[picture p424: page 22]

Step 23: Install 563mm 4020 aluminum profile.

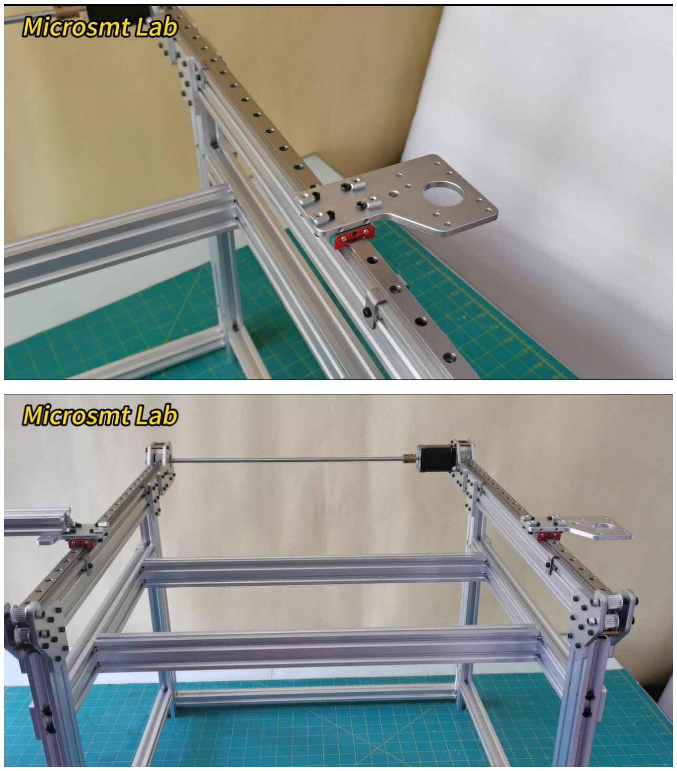
[picture p425: page 23]
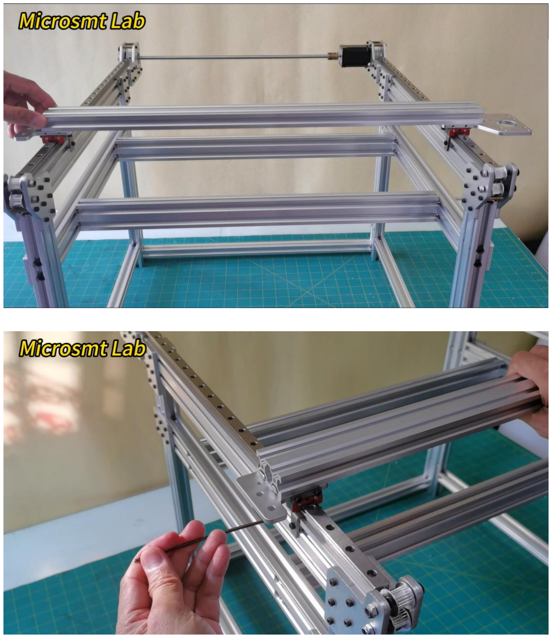
[picture p426: page 24]
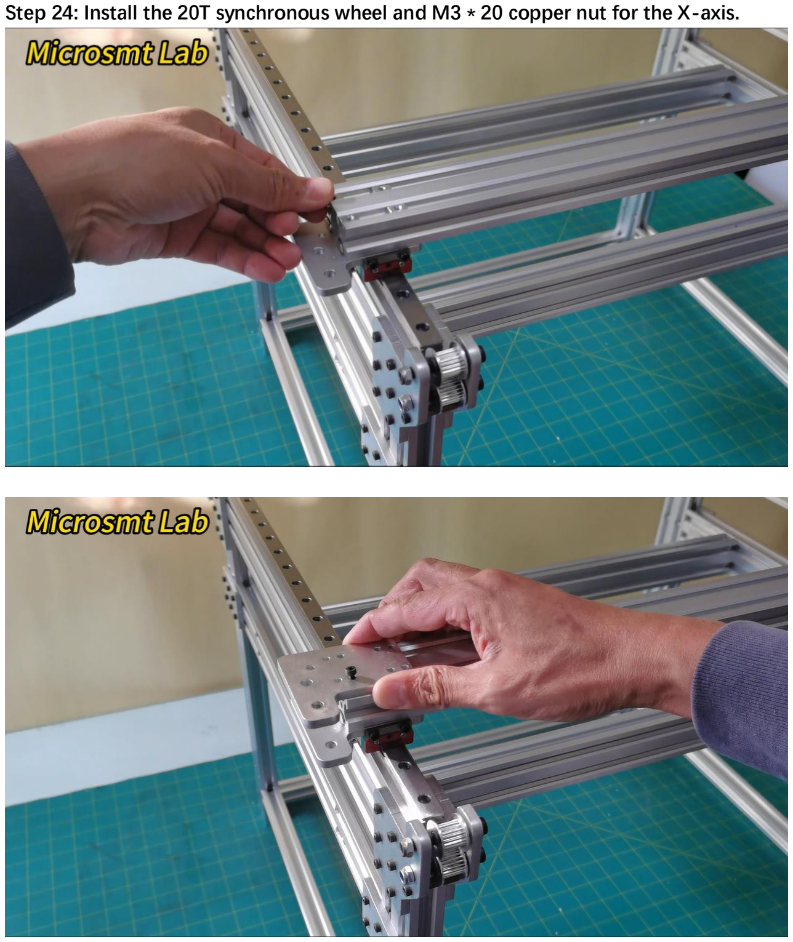
[picture p427: page 25]

Step 24: Install the 20T synchronous wheel and M3 * 20 copper nut for the X-axis.

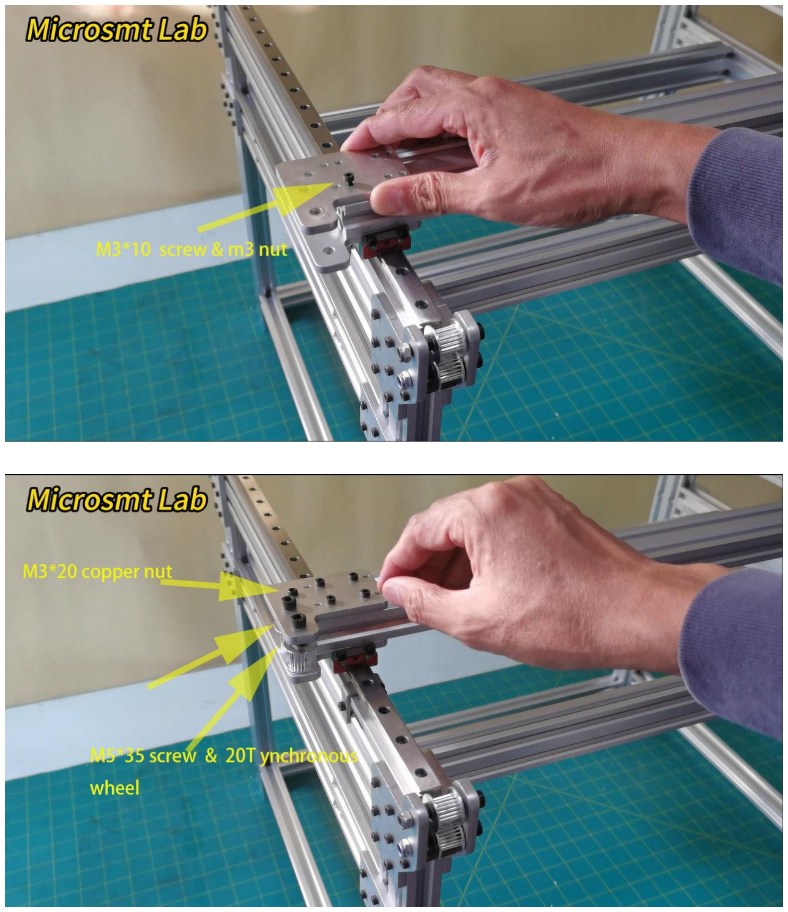
[picture p428: page 26]
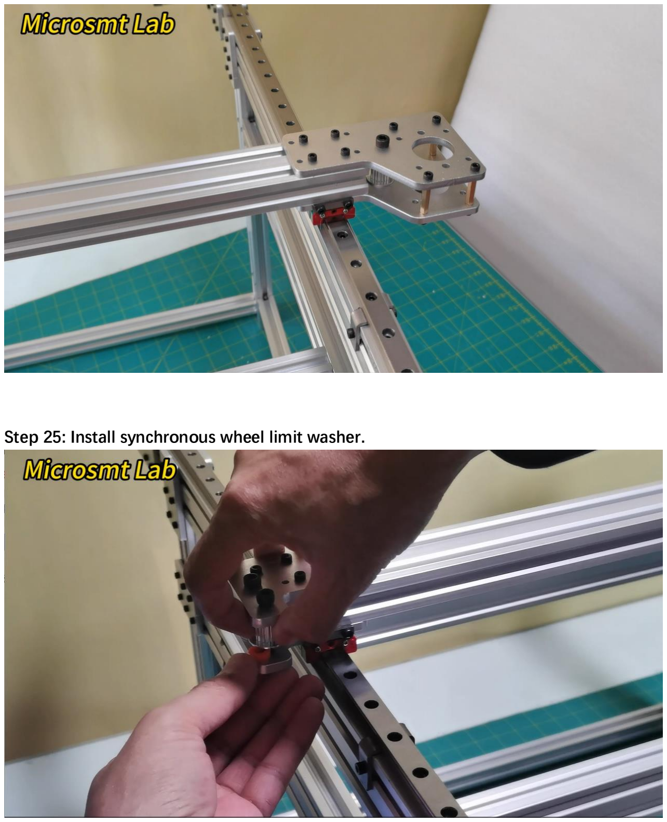
[picture p429: page 27]

Step 25: Install synchronous wheel limit washer.

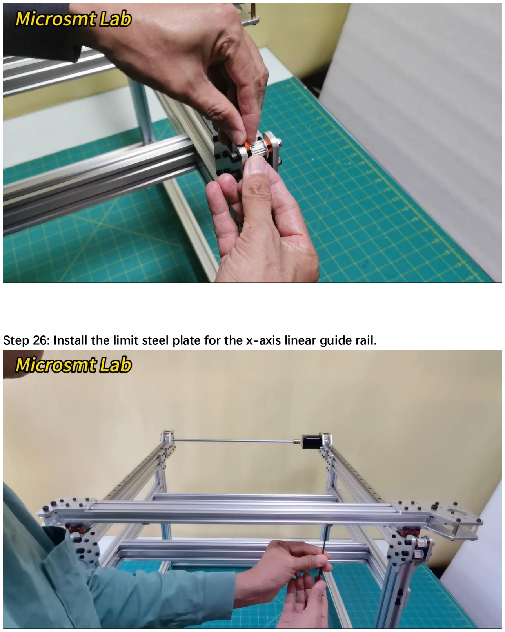
[picture p430: page 28]

Step 26: Install the limit steel plate for the x-axis linear guide rail.

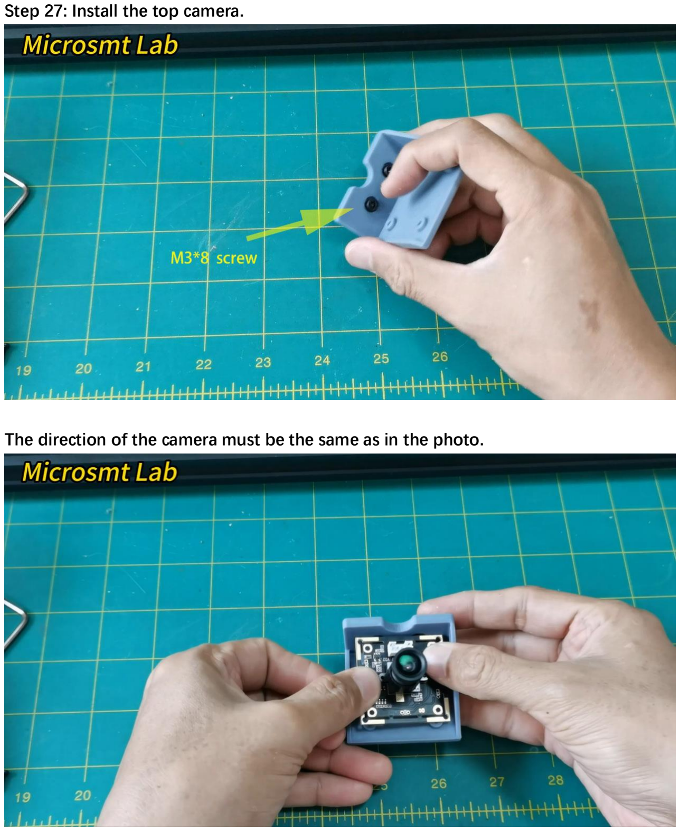
[picture p431: page 29]

Step 27: Install the top camera.

The direction of the camera must be the same as in the photo.

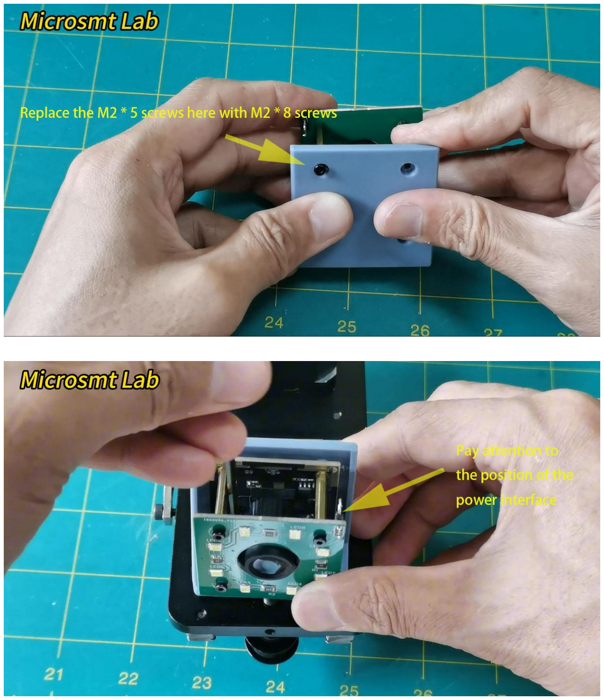
[picture p432: page 30]
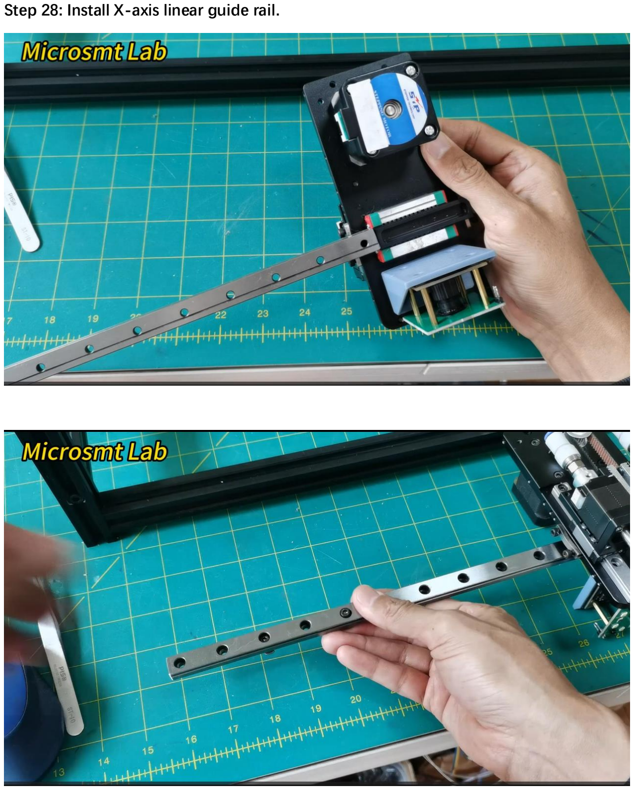
[picture p433: page 31]

Step 28: Install X-axis linear guide rail.

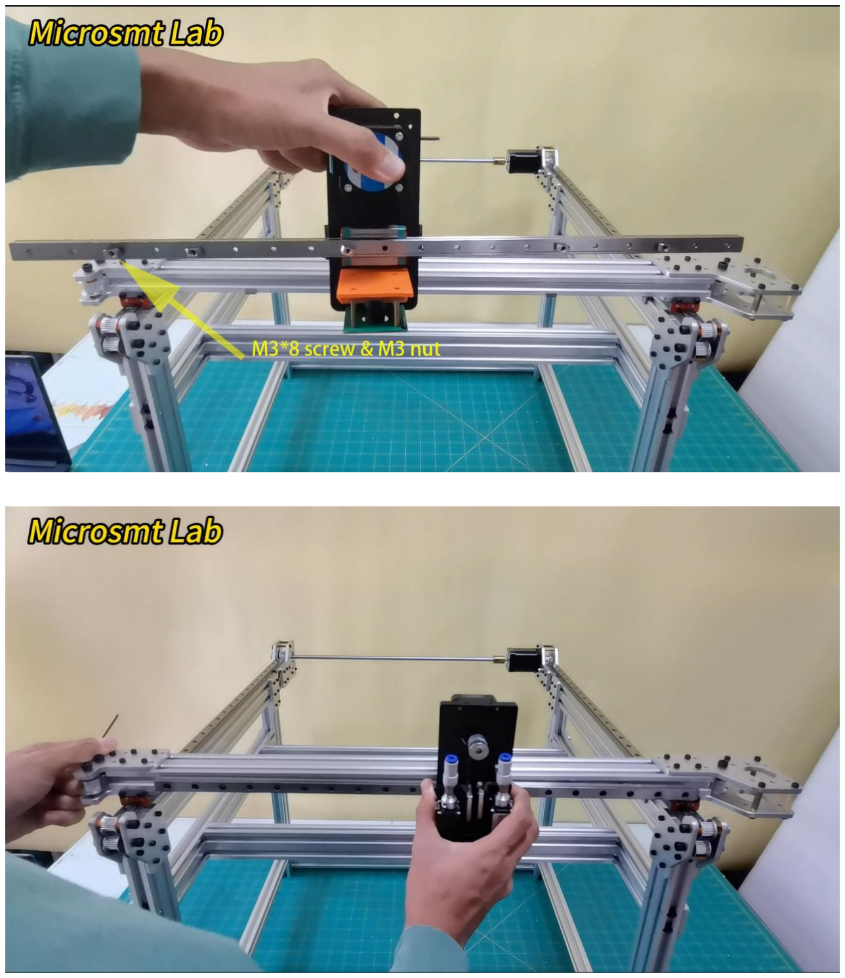
[picture p434: page 32]
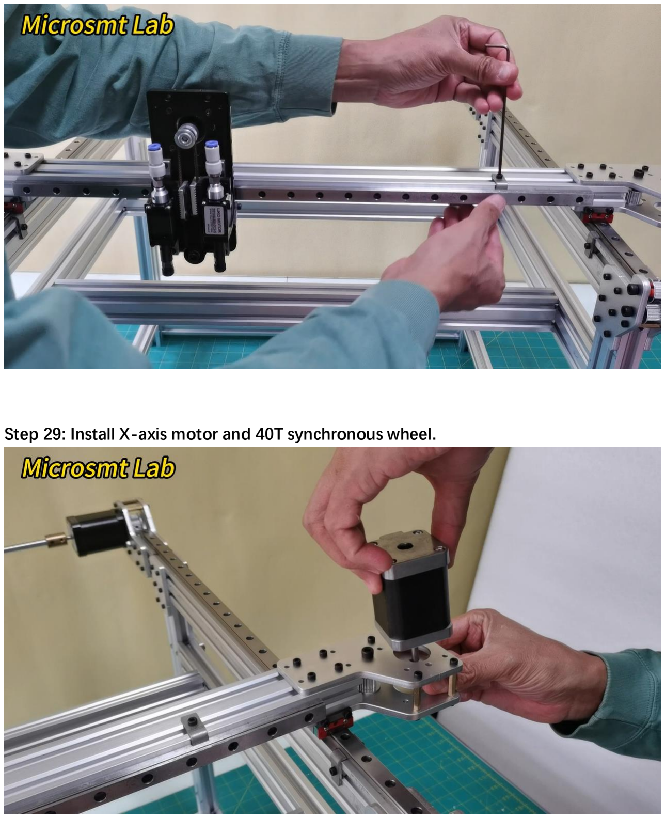
[picture p435: page 33]

Step 29: Install X-axis motor and 40T synchronous wheel.

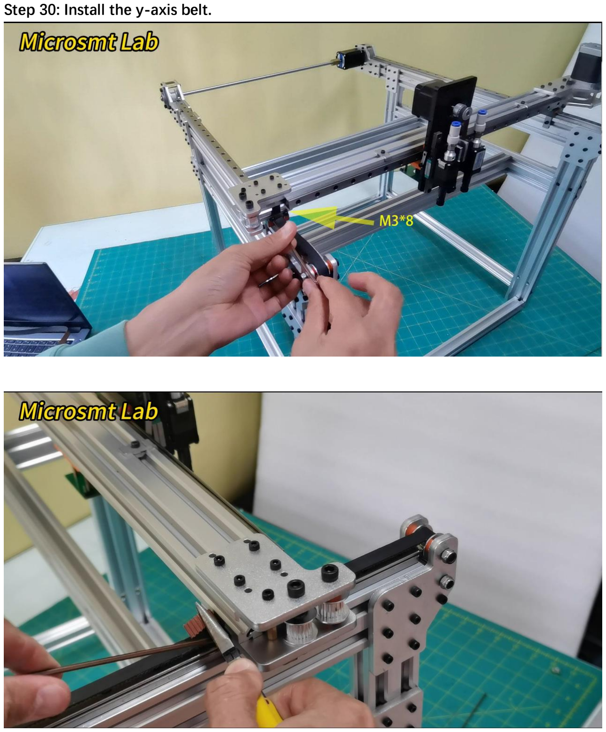
[picture p436: page 34]

Step 30: Install the y-axis belt.

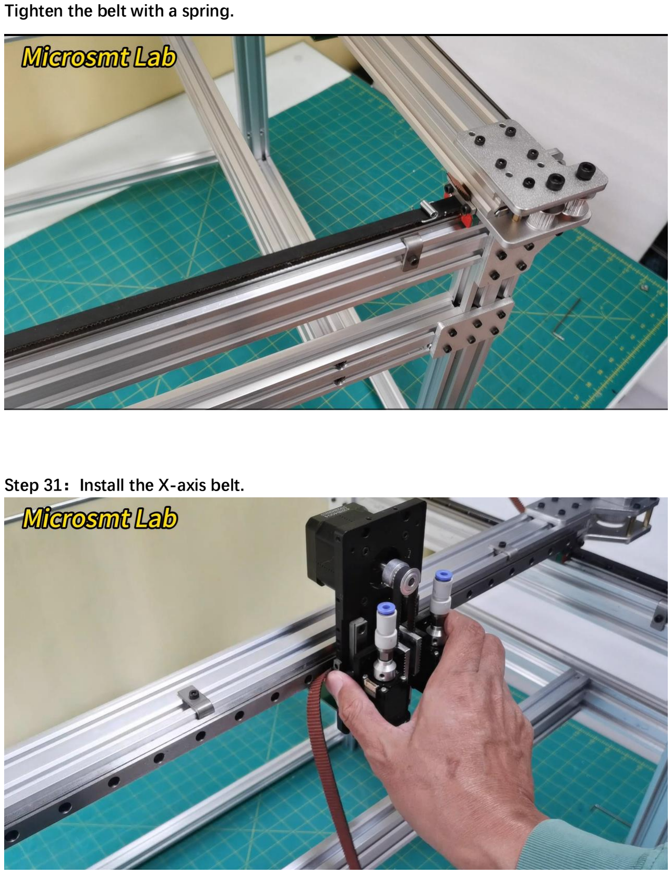
[picture p437: page 35]

Tighten the belt with a spring.

Step 31：Install the X-axis belt.

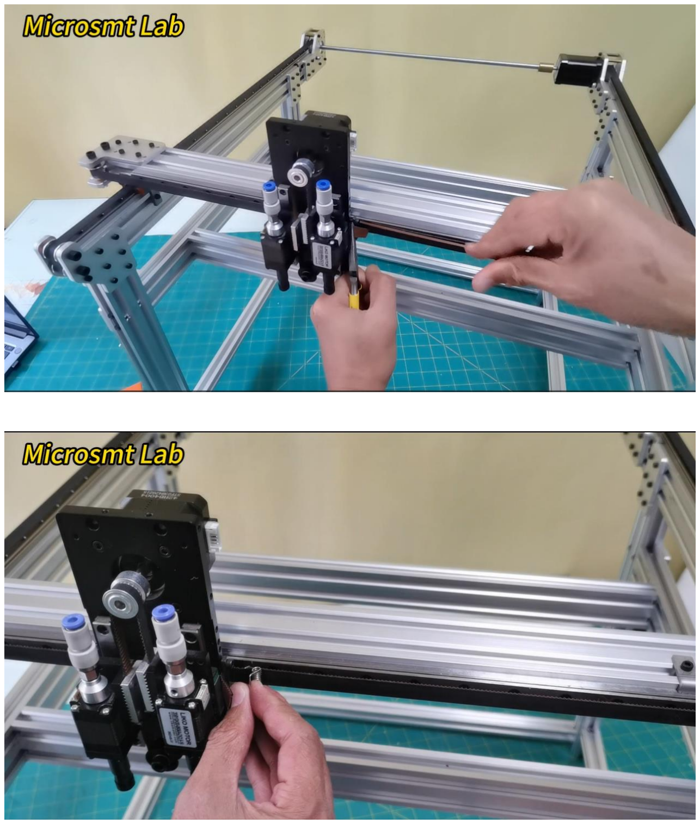
[picture p438: page 36]

Complete the assembly of the frame.

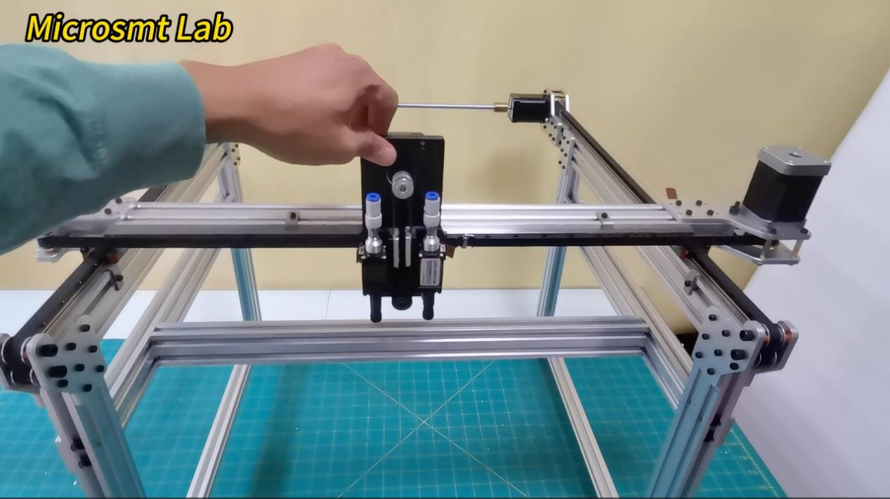
[picture p439: figure]
