gabrielyoung92/gabs_microSMT_PickAndPlace/Microsmt-PNPv3/Assembly Manual for Electrical  of  PNPv3 2025082801.pdf

# Assembly manual

# for the electrical of

# PNPv3

2025.08.28

Please also refer to the assembly demonstration video. Can be completed faster.

# MicrosmtLab

## www.microsmt.com.cn

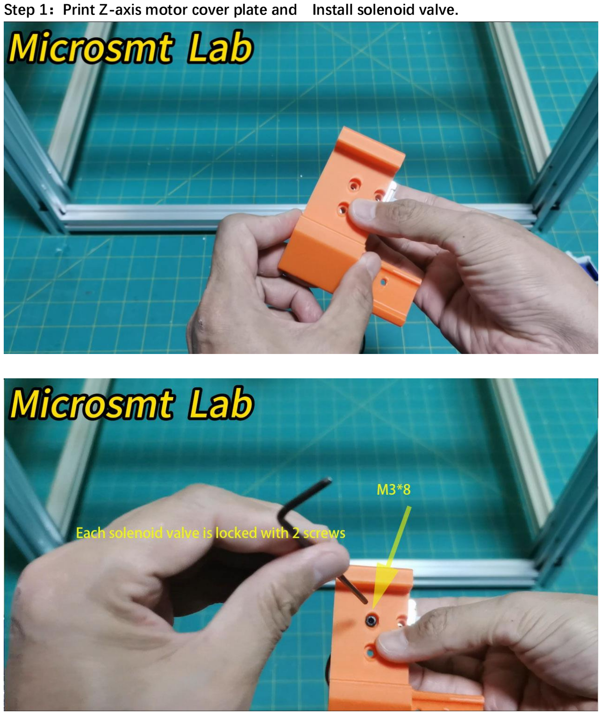
[picture p440: page 2]

Step 1：Print Z-axis motor cover plate and Install solenoid valve.

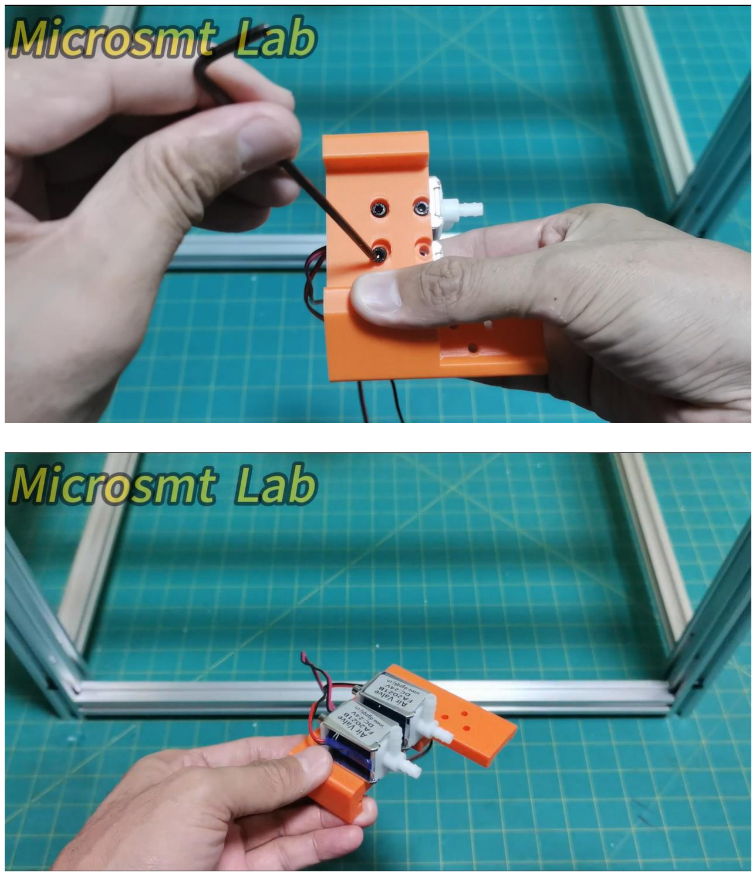
[picture p441: page 3]
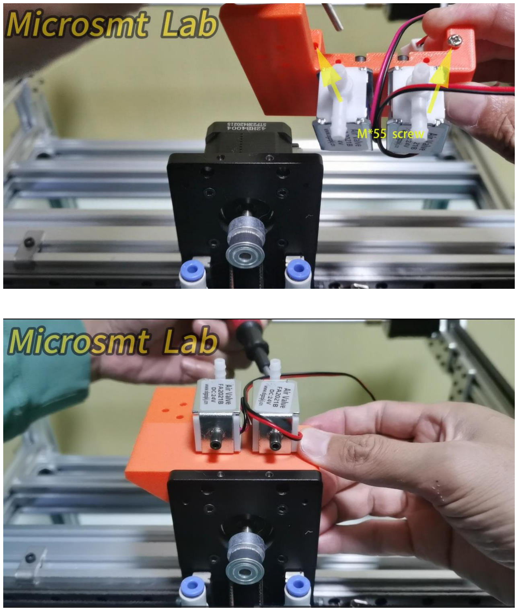
[picture p442: page 4]
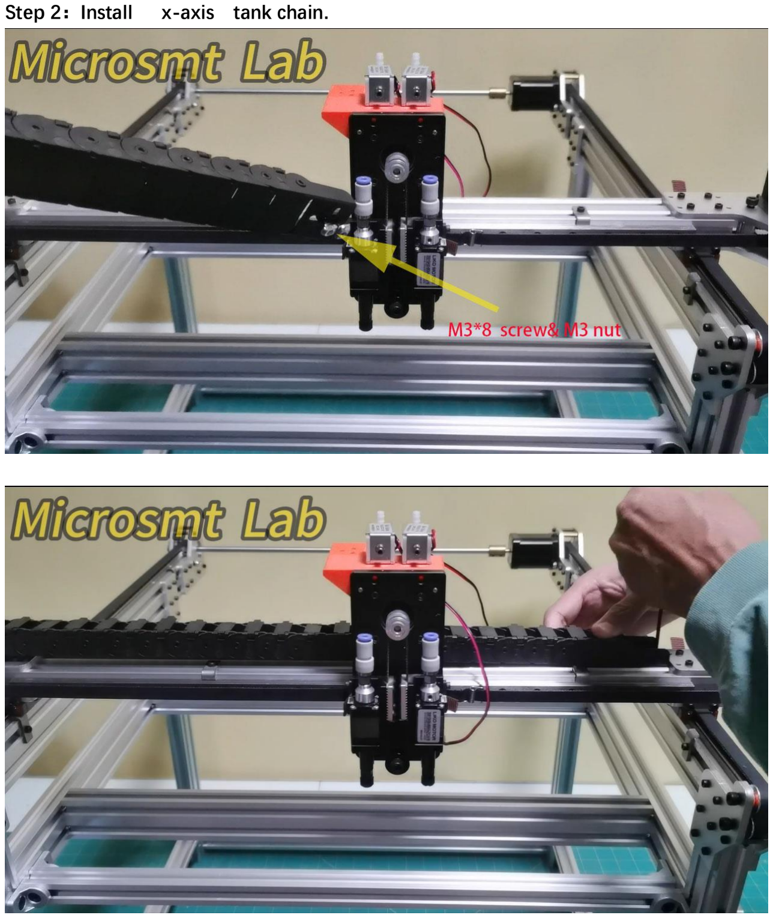
[picture p443: page 5]

Step 2：Install x-axis tank chain.

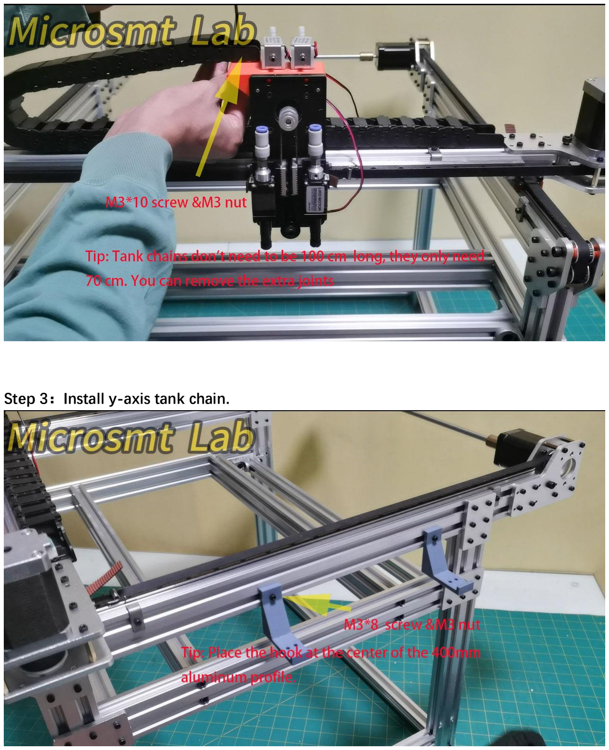
[picture p444: page 6]

Step 3：Install y-axis tank chain.

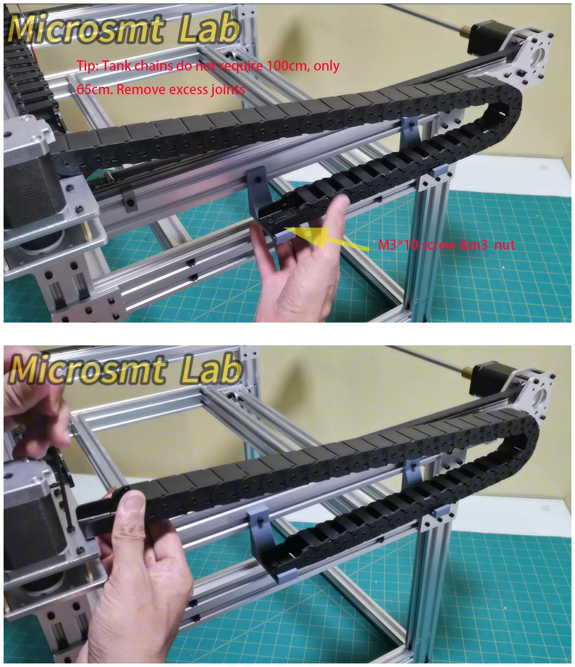
[picture p445: page 7]
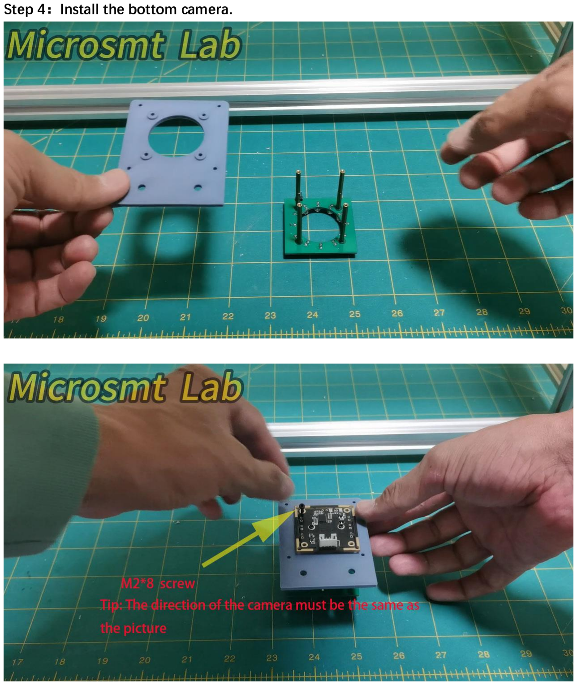
[picture p446: page 8]

Step 4：Install the bottom camera.

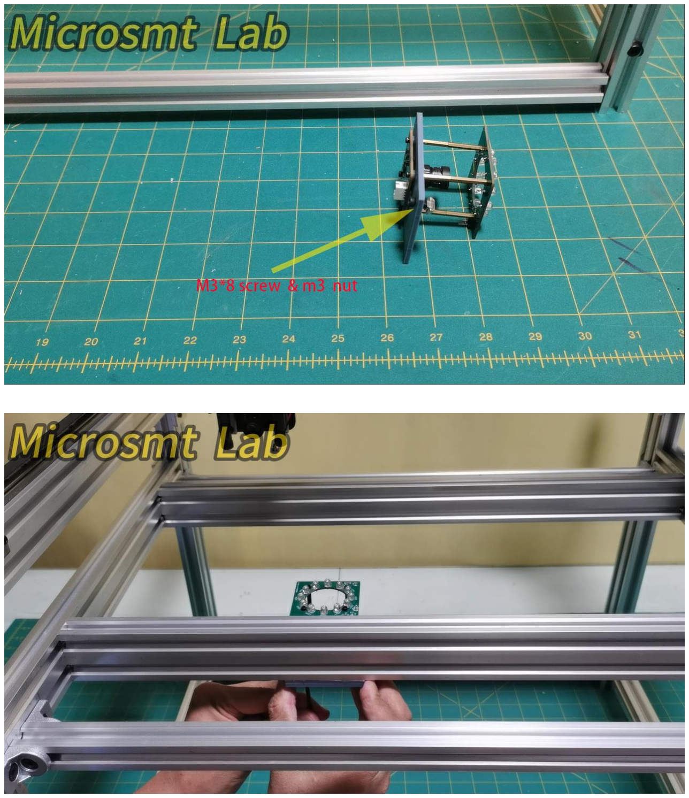
[picture p447: page 9]
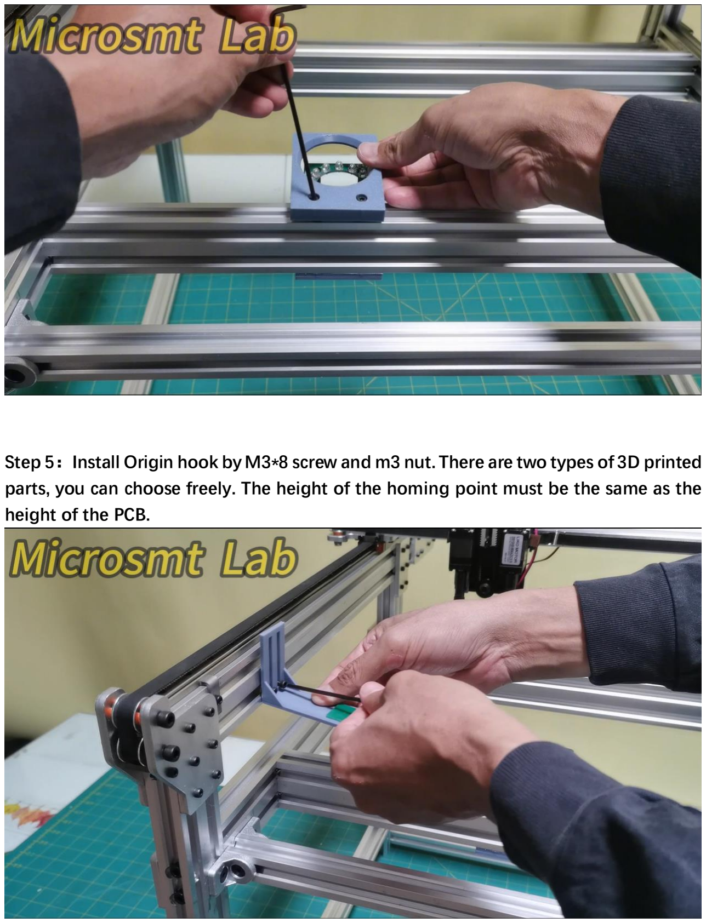
[picture p448: page 10]

Step 5：Install Origin hook by M3*8 screw and m3 nut. There are two types of 3D printed parts, you can choose freely. The height of the homing point must be the same as the height of the PCB.

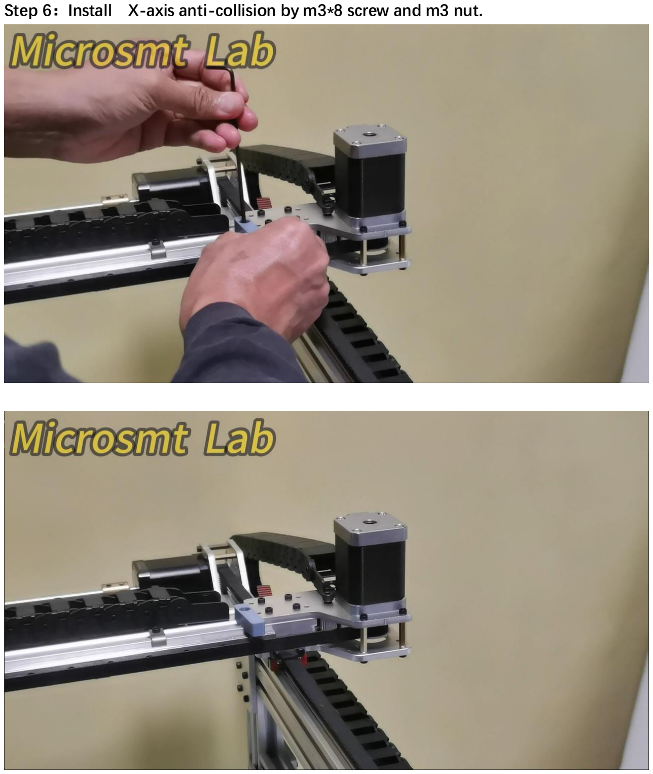
[picture p449: page 11]

Step 6：Install X-axis anti-collision by m3*8 screw and m3 nut.

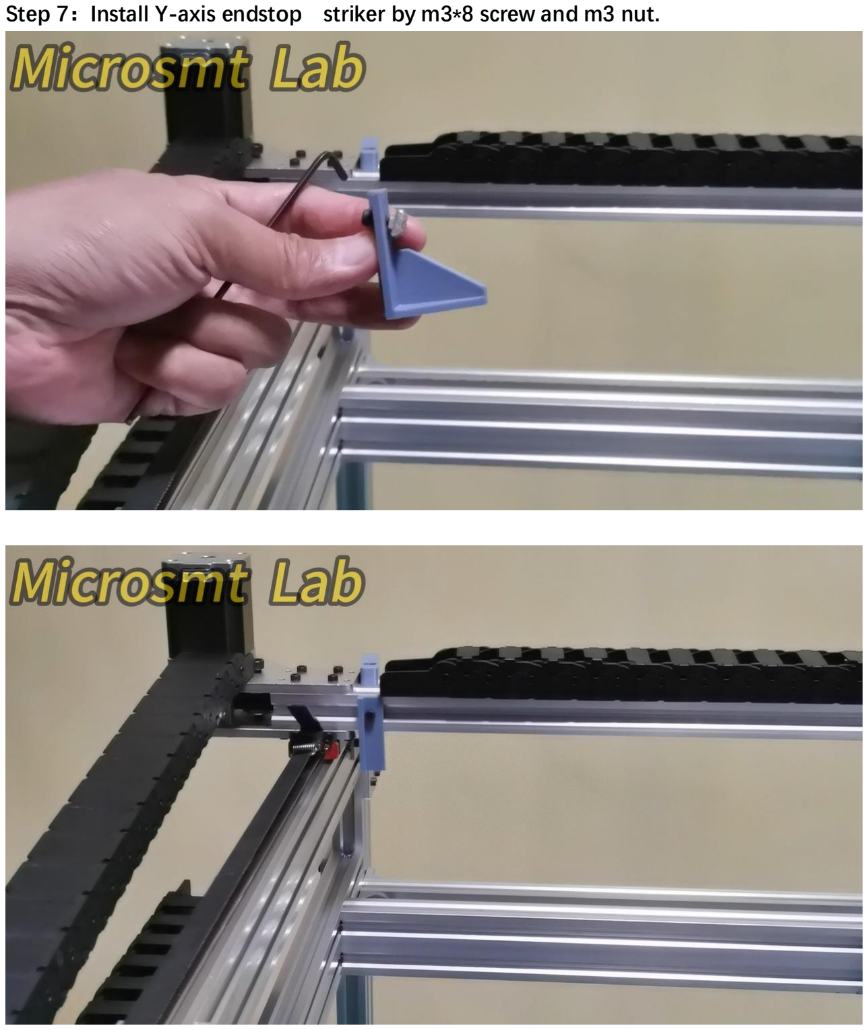
[picture p450: page 12]

Step 7：Install Y-axis endstop striker by m3*8 screw and m3 nut.

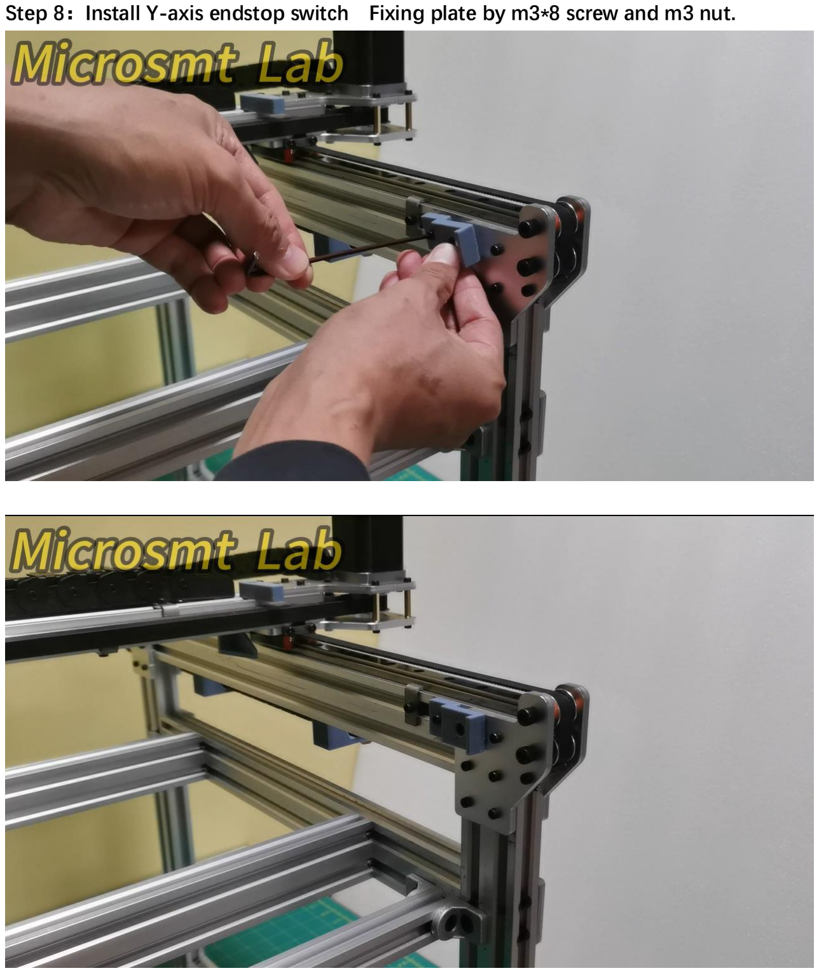
[picture p451: page 13]

Step 8：Install Y-axis endstop switch Fixing plate by m3*8 screw and m3 nut.

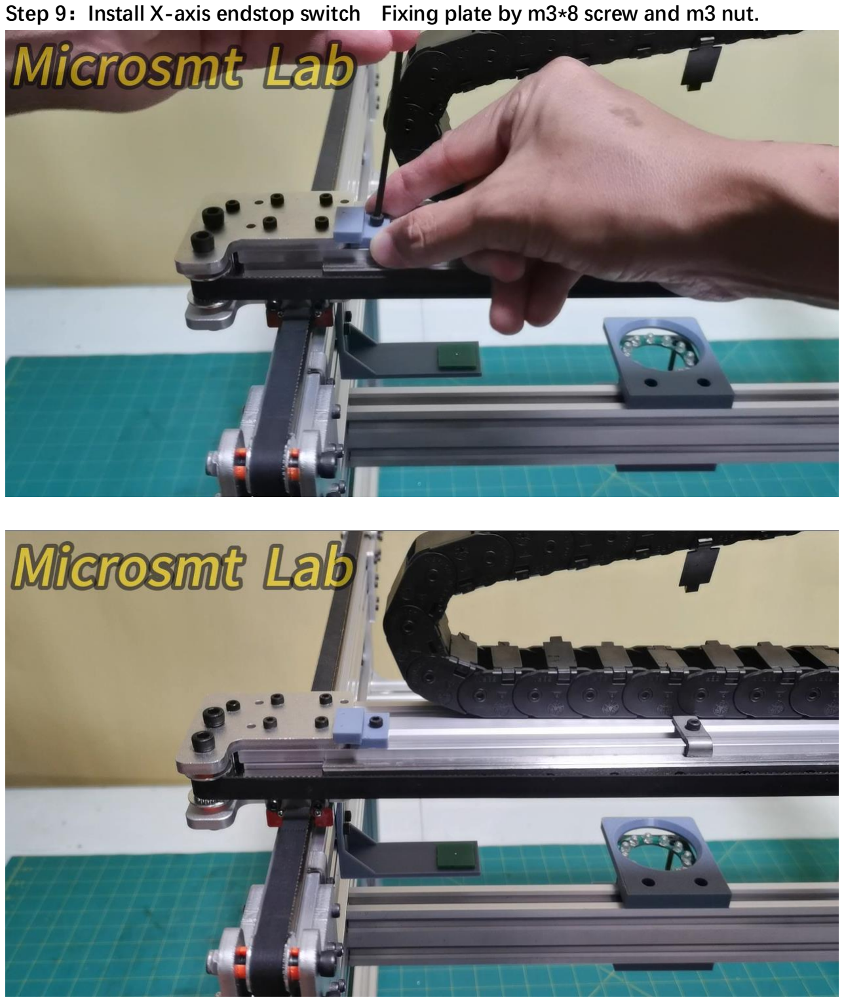
[picture p452: page 14]

Step 9：Install X-axis endstop switch Fixing plate by m3*8 screw and m3 nut.

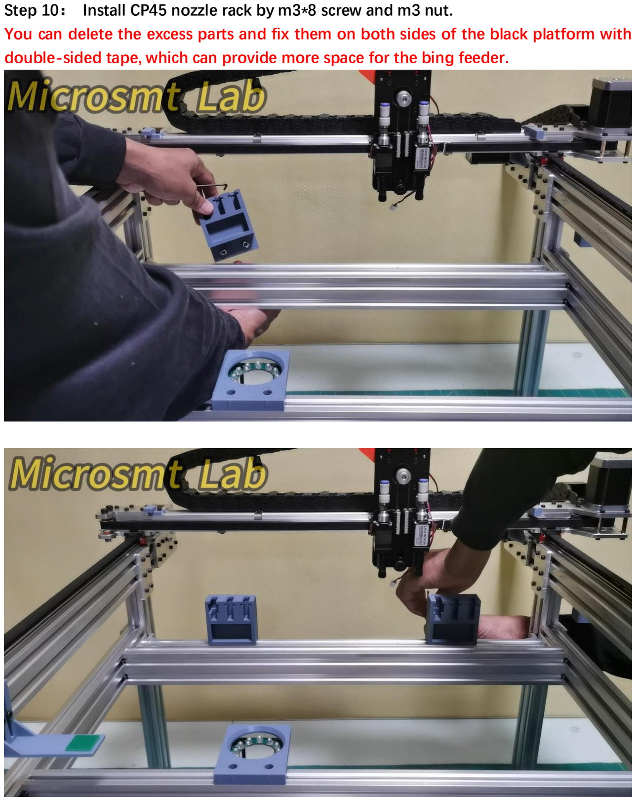
[picture p453: page 15]

Step 10： Install CP45 nozzle rack by m3*8 screw and m3 nut.
You can delete the excess parts and fix them on both sides of the black platform with double-sided tape, which can provide more space for the bing feeder.

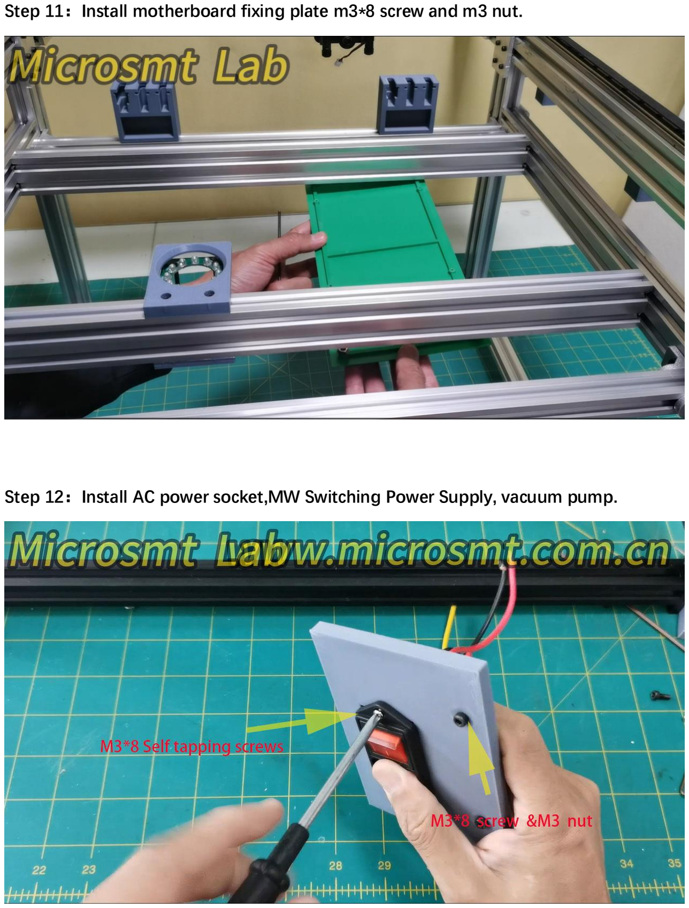
[picture p454: page 16]

Step 11：Install motherboard fixing plate m3*8 screw and m3 nut.
Step 12：Install AC power socket,MW Switching Power Supply, vacuum pump.

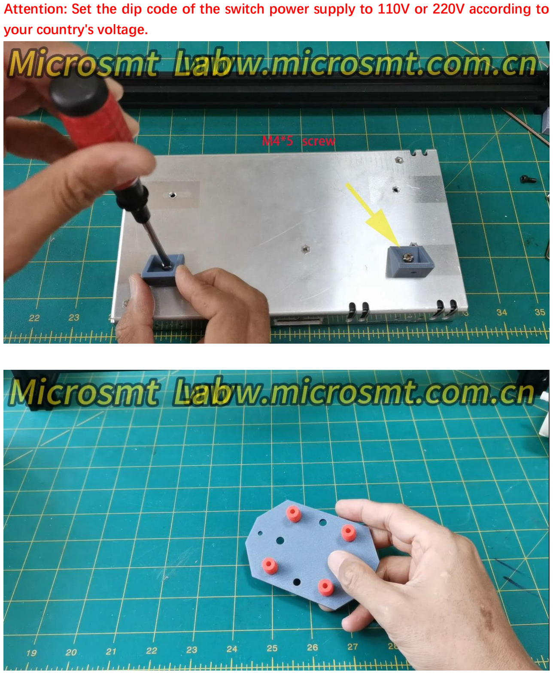
[picture p455: page 17]

Attention: Set the dip code of the switch power supply to 110V or 220V according to your country's voltage.

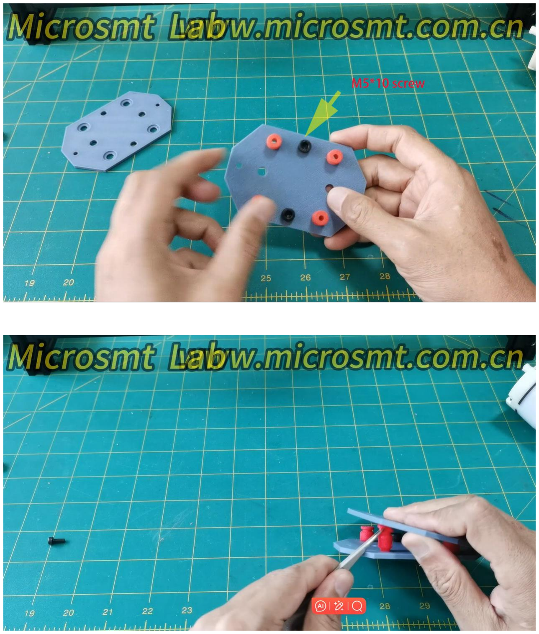
[picture p456: page 18]
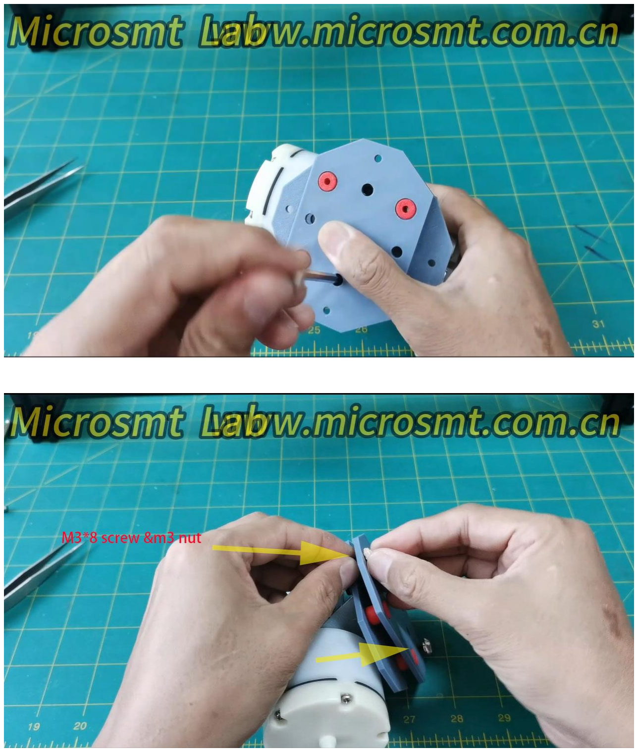
[picture p457: page 19]
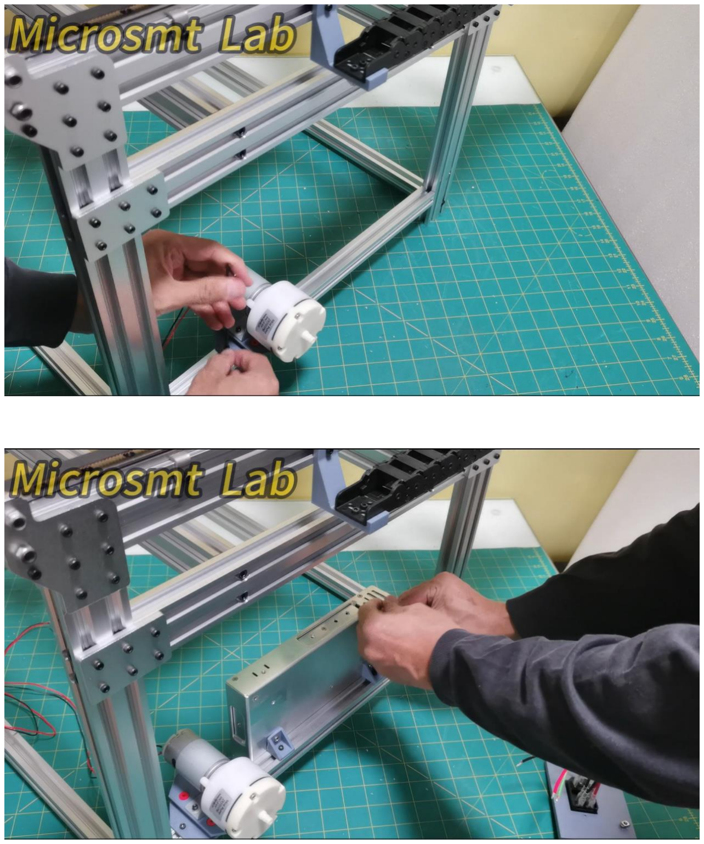
[picture p458: page 20]
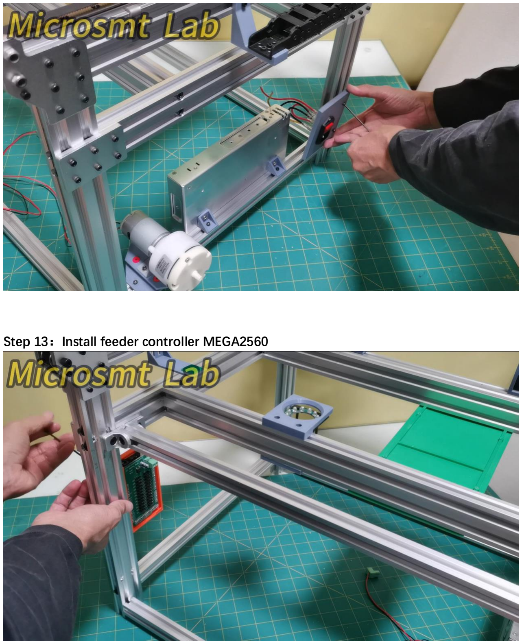
[picture p459: page 21]

Step 13：Install feeder controller MEGA2560

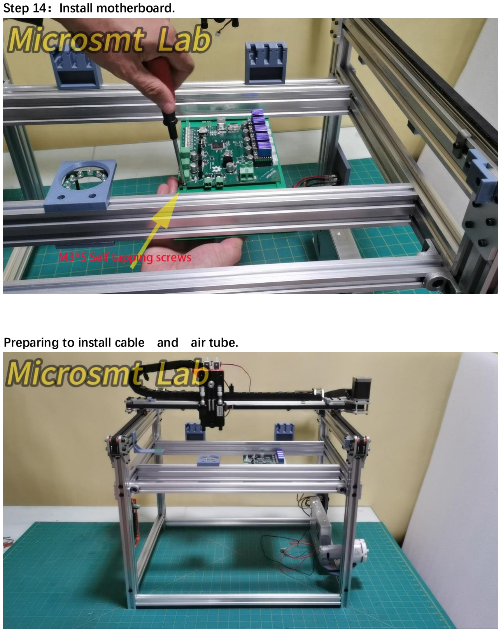
[picture p460: page 22]

Step 14：Install motherboard.

Preparing to install cable and air tube.

Step 15: Install cable and air tube for mounter head. Include:
Z motor cable 215cm * 1
N1 motor cable 215cm *1
N2 motor cable 215cm *1
Solenoid valve cable 215cm *2 Top LED cable 215cm*1
Top camera cable 200cm * 1
8mm air tube*1
Z-axis position sensor cable 215mm*1
X-axis position sensor cable 215mm*1
Tip1: Please refer to the video to place cable.
Tip2: At the same time, put the 125cm long X-axis motor cable inside Y-axis tank chain.

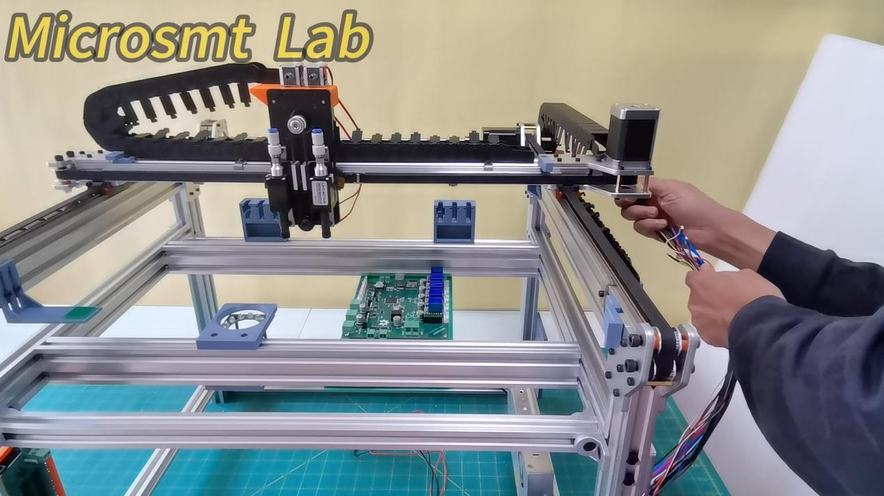
[picture p461: figure]
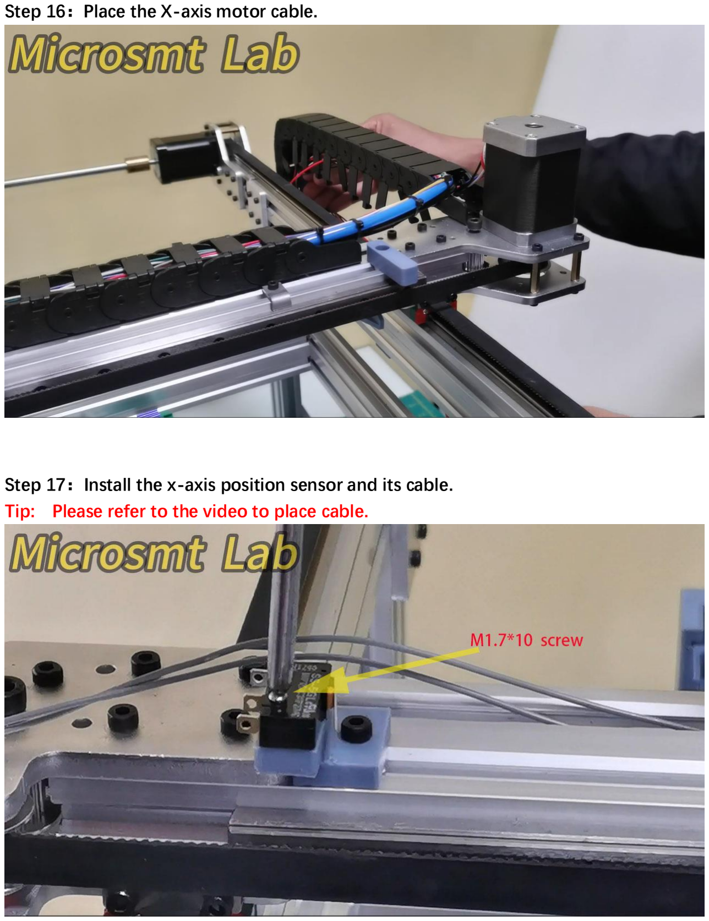
[picture p462: page 24]

Step 16：Place the X-axis motor cable.
Step 17：Install the x-axis position sensor and its cable. Tip: Please refer to the video to place cable.

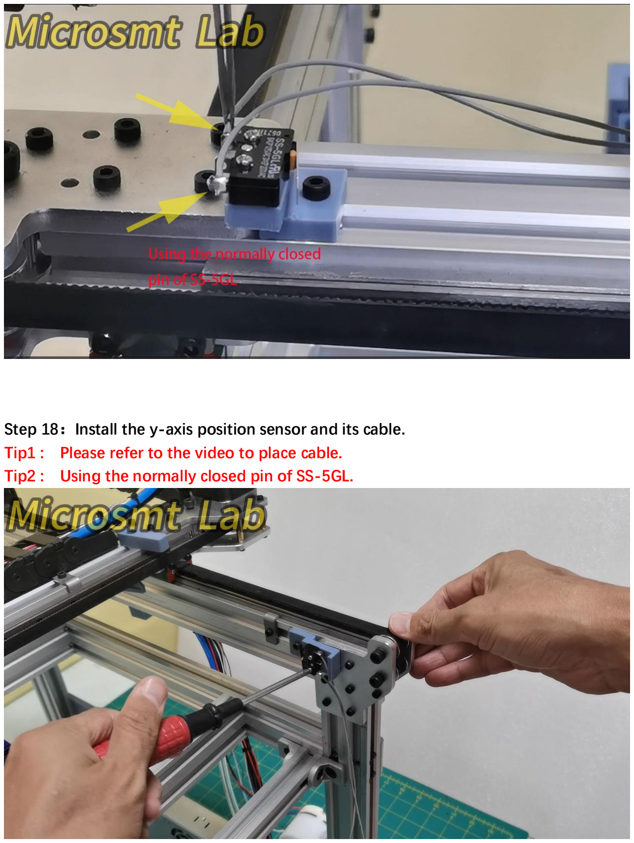
[picture p463: page 25]

Step 18：Install the y-axis position sensor and its cable. Tip1 : Please refer to the video to place cable.
Tip2 : Using the normally closed pin of SS-5GL.

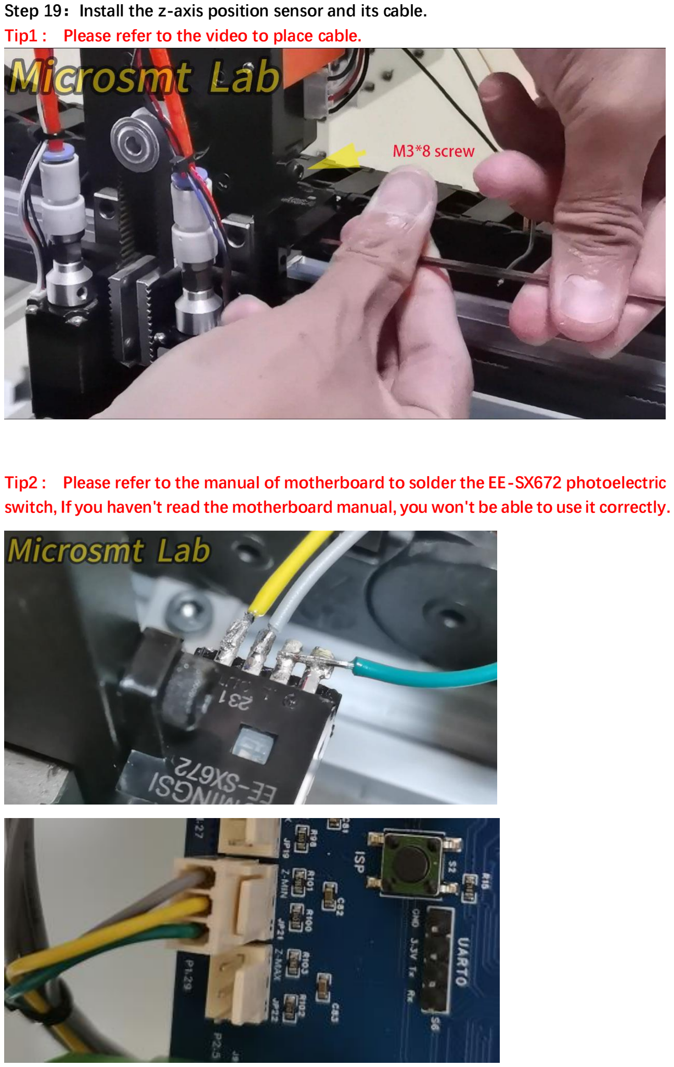
[picture p464: page 26]

Step 19：Install the z-axis position sensor and its cable. Tip1 : Please refer to the video to place cable.

Tip2 : Please refer to the manual of motherboard to solder the EE-SX672 photoelectric switch, If you haven't read the motherboard manual, you won't be able to use it correctly.

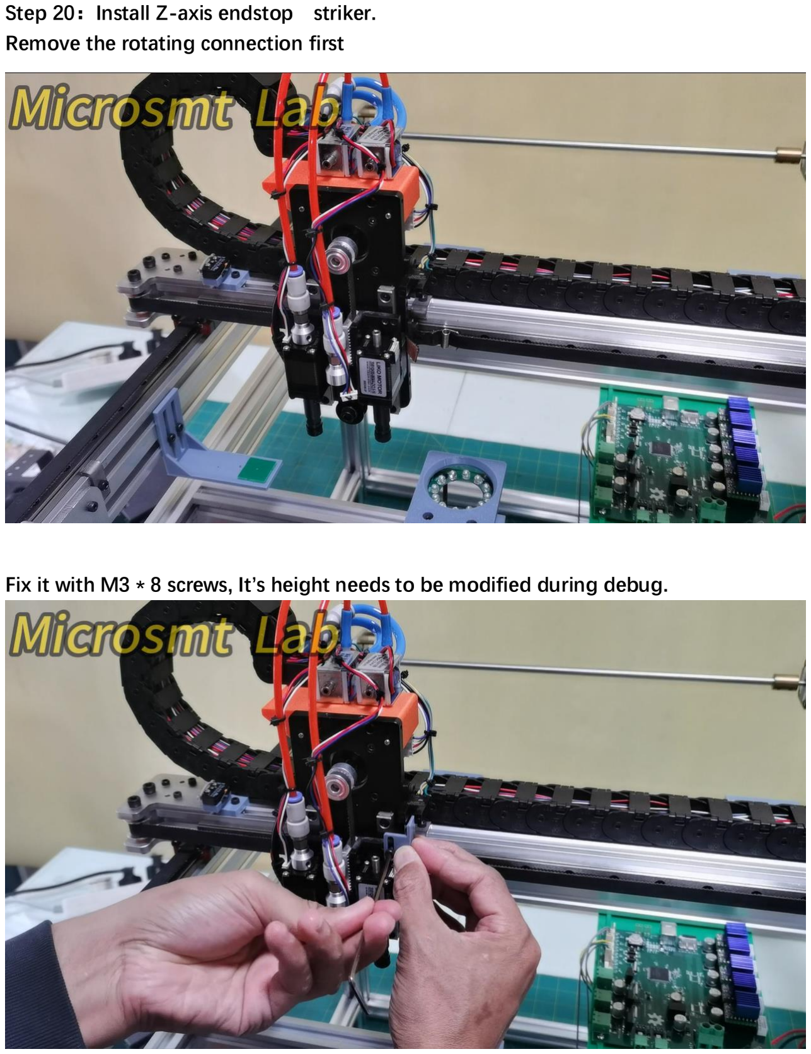
[picture p465: page 27]

Step 20：Install Z-axis endstop striker. Remove the rotating connection first

Fix it with M3 * 8 screws, It’s height needs to be modified during debug.

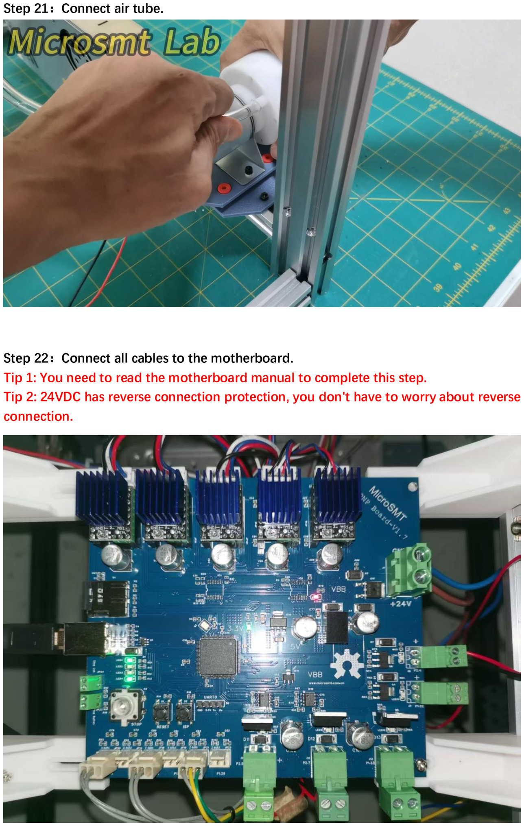
[picture p466: page 28]

Step 21：Connect air tube.
Step 22：Connect all cables to the motherboard.
Tip 1: You need to read the motherboard manual to complete this step.
Tip 2: 24VDC has reverse connection protection, you don't have to worry about reverse connection.

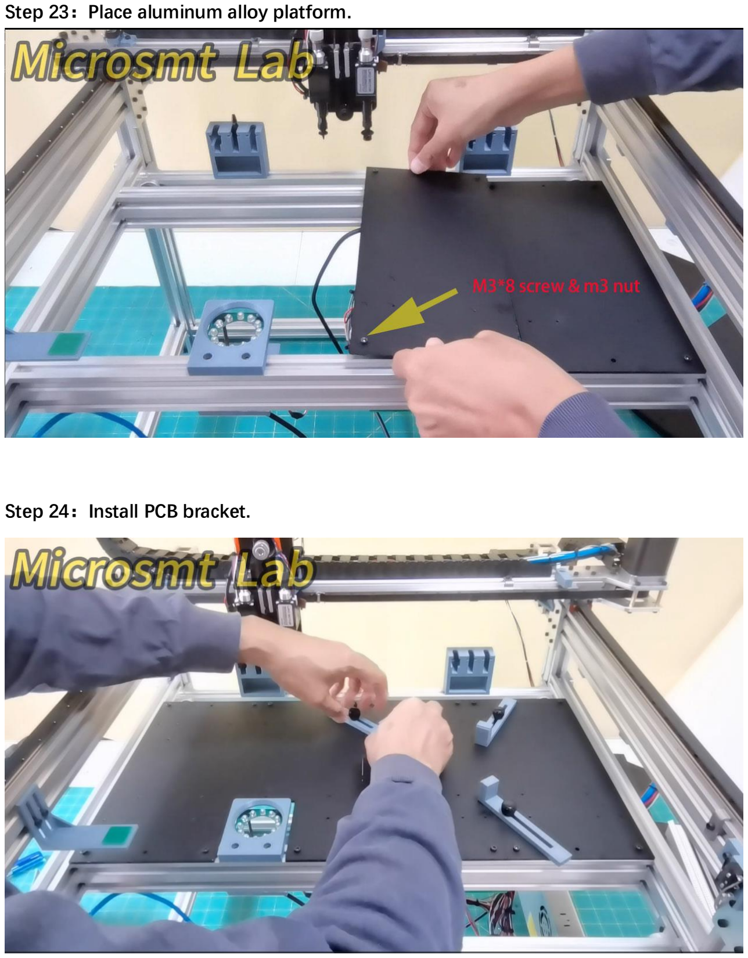
[picture p467: page 29]

Step 23：Place aluminum alloy platform.
Step 24：Install PCB bracket.

# Complete the assembly of the

# electrical . Please refer to the video to

learn how to debug PNP.
