gabrielyoung92/gabs_microSMT_PickAndPlace/Microsmt-PNPv3/PNP-V3_3D_parts_2026-02-04/PNPV3_stepper-motor-direction-guide.pdf

Step1: Open the congfig.txt file in the SD card.

Step2: Find | alpha_dir_pin
Step3: | add ! | or remove ! , then save config.txt.

for example：

alpha_dir_pin | 0.5 | # Pin for alpha stepper direction
alpha_dir_pin | 0.5! | # Pin for alpha stepper direction

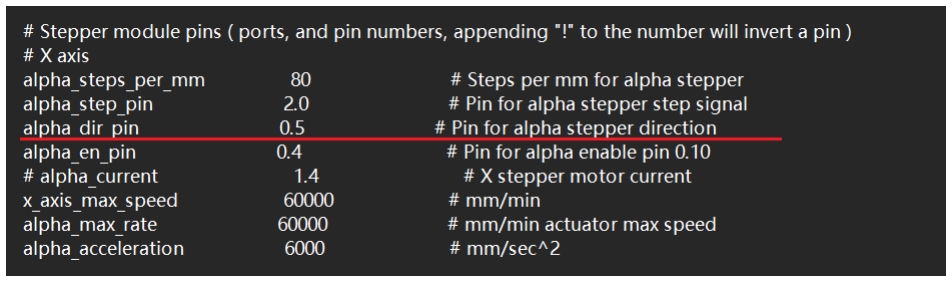
[picture p478: figure]

Step4: Press the reset button on the control board. When the

reset is completed, the direction of the stepper motor will

change.
