gabrielyoung92/gabs_microSMT_PickAndPlace/Bing-feeder/V3-feeder/PRINT_projects/README.md

# V3 print projects

> Designs and original files by [MicroSMT](https://github.com/microsmt/Bing-feeder). [Credits and local changes](../../../CREDITS.md).

These are MicroSMT’s slicer projects. For individual STEP/STL models, go to the [V3 feeder folders](../README.md).

| Browse | Contents |
| --- | --- |
| [V3_gear-16t-bracket.3mf](V3_gear-16t-bracket.3mf) | Existing supplied bracket project |
| [V3_12mm_switch-trigger-cover.3mf](V3_12mm_switch-trigger-cover.3mf) | 12 mm switch-trigger cover, added 21 October 2026 |

If you need the updated shape rather than the original print setup, use the current STEP/STL files in the galleries.
