gabrielyoung92/gabs_microSMT_PickAndPlace/Bing-feeder/V3-feeder/docs/V3_8mm_assembly_manual.pdf

## Bing feeder-V3（Magnetic） assembly manual

8-2mm&8-4mm

2025-12-08

## 一．Assembly the feeder

1:The difference between 8-2mm and 8-4mm:

--Sprocket hole distance.

2：Get the kits ：www.microsmt.com.cn

3：Watch the installation video: https://youtu.be/MxgC0LLmq8A

4 : If the direction of the motor is incorrect, just swap its two wires.

6: Connect the three wires of the photoelectric switch according to the pin identification of the control board and photoelectric switch, which are + - out .

7: The L pin on the photoelectric switch does not need to be connected.

8: 8-2mm/4mm PCB button for manual feeding.

9: 12mm/16mm/24mm | 3-in- 1 PCB | button | is Used to switch the number of steps forward, with a
minimum of 1 step forward and a maximum of 6 steps forward. The number of steps will be stored in flash, and the set number of steps will not change when the PCB is powered off.

Watch the installation video: https://youtu.be/vMMxd3sDfT4.

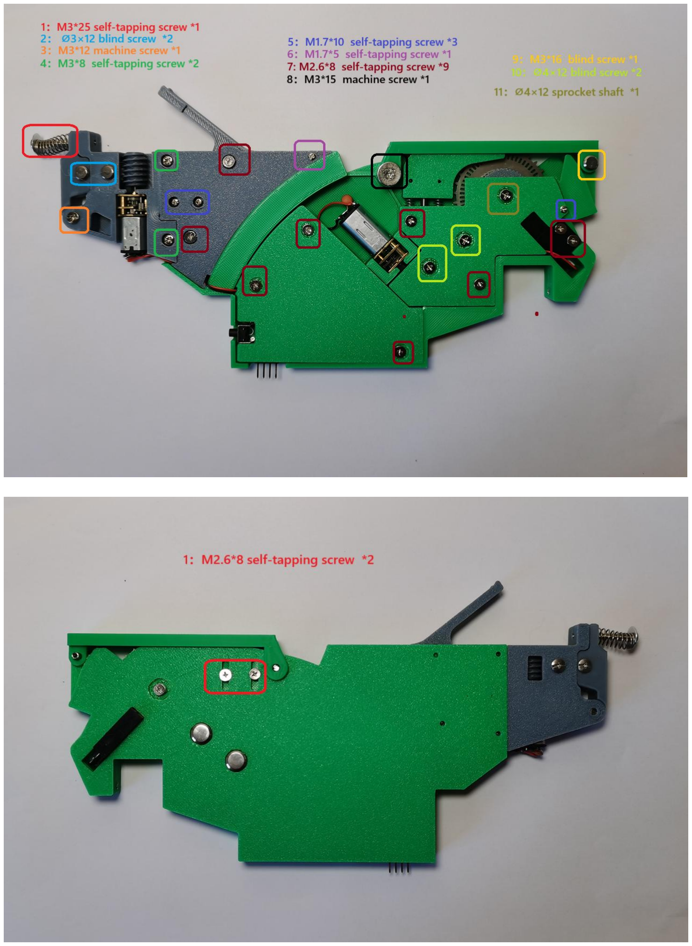
[picture p479: page 2]
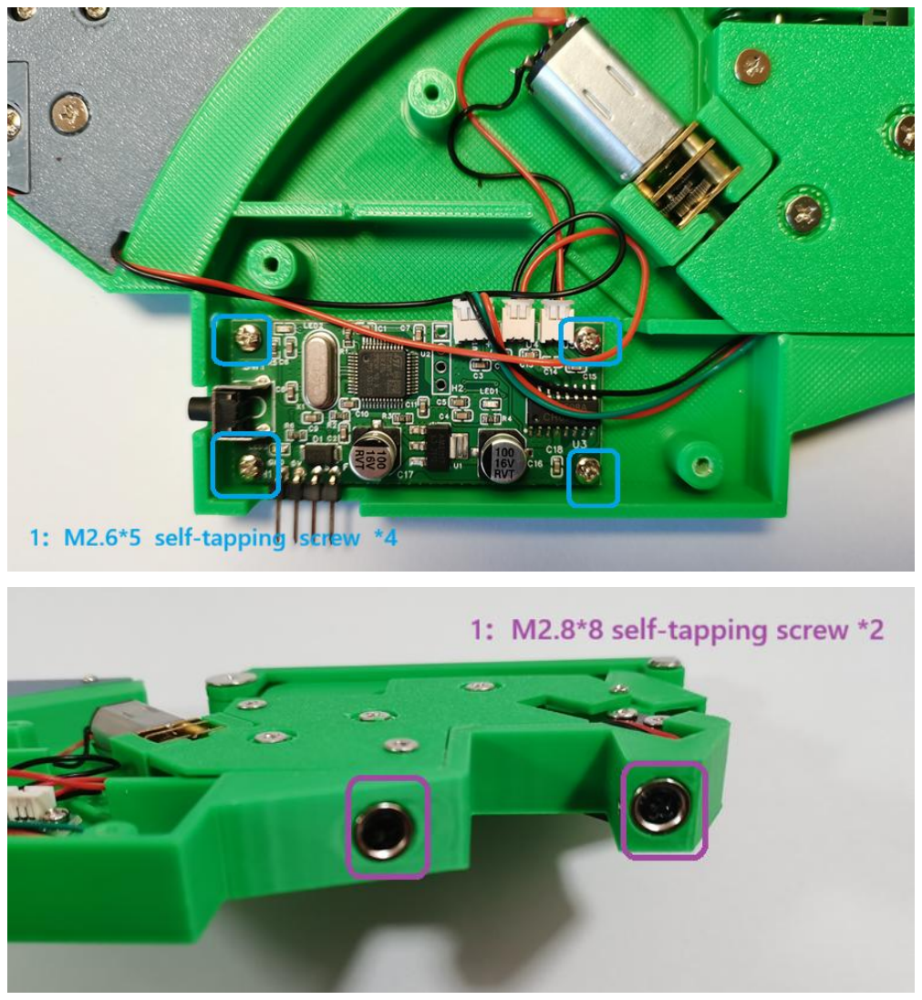
[picture p480: page 3]
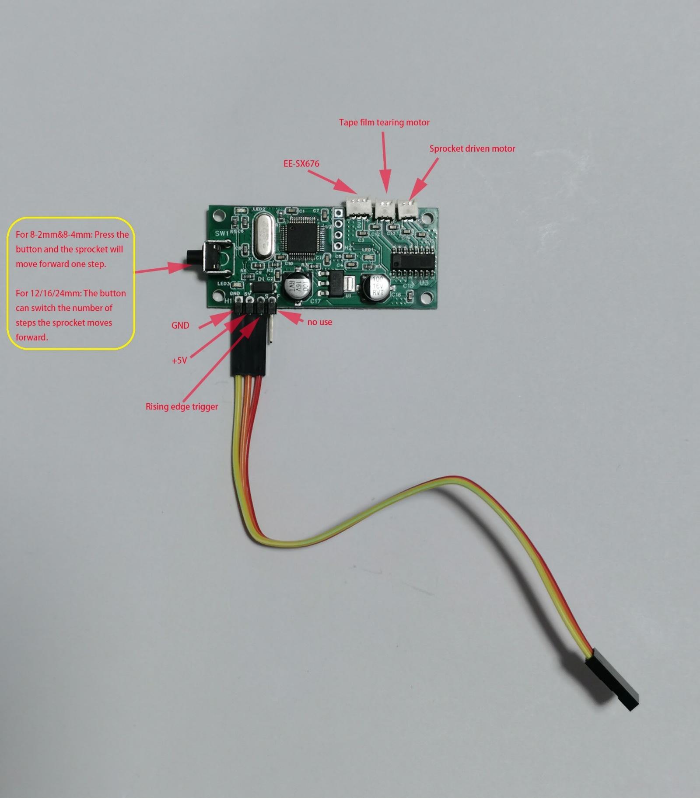
[picture p481: page 4]

## 二．Install the feeder controller

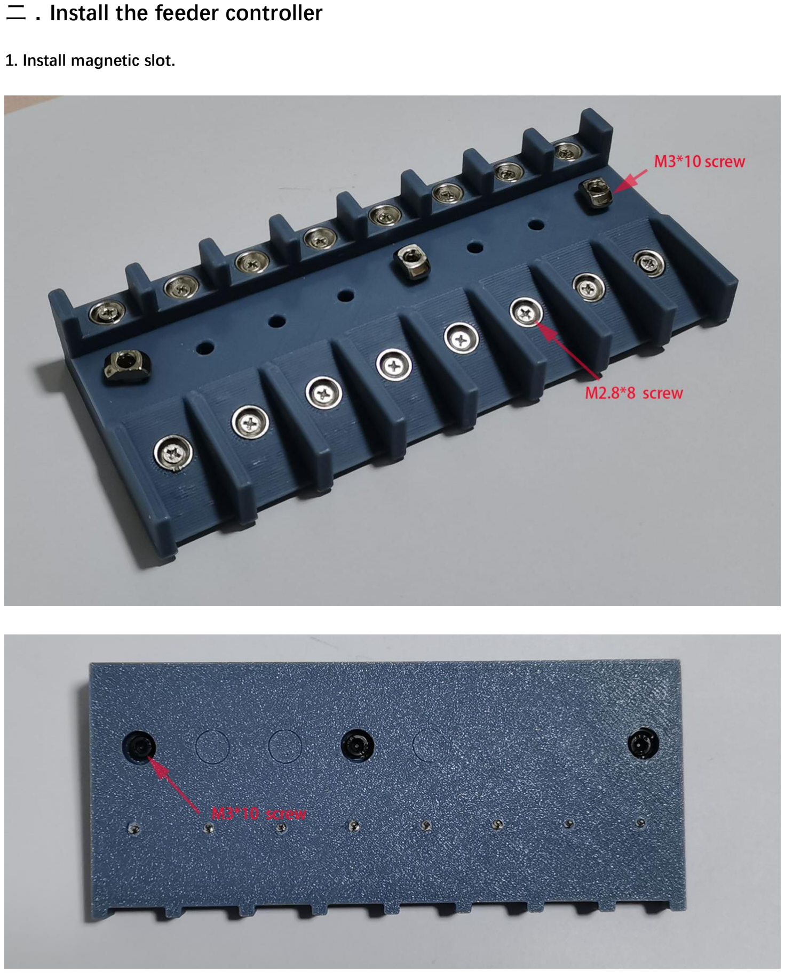
[picture p482: page 5]

1. Install magnetic slot.

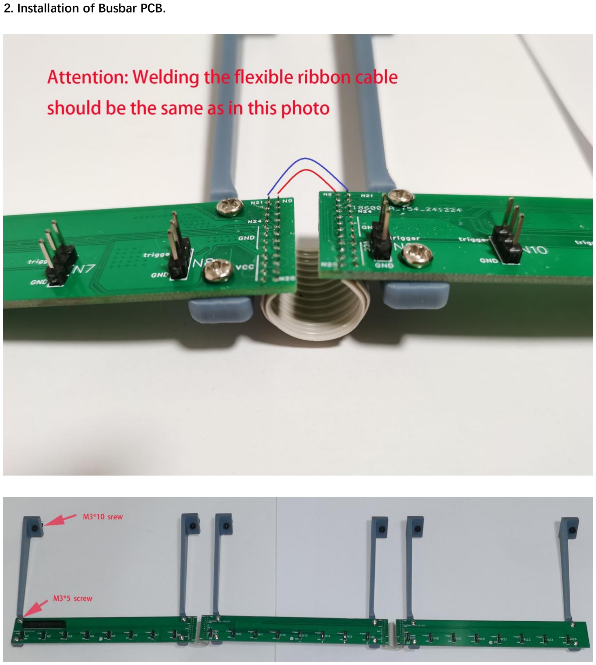
[picture p483: page 6]

2. Installation of Busbar PCB.

3. Connect the feeder controller and Busbar PCB.

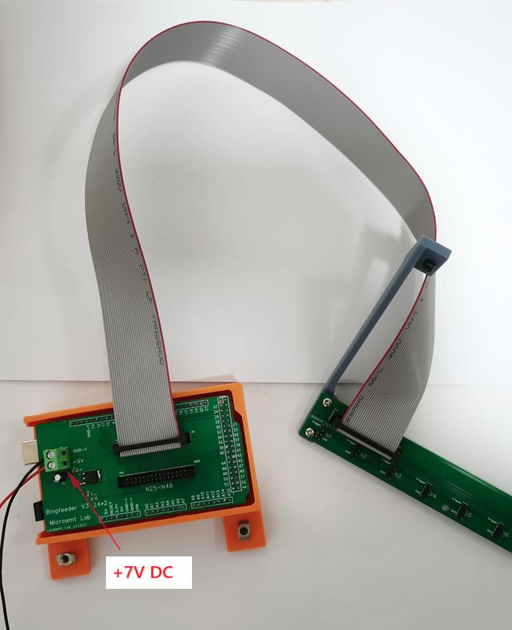
[picture p484: figure]
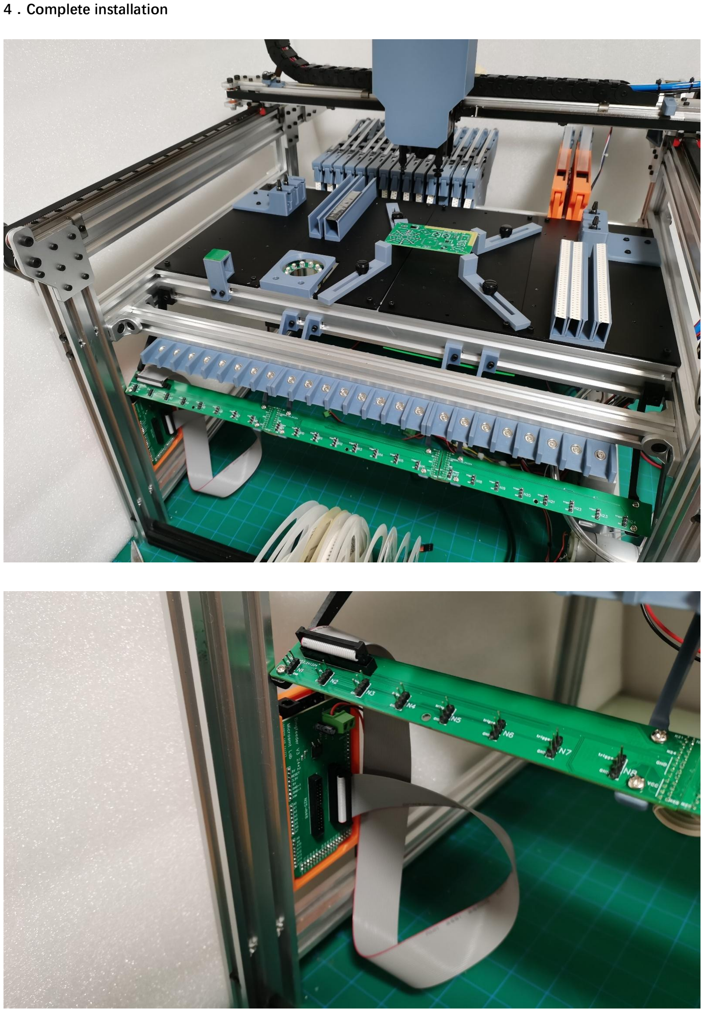
[picture p485: page 8]

4．Complete installation
