gabrielyoung92/gabs_microSMT_PickAndPlace/Bing-feeder/V3-feeder/docs/V3_8mm_assembly_manual_0914.pdf

## Bing feeder-V3（Magnetic） assembly manual

8-2mm&8-4mm

2026-09-14

## 一．Assembly the feeder

1：Get the kits ：www.microsmt.com.cn

2：Watch the installation video: https://youtu.be/MxgC0LLmq8A

3 : If the direction of the motor is incorrect, just swap its two wires.

4: Connect the three wires of the photoelectric switch according to the pin identification of the control board and photoelectric switch, which are + - out .

5: The L pin on the photoelectric switch does not need to be connected.

6: Latest 8mm feeder firmware update: If the button is pressed for less than 1 second, the sprocket advances by one step. If the button is pressed for more than 3 seconds, the LED flashes, and the sprocket step distance toggles between 2 mm and 4 mm.

7: 12mm/16mm/24mm | 3-in- 1 PCB | button | is Used to switch the number of steps forward, with a
minimum of 1 step forward and a maximum of 6 steps forward. The number of steps will be stored in flash, and the set number of steps will not change when the PCB is powered off.

Watch the installation video: https://youtu.be/vMMxd3sDfT4.

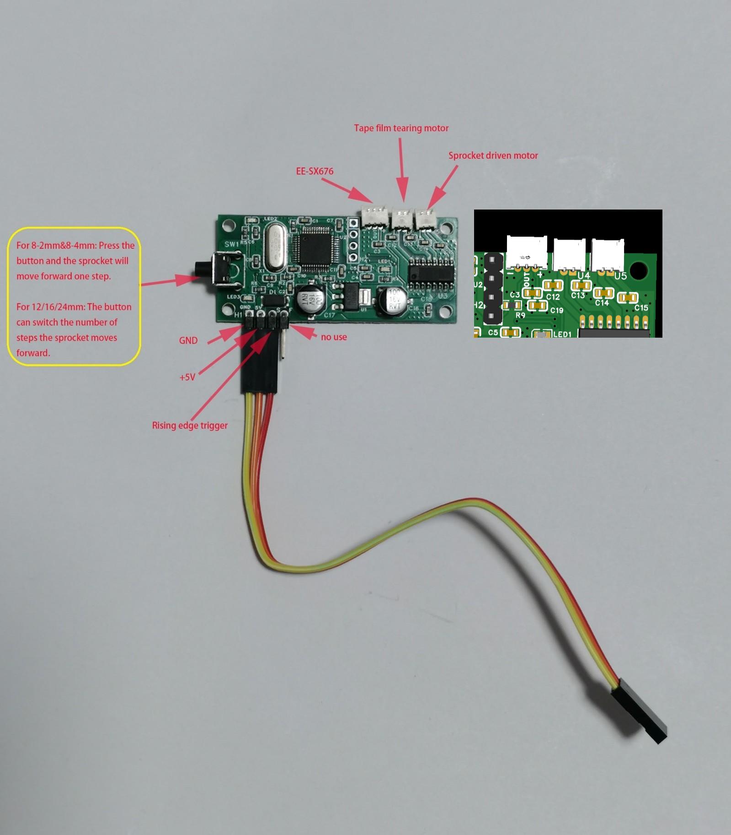
[picture p486: page 4]

## 二．Install the feeder controller

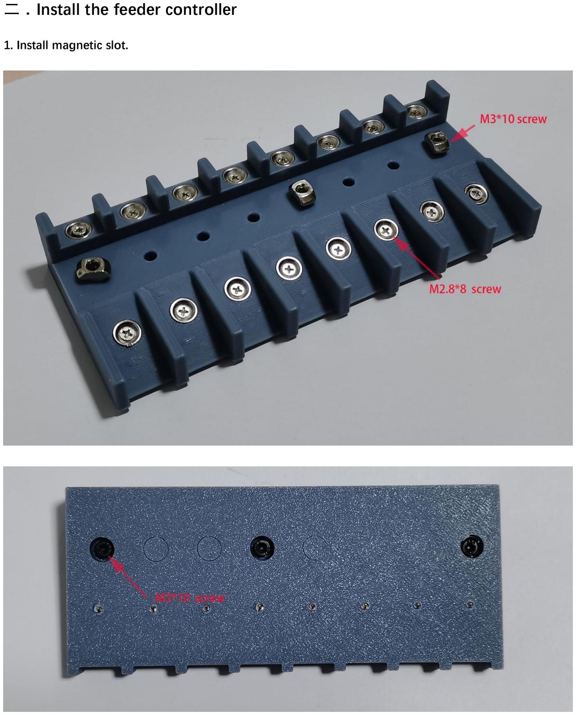
[picture p487: page 5]

1. Install magnetic slot.

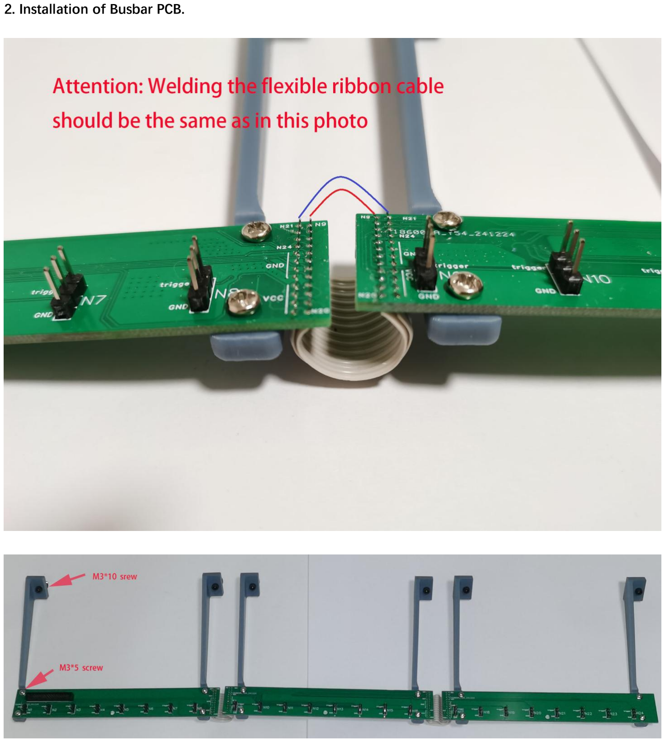
[picture p488: page 6]

2. Installation of Busbar PCB.

3. Connect the feeder controller and Busbar PCB.


4．Complete installation

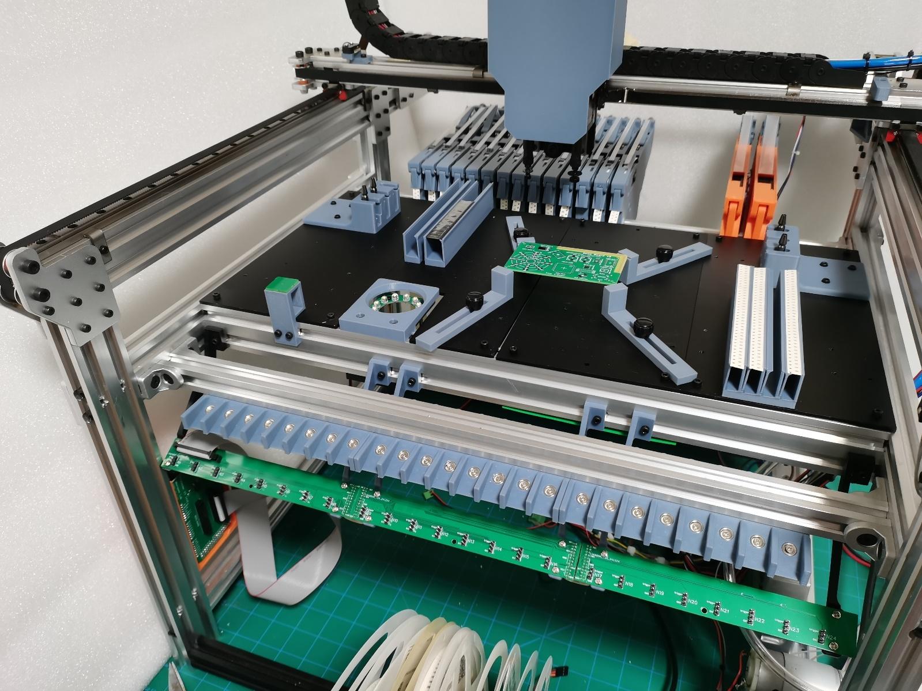
[picture p489: figure]

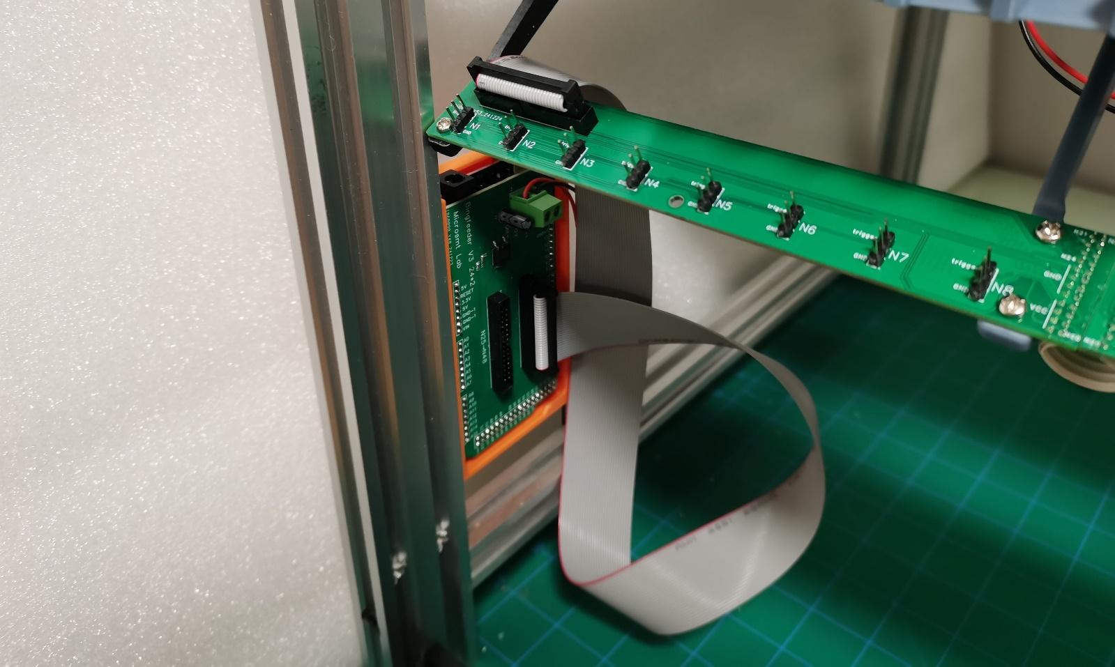
[picture p490: figure]
