gabrielyoung92/gabs_microSMT_PickAndPlace/Microsmt-PNPv3/docs/evidence/controller-2026-10-14/n1-15degree-test.txt

TX: get status
RX:
Smoothie
ok
<Idle|MPos:0.0000,0.0000,0.0000,0.0000,0.0000|WPos:0.0000,0.0000,0.0000|F:120.0,100.0>

TX: G21
RX:
ok

TX: G91
RX:
ok

TX: M204 A50
RX:
ok

TX: G1 A15 F600
RX:
ok

TX: M400
RX:
ok

TX: G1 A-15 F600
RX:
ok

TX: M400
RX:
ok

TX: G90
RX:
ok

TX: M204 A10000
RX:
ok

TX: M114
RX:
ok C: X:0.0000 Y:0.0000 Z:0.0000 A:0.0000 B:0.0000

TX: get status
RX:
<Idle|MPos:0.0000,0.0000,0.0000,0.0000,0.0000|WPos:0.0000,0.0000,0.0000|F:600.0,100.0>
