gabrielyoung92/gabs_microSMT_PickAndPlace/Microsmt-PNPv3/docs/evidence/controller-2026-10-14/x-calibration-return-zero.txt

TX: get status
RX:
Smoothie
ok
<Idle|MPos:300.0000,0.0000,0.0000,0.0000,0.0000|WPos:300.0000,0.0000,0.0000|F:1500.0,100.0>

TX: G21
RX:
ok

TX: G90
RX:
ok

TX: M204 X100
RX:
ok

TX: G1 X0 F1500
RX:
ok

TX: M400
RX: ok
TX: M204 X6000
RX:
ok

TX: M114
RX:
ok C: X:0.0000 Y:0.0000 Z:0.0000 A:0.0000 B:0.0000

TX: M119
RX:
X_min:1 Y_min:1 Z_min:1 pins- (X)P1.24:1 (Y)P1.26:1 (Z)P1.28:1 
ok

TX: get status
RX:
<Idle|MPos:0.0000,0.0000,0.0000,0.0000,0.0000|WPos:0.0000,0.0000,0.0000|F:1500.0,100.0>
