gabrielyoung92/gabs_microSMT_PickAndPlace/Bing-feeder/V485-Feeder Controller/PCB_ControlBoard/docs/SCH_Schematic1_2026-10-09.pdf

### GND

### GND

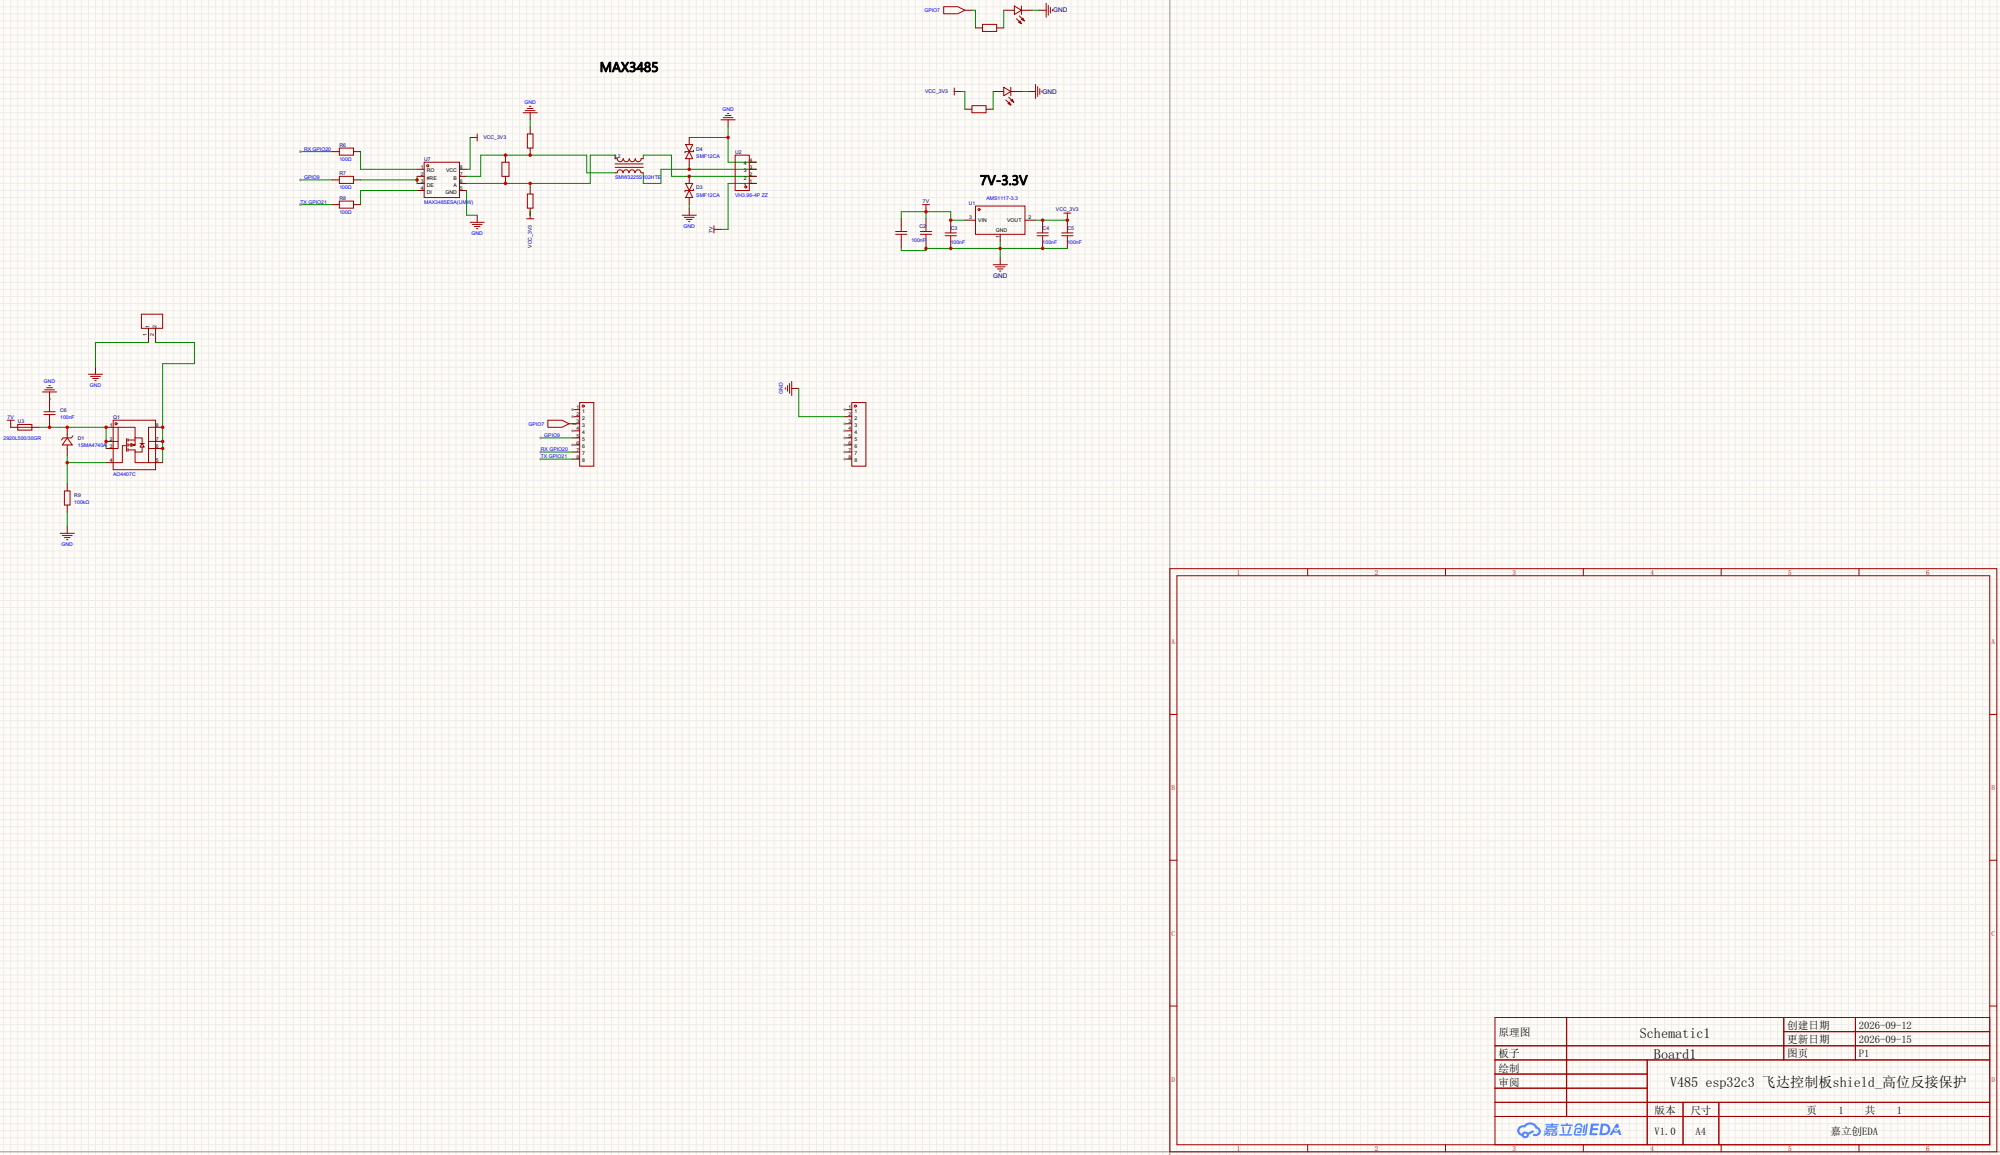
[picture p491: page 1]
