gabrielyoung92/gabs_microSMT_PickAndPlace/Bing-feeder/V485-feeder/PCB_display/docs/SCH_Schematic1_2026-10-09.pdf

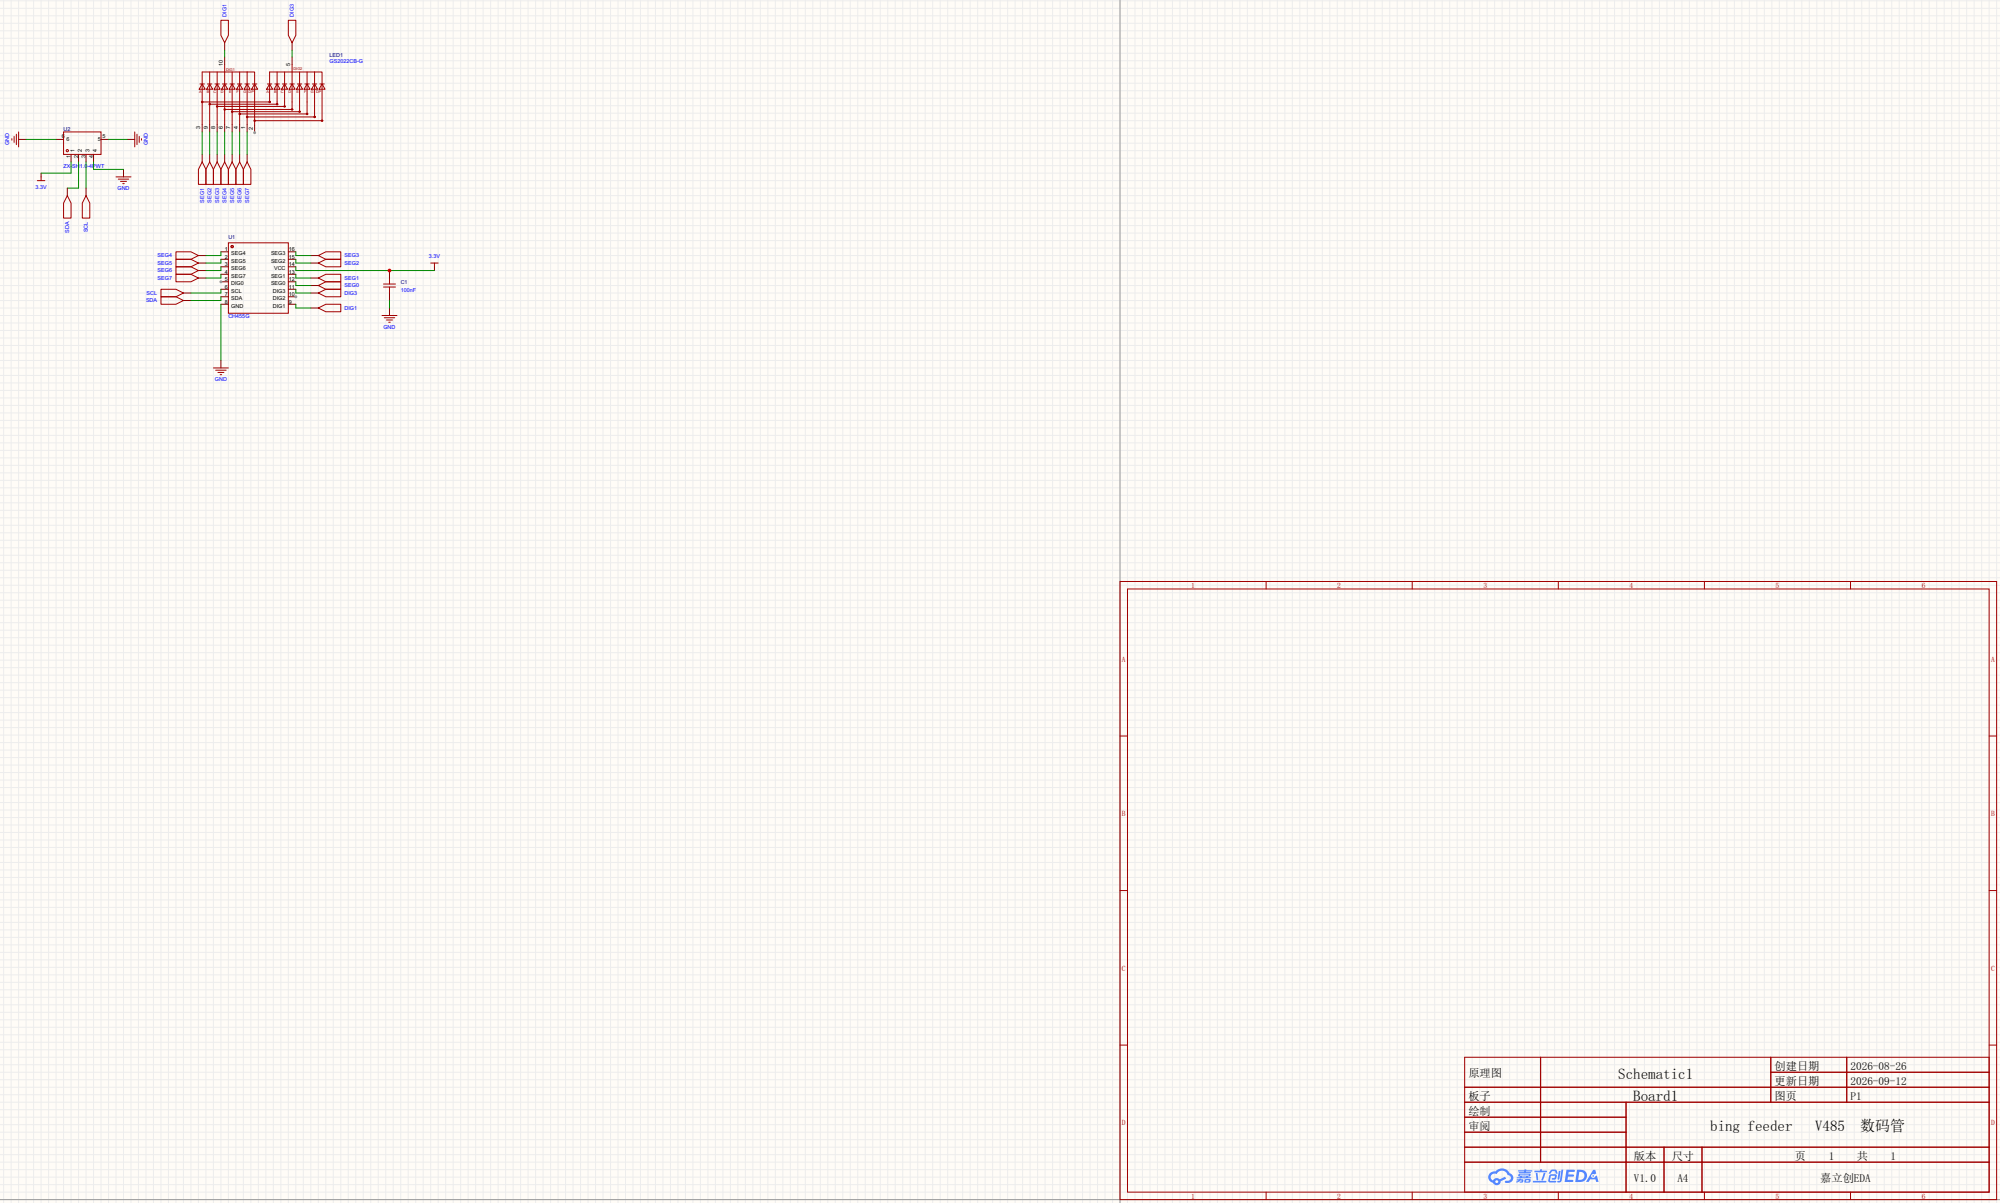
[picture p492: page 1]

LED1 GS2022CB-G

DIG1 | DIG2

U2

SEG4 | SEG4 1 | | | SEG3 | | | 3.3V
SEG5 | SEG5 2 | | | SEG2

SEG6 | SEG6 3 | DIG2 | 10 DIG3 11 SEG0 12 SEG1 13 VCC 14 SEG2 15 SEG3 16

SEG7 | SEG7 4 | | | SEG1

DIG0 5 | | | SEG0 | | C1

SCL | | SCL 6 | | | DIG3 | | 100nF
SDA | | SDA 7

GND 8 | DIG1 | 9 | DIG1

GND

创建日期 | | 2026-08-26
更新日期 | | 2026-09-12

板子 | Board1 | | | 图页 | | P1
绘制

D | 审阅 | | bing | feeder | | V485 | | 数码管 | D
