gabrielyoung92/gabs_microSMT_PickAndPlace/Bing-feeder/V485-feeder/PCB_feeder/docs/SCH_schematic1_2026-10-09.pdf

# STM32C8T6

# MAX3485

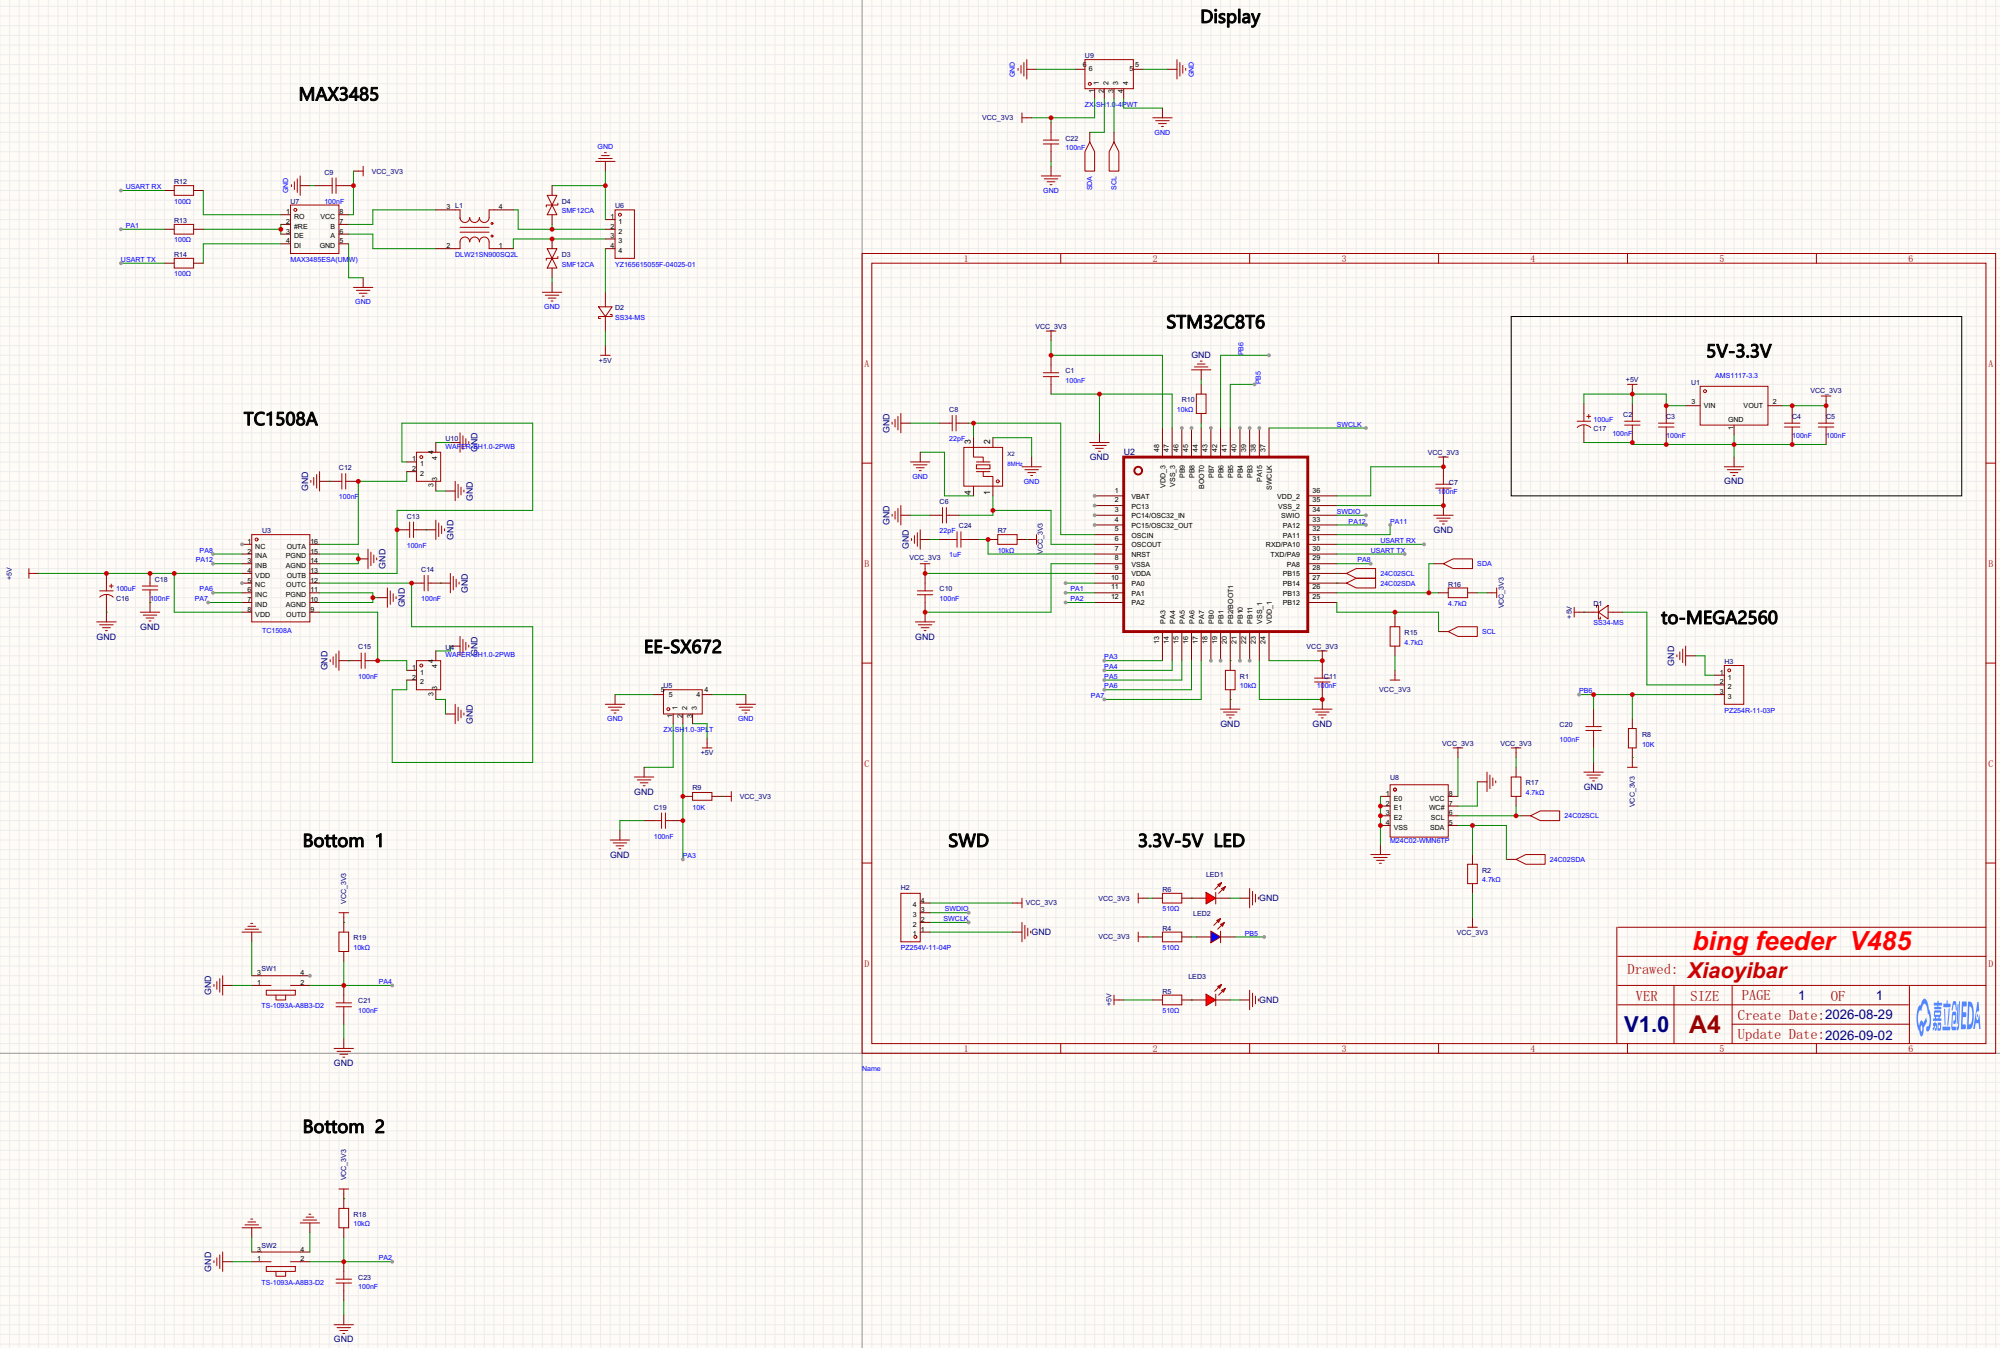
[picture p493: page 1]

2 | SWCLK
