gabrielyoung92/gabs_microSMT_PickAndPlace/Microsmt-PNPv3/Work_bed_plates/PNPv3-work-bed-plates.pdf

# Standard work-bed plate - 3 per machine

### M3 tapped holes (12)

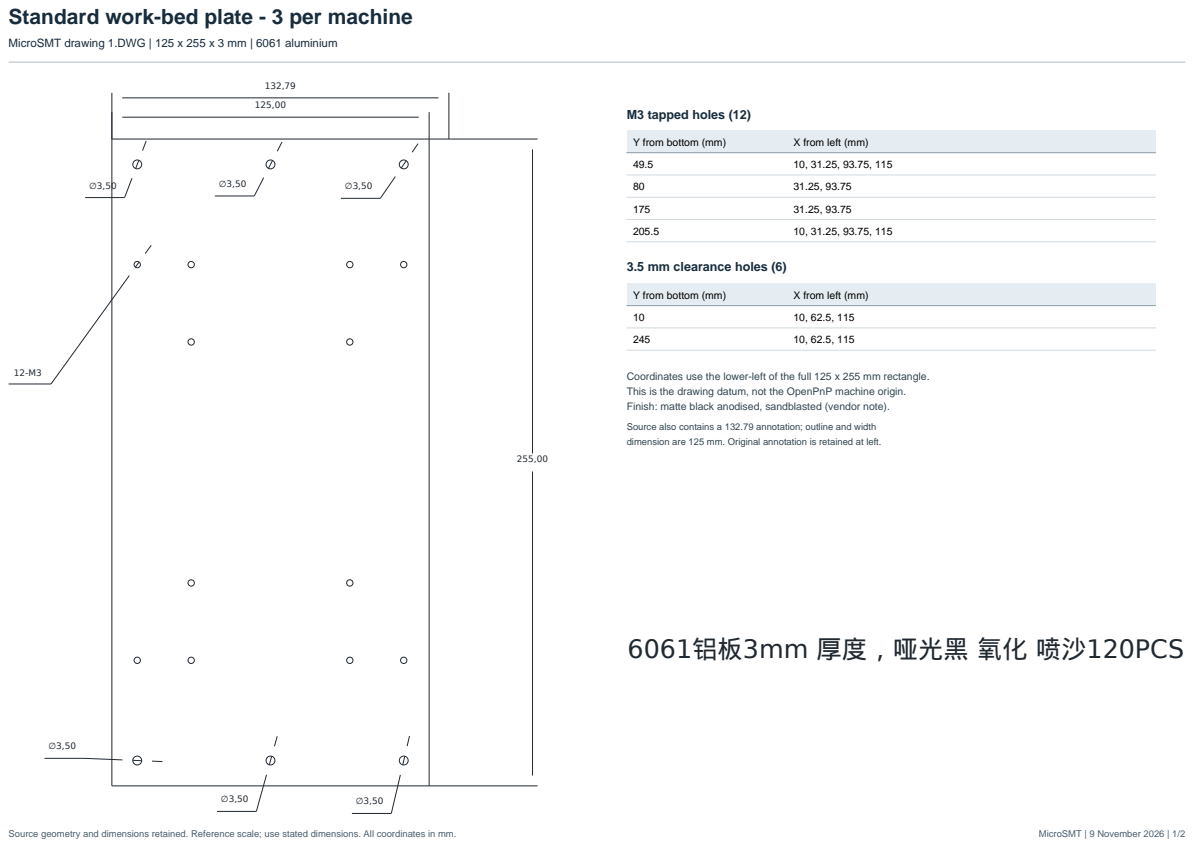
[picture p494: page 1]
Y from bottom (mm); X from left (mm); Source geometry and dimensions retained. Reference scale; use stated dimensions. All coordinates in mm.; MicroSMT | 9 November 2026 | 1/2

MicroSMT drawing 1.DWG | 125 x 255 x 3 mm | 6061 aluminium

3.5 mm clearance holes (6)

Coordinates use the lower-left of the full 125 x 255 mm rectangle.
This is the drawing datum, not the OpenPnP machine origin.
Finish: matte black anodised, sandblasted (vendor note).

Source also contains a 132.79 annotation; outline and width
dimension are 125 mm. Original annotation is retained at left.

6061铝板3mm 厚度，哑光黑 氧化 喷沙120PCS

# Camera work-bed plate - 1 per machine

### M3 tapped holes (10)

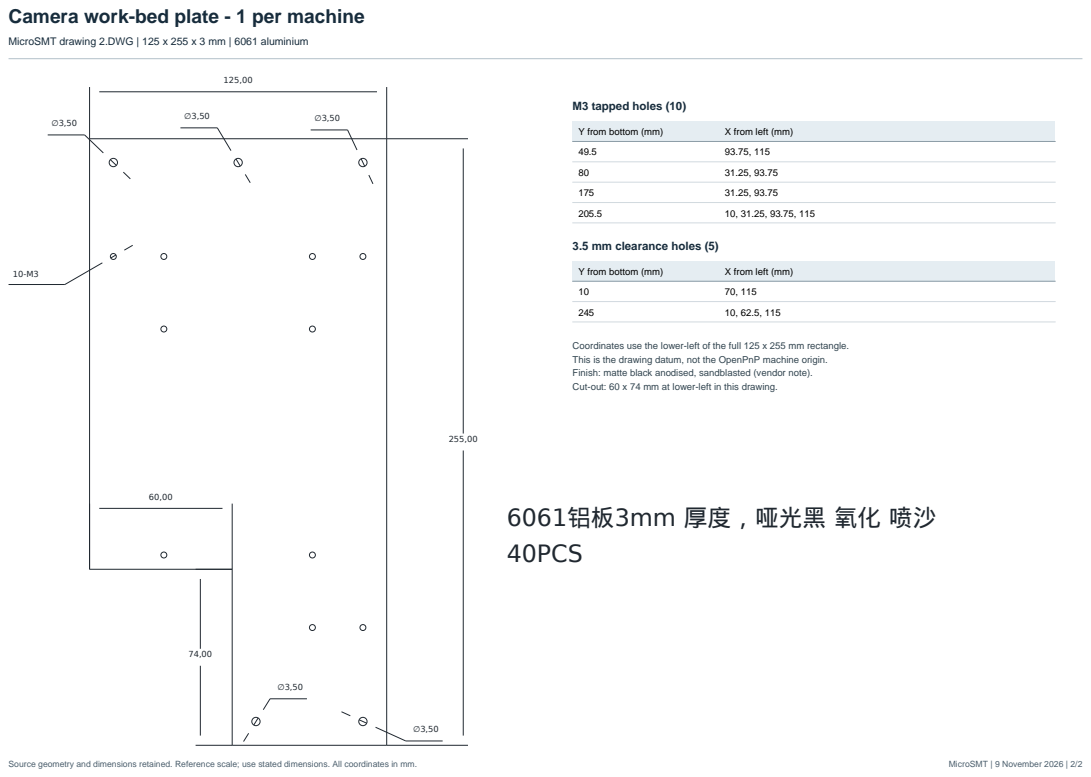
[picture p495: page 2]
Y from bottom (mm); X from left (mm); Source geometry and dimensions retained. Reference scale; use stated dimensions. All coordinates in mm.; MicroSMT | 9 November 2026 | 2/2

MicroSMT drawing 2.DWG | 125 x 255 x 3 mm | 6061 aluminium

3.5 mm clearance holes (5)

Coordinates use the lower-left of the full 125 x 255 mm rectangle.
This is the drawing datum, not the OpenPnP machine origin.
Finish: matte black anodised, sandblasted (vendor note).
Cut-out: 60 x 74 mm at lower-left in this drawing.

6061铝板3mm 厚度，哑光黑 氧化 喷沙
40PCS
