gabrielyoung92/gabs_microSMT_PickAndPlace/Microsmt-PNPv3/PCB_motherboard/docs/SCH.pdf

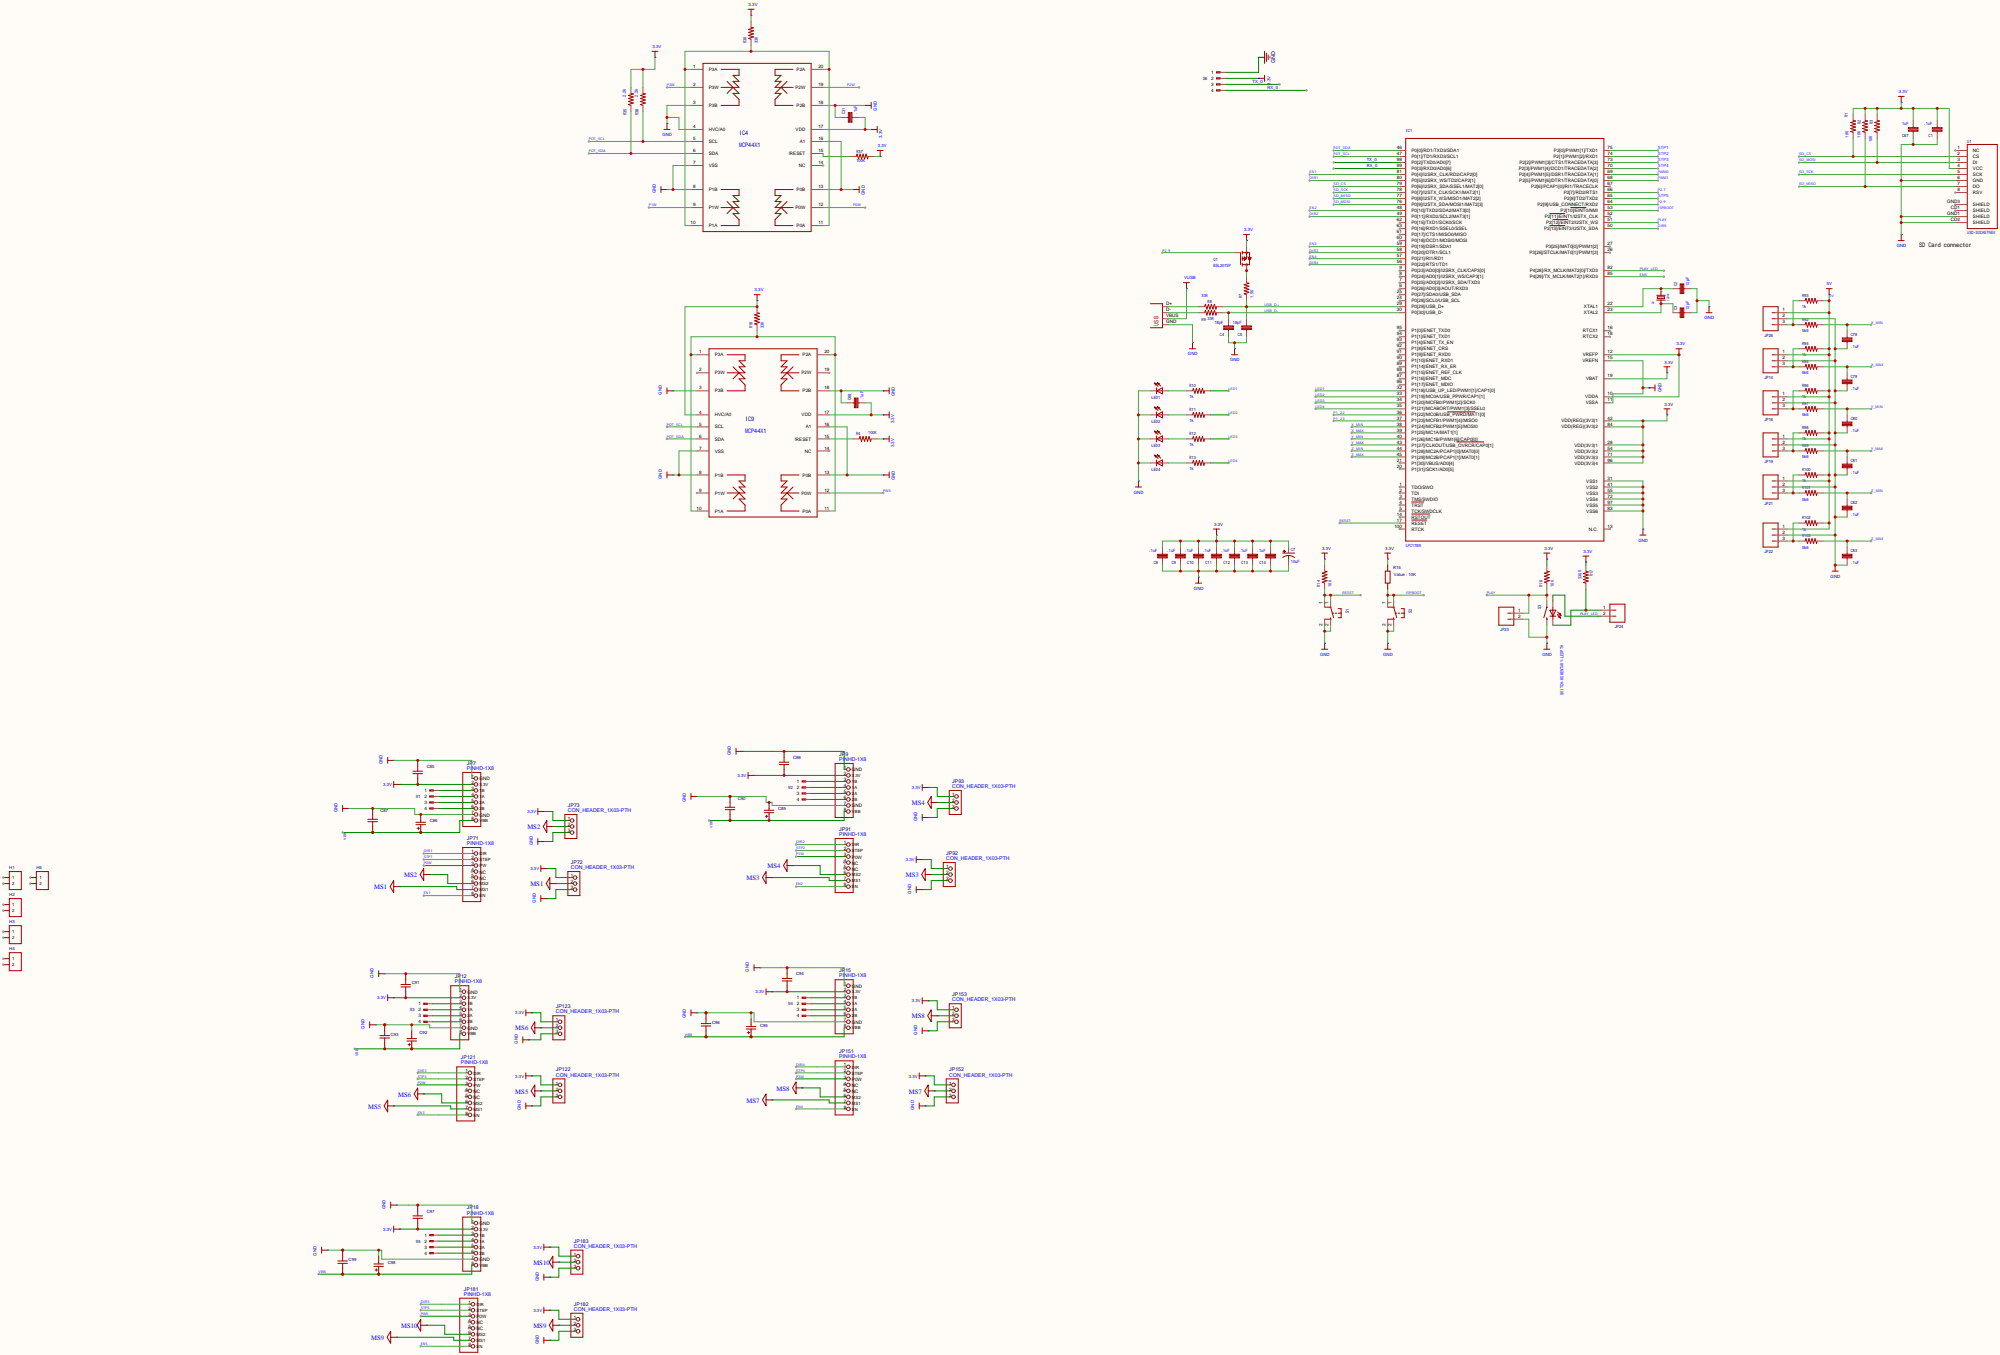
[picture p496: page 1]

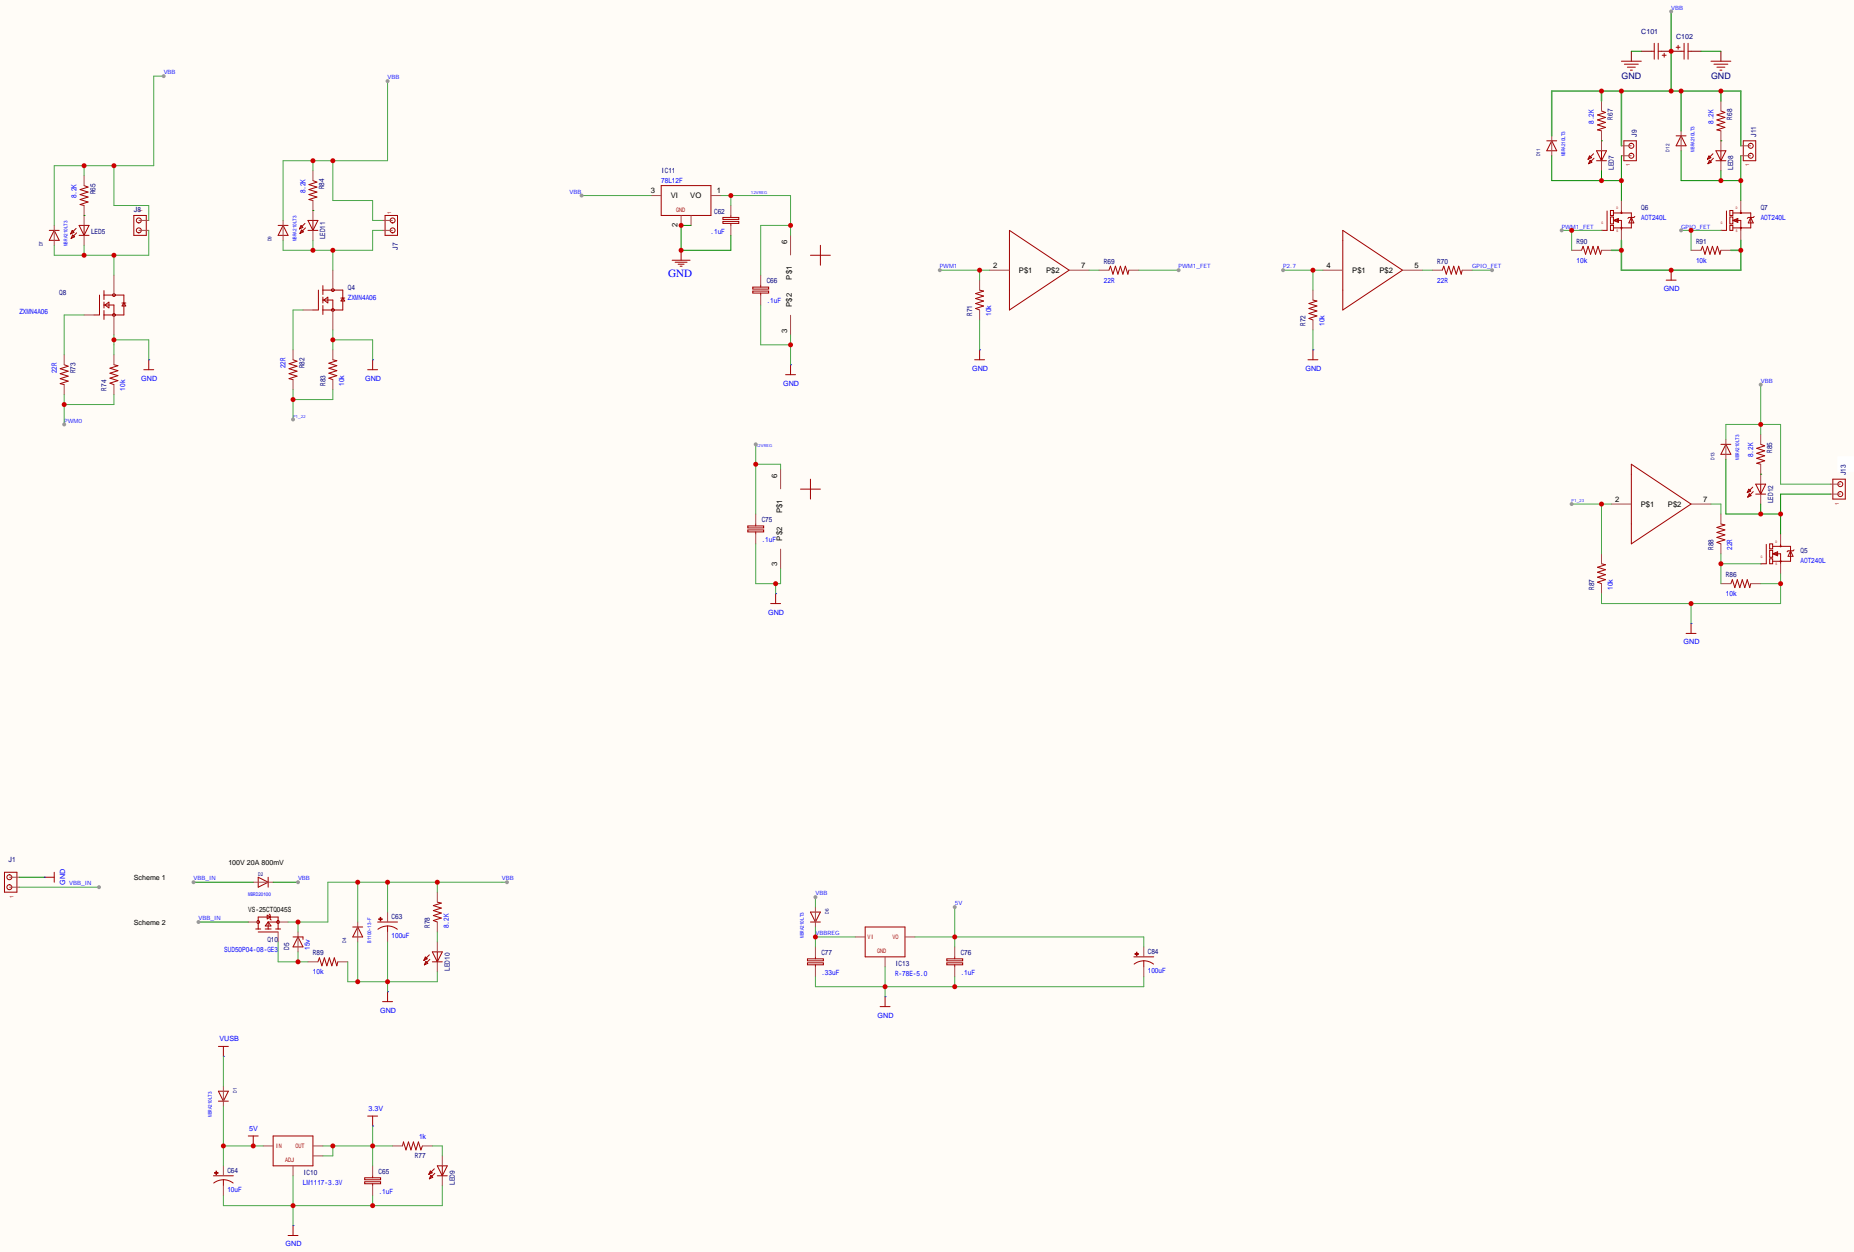
[picture p497: page 2]
