gabrielyoung92/gabs_microSMT_PickAndPlace/Bing-feeder/V485-Feeder Controller/PCB_busbar_short_180mm/KiCad/v485_busbar_180mm_pcb2.kicad_pcb

## KiCad design Bing-feeder/V485-Feeder Controller/PCB_busbar_short_180mm/KiCad/v485_busbar_180mm_pcb2.kicad_pcb (2026-10-20)

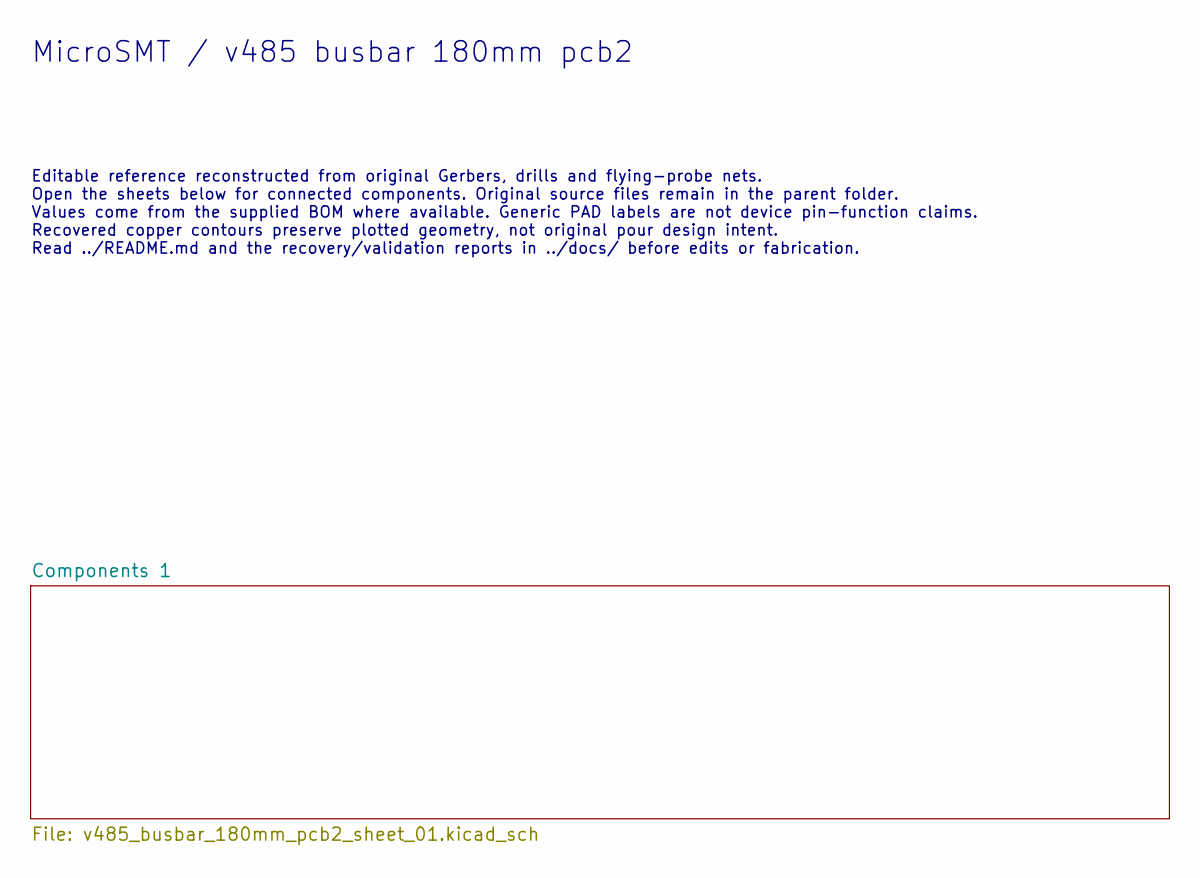
[picture p498: schematic v485_busbar_180mm_pcb2.kicad_sch, v485_busbar_180mm_pcb2 / MicroSMT recovered reference]

Notes on the sheet:
MicroSMT / v485 busbar 180mm pcb2
Editable reference reconstructed from original Gerbers, drills and flying-probe nets. Open the sheets below for connected components. Original source files remain in the parent folder. Values come from the supplied BOM where available. Generic PAD labels are not device pin-function claims. Recovere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

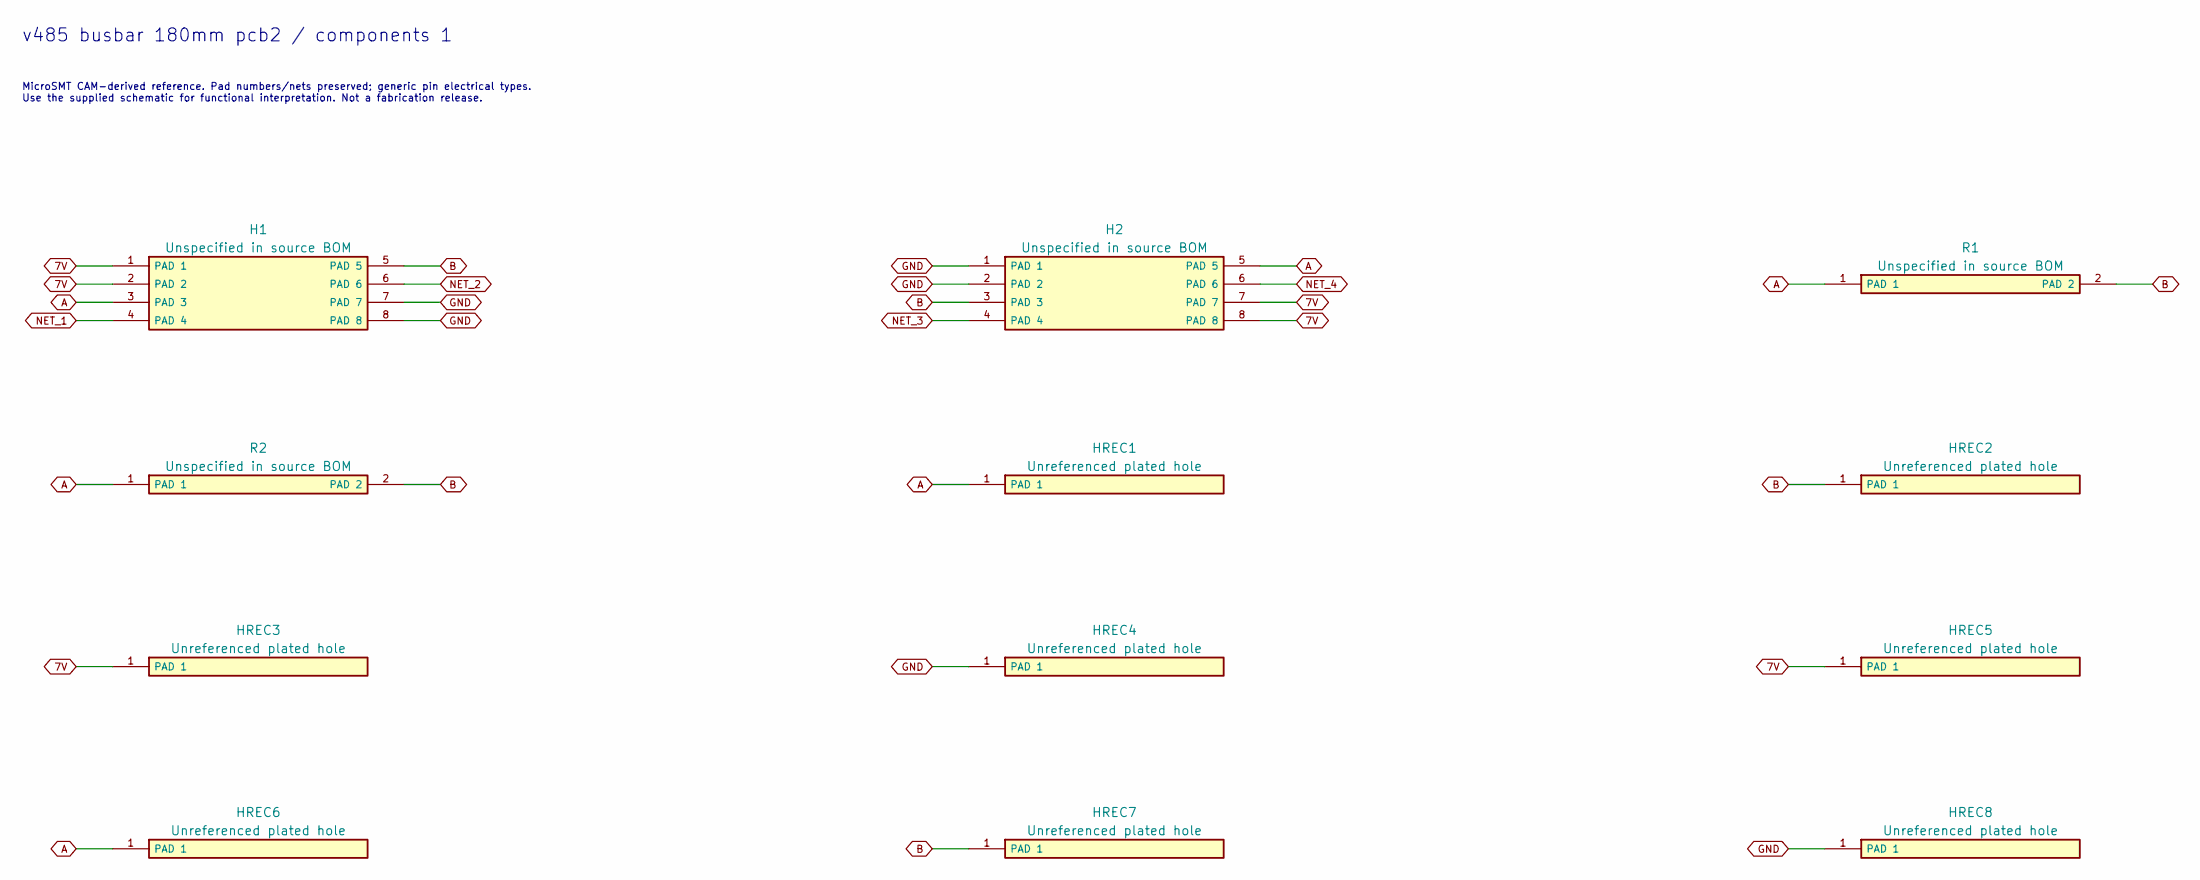
[picture p499: schematic v485_busbar_180mm_pcb2_sheet_01.kicad_sch, v485_busbar_180mm_pcb2 / recovered reference]

Parts:
H1: Unspecified in source BOM; SMD_8_72fee1c658
H2: Unspecified in source BOM; SMD_8_af5a7f26e5
HREC1, HREC2, HREC3, HREC4, HREC5, HREC6, HREC7, HREC8: Unreferenced plated hole; PTH_1_d32e30a0ea
R1, R2: Unspecified in source BOM; SMD_2_a7994fb989

Connections:
7V: H1.1 (PAD 1), H1.2 (PAD 2), H2.7 (PAD 7), H2.8 (PAD 8), HREC3.1, HREC5.1
A: H1.3 (PAD 3), H2.5 (PAD 5), HREC1.1, HREC6.1, R1.1 (PAD 1), R2.1 (PAD 1)
B: H1.5 (PAD 5), H2.3 (PAD 3), HREC2.1, HREC7.1, R1.2 (PAD 2), R2.2 (PAD 2)
GND: H1.7 (PAD 7), H1.8 (PAD 8), H2.1 (PAD 1), H2.2 (PAD 2), HREC4.1, HREC8.1
NET_1: H1.4 (PAD 4)
NET_2: H1.6 (PAD 6)
NET_3: H2.4 (PAD 4)
NET_4: H2.6 (PAD 6)

Notes on the sheet:
v485 busbar 180mm pcb2 / components 1
MicroSMT CAM-derived reference. Pad numbers/nets preserved; generic pin electrical types. Use the supplied schematic for functional interpretation. Not a fabrication release.

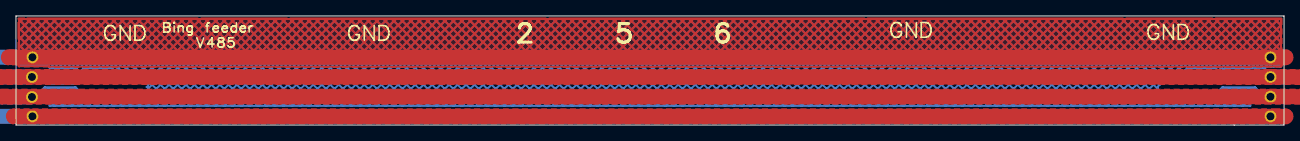
[picture p500: board v485_busbar_180mm_pcb2.kicad_pcb from above]

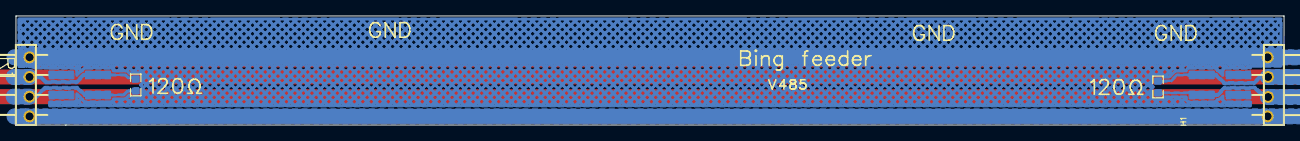
[picture p501: board v485_busbar_180mm_pcb2.kicad_pcb from below]

Board: 2 copper layers, 161.0 x 13.9 mm, 12 parts (4 on the bottom side), 4 nets.
