gabrielyoung92/gabs_microSMT_PickAndPlace/Bing-feeder/V3-feeder/PCB_feeder/KiCad/feeder_v2.kicad_pcb

## KiCad design Bing-feeder/V3-feeder/PCB_feeder/KiCad/feeder_v2.kicad_pcb (2026-10-20, an earlier design)

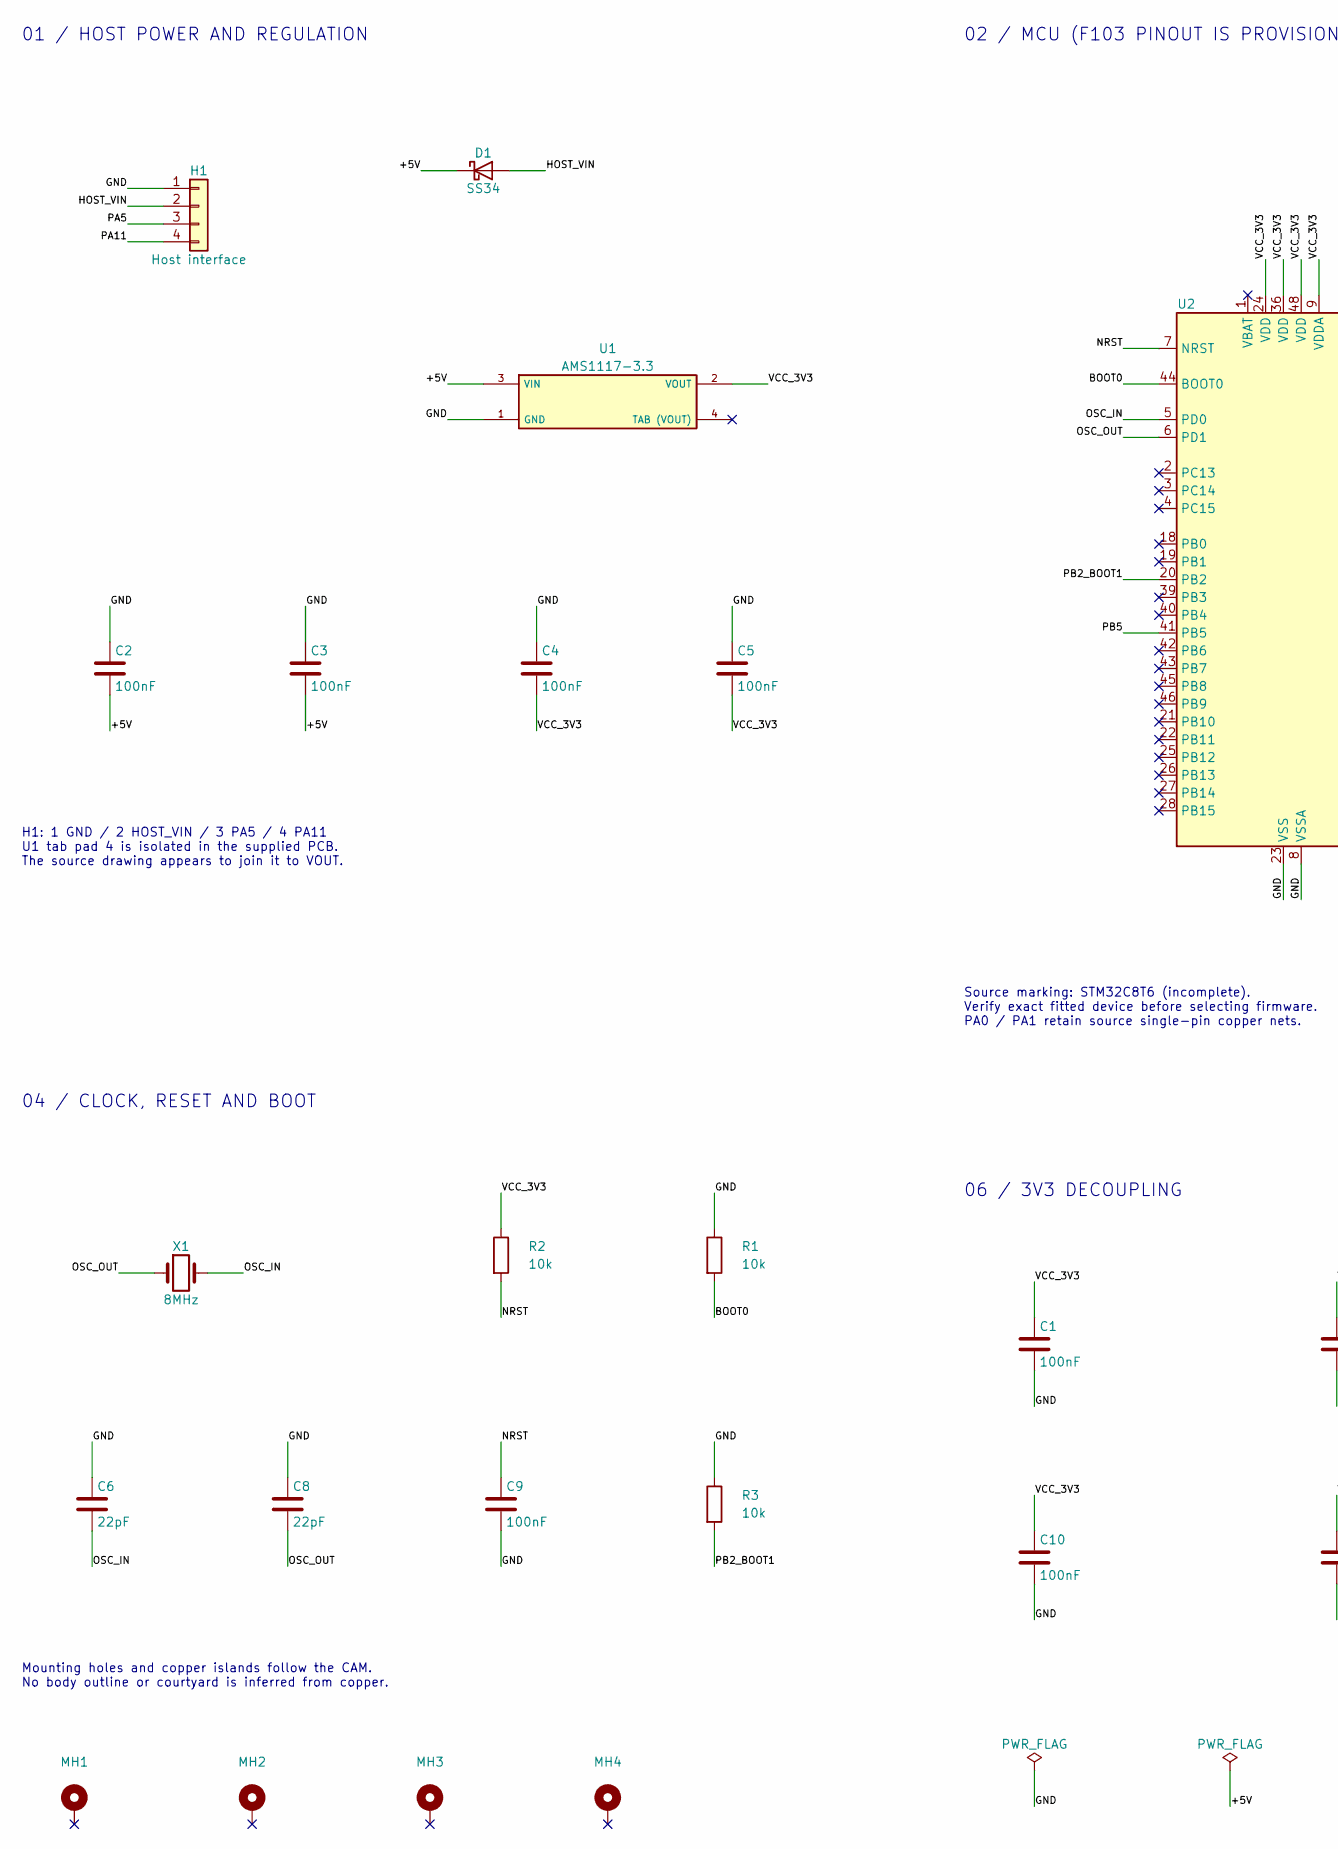
[picture p505: schematic feeder_v2.kicad_sch, Bing feeder V2 - recovered reference, part in row 1, column 1]

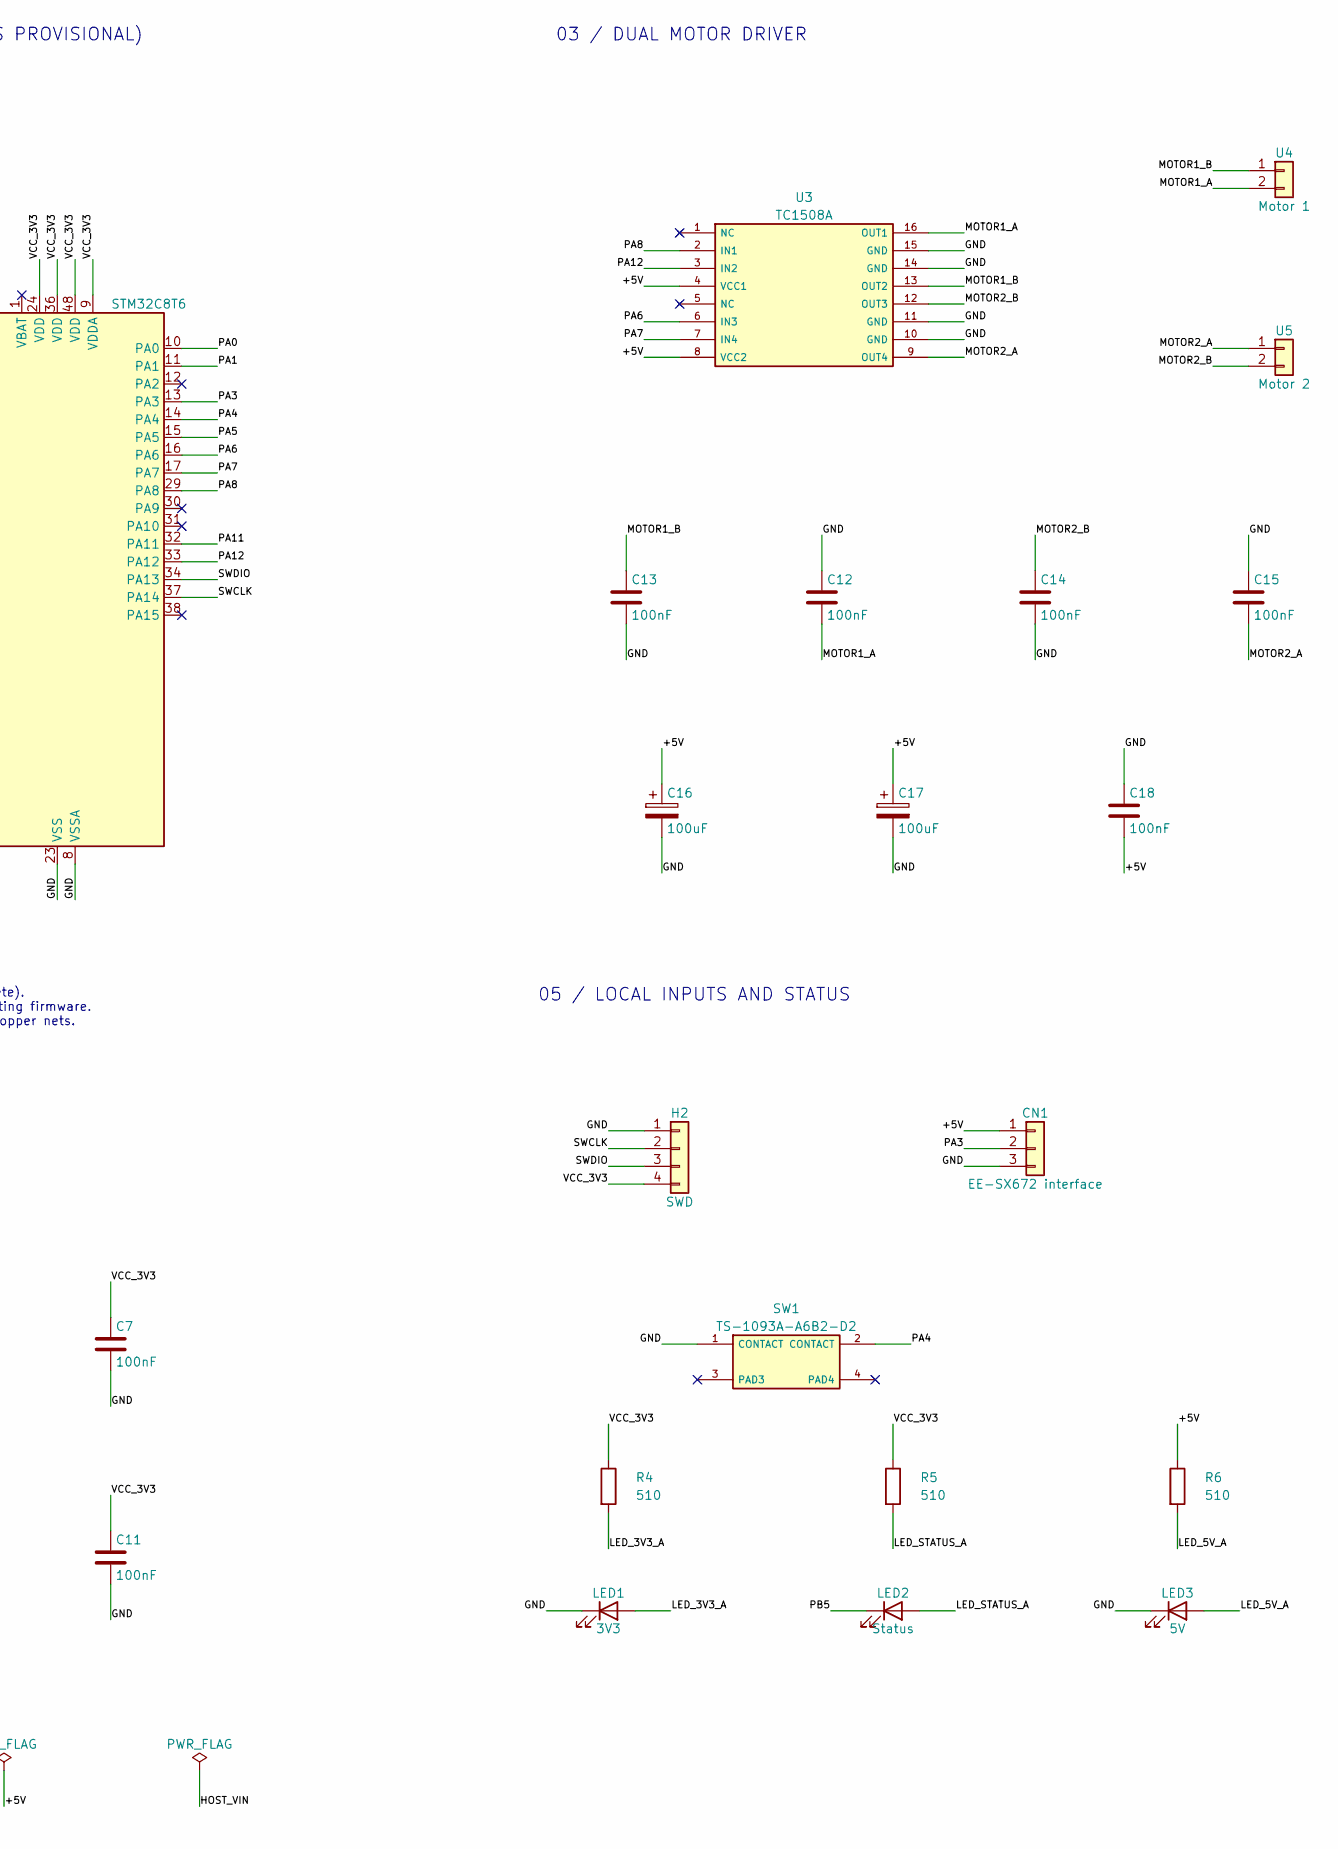
[picture p506: schematic feeder_v2.kicad_sch, Bing feeder V2 - recovered reference, part in row 1, column 2]

Parts:
C1, C4, C5, C9, C10: 100nF; SMD_2_4654a48235
C2, C11: 100nF; SMD_2_6acc588369
C3: 100nF; SMD_2_2eba8715d4
C6: 22pF; SMD_2_6acc588369
C7: 100nF; SMD_2_d7f3dab159
C8: 22pF; SMD_2_d7f3dab159
C12, C13, C15: 100nF; SMD_2_ea9585d00e
C14: 100nF; SMD_2_73e6f4f0fe
C16: 100uF; SMD_2_ec123379e2
C17: 100uF; SMD_2_6e07a3e01f
C18: 100nF; SMD_2_9b88676047
CN1: EE-SX672 interface; PTH_3_4a05049ecf
D1: SS34; SMD_2_2eb83b068d
H1: Host interface; PTH_4_349c8e8e96
H2: SWD; PTH_4_b36c63a0fc
LED1: 3V3; SMD_2_d3d32b5ec5
LED2: Status; SMD_2_90d08f57e1
LED3: 5V; SMD_2_4c3ddea3bf
MH1, MH2, MH3, MH4: Plated mounting hole 2.5mm; PTH_1_75dcf4be66
R1: 10k; SMD_2_0ab8a8e8a3
R2, R3: 10k; SMD_2_d2af6b9a79
R4: 510; SMD_2_a94b28ce2e
R5: 510; SMD_2_b14ba15cf3
R6: 510; SMD_2_d2af6b9a79
SW1: TS-1093A-A6B2-D2; PTH_4_230f0c19bc
U1: AMS1117-3.3; SMD_4_f5cc46188f
U2: STM32C8T6; SMD_48_5916ba93e4
U3: TC1508A; SMD_16_ae7b02a39a
U4: Motor 1; PTH_2_ae613bcbab
U5: Motor 2; PTH_2_ae613bcbab
X1: 8MHz; PTH_2_5813266c9b

Connections:
/+5V: C2.2, C3.2, C16.1, C17.1, C18.2, CN1.1, D1.1 (K), R6.1, U1.3 (VIN), U3.4 (VCC1), U3.8 (VCC2)
/BOOT0: R1.2, U2.44 (BOOT0)
/GND: C1.2, C2.1, C3.1, C4.1, C5.1, C6.1, C7.2, C8.1, C9.2, C10.2, C11.2, C12.1, C13.2, C14.2, C15.1, C16.2, C17.2, C18.1, CN1.3, H1.1, H2.1, LED1.1 (K), LED3.1 (K), R1.1, R3.1, SW1.1 (CONTACT), U1.1 (GND), U2.8 (VSSA), U2.23 (VSS), U2.35 (VSS), U2.47 (VSS), U3.10 (GND), U3.11 (GND), U3.14 (GND), U3.15 (GND)
/HOST_VIN: D1.2 (A), H1.2
/LED_3V3_A: LED1.2 (A), R4.2
/LED_5V_A: LED3.2 (A), R6.2
/LED_STATUS_A: LED2.2 (A), R5.2
/MOTOR1_A: C12.2, U3.16 (OUT1), U4.2
/MOTOR1_B: C13.1, U3.13 (OUT2), U4.1
/MOTOR2_A: C15.2, U3.9 (OUT4), U5.1
/MOTOR2_B: C14.1, U3.12 (OUT3), U5.2
/NRST: C9.1, R2.2, U2.7 (NRST)
/OSC_IN: C6.2, U2.5 (PD0), X1.2
/OSC_OUT: C8.2, U2.6 (PD1), X1.1
/PA0: U2.10 (PA0)
/PA1: U2.11 (PA1)
/PA3: CN1.2, U2.13 (PA3)
/PA4: SW1.2 (CONTACT), U2.14 (PA4)
/PA5: H1.3, U2.15 (PA5)
/PA6: U2.16 (PA6), U3.6 (IN3)
/PA7: U2.17 (PA7), U3.7 (IN4)
/PA8: U2.29 (PA8), U3.2 (IN1)
/PA11: H1.4, U2.32 (PA11)
/PA12: U2.33 (PA12), U3.3 (IN2)
/PB2_BOOT1: R3.2, U2.20 (PB2)
/PB5: LED2.1 (K), U2.41 (PB5)
/SWCLK: H2.2, U2.37 (PA14)
/SWDIO: H2.3, U2.34 (PA13)
/VCC_3V3: C1.1, C4.2, C5.2, C7.1, C10.1, C11.1, H2.4, R2.1, R4.1, R5.1, U1.2 (VOUT), U2.9 (VDDA), U2.24 (VDD), U2.36 (VDD), U2.48 (VDD)

Notes on the sheet:
01 / HOST POWER AND REGULATION
H1: 1 GND / 2 HOST_VIN / 3 PA5 / 4 PA11 U1 tab pad 4 is isolated in the supplied PCB. The source drawing appears to join it to VOUT.
02 / MCU (F103 PINOUT IS PROVISIONAL)
Source marking: STM32C8T6 (incomplete). Verify exact fitted device before selecting firmware. PA0 / PA1 retain source single-pin copper nets.
03 / DUAL MOTOR DRIVER
04 / CLOCK, RESET AND BOOT
05 / LOCAL INPUTS AND STATUS
06 / 3V3 DECOUPLING
Mounting holes and copper islands follow the CAM. No body outline or courtyard is inferred from copper.

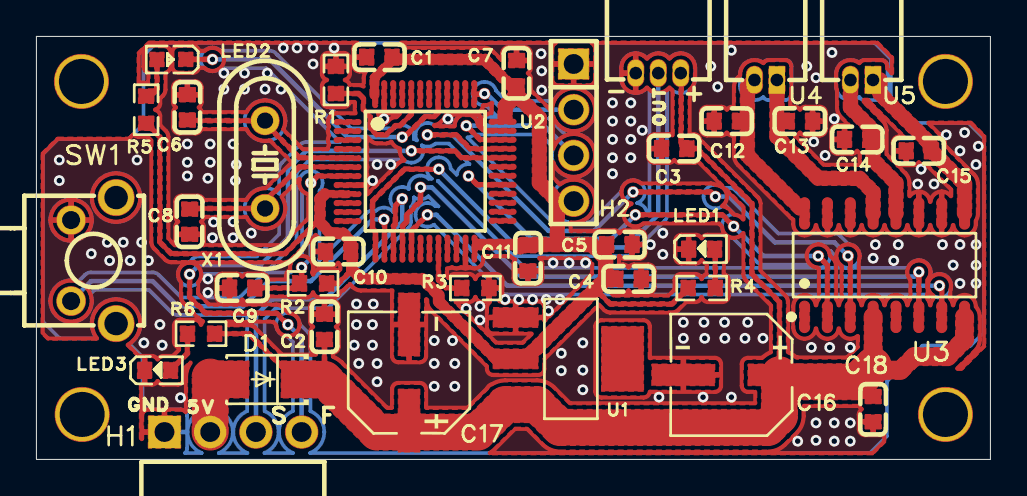
[picture p507: board feeder_v2.kicad_pcb from above]

Board: 2 copper layers, 53.0 x 23.5 mm, 42 parts (0 on the bottom side), 27 nets.
