gabrielyoung92/gabs_microSMT_PickAndPlace/Bing-feeder/V3-Feeder Controller/PCB_busbar_N1-N8/KiCad/busbar_n1_n8.kicad_pcb

## KiCad design Bing-feeder/V3-Feeder Controller/PCB_busbar_N1-N8/KiCad/busbar_n1_n8.kicad_pcb (2026-10-20, an earlier design)

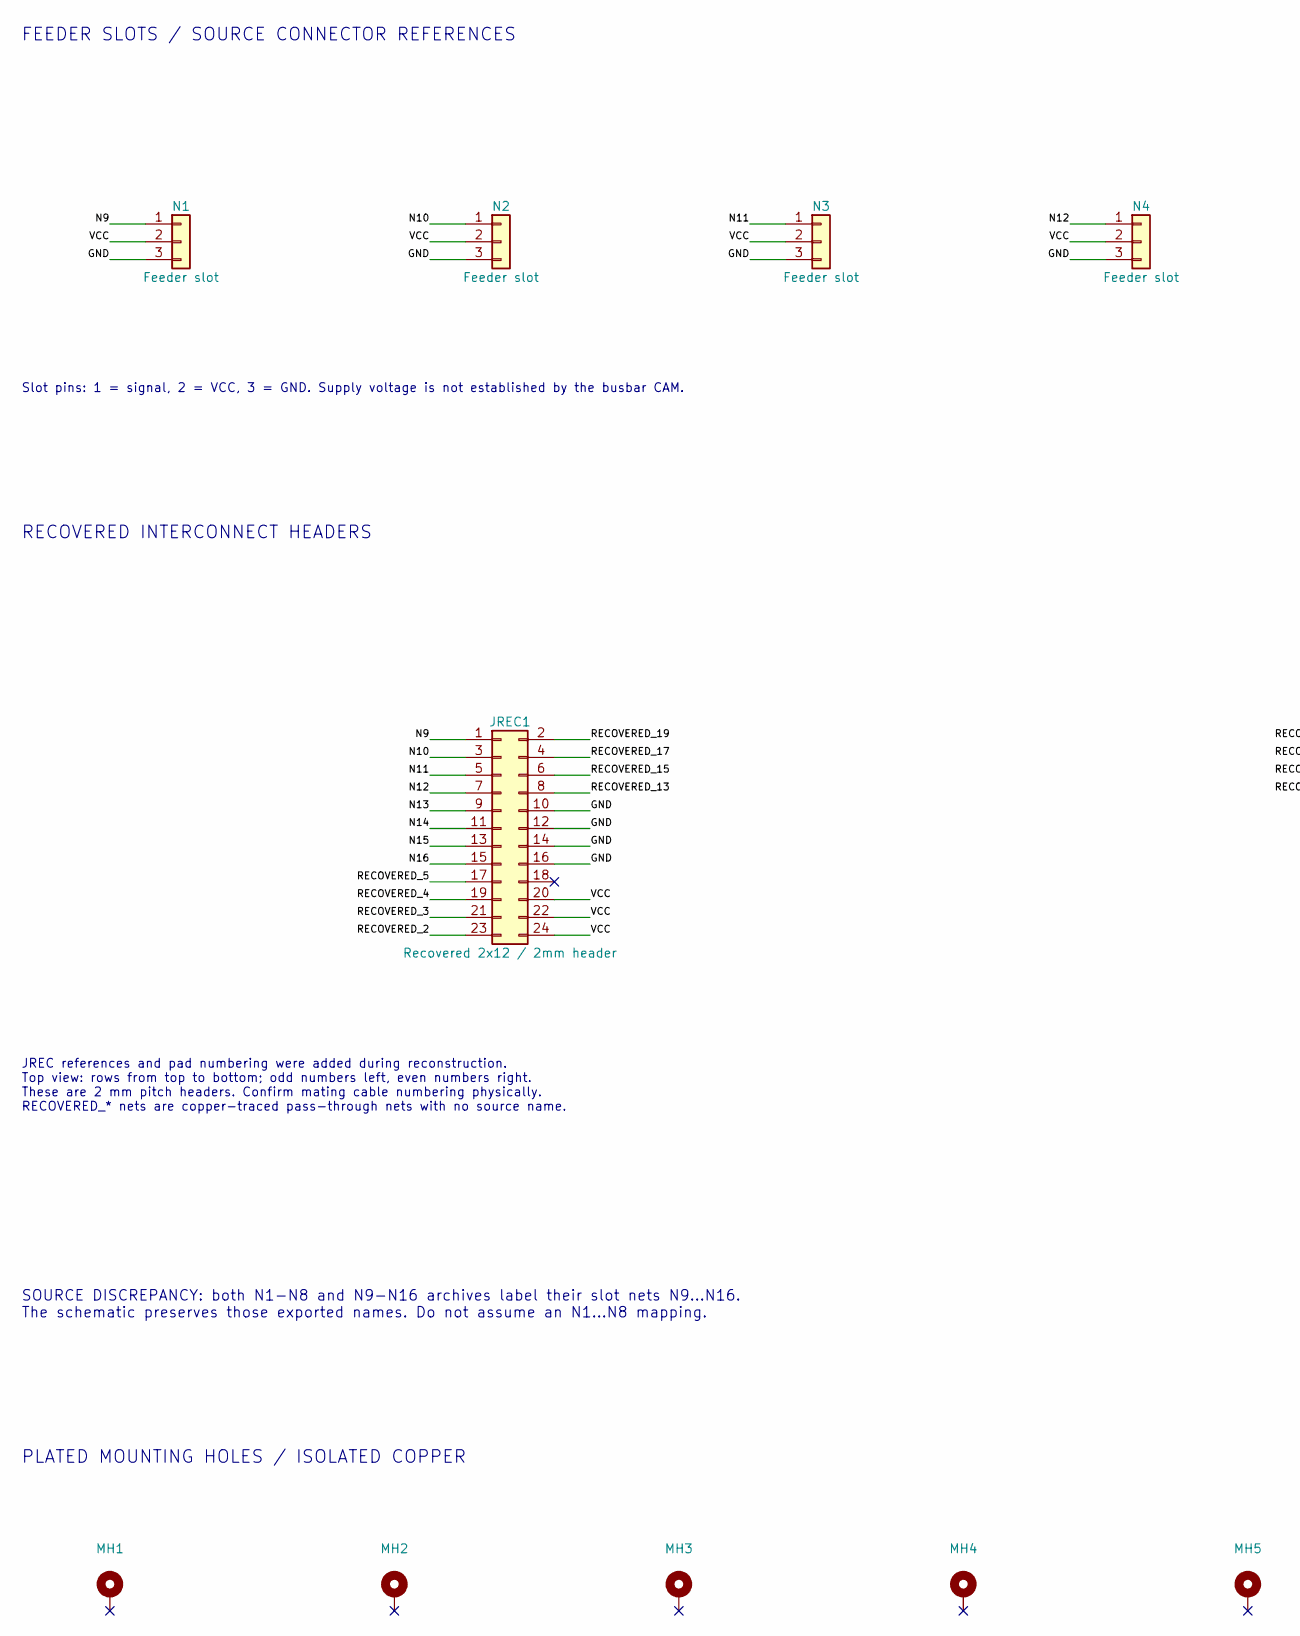
[picture p508: schematic busbar_n1_n8.kicad_sch, BUSBAR N1 N8 - recovered reference, part in row 1, column 1]

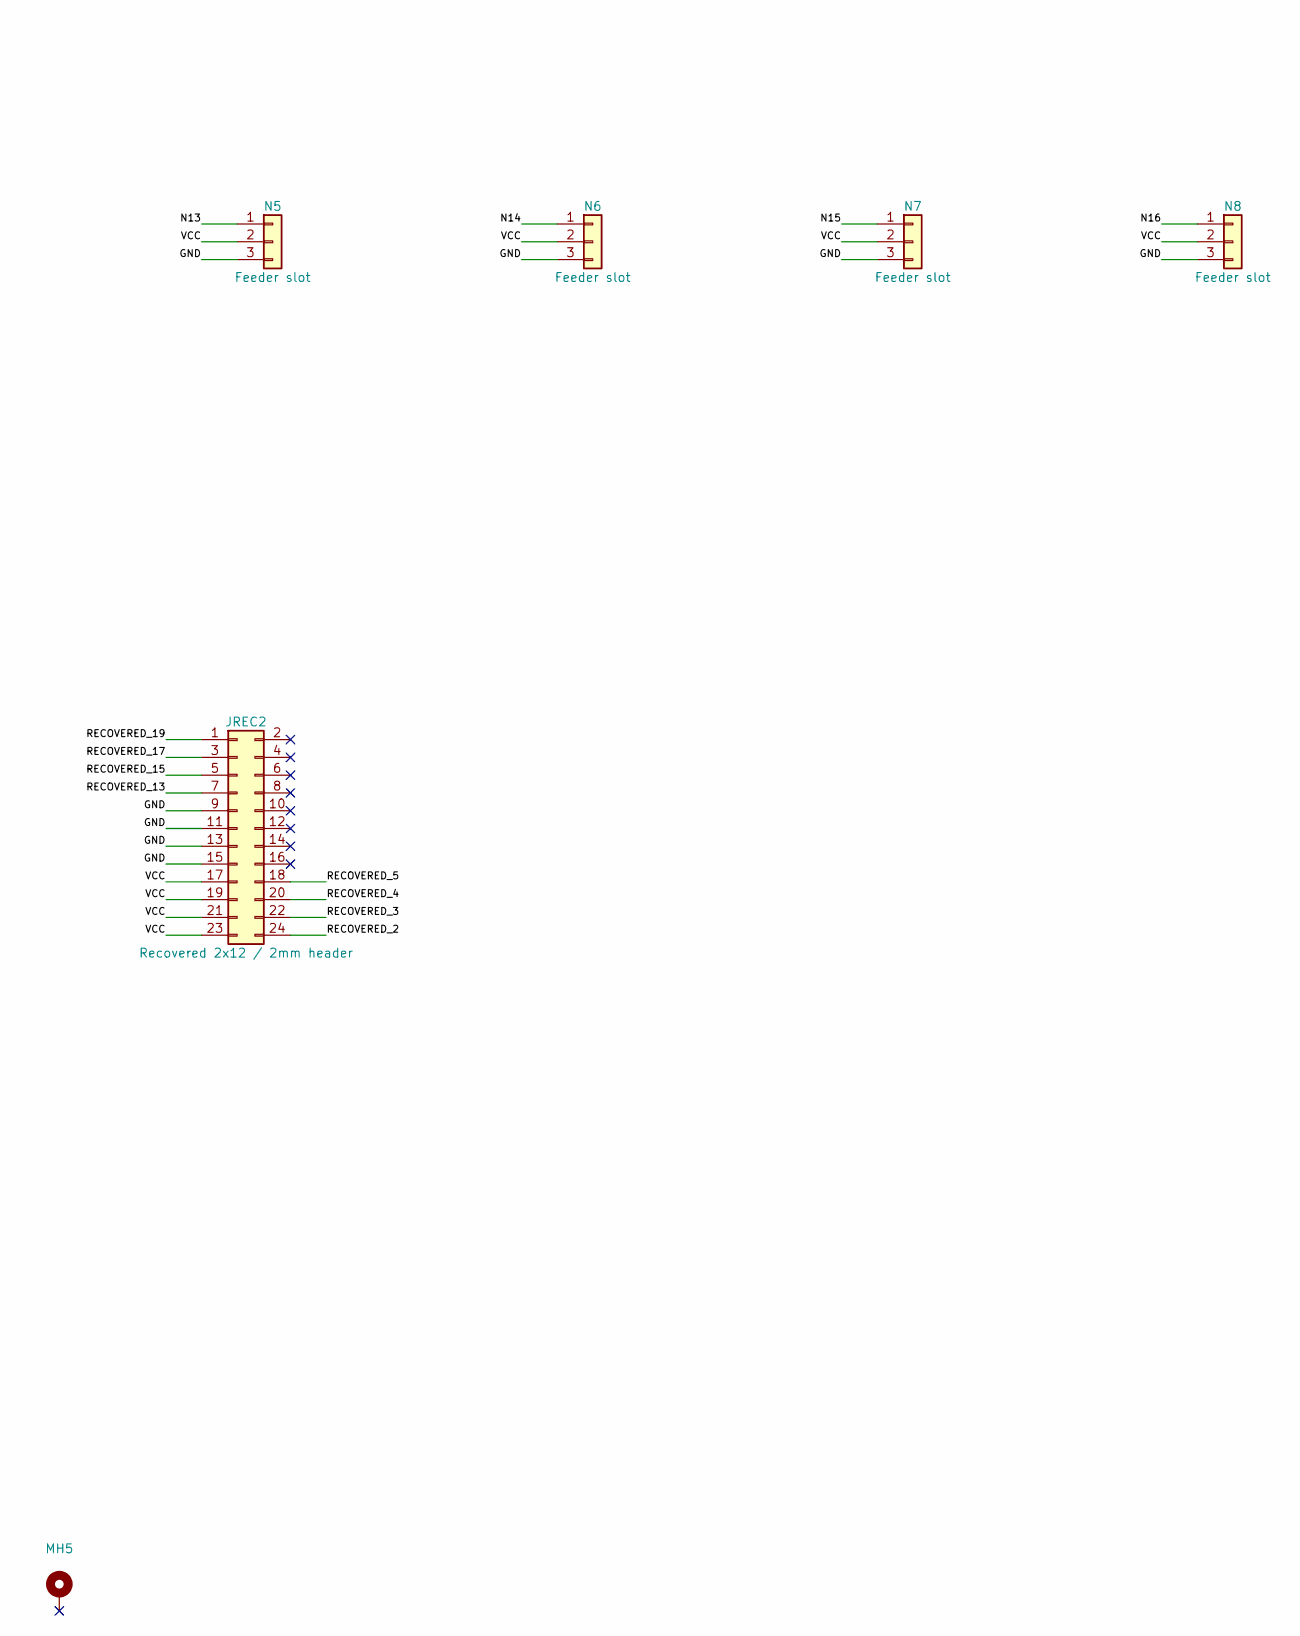
[picture p509: schematic busbar_n1_n8.kicad_sch, BUSBAR N1 N8 - recovered reference, part in row 1, column 2]

Parts:
JREC1: Recovered 2x12 / 2mm header; PTH_24_357941b971
JREC2: Recovered 2x12 / 2mm header; PTH_24_a566e0777e
MH1, MH2, MH3, MH4, MH5: Plated mounting hole 3.3mm; PTH_1_508660c0b4
N1: Feeder slot; PTH_3_73baab2469
N2: Feeder slot; PTH_3_f185d45fd5
N3: Feeder slot; PTH_3_f0a727b82c
N4: Feeder slot; PTH_3_f29aeb013d
N5: Feeder slot; PTH_3_40f9a56ae3
N6: Feeder slot; PTH_3_2e4f513424
N7: Feeder slot; PTH_3_8ca71f247a
N8: Feeder slot; PTH_3_1d444e7cb6

Connections:
/GND: JREC1.10, JREC1.12, JREC1.14, JREC1.16, JREC2.9, JREC2.11, JREC2.13, JREC2.15, N1.3, N2.3, N3.3, N4.3, N5.3, N6.3, N7.3, N8.3
/N9: JREC1.1, N1.1
/N10: JREC1.3, N2.1
/N11: JREC1.5, N3.1
/N12: JREC1.7, N4.1
/N13: JREC1.9, N5.1
/N14: JREC1.11, N6.1
/N15: JREC1.13, N7.1
/N16: JREC1.15, N8.1
/RECOVERED_2: JREC1.23, JREC2.24
/RECOVERED_3: JREC1.21, JREC2.22
/RECOVERED_4: JREC1.19, JREC2.20
/RECOVERED_5: JREC1.17, JREC2.18
/RECOVERED_13: JREC1.8, JREC2.7
/RECOVERED_15: JREC1.6, JREC2.5
/RECOVERED_17: JREC1.4, JREC2.3
/RECOVERED_19: JREC1.2, JREC2.1
/VCC: JREC1.20, JREC1.22, JREC1.24, JREC2.17, JREC2.19, JREC2.21, JREC2.23, N1.2, N2.2, N3.2, N4.2, N5.2, N6.2, N7.2, N8.2

Notes on the sheet:
FEEDER SLOTS / SOURCE CONNECTOR REFERENCES
Slot pins: 1 = signal, 2 = VCC, 3 = GND. Supply voltage is not established by the busbar CAM.
RECOVERED INTERCONNECT HEADERS
JREC references and pad numbering were added during reconstruction. Top view: rows from top to bottom; odd numbers left, even numbers right. These are 2 mm pitch headers. Confirm mating cable numbering physically. RECOVERED_* nets are copper-traced pass-through nets with no source name.
SOURCE DISCREPANCY: both N1-N8 and N9-N16 archives label their slot nets N9...N16. The schematic preserves those exported names. Do not assume an N1...N8 mapping.
PLATED MOUNTING HOLES / ISOLATED COPPER

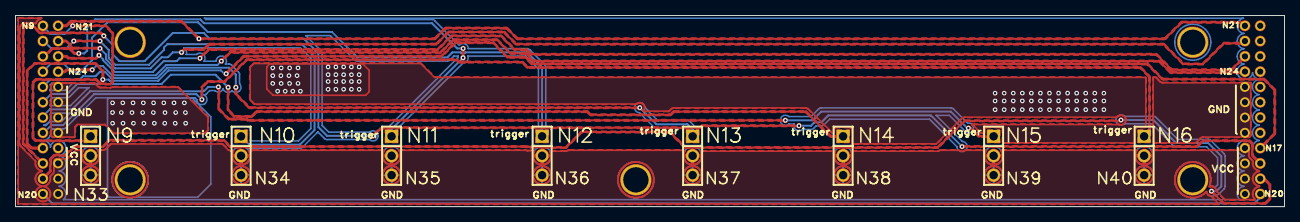
[picture p510: board busbar_n1_n8.kicad_pcb from above]

Board: 2 copper layers, 166.0 x 25.0 mm, 15 parts (0 on the bottom side), 18 nets.
