gabrielyoung92/gabs_microSMT_PickAndPlace/Bing-feeder/V485-feeder/PCB_feeder/KiCad/v485_feeder.kicad_pcb

## KiCad design Bing-feeder/V485-feeder/PCB_feeder/KiCad/v485_feeder.kicad_pcb (2026-10-20)

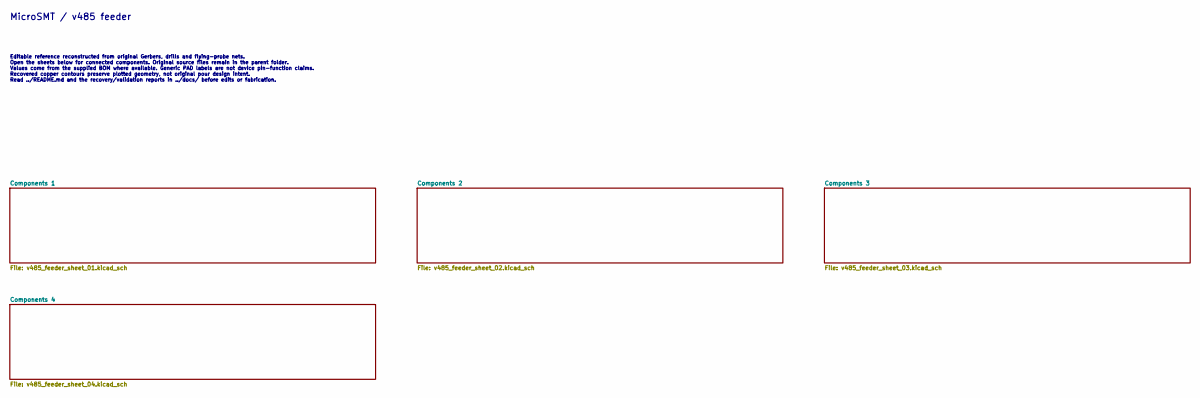
[picture p511: schematic v485_feeder.kicad_sch, v485_feeder / MicroSMT recovered reference]

Notes on the sheet:
MicroSMT / v485 feeder
Editable reference reconstructed from original Gerbers, drills and flying-probe nets. Open the sheets below for connected components. Original source files remain in the parent folder. Values come from the supplied BOM where available. Generic PAD labels are not device pin-function claims. Recovere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
