gabrielyoung92/gabs_microSMT_PickAndPlace/Bing-feeder/V485-feeder/PCB_feeder/KiCad/v485_feeder.kicad_pcb

## KiCad design Bing-feeder/V485-feeder/PCB_feeder/KiCad/v485_feeder.kicad_pcb (continued)

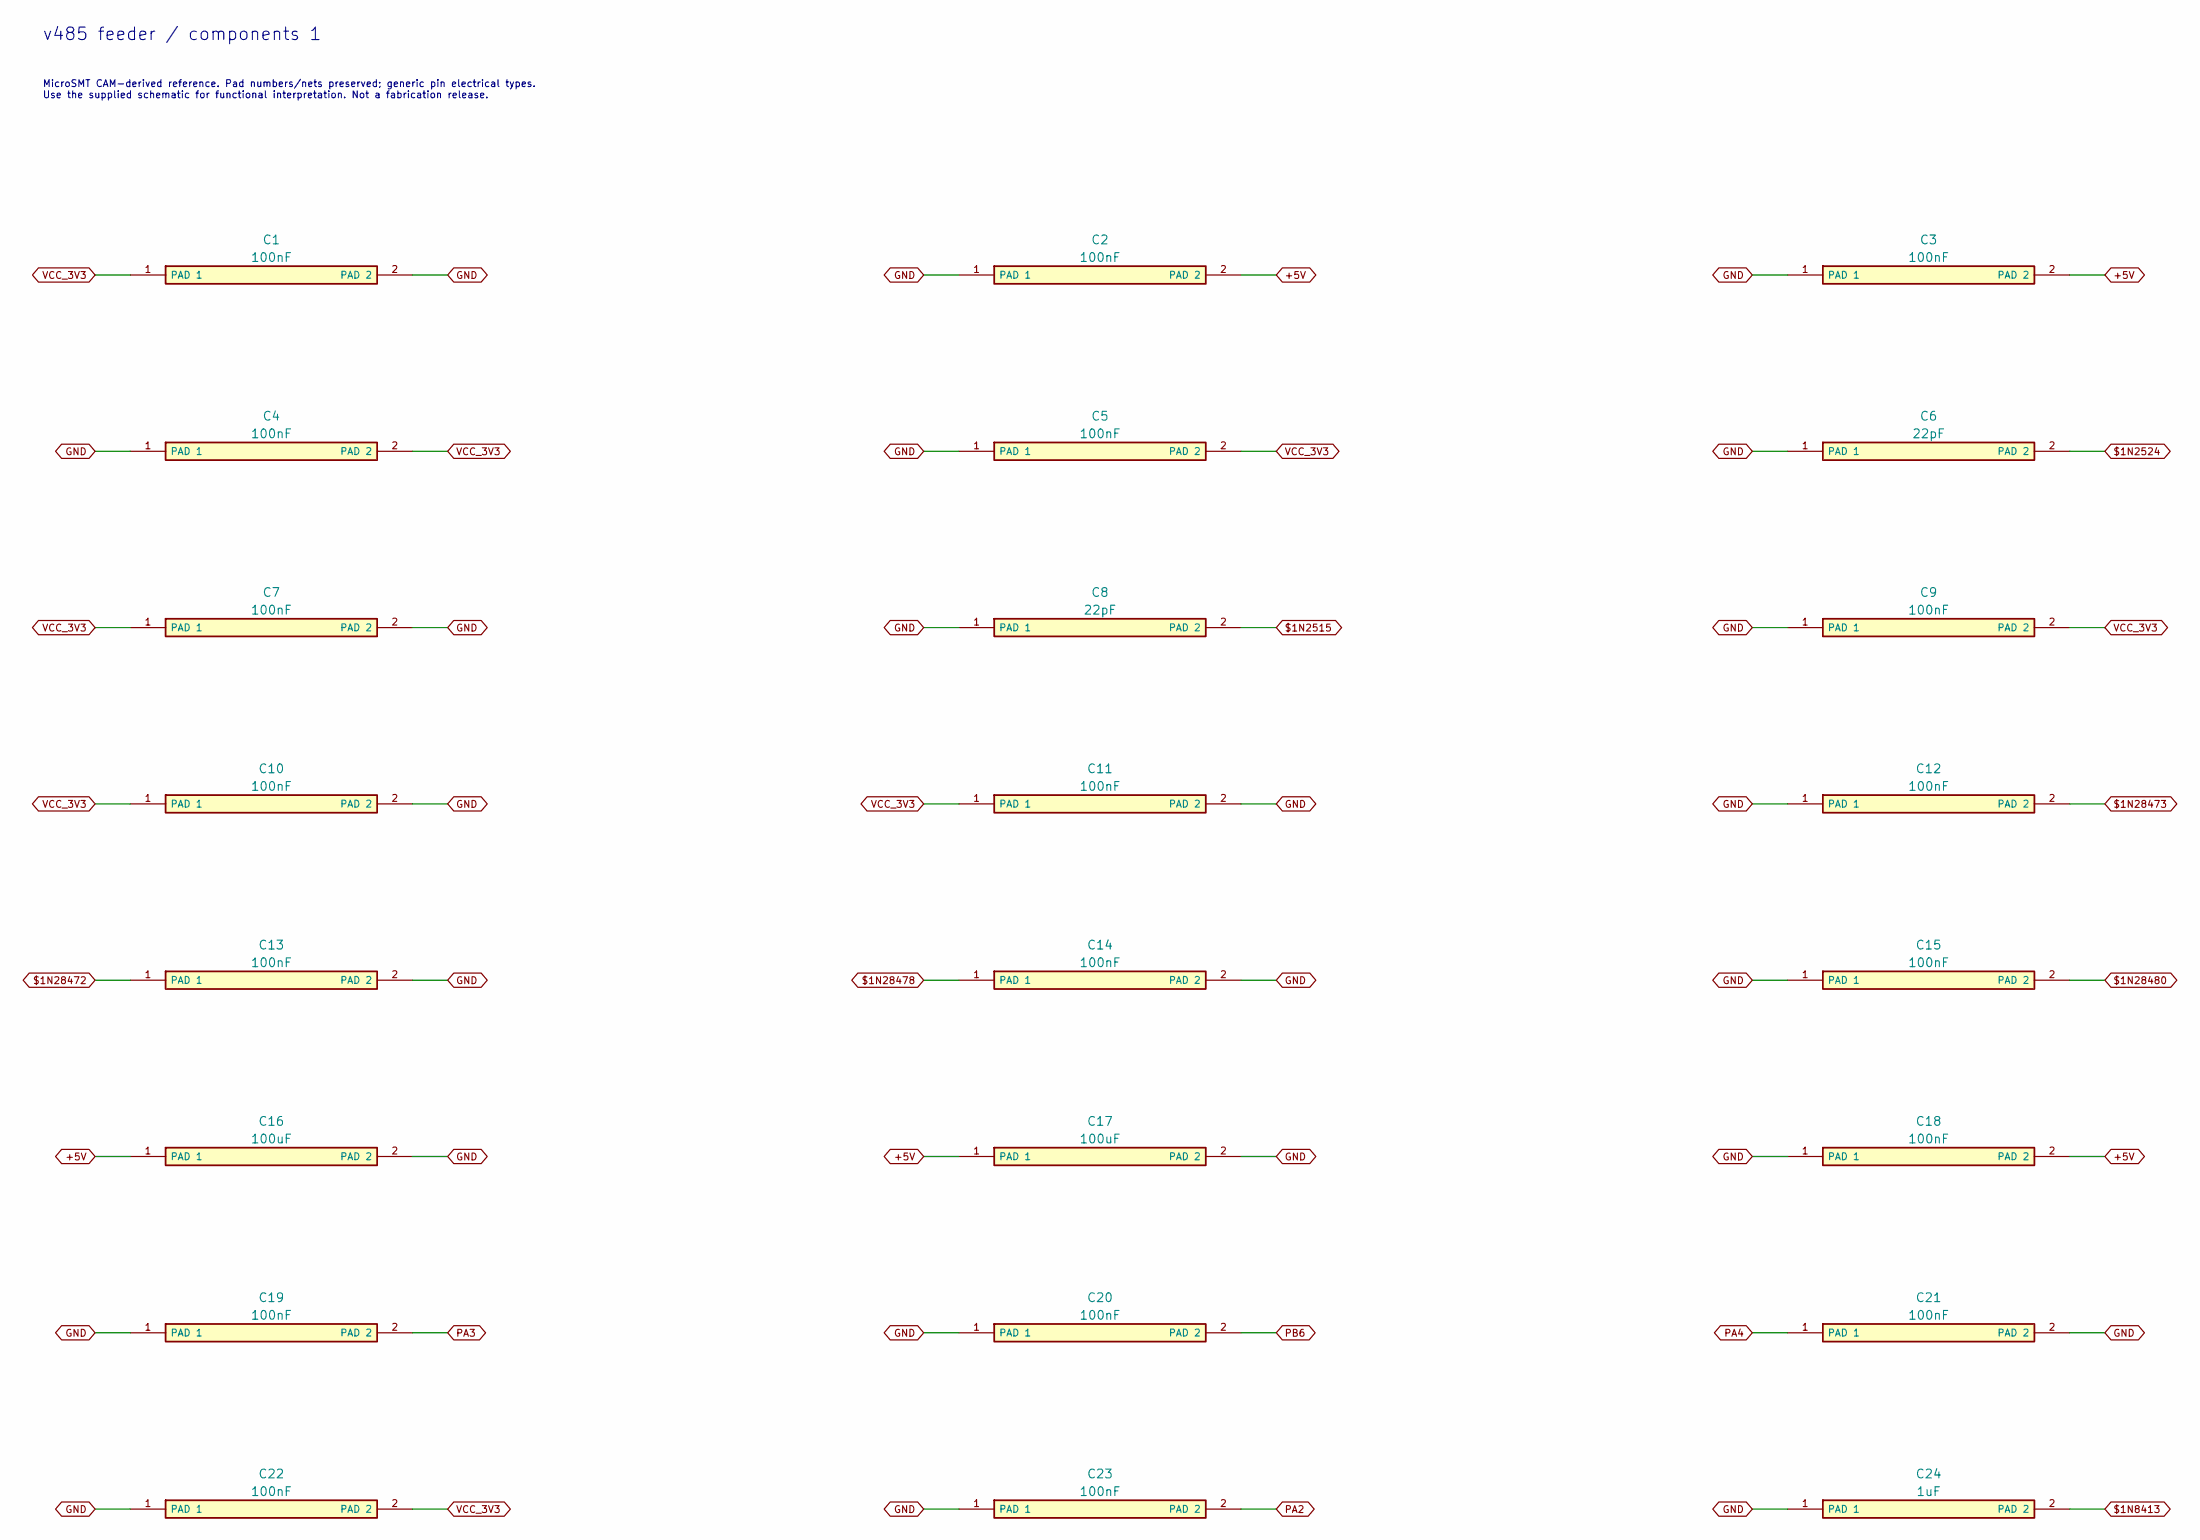
[picture p512: schematic v485_feeder_sheet_01.kicad_sch, v485_feeder / recovered reference]

Parts:
C1, C9, C10: 100nF; SMD_2_c1a3413776
C2: 100nF; SMD_2_829407ff48
C3, C11: 100nF; SMD_2_44635c1159
C4, C5, C7, C19, C20, C22: 100nF; SMD_2_cf0339bc75
C6: 22pF; SMD_2_874df9096d
C8: 22pF; SMD_2_aac479f3ea
C12, C13: 100nF; SMD_2_4db5f12e3d
C14, C15, C18: 100nF; SMD_2_3dfdeb042f
C16, C17: 100uF; SMD_2_6e07a3e01f
C21: 100nF; SMD_2_874df9096d
C23: 100nF; SMD_2_aac479f3ea
C24: 1uF; SMD_2_874df9096d

Connections:
$1N2515: C8.2 (PAD 2); also elsewhere on the board
$1N2524: C6.2 (PAD 2); also elsewhere on the board
$1N8413: C24.2 (PAD 2); also elsewhere on the board
$1N28472: C13.1 (PAD 1); also elsewhere on the board
$1N28473: C12.2 (PAD 2); also elsewhere on the board
$1N28478: C14.1 (PAD 1); also elsewhere on the board
$1N28480: C15.2 (PAD 2); also elsewhere on the board
+5V: C2.2 (PAD 2), C3.2 (PAD 2), C16.1 (PAD 1), C17.1 (PAD 1), C18.2 (PAD 2); also elsewhere on the board
GND: C1.2 (PAD 2), C2.1 (PAD 1), C3.1 (PAD 1), C4.1 (PAD 1), C5.1 (PAD 1), C6.1 (PAD 1), C7.2 (PAD 2), C8.1 (PAD 1), C9.1 (PAD 1), C10.2 (PAD 2), C11.2 (PAD 2), C12.1 (PAD 1), C13.2 (PAD 2), C14.2 (PAD 2), C15.1 (PAD 1), C16.2 (PAD 2), C17.2 (PAD 2), C18.1 (PAD 1), C19.1 (PAD 1), C20.1 (PAD 1), C21.2 (PAD 2), C22.1 (PAD 1), C23.1 (PAD 1), C24.1 (PAD 1); also elsewhere on the board
PA2: C23.2 (PAD 2); also elsewhere on the board
PA3: C19.2 (PAD 2); also elsewhere on the board
PA4: C21.1 (PAD 1); also elsewhere on the board
PB6: C20.2 (PAD 2); also elsewhere on the board
VCC_3V3: C1.1 (PAD 1), C4.2 (PAD 2), C5.2 (PAD 2), C7.1 (PAD 1), C9.2 (PAD 2), C10.1 (PAD 1), C11.1 (PAD 1), C22.2 (PAD 2); also elsewhere on the board

Notes on the sheet:
v485 feeder / components 1
MicroSMT CAM-derived reference. Pad numbers/nets preserved; generic pin electrical types. Use the supplied schematic for functional interpretation. Not a fabrication release.

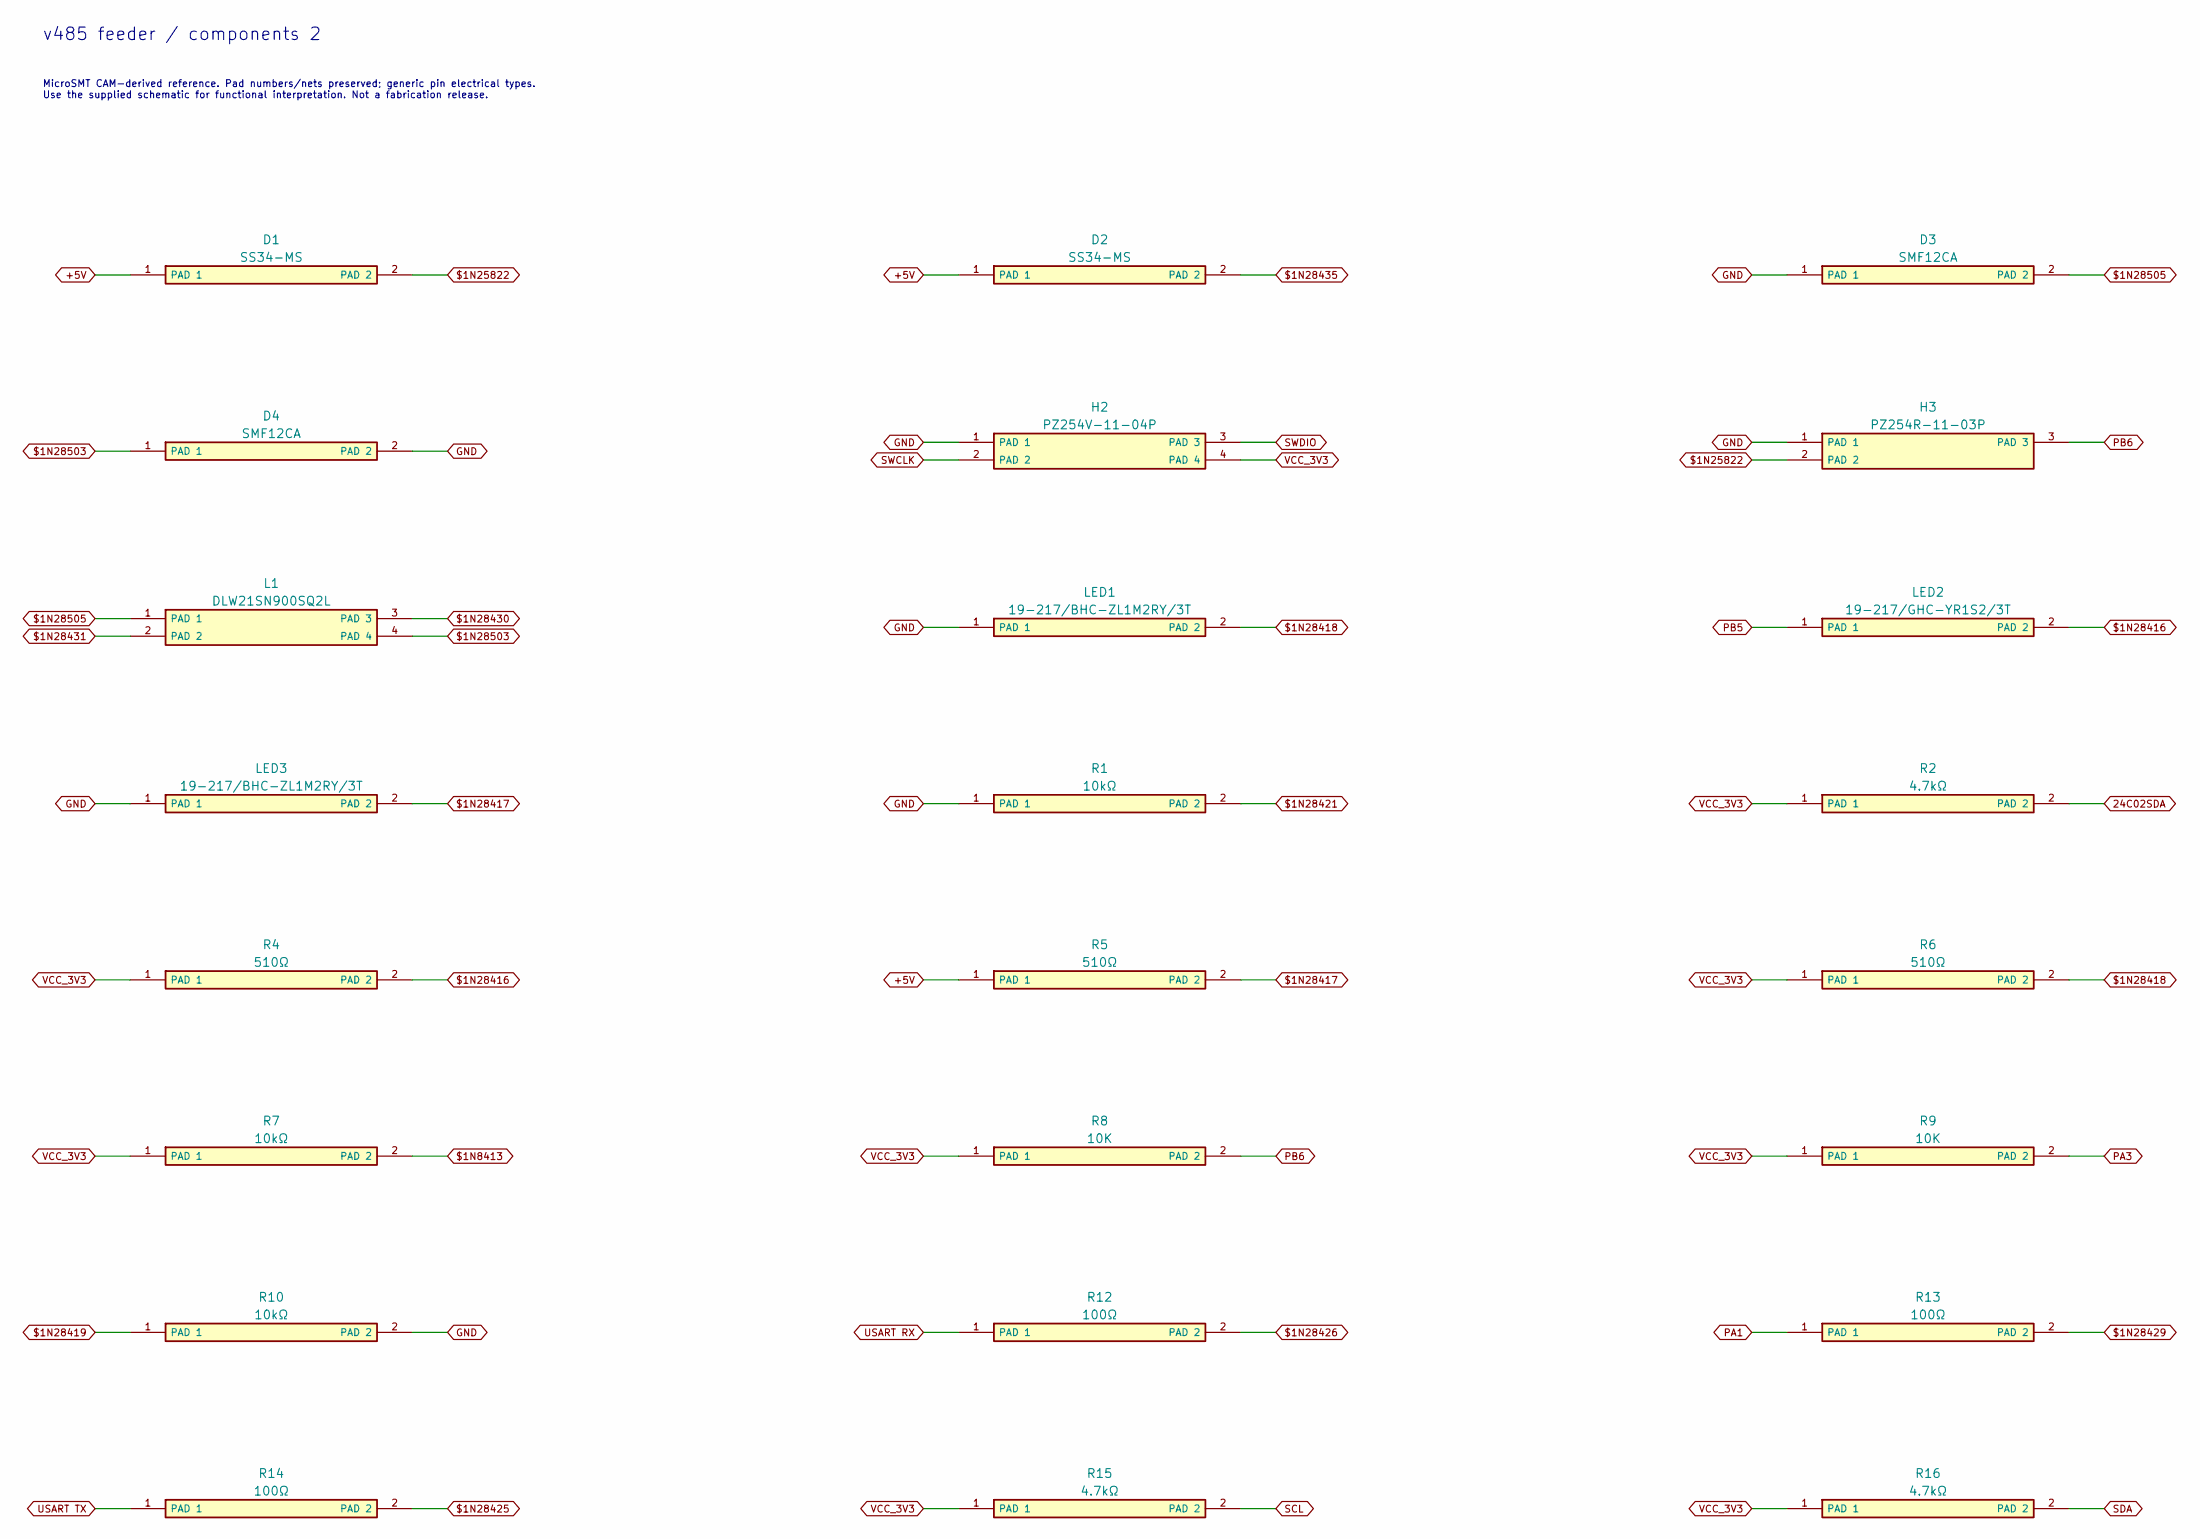
[picture p513: schematic v485_feeder_sheet_02.kicad_sch, v485_feeder / recovered reference]

Parts:
D1: SS34-MS; SMD_2_2eb83b068d
D2: SS34-MS; SMD_2_0e04a25b7f
D3, D4: SMF12CA; SMD_2_8d21fd2c67
H2: PZ254V-11-04P; PTH_4_3fe72de8b5
H3: PZ254R-11-03P; PTH_3_d1691705db
L1: DLW21SN900SQ2L; SMD_4_7982c82c77
LED1: 19-217/BHC-ZL1M2RY/3T; SMD_2_651440e7dc
LED2: 19-217/GHC-YR1S2/3T; SMD_2_262bb741d3
LED3: 19-217/BHC-ZL1M2RY/3T; SMD_2_eb93cb215b
R1, R10: 10kΩ; SMD_2_e7bda1677c
R2: 4.7kΩ; SMD_2_e7bda1677c
R4, R5: 510Ω; SMD_2_91fcdf277d
R6: 510Ω; SMD_2_e7bda1677c
R7: 10kΩ; SMD_2_91fcdf277d
R8: 10K; SMD_2_04577a26f8
R9: 10K; SMD_2_cc916b3528
R12, R13, R14: 100Ω; SMD_2_e7bda1677c
R15, R16: 4.7kΩ; SMD_2_bcd5a0224c

Connections:
24C02SDA: R2.2 (PAD 2); also elsewhere on the board
$1N8413: R7.2 (PAD 2); also elsewhere on the board
$1N25822: D1.2 (PAD 2), H3.2 (PAD 2)
$1N28416: LED2.2 (PAD 2), R4.2 (PAD 2)
$1N28417: LED3.2 (PAD 2), R5.2 (PAD 2)
$1N28418: LED1.2 (PAD 2), R6.2 (PAD 2)
$1N28419: R10.1 (PAD 1); also elsewhere on the board
$1N28421: R1.2 (PAD 2); also elsewhere on the board
$1N28425: R14.2 (PAD 2); also elsewhere on the board
$1N28426: R12.2 (PAD 2); also elsewhere on the board
$1N28429: R13.2 (PAD 2); also elsewhere on the board
$1N28430: L1.3 (PAD 3); also elsewhere on the board
$1N28431: L1.2 (PAD 2); also elsewhere on the board
$1N28435: D2.2 (PAD 2); also elsewhere on the board
$1N28503: D4.1 (PAD 1), L1.4 (PAD 4); also elsewhere on the board
$1N28505: D3.2 (PAD 2), L1.1 (PAD 1); also elsewhere on the board
+5V: D1.1 (PAD 1), D2.1 (PAD 1), R5.1 (PAD 1); also elsewhere on the board
GND: D3.1 (PAD 1), D4.2 (PAD 2), H2.1 (PAD 1), H3.1 (PAD 1), LED1.1 (PAD 1), LED3.1 (PAD 1), R1.1 (PAD 1), R10.2 (PAD 2); also elsewhere on the board
PA1: R13.1 (PAD 1); also elsewhere on the board
PA3: R9.2 (PAD 2); also elsewhere on the board
PB5: LED2.1 (PAD 1); also elsewhere on the board
PB6: H3.3 (PAD 3), R8.2 (PAD 2); also elsewhere on the board
SCL: R15.2 (PAD 2); also elsewhere on the board
SDA: R16.2 (PAD 2); also elsewhere on the board
SWCLK: H2.2 (PAD 2); also elsewhere on the board
SWDIO: H2.3 (PAD 3); also elsewhere on the board
USART RX: R12.1 (PAD 1); also elsewhere on the board
USART TX: R14.1 (PAD 1); also elsewhere on the board
VCC_3V3: H2.4 (PAD 4), R2.1 (PAD 1), R4.1 (PAD 1), R6.1 (PAD 1), R7.1 (PAD 1), R8.1 (PAD 1), R9.1 (PAD 1), R15.1 (PAD 1), R16.1 (PAD 1); also elsewhere on the board

Notes on the sheet:
v485 feeder / components 2
MicroSMT CAM-derived reference. Pad numbers/nets preserved; generic pin electrical types. Use the supplied schematic for functional interpretation. Not a fabrication release.

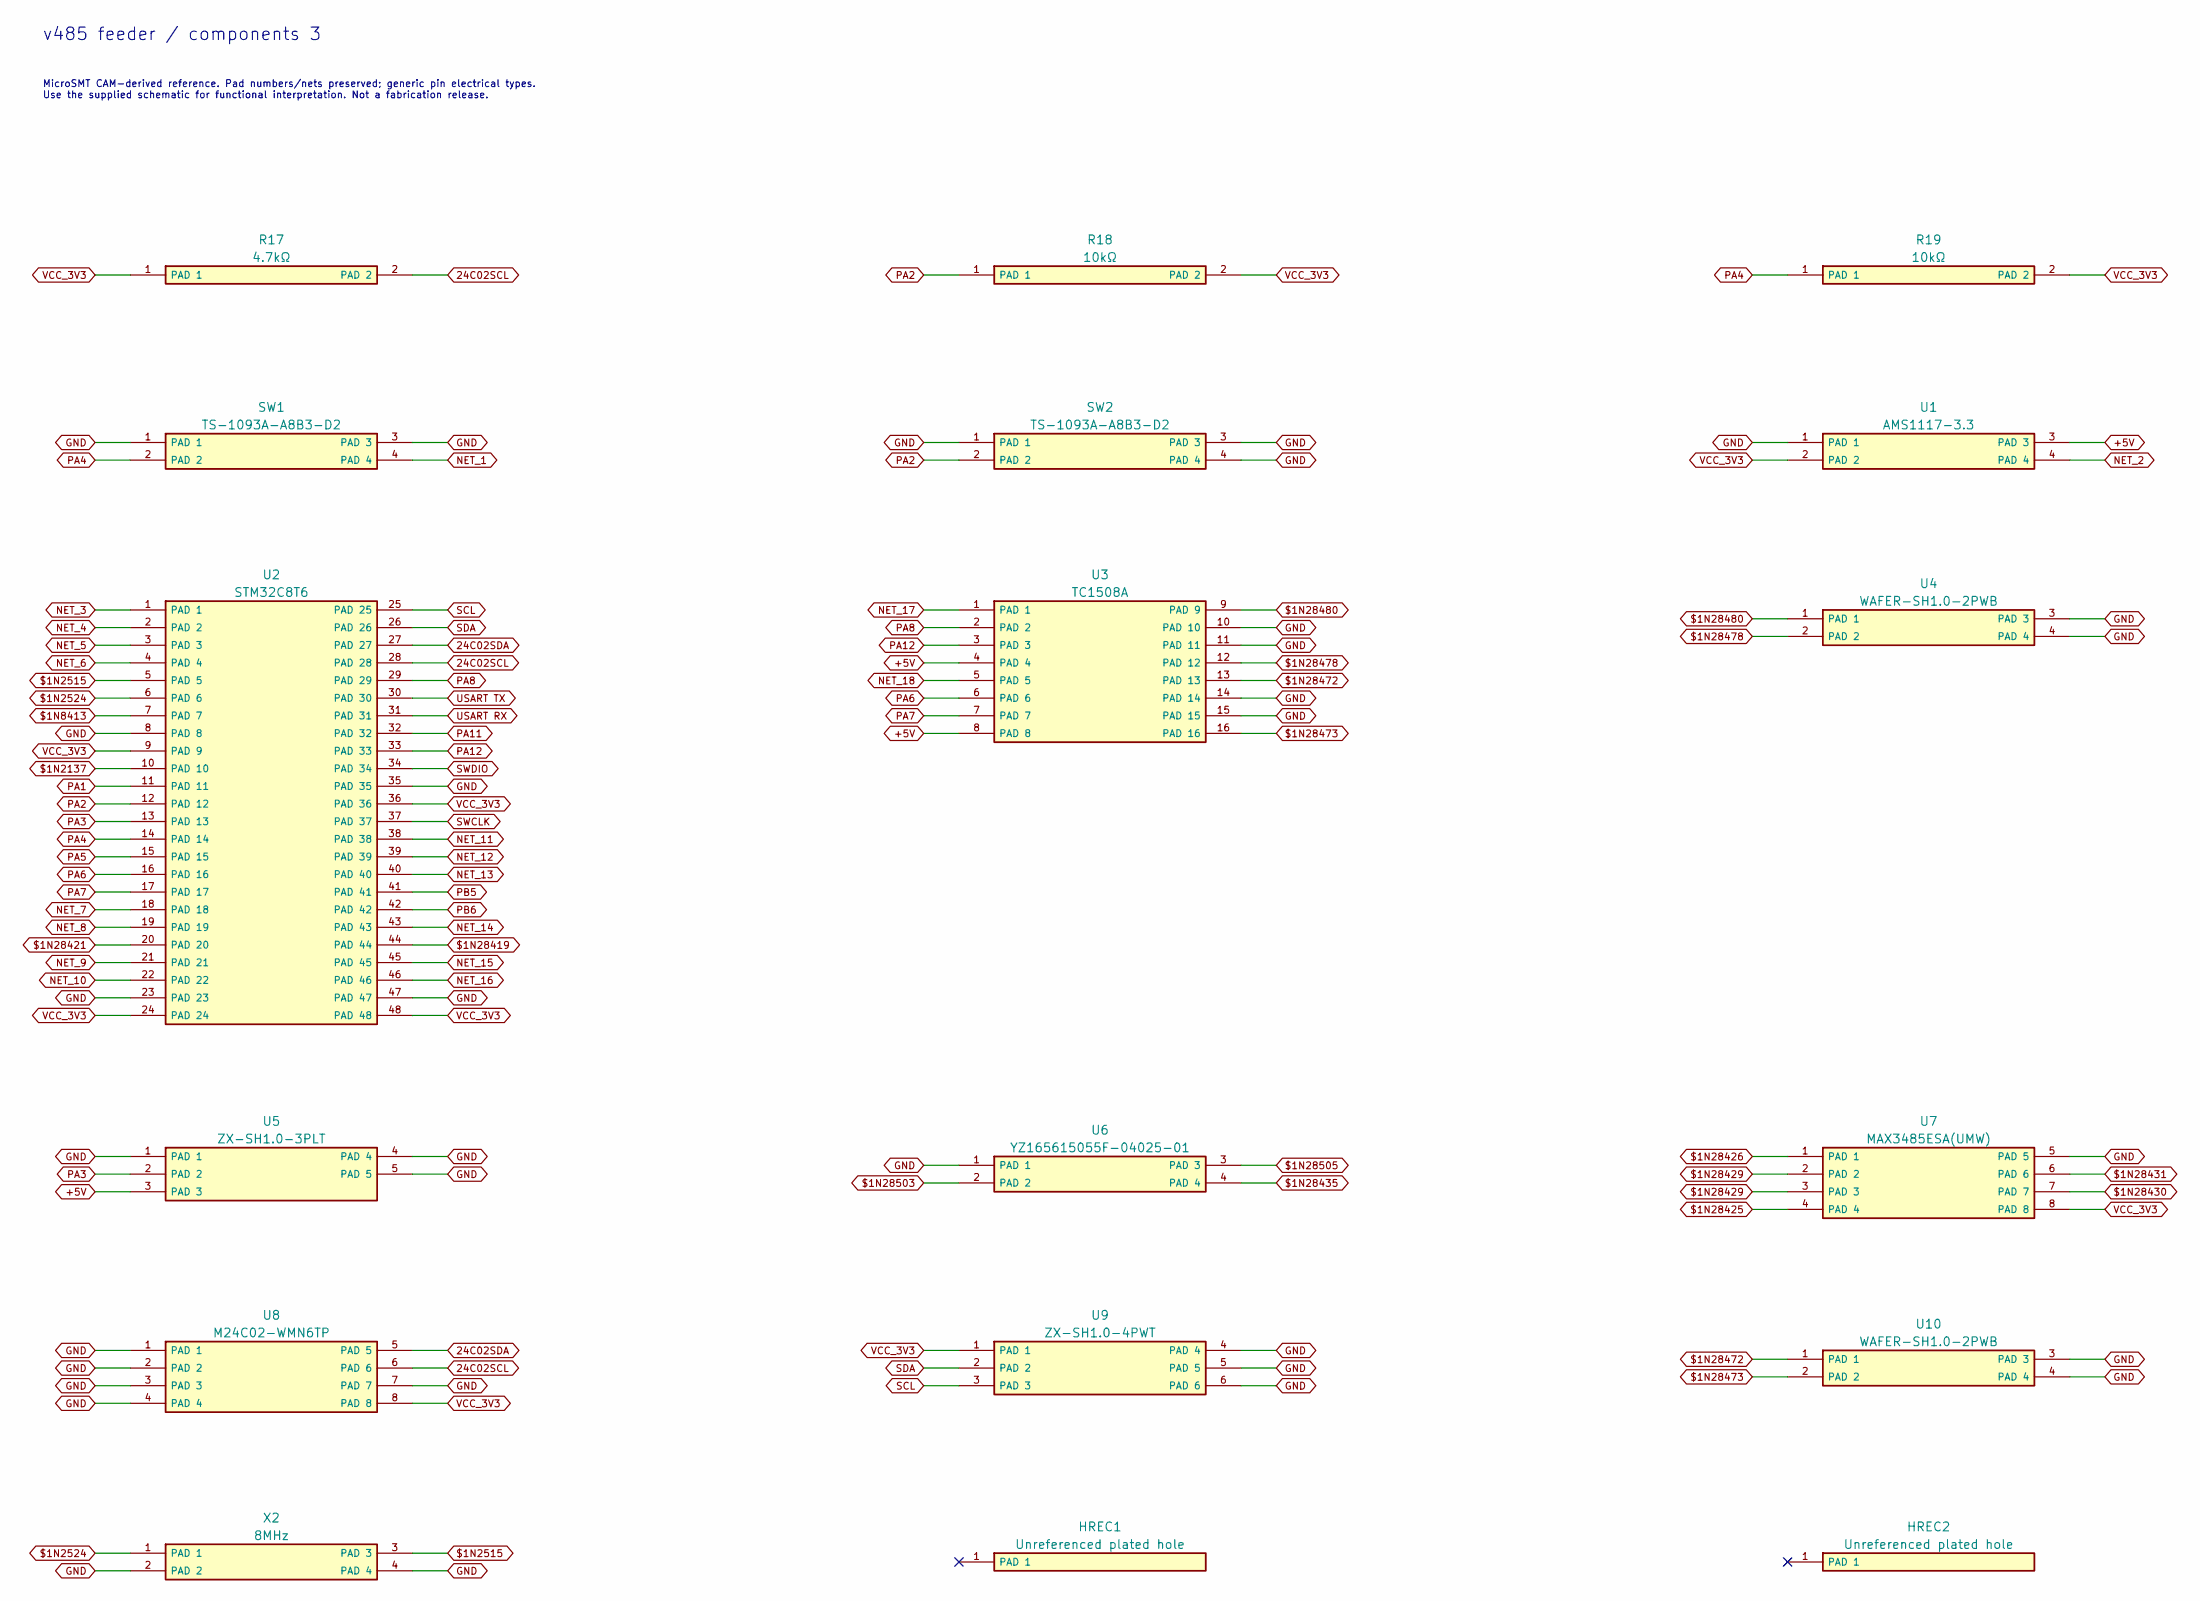
[picture p514: schematic v485_feeder_sheet_03.kicad_sch, v485_feeder / recovered reference]

Parts:
HREC1, HREC2: Unreferenced plated hole; PTH_1_c2bacda513
R17: 4.7kΩ; SMD_2_e7bda1677c
R18, R19: 10kΩ; SMD_2_e7bda1677c
SW1: TS-1093A-A8B3-D2; PTH_4_529d520394
SW2: TS-1093A-A8B3-D2; PTH_4_0f79a45cd4
U1: AMS1117-3.3; SMD_4_f5cc46188f
U2: STM32C8T6; SMD_48_b763d509fc
U3: TC1508A; SMD_16_ae7b02a39a
U4, U10: WAFER-SH1.0-2PWB; SMD_4_b0873716d4
U5: ZX-SH1.0-3PLT; SMD_5_2fbf7feada
U6: YZ165615055F-04025-01; SMD_4_36f36c5f38
U7: MAX3485ESA(UMW); SMD_8_e650e10851
U8: M24C02-WMN6TP; SMD_8_b02c488225
U9: ZX-SH1.0-4PWT; SMD_6_3f199f6944
X2: 8MHz; SMD_4_905bc3d9e5

Connections:
24C02SCL: R17.2 (PAD 2), U2.28 (PAD 28), U8.6 (PAD 6)
24C02SDA: U2.27 (PAD 27), U8.5 (PAD 5); also elsewhere on the board
$1N2137: U2.10 (PAD 10)
$1N2515: U2.5 (PAD 5), X2.3 (PAD 3); also elsewhere on the board
$1N2524: U2.6 (PAD 6), X2.1 (PAD 1); also elsewhere on the board
$1N8413: U2.7 (PAD 7); also elsewhere on the board
$1N28419: U2.44 (PAD 44); also elsewhere on the board
$1N28421: U2.20 (PAD 20); also elsewhere on the board
$1N28425: U7.4 (PAD 4); also elsewhere on the board
$1N28426: U7.1 (PAD 1); also elsewhere on the board
$1N28429: U7.2 (PAD 2), U7.3 (PAD 3); also elsewhere on the board
$1N28430: U7.7 (PAD 7); also elsewhere on the board
$1N28431: U7.6 (PAD 6); also elsewhere on the board
$1N28435: U6.4 (PAD 4); also elsewhere on the board
$1N28472: U3.13 (PAD 13), U10.1 (PAD 1); also elsewhere on the board
$1N28473: U3.16 (PAD 16), U10.2 (PAD 2); also elsewhere on the board
$1N28478: U3.12 (PAD 12), U4.2 (PAD 2); also elsewhere on the board
$1N28480: U3.9 (PAD 9), U4.1 (PAD 1); also elsewhere on the board
$1N28503: U6.2 (PAD 2); also elsewhere on the board
$1N28505: U6.3 (PAD 3); also elsewhere on the board
+5V: U1.3 (PAD 3), U3.4 (PAD 4), U3.8 (PAD 8), U5.3 (PAD 3); also elsewhere on the board
GND: SW1.1 (PAD 1), SW1.3 (PAD 3), SW2.1 (PAD 1), SW2.3 (PAD 3), SW2.4 (PAD 4), U1.1 (PAD 1), U2.8 (PAD 8), U2.23 (PAD 23), U2.35 (PAD 35), U2.47 (PAD 47), U3.10 (PAD 10), U3.11 (PAD 11), U3.14 (PAD 14), U3.15 (PAD 15), U4.3 (PAD 3), U4.4 (PAD 4), U5.1 (PAD 1), U5.4 (PAD 4), U5.5 (PAD 5), U6.1 (PAD 1), U7.5 (PAD 5), U8.1 (PAD 1), U8.2 (PAD 2), U8.3 (PAD 3), U8.4 (PAD 4), U8.7 (PAD 7), U9.4 (PAD 4), U9.5 (PAD 5), U9.6 (PAD 6), U10.3 (PAD 3), U10.4 (PAD 4), X2.2 (PAD 2), X2.4 (PAD 4); also elsewhere on the board
NET_1: SW1.4 (PAD 4)
NET_2: U1.4 (PAD 4)
NET_3: U2.1 (PAD 1)
NET_4: U2.2 (PAD 2)
NET_5: U2.3 (PAD 3)
NET_6: U2.4 (PAD 4)
NET_7: U2.18 (PAD 18)
NET_8: U2.19 (PAD 19)
NET_9: U2.21 (PAD 21)
NET_10: U2.22 (PAD 22)
NET_11: U2.38 (PAD 38)
NET_12: U2.39 (PAD 39)
NET_13: U2.40 (PAD 40)
NET_14: U2.43 (PAD 43)
NET_15: U2.45 (PAD 45)
NET_16: U2.46 (PAD 46)
NET_17: U3.1 (PAD 1)
NET_18: U3.5 (PAD 5)
PA1: U2.11 (PAD 11); also elsewhere on the board
PA2: R18.1 (PAD 1), SW2.2 (PAD 2), U2.12 (PAD 12); also elsewhere on the board
PA3: U2.13 (PAD 13), U5.2 (PAD 2); also elsewhere on the board
PA4: R19.1 (PAD 1), SW1.2 (PAD 2), U2.14 (PAD 14); also elsewhere on the board
PA5: U2.15 (PAD 15)
PA6: U2.16 (PAD 16), U3.6 (PAD 6)
PA7: U2.17 (PAD 17), U3.7 (PAD 7)
PA8: U2.29 (PAD 29), U3.2 (PAD 2)
PA11: U2.32 (PAD 32)
PA12: U2.33 (PAD 33), U3.3 (PAD 3)
PB5: U2.41 (PAD 41); also elsewhere on the board
PB6: U2.42 (PAD 42); also elsewhere on the board
SCL: U2.25 (PAD 25), U9.3 (PAD 3); also elsewhere on the board
SDA: U2.26 (PAD 26), U9.2 (PAD 2); also elsewhere on the board
SWCLK: U2.37 (PAD 37); also elsewhere on the board
SWDIO: U2.34 (PAD 34); also elsewhere on the board
USART RX: U2.31 (PAD 31); also elsewhere on the board
USART TX: U2.30 (PAD 30); also elsewhere on the board
VCC_3V3: R17.1 (PAD 1), R18.2 (PAD 2), R19.2 (PAD 2), U1.2 (PAD 2), U2.9 (PAD 9), U2.24 (PAD 24), U2.36 (PAD 36), U2.48 (PAD 48), U7.8 (PAD 8), U8.8 (PAD 8), U9.1 (PAD 1); also elsewhere on the board

Notes on the sheet:
v485 feeder / components 3
MicroSMT CAM-derived reference. Pad numbers/nets preserved; generic pin electrical types. Use the supplied schematic for functional interpretation. Not a fabrication release.

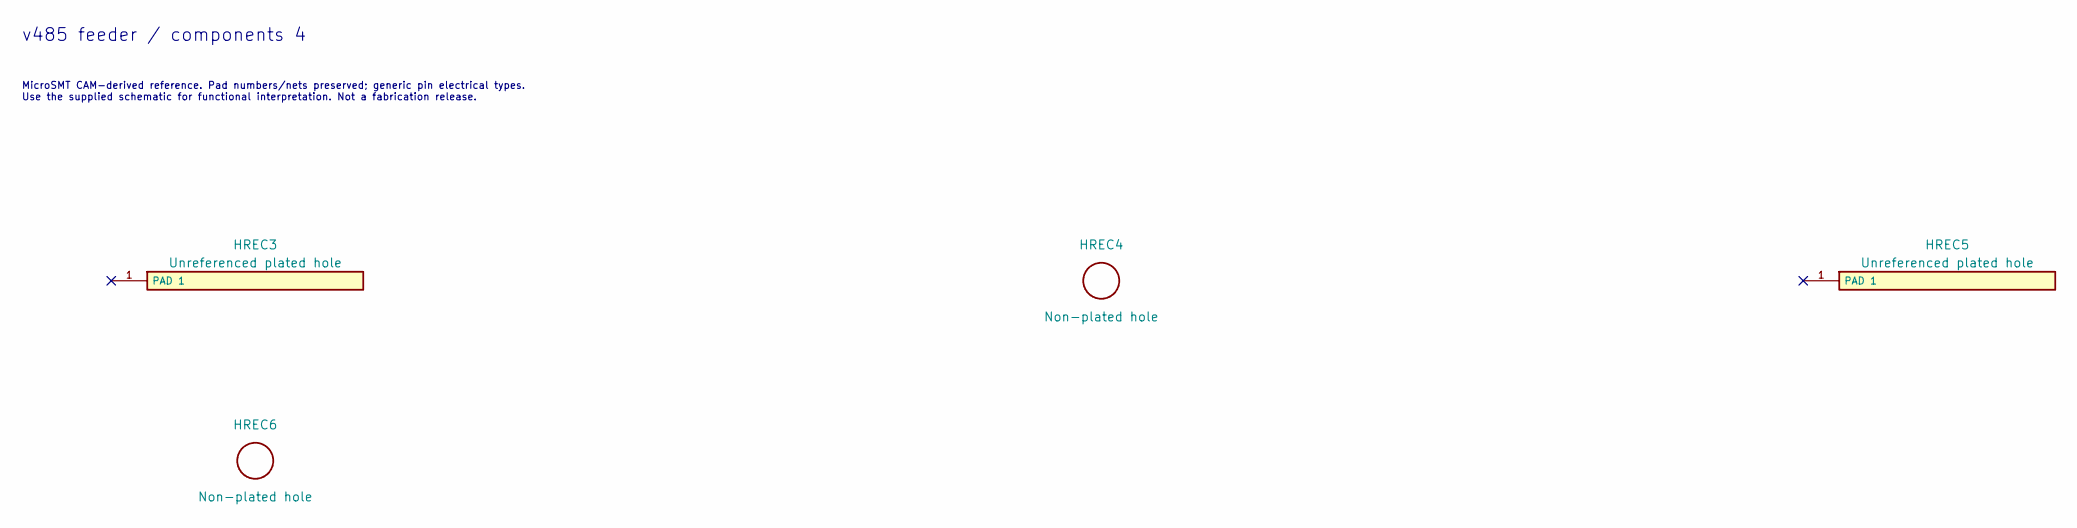
[picture p515: schematic v485_feeder_sheet_04.kicad_sch, v485_feeder / recovered reference]

Parts:
HREC3, HREC5: Unreferenced plated hole; PTH_1_c2bacda513
HREC4, HREC6: Non-plated hole; PTH_1_d65fec3626

Notes on the sheet:
v485 feeder / components 4
MicroSMT CAM-derived reference. Pad numbers/nets preserved; generic pin electrical types. Use the supplied schematic for functional interpretation. Not a fabrication release.

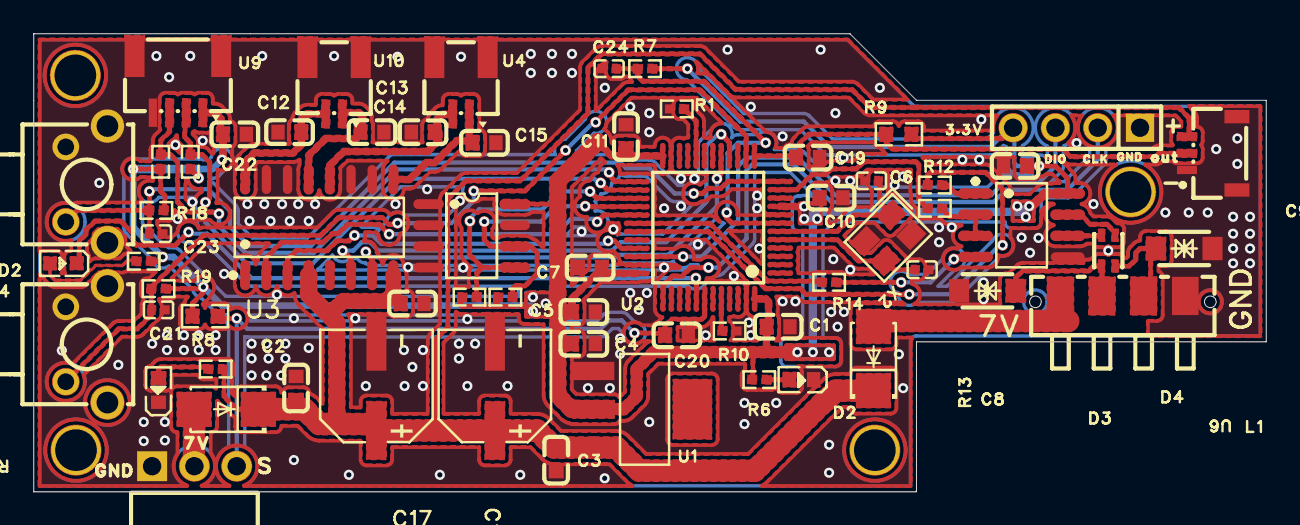
[picture p516: board v485_feeder.kicad_pcb from above]

Board: 2 copper layers, 74.0 x 27.5 mm, 70 parts (0 on the bottom side), 42 nets.
