gabrielyoung92/gabs_microSMT_PickAndPlace/Bing-feeder/V485-Feeder Controller/PCB_ControlBoard/KiCad/v485_controller.kicad_pcb

## KiCad design Bing-feeder/V485-Feeder Controller/PCB_ControlBoard/KiCad/v485_controller.kicad_pcb (2026-10-20)

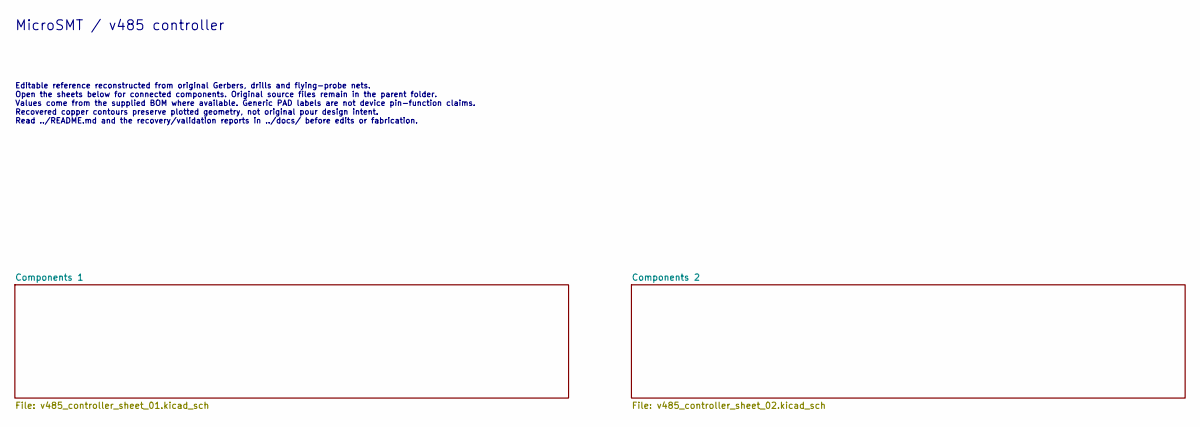
[picture p517: schematic v485_controller.kicad_sch, v485_controller / MicroSMT recovered reference]

Notes on the sheet:
MicroSMT / v485 controller
Editable reference reconstructed from original Gerbers, drills and flying-probe nets. Open the sheets below for connected components. Original source files remain in the parent folder. Values come from the supplied BOM where available. Generic PAD labels are not device pin-function claims. Recovere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

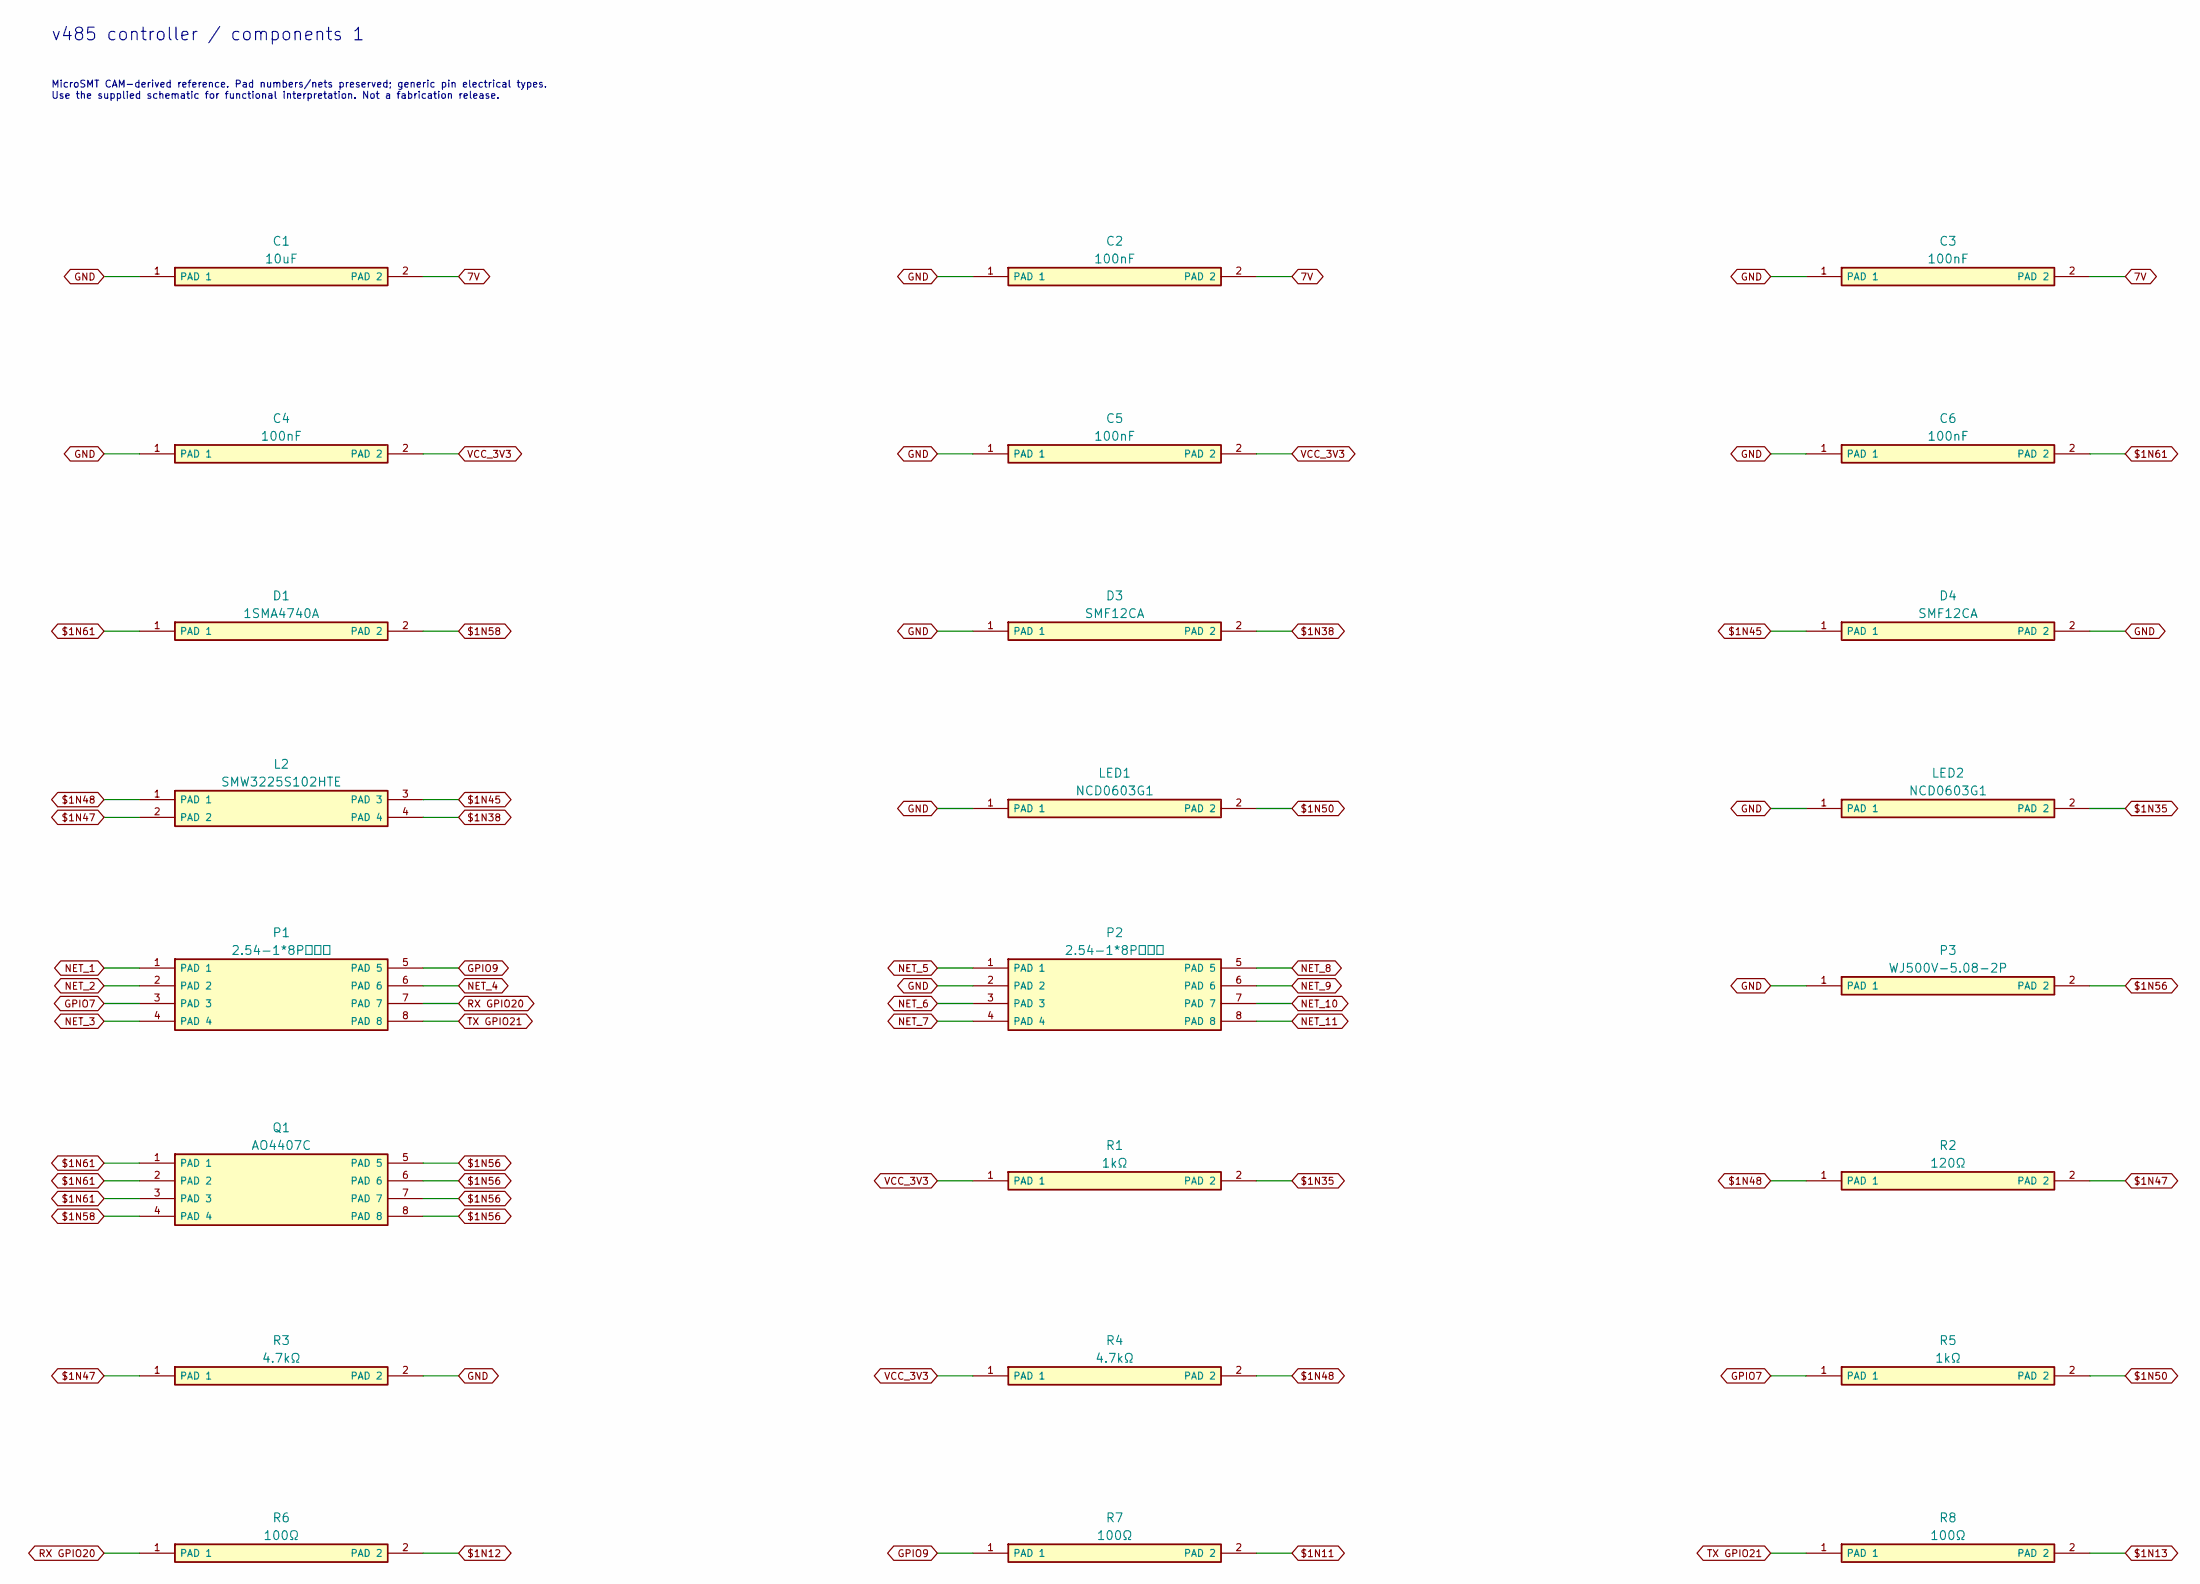
[picture p518: schematic v485_controller_sheet_01.kicad_sch, v485_controller / recovered reference]

Parts:
C1: 10uF; SMD_2_7371bf4a95
C2, C6: 100nF; SMD_2_723c4baacf
C3, C4: 100nF; SMD_2_7371bf4a95
C5: 100nF; SMD_2_c1a3413776
D1: 1SMA4740A; SMD_2_1fa9734501
D3, D4: SMF12CA; SMD_2_55f911f37a
L2: SMW3225S102HTE; SMD_4_008e72132e
LED1: NCD0603G1; SMD_2_aee0334fb4
LED2: NCD0603G1; SMD_2_7119c32529
P1: 2.54-1*8P母环保; PTH_8_ac2e14a8f3
P2: 2.54-1*8P母环保; PTH_8_7aeb1c419b
P3: WJ500V-5.08-2P; PTH_2_e96cc44099
Q1: AO4407C; SMD_8_0b8baf6ad0
R1: 1kΩ; SMD_2_cc916b3528
R2: 120Ω; SMD_2_a7994fb989
R3, R4: 4.7kΩ; SMD_2_a7994fb989
R5: 1kΩ; SMD_2_04577a26f8
R6: 100Ω; SMD_2_cc916b3528
R7, R8: 100Ω; SMD_2_fef7677169

Connections:
7V: C1.2 (PAD 2), C2.2 (PAD 2), C3.2 (PAD 2); also elsewhere on the board
$1N11: R7.2 (PAD 2); also elsewhere on the board
$1N12: R6.2 (PAD 2); also elsewhere on the board
$1N13: R8.2 (PAD 2); also elsewhere on the board
$1N35: LED2.2 (PAD 2), R1.2 (PAD 2)
$1N38: D3.2 (PAD 2), L2.4 (PAD 4); also elsewhere on the board
$1N45: D4.1 (PAD 1), L2.3 (PAD 3); also elsewhere on the board
$1N47: L2.2 (PAD 2), R2.2 (PAD 2), R3.1 (PAD 1); also elsewhere on the board
$1N48: L2.1 (PAD 1), R2.1 (PAD 1), R4.2 (PAD 2); also elsewhere on the board
$1N50: LED1.2 (PAD 2), R5.2 (PAD 2)
$1N56: P3.2 (PAD 2), Q1.5 (PAD 5), Q1.6 (PAD 6), Q1.7 (PAD 7), Q1.8 (PAD 8)
$1N58: D1.2 (PAD 2), Q1.4 (PAD 4); also elsewhere on the board
$1N61: C6.2 (PAD 2), D1.1 (PAD 1), Q1.1 (PAD 1), Q1.2 (PAD 2), Q1.3 (PAD 3); also elsewhere on the board
GND: C1.1 (PAD 1), C2.1 (PAD 1), C3.1 (PAD 1), C4.1 (PAD 1), C5.1 (PAD 1), C6.1 (PAD 1), D3.1 (PAD 1), D4.2 (PAD 2), LED1.1 (PAD 1), LED2.1 (PAD 1), P2.2 (PAD 2), P3.1 (PAD 1), R3.2 (PAD 2); also elsewhere on the board
GPIO7: P1.3 (PAD 3), R5.1 (PAD 1)
GPIO9: P1.5 (PAD 5), R7.1 (PAD 1)
NET_1: P1.1 (PAD 1)
NET_2: P1.2 (PAD 2)
NET_3: P1.4 (PAD 4)
NET_4: P1.6 (PAD 6)
NET_5: P2.1 (PAD 1)
NET_6: P2.3 (PAD 3)
NET_7: P2.4 (PAD 4)
NET_8: P2.5 (PAD 5)
NET_9: P2.6 (PAD 6)
NET_10: P2.7 (PAD 7)
NET_11: P2.8 (PAD 8)
RX GPIO20: P1.7 (PAD 7), R6.1 (PAD 1)
TX GPIO21: P1.8 (PAD 8), R8.1 (PAD 1)
VCC_3V3: C4.2 (PAD 2), C5.2 (PAD 2), R1.1 (PAD 1), R4.1 (PAD 1); also elsewhere on the board

Notes on the sheet:
v485 controller / components 1
MicroSMT CAM-derived reference. Pad numbers/nets preserved; generic pin electrical types. Use the supplied schematic for functional interpretation. Not a fabrication release.
