gabrielyoung92/gabs_microSMT_PickAndPlace/Bing-feeder/V485-Feeder Controller/PCB_ControlBoard/KiCad/v485_controller.kicad_pcb

## KiCad design Bing-feeder/V485-Feeder Controller/PCB_ControlBoard/KiCad/v485_controller.kicad_pcb (continued)

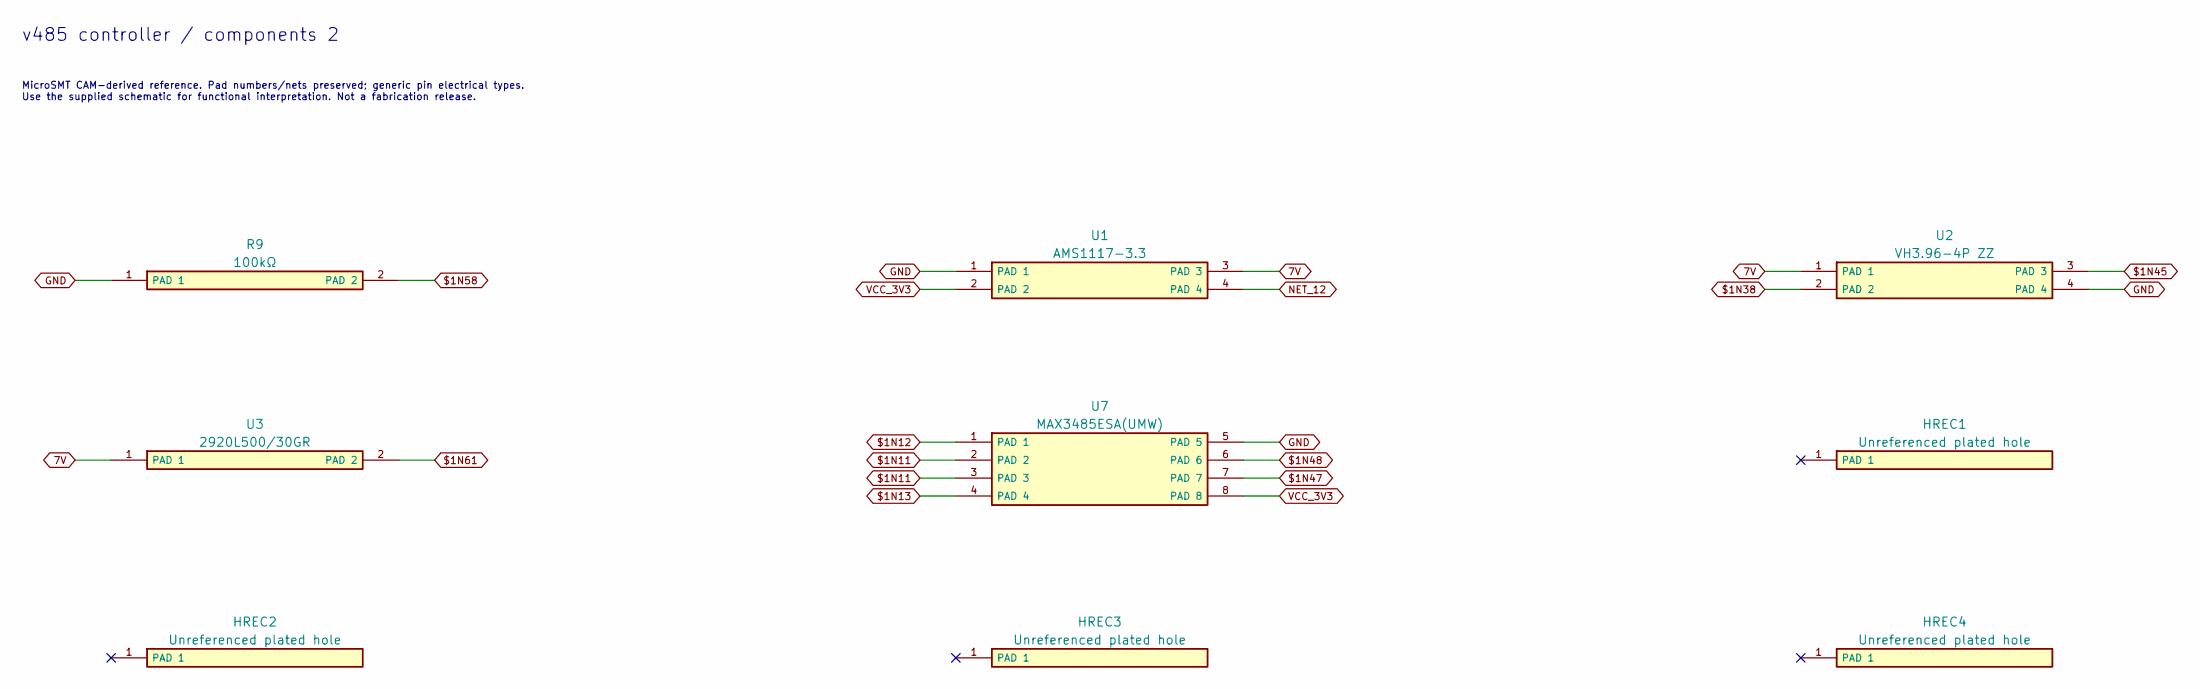
[picture p519: schematic v485_controller_sheet_02.kicad_sch, v485_controller / recovered reference]

Parts:
HREC1, HREC2, HREC3, HREC4: Unreferenced plated hole; PTH_1_ee2b9368a9
R9: 100kΩ; SMD_2_cc916b3528
U1: AMS1117-3.3; SMD_4_f5cc46188f
U2: VH3.96-4P ZZ; PTH_4_101e17f868
U3: 2920L500/30GR; SMD_2_74179e062f
U7: MAX3485ESA(UMW); SMD_8_f52f094fb5

Connections:
7V: U1.3 (PAD 3), U2.1 (PAD 1), U3.1 (PAD 1); also elsewhere on the board
$1N11: U7.2 (PAD 2), U7.3 (PAD 3); also elsewhere on the board
$1N12: U7.1 (PAD 1); also elsewhere on the board
$1N13: U7.4 (PAD 4); also elsewhere on the board
$1N38: U2.2 (PAD 2); also elsewhere on the board
$1N45: U2.3 (PAD 3); also elsewhere on the board
$1N47: U7.7 (PAD 7); also elsewhere on the board
$1N48: U7.6 (PAD 6); also elsewhere on the board
$1N58: R9.2 (PAD 2); also elsewhere on the board
$1N61: U3.2 (PAD 2); also elsewhere on the board
GND: R9.1 (PAD 1), U1.1 (PAD 1), U2.4 (PAD 4), U7.5 (PAD 5); also elsewhere on the board
NET_12: U1.4 (PAD 4)
VCC_3V3: U1.2 (PAD 2), U7.8 (PAD 8); also elsewhere on the board

Notes on the sheet:
v485 controller / components 2
MicroSMT CAM-derived reference. Pad numbers/nets preserved; generic pin electrical types. Use the supplied schematic for functional interpretation. Not a fabrication release.

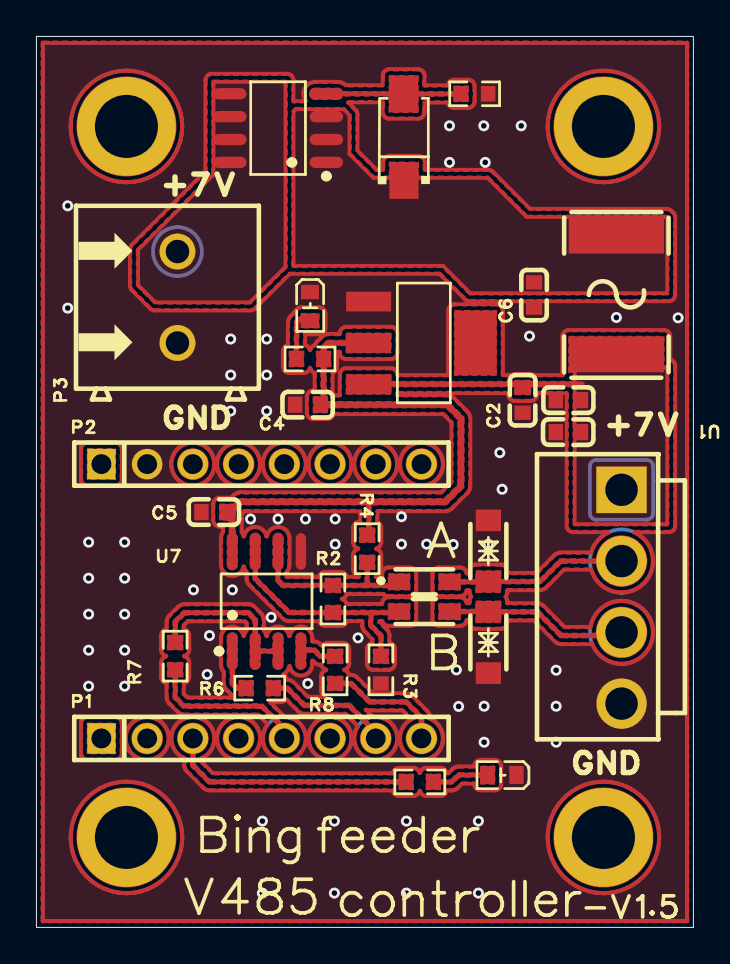
[picture p520: board v485_controller.kicad_pcb from above]

Board: 2 copper layers, 36.5 x 49.5 mm, 33 parts (0 on the bottom side), 19 nets.
