gabrielyoung92/gabs_microSMT_PickAndPlace/Bing-feeder/V485-Feeder Controller/PCB_busbar_short_180mm/KiCad/v485_busbar_180mm_pcb1.kicad_pcb

## KiCad design Bing-feeder/V485-Feeder Controller/PCB_busbar_short_180mm/KiCad/v485_busbar_180mm_pcb1.kicad_pcb (2026-10-20)

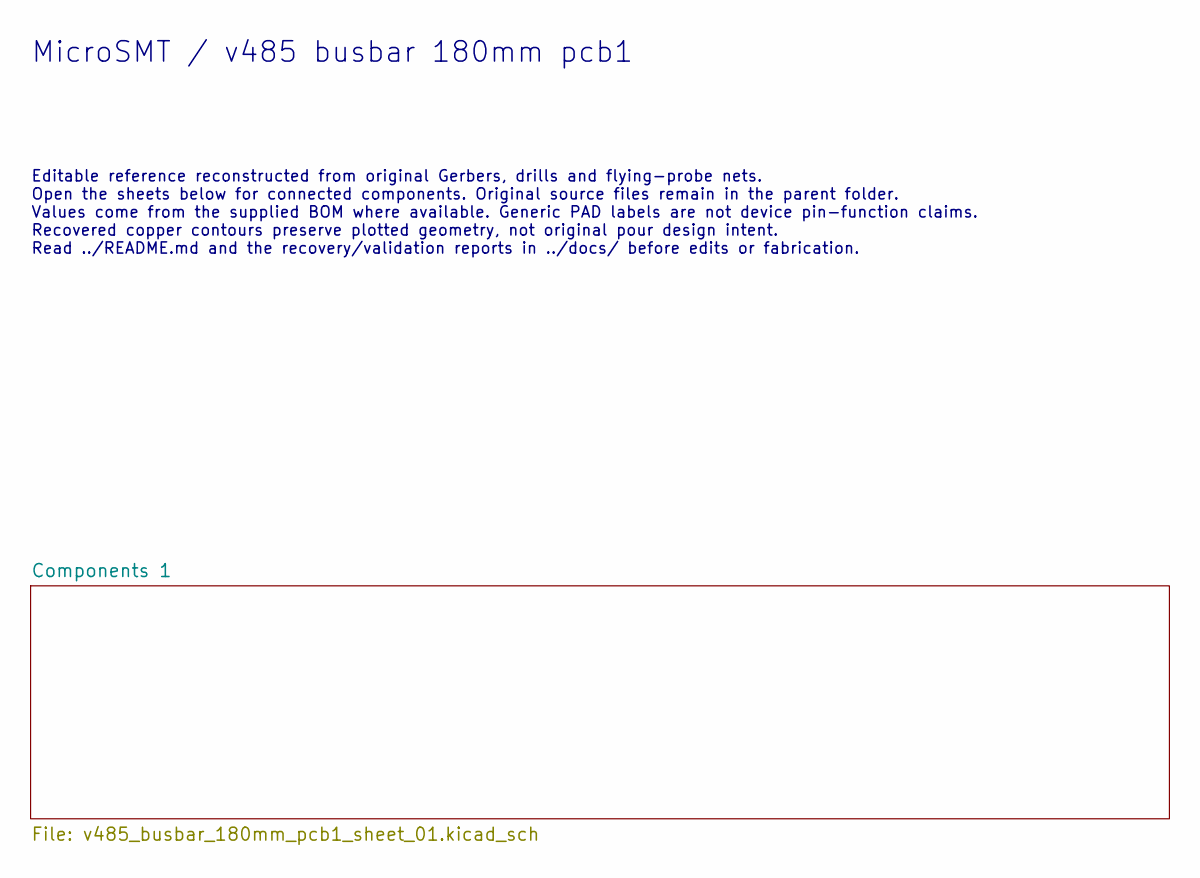
[picture p521: schematic v485_busbar_180mm_pcb1.kicad_sch, v485_busbar_180mm_pcb1 / MicroSMT recovered reference]

Notes on the sheet:
MicroSMT / v485 busbar 180mm pcb1
Editable reference reconstructed from original Gerbers, drills and flying-probe nets. Open the sheets below for connected components. Original source files remain in the parent folder. Values come from the supplied BOM where available. Generic PAD labels are not device pin-function claims. Recovere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

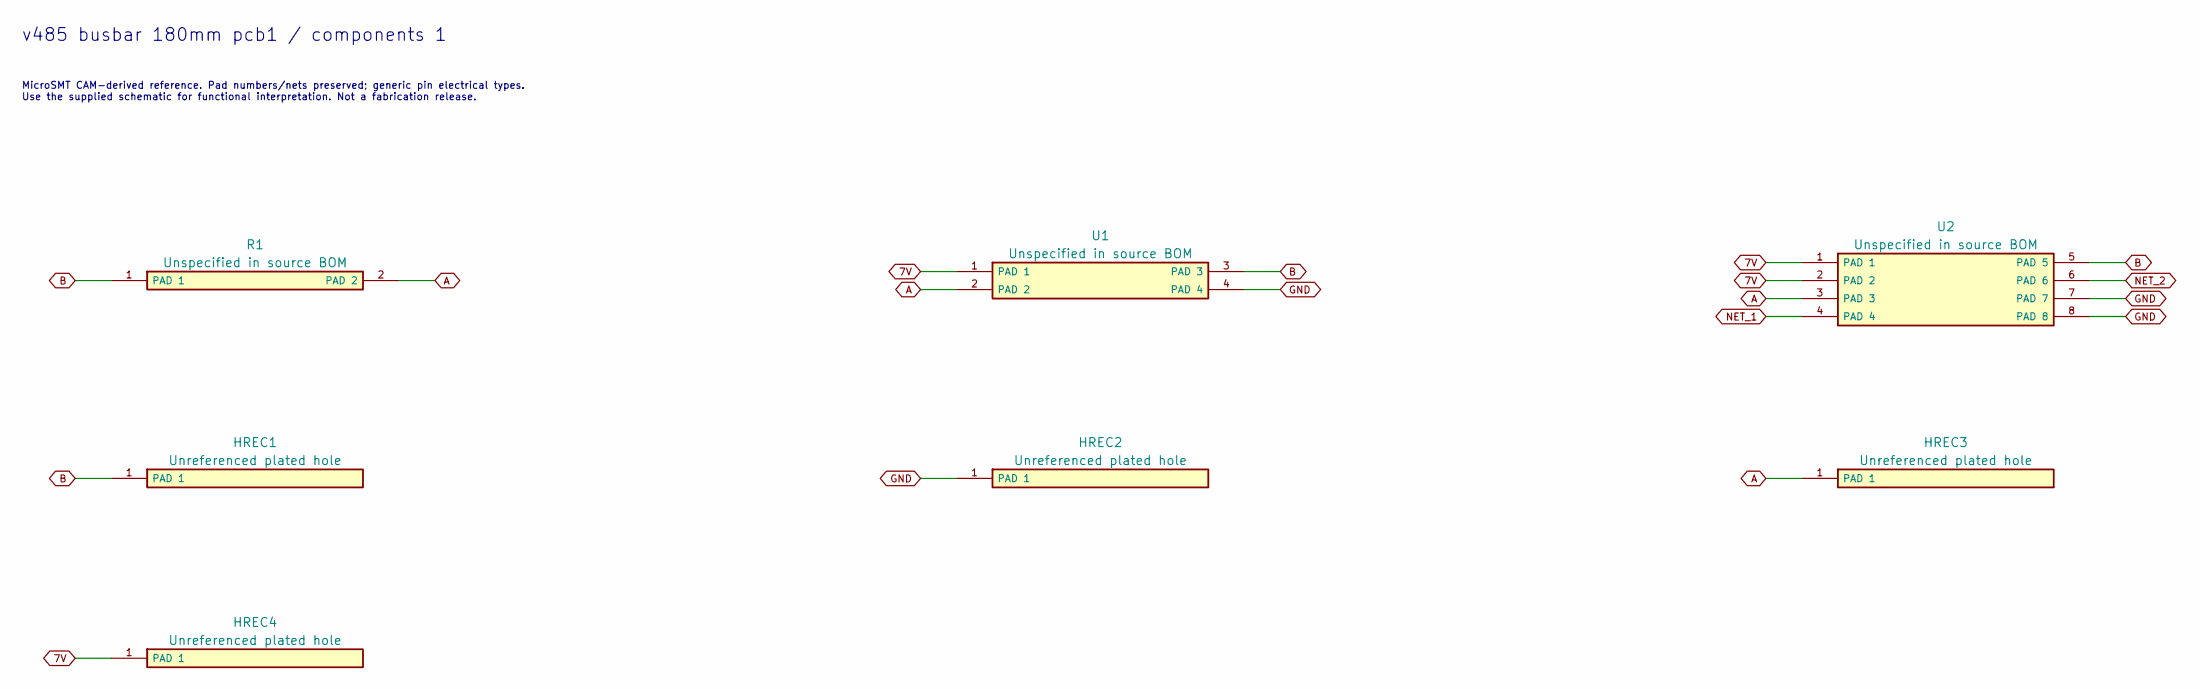
[picture p522: schematic v485_busbar_180mm_pcb1_sheet_01.kicad_sch, v485_busbar_180mm_pcb1 / recovered reference]

Parts:
HREC1, HREC2, HREC3, HREC4: Unreferenced plated hole; PTH_1_d32e30a0ea
R1: Unspecified in source BOM; SMD_2_fef7677169
U1: Unspecified in source BOM; PTH_4_06e8961db4
U2: Unspecified in source BOM; SMD_8_a8244cd5c0

Connections:
7V: HREC4.1, U1.1 (PAD 1), U2.1 (PAD 1), U2.2 (PAD 2)
A: HREC3.1, R1.2 (PAD 2), U1.2 (PAD 2), U2.3 (PAD 3)
B: HREC1.1, R1.1 (PAD 1), U1.3 (PAD 3), U2.5 (PAD 5)
GND: HREC2.1, U1.4 (PAD 4), U2.7 (PAD 7), U2.8 (PAD 8)
NET_1: U2.4 (PAD 4)
NET_2: U2.6 (PAD 6)

Notes on the sheet:
v485 busbar 180mm pcb1 / components 1
MicroSMT CAM-derived reference. Pad numbers/nets preserved; generic pin electrical types. Use the supplied schematic for functional interpretation. Not a fabrication release.

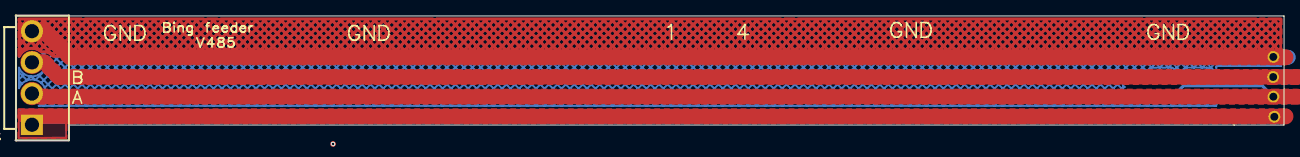
[picture p523: board v485_busbar_180mm_pcb1.kicad_pcb from above]

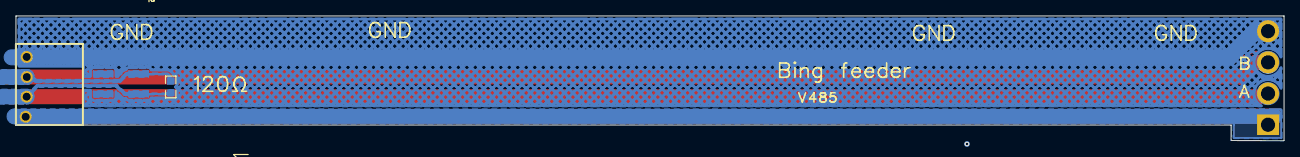
[picture p524: board v485_busbar_180mm_pcb1.kicad_pcb from below]

Board: 2 copper layers, 161.0 x 15.8 mm, 7 parts (2 on the bottom side), 4 nets.
