gabrielyoung92/gabs_microSMT_PickAndPlace/Bing-feeder/V485-feeder/PCB_display/KiCad/v485_display.kicad_pcb

## KiCad design Bing-feeder/V485-feeder/PCB_display/KiCad/v485_display.kicad_pcb (2026-10-20)

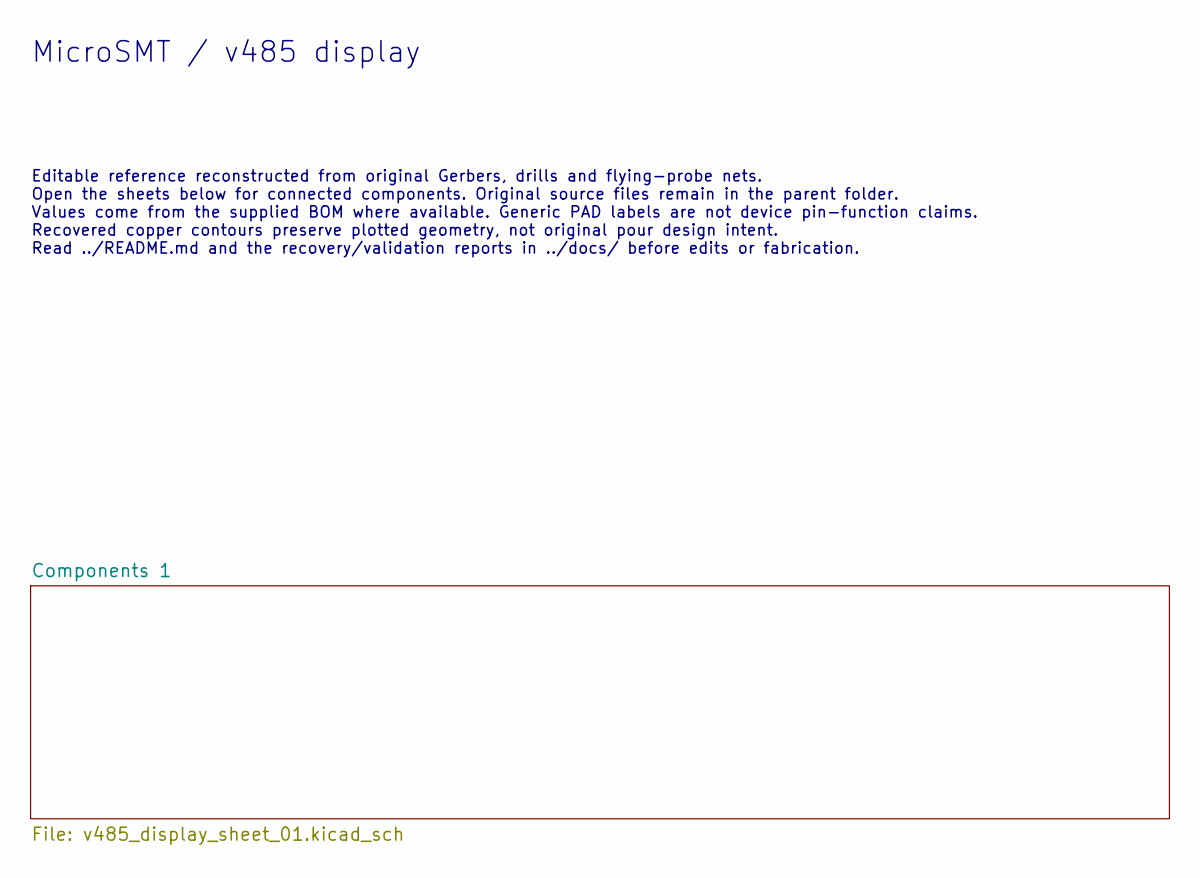
[picture p525: schematic v485_display.kicad_sch, v485_display / MicroSMT recovered reference]

Notes on the sheet:
MicroSMT / v485 display
Editable reference reconstructed from original Gerbers, drills and flying-probe nets. Open the sheets below for connected components. Original source files remain in the parent folder. Values come from the supplied BOM where available. Generic PAD labels are not device pin-function claims. Recovere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

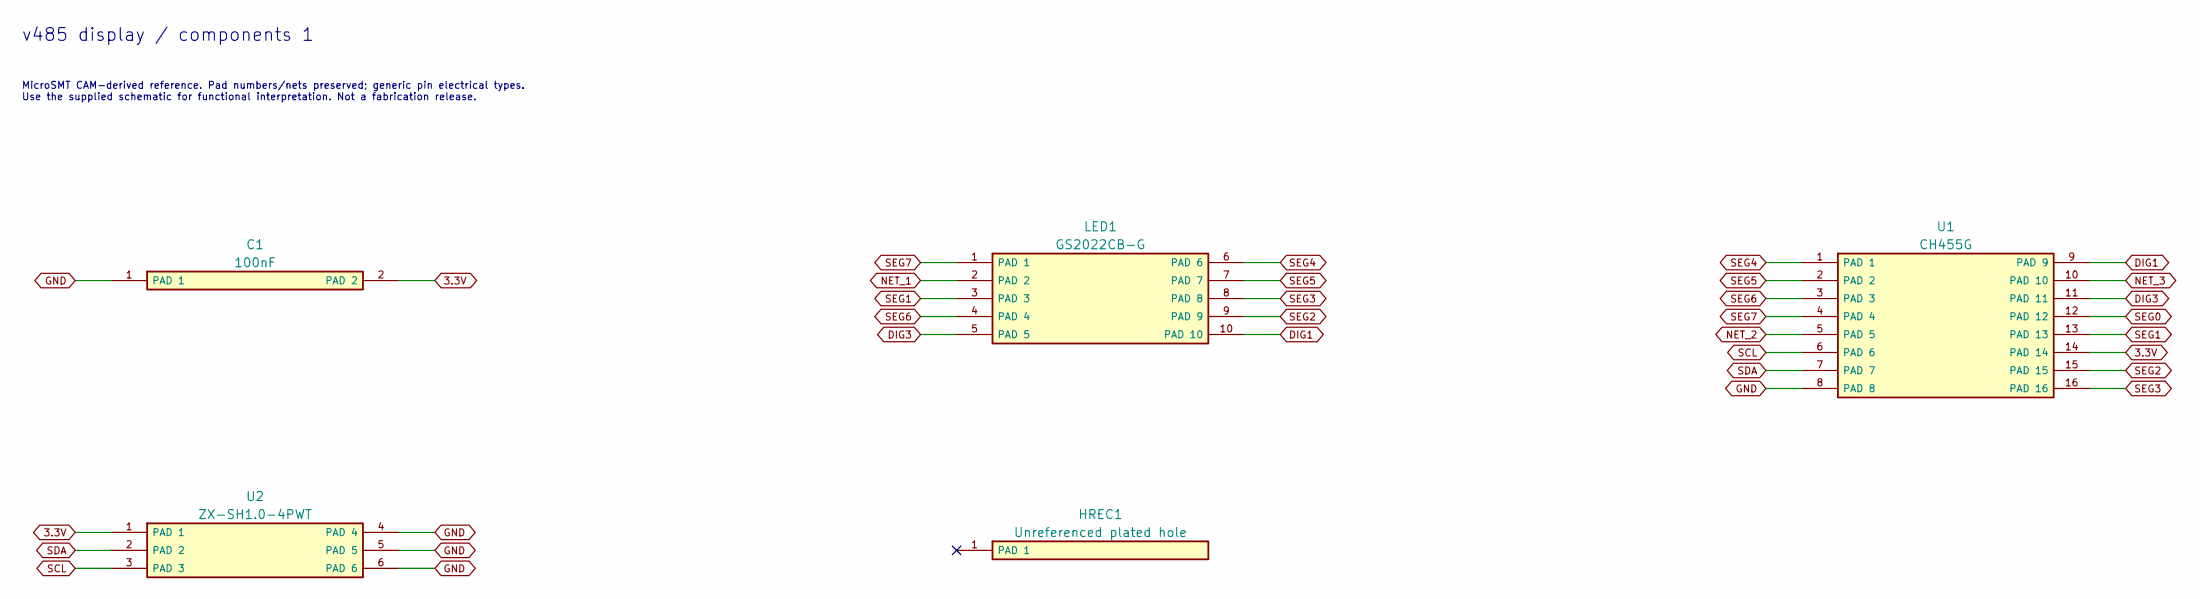
[picture p526: schematic v485_display_sheet_01.kicad_sch, v485_display / recovered reference]

Parts:
C1: 100nF; SMD_2_bdaf68bf10
HREC1: Unreferenced plated hole; PTH_1_abea3bc72b
LED1: GS2022CB-G; SMD_10_20c6b414ba
U1: CH455G; SMD_16_61719ae6d4
U2: ZX-SH1.0-4PWT; SMD_6_bf757f6bd6

Connections:
3.3V: C1.2 (PAD 2), U1.14 (PAD 14), U2.1 (PAD 1)
DIG1: LED1.10 (PAD 10), U1.9 (PAD 9)
DIG3: LED1.5 (PAD 5), U1.11 (PAD 11)
GND: C1.1 (PAD 1), U1.8 (PAD 8), U2.4 (PAD 4), U2.5 (PAD 5), U2.6 (PAD 6)
NET_1: LED1.2 (PAD 2)
NET_2: U1.5 (PAD 5)
NET_3: U1.10 (PAD 10)
SCL: U1.6 (PAD 6), U2.3 (PAD 3)
SDA: U1.7 (PAD 7), U2.2 (PAD 2)
SEG0: U1.12 (PAD 12)
SEG1: LED1.3 (PAD 3), U1.13 (PAD 13)
SEG2: LED1.9 (PAD 9), U1.15 (PAD 15)
SEG3: LED1.8 (PAD 8), U1.16 (PAD 16)
SEG4: LED1.6 (PAD 6), U1.1 (PAD 1)
SEG5: LED1.7 (PAD 7), U1.2 (PAD 2)
SEG6: LED1.4 (PAD 4), U1.3 (PAD 3)
SEG7: LED1.1 (PAD 1), U1.4 (PAD 4)

Notes on the sheet:
v485 display / components 1
MicroSMT CAM-derived reference. Pad numbers/nets preserved; generic pin electrical types. Use the supplied schematic for functional interpretation. Not a fabrication release.

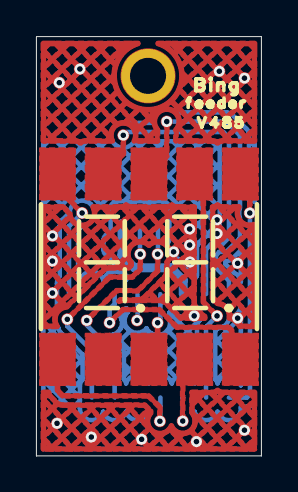
[picture p527: board v485_display.kicad_pcb from above]

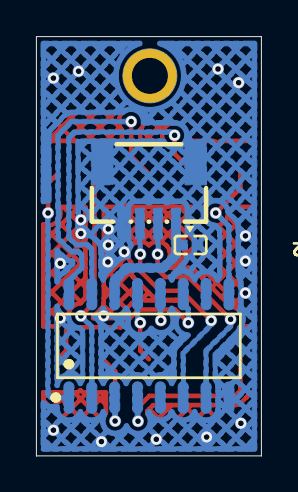
[picture p528: board v485_display.kicad_pcb from below]

Board: 2 copper layers, 12.5 x 23.3 mm, 5 parts (3 on the bottom side), 13 nets.
