gabrielyoung92/gabs_microSMT_PickAndPlace/Bing-feeder/V485-Feeder Controller/PCB_busbar_long_480mm/KiCad/v485_busbar_480mm.kicad_pcb

## KiCad design Bing-feeder/V485-Feeder Controller/PCB_busbar_long_480mm/KiCad/v485_busbar_480mm.kicad_pcb (2026-10-20)

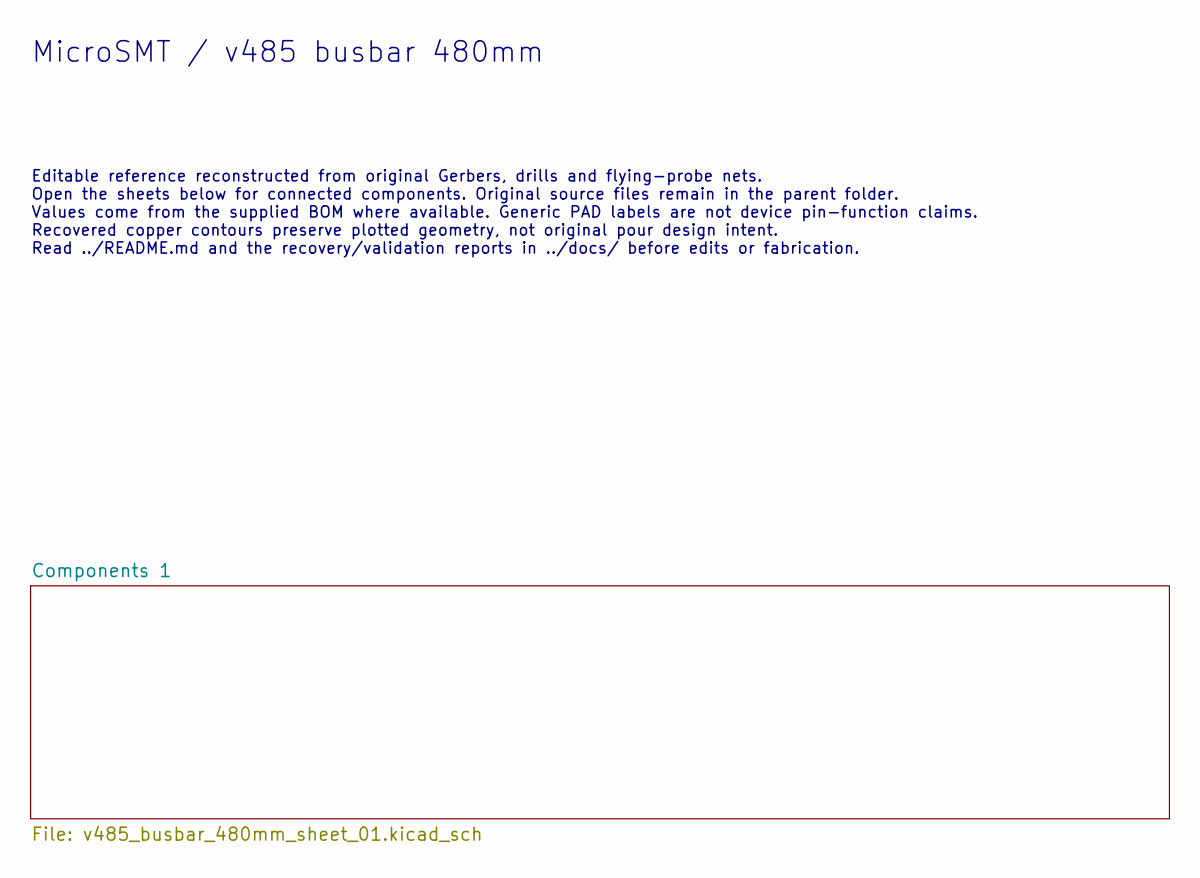
[picture p529: schematic v485_busbar_480mm.kicad_sch, v485_busbar_480mm / MicroSMT recovered reference]

Notes on the sheet:
MicroSMT / v485 busbar 480mm
Editable reference reconstructed from original Gerbers, drills and flying-probe nets. Open the sheets below for connected components. Original source files remain in the parent folder. Values come from the supplied BOM where available. Generic PAD labels are not device pin-function claims. Recovere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

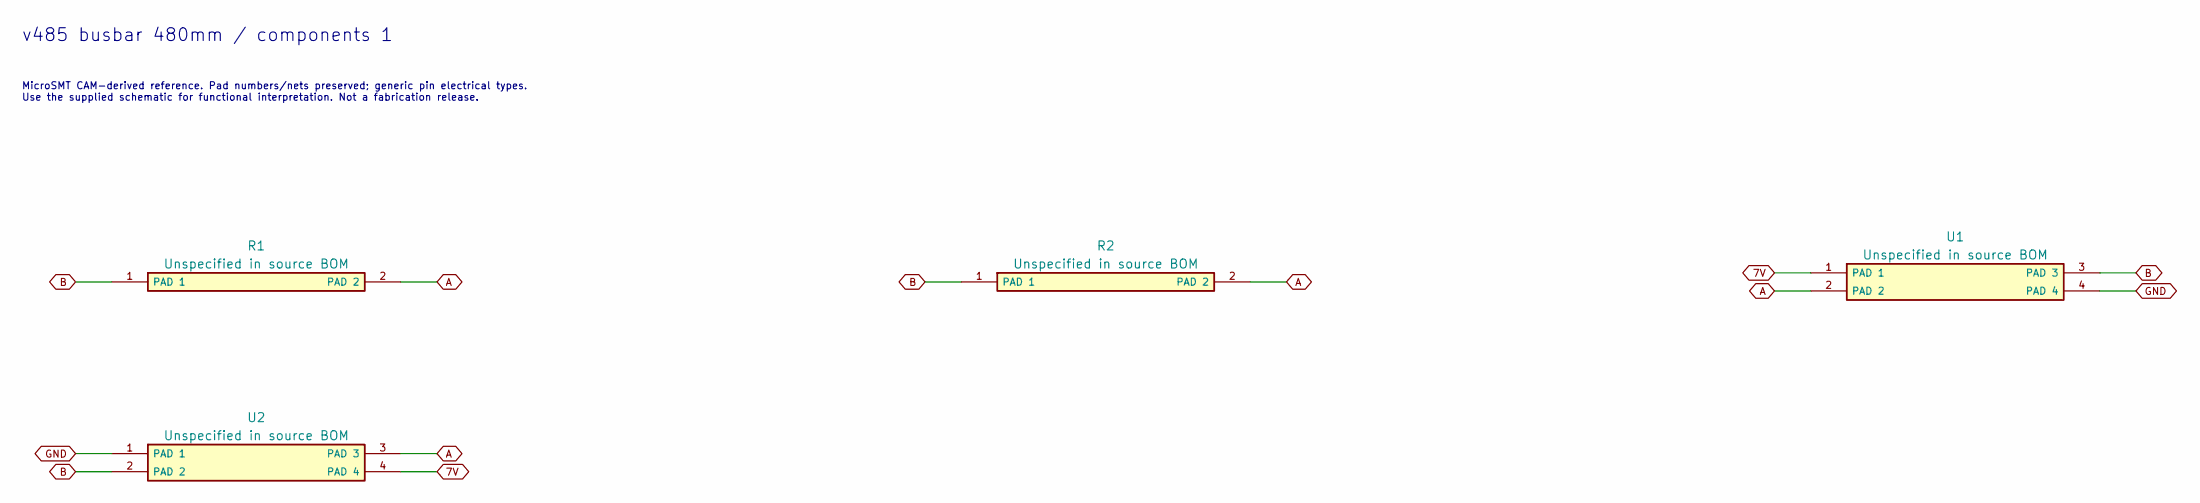
[picture p530: schematic v485_busbar_480mm_sheet_01.kicad_sch, v485_busbar_480mm / recovered reference]

Parts:
R1, R2: Unspecified in source BOM; SMD_2_fef7677169
U1: Unspecified in source BOM; PTH_4_06e8961db4
U2: Unspecified in source BOM; PTH_4_6cc8fbf6c8

Connections:
7V: U1.1 (PAD 1), U2.4 (PAD 4)
A: R1.2 (PAD 2), R2.2 (PAD 2), U1.2 (PAD 2), U2.3 (PAD 3)
B: R1.1 (PAD 1), R2.1 (PAD 1), U1.3 (PAD 3), U2.2 (PAD 2)
GND: U1.4 (PAD 4), U2.1 (PAD 1)

Notes on the sheet:
v485 busbar 480mm / components 1
MicroSMT CAM-derived reference. Pad numbers/nets preserved; generic pin electrical types. Use the supplied schematic for functional interpretation. Not a fabrication release.

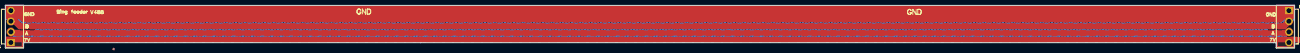
[picture p531: board v485_busbar_480mm.kicad_pcb from above]

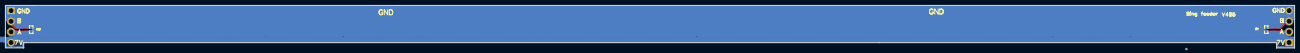
[picture p532: board v485_busbar_480mm.kicad_pcb from below]

Board: 2 copper layers, 480.0 x 15.8 mm, 4 parts (2 on the bottom side), 4 nets.
