gabrielyoung92/gabs_microSMT_PickAndPlace/Microsmt-PNPv3/docs/evidence/controller-2026-10-14/config.txt

# You can refer to how to configure   form  http://smoothieware.org/configuring-smoothie
# Each line cannot exceed 132 letters，“＃”The following contents are all comments

# Basic motion configuration
default_feed_rate                     5000         # Default speed (mm/minute) for G1/G2/G3 moves
default_seek_rate                     5000         # Default speed (mm/minute) for G0 moves
mm_per_arc_segment              0.0            # Fixed length for line segments that divide arcs, 0 to disable
#mm_per_line_segment           5               # Cut lines into segments this size
mm_max_arc_error                  0.01           # The maximum error for line segments that divide arcs 0 to disable
                                                                 # note it is invalid for both the above be 0
                                                                 # if both are used, will use largest segment length based on radius

# Planner module configuration : Look-ahead and acceleration configuration
planner_queue_size                                   48            # DO NOT CHANGE THIS UNLESS YOU KNOW EXACTLY WHAT YOUR ARE DOING
acceleration                                              10000       # Acceleration in mm/second/second.
z_acceleration                                           6000         # Acceleration for Z only moves in mm/s^2, 0 disables it, disabled by default. DO NOT SET ON A DELTA
acceleration_ticks_per_second                   1000       # Number of times per second the speed is updated
junction_deviation                                     0.005       # Similar to the old "max_jerk", in millimeters, see : https://github.com/grbl/grbl/blob/master/planner.c#L409
      
# Stepper module configuration
microseconds_per_step_pulse                    1              # Duration of step pulses to stepper drivers, in microseconds
base_stepping_frequency                          100000     # Base frequency for stepping

# Stepper module pins ( ports, and pin numbers, appending "!" to the number will invert a pin )
# X axis
alpha_steps_per_mm                 80                            # Steps per mm for alpha stepper
alpha_step_pin                          2.0                            # Pin for alpha stepper step signal
alpha_dir_pin                            0.5!                          # Pin for alpha stepper direction
alpha_en_pin                            0.4                             # Pin for alpha enable pin 0.10
# alpha_current                           1.4                             # X stepper motor current	
x_axis_max_speed                     60000                       # mm/min
alpha_max_rate                        60000                        # mm/min actuator max speed	
alpha_acceleration                    6000                         # mm/sec^2

# Y axis
beta_steps_per_mm                  80                              # Steps per mm for beta stepper
beta_step_pin                           2.1                            # Pin for beta stepper step signal
beta_dir_pin                             0.11!                          # Pin for beta stepper direction
beta_en_pin                             0.10                           # Pin for beta enable
# beta_current                            1.8                              # Y stepper motor current	
y_axis_max_speed                     48000                       # mm/min
beta_max_rate                          48000                       # mm/min actuator max speed	
beta_acceleration                     3000                         # mm/sec^2

# Z axis
gamma_steps_per_mm             168                          # Steps per mm for gamma stepper
gamma_step_pin                      2.2                            # Pin for gamma stepper step signal
gamma_dir_pin                         0.20!                         # Pin for gamma stepper direction
gamma_en_pin                         0.19                          # Pin for gamma enable
# gamma_current                        1.6                            # Z stepper motor current	
z_axis_max_speed                     200000                       # mm/min
gamma_max_rate                     200000                       # mm/min actuator max speed	
gamma_acceleration                15000                        # mm/sec^2

# A axis（N1）
delta_steps_per_mm                 17.7777                     # steps per degree
delta_step_pin                          2.3                            # Pin for delta stepper step signal
delta_dir_pin                             0.22                          # Pin for delta stepper direction
delta_en_pin                             0.21                          # Pin for delta enable
# delta_current                            0.4                            # A stepper motor current	
a_axis_max_speed                     200000                       # °/min
delta_max_rate                         200000                       # °/min
delta_acceleration                    10000                       # mm/sec^2

# B axis（N2）
epsilon_steps_per_mm              17.7777                    # steps per mm for epsilon stepper
epsilon_step_pin                       2.8                           # Pin for delta stepper step signal
epsilon_dir_pin                         2.13                          # Pin for delta stepper direction
epsilon_en_pin                         4.29                          # Pin for delta enable
# epsilon_current                        0.4                           # B stepper motor current	
b_axis_max_speed                    200000                     # mm/min
epsilon_max_rate                     200000                     # mm/min
epsilon_acceleration                10000.0                     # mm/sec^2


## Endstops new syntax (the name is not significant)
# NOTE only a min or a max homing endstop maybe defined
endstop.minx.enable                          true                     # enable an endstop
endstop.minx.limit_enable                  false                    # set to true to enable the limit on this endstop
endstop.minx.pin                               1.24                     # pin
endstop.minx.axis                              X                         # the axis designator
endstop.minx.homing_direction         home_to_min      # direction it moves to the endstop
endstop.minx.homing_position          0                         # the cartesian coordinate this is set to when it homes
endstop.minx.max_travel                   500                      # the maximum travel in mm before it times out
endstop.minx.fast_rate                      50                        # fast homing rate in mm/sec ** WARNING: per second, unlike feedrates 
endstop.minx.slow_rate                     25                        # slow homing rate in mm/sec
endstop.minx.retract                         5                          # bounce off endstop in mm

endstop.maxx.enable                        false                     # enable an endstop
endstop.maxx.limit_enable                false                     # set to true to enable the limit on this endstop
endstop.maxx.pin                             1.25                      # pin
endstop.maxx.axis                             X                         # the axis designator
#endstop.maxx.homing_direction      home_to_max      # direction it moves to the endstop
#endstop.maxx.homing_position       415                      # the cartesian coordinate this is set to when it homes
#endstop.maxx.max_travel                500                      # the maximum travel in mm before it times out
#endstop.maxx.fast_rate                   50                        # fast homing rate in mm/sec** WARNING: per second, unlike feedrates 
#endstop.maxx.slow_rate                  10                        # slow homing rate in mm/sec
#endstop.maxx.retract                       5                         # bounce off endstop in mm

endstop.miny.enable                        true                      # enable an endstop
endstop.miny.limit_enable                false                     # set to true to enable the limit on this endstop
endstop.miny.pin                             1.26                      # pin
endstop.miny.axis                             Y                          # the axis designator
endstop.miny.homing_direction        home_to_min       # direction it moves to the endstop
endstop.miny.homing_position         0                          # the cartesian coordinate this is set to when it homes
endstop.miny.max_travel                  500                      # the maximum travel in mm before it times out
endstop.miny.fast_rate                     40                        # fast homing rate in mm/sec** WARNING: per second, unlike feedrates 
endstop.miny.slow_rate                    25                        # slow homing rate in mm/sec
endstop.miny.retract                        5                          # bounce off endstop in mm

endstop.maxy.enable                       false                     # enable an endstop
endstop.maxy.limit_enable               false                     # set to true to enable the limit on this endstop
endstop.maxy.pin                            1.27                      # pin
endstop.maxy.axis                            Y                         # the axis designator
#endstop.maxy.homing_direction     home_to_max      # direction it moves to the endstop
#endstop.maxy.homing_position      454                      # the cartesian coordinate this is set to when it homes
#endstop.maxy.max_travel               500                      # the maximum travel in mm before it times out
#endstop.maxy.fast_rate                   50                       # fast homing rate in mm/sec ** WARNING: per second, unlike feedrates 
#endstop.maxy.slow_rate                  25                       # slow homing rate in mm/sec
#endstop.maxy.retract                       5                        # bounce off endstop in mm

endstop.minz.enable                       true                    # enable an endstop
endstop.minz.limit_enable              false                    # set to true to enable the limit on this endstop
endstop.minz.pin                           1.28                     # pin 
endstop.minz.axis                           Z                        # the axis designator
endstop.minz.homing_direction      home_to_min      # direction it moves to the endstop
endstop.minz.homing_position       0                         # the cartesian coordinate this is set to when it homes
endstop.minz.max_travel                40                       # the maximum travel in mm before it times out
endstop.minz.fast_rate                   50                       # fast homing rate in mm/sec** WARNING: per second, unlike feedrates 
endstop.minz.slow_rate                  25                         # slow homing rate in mm/sec
endstop.minz.retract                      5                         # bounce off endstop in mm

endstop.maxz.enable                        false                    # enable an endstop
endstop.maxz.limit_enable                false                   # set to true to enable the limit on this endstop
endstop.maxz.pin                             1.29                     # pin
endstop.maxz.axis                             Z                        # the axis designator
#endstop.maxz.homing_direction        home_to_max      # direction it moves to the endstop
#endstop.maxz.homing_position         0.5                         # the cartesian coordinate this is set to when it homes
#endstop.maxz.max_travel                   70                       # the maximum travel in mm before it times out
#endstop.maxz.fast_rate                      50                       # fast homing rate in mm/sec** WARNING: per second, unlike feedrates 
#endstop.maxz.slow_rate                     25                       # slow homing rate in mm/sec
#endstop.maxz.retract                         5                         # bounce off endstop in mm

#endstop.mina.enable                       true                    # enable an endstop
#endstop.mina.limit_enable               false                   # set to true to enable the limit on this endstop
#endstop.mina.pin                            nc                       # pin
#endstop.mina.axis                           A                         # the axis designator
#endstop.mina.homing_direction      home_to_min      # direction it moves to the endstop
#endstop.mina.homing_position       0                         # the cartesian coordinate this is set to when it homes
#endstop.mina.max_travel                500                      # the maximum travel in mm before it times out
#endstop.mina.fast_rate                   100                      # fast homing rate in mm/sec** WARNING: per second, unlike feedrates 
#endstop.mina.slow_rate                   5                        # slow homing rate in mm/sec
#endstop.mina.retract                       5                        # bounce off endstop in mm

#endstop.maxa.enable                      true                    # enable an endstop
#endstop.maxa.limit_enable              false                   # set to true to enable the limit on this endstop
#endstop.maxa.pin                           nc                       # pin
#endstop.maxa.axis                           A                        # the axis designator
#endstop.maxa.homing_direction      home_to_max     # direction it moves to the endstop
#endstop.maxa.homing_position       350                     # the cartesian coordinate this is set to when it homes
#endstop.maxa.max_travel                500                     # the maximum travel in mm before it times out
#endstop.maxa.fast_rate                   100                     # fast homing rate in mm/sec** WARNING: per second, unlike feedrates 
#endstop.maxa.slow_rate                  5                        # slow homing rate in mm/sec
#endstop.maxa.retract                      5                        # bounce off endstop in mm

#endstop.minb.enable                      true                    # enable an endstop
#endstop.minb.limit_enable              true                    # set to true to enable the limit on this endstop
#endstop.minb.pin                           1.20^                  # pin
#endstop.minb.axis                           B                        # the axis designator
#endstop.minb.homing_direction      home_to_min      # direction it moves to the endstop
#endstop.minb.homing_position       0                         # the cartesian coordinate this is set to when it homes
#endstop.minb.max_travel                500                      # the maximum travel in mm before it times out
#endstop.minb.fast_rate                   40                        # fast homing rate in mm/sec** WARNING: per second, unlike feedrates 
#endstop.minb.slow_rate                  5                         # slow homing rate in mm/sec
#endstop.minb.retract                      1                         # bounce off endstop in mm

#endstop.maxb.enable                     true                     # enable an endstop
#endstop.maxb.limit_enable             true                     # set to true to enable the limit on this endstop
#endstop.maxb.pin                          1.19^                   # pin
#endstop.maxb.axis                          B                         # the axis designator
#endstop.maxb.homing_direction     home_to_max      # direction it moves to the endstop
#endstop.maxb.homing_position      390                      # the cartesian coordinate this is set to when it homes
#endstop.maxb.max_travel               500                      # the maximum travel in mm before it times out
#endstop.maxb.fast_rate                  40                        # fast homing rate in mm/sec** WARNING: per second, unlike feedrates 
#endstop.maxb.slow_rate                 5                         # slow homing rate in mm/sec
#-endstop.maxb.retract                    1                         # bounce off endstop in mm


# Optional order in which axis will home, default is they all home at the same time,
# If this is set it will force each axis to home one at a time in the specified order
#homing_order                                 ZYX                    # X axis followed by Y then Z last
move_to_origin_after_home               false                  # Move XY to 0,0 after homing
#endstop_debounce_count                100                    # Uncomment if you get noise on your endstops, default is 100
#endstop_debounce_ms                    1                        # Uncomment if you get noise on your endstops, default is 1 millisecond debounce
home_z_first                                      true                   # Uncomment and set to true to home the Z first, otherwise Z homes after XY

endstop.minx.release_first                  true                   # first move away from endstop until released

# End of endstop config
# Delete the above endstop section and uncomment next line and copy and edit Snippets/abc-endstop.config file to enable endstops for ABC axis
#include abc-endstop.config


switch.n1_vac.enable                                            true
switch.n1_vac.input_on_command                        M800
switch.n1_vac.input_off_command                        M801
switch.n1_vac.output_pin                                      2.7
switch.n1_vac.output_type                                    digital

switch.n2_vac.enable                                            true
switch.n2_vac.input_on_command                        M802
switch.n2_vac.input_off_command                        M803
switch.n2_vac.output_pin                                      2.5
switch.n2_vac.output_type                                    digital

switch.Up_cam_lights.enable                                 true
switch.Up_cam_lights.input_on_command             M804
switch.Up_cam_lights.input_off_command             M805
switch.Up_cam_lights.output_pin                           2.4
switch.Up_cam_lights.output_type                         digital

switch.Down_cam_lights.enable                             true
switch.Down_cam_lights.input_on_command         M806
switch.Down_cam_lights.input_off_command         M807
switch.Down_cam_lights.output_pin                       1.22
switch.Down_cam_lights.output_type                     digital

switch.vac_pump.enable                                        true
switch.vac_pump.input_on_command                    M808
switch.vac_pump.input_off_command                    M809
switch.vac_pump.output_pin                                  1.23
switch.vac_pump.output_type                                digital

switch.drag.enable                                               true
switch.drag.input_on_command                           M810
switch.drag.input_off_command                          M811
switch.drag.output_pin                                        2.6
switch.drag.output_type                                      digital


# System configuration
# Serial communications configuration ( baud rate defaults to 9600 if undefined )
# For communication over the UART port, *not* the USB/Serial port
uart0.baud_rate                              115200           # Baud rate for the default hardware ( UART ) serial port

second_usb_serial_enable                false            # This enables a second USB serial port
#leds_disable                                  true             # Disable using leds after config loaded
#play_led_disable                            true             # Disable the play led

# Kill button maybe assigned to a different pin, set to the onboard pin by default
# See http://smoothieware.org/killbutton
kill_button_enable                         true             # Set to true to enable a kill button
kill_button_pin                              2.12             # Kill button pin. default is same as pause button 2.12 (2.11 is another good choice)

#msd_disable                                false            # Disable the MSD (USB SDCARD), see http://smoothieware.org/troubleshooting#disable-msd
#dfu_enable                                  false            # For linux developers, set to true to enable DFU

kill_button_toggle_enable        true                # allows for latching estop button
