gabrielyoung92/gabs_microSMT_PickAndPlace/Bing-feeder/V485-feeder/CODE_feeder/tools/jog_items.py

#!/usr/bin/env python3
"""Advance/retract whole items using the saved event count per item. Peel stays off.

Close the USB host first. This tool owns the bus until the single item move finishes.
Movement is never retried. Sensor counts measure nominal travel, not absolute
position: direction changes/backlash and actual tape motion need bench validation.
"""
import argparse
import secrets
import time

from assign_id import identify
from rs485_upload import Link, UpdateError, address_value, decode_packet, fields, packet


def plan(items, width, per_item, step_um):
    if not isinstance(items, int) or not 1 <= items <= 10000:
        raise ValueError('Items must be 1..10000')
    if width not in (8, 12, 16, 24) or not 1 <= per_item <= 99 or step_um != (2000 if width == 8 else 4000):
        raise UpdateError('Invalid feeder type/default event count/step')
    if items * per_item > 10000:
        raise ValueError('This move exceeds the firmware limit of 10000 sensor events')
    return items * per_item


def motion_reply(port, address, tokens, deadline):
    while time.monotonic() < deadline:
        body = decode_packet(port.read_until(b'\n', 129), address)
        if body is None:
            continue
        label = body.split(' ', 1)[0]
        if label == 'ERROR':
            raise UpdateError(body)
        if label not in {'ACCEPT', 'RUNNING', 'DONE', 'BUSY', 'FAULT', 'UNKNOWN'}:
            continue
        try:
            if fields(body, label, 2) == tokens:
                return label
        except UpdateError:
            continue
    return None


def stop(port, address):
    nonce = secrets.randbits(32)
    return Link(port, address).request(f'STOP {nonce:08X}', {'STOPPED'},
                                       attempts=1, expected=f'STOPPED {nonce:08X}')
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
