gabrielyoung92/gabs_microSMT_PickAndPlace/(commit log)

2026-10-20 Organize MicroSMT parts, previews and development references
    [12mm-1bit.STEP, 12mm-1bit.stl, 16mm-1bit.STEP, 16mm-1bit.stl, 24mm-1bit.STEP, 24mm-1bit.stl, 8mm-1bit.STEP, 8mm-1bit.stl]
2026-10-20 Port V485 firmware to PlatformIO and add addressed RS485 updates
    Convert the ESP32-C3 controller to main.cpp/config.h and consolidate feeder variants into shared C modules. Add EEPROM-backed boot metadata, separate bootloader builds and a destination-ID RS485 uploader.
    Update build guides, changelogs and attribution, remove duplicate readme files, and ignore local IDE caches.
2026-10-20 Organise KiCad projects and remove obsolete V3 prototype
    Add recovered references and previews for all PCB sets, group board assets, and relocate recovery tools and machine notes. Remove the earlier diagnostic prototype, refresh documentation and attribution, and add RS485 uploader comments.
    [BOM_Board1_PCB3_2026-10-09.xlsx, BOM_Board1_Schematic1_2026-10-09.xlsx, V3_controller_BOM.xlsx, busbar_n17_n24.kicad_pcb, busbar_n17_n24.kicad_sch, busbar_n1_n8.kicad_pcb, busbar_n1_n8.kicad_sch, busbar_n9_n16.kicad_pcb]
2026-10-21 Update MicroSMT feeder CAD and galleries from October 2026 release
    [V3_12mm_switch-trigger-cover.3mf, V3_3D_feeder-holder-1-position.step, V3_3D_feeder-holder-1-position.stl, V3_3D_feeder-holder-3-position.step, V3_3D_feeder-holder-3-position.stl, V3_3D_feeder-holder-8-position.step, V3_3D_feeder-holder-8-position.stl, V3_3D_gear-16t-bracket.step]
2026-10-22 Add V485 tension control and single-button setup
    Keep development firmware at 0.1.0, retain sensor-confirmed advance replies, and add locally armed RS485 ID assignment with offline checks. Include the README rewrites, V485 missing-parts record, and separately supplied 16 mm magnetic slot with STL and previews.
    [V485_3D_feeder-slot-1-position.step, V485_3D_feeder-slot-1-position.stl]
2026-10-22 Reject unassigned feeder ID zero and flash its display
    Normalize EEPROM FF to unassigned zero with checked writes. Block both motors and all advance paths until ID 1-99 is saved, reject zero in ID editors and the controller, and preserve programming/recovery at transport address zero. Keep F0 and firmware version 0.1.0 unchanged; update documentation and offline checks.
2026-10-22 Use 115200 baud throughout the V485 feeder system
    Update both feeder application and bootloader variants, the ESP32 controller UART, uploader, ID assignment tool and monitor settings. Align documentation while preserving firmware version 0.1.0 and existing timing delays. All five PlatformIO targets and offline feeder, bridge, uploader and ID checks pass.
2026-10-29 Add powered-feeder dashboard and firmware 0.1.2
    Keep motion, cameras, nozzle management and jobs in OpenPnP while the
    PC host manages the direct RS485 feeder bus and local feeder TCP driver.
    Add compact stock/configuration tools, native part/package editing,
    fair discovery, a shared firmware update queue and motor-off input tests.
    Update build, installation and machine documentation for the current setup.
    Include the saved KiCad project metadata changes.
    Validated simulated host/API regressions, actual-source firmware checks,
    uploader/configuration checks, browser UI and documentation links.
2026-11-09 Add PNPv3 work-bed plate drawings and dimensioned PDF
    [1.DWG, 2.DWG, hole-centres.csv]
